subtilitas/rcbench/protocols/sbus/README.md

# sbus

This module decodes Futaba S.BUS frames: 16 channels in 25 bytes.

| Part | Files | Depends on |
|---|---|---|
| Core | `sbus.c`, `include/sbus.h` | C11 standard headers |
| RP2350 pin driver | none | |

The module has no pin driver. The wire is an inverted 8E2 UART (universal
asynchronous receiver-transmitter) at 100 kbaud; a PIO (programmable
input/output) receiver that produces the bytes is not written. The core is
linked into the panel image and the host tests, not into the IOmcu
image, and no firmware calls it.

## Constraints

- A frame is 25 bytes: the header 0x0F, 22 bytes of 16 channels at 11 bits
  each, a flag byte and a footer.
- S.BUS has no checksum. The header value occurs inside channel data, so the
  decoder uses silence to find frame boundaries. A gap of 2000us or more
  (`SBUS_GAP_US`) starts a frame. The caller supplies a timestamp in
  microseconds with every byte.
- Bytes inside a frame are 120us apart. Frames are at least 4ms apart.
- A raw channel value is 0 to 2047. 172 maps to 1000us and 1811 to 2000us.
- The decoder reports `failsafe` and `frame_lost` without acting on them.
  A caller that drives outputs from S.BUS must treat `failsafe` as a stop.

## Interface

`sbus.h`:

```c
void     sbus_decoder_reset(sbus_decoder_t *d);
bool     sbus_decode_byte(sbus_decoder_t *d, uint8_t byte, uint32_t now_us,
                          sbus_frame_t *out);
uint16_t sbus_to_us(uint16_t raw);
```

`sbus_decode_byte()` returns true when `out` contains a complete frame.
The decoder counts frames, bytes discarded while seeking a frame boundary,
and frames with an invalid footer.

## Use in another pico-sdk project

```cmake
add_subdirectory(protocols/sbus)
target_link_libraries(my_target PRIVATE rcbench_sbus)
```

The header compiles from C++. The caller supplies the bytes and their
arrival times.

## Trademarks

Futaba and S.BUS are names or trademarks of their respective owners; they
are used here only to say which receivers this module works with. The
project is not affiliated with them. No vendor code is included.
The full notice is in the repository's
[README](../../README.md#legal-notice-and-disclaimer) and in the section
"Trademarks" of [NOTICE](../../NOTICE).
