subtilitas/rcbench/hardware/STATUS.md

# Where the hardware stands

The running record for `hardware/`. Stock figures carry the date they were
taken and are not valid after it.

**Status: no board exists.** No schematic and no layout exist. Round 1 of
[the component research](docs/Research.md) ran from 2026-09-28 to 2026-09-30
and selected 49 parts for the IO (input/output) board, each with its stock in
[Parts](docs/Parts.md) and its reason on the page of its group:
[Control](docs/Control.md) (R1 to R4), [Supply](docs/Supply.md) (R5 to R8) and
[Sensing](docs/Sensing.md) (R9 to R13). The owner decided Q4, Q8 and Q9 on
2026-09-29. Three held or fixed inputs do not stand: the TPS55285 is refuted
at 4.0A continuous from the pack floor, the INA238 fails the stock gate at
both vendors, and no 18650 cell is selected. The owner keeps the TPS55285
and uses three, one for each of three servo rails, each with a heatsink and a
temperature shutdown (2026-09-30). The owner also fixes the INA228 in place of
the INA238 and names the pack the bench is to use, an SLS XTRON 3000mAh 2S1P
pack sold at Stefansliposhop (2026-09-30). The RP2354B is held in the owner's JLCPCB personal
parts library, 20 of them, and 12 TPS55285, beside the other parts listed
under [Held parts](docs/Research.md#held-parts) (export of 2026-09-25).
[The IO board specification](docs/IOBoard.md) is a draft with the chosen part
on each line. The workflow scripts are in `~/rcbench-research/tools-research/` on the owner's machine, outside the repository (prerequisite 6),
and the returns of every task are under `hardware/research/round1/` on the
branch `research/round1-results`. Round 2 is planned in
[Research](docs/Research.md#round-2); its returns go under
`hardware/research/round2/` on `research/round2-results`.

The [KiCad library](kicad/README.md) holds a footprint, a symbol and a STEP
3D model for each of the 12 modules the bench is built from. Its positions
come from maker drawings and photos, not from a caliper, and its part
heights are part class figures, not measured.

## Decided

| | Part | Reason |
| --- | --- | --- |
| Microcontroller | RP2354B | the owner's choice, held in the owner's JLCPCB personal parts library: the RP2350B die and 2MB of flash in one QFN-80 (quad flat no-lead) package, 48 GPIO (general-purpose input/output), stepping A4 (owner, 2026-09-27), taken from the marking RP2354B0A4 in JLCPCB's product photograph of C39843328; the marking on the held parts is not read. The 2MB changes three places in the IOmcu build. The IO board needs a board file that states the B package, 2MB of flash and no PSRAM (pseudo-static random-access memory). On the IO board the output store sits in the last two sectors of the 2MB, and the image limit is 2,088,960 bytes. The tree places the store at 4MB less 8kB and holds the limit at 4,186,112 bytes. [IO board](docs/IOBoard.md#microcontroller-flash-and-debug), [Research](docs/Research.md#consequence-of-the-rp2354bs-2mb-flash) Two a board (owner, 2026-09-30): the main IOmcu runs the outputs, the link, the heartbeat, the ARMED state and stop; a measurement IOmcu runs the fixed ADCs, the port, motor and cell monitors, the MCP9808s and the converters' I²C settings. PPM stays on the main IOmcu, whose stop covers it. The monitors' alert lines, open-drain and shared, 3 at least, interrupt the main IOmcu through CD4082 AND gates, and a parallel-in, serial-out shift register names the part that tripped. A trip of the 3.0A ceiling shorter than a blanking time, such as a servo charging its capacitors as it is connected, is logged, not an abort, also when it repeats; the stall trip and the port breaker bound repeated trips below 3.96A. The main IOmcu also stops the outputs when the link between the two goes silent. The 20 held cover 10 boards: see [IOBoard](docs/IOBoard.md#two-iomcus) |
| Board power | 12 to 20V DC (direct current) input and the 2S (two cells in series) pack | the DC input, when present, runs the IO board and the display. The pack runs both otherwise. The selection is automatic. The display is powered through the link cable. The DC input has reverse-polarity protection, an overvoltage cut-off and brownout detection that the IOmcu reads. Each is non-destructive: no fuse, crowbar or other part is sacrificed or damaged, and the input works again once the fault is removed, with no part replaced (owner, 2026-09-30). The overvoltage and brownout thresholds are not stated; a follow-up of R5 sets them and selects the detection circuit, and the IOmcu's action on a brownout is firmware work. The owner plans to use an SLS XTRON 3000mAh 2S1P pack, cobalt-based lithium-ion, 7.4V nominal, with an XT60 socket and an XH balance connector (owner, 2026-09-30). Its 30C, a C rate of 30 times its 3.0Ah capacity, is 90A continuous. It is disconnected in hardware when any cell falls to 3.0V, read per cell from its balance lead (question F9 in [Research](docs/Research.md#blocking-answered-before-the-research-tasks), owner, 2026-09-25). At that floor the pack is 6.0V at the lowest (2 × 3.0V); full charge is 8.4V (2 × 4.2V). The owner keeps the 3.0V floor for the pack (2026-09-30); its vendor page states neither 3.0V nor 4.2V a cell. The pack runs from 0°C to 55°C, read from an NTC (negative temperature coefficient thermistor) the owner tapes with Kapton tape at the center of the cells (owner, 2026-09-30). The pack's maker, SLS, is the owner's choice outside the cell makers of question S9 (owner, 2026-09-30). Owner decision, 2026-09-24; 12 to 20V, 2026-09-25 |
| Motor current path | INA228 on the IO board, two shunt positions | an onboard shunt for 150A continuous (question F2) with a temperature sensor beside it, and an input for an external shunt for currents above 150A, to 300A and more (owner, 2026-09-25), connected by its sense leads. The two paths replace each other: a test is cabled through one, never both (owner, 2026-09-25). One monitor for each path (question F1, which names the INA238; the owner fixes the INA228 in its place, 2026-09-30). The ESC (electronic speed controller) pack has up to 16 cells, 67.2V at 4.2V a cell (question F15), under the INA228's 85V. Owner decisions, 2026-09-24 and 2026-09-25 |
| Output ports | 20 typed ports | 16 PWM (pulse-width modulation) ports with enable, pulse range and a frame rate per pair, one of them switchable to PPM (pulse-position modulation), and 4 multiprotocol ports (servo PWM, DShot, bidirectional DShot, ESC telemetry, servo configuration, ESC bootloader); a one-pin UART (universal asynchronous receiver-transmitter) socket; an external CAN (Controller Area Network) port on its own controller. Each port has a supply switch, a current monitor channel and an LV (low-voltage) or HV (high-voltage) jumper that cuts the port off above 6.0V or 8.7V (question F16). Owner decision, 2026-09-25 |
| Sensor inputs | load cells, a phase-wire clip, a magnetic pickup, motor temperature sensors, an encoder | thrust and torque come from load cells. Rotation speed in rpm (revolutions per minute) comes from a phase-wire clip and a magnetic pickup. The motor's temperature is measured. The encoder is ABI (quadrature A and B plus an index pulse) and is counted in the pin budget. Load cells on 3 channels, 1 for thrust and 2 for torque, at 5V excitation (question F3). The encoder takes 5V single-ended up to 1MHz or RS-422 (Recommended Standard 422) differential up to 5MHz, and a 5V or 12V supply, each selected by a jumper (question F4). Motor temperature on 2 channels, 1 infrared and 1 thermocouple (question F5). 2 external I²C (Inter-Integrated Circuit) ports at 3.3V, Qwiic (question Q7). Owner decisions, 2026-09-24 and 2026-09-25. [IO board](docs/IOBoard.md#measurement) |
| Safety gate | a heartbeat monostable, specified in pull request #167 at commit 23c82ca, not merged | the single-channel OR design (question F10); a hardware latch cleared only by an operator control (F11); a reset supervisor as the clear network (F12); the 20 output ports and the UART socket behind the gated buffer (F13); a pull-up on a bidirectional DShot line and a pull-down on every other (F14); on the ESC pack a MOSFET (metal-oxide-semiconductor field-effect transistor) array and driver on the board for the onboard path, and a driven external module above 150A (F7). Owner decisions, 2026-09-25. The parts are in research categories R3 and R4 |
| Display supply | 5V through the link cable | 2A peak, 1.5A continuous (question F6 and prerequisite 7 in [Research](docs/Research.md#prerequisites)). Owner decisions, 2026-09-25 |
| First build | 5 boards | the parts are bought into the personal library before the order (question S7). A part's stock gate is 5 times the build's need, never under 50 (S4). Owner decisions, 2026-09-25 |
| IOmcu watchdog | the RP2350's internal watchdog | a frozen IOmcu resets, and every gate it drives opens while its pins are at their reset state. Owner decision, 2026-09-25. The stop deadline is 500ms (owner, 2026-09-30). The timeout is not stated, and the IOmcu image enables no watchdog |
| Output combinations | the combinations P5 returns | P5 is the cross-category check of [the research](docs/Research.md#agent-layout). Bidirectional DShot takes 2 PIO (programmable input/output) state machines per output; the 4 multiprotocol ports take 8 of the 12. The board supports the combinations P5 returns; the IOmcu refuses a bind outside them and the OUTPUTS page shows the refusal. Owner decision, 2026-09-25 |
| Servo supply | 3 TPS55285 | one for each servo rail: 8 PWM ports, the other 8 PWM ports, and the 4 multiprotocol ports (owner, 2026-09-30). 12 held in the owner's personal library (owner, 2026-09-25): with the adjustable supply's, 4 a board, they cover 3 boards. Each senses current internally and its I²C limit stops at 6.35A, so each rail runs to 6.35A. Its input takes 2.4 to 22V, so the DC input is 12 to 20V. The TPS55288, which limits across an external shunt to 10.1A, is not used. Round 1 refutes one converter at 4.0A continuous from the pack floor. The owner keeps it (2026-09-30): 4 to 6.35A is a short peak for one servo, a small aluminum heatsink on a 6-layer board cools each converter, and an MCP9808T-E/MS beside each switches its rail off when hot, which bounds a sustained current from several servos. A follow-up of R6 finds the continuous current each holds: see the Servo supply row under [Open](#open). [Power](docs/Power.md) |
| Motor monitor | INA228 | fixed by the owner in place of the INA238 (2026-09-30). The owner states it returns to stock soon, and the monitor gets no further research. 85V, 20 bit. Its step at 300A with a 50 µΩ shunt is 1.5625mA, 78.125 nV on the ±40.96mV range. Its stock is not read after 2026-09-01, when JLCPCB had 29 with a presale count of −477 and Digi-Key 0. The INA238, 16 bit, has the same 10-pin VSSOP (very thin shrink small-outline package) and the same pin order; round 1 read it at JLCPCB 0 with a presale count of −99 and Digi-Key 0 on 2026-09-29. [Power](docs/Power.md#motor-monitor-ina228), [Research](docs/Research.md#sourcing-rules) |
| Monitor footprint | one for both | INA228 and INA238 are pin-identical and distinguishable at run time by DEVICE_ID (0x3F: 0x2281 or 0x2381). The INA238 fits the INA228's footprint (Motor monitor row) |
| Servo rail | 3 rails, two output settings each | up to 5.5V for LV (low-voltage) servos and up to 8.4V for HV (high-voltage) servos, and down to the TPS55285's 0.8V to test a servo's brownout behavior, set on each rail alone, so LV and HV servos and an ESC on the multiprotocol ports run at the same time (owner, 2026-09-30). 4 to 6.35A a rail: a short peak for one servo, and sustained only by several servos together, which the rail's temperature shutdown bounds. From the pack every converter runs to its own limit too: the SLS XTRON pack's 90A carries all four (owner, 2026-09-30). The converters run from the 12 to 20V DC input or from the 2S pack (owner, 2026-09-24). From the 6.0V pack floor a TPS55285's 7A inductor clamp gives 5.0A at 8.4V without losses and 4.44A at a typical 88.8%; 6.35A needs 10.0A, above the clamp's 8A typical, and the datasheet guarantees no efficiency, so the current a unit reaches is not known (R6). Research category R6 checks 8.4V and 4.0A from the 6.0V pack floor at 50°C ambient, and the TPS55285 fails there drawn continuously: see the Servo supply row under [Open](#open). [Power](docs/Power.md) |
| Adjustable supply | a fourth TPS55285 | a simple adjustable supply, on the measurement IOmcu's I²C buses with the other TPS55285 (owner, 2026-09-30): 0.8 to 15V in 10mV steps and 0.5 to 6.35A, set from the display, out on an XT60 socket (female) from the PCB (printed circuit board). It has the servo converters' heatsink, MCP9808T-E/MS shutdown and heartbeat-gated rail gate, and runs from the DC input or the pack, to its own limit from either (owner, 2026-09-30). At 15V and 6.35A it delivers 95.3W, for certain only from an input above 15V; boosting, its inductor clamp, 7A at least with no maximum, gives 5.6A at 15V from 12V and 2.8A from the 6.0V pack floor without losses, less with them. Open: its continuous current across its input and output range, which a follow-up of R6 qualifies; and its rail gate, since the BTS7004-1EPP starts only at 4.1V at most and does not switch an output set from 0.8V to about 4.1V: see [IOBoard](docs/IOBoard.md#power). [Power](docs/Power.md) |
| Pack charger | BQ25713RSNR, with MAX17320G22+ and FUSB303BTMX, [Supply](docs/Supply.md) | charged from USB-C (Universal Serial Bus Type-C) only, drawing up to 3A at 5V, and not from the DC input (question F8 in [Research](docs/Research.md), owner, 2026-09-25). Research round 1 selects the BQ25713RSNR as the charger and power path, the MAX17320G22+ for balancing at 50mA average and for pack protection, and the FUSB303BTMX for the USB-C input limit (R7). The BQ25887 (2A, 400mA per-cell balancing, [Power](docs/Power.md)) takes 3.9 to 6.2V and is not selected. The pack is the owner's SLS XTRON 3000mAh 2S1P (2026-09-30); its cell and temperature limits are not confirmed: see the Pack cells row under [Open](#open) |
| Port monitors | INA3221AIRGVR, 7 parts, with an ERJ-6CWDR010V shunt on each port, [Supply](docs/Supply.md) | one channel per port, 20 ports: the limit search needs one sensor per servo. The owner's choice is the INA3221, 7 parts (21 channels), a 10mΩ shunt each: 4mA resolution, 16.4A full scale, two I²C buses (owner, 2026-09-25): the measurement IOmcu's (owner, 2026-09-30; [IOBoard](docs/IOBoard.md#two-iomcus)). Research round 1 keeps it (R8) |
| Onboard shunt, 150A | BVR-Z-R0002-1.0, [Supply](docs/Supply.md) | on the IO board, with a temperature sensor beside it, the MCP9808T-E/MS (R8). 150A is continuous (question F2, owner, 2026-09-25). At 150A a 100 µΩ shunt drops 150A × 100 µΩ = 15mV and dissipates (150A)² × 100 µΩ = 2.25W continuously. A 200 µΩ shunt drops 30mV and dissipates 4.5W. Both drops are inside the INA238's ±40.96mV range |
| External shunt, 300A and above | WSBE8518L1000JKA2, off the board, [Supply](docs/Supply.md) | sense leads to the IO board. Class: busbar type, 50 to 100 µΩ, 4.5 to 9W at 300A. The four-terminal SMD (surface-mount device) parts recorded in [Power](docs/Power.md#motor-monitor-ina228) stop at 0.2mΩ and would dissipate 18W at 300A. The WSBE8518L1000JKA2 is 100 µΩ, bought at Digi-Key, the second vendor of question S3, which held 418 on 2026-09-29. No alternate is found, so it has no second source (sourcing rule 5), and the owner has the report. The sense-lead connector is round 2 |
| Parts of group A | 21 parts, [Control](docs/Control.md) | ABM8-272-T3 and AOTA-B201610S3R3-101-T (R1); MCP2518FDT-E/SL and TCAN3413DR, 2 of each (R2); 74HC423BQ,115, 74AUP1G32GW,125, TPS3703A7330DSERQ1, 74LVC1G175GW,125, 434153017835, SN74AUP1G14DBVR, SN74AUP1G17DBVR, BTS7004-1EPP, TPSI3052DWZR, IPT015N10N5ATMA1, CSD19537Q3T, 2N7002BK,215 and SN74LVC1G04DBVR (R3); SN74LVC244APWR with its alternate 74LVC244APW,118, SN74LVC1G126DBVR, SN74CBTLV3126PWR and SN74LVC1T45DBVR (R4). Research round 1, verified by its two verifiers of phase P4, which re-read stock, lifecycle and every datasheet value |
| Parts of group B | 15 parts, [Supply](docs/Supply.md) | LM74800QDRRRQ1, LMQ66430MC3RXBRQ1, TPS62933DRLR, TPS259474ARPWR and TPS55288RPMR (R5); TPS259474LRPWR and MCP23017T-E/SS (R6); BQ25713RSNR, MAX17320G22+ and FUSB303BTMX (R7); BVR-Z-R0002-1.0, MCP9808T-E/MS, WSBE8518L1000JKA2, INA3221AIRGVR and ERJ-6CWDR010V (R8). Research round 1, verified by the P4 verifiers |
| Parts of group C | 13 parts, [Sensing](docs/Sensing.md) | ADBMS1818ASWAZ-RL (R9); ADCS7476AIMFX/NOPB (R10); ADXL316WBCSZ, DRV5015A1QDBZR, TLV3201AIDBVR with its alternate TLV3601DBVR, AM26LV32EIDR and the RP2354B's PIO (R11); MAX31856MUD+T, MLX90614ESF-BCC-000-TU, TCA9548APWR with its alternate PCA9548APWR and MB85RC256VPNF-G-AMERE2 (R12); ADS1235IRHBR and BD450M2FP3-CE2 (R13). Research round 1, verified by the P4 verifiers |
| Accelerometer converter (Q4) | ADCS7476AIMFX/NOPB, an external ADC (analogue-to-digital converter) | the part R10 kept (owner, 2026-09-29). The RP2354B's ADC with the LM4040AIM3-3.0/NOPB reference is the verified option not chosen |
| Output binding store (Q8) | MB85RC256VPNF-G-AMERE2, an I²C FRAM (ferroelectric random-access memory) | the part R12 kept (owner, 2026-09-29). The EEPROM (electrically erasable programmable read-only memory) M24256E-FMN6TP is the verified option not chosen |
| Monostable isolation (Q9) | 74HC423BQ,115 with SN74AUP1G17DBVR in front of its trigger inputs | the 74HC423 keeps the '423 behaviour, and the buffer supplies I_off, a limit on the input current of an unpowered part, as R3 selected (owner, 2026-09-29). No part is added or changed |
| Stock exception | ADS1235IRHBR | Digi-Key, the second vendor, read stock 0 against the gate of 50 on 2026-09-29; the owner keeps the part and notes the exception (owner, 2026-09-29) |
| Stock source | the vendor's own API (application programming interface) | on 2026-09-01 the mirror `jlcsearch.tscircuit.com` reported 1046 INA228AIDGSR. JLCPCB's own API reported 29, with a presale count of −477: oversold. [Sourcing](docs/Sourcing.md#observed-divergence-2026-09-01) |

## Open

The first nine rows come from round 1 and are reported to the owner. A part
a row needs comes from a follow-up of its research category in stage 1 of
round 2, or from stage 2 of round 2 for a passive, a connector, or the
protection on the signal, sensor, balance-lead, link and heartbeat connectors
([Research](docs/Research.md#round-2)). The group pages state each with its
evidence, as not known or not verified.

| Item | State | Needs |
| --- | --- | --- |
| Servo supply | round 1 refutes the held TPS55285VALR at 4.0A continuous: at 6.0V in, 8.4V and 4.0A out and 50°C ambient its estimated junction temperature spans 89 to 179°C against 125°C, and its datasheet gives no loss of the IC (integrated circuit) there. The owner keeps it and uses three, one a servo rail (2026-09-30): 4 to 6.35A is a short peak for one servo; a small aluminum heatsink on a 6-layer board cools each; an MCP9808T-E/MS beside each switches its rail off above a threshold, which bounds a sustained current from several servos. The measurement IOmcu programs and locks each MCP9808, and the main IOmcu enables the converter only after that; it switches every converter off when the link between the two goes silent ([IOBoard](docs/IOBoard.md#two-iomcus)). The continuous current one converter holds at 6.0V in and 50°C is not known. 5 boards take 20 TPS55285, with the adjustable supply's, against 12 held. `selection.json` carries no servo supply. Its inductor SRP1265A-4R7M is confirmed by both verifiers of the follow-up task FU-B3 and is not carried in `selection.json` either ([Supply](docs/Supply.md#not-known)) | a follow-up of R6: the continuous current, in A, as each rail's continuous rating, the adjustable supply's across its range, and the shutdown threshold; 8 more TPS55285 bought before the order |
| Motor monitor | the owner fixes the INA228AIDGSR (2026-09-30): it returns to stock soon, as the owner states; its stock is not read, and the monitor gets no further research. Against the 85V fault on the external shunt's sense leads (V179), which refutes the INA238's ±40V differential input, the owner sets 1kΩ in series with each input and a low-capacitance TVS (transient-voltage-suppression) diode behind them (2026-09-30). The INA228's rating against the fault and the error 1kΩ adds to its reading are not read ([Supply](docs/Supply.md#not-known)) | the INA228 in stock before the order; the TVS's connection and part and the resistors' power rating (round 2) |
| Pack cells | the owner plans to use an SLS XTRON 3000mAh 2S1P pack (article SLSXT30002130), sold at Stefansliposhop (2026-09-30). Its 30C, 90A continuous, is 7.4 times the 12.23A round 1 budgets, and 1.8 times the about 49.7A the pack path draws at the 6.0V floor with every converter at its limit (owner, 2026-09-30). That draw is nominal, and it has no upper bound until the pack protection's overcurrent threshold is set at or below 90A. The owner waives sourcing rules 4 and 5 for it: the vendor shows no stock count, and no second pack is named. Round 1's INR-18650-P30B passes every check and is not used. The owner states a cobalt-based lithium-ion chemistry (2026-09-30); the vendor page states no chemistry, no charge voltage or discharge floor a cell, no temperature limits, no thermistor and no internal resistance. The owner sets its limits in their place (2026-09-30): the 3.0V a cell floor of F9 stands, and the pack runs from 0°C to 55°C, read from an NTC taped with Kapton tape at the center of the cells. F9's 4.2V a cell full charge is not confirmed by the vendor ([Supply](docs/Supply.md#not-known)) | the pack path and the pack protection sized again for about 49.7A (follow-ups of R5 and R7); the pack protection's thresholds (V150) against these limits (a follow-up of R7); a leaded NTC, the connector of its lead and the board's XT60 and XH connectors (round 2) |
| ESC pack switch | the onboard MOSFETs (IPT015N10N5ATMA1) and the external module (VS-FC420SA10, VS-FC270SA20) are refuted on safe operating area during the controlled turn-off; no clamp part holds the pack node under 85V at up to 600A. Not known ([Control](docs/Control.md#not-known)) | a follow-up search or a trade-off by the owner |
| USB protection | relaxed to match standard parts (owner, 2026-09-30): standard USB protection parts on VBUS, D+ and D−, CC1 and CC2. Where a standard part misses the 3.63V steady limit on D+ and D− or another figure of V9 and V12, its datasheet figure stands. Round 1 found no part that covers the 5 lines while holding D+ and D− at 3.63V ([Control](docs/Control.md#not-known)) | a follow-up of R1, which selects the USB protection |
| Watchdog | the stop deadline (V1) is 500ms (owner, 2026-09-30): the watchdog timeout and the reset together stay within it, and the timeout exceeds the longest legitimate stall (V2). The timeout bounds a whole pass of the main loop between two feeds. As the firmware is written, one pass erases a W25Q16JV sector, up to 400ms, and then writes to the console (`main()` in `firmware/iomcu/src/main.c`, `out_store_tick()`, `out_store_reclaim()` in `firmware/iomcu/src/out_store.c`), so the console write, the rest of the pass and the reset share the remaining 100ms. A slow USB host holds a console write without limit, so the firmware caps it; the cap is not stated. Q8 moves the output binding to an FRAM (ferroelectric random-access memory), which takes the sector erase out of the loop once the firmware follows it ([Control](docs/Control.md#not-known)) | the timeout, the console-write cap and the move of the output store to the FRAM, in firmware |
| Pack disconnect and port voltage ceiling | no candidate passes: the disconnect fails an open balance lead, the reconnect condition or the per-cell floor; the ceiling fails the ±0.99% HV trip band or the latch. Not known ([Supply](docs/Supply.md#not-known)) | a follow-up search |
| Optical index | no reflective sensor meets the 1.244µs delay-variation budget. Not known ([Sensing](docs/Sensing.md#not-known)) | a follow-up search |
| Board budget | about 51 GPIO (general-purpose input/output) signals against 48 on one chip. With two RP2354B (owner, 2026-09-30) the draft pin map uses 44 of the main IOmcu's 48 and 32 of the measurement IOmcu's, with the rotation inputs and the receiver on the measurement IOmcu, the external CAN controller on the display link's SPI bus, a UART between the two and the lines for VESC controllers through the gate (owner, 2026-09-30; [Pins](docs/Pins.md)); the FUSB303 address 0x21 inside the expanders' block; the servo current sample period, 5ms a channel against the 20ms P5 assumed; Not known ([Control](docs/Control.md#not-known), [Supply](docs/Supply.md#not-known)) | the pin map, the I²C address map and a P5 check after it |
| Cell monitor barrier | the cell monitor sits on the ESC pack's negative and reaches the measurement IOmcu only across an isoSPI (isolated SPI) transceiver pair or a digital isolator rated 85V DC working or more (V189, owner, 2026-09-28). Round 1 selected none: the barrier is not in its R9 inventory. Not selected ([IOBoard](docs/IOBoard.md#measurement), [Pins](docs/Pins.md#not-known)) | a follow-up of R9 |
| Servo path from 0.8V | the servo rails and the adjustable supply work down to the TPS55285's lowest output, 0.8V, to test a servo's brownout behavior (owner, 2026-09-30). Round 1 selected the servo path for a lowest rail of 4.8V (V55): the BTS7004-1EPP rail gate starts only at VS(OP), 4.1V at most, and the TPS259474LRPWR port switches take VIN from 2.7V. Neither switches a rail set below that ([IOBoard](docs/IOBoard.md#link-and-safety)) | a rail gate that conducts from 0.8V (a follow-up of R3) and a port switch that does (a follow-up of R6) |
| Converter input connector and heatsink | the converters run from the 12 to 20V DC input or the 2S pack (owner, 2026-09-24). Three at 6.35A and 8.4V draw 14.8A from 12V; with the adjustable supply at 15V and 6.35A, the four draw 23.6A, both at an assumed 90% efficiency. A small aluminum heatsink on each TPS55285, on a 6-layer board, and an MCP9808T-E/MS beside each whose alert output switches its output off (owner, 2026-09-30) | the input connector (round 2), the shutdown threshold (a follow-up of R6), the heatsinks' size (round 3) |
| Phase-wire clip front end | the beta bench taps phase A through 4.7kΩ and a 3.0V zener (Rohm UDZV3.0B) to GND at the IOmcu pin: one wire, referenced to the ESC signal lead's ground (owner, 2026-10-08). The board's clip sees the 67.2V of F15 as the pack's DC level; the peak it must withstand, 67.2V plus a margin for switching overshoot and ringing, is open (V214), and so are its coupling (V215) and its isolation (V216). From the beta bench: a second ground wire from the motor side runs in parallel with the ESC's own ground and can carry motor current (owner, 2026-10-08); the tap needs the ESC's power negative on the IOmcu's GND: on the beta bench the ESC runs from the PD mini (owner, 2026-10-08), whose OUT − is wired to the IOmcu's GND, while an ESC on its own pack with an opto-isolated signal input gives the tap no reference; 4.7kΩ is sized for 25.2V, and at 67.2V DC it passes 13.7mA and dissipates 0.88W, more at the V214 peak. An optocoupler across two phases needs no ESC ground. It needs a logic-output part that switches at 2mA or less from 3.3V with delays well under 1µs (a PC817 module is limited to about 4kHz and needs about 3V before its input conducts), an input current limiter that holds a few mA from 3.0V (a floating 2S phase) to the pack voltage, a reverse diode on each input, because the driven pair reverses, and a common-mode transient immunity above the phase node's dV/dt: about 1.25kV/µs for 25V in 20ns, more at the V214 peak. Capacitive coupling passes only the edges, needs a comparator that restores the level, and passes C × dV/dt of the common-mode swing: about 125mA at 100pF and 25V in 20ns | the V214 peak voltage, which every part and clearance of the front end is rated against; the PWM carrier range the clip must reject (V229) the electrical frequency it must pass, which follows from the highest shaft speed (V212) and the pole pairs, and the lowest phase voltage and current it must still read, which follow from the lowest speed it covers in coast-down (V213), not from the BENCH register's 65,535rpm ceiling; both are open, and a fast front end, isolated or not, reproduces carrier edges; a decision for the board (V216) that follows the ESC ground paths row: the isolated design there makes an isolated clip mandatory, since a ground-referenced clip puts the pack negative on the logic ground; a ground-referenced clip goes only with the protected non-isolated design. Every series part and limiter is rated for its continuous dissipation at the highest sustained phase voltage and duty cycle, over component tolerance and ambient temperature, and separately for the pulse energy and safe operating area of the V214 peak. Then a part search (R11 follow-up) |
| ESC ground paths | the ESC pack's return reaches the star by its own lead. An ESC with a BEC (battery eliminator circuit) also joins its power negative to its signal lead's ground, and its BEC output arrives on the port's supply pin, which the board's TPS55285 rail drives at 0.8 to 8.4V: the port keeps the BEC positive off the driven rail (removed, switched or ORed safely) or takes the BEC as the selected source. The signal lead's ground reaches the board's signal ground: a second path beside the pack return lead, through the ESC. On an ESC with an opto-isolated signal input the pack return lead is the only join, and it defeats the isolation the ESC was built with. On the beta bench an INA228 module's I²C ground likely ties the pack negative to the IOmcu the same way; how the MATEK I2C-INA-BM joins its grounds is not checked (owner, 2026-10-08) | a decision between two designs, then a part search. Not isolated: every parallel return, the ESC signal ground and the motor monitor's supply and I²C ground alike, gets a part that limits or breaks its current when the pack return lead or its connector opens, since each then becomes a return for the motor current: a fuse or polyfuse rated for DC above the pack's highest transient voltage and able to break the prospective fault current, up to 600A, not only its I²t; or a check that switches the bench to SAFE with a total time from the return opening to the pack switch opening and an I²t each path is shown to survive (the path carries 150A continuous and up to 600A at switch opening; the detection-to-open time is open, V159; the switch alone may take 5ms after its enable falls). A pack return lead of lower resistance only sets the share in normal running. With a motor shunt in the return lead (its placement is open), the parallel returns carry current around it, which the motor reading misses: the non-isolated design needs the shunt ahead of every return branch, a high-side shunt, or the bypass current bounded against the measurement's error budget. Every conductor that stays connected after a return protection opens, the ESC signal, SDA, SCL, ALERT and the supplies, then sees the pack side: either the protection disconnects all of them together, or each has its own fault limiting and voltage protection. Isolated: every conductor between the ESC and pack side and the logic side crosses a barrier, and every requirement the board already places on those conductors holds across it: each multiprotocol mode's directions, electrical form, bias and rate ([IOBoard](docs/IOBoard.md), the port and programming rows); the heartbeat gate's high-impedance state within 1µs of the enable falling, in hardware, with a defined safe state on the ESC side; the monitor's I²C and ALERT, or a trip formed on the pack side and isolated as one signal; and the supply and ground of every barrier part's ESC-side half, from the ESC or BEC side, the pack side or an isolated converter, never from the board's servo rail or ground. Every barrier and isolated supply is rated for continuous working voltage, transients and clearance at the pack voltage, at least the 85V DC working the cell monitor's barrier already requires, and for a common-mode transient immunity above the dV/dt of the ESC-side reference when the pack return opens or bounces. The MATEK I2C-INA-BM takes 4 to 9V at its 5V pin ([MATEK](https://www.mateksys.com/?portfolio=i2c-ina-bm)). Neither design is in the round-2 plan: the ESC-signal barrier belongs to R4, which round 2 does not run, and this row has no follow-up assigned; the owner assigns one, since the plan is not edited between runs |
| Layout | Isolation, a 150A path and a 3.3V I²C bus on one board, connectors, thermal. | the schematic first |

## Not planned

- **A hall-effect sensor for the 300A path.** It avoids the shunt's 9W and
  its layout, at the cost of gain and offset drift on the bench's primary
  measurement. The shunt is the measurement.
- **Bilingual pages** while no board exists. See [the README](README.md).

## Order of work

1. The owner's rulings on the open items of round 1 ([Open](#open)): the
   ESC pack switch and the other items without a part. The TPS55285, the
   motor monitor, the pack, the USB protection and the stop deadline are
   ruled on (owner, 2026-09-30).
2. Stage 1 of round 2 of the component research (owner, 2026-10-01;
   [Research](docs/Research.md#round-2)): follow-up tasks of round 1's
   categories for the ICs and the parts round 1's categories name that round 1
   left without a part or whose requirement changed, the follow-ups those
   rulings call for among them, planned in 7 runs of at most 32 agents each.
   Round 1 of the component research ran from 2026-09-28 to 2026-09-30, as in
   [its scope](docs/Research.md#scope): the ICs, the parts that fix an IC's
   surroundings, both motor shunts, the switch of the ESC pack with its input
   protection, and the 18650 cells of the bench's own pack, in six tasks
   (question S8) and 9 follow-up tasks, each of at most 32 agents (owner,
   2026-09-24). The commit each task read is in the status line of
   [Research](docs/Research.md).
3. Stage 2 of round 2 selects the passives and the connectors, the DC input
   connector among them, by part type, with no P1 and one verifier (owner,
   2026-10-01). It also selects the protection on the signal, sensor,
   balance-lead, link and heartbeat connectors. The power input's protection
   (R5) and the ESC pack path's (R3) are round 1's categories, which stage 1
   researches. Stage 2 has no scripts in `~/rcbench-research/tools-research/`. Round 3 sets the
   mechanical, thermal and layout constraints, the converter's heatsink among
   them ([Research](docs/Research.md#scope)).
4. Schematic.
5. Order each part with a manufacturer lead time of 16 weeks or more as soon
   as the schematic fixes it. On 2026-09-01 Texas Instruments quoted 16 weeks
   on every power-path part checked, and 26 weeks on the INA745x and the
   INA260 ([Sourcing](docs/Sourcing.md#the-2026-09-01-sweep)). Once the
   schematic exists, the build waits up to 26 weeks for those parts.
