subtilitas/rcbench/hardware/docs/IOBoard.md

# IO (input/output) board specification

This specification records the IO board's requirements and the values fixed
by the project. The IO board is the IOmcu board. It handles the functions
with timing deadlines:
outputs, receiver inputs, sensor front ends, the power path and the CAN
(Controller Area Network) link to the display. The display is the ESP32-P4
panel in `firmware/panel/`.

**Status: draft.** No schematic exists. Round 1 of
[the research](Research.md) ran from 2026-09-28 to 2026-09-30 and names the
part selected for each requirement. [Parts](Parts.md) lists the parts and
their recorded stock. Each research group's page explains its choices,
alternatives and reasons: [Control](Control.md) for R1 to R4,
[Supply](Supply.md) for R5 to R8 and [Sensing](Sensing.md) for R9 to R13. A
requirement without a selected part is marked not known or not verified on
the relevant page. A line marked _open_ depends on an unanswered question in
[Research](Research.md).

Firmware observations and line references below record the source revisions
inspected during the research. They are not a current firmware feature list;
explicit corrections below distinguish implemented functions from the proposed
IO board. See [the link reference](../../docs/Link.md) and
[the build reference](../../docs/Building.md) for the current implementation.

The sources include repository files and line references, pull request #167, the pico-sdk 2.3.1
headers, two pico-sdk 2.3.0 sources (`boards/olimex_rp2350_xl.h` and
`src/rp2_common/hardware_pio/pio.c`), and two datasheets read from copies
outside the tree: the RP2350 datasheet (build 2024-08-08) and the W25Q16JV
datasheet (revision D, 2016-08-12). R1 reads the RP2350 datasheet from
Raspberry Pi. In build 2025-07-29, the copy served by Raspberry Pi during the review,
each cited table number is three higher than in build 2024-08-08. Table 1423 (Pin Types) is 1426 there,
1424 (GPIO pins; GPIO is general-purpose input/output) is 1427, 1425 (QSPI
pins; QSPI is quad serial peripheral interface) is 1428, 1427 (Miscellaneous
pins) is 1430, 1430 (Absolute maximum ratings) is 1433, and 1433 (Digital IO)
is 1436. The W25Q16JV datasheet Winbond served without a login on 2026-09-27 is the
W25Q16JV-DTR datasheet (revision I, published 2026-05-28), whose ordering list names only DTR (double transfer rate) parts. It gives the same erase and program
times cited here from revision D, but states endurance without "per
sector". The heartbeat
monostable is specified in pull request #167 at commit 23c82ca, which is not
merged; it is cited as pull request #167. Prerequisite 4 in
[Research](Research.md#prerequisites) fetches that commit.

[Research](Research.md) is cited by ID (identifier) and by section, and
[hardware STATUS](../STATUS.md) by row name and by section, not by line. In Research, R1 to R13 are the research categories,
P0 to P7 the phases, T1 to T6 the tasks and the runs named FU- its follow-up tasks. S1 to S9, F1 to F16, Q4, Q7, Q8
and Q9 are its questions to the owner, and V1 onward the questions P1 raises
([Raised by P1](Research.md#raised-by-p1)). A source given as "owner,
2026-09-24", "owner, 2026-09-25" or "owner, 2026-09-27" is a decision recorded
there. A question ID given as a source is the owner's answer in that question's
Answer column. S1 to S9, F1 to F16 and Q7 are answered. Q4, Q8 and Q9 are decided
(owner, 2026-09-29). V1 onward are answered or marked for research there.

The State column distinguishes implementation, decisions and open requirements:

| State | Meaning |
| --- | --- |
| built | runs on the bring-up module (Waveshare RP2350-CAN). The firmware moves to the IO board; the pin map, the board file and the flash offsets change with the RP2354B |
| decided | a part or a value is chosen and recorded |
| required | the tree needs it, and no decision of the owner fixes a part; a part round 1 selected follows it |
| open | a question to the owner decides it; the line names the question |
| part | the part round 1 selected, with its category; its row is in [Parts](Parts.md) |
| no part | round 1 selected no part for the line; the group page states why, as not known or not verified |

## Summary

| Function | Value | State |
| --- | --- | --- |
| Microcontroller | two RP2354B per board: a main IOmcu and a measurement IOmcu (owner, 2026-09-30; [Two IOmcus](#two-iomcus)). Each: RP2350B die and 2MB QSPI (quad serial peripheral interface) NOR (not-or) flash in one QFN-80 (quad flat no-lead) 10 × 10mm package, 48 GPIO (general-purpose input/output), 8 ADC (analogue-to-digital converter) inputs, 520kB SRAM (static random-access memory) | decided; part: RP2354B, held 20, which at 2 a board cover 10 boards; not requalified by FU-A4, not verified |
| Pin ratings | every signal that reaches an RP2354B pin is at 3.3V logic. GPIO0 to 39 are fault tolerant: 5.5V only while IOVDD (the input/output supply) is at 3.3V, and 3.63V while IOVDD is at 0V. GPIO40 to 47, the ADC inputs, are rated at IOVDD + 0.5V and are not fault tolerant (RP2350 datasheet, build 2024-08-08, Tables 1423, 1424 and 1430, read from a copy). The 2.2kΩ series resistor in [STATUS.md](../../STATUS.md#constraints) is not shown to hold a pin within that rating while IOVDD is at 0V, so a 5V output that can drive before 3.3V is up is translated to 3.3V | required (R1 confirms) |
| Link to the display | classic CAN at 1Mbit/s, 29-bit identifiers, protocol 4.0, run on the bring-up module with its controller on SPI (Serial Peripheral Interface) behind a 3.3V transceiver. R2 selects the IO board's controller and transceiver. The module's controller holds 2 received frames, and the module's flash window is 19ms. The W25Q16JV datasheet gives a sector erase of 45ms typical and 400ms maximum for its packaged parts. The figure for the RP2354B's die is not known, and Q8 and P5 budget with the packaged maximum (owner, 2026-09-27) | protocol built; controller and transceiver required; parts: MCP2518FDT-E/SL and TCAN3413DR (R2) |
| Display supply | through the link cable, from the selected source (owner, 2026-09-24). 5V (F6); 2A peak, 1.5A continuous (owner, 2026-09-25) | decided |
| Safety | heartbeat input and a retriggerable monostable triggered on both edges. The enable falls 155 to 185ms after the last edge, set to 170ms on test, and gates the outputs and the servo and ESC (electronic speed controller) power. The output buffer is disabled and every power switch is open within 200ms of the last edge (pull request #167). The single-channel OR design (F10). A hardware latch with an operator clear control (F11). A reset supervisor as the clear network (F12). The 20 output ports and the UART (universal asynchronous receiver-transmitter) socket pass the gated buffer (F13), and the external CAN transceiver is in standby while the enable is low. A bidirectional DShot line takes a pull-up, and every other protocol a pull-down (F14). The onboard ESC pack switch is a MOSFET (metal-oxide-semiconductor field-effect transistor) array and its driver on the IO board, and the external path takes a driven external module (F7). The switch is rated for 150A continuous (F2), and for 67.2V (F15) plus a margin that P1 asks the owner for. No monostable part R3 read has both the required clear behaviour and powered-off isolation, and Q9 settles it (see [Link and safety](#link-and-safety)) | firmware monitor built; F2, F7, F10 to F15 decided; parts: 74HC423BQ,115, 74AUP1G32GW,125, TPS3703A7330DSERQ1, 74LVC1G175GW,125, SN74AUP1G17DBVR, BTS7004-1EPP, TPSI3052DWZR (R3); Q9 decided (owner, 2026-09-29); ESC pack MOSFETs, external module and clamp: no part, not known |
| Outputs: PWM (pulse-width modulation) and DShot | 8 slots, 8 channels. No pulse width, frame period or bit time has been seen on an instrument | built |
| Outputs: PPM (pulse-position modulation) and bidirectional DShot | written and host-tested; no instrument has been on the pin ([STATUS.md](../../STATUS.md#state)) | required |
| Multiprotocol ports | the 4 multiprotocol ports carry every programmer: the one-wire bootloader at 19,200 baud half duplex (BLHeli_S, AM32), the ESCape32 text CLI (command-line interface), the framed packets of VESC firmware at 115,200 baud, and the Hitec D-series servo protocol | required; path: SN74CBTLV3126PWR (R4) |
| Receiver inputs | S.BUS, iBUS, SUMD, CRSF, SRXL2, JETI EX Bus. Each bus is one signal wire plus ground into an RP2354B pin ([Receivers](../../docs/Receivers.md)). How many receiver pins the board brings out is not stated | required; buffer: SN74LVC1T45DBVR (R4) |
| ESC telemetry | extended DShot telemetry on the bidirectional DShot reply; OpenYGE on its own half-duplex UART (universal asynchronous receiver-transmitter) line at 115,200 baud 8N1 (8 data bits, no parity, 1 stop bit) | required |
| Servo supply | four TPS55285 (owner, 2026-09-25 and 2026-09-30): a fourth as a simple adjustable supply, 0.8 to 15V and 0.5 to 6.35A, and one for each of 3 servo rails: 8 PWM ports, the other 8 PWM ports, and the 4 multiprotocol ports. Each rail has two settings, up to 5.5V and up to 8.4V, set on its own, and runs 4 to 6.35A from the 12 to 20V DC (direct current) input and from the 2S (two cells in series) pack alike (owner, 2026-09-30). Each converter has a heatsink and a temperature shutdown. From the 6.0V pack floor a TPS55285's 7A inductor clamp gives 5.0A at 8.4V without losses and 4.44A at a typical 88.8%; 6.35A needs 10.0A, above the clamp's 8A typical (R6) | decided; from the pack required (R6); TPS55285VALR refuted at 4.0A continuous from the pack floor in round 1 and kept by the owner: no part in `selection.json`, not known |
| Output ports | 20, typed (owner, 2026-09-25): 16 PWM ports, each enabled or disabled with a pulse range, the frame rate set per pair (1–2, 3–4 …), and one of them switchable to PPM; 4 multiprotocol ports, each set to servo PWM, DShot, bidirectional DShot, ESC telemetry, servo configuration or ESC bootloader. Each of the 20 has a supply switch, a current monitor channel and a jumper that selects an LV (low-voltage) or HV (high-voltage) ceiling set in hardware: 6.0V or 8.7V (F16) | decided; port switch TPS259474LRPWR, I/O expander MCP23017T-E/SS (R6), port monitor INA3221AIRGVR (R8); port voltage ceiling: no part, not known |
| Serial and bus ports | a one-pin UART (universal asynchronous receiver-transmitter) socket for ESC telemetry and other serial devices, and an external CAN port on a controller of its own, separate from the display link (owner, 2026-09-25) | decided; external CAN: MCP2518FDT-E/SL and TCAN3413DR (R2), UART socket path SN74CBTLV3126PWR (R4) |
| Motor current and voltage | one INA228 for each shunt path (F1; the owner fixes the INA228 in place of the INA238, 2026-09-30), bus input rated to 85V, above the 67.2V of a 16-cell pack at 4.2V a cell (F15). Onboard shunt for 150A continuous (F2) with a temperature sensor beside it; external-shunt input for currents above 150A (owner, 2026-09-25), to 300A and more | decided; INA228AIDGSR fixed by the owner, stock not read (2026-09-30); shunts BVR-Z-R0002-1.0 and WSBE8518L1000JKA2 (R8) |
| Cell monitor | 1 to 16 cells on the balance lead, for the 16-cell pack of F15. `SET_PACK_CELLS` and the battery screen take 1 to 14 and change with it | required; part: ADBMS1818ASWAZ-RL (R9) |
| Board power | 12 to 20V DC input or the bench's own 2S pack, an SLS XTRON 3000mAh 2S1P pack (owner, 2026-09-30), selected automatically. The pack is disconnected in hardware when any cell falls to 3.0V, read per cell from the balance lead (F9). At the 90% efficiency [Power](Power.md) uses for the DC input, the servo supply alone, at 8.4V and 6.35A, draws 7.1A from a pack at 8.4V and 9.9A at 6.0V (2 cells × 3.0V). From the pack every converter runs to its own limit (owner, 2026-09-30): at the 6.0V floor the four converters at 6.35A draw about 47.3A at an assumed 90%, and the board about 49.7A with the display, the logic rails and the second RP2354B, nominal figures (Pack path current) | decided; parts: LM74800QDRRRQ1, LMQ66430MC3RXBRQ1, TPS62933DRLR (R5); pack disconnect: no part, not known |
| Pack charger | 2S, balancing, charged from USB-C (Universal Serial Bus Type-C) only, drawing up to 3A at 5V, not from the DC input (F8). R7 selects the part | decided; parts: BQ25713RSNR, MAX17320G22+, FUSB303BTMX (R7); pack: SLS XTRON 3000mAh 2S1P (owner, 2026-09-30) |
| Vibration | an analogue sensor, piezo or analogue accelerometer, and a once-per-revolution index pulse on one timebase. The sensor and converter resolve the 167Hz fundamental at 10,000rpm (revolutions per minute), and a fused IMU (inertial measurement unit) streaming at 100Hz does not ([Balancing](../../docs/Balance.md)). The converter is an external ADC (Q4) | required; accelerometer ADXL316WBCSZ (R11); converter ADCS7476AIMFX/NOPB (Q4 decided, owner, 2026-09-29) |
| Rotation | optical index, magnetic pickup, phase-wire clip, ESC telemetry, and the encoder, ABI (quadrature A and B plus an index pulse). A jumper selects the encoder input: 5V single-ended up to 1MHz, or RS-422 (Recommended Standard 422) differential up to 5MHz. A second jumper selects its supply, 5V or 12V (F4) | required; encoder decided (F4); parts: DRV5015A1QDBZR, TLV3201AIDBVR, AM26LV32EIDR (R11); optical index: no part, not known |
| Temperature | ESC (from its telemetry), motor on 2 channels, 1 infrared and 1 thermocouple (F5), onboard shunt, the 3 servo supplies and the adjustable supply (owner, 2026-09-30) | required; motor sensors decided (F5); parts: MAX31856MUD+T, MLX90614ESF-BCC-000-TU (R12), MCP9808T-E/MS (R8) |
| Thrust and torque | load cells on 3 channels, 1 for thrust and 2 for torque, at 5V excitation (F3) | required; channels decided (F3); parts: ADS1235IRHBR, BD450M2FP3-CE2 (R13) |
| External sensors | 2 I²C (Inter-Integrated Circuit) ports at 3.3V, Qwiic (JST SH, 4 pins) (Q7) | decided; part: TCA9548APWR (R12) |
| Non-volatile store | output binding: 32 record slots in 2 flash sectors, or an I²C FRAM (ferroelectric random-access memory) or EEPROM (electrically erasable programmable read-only memory) | decided (Q8, owner, 2026-09-29): MB85RC256VPNF-G-AMERE2, an I²C FRAM |
| Debug | SWD (Serial Wire Debug); firmware load over the USB (Universal Serial Bus) boot loader; the console on USB CDC (communications device class) only, with no UART console | console built; firmware image built, loading route not recorded; SWD required |
| Board description | a board number, a pin catalogue, a shape page, a pads page, and printed pad numbers the panel shows | required |
| Test access | test points for the bench's analyser and scope and for the interlock test of pull request #167; relay contacts across BOOT and RESET | required |

## Microcontroller, flash and debug

The RP2354B processors handle the IO board's functions with timing deadlines.
Each processor's 2MB of in-package flash holds its firmware image. Q8 moves the output binding to
an I²C FRAM, MB85RC256VPNF-G-AMERE2 (owner, 2026-09-29). The core executes from that flash.
Each erase and page program therefore runs with interrupts disabled,
during which the core cannot answer requests. Firmware loads over the RP2354B's own USB, and
the console is on USB only. Two dry contacts, BOOT and RESET, let the
measurement bench restart the board and enter its USB loader without
manual button presses. If the bench reflashes the IOmcu between runs, it does so over
SWD.

### Two IOmcus

Each IO board carries two RP2354B (owner, 2026-09-30). The main IOmcu
runs the outputs, the link to the display, the heartbeat monitor, the ARMED state and
stop. On this page "the IOmcu" is the main IOmcu, except for the
functions assigned to the measurement IOmcu in the table. The measurement
IOmcu handles the fixed measurement circuits and I²C control of the power
supplies. This divides the GPIO demand between the chips and provides two
more I²C buses.

| Requirement | Value | Source | State |
| --- | --- | --- | --- |
| Measurement IOmcu | the fixed ADCs: the load-cell ADC, the thermocouple converter, the accelerometer ADC and the infrared sensor, with a copy of the index pulse for balancing; the port monitors (7 INA3221), the motor monitors (2 INA228) and the cell monitor; the MCP9808T-E/MS sensors; and the I²C settings of the servo converters and the adjustable supply; the rotation inputs (encoder A, B and index, the phase-wire clip, the magnetic pickup) and the receiver input, whose readings reach the main IOmcu over the link, so the motor stall action gets its rpm that way (owner, 2026-09-30; [Pins](Pins.md)) | owner, 2026-09-30 | decided |
| Current aborts | the monitors' alert outputs reach the main IOmcu, which acts on them without the inter-chip link. Each INA3221's critical-alert output carries the 3.0A servo ceiling, and its warning-alert output the 1.0A stall threshold, whose 400ms the main IOmcu times (`docs/Servo.md:151-153`). Each INA228's ALERT carries the motor overcurrent within its 20ms (V158, V159). The outputs are open-drain and share lines: every critical output on one line, every warning output on a second and both ALERTs on a third, 3 lines at least against 16 unshared. Each shared line is an interrupt input of the main IOmcu (owner, 2026-09-30): it tells the main IOmcu that a trip occurred, not on which part, and the main IOmcu stops. A parallel-in, serial-out shift register names the part without the link (owner, 2026-09-30): it takes the 16 individual alert outputs at once and the main IOmcu clocks them out, two 8-bit parts in cascade on 3 main IOmcu pins (load, clock and data), so 6 pins with the 3 shared lines, against 16. It reads the nodes at the moment of the load: an alert that clears before the main IOmcu loads the register is not seen, which the owner accepts, since a short trip can be a servo charging its capacitors as it is connected (owner, 2026-09-30). This review does not establish whether the monitors latch their alert outputs. The main IOmcu acts on the critical line only after it remains low for longer than the blanking time; a shorter trip is logged, not an abort (owner, 2026-09-30). The blanking time is not stated. A servo that draws 3.0 to 3.96A in repeated pulses, each shorter than the blanking time, does not abort: the stall trip, 1.0A for 400ms, and the port breaker, 3.96 to 4.84A, bound it (owner, 2026-09-30). Open-drain outputs tied together cannot be read apart, so each output keeps its own node into the register, pulled up and low on a trip. CD4082 dual 4-input AND gates form the shared lines from those nodes (owner, 2026-09-30): a node pulled low pulls its group's line low. The 7 critical nodes take two cascaded gates, one CD4082, as do the 7 warning nodes, and the 2 ALERT nodes one gate of a third, so 3 CD4082 a board with the unused inputs tied high. The shift register part is not selected. A shared stall line errs on the safe side: two servos taking turns above 1.0A can hold it past 400ms. The grouping remains undecided. The measurement IOmcu reads the values for the display and the slower checks. The alert lines carry the aborts only once the measurement IOmcu has written each part's limits and enabled its alert outputs; the parts' reset values are not read here. The main IOmcu switches to ARMED only after the measurement IOmcu reports those writes read back; the reporting mechanism is not specified. How the main IOmcu treats an alert line that is not yet configured is not stated | owner, 2026-09-30; `docs/Servo.md:149-150`; V158, V159 ([Research](Research.md#raised-by-p1)) | decided; thresholds, the blanking time against the port switch's 3.96 to 4.84A breaker and the INA3221's conversion time, the monitors' alert latching, the shift register part, and the CD4082's part number, stock and speed at 3.3V: a follow-up of R8; the start-up step: firmware; the pin count: P5 |
| Inter-chip link | carries the readings, the rail settings and the measurement IOmcu's status. The main IOmcu stops the outputs when the link goes silent, as it does on the display link; the silence limit lies within the 500ms stop deadline (V1) and is not stated. It is a UART, 2 pins a side (owner, 2026-09-30); its rate and protocol remain unspecified | owner, 2026-09-30; V1 | required; rate, protocol and silence limit: firmware |
| Measurement IOmcu reset | it enables its watchdog as the main IOmcu does (owner, 2026-09-25). The load gates at reset rule (Power, below) holds a gate or an enable off while the IOmcu that drives it is in reset; it says nothing about the other one. The main IOmcu drives the enables of the servo converters and the adjustable supply's converter through its I/O expander, held off at reset (owner, 2026-09-30). It enables a converter only after the measurement IOmcu reports that converter's settings and its MCP9808's limits written and read back, and it switches every converter off when the inter-chip link goes silent, so a failed measurement IOmcu or link cannot leave a supply live on its last setting. How the measurement IOmcu reports is not stated. Its firmware load and debug route, USB or SWD, and whether it has BOOT and RESET contacts, are not stated | owner, 2026-09-25 and 2026-09-30 | required; the report and the load route not stated |
| Converter I²C | the four TPS55285 sit on the measurement IOmcu's two I²C buses, two to a bus at 74h and 75h. The encoder supply's TPS55288 answers at 74h or 75h too, so it goes on a main IOmcu bus or on a third bus the measurement IOmcu makes with PIO (programmable input/output); not decided. If the measurement IOmcu hangs or resets while it writes a converter's voltage or current limit, the converter keeps the registers as they stand, and its rail gate follows the heartbeat alone (Servo rail gate in [Link and safety](#link-and-safety)); the main IOmcu then switches the converter's enable off on the silent link (Measurement IOmcu reset, above). A read-back of each write is not stated | owner, 2026-09-30; R6 | decided; the TPS55288's bus and the behaviour on an interrupted write not decided |
| PPM output | from the main IOmcu, like every output, so its stop covers PPM when the inter-chip link fails while the heartbeat runs; the output buffer follows the heartbeat alone, and no processor may remove that enable | owner, 2026-09-30; pull request #167 | decided |
| Index pulse | the index sensor's output fans out to one pin on each IOmcu (owner, 2026-09-30). The measurement IOmcu samples the index and the accelerometer ADC on its own clock, the one timebase balancing needs (Timebase, below); the main IOmcu keeps the index for the rpm | owner, 2026-09-30; `docs/Manifest.md:30` | decided |
| Pin budget | 48 GPIO on each chip, and each chip's budget holds on its own. The draft pin map uses 44 on the main IOmcu, 4 free, and 32 on the measurement IOmcu ([Pins](Pins.md)). The external CAN controller shares the display link controller's SPI bus on the main IOmcu, with its own chip select and interrupt (owner, 2026-09-30), and the UART socket runs as a PIO UART beside the hardware UARTs of the link and of the lines for VESC controllers | P5 ([Research](Research.md#agent-layout)); [Pins](Pins.md) | required; draft |
| Supply budget | the second RP2354B adds 321mA at most to the 3.3V rail: 1,411mA, 1.76A with R5's 25% margin, against the LMQ66430MC3RXBRQ1's 3A. From the pack at the 6.0V floor it adds about 0.2A at an assumed 90%, so the board draws about 49.7A with every converter at its limit (`hardware/research/round1/T3/006-P2-R5.json`) | R5 | required |

The build inspected for the research assumes more than 2MB of flash in three places: the
board file, the output store's offset and the post-link image-size check. All
three must be checked before the first IO board build
([Research](Research.md#consequence-of-the-rp2354bs-2mb-flash)). The board
number, the reserved pins and the pin catalogue are compiled into the image,
so the IO board's build carries its own copy of
`firmware/iomcu/include/iomcu_pins.h` and a new row in `k_boards`. The
converter for the accelerometer (Q4): see [Measurement](#measurement).

| Requirement | Value | Source | State |
| --- | --- | --- | --- |
| Microcontroller | RP2354B: RP2350B die and 2MB QSPI NOR flash (Winbond W25Q16JVWI) in one QFN-80 10 × 10mm package; 48 GPIO, 8 ADC inputs, 520kB SRAM on the die, no PSRAM (pseudo-static random-access memory) in the package. Stepping A4 (owner, 2026-09-27): the marking RP2354B0A4 in JLCPCB's product photograph of C39843328; the marking on the held parts is not read. R1 reads the flash's part number from Raspberry Pi's own copy of the datasheet at datasheets.raspberrypi.com. The owner's personal library holds 20. The first build needs 10: 5 boards (S7) × 2 a board, a main and a measurement IOmcu (owner, 2026-09-30; [Two IOmcus](#two-iomcus)) | fixed inputs in [Research](Research.md#scope), prerequisite 9 in [Research](Research.md#prerequisites) (owner, 2026-09-25), S7, "IOmcu board file" in [STATUS.md](../../STATUS.md#open-items), RP2350 datasheet, build 2024-08-08, section 14.3, read from a copy | decided; not requalified by FU-A4, not verified |
| Flash supply | the in-package flash runs from QSPI_IOVDD, the QSPI supply pin. Section 14.3 gives the flash 2.7 to 3.6V. Table 1441 of build 2025-07-29 gives QSPI_IOVDD on the RP2354 as 2.97 to 3.63V, 3.3V nominal, because the in-package flash is a 3.3V part. R1 confirms both | RP2350 datasheet, build 2024-08-08, section 14.3, read from a copy; RP2350 datasheet, build 2025-07-29, Table 1441; R1 | required |
| Pin ratings | every signal that reaches an RP2354B pin is at 3.3V logic. GPIO0 to 39 are fault tolerant: rated at 5.5V only while IOVDD is at 3.3V, and at 3.63V while IOVDD is at 0V. GPIO40 to 47, the 8 ADC inputs, are rated at IOVDD + 0.5V and are not fault tolerant. For a fault-tolerant pin below 3.63V with IOVDD at 0V, the datasheet states that "very little current" flows and gives no figure. It gives a pin input leakage of 1µA at most, with no condition on IOVDD; 1µA drops 2.2mV across 2.2kΩ. The current above 3.63V with IOVDD at 0V is not stated. A series resistor is therefore not shown to hold the pin within its rating, and a 5V output that can drive before the 3.3V rail is up is translated to 3.3V. R1 confirms the ratings for the RP2354B. The tree and pull request #167 state the tolerance differently: see [Conflicts in the tree](#conflicts-in-the-tree) | RP2350 datasheet, build 2024-08-08, Table 1423 (pin types), Table 1424 (GPIO pins), Table 1430 (absolute maximum ratings) and Table 1433 (digital IO characteristics), read from a copy; R1; "No 5V transceiver is in the path" in [STATUS.md](../../STATUS.md#constraints) | required |
| Pin budget | 27 to 32 GPIO for the servo outputs, servo inputs, ESC channels, one-wire programming lines, the host link, CAN, I²C, the encoder, the load gates and the safety line. A Pico 2 brings out 26 | `firmware/iomcu/CMakeLists.txt:9-13`, `docs/Building.md:166-167` | required |
| PIO (programmable input/output) reach | a PIO block sees 32 GPIO from a base of 0 or 16, for all 4 of its state machines, and changes the base only while it holds no program. 3 blocks, 12 state machines. GPIO 32 to GPIO 47 are reachable only from a block based at 16. A pin that no free block can reach is refused. The pin map is partitioned by block before the schematic | `firmware/iomcu/include/iomcu_pins.h` (comment "The constraint on the map is silicon"), `docs/DShot.md:71-74`, `NUM_PIOS` and `NUM_PIO_STATE_MACHINES` in pico-sdk 2.3.1's `platform_defs.h` for the RP2350, P5 ([Research](Research.md#agent-layout)) | required |
| PWM slices | 12 slices of 2 channels. The two channels of a slice share one frame rate. GPIO 0 to GPIO 31 take slice (pin / 2) modulo 8, GPIO 32 to GPIO 47 take slice 8 + (pin / 2) modulo 4, and the channel is the pin's low bit. Two pins 16 apart below GPIO 32, or 8 apart from GPIO 32 up, share one compare register and cannot both carry PWM. The firmware leaves the second pin unbound, although OUTPUTS reads back the requested binding | `out_pwm_slice_of()`, `out_pwm_same_compare()` in `shared/outputs/include/out_pwm_map.h`, `docs/DShot.md:101-108`, "An unbound output slot is invisible from the panel" in [STATUS.md](../../STATUS.md#open-items) | required |
| Pins the firmware refuses | every pin the board's pin catalogue does not list as free: the catalogue's reserved pins, the pins the module uses and does not bring out, and every number the module lacks, whatever board header the SDK is built for. On the bring-up module that is GPIO 3 (heartbeat), GPIO 8 to GPIO 12 (the CAN controller on SPI: interrupt, chip select and 3 SPI lines), GPIO 23 (the converter's MODE pin), GPIO 24 (VBUS sense), GPIO 25 (LED1), GPIO 29 (VSYS sense) and GPIO 30 to GPIO 63. Free: GPIO 0 to GPIO 2, GPIO 4 to GPIO 7, GPIO 13 to GPIO 22, GPIO 26 to GPIO 28. `IOMCU_RESERVED_PINS` is unioned in as a cross-check on the heartbeat and CAN pins. The output bank and the SUPPLY page both read the one mask. The IO board appends its own catalogue, and R2's controller sets its count of CAN pins | `outbind_reserved_mask()` in `shared/outputs/out_bind.c`, `outbind_reserved_mask()` in `shared/outputs/include/out_bind.h`, `IOMCU_RESERVED_PINS` in `firmware/iomcu/include/iomcu_pins.h`, `main()` in `firmware/iomcu/src/main.c`, `docs/Link.md`, `docs/DShot.md` | built |
| Crystal and core regulator | 12MHz crystal and core regulator inductor, selected in R1. The 3.3V logic buck is selected in R5: see [Power](#power) | R1 ([Research](Research.md#research-categories)), round 1 ([Research](Research.md#scope)), RP2350 datasheet, build 2024-08-08, Table 1423, read from a copy | required; parts: ABM8-272-T3, AOTA-B201610S3R3-101-T (R1) |
| Clock accuracy | the bidirectional DShot decoder is host-tested at 4.75 and 5.25 samples a bit against a nominal 5, and the tree gives an ESC's crystal as a percent or two from the bench's. The CAN bit rate is exact to the controller's clock. The IO board's CAN controllers take a 40MHz clock (owner, 2026-10-01; Controller clock under [Link and safety](#link-and-safety)). The tolerance of the RP2354B's crystal and of the CAN controllers' clock is not stated; R1 and R2 state them | `docs/DShot.md:232-241`, `docs/Link.md:1336-1350`, `shared/can/include/can_timing.h` (comment "The rule this module enforces") | required |
| Firmware build | pico-sdk 2.0 or newer; CI (continuous integration) builds with 2.3.0. Platform `rp2350`, ARM GNU toolchain 14.2: any `arm-none-eabi` release targeting Cortex-M33 | `docs/Building.md:85-89`, `firmware/iomcu/CMakeLists.txt:17-19` | built |
| Board header | a pico-sdk board header that states the RP2350B package (`PICO_RP2350A` at 0, 48 GPIO), 2MB of flash and no PSRAM. pico-sdk's `pico2.h` sets `PICO_RP2350A` to 1, which gives `NUM_BANK0_GPIOS` 30. The default board file, `pimoroni_pico_plus2_rp2350`, states 16MB. The compile-time check on the store compares against the board header's size, so it fails the build only under a header that states less than 4MB. The tree has no board file for the IO board, and pico-sdk has none for the RP2354. `olimex_rp2350_xl.h` states the RP2350B (`PICO_RP2350A` 0) and 2MB of flash and defines no PSRAM chip select; R1 records the lines the IO board's header changes from it | `firmware/iomcu/CMakeLists.txt:5-16`, `STORE_FLASH_BYTES` in `firmware/iomcu/src/out_store.c`, "IOmcu board file" in [STATUS.md](../../STATUS.md#open-items), [Research](Research.md#consequence-of-the-rp2354bs-2mb-flash), pico-sdk 2.3.1 `boards/pico2.h:23` and `platform_defs.h:48-52`, pico-sdk 2.3.0 `boards/olimex_rp2350_xl.h:25`, `:79-82` | required |
| Image size limit | 2,088,960 bytes: 2MB less the store's two 4,096-byte sectors. The post-link check holds 4,186,112 bytes (4MB less 8kB), which passes an image that reaches into the store's two sectors. The build's size line in the docs reads 184,360 bytes. The module's board drawing in the image is 1,560 bytes | `firmware/iomcu/CMakeLists.txt:181-190`, [Research](Research.md#consequence-of-the-rp2354bs-2mb-flash), `docs/FirstRun.md:57-60`, `board_drawing_rp2350_can` in `firmware/iomcu/src/board_drawing_rp2350_can.c` | required |
| Output binding store | 32 record slots of one 256-byte page each, in the last 2 sectors of 4,096 bytes of the 2MB (of the first 4MB in the module build). A save waits for the bank to stop driving, then 400ms of settle, then 5ms of bus quiet, and programs one page. After 1,000ms without a quiet gap it programs anyway. One sector erase per 16 saves: at boot before CAN starts, or on the first quiet pass after the save that used up a sector. On the IO board Q8 moves the output binding to an I²C FRAM | `STORE_FLASH_BYTES`, `STORE_SLOTS` in `firmware/iomcu/src/out_store.c`, `firmware/iomcu/src/out_store.h` (comment "What this store does about it"), `OUT_STORE_SETTLE_MS`, `OUT_STORE_QUIET_MS`, `OUT_STORE_GAP_WAIT_MS` in `firmware/iomcu/src/out_store.h`, `out_store_tick()` in `firmware/iomcu/src/out_store.c` and its call in `main()` in `firmware/iomcu/src/main.c`, "Output binding in the IOmcu's flash" in [STATUS.md](../../STATUS.md#state), [Research](Research.md#consequence-of-the-rp2354bs-2mb-flash), Q8 | decided (Q8, owner, 2026-09-29): MB85RC256VPNF-G-AMERE2, an I²C FRAM |
| Flash write window | every erase and every page program runs with interrupts off: no CAN frame is collected and no output is stepped for its length. The W25Q16JV datasheet (revision D, 2016-08-12, read from a copy) gives a 4kB sector erase of 45ms typical and 400ms maximum, and a 256-byte page program of 0.4ms typical and 3ms maximum. Those figures are for the packaged parts in the datasheet's ordering list, which refers KGD (known good die) parts to Winbond. No public Winbond document gives figures for the W25Q16JVWI die in the RP2354B. R1 records the die's figures as not known. Q8 and P5 budget with these packaged-part maximums, each marked as such (owner, 2026-09-27). On the bring-up module's 4MB flash, a different part, an erase and a page program in one window take 19,174 to 19,186µs. The page program alone is not measured there; `STATUS.md` puts it at roughly 200 to 2,000µs. The frames the CAN controller holds through a window: see [Link and safety](#link-and-safety) | `flash_window()` in `firmware/iomcu/src/out_store.c`, `firmware/iomcu/src/out_store.h` (comment "What a write costs"), `firmware/iomcu/src/out_store.h` (comment "The window is not eliminated"), `firmware/iomcu/CMakeLists.txt:5-7`, "The flash save costs CAN frames" in [STATUS.md](../../STATUS.md#open-items), [Research](Research.md#consequence-of-the-rp2354bs-2mb-flash), W25Q16JV datasheet, revision D, read from a copy; W25Q16JV-DTR datasheet, revision I; owner, 2026-09-27; R1 | Q8 decided: the output binding is in an I²C FRAM (owner, 2026-09-29) |
| Store endurance | 100,000 erase cycles a sector, as the store's arithmetic takes it. 32 slots give about 3.2 million saves. The W25Q16JV datasheet gives at least 100,000 program-erase cycles a sector for its packaged parts. The W25Q16JV-DTR datasheet (revision I) gives at least 100,000 cycles and removes "per sector" in its revision history. The figure for the die in the RP2354B is not known; the revision D packaged figure is used, marked as such (owner, 2026-09-27) | `out_store_map_newest()` in `shared/outputs/include/out_store_map.h`, W25Q16JV datasheet, revision D, read from a copy; W25Q16JV-DTR datasheet, revision I; R1 | required |
| USB port | one USB device port on the main IOmcu's own USB pins, for the mass-storage loader and the console. Its protection is selected in R1. Whether the measurement IOmcu has a USB port of its own is not stated ([Two IOmcus](#two-iomcus)) | `docs/Building.md:160-161`, `firmware/iomcu/CMakeLists.txt:170-177`, R1 | required; protection: no part (R1), relaxed to match standard parts (owner, 2026-09-30), a follow-up of R1 |
| Firmware load | `rcbench-iomcu.uf2`, a UF2 (USB Flashing Format) file, copied to the USB mass-storage drive while the part is held in BOOTSEL. The image runs on the module. The documentation describes this route but does not record how the running image was loaded | `docs/Building.md:160-161`, `docs/FirstRun.md:47`, "IOmcu firmware" in [STATUS.md](../../STATUS.md#state) | built; loading route not recorded |
| Console | USB CDC only. UART output is disabled, so diagnostics do not appear on UART pins. A status line every 3s: CAN state, bit rate, requests served, self-test echoes, the controller's transmit and receive error counts and its error flags. A line every 3s names why the IOmcu last started, with its raw registers (`reset FLASH_UPDATE`, `reset BOOTSEL_REBOOT` and 10 more words, [Bring-up](../../docs/Bringup.md#why-the-iomcu-last-started)). A print can block until the USB host accepts it, and the module's CAN controller holds 2 frames | `firmware/iomcu/CMakeLists.txt:170-177`, `can_report()` in `firmware/iomcu/src/main.c`, `reset_start()` in `firmware/iomcu/src/iomcu_report.c`, `reset_cause_decode()` in `shared/safety/reset_cause.c`, the comment above `heartbeat_init()` in `firmware/iomcu/src/iomcu_can.c`, `main()` in `firmware/iomcu/src/main.c`, `docs/Bringup.md:22-25`, "Bring-up diagnosis, both ends' counters compared" in [STATUS.md](../../STATUS.md#state) | built |
| SWD | SWCLK and SWDIO, the SWD clock and data lines, and ground, with no supply wire from the adapter. The bench drives both lines at 3.3V from a Raspberry Pi 5 through OpenOCD's `linuxgpiod` driver and `target/rp2350.cfg`. That wiring is drawn for the bench's own RP2350 board. The bench page applies the same to the IOmcu if the bench reflashes it between runs. No RP2350 has been on these pins | `testbench/README.md:435-443`, `testbench/README.md:445-466`, `testbench/README.md:530-538`, `testbench/README.md:565-566`, `testbench/WIRING.md:98-108` | required |
| SWDIO bias | the SWD specification puts a pull-up on SWDIO at the target, and the bench host's SWDIO line is chosen to agree with it. The RP2350 datasheet gives SWDIO (QFN-80 pin 34) a pull-up at reset, and the digital IO pull-up as 32 to 86kΩ at IOVDD 3.3V. R1 confirms both for the RP2354B | `testbench/README.md:504-506`, `testbench/README.md:516-519`, RP2350 datasheet, build 2024-08-08, Tables 1427 and 1433, read from a copy; R1 | required |
| BOOT and RESET | a BOOT button and a RESET button, each a dry contact to ground, with a relay contact across each. BOOT pulls QSPI_SS (QFN-80 pin 75, the QSPI chip select and USB BOOTSEL input) to ground, and RESET pulls RUN (pin 35, chip enable and active-low reset). An unpowered relay leaves its button unpressed; both contacts are open during normal operation. BOOT closed, RESET pulsed, RESET released, BOOT released puts the board in its USB loader as a mass-storage device, where it stays until RESET is pulsed again. What a reset does to the link: see [Link and safety](#link-and-safety). These contacts serve the main IOmcu; whether the measurement IOmcu has its own is not stated ([Two IOmcus](#two-iomcus)) | `testbench/README.md:665-684`, `testbench/WIRING.md:240-247`, `testbench/WIRING.md:297-309`, RP2350 datasheet, build 2024-08-08, Tables 1425 and 1427, read from a copy | required |
| Board identity | a board number compiled into the image and reported in register 5 of the identity page (0x00). Numbers are appended and never renumbered: 0 is an unknown board, 1 the Pico-header module. The IO board appends a number and a row in `k_boards` | `IOMCU_BOARD_ID` in `firmware/iomcu/include/iomcu_pins.h`, `LINK_PAGE_IDENTITY` in `shared/link/include/link_pages.h`, `LINK_ID_HARDWARE` in `shared/link/include/link_pages.h`, `outbind_board_id_t` in `shared/outputs/include/out_bind.h`, `k_boards` in `shared/outputs/out_bind.c` | required |
| Capability word | register 6 of the identity page, bits 0 to 8: ESC drive, ESC telemetry, servo PWM, servo current, pack volts and amps, receiver bus, vibration and index pulse, cell monitor, programming. The module build sets ESC drive, ESC telemetry and servo PWM. Each other bit is set when its part is fitted or its program is written. The panel reads the word at bring-up (`bring_up()` in `firmware/panel/main/main.c`), at each link-up (`link_came_up()` in `firmware/panel/main/panel_poll.c`) and after a SENSE set-up the IOmcu takes (`sense_link_service()` in `firmware/panel/main/panel_services.c`), and uses it for the menu and the overview only: an overview tile whose bits are clear carries a SIMULATED badge. The word does not select the data displayed by a screen. While the IOmcu answers, the panel uses its BENCH page, and a quantity with its valid bit clear is displayed as an empty field. The panel models the bench only while nothing answers. The comment on the bitmap states otherwise: see [Conflicts in the tree](#conflicts-in-the-tree) | `LINK_ID_CAPABILITIES`, `link_cap_t` in `shared/link/include/link_pages.h`, `IOMCU_CAPABILITIES` in `firmware/iomcu/src/iomcu.h`, `capabilities_update()` in `firmware/iomcu/src/iomcu_sense.c`, `bring_up()` in `firmware/panel/main/main.c`, `read_bench()` in `firmware/panel/main/panel.h`, `render()` in `shared/ui/overview_screen.c`, `ui_router_tick()` in `shared/ui/ui_router.c`, "Measured or modelled" in [STATUS.md](../../STATUS.md#architecture), `docs/Link.md:786-789` | required |
| Pin catalogue | up to 32 pins, one register each: GPIO in 6 bits, printed pad number 1 to 63 in 6 bits (0 means no pin), holder in 4 bits (0 free, 1 heartbeat, 2 CAN, 3 flash, 4 debug, 5 sensor, 15 other). A pin a sensor holds is one the bench may not drive. Served on page 0x24 for a panel that has no row for the board | `LINK_PAGE_CATALOGUE` in `shared/link/include/link_pages.h`, `LINK_CAT_OF()`, `link_pin_hold_t` in `shared/link/include/link_pages.h`, `docs/Link.md:758` | required |
| Printed pad numbers | the pad number printed beside each brought-out pin is the number the catalogue reports and the panel shows | `docs/Screens.md:1703-1705`, `k_pico_pins` in `shared/outputs/out_bind.c` | required |

### Not known

- Whether the BOOT contact takes a series resistor on QSPI_SS, which is also the in-package flash's chip select, is not stated in the tree (R1).
- Whether OpenOCD's `target/rp2350.cfg`, the one target the bench names, reaches the RP2354B and programs its in-package flash is not stated in the tree (R1).
- Whether 27 to 32 GPIO also covers the 20 output ports, the I/O expander's bus and interrupt, and the sensor inputs is not stated in the tree. The sensor inputs are the load cells on 3 channels (F3), the phase-wire rpm clip, the motor temperature on 2 channels (F5), the magnetic rpm pickup (owner, 2026-09-24), the encoder in two signal forms (F4) and 2 external I²C ports (Q7). P5 ([Research](Research.md#agent-layout)) counts about 51 committed signals against 48 GPIO, before the accelerometer path and the status lines; whether the board fits is not known ([Control](Control.md#not-known)).
- `OUTBIND_PINS`, the most pins any board in the build brings out, is 26 (`OUTBIND_PINS` in `shared/outputs/include/out_bind.h`). The outputs screen lays its pin cells out in 4 columns of 7, 28 cells (`GRID_COLS`, `GRID_ROWS` in `shared/ui/outputs_screen.c`). The catalogue carries up to 32. How the panel lists an IO board that brings out 27 to 32 pins is not stated.
- The erase and page-program times of the in-package flash are not measured on a board. Q8 moves the output binding off the flash to an I²C FRAM, MB85RC256VPNF-G-AMERE2 (owner, 2026-09-29).
- A routine in SRAM to empty the CAN controller during a flash window is not implemented (`firmware/iomcu/src/out_store.h` (comment "The window is not eliminated")).
- The overrun count across 16 saves, the heartbeat after a flash window and a power cut during a save are not measured ("The flash save costs CAN frames" in [STATUS.md](../../STATUS.md#open-items)).
- The store opens its window in the gap after a poll, up to 45ms (`OUT_STORE_QUIET_MS` in `firmware/iomcu/src/out_store.h`). On the W25Q16JV datasheet's figures for packaged parts, a sector erase of 45ms typical and 400ms maximum is as long as that gap or longer. How the store's timing holds on the RP2354B is not analysed (Q8).
- SWD from the bench host has not reached any RP2350. Its fixed rate of about 800kHz for writes and 360kHz for reads is not measured. Under any PCIe (Peripheral Component Interconnect Express) active-state power-management policy but `performance`, the bench host can clock the first pulses as fast as 20MHz, and the policy on the bench host reads `powersave`. Whether this prevents a connection is not measured (`testbench/README.md:441-443`, `testbench/README.md:540-558`, `testbench/WIRING.md:141-146`).
- The USB connector type is not stated in the tree. Connectors are selected in round 2 ([Research](Research.md#scope)).
- The proposed IO board's board number is not assigned. The current tree lists 0 for unknown, 1 for the Pico-header module and 2 for the rbmod carrier (`outbind_board_id_t` in `shared/outputs/include/out_bind.h`).
- How the IO board finds which front ends are fitted, to set its capability bits, is not stated. The panel reads the word at bring-up, again at each link-up (`link_came_up()` in `firmware/panel/main/panel_poll.c`), and after each SENSE set-up the IOmcu takes, while the link stays up (`sense_link_take_caps()` in `shared/bench/sense_link.c`, called from `sense_link_service()` in `firmware/panel/main/panel_services.c`).
- The IO board's drawing is not drawn. The link carries a board drawing of at most 5,328 bytes ([The board drawing](../../docs/Link.md#the-board-drawing)); the module's is 1,560 bytes.
- The current firmware supports CAN updates through UPDATE_CTL and UPDATE_DATA, with two image slots on supported boards. The proposed IO board still needs a partition layout for its in-package flash; see [Firmware update over the link](../../docs/Link.md#firmware-update-over-the-link). The link's bulk class also names image transfer (`LINK_CAN_PRIO_BULK` in `shared/link/include/link_can.h`).

## Link and safety

The IO board is one of the two nodes on a classic CAN bus to the display.
Every command and measurement crosses this link, and the IOmcu transmits only
in answer to a request. On the bring-up module the CAN controller sits on SPI
behind a 3.3V transceiver. R2 chooses the IO board's controller and
transceiver.

The display's safety line carries edges, one every 20ms, not a level. It has two
monitors. Firmware on the IOmcu rejects intervals outside 4 to
150ms and runs on the bring-up module. A retriggerable monostable removes the
output drive and opens the servo and ESC power switches when the edges stop,
with no firmware in the path. Pull request #167 specifies the monostable. It
has not been fitted to a board. R3 ([Research](Research.md#research-categories)) chooses its
parts, and R4 the output buffer, to meet pull request #167 at commit
23c82ca, not merged. Prerequisite 4 ([Research](Research.md#prerequisites))
fetches that commit. This hardware path does not disable the outputs if the IOmcu stops
responding while the display continues sending heartbeat edges.

| Requirement | Value | Source | State |
| --- | --- | --- | --- |
| Bus | classic CAN without FD (flexible data rate), 1Mbit/s, 29-bit identifiers only, protocol 4.21; two nodes, the display and the IO board. CAN only: no RS485 (Recommended Standard 485) transceiver, direction circuit or turnaround. Run on the bring-up module at 1Mbit/s with zero errors at either end, 2026-08-28 | `docs/Link.md:12`, `docs/Link.md:71`, `xl2515_init()` in `firmware/iomcu/src/xl2515.c`, "The link is CAN only" in [STATUS.md](../../STATUS.md#constraints), "CAN drivers (TWAI on the panel, XL2515 on the IOmcu) and the echo self-test" in [STATUS.md](../../STATUS.md#state), "2. The CAN link" in [STATUS.md](../../STATUS.md#order-of-work) | built |
| Bit timing | exactly 1Mbit/s; both ends sample at 75% of the bit; a rate the clock cannot make exactly is refused | `docs/Link.md:1336-1350`, `shared/can/include/can_timing.h` (comment "The rule this module enforces"), "CAN drivers (TWAI on the panel, XL2515 on the IOmcu) and the echo self-test" in [STATUS.md](../../STATUS.md#state) | built |
| Controller clock | makes 1Mbit/s exactly with the sample point at 75%. The module's controller halves its crystal and needs at least 8 quanta a bit, so it takes a 16MHz crystal; 8MHz caps the bus at 500kbit/s. On the IO board each MCP2518FDT-E/SL, the link's and the external CAN port's, takes a 40MHz clock (owner, 2026-10-01); [Pins](Pins.md) gives the reason, the controller's SPI clock limit against the link's 10MHz | `docs/Link.md:17`, `docs/Link.md:1345-1350`, `IOMCU_CAN_CRYSTAL_HZ` in `firmware/iomcu/include/iomcu_pins.h`, "The XL2515 module's crystal is 16MHz" in [STATUS.md](../../STATUS.md#constraints), owner, 2026-10-01 | required; 40MHz decided (owner, 2026-10-01); clock part: round 2, not verified |
| Controller interface | SPI at 10MHz, mode 0, and an active-low interrupt line with a pull-up: 5 GPIO. The driver in the tree is written for the MCP2515 register map and polls; the interrupt line never asserts | `IOMCU_CAN_SPI`, `IOMCU_CAN_SPI_HZ`, `IOMCU_CAN_PIN_INT` in `firmware/iomcu/include/iomcu_pins.h`, `xl2515_init()` in `firmware/iomcu/src/xl2515.c`, `xl2515_init()` in `firmware/iomcu/src/xl2515.c`, `shared/can/include/mcp2515.h` (comment "The MCP2515's register map and frame layout"), `testbench/WIRING.md:438-440`, "CAN drivers (TWAI on the panel, XL2515 on the IOmcu) and the echo self-test" in [STATUS.md](../../STATUS.md#state) | built; IO board part: MCP2518FDT-E/SL, which needs a new driver (R2) |
| Received frames held through a flash stall | the module's controller holds 2 frames, 260µs at 1Mbit/s, a frame being about 130µs. The module's 19ms flash window is about 150 frame times, and across nine saves the overrun count rises from 2 to 8. On the W25Q16JV datasheet's figures for packaged parts (see [Microcontroller, flash and debug](#microcontroller-flash-and-debug)), a sector erase is about 350 frame times typical and 3,100 at most, and a page program about 3 typical and 23 at most. Whether those figures hold for the RP2354B's die is not known (R1). One lost frame is enough for FAULT 01. The store in the tree saves only with the bank idle and the bus quiet. R2 reports how many frames each candidate controller holds against the frames the panel sends in a stall | "The flash save costs CAN frames" in [STATUS.md](../../STATUS.md#open-items), "Output binding in the IOmcu's flash" in [STATUS.md](../../STATUS.md#state), W25Q16JV datasheet, revision D, read from a copy; R2 | Q8 decided (owner, 2026-09-29); MCP2518FDT-E/SL holds 32 frames (R2) |
| Error reporting | transmit and receive error counters, the error flag register and a receive-overflow flag, readable by the IOmcu. The STATUS page carries the two counters. The self-test status frame carries the two counters, the flag register and an overflow count | `docs/Link.md:748`, `sample()`, `can_report()` in `firmware/iomcu/src/main.c`, `can_service()` in `firmware/iomcu/src/iomcu_can.c`, `can_remote_status_t` in `shared/can/include/can_selftest.h`, `xl2515_errors()` in `firmware/iomcu/src/xl2515.c`, "Bring-up diagnosis, both ends' counters compared" in [STATUS.md](../../STATUS.md#state) | built |
| Echo self-test | the IOmcu echoes probe frames on page 0x7E at all times. The display runs the test for 1200ms at every start-up; its transmit error counter reaching 128 is consistent with missing acknowledgements, but does not by itself prove that the IOmcu is absent | `docs/Bringup.md:18-20`, `docs/Bringup.md:43-45`, `docs/Bringup.md:92-94`, `CAN_SELFTEST_PAGE` in `shared/can/include/can_selftest.h`, "CAN drivers (TWAI on the panel, XL2515 on the IOmcu) and the echo self-test" in [STATUS.md](../../STATUS.md#state) | built |
| Acknowledgement | the IO board is the only other node. Bus-off has occurred on the bring-up bench. The former estimate of about 4ms at 1Mbit/s from missing acknowledgements alone omits CAN's error-passive ACK exception; a missing peer does not guarantee bus-off. On a bus that allows recovery, the poll schedule permits a return in up to about 3s; no return time is recorded | `docs/Link.md:42-54`, `xl2515_init()` in `firmware/iomcu/src/xl2515.c`, `CHANGELOG.md:2667-2677` | built; return time not recorded |
| Controller and transceiver logic level | every controller or transceiver output that reaches an RP2354B pin is at 3.3V, within the pin ratings in [Microcontroller, flash and debug](#microcontroller-flash-and-debug). With an SPI controller those are the controller's SPI data out and its interrupt; without one, the transceiver's receive output. A 3.3V part, or one whose logic-supply (VIO) pin is at 3.3V. The module's transceiver is a 3.3V part | R2 ([Research](Research.md#research-categories)), `docs/Link.md:15`, `IOMCU_CAN_PIN_MISO`, `IOMCU_CAN_PIN_INT` in `firmware/iomcu/include/iomcu_pins.h`, "No 5V transceiver is in the path" in [STATUS.md](../../STATUS.md#constraints) | required; parts: MCP2518FDT-E/SL, TCAN3413DR (R2) |
| Termination | 120Ω at each end of the bus, one at the IO board's end; about 60Ω between CANH and CANL, the bus's high and low lines, with the bench unpowered | `docs/Link.md:16`, `testbench/WIRING.md:417-419` | decided; terminator part: round 2, not verified |
| Link cable | CANH and CANL twisted over the whole run, away from motor leads; the bus under 5m; each board's branch under 30cm. The panel's fault screen lists a partly inserted connector as a possible cause of lost frames. The cable also carries the display's supply: see [Power](#power) | `checks_for()` in `shared/ui/busfault_screen.c`, `BF_RUNNING_2`, `BF_LOSSY_4` in `shared/text/include/ui_text.def`, `testbench/WIRING.md:403-407`, owner, 2026-09-24 | required |
| Link-silence failsafe | 200ms without a request, counted from the first request; latches; left only by a write of 0x5AFE to CLEAR on the control page. The display escalates after 1s. It has fired on the module as FAULT 01 | `docs/Link.md:29-32`, `docs/Link.md:782-784`, `LINK_DEV_SILENCE_MS` in `shared/link/include/link_dev.h`, `LINK_HOST_TIMEOUT_MS` in `shared/link/include/link_host.h`, `docs/Safety.md:16`, "IOmcu firmware" in [STATUS.md](../../STATUS.md#state), "The control page under measurement" in [STATUS.md](../../STATUS.md#open-items) | built |
| Stop over the link | a pressed STOP stops the heartbeat, which drives the line low at once, and writes ARM = 0 to the control page; written. The panel is the only place a STOP button exists; the IO board has no STOP input | `docs/Safety.md:17`, `docs/Safety.md:19-20`, `docs/Safety.md:383-384`, `heartbeat_gen_step()` in `shared/safety/include/heartbeat.h` | required |
| Heartbeat source | display GPIO28, a free pin of the 7-inch ESP32-P4 board's GPIO header (`PANEL_HEARTBEAT_PIN`); GPIO28 is provisional until the pin is fixed on the first sample. A 3.3V push-pull output. One edge every 20ms, a 40ms cycle; the period is not confirmed on a scope. The line goes low at once when the display is not fit to run | `docs/Safety.md:28-30`, `firmware/panel/main/panel_control.c` (comment "Driven from the loop that reads touch and draws STOP"), `testbench/WIRING.md:599-602`, `HEARTBEAT_PERIOD_MS` in `shared/safety/include/heartbeat.h`, `heartbeat_gen_step()` in `shared/safety/include/heartbeat.h`, `testbench/WIRING.md:495`, "Heartbeat generator and monitor" in [STATUS.md](../../STATUS.md#state), "The control task has no test of its own" in [STATUS.md](../../STATUS.md#open-items), pull request #167 | built |
| Heartbeat monitor in firmware | 4 to 150ms between edges accepted; the line trusted after 4 good intervals (80ms), distrusted on one bad interval or one silent window. Input pulled down, sampled in the main loop. The loop turns over faster than 4ms except during a flash window and during a console print to a USB host that is slow to read. ARM refused while the line is not trusted; the bank switched to SAFE on the pass that trust is lost; STATUS fault bit 4 set while it is not trusted | `HEARTBEAT_MIN_GAP_MS`, `HEARTBEAT_MAX_GAP_MS`, `HEARTBEAT_GOOD_RUN` in `shared/safety/include/heartbeat.h`, `docs/Safety.md:67-86`, `heartbeat_init()` and the comment above it in `firmware/iomcu/src/iomcu_can.c`, `control_write()` in `firmware/iomcu/src/iomcu_pages.c`, `status_gate()` in `firmware/iomcu/src/iomcu.h`, `safety_gate_status()`, `safety_gate_step()` in `shared/safety/safety_gate.c`, `main()`, `outputs_off()` in `firmware/iomcu/src/main.c`, `docs/Link.md:777-778`, `docs/Link.md:839-841`, "Heartbeat generator and monitor" in [STATUS.md](../../STATUS.md#state) | built |
| Monostable topology | the single-channel OR design: a dual retriggerable monostable, one half per edge polarity, the two outputs combined by an OR gate into one enable node, high while retriggered (F10). R3 selects the parts | pull request #167, R3, F10 | decided; parts: 74HC423BQ,115 and 74AUP1G32GW,125 (R3) |
| Trigger | both edges. A single-edge trigger sees a 40ms period and a worst case of 300ms, which the window cannot cover | pull request #167 | required |
| Window | the enable node falls 155ms to 185ms after the last edge at every corner of 0 to 50°C and 3.3V ±3%, set to 170ms on test. The lower bound is the firmware's 150ms plus 5ms for one late control-task pass. Other pages give 150ms: see [Conflicts in the tree](#conflicts-in-the-tree) | pull request #167 | required |
| Timing network | window = k × R × C, set on test: C fitted, the window measured, R selected from the E96 series, between 50kΩ and 150kΩ, to put the enable node at 170ms. C in a dielectric with a stated temperature coefficient. The timing components at the part's pins; the timing node has no other connection, and carries no test point, because a probe on it changes the window | pull request #167 | required; C and R: round 2, not verified |
| Deadline | output buffer disabled and every power switch open within 200ms of the last edge, no slower than the IOmcu's 200ms link failsafe. The switched rail's fall to its load's stop voltage is outside the budget: measured with the load and recorded, not specified | pull request #167 | required |
| Output gate | the enable of the buffer or level translator between the RP2354B's output pins and the output connector. Disabled: outputs at high impedance under 1µs after the enable node falls, and each connector line pulled down by 10kΩ. The enable pin carries its own 10kΩ pull to its disabled level. A line that carries bidirectional DShot takes a pull-up in place of the pull-down (F14). The 20 output ports and the UART socket pass the gate (F13). Both are in [Outputs, programming, receiver inputs and ESC telemetry](#outputs-programming-receiver-inputs-and-esc-telemetry). A pin bound as a servo output can carry a running motor | pull request #167, `docs/Safety.md:30-34`, `docs/Safety.md:405-409`, "Monostable" in [STATUS.md](../../STATUS.md#open-items) | required |
| Servo rail gate | a high-side switch on each of the 3 servo rails (up to 8.4V, up to 6.35A each) and on the adjustable supply's output (0.8V to 15V, up to 6.35A; owner, 2026-09-30), open within 5ms of the enable node falling, and open with its control input undriven or the 3.3V supply absent. Off-state leakage under 5mA, a placeholder until a load's idle current is measured | pull request #167, R3, Servo rail in [hardware STATUS](../STATUS.md#decided), [Power](Power.md#servo-supply-tps55285); see [Conflicts in the tree](#conflicts-in-the-tree); V55, owner, 2026-09-30 | required; the gate conducts from 0.8V (V55, owner, 2026-09-30), and the BTS7004-1EPP starts only once its supply reaches VS(OP), 4.1V at most, and runs down to VS(UV), 3.1V at most (BTS7004-1EPP Rev. 1.11 Table 9; `hardware/research/round1/FU-A3/015-P4-datasheet-R3.json`), so it does not switch a rail set below that: no part, a follow-up of R3 |
| ESC pack gate, onboard 150A path | a MOSFET array and its driver on the IO board (F7). A high-side switch with the servo rail gate's opening time, fail-open rule and leakage limit. Rated for 67.2V, 16 cells at 4.2V a cell (F15), plus a margin that P1 asks the owner for, and for 150A continuous (F2) | pull request #167, R3, F2, F7, F15 | decided (F7); driver TPSI3052DWZR (R3); MOSFETs: no part, not known |
| ESC pack gate, external path above 150A | a driven external module, whose driver output is on the IO board (F7). A high-side switch, open with its control input undriven or the 3.3V supply absent, within the servo rail gate's off-state leakage limit, open within 5ms of the enable node falling. The module is a part off the board, bought at the second vendor of S3 | F7, S3, sourcing rule 1 ([Research](Research.md#sourcing-rules)), pull request #167, R3 | decided (F7); driver output TPSI3052DWZR (R3); module: no part, not known |
| Fail-safe direction | unpowered, undriven, unbuilt, an open trigger line and the display driving into an unpowered circuit all leave both gates disabled. 100kΩ pull-downs hold the trigger input, each OR input and the enable node low | pull request #167, `testbench/WIRING.md:499` | required; pull-downs: round 2, not verified |
| Powered-off isolation | every logic input in the interlock that can be driven while its own supply is absent has I_off (a datasheet limit on input current with the input above the device's supply and the supply at 0V, which means no diode from the input to the supply pin) or a series resistor of 4.7kΩ or more, at most 1mA at 3.3V. The monostable's trigger inputs take both. An inverter in the trigger path takes I_off behind the trigger's series resistor. The OR gate takes I_off on both inputs. The output buffer takes I_off on every input on the RP2354B side and on its enable. An inverter on an active-low output enable, and a switch driver's logic input, take I_off or a 4.7kΩ series resistor from the enable node. Tested by removing each device's supply alone with everything upstream live | pull request #167, R3, R4 | required; parts with I_off: SN74AUP1G17DBVR, 74AUP1G32GW,125, SN74LVC1G04DBVR (R3, R4) |
| Heartbeat node | one node, three branches: the display's GPIO28, an RP2354B input and the trigger input. A removable link in the display's branch and one in the trigger branch. A 4.7kΩ series resistor in the trigger branch and one in the RP2354B branch, each holding current into an unpowered input to 0.7mA at 3.3V. The trigger's series resistor and 100kΩ pull-down sit on the monostable's side of its link, so an open link is a low trigger | pull request #167, `testbench/WIRING.md:501` | required; resistors and links: round 2, not verified |
| Power-up | the enable node stays low through the 3.3V ramp until edges arrive. The clear release never triggers (the '423 behaviour); a part that generates a pulse when clear is released is excluded. No part reviewed by R3 provides both this behaviour and I_off, and Q9 settles it | pull request #167, R3, Q9 ([Research](Research.md#decided-on-the-researchs-output)) | required; Q9 decided: 74HC423BQ,115 with SN74AUP1G17DBVR in front of its trigger inputs (owner, 2026-09-29) |
| Clear network | a reset supervisor with a stated threshold and delay (F12), in place of the resistor-capacitor network of pull request #167. Its threshold and delay are not stated; R3 selects the part | pull request #167, F12, R3 | decided (F12); part: TPS3703A7330DSERQ1 (R3) |
| Latch | a hardware latch, set by the monostable's first expiry and cleared only by an operator clear control (F11). Pull request #167 lets the enable return on the first resumed edge and leaves the latch to the IOmcu's switch to ARMED in firmware; the hardware latch holds the enable low past that edge (see [Conflicts in the tree](#conflicts-in-the-tree)). "Every stop latches" in [STATUS.md](../../STATUS.md#constraints) holds that every stop latches. Its power-up state and its place relative to the enable node and the gates are not stated; P1 asks them. Its inputs follow the powered-off isolation rule above | pull request #167, F11, R3, "Every stop latches" in [STATUS.md](../../STATUS.md#constraints) | decided (F11); part: 74LVC1G175GW,125, clear control 434153017835 (R3) |
| Not defeatable | no processor, register or firmware in the path from GPIO28 to either gate. The RP2354B input listens and cannot add to the enable or remove it | pull request #167, `testbench/WIRING.md:500` | required |
| Interlock supply | the IO board's 3.3V rail, over which the window is specified at 3.3V ±3%; ground common with the display's GND | pull request #167 | required |

### Not known

- The IO board's CAN controller and transceiver are MCP2518FDT-E/SL and TCAN3413DR (R2); the MCP2518FD holds 32 received frames, and the panel sends at most 9 in one 400ms flash stall (V16, found by R2). On the W25Q16JV datasheet's figures for packaged parts that is a 4kB sector erase of 45ms typical and 400ms maximum, or a 256-byte page program of 0.4ms typical and 3ms maximum. Whether they hold for the RP2354B's die is not known (R1). Q8 moves the output binding to an I²C FRAM (owner, 2026-09-29).
- The IO board's CAN controller, MCP2518FDT-E/SL, does not use the MCP2515 register map the driver in the tree is written for, so it needs a new driver (R2).
- The heartbeat monitor after a flash window. On the bring-up module, an interval read short after a 19ms window drops the line's trust for about 80ms. This is derived from the periods and not measured on hardware (the comment above the `out_store_tick()` call in `main()` in `firmware/iomcu/src/main.c`; "The flash save costs CAN frames" in [STATUS.md](../../STATUS.md#open-items)). On the W25Q16JV datasheet's figures for packaged parts a sector erase takes 45ms typical and 400ms maximum, and the maximum is above the 150ms gap the monitor accepts. The effect is not analysed.
- Whether the IO board's terminator is fitted, switchable or external: not stated in the tree. The bring-up module's [photograph](../../configurator/public/pictures/08-rp2350-can-b.webp) shows a 3-position screw terminal beside a slide switch; no page describes either. R2, and round 2 ([Research](Research.md#scope)).
- The link cable's connector and pin order: not stated in the tree. Round 2 selects connectors ([Research](Research.md#scope)).
- Whether the heartbeat runs in the link cable or on its own lead from the display's GPIO header, and the connector at the IO board: not stated in the tree. Pull request #167 lists the connector between the display and the trigger input as not specified.
- Whether the IO board may draw anything from the display header's 3V3 pin: not stated in the tree. No question asks it.
- Whether the display keeps a supply of its own while the IO board is unpowered: not stated in the tree (see [Conflicts in the tree](#conflicts-in-the-tree)). The 4.7kΩ resistor bounds the current into an unpowered RP2354B input to 0.7mA. For a fault-tolerant pin below 3.63V with IOVDD at 0V the datasheet states that very little current flows and gives no figure (Table 1423). How far that current raises the board's 3.3V rail is not measured; test step 4 of pull request #167 measures it.
- The time from IO board power-up to its CAN controller acknowledging frames: not measured. With one supply for both boards (owner, 2026-09-24), it runs against the display's 1200ms start-up self-test (`docs/Bringup.md:43-45`). No question asks it.
- A hardware session must exercise these paths: the failsafe clear, a STOP during a throttle command, the link unplugged while ARMED, and a switch to ARMED refused for each of its three reasons ("The control page under measurement" in [STATUS.md](../../STATUS.md#open-items)). A session with both boards is needed to verify them.
- Where the monostable sits, on the IO board or on a board of its own: not specified in pull request #167. R3 ([Research](Research.md#research-categories)) places it in the IO board's research. Other pages place it on a daughterboard: see [Conflicts in the tree](#conflicts-in-the-tree).
- A timing element that lengthens a window or opens, and a monostable output, OR output or switch failed conducting: not covered by the single-channel design, which F10 chooses.
- The operator clear control of the hardware latch is a push button on the IO board, 434153017835, through a resistor-capacitor debounce and a Schmitt buffer to the latch clock (V31, found by R3). Whether a clear driven by a relay or by firmware meets the Not defeatable rule: not stated.
- The reset supervisor's threshold and delay: not stated (F12). They depend on the 3.3V ramp time, which is not stated either (see [Power](#power)).
- The chosen part's timing constant k, its drift, and the timing-pin leakage: assumed (k = 0.45 at 3.3V and 25°C, ±3% drift; 0.5µA at 50°C). The window's 2.7ms margins in each direction depend on these assumptions. R3 replaces them from the datasheet.
- No part R3 read has both the '423 behaviour and I_off on its trigger inputs. Q9 ([Research](Research.md#decided-on-the-researchs-output)) is decided: the 74HC423 keeps the '423 behaviour, and an SN74AUP1G17DBVR with I_off goes in front of its trigger inputs (owner, 2026-09-29).
- The servo rail gate as one switch on the rail (pull request #167) or as the 20 per-port supply switches (owner, 2026-09-25): not stated in the tree. The Not defeatable rule keeps a gate off the I/O expander that drives the port switches, so R3's rail switch is the gate, one on each of the 3 servo rails and one on the adjustable supply's output (owner, 2026-09-30); P1 asks the owner to confirm it (R3, R6).
- The fall of a switched rail to its load's stop voltage: not bounded. An ESC with 470µF and 50mA of idle draw takes about 230ms from 25V to 0.5V (pull request #167). Each load's stop voltage is not measured, and 0.5V stands in. Measured with the load (`testbench/WIRING.md:571-584`).
- Behaviour outside 0 to 50°C: not analysed (pull request #167).
- The IOmcu enables the RP2350 watchdog (owner, 2026-09-25). A frozen IOmcu stops feeding it, the chip resets, and every gate the IOmcu drives opens while its pins are at their reset state. The monostable's gates follow the enable node alone and stay enabled through that reset while the panel beats; R6 checks the port switches through it and R4 the connector's idle level. The stop deadline it serves is 500ms (owner, 2026-09-30); the watchdog timeout is not stated. The timeout exceeds the longest legitimate stall of the IOmcu, including a W25Q16JV sector erase (400ms maximum), and R1 checks it against both. The image enables none: no call to one appears under `firmware/iomcu/`. The link and heartbeat checks in `safety_gate_step()` in `shared/safety/safety_gate.c` watch the panel, not the IOmcu (`docs/Safety.md:55-58`).

## Outputs, programming, receiver inputs and ESC telemetry

This section specifies the signal paths between the RP2354B and servos,
ESCs, programmers and receivers. The board requires 20 typed output ports (owner, 2026-09-25):
16 PWM ports and 4 multiprotocol ports. A PWM port is enabled or disabled and
has a configured pulse range; its frame rate is set per pair of ports, because the two
channels of one PWM slice share a period, and one PWM port can switch to PPM. A
multiprotocol port is set to servo PWM, DShot, bidirectional DShot, ESC
telemetry, servo configuration or ESC bootloader, so the programmer's protocols
use these 4 ports, with no separate programming connector. Bidirectional
DShot on all 4 takes 8 of the 12 PIO state machines and 64 of the 96 instruction words. The board also has
receiver inputs of one signal wire per bus, a one-pin UART socket for OpenYGE ESC
telemetry and other serial devices, and an external CAN port on a
controller of its own. The 20 ports and the UART socket leave the board through
the output gate of the heartbeat monostable ([Link and safety](#link-and-safety)),
and the external CAN transceiver is in standby while the enable is low.

Some lines carry both directions on one wire. Bidirectional DShot releases the
line after each frame and reads the ESC's reply on the same pin. The one-wire
bootloader and OpenYGE are half duplex. A one-way buffer on such a line blocks
the receive direction. PIO reach and the PWM slices limit the pin map: see
[Microcontroller, flash and debug](#microcontroller-flash-and-debug).

| Requirement | Value | Source | State |
| --- | --- | --- | --- |
| Output slots | 8 slots and 8 channels, shared by every driver; one pin per slot. PPM carries up to 8 channels on its one pin and fills the channel budget alone. A ninth slot needs a minor protocol version and a second page. The IOmcu on the bring-up module answers the three output pages. The IO board's 20 ports need that protocol change, and a typed-port OUTPUTS screen in place of the pin grid; both are firmware work outside round 1. The ports' supply: see [Power](#power) | `LINK_OUT_SLOTS`, `LINK_OUT_CHANNELS` in `shared/link/include/link_pages.h`, `outbind_can_add()` in `shared/outputs/out_bind.c`, "IOmcu firmware" in [STATUS.md](../../STATUS.md#state), "Outputs screen" in [STATUS.md](../../STATUS.md#state) | built |
| Servo PWM | hardware PWM slice, 1MHz counter, 1µs resolution; frame rate 40 to 400Hz; pulse 400 to 2500µs, refused outside; default range 1000 to 2000µs; SERVO PWM and MOTOR PWM bind at 50Hz. No pulse width or frame period has been read on an instrument | `docs/DShot.md:76-86`, `LINK_MINOR_PULSE_FRAME` in `shared/link/include/link_pages.h`, `k_protos` in `shared/outputs/out_bind.c`, "Output drivers (PWM, PPM, DShot, bidirectional DShot)" in [STATUS.md](../../STATUS.md#state) | built |
| PPM | 1 pin, up to 8 channels; 300µs marks; sync gap at least 3000µs; channel ceiling 2500µs. 8 channels need 23.3ms, so the bind rate is 40Hz and 50Hz is refused. Driver range 20 to 50Hz. Polarity is a pad inversion. 1 PIO state machine and 2 DMA (direct memory access) channels. | `docs/DShot.md:114-140`, `k_drivers` in `shared/outputs/outputs.c`, `k_protos` in `shared/outputs/out_bind.c`, `out_ppm_bind()` in `protocols/ppm/rp2350/out_ppm.c`, "Output drivers (PWM, PPM, DShot, bidirectional DShot)" in [STATUS.md](../../STATUS.md#state) | required |
| Plain DShot | 16-bit frame; a 0 is high for 37.5% of the bit period, a 1 for 75%. 1 PIO state machine at 8 times the bit rate, 4.8MHz for DShot600. Frames at 1kHz. Bind list DSHOT300 and DSHOT600; driver range 150 to 1200kbit/s. The line idles low. No timing seen on an instrument | `docs/DShot.md:142-177`, `docs/DShot.md:336-340`, `k_drivers` in `shared/outputs/outputs.c`, `k_protos` in `shared/outputs/out_bind.c`, `DSHOT_UPDATE_HZ` in `firmware/iomcu/src/outputs_hw.c`, `protocols/dshot/rp2350/out_dshot.h` (comment "Implements the DShot protocol of ESCs"), `out_dshot_stop()` in `protocols/dshot/rp2350/out_dshot.c`, "Output drivers (PWM, PPM, DShot, bidirectional DShot)" in [STATUS.md](../../STATUS.md#state) | built |
| Fastest edges on an output | DShot600, the fastest rate the bench binds: a 1.67µs bit whose zero-bit high is about 0.63µs. The DShot driver itself accepts up to 1200kbit/s | `testbench/WIRING.md:663`, `testbench/WIRING.md:673-677`, `k_protos` in `shared/outputs/out_bind.c`, `k_drivers` in `shared/outputs/outputs.c` | required |
| Bidirectional DShot | the plain frame with the line inverted and the checksum complemented. After the frame, 27µs at DShot600 and 53µs at DShot300, the pin is released, and the ESC answers about 30µs later with 21 bits at five quarters of the DShot rate. The reply is sampled 5 times a bit. Inversion is the pad's output override; the pull-up holds the idle high. 2 state machines in one PIO block: the receiver on state machine (transmitter + 1) modulo 4, so state machine 3 pairs with state machine 0. No timing seen on an instrument | `docs/DShot.md:184-241`, `protocols/dshot/rp2350/out_dshot.h` (comment "Implements the DShot protocol of ESCs"), `OUT_DSHOT_MAX_PINS` in `protocols/dshot/rp2350/out_dshot.h`, `claim_receiver()` in `protocols/dshot/rp2350/out_dshot.c`, `out_dshot_bind()` in `protocols/dshot/rp2350/out_dshot.c`, `k_protos` in `shared/outputs/out_bind.c`, "Output drivers (PWM, PPM, DShot, bidirectional DShot)" in [STATUS.md](../../STATUS.md#state), "Output driver timing" in [STATUS.md](../../STATUS.md#open-items) | required |
| Reply path | the ESC's reply travels from the connector back to the same RP2354B pin. A one-way buffer on the line blocks it. The element that carries the output enable passes the reply while enabled; pull request #167 records this as not resolved | `docs/DShot.md:191-195`, R4, pull request #167 | required; part: SN74CBTLV3126PWR (R4) |
| Level translation | 3.3V at the RP2354B pin to servo and ESC signal levels. Servo and ESC signal lines are commonly 5V. A line that leaves the 3.3V island goes through a translator that senses the target's rail, not a divider chosen once. A one-wire programming line idles high through a pull-up at the device's own supply | `testbench/WIRING.md:25`, `testbench/README.md:411-415`, R4 | required; no part of its own, not verified (R4) |
| Programming port for KST and Chaservo servos, bring-up module | GPIO 13 direct on the servo's signal wire, without a level shifter or a clamp. The servo's signal pin is a microcontroller GPIO; the high level of its reply is at most 5V and typically 3.3V, and is not measured. GPIO 13 is rated 5.5V with IOVDD at 3.3V. With the IOmcu unpowered the rating is 3.63V, and a servo that drives the wire at 5V exceeds it; what the servo's pin does at idle then is not measured. The IOmcu is powered before the servo's supply, or the servo is not fed from an external supply while the bench is off | `docs/ServoProgrammer.md`, `protocols/kst/README.md`, pin ratings in [Microcontroller, flash and debug](#microcontroller-flash-and-debug) | in use on the bring-up module; levels not measured |
| Idle bias on an output line | low for servo PWM, PPM and plain DShot; high for bidirectional DShot, on the pad pull-up, 32 to 86kΩ at IOVDD 3.3V. A 10kΩ connector-side pull-down against that pull-up holds the line at 0.34 to 0.79V, below the 0.8V maximum input-low level, and the reply's first falling edge is lost. Pull request #167 takes the pull-up as about 50kΩ and the line as about 0.55V. An unbound pin, a released PWM pin among them, is a plain input and drives nothing, so the line's own bias sets its level. A stopped PPM or plain DShot pin is driven low. A stopped bidirectional DShot pin is an input held high by its pad pull-up. Through the gated buffer the bias is selected per protocol: a pull-up for bidirectional DShot, a pull-down for every other protocol (F14). The pull-up's value and what selects the bias are not stated. R4 selects the part that sets the bias. P1 asks what selects it. P1 asks whether a selector driven by firmware or the I/O expander meets the Not defeatable rule. P1 asks which bias the UART socket and the ESC bootloader, ESC telemetry and servo configuration modes take, whose lines idle high | `halt()` in `protocols/ppm/rp2350/out_ppm.c`, `teardown()` in `protocols/ppm/rp2350/out_ppm.c`, `out_pwm_release()` in `firmware/iomcu/src/out_pwm.c`, `release_pad()` in `protocols/dshot/rp2350/out_dshot.c`, `out_dshot_stop()` in `protocols/dshot/rp2350/out_dshot.c`, RP2350 datasheet, build 2024-08-08, Table 1433, read from a copy; pull request #167, F14, R4 | decided (F14); bias selector SN74LVC1G126DBVR (R4) |
| Pins behind the gate | the 20 output ports and the UART socket (F13; owner, 2026-09-25). On the bring-up module the specified buffer covers GPIO 0 to GPIO 2 | pull request #167, F13 | decided; gated buffer SN74LVC244APWR, alternate 74LVC244APW,118; port and socket path SN74CBTLV3126PWR; enable inverter SN74LVC1G04DBVR (R4) |
| PIO state machines | plain DShot takes 1, bidirectional DShot 2 in one block, the receiver on state machine (transmitter + 1) modulo 4, PPM 1, out of the 12. The receiver buses and the programmer take a number the tree does not state: no receiver PIO program is written. P5 states the count it assumes, and whether a bus uses a hardware UART instead. Bidirectional DShot on the 4 multiprotocol ports takes 8 of the 12. The transmitter's block is tried from PIO2 down, and a receiver that cannot pair in that block fails the bind, so the combinations that fit depend on the order outputs are bound (`claim_receiver()` and `out_dshot_bind()` in `protocols/dshot/rp2350/out_dshot.c`). P5 returns the output combinations the board supports for a stated bind order, and the board supports those only (owner, 2026-09-25). The IOmcu refuses a bind outside them, and the OUTPUTS page shows the refusal; that firmware change is outside round 1 | P5 ([Research](Research.md#agent-layout)), `protocols/dshot/rp2350/out_dshot.h` (comment "Implements the DShot protocol of ESCs"), `claim_receiver()` in `protocols/dshot/rp2350/out_dshot.c`, `out_dshot_bind()` in `protocols/dshot/rp2350/out_dshot.c`, `out_ppm_bind()` in `protocols/ppm/rp2350/out_ppm.c`, pico-sdk 2.3.0 `src/rp2_common/hardware_pio/pio.c:454-506` | required; P5's budget: [Control](Control.md#board-budget-against-the-rp2354b) |
| PIO instruction memory | the programs of all the state machines in one block share that block's 32 instructions of memory, and P5 counts it beside the state machines. Plain DShot is 4 instructions, bidirectional DShot 11 for the transmitter and 5 for the receiver, and PPM 4. Each bound output loads its own copy of its program, and pico-sdk never reuses a loaded copy, so a bidirectional DShot port takes 16 words and a block holds at most 2 bidirectional DShot ports. The receiver and programmer programs are not written | P5 ([Research](Research.md#agent-layout)), RP2350 datasheet, PIO chapter, read from a copy; `PIO_INSTRUCTION_COUNT` in pico-sdk 2.3.1's `platform_defs.h`; `dshot_tx` in `protocols/dshot/rp2350/dshot.pio`, `dshot_bidir_tx` in `protocols/dshot/rp2350/dshot.pio`, `dshot_rx` in `protocols/dshot/rp2350/dshot.pio`, `ppm_tx` in `protocols/ppm/rp2350/ppm.pio`, `claim_receiver()` in `protocols/dshot/rp2350/out_dshot.c`, `out_dshot_bind()` in `protocols/dshot/rp2350/out_dshot.c`, `out_ppm_bind()` in `protocols/ppm/rp2350/out_ppm.c`, pico-sdk 2.3.0 `src/rp2_common/hardware_pio/pio.c:66-81` | required |
| Serial servo protocols out | S.BUS and other serial protocols on an output, one PIO program each. No driver number for them exists on the OUTPUTS page | `docs/Manifest.md:31`, `link_out_driver_t` in `shared/link/include/link_pages.h` | required |
| Programming on the multiprotocol ports | the 4 multiprotocol ports, shared by the five modelled programming tables: BLHeli_S, AM32, ESCape32, VESC and Hitec D-series, over four wire protocols. The tables are built; no PROGRAM list shows them | `shared/ui/prog_models.c` (comment "BLHeli_S and AM32 speak a one-wire bootloader"), `k_models` in `shared/ui/prog_models.c` at revision ef52452c (the Hitec table, removed since), "7. Programming: ESCs with BLHeli_S and AM32 firmware, Hitec D-series servos" in [STATUS.md](../../STATUS.md#order-of-work) | required; programming supply switching: no part, not verified |
| One-wire bootloader | BLHeli_S and AM32; 19,200 baud, half duplex, on a PIO state machine | `docs/Manifest.md:29`, `k_models` in `shared/ui/prog_models.c` | required |
| ESCape32 | text CLI over the ESC's signal line. The modelled table states no baud. The rate is stated only in the test bench's proposed analyser map: 19,200 baud on the one-wire programmer line, channel 12. P1 asks it | `k_models` in `shared/ui/prog_models.c`, `testbench/README.md:397` | required |
| VESC | framed packets at 115,200 baud on separate transmit and receive lines (V67), on a main IOmcu UART. They pass 2 of the 3 spare channels of the two SN74CBTLV3126PWR, whose enable is the heartbeat enable node, so they stop with the other outputs (owner, 2026-09-30; [Pins](Pins.md)) | `k_models` in `shared/ui/prog_models.c`, V67, owner, 2026-09-30 | required |
| Hitec D-series servos | the published Hitec D-series protocol. These details were absent from the referenced model table; the current [Hitec protocol reference](../../protocols/hitec/README.md) describes the line and timing. That implementation does not qualify the proposed IO board's electrical path | `k_models` in `shared/ui/prog_models.c` at revision ef52452c (the Hitec table, removed since), `docs/Manifest.md:32` | required |
| Receiver buses | S.BUS, iBUS, SUMD, CRSF, SRXL2 and JETI EX Bus. Each is one signal wire plus ground into an RP2354B pin; the tree states that no external parts are needed | `docs/Receivers.md:10-16` | required; buffer SN74LVC1T45DBVR (R4) |
| S.BUS input | inverted 8E2 (8 data bits, even parity, 2 stop bits) UART at 100 kbaud, received by a PIO program that is not written. 25-byte frames every 7ms or 14ms, each taking 3ms. The decoder frames on a gap of 2000µs and needs a timestamp per byte; it is host-tested | `docs/Receivers.md:12`, `protocols/sbus/include/sbus.h` (comment "Implements the S.BUS receiver protocol of Futaba"), `SBUS_GAP_US` in `protocols/sbus/include/sbus.h`, "S.BUS receiver" in [STATUS.md](../../STATUS.md#open-items) | required |
| iBUS, SUMD, CRSF, SRXL2 and JETI EX Bus inputs | UART, normal or inverted; not started | `docs/Receivers.md:13`, "Other receiver buses" in [STATUS.md](../../STATUS.md#state) | required |
| Receiver data on the link | no link page carries receiver channels, frame counts or bus state. The S.BUS decoder is linked into the panel and the host suite, not the IOmcu image, and the RECEIVER screen is fed on the panel. The receiver wire lands on an RP2354B pin | `docs/Building.md:75-81`, `docs/Link.md:746-762`, `analyser_screen_push()` in `shared/ui/include/analyser_screen.h`, `docs/Receivers.md:15-16` | required |
| S.BUS2 telemetry slots | not answered: replying in the 325µs slot without colliding with the receiver's own sensors is out of scope | "Futaba S.BUS2 telemetry slots" in [STATUS.md](../../STATUS.md#not-planned) | decided |
| Telemetry on the bidirectional DShot wire | no pin beyond the output. An electrical period on every reply, a thousand a second at 1kHz. Temperature in °C, voltage at 0.25V per count and current at 1A per count, once the ESC has taken command 13: 10 repeats, asked again every 500ms at zero throttle until an extended frame answers, at most 10 asks a run. Speed goes stale after 200ms, the others after 2000ms. Run against one AM32 2.21 ESC on a tester's bench (#172): voltage read correct; current and temperature decoded and checked against nothing | `docs/DShot.md:208-213`, `docs/DShot.md:270-334`, `DSHOT_EDT_MV_PER_COUNT` in `protocols/dshot/include/dshot.h`, `DSHOT_UPDATE_HZ` in `firmware/iomcu/src/outputs_hw.c`, "3. Measured numbers: ESC telemetry or bidirectional DShot, and the current sensor" in [STATUS.md](../../STATUS.md#order-of-work) | required |
| ESCs reported | one: the lowest-numbered bound bidirectional DShot slot | `reporting_slot()` in `firmware/iomcu/src/outputs_hw.c` | required |
| OpenYGE line | UART at 115,200 baud 8N1, half duplex on one wire; one master and up to 127 addressed ESCs; about 20Hz. On the one-pin UART socket: a hardware UART with its transmit and receive pins tied through a resistor, or a PIO soft UART; not the CAN link. One poll is 3.99ms plus the ESC's turnaround, 8% of the line at 50ms. Codec host-tested, not wired in | `docs/OpenYGE.md:17-42`, "OpenYGE codec" in [STATUS.md](../../STATUS.md#state) | required; path SN74CBTLV3126PWR (R4) |

### Not known

- The signal level at the output ports, the UART socket, and the receiver inputs is not stated for the IO board. R4. The RP2354B's own pin ratings are in [Microcontroller, flash and debug](#microcontroller-flash-and-debug).
- Which element passes the bidirectional DShot reply through the output gate while the gate is enabled. Pull request #167 states the need and records it as not resolved. R3 and R4.
- Whether the receiver pins pass the output gate. F13's answer names the 20 output ports and the UART socket only.
- Programming runs on the multiprotocol ports, so the 10kΩ connector-side pull-down of pull request #167 sits against the pull-up the programmed device holds the line high with. R4 sets the bias per port mode.
- What the pin budget's "servo inputs" and "host link" connect to, and how many one-wire programming lines it counts (`firmware/iomcu/CMakeLists.txt:9-13`). The programmer screen put every protocol on one connector (`shared/ui/programmer_screen.c` at revision b9e3e895, comment "They share a connector and nothing else", the screen removed since). The budget names no receiver input and no ESC telemetry line. P5.
- The DShot bit rate the output path is specified for. The bind list offers 300 and 600kbit/s; the driver accepts 150 to 1200kbit/s. R4.
- Every output timing on a wire. No pulse width, frame period, jitter, DShot bit time, PPM frame or bidirectional turnaround has been seen on an instrument, and whether an ESC other than one AM32 2.21 ESC on a tester's bench (#172) answers bidirectional DShot is not known (`docs/DShot.md:336-372`, "Output driver timing" in [STATUS.md](../../STATUS.md#open-items)). These uncertainties require measurements on the bring-up bench.
- How the link carries 20 ports against its 8 slots (`LINK_OUT_SLOTS` in `shared/link/include/link_pages.h`): firmware work outside round 1.
- Which driver each output runs on a board marked soldered, and what selects it. The outputs screen refuses every change on such a board (`outbind_toggle()` in `shared/outputs/out_bind.c`). Not stated in the tree; no question asks it.
- The connector for the two lines to VESC controllers: not stated (R4, round 2). The current [Hitec protocol reference](../../protocols/hitec/README.md) documents its line and timing; qualification of the proposed IO board's Hitec path remains open.
- The baud of iBUS, SUMD, CRSF, SRXL2 and JETI EX Bus; whether the bench transmits on a receiver pin (EX Bus telemetry is in scope, `docs/Manifest.md:37-39`); how many receiver pins the board has; whether it powers the receiver. `docs/Receivers.md:15-16` names signal and ground only, and `docs/Receivers.md:29` names receiver power as a cause of a silent bus. R4, and R5 for the receiver's supply if the board powers one.
- Which serial protocols besides S.BUS the outputs generate (`docs/Manifest.md:31`), and whether OneShot and MultiShot are required: the MOTOR screen stub lists them (`shared/ui/include/ui_text.def:63` at revision c7f4ff9a^, the stub list, removed since), and no driver number exists for them. No question asks it.
- An input for the ESC's separate serial telemetry wire. Nothing on the bench reads that wire (`docs/DShot.md:310-311`), and the MOTOR screen stub lists KISS telemetry (`shared/ui/include/ui_text.def:66` at revision c7f4ff9a^, the stub list, removed since). Whether the board carries one is not stated; no question asks it.
- For OpenYGE: the resistor between transmit and receive, the idle level, the pull-up and the number of ports are not stated. The ESC's turnaround is not measured (`docs/OpenYGE.md:361-362`). Which ESC telemetry protocols beyond OpenYGE are supported is an open decision (`docs/OpenYGE.md:401-404`). R4.
- Whether a programming session switches the ESC's or the servo's supply to enter a bootloader is not stated in the tree (`k_models` in `shared/ui/prog_models.c` at revision ef52452c, the Hitec table removed since). The ESC pack switch follows the monostable, and the port switches follow the load gates. R4.

## Power

The IO board runs from a 12 to 20V DC input when one is present. Otherwise it
runs from the bench's own 2S pack. Source selection is automatic. The selected
source powers the IO board and the display through the link cable. The pack
is an SLS XTRON 3000mAh 2S1P pack (owner, 2026-09-30). A hardware disconnect removes the pack when
any cell falls to 3.0V, read per cell from the pack's balance lead (F9).
From the selected source the board makes the 3.3V logic rail, a 5V rail,
3 servo rails and the adjustable supply's output. It charges the pack from USB-C only, drawing up to 3A at 5V, and never from
the DC input (F8).

Three servo rails, each from its own TPS55285 buck-boost converter, feed the
20 output ports: one rail feeds 8 PWM ports, one the other 8 PWM ports, and one
the 4 multiprotocol ports (owner, 2026-09-30). Each rail's voltage is set on
its own, allowing LV (low-voltage) and HV (high-voltage) servos to run at the same time
and an ESC on a multiprotocol port to run independently of the servos. Each port has its own supply switch and its own current monitor channel; the owner's choice is the INA3221, and INA3221AIRGVR is a fixed input the owner retains regardless of a research run's result (owner, 2026-10-03).
The servo procedures that read the port monitors are written and host-tested
against a modelled servo. The IOmcu image does not call them
(`firmware/iomcu/CMakeLists.txt:43-46`). Round 1 of the research re-evaluates the
TPS55285 and selects the integrated circuits of R3 and R5 to R8, the
converter's inductor, the motor shunts and the switch of
the ESC pack. R5 selects the power input's protection. Round 2 selects the
other passives, the connectors, and the protection on the signal, sensor,
balance-lead, link and heartbeat connectors. Round 3 covers the thermal design
and the busbar, mounting and cabling of the external 300A path
([Research](Research.md#scope)).

The switches on the servo rails and the ESC pack, their timing and the
interlock supply: see [Link and safety](#link-and-safety).

| Requirement | Value | Source | State |
| --- | --- | --- | --- |
| DC input | 12 to 20V; runs the IO board and the display when present. The 3 servo converters, each at 6.35A and 8.4V, together draw 177.8W at 90% efficiency: 14.8A from 12V and 8.9A from 20V, before the other loads. With the adjustable supply at 15V and 6.35A the four draw 283.6W at the same assumed 90%: 23.6A from 12V and 14.2A from 20V, nominal figures (Adjustable supply budget). The connector is round 2's; the DC path's protection and source selection are a follow-up of R5 | owner, 2026-09-24; 12 to 20V: owner, 2026-09-25; Board power in [hardware STATUS](../STATUS.md#decided) | decided |
| Pack input | the bench's own 2S pack; runs the IO board and the display when the DC input is absent | owner, 2026-09-24; Board power in [hardware STATUS](../STATUS.md#decided) | decided |
| Source selection | automatic: the DC input when present, the pack otherwise | owner, 2026-09-24; Board power in [hardware STATUS](../STATUS.md#decided) | decided; part: LM74800QDRRRQ1 (R5) |
| Pack voltage range | 6.0V to 8.4V: the 2 cells of the SLS XTRON pack (owner, 2026-09-30) from the 3.0V floor of F9 (2 × 3.0V) to 4.2V a cell at full charge (2 × 4.2V). The per-cell floor disconnects the pack when either cell reaches 3.0V, so 6.0V is the lowest pack voltage and is reached only with both cells at the floor. R6 checks the servo converter across that range | F9, R5 and R6 ([Research](Research.md#research-categories)) | decided (F9); the owner keeps the 3.0V floor for the pack (2026-09-30); its vendor page states 7.4V nominal and no limit a cell, so 4.2V a cell is not confirmed by the vendor |
| Pack path current | the pack path carries the servo supply's input current. 8.4V × 6.35A = 53.3W out. At 90%, the efficiency [Power](Power.md) uses for the DC input, 53.3W / 0.9 = 59.3W in: 59.3W / 8.4V = 7.1A from a full pack, and 59.3W / 6.0V = 9.9A at the floor of F9. The efficiency from the pack is not stated. The display adds 7.5W continuous (5V × 1.5A) and 10W peak (5V × 2A) before the 5V rail's losses. The logic rails add to it. R5 sizes the selection and the disconnect for it. From the pack every converter runs to its own limit (owner, 2026-09-30): at the 6.0V floor the four converters at 6.35A draw about 47.3A at an assumed 90%, and the board about 49.7A with the display, the logic rails and the second RP2354B, nominal figures. The converters' inductor clamps, 8A typical each with no maximum, hold the draw lower where they act. R5 sized the source selection and the pack disconnect for 12.23A (V90), so a follow-up of R5 sizes them again | R5 ([Research](Research.md#research-categories)), [Power](Power.md#input-rail), prerequisite 7 ([Research](Research.md#prerequisites)) | required |
| Pack disconnect | in hardware, when any cell falls to the 3.0V floor of F9 | owner, 2026-09-24; owner decisions in [Research](Research.md#scope); Board power in [hardware STATUS](../STATUS.md#decided) | decided; no part, not known (R5) |
| Pack disconnect hysteresis | the load returning after a disconnect does not reconnect the pack; hysteresis width not stated | R5 | required |
| Discharge floor | 3.0V a cell, read per cell from the pack's XH balance lead; the 2 cells of the SLS XTRON pack (owner, 2026-09-30; F9). A per-cell floor bounds each cell. A pack-voltage floor does not: a pack at 6.0V can hold one cell under 3.0V | F9; owner, 2026-09-30 | decided (F9); the owner keeps 3.0V for the SLS XTRON pack (2026-09-30) |
| Pack reconnect | the condition that reconnects the pack after a disconnect is not stated. F9's answer sets the floor only. The pack disconnect hysteresis row applies | F9, R5 | required |
| Reverse-polarity protection | on the DC input (owner, 2026-09-30), on the board's power input. Non-destructive: no fuse or other part is sacrificed, and the input works once the polarity is corrected (owner, 2026-09-30) | R5; owner, 2026-09-30 | decided (owner, 2026-09-30); LM74800QDRRRQ1, not requalified by FU-B3, not verified (R5) |
| Overvoltage protection | on the DC input (owner, 2026-09-30), on the board's power input; threshold not stated. Non-destructive: a cut-off, not a crowbar or a fuse, and the input works again once the voltage falls below the threshold (owner, 2026-09-30); a transient the protection absorbs (V85) stays within the rating of the part that absorbs it. R5 selects it. Round 2 selects the protection on the signal, sensor, balance-lead, link and heartbeat connectors | R5 ([Research](Research.md#research-categories)), round 2 ([Research](Research.md#scope)); owner, 2026-09-30 | decided (owner, 2026-09-30); no part in selection.json, not verified (R5) |
| DC input brownout detection | the board detects the DC input falling below a threshold, and the IOmcu reads it (owner, 2026-09-30). It is non-destructive, as the two protections above (owner, 2026-09-30). The threshold, how long the input stays below it before it counts, and the IOmcu's action are not stated. R5 found the source selection's undervoltage gate at 10.1V falling and 11.0V rising (V88, `hardware/research/round1/T3/006-P2-R5.json`), and the Servo rail current row requires a source-status signal the IOmcu reads; whether one signal serves both is not stated. The signal takes an RP2354B input or an expander pin within the pin budget (Board budget in [hardware STATUS](../STATUS.md#open)) | owner, 2026-09-30; V88 ([Research](Research.md#raised-by-p1)) | decided; the detection circuit, its threshold and timing: a follow-up of R5, which selects the power input's protection in round 1; the IOmcu's action: firmware work, outside the research rounds ([Research](Research.md#scope)) |
| Inrush limiting | on the board's power input; limit not stated | R5 | required; LM74800QDRRRQ1, not requalified by FU-B3, not verified (R5) |
| Display supply | through the link cable, from the selected source | owner, 2026-09-24 | decided; part: TPS259474ARPWR (R5) |
| Display supply voltage | 5V | F6, owner, 2026-09-25 | decided |
| Display current | 2A peak, 1.5A continuous at 5V | prerequisite 7 ([Research](Research.md#prerequisites)) | decided |
| Logic rail | 3.3V, from the 3.3V logic buck R5 selects | R5 ([Research](Research.md#research-categories)) | required; part: LMQ66430MC3RXBRQ1 (R5) |
| 5V rail | loads stated in the tree: the display, 1.5A continuous and 2A peak (prerequisite 7); the load-cell excitation (F3); the encoder's supply when its jumper selects 5V (F4). The excitation and encoder currents are not stated. R5 sizes the 3.3V logic buck and the 5V rail from the supply currents of the parts T2 and T4 select, as P4 verifies them, plus the display's draw (prerequisite 7). T3, which runs R5, runs after T2 and T4 | R5 ([Research](Research.md#research-categories)), T2 to T4 ([Research](Research.md#agent-layout)) | required; part: TPS62933DRLR (R5) |
| Power indicator | an LED (light-emitting diode) on the IO board that shows it has power. The first check on the panel's bus-fault screen sends the operator to "its own LED, not the panel's" | `checks_for()` in `shared/ui/busfault_screen.c`, `BF_SILENT_1` in `shared/text/include/ui_text.def` | required |
| Load gates at reset | each port supply switch is open, and each servo converter and the adjustable supply's converter is off, while the RP2354B or I/O expander pin that drives it is an input, and the expander is reset with the RP2354B: through a reset, a reflash and with either unpowered. The enable stays high through an RP2354B reset while the panel beats, so an expander held off only by the enable does not open the switches then. A resistor holds each control input at its inactive level. This applies the tree's fail-safe rule, which `testbench/WIRING.md:22` states for the bench's relay drivers. Whether a GPIO drives the converter's enable is not stated in the tree | `CONTRIBUTING.md:36-37`, `testbench/WIRING.md:22`, `firmware/iomcu/CMakeLists.txt:9-13` | required |
| Servo supply | three TPS55285 buck-boost converters, one for each servo rail (owner, 2026-09-30); output voltage and current limit set over I²C on each. 12 held (owner, 2026-09-25): with the adjustable supply's, 4 a board, they cover 3 boards, and 5 boards take 20. Each TPS55285 answers at I²C address 74h or 75h, as does the encoder supply's TPS55288 (R6): the four TPS55285 take both addresses on both of the measurement IOmcu's I²C buses, and the TPS55288 goes on a main IOmcu bus or a third bus ([Two IOmcus](#two-iomcus)). P5 checks the address map. A small aluminum heatsink on each TPS55285, on a 6-layer board (owner, 2026-09-30) | Servo supply in [hardware STATUS](../STATUS.md#decided), [Power](Power.md#summary) | decided; round 1 refuted one converter on the junction temperature at 4.0A drawn continuously from 6.0V at 50°C (R6). A follow-up of R6 finds the continuous current each converter holds with its heatsink and sets the shutdown threshold of the rows below |
| Servo rail voltage | two settings on each of the 3 rails, set from software for each rail on its own: up to 5.5V for low-voltage servos, up to 8.4V for high-voltage servos. Each rail works down to the TPS55285's lowest output, 0.8V, so a servo's brownout behavior can be tested (owner, 2026-09-30). LV and HV servos run at the same time on different rails, and the firmware and the display carry a setting for each rail (owner, 2026-09-30). The tree carries no rail setting: the panel's settings have no servo rail entry (`setting_id_t` in `shared/settings/include/settings.h`), and the link's LIMITS page is declared and not served (`docs/Link.md:751`). Panel settings and link fields for the individual rails are not defined | Servo rail in [hardware STATUS](../STATUS.md#decided), [Power](Power.md#servo-supply-tps55285), `setting_id_t` in `shared/settings/include/settings.h`, `docs/Link.md:751` | decided; the panel setting and the link field not defined |
| Servo rail current | 4 to 6.35A a rail: each TPS55285 senses current internally and its limit stops at 6.35A (owner, 2026-09-25). The current limit follows the voltage setting. From the DC input each rail's limit goes to 6.35A; from the pack each runs to its own limit too, because the SLS XTRON pack's 90A carries all four converters (owner, 2026-09-30). The limit's tolerance is stated only at the 1, 3 and 5A settings: 4.7 to 5.3A at 5A, from engineering samples at 19V in and 5V out (SLVSI72A 5.4; `hardware/research/round1/FU-B1/023-P4-datasheet-R6.json`). The firmware knows the source from a source-status signal it reads, a DC-input-present input or the DC input voltage. Neither R5's source selection nor the firmware provides one: a follow-up of R5 selects it, within the GPIO budget. For one servo 4 to 6.35A is a short peak: a servo drawing it without pause burns out. Several servos on one rail can draw it without a time limit, each below the 1.0A of the stall timeout; that rail's temperature shutdown bounds the sustained current (owner, 2026-09-30). The continuous current a TPS55285 and its heatsink hold at 6.0V in and 50°C is not known: a follow-up of R6 finds it, in A, and it is each rail's continuous rating; the heatsink's size is round 3's | Servo rail in [hardware STATUS](../STATUS.md#decided), [Power](Power.md#servo-supply-tps55285) | decided |
| Servo converter input from the DC input | 12 to 20V (owner, 2026-09-25), inside the TPS55285's 2.4 to 22V input | [Power](Power.md#input-rail), Converter input connector and heatsink in [hardware STATUS](../STATUS.md#open) | decided |
| Servo converter input from the pack | the TPS55285 takes 2.4 to 22V. R6 checks the converter from 6.0V (2 × 3.0V, F9) to 8.4V (2 × 4.2V), including its inductor current at the low end. The TPS55285 clamps its average inductor current at ILIM_AVG, 7A at least and 8A typical, with no maximum (SLVSI72A 5.4; `hardware/research/round1/FU-B1/023-P4-datasheet-R6.json`). Without losses, 7A of inductor current gives 5.0A at 8.4V from the 6.0V floor; at the 88.8% R6 reads as typical at 25°C, 4.44A. The datasheet guarantees no efficiency, so the current every unit reaches is not known. The 6.35A limit needs 10.0A of inductor current there, above the 8A typical | [Power](Power.md#servo-supply-tps55285), Servo rail in [hardware STATUS](../STATUS.md#decided), R6 | required; a follow-up of R6 finds the continuous current each converter holds from 6.0V at 50°C; above it that rail's temperature shutdown switches the rail off |
| Adjustable supply | a fourth TPS55285 on each board, a simple adjustable supply beside the three servo converters (owner, 2026-09-30): 0.8 to 15V in 10mV steps and a current limit of 0.5 to 6.35A in 50mA steps, both set from the display over I²C (SLVSI72A 7.2; `hardware/research/round1/FU-B1/023-P4-datasheet-R6.json`). Its output leaves the board on an XT60 socket (female), out from the PCB (printed circuit board) (owner, 2026-09-30). Like a servo converter it has a heatsink, an MCP9808T-E/MS that switches it off and latches (Servo supply temperature, below), and a rail gate that opens when the enable node falls (Servo rail gate in [Link and safety](#link-and-safety)). It runs from the DC input or the pack, to its own limit from either (owner, 2026-09-30). Unlike a servo rail it may carry one continuous load, so its continuous current is qualified across its range, 6.0 to 20V in and 0.8 to 15V out at 50°C, or at its worst point shown, not taken from the servo rails' 6.0V in, 8.4V out point; a follow-up of R6 qualifies it, and it is not known until then | owner, 2026-09-30 | decided; part: TPS55285 |
| Adjustable supply budget | at 15V and 6.35A it delivers 95.3W, 1.8 times a servo rail's 53.3W at 8.4V. From the pack at the 6.0V floor it draws about 17.6A at an assumed 90%, nominal (Pack path current). It reaches 6.35A at 15V for certain only from an input above 15V, where it bucks. Boosting, its average inductor clamp, ILIM_AVG, is 7A at least and 8A typical, with no maximum (SLVSI72A 5.4; `hardware/research/round1/FU-B1/023-P4-datasheet-R6.json`). Without losses, 7A of inductor current gives 5.6A at 15V from 12V, 3.92A from a full pack at 8.4V and 2.8A from the 6.0V floor. Losses lower each, and the datasheet guarantees no efficiency, so the current every unit reaches there, and whether it reaches 6.35A, are not known. The four converters at their 6.35A settings deliver 255.3W: 283.6W in at an assumed 90% efficiency, 23.6A from 12V and 14.2A from 20V, before the other loads. These figures are nominal: the datasheet guarantees no efficiency and gives the current limit no tolerance at 6.35A, so the upper bound for sizing the DC path is not known. Its rail gate has to switch its output from 0.8V to 15V. The BTS7004-1EPP covers 15V: its supply takes up to 28V (V44). It does not cover the low end, as on the servo rails (Servo rail gate in [Link and safety](#link-and-safety)): it does not switch an output set from 0.8V to about 4.1V. With it, five converters answer at 74h or 75h, the TPS55285's two I²C addresses, against four places on one RP2354B's two buses; the measurement IOmcu takes the four TPS55285 ([Two IOmcus](#two-iomcus)). 5 boards take 20 TPS55285 against the 12 held. A panel setting and a link field for its voltage, current and temperature are not defined | owner, 2026-09-30; V44, V55 ([Research](Research.md#raised-by-p1)) | required; the DC path's protection: a follow-up of R5, its connector: round 2; a gate that switches below about 4.1V: a follow-up of R3; the TPS55288's bus: not decided ([Two IOmcus](#two-iomcus)); 8 more TPS55285: bought before the order |
| Converter current-limit sense | internal to the TPS55285; no external sense resistor | [Power](Power.md#servo-supply-tps55285) | decided |
| Output ports | 20: 16 PWM and 4 multiprotocol | owner, 2026-09-25; Output ports in [hardware STATUS](../STATUS.md#decided) | decided |
| Port supply switch | one per port, 20, from 0.8V (V55, owner, 2026-09-30) up to 8.4V, driven through an I/O expander because 20 enables exceed the free GPIO; R6 selects the parts and P5 counts the pins. R6 selected for a lowest rail of 4.8V, and the TPS259474LRPWR takes VIN 2.7V to 23V (SLVSFC9C; `hardware/research/round1/FU-B1/012-rerank-R6.json`), so it does not switch a port whose rail is set below 2.7V | owner, 2026-09-25 and 2026-09-30; R6 | decided; parts: MCP23017T-E/SS (R6); switch: TPS259474LRPWR below 2.7V fails the 0.8V of V55, no part, a follow-up of R6 |
| Signal-only mode | per port, supply pin disconnected | `shared/ui/include/ui_text.def:73` at revision c7f4ff9a^ (the stub list, removed since) | required |
| Port voltage ceiling | required, set in hardware per port: a jumper on each of the 20 ports selects an LV or an HV ceiling (F16). It follows the port's jumper, not the rail setting. The port is cut off above 6.0V in the LV position and above 8.7V in the HV position, 0.5V and 0.3V above the rail settings of 5.5V and 8.4V; R6 selects the parts | `shared/ui/include/ui_text.def:72` at revision c7f4ff9a^ (the stub list, removed since), F16, R6 | decided (F16); no part, not known (R6) |
| Port current monitor | one INA3221 channel per port, 20 ports on 7 INA3221 (21 channels), a 10mΩ shunt per port: 40µV step, 4mA resolution, 16.4A full scale. The 7 parts sit on the measurement IOmcu's two I²C buses, 4 addresses (0x40 to 0x43) on each ([Two IOmcus](#two-iomcus)). Each part's critical-alert output carries the 3.0A abort, and its warning-alert output the 1.0A stall threshold, to the main IOmcu on shared lines (owner, 2026-09-30; [Two IOmcus](#two-iomcus)). The owner's choice (2026-09-25); INA3221AIRGVR is a fixed input the owner keeps whatever a run returns (owner, 2026-10-03) | owner, 2026-09-25 and 2026-10-03; R8 | required; part: INA3221AIRGVR with ERJ-6CWDR010V (R8) |
| Port current on the link | The current SENSE_MAP and SENSE_WIN pages map monitors to ports and report their current; see [LinkSensors](../../docs/LinkSensors.md). Bit 3 of the capability word indicates configured servo sensing and carries no reading. The proposed board's complete monitor map still needs firmware support. The servo procedures that act on the current are built for the IOmcu and are not called in its image | `docs/Link.md:746-762`, `LINK_CAP_SERVO_SENSE` in `shared/link/include/link_pages.h`, `firmware/iomcu/CMakeLists.txt:43-46` | required |
| Servo current ceiling | 3.0A per servo, checked at every sample; exceeding it aborts at once. A trip shorter than a blanking time, such as a servo charging its capacitors as it is connected, is logged, not an abort (owner, 2026-09-30; Current aborts in [Two IOmcus](#two-iomcus)). Repeated short trips below 3.96A do not abort; the stall trip and the port breaker bound them (owner, 2026-09-30). The blanking time is not stated, and the firmware aborts on one sample above 3.0A: firmware work | `docs/Servo.md:151`, `servo_limit_defaults()` in `shared/servo/servo_limit.c` | required |
| Stall timeout | above 1.0A for 400ms aborts | `docs/Servo.md:153`, `servo_limit_defaults()` in `shared/servo/servo_limit.c` | required |
| Bind detection in the limit search | current above 1.8 times the free-running baseline and at least 0.15A above it, averaged over 80ms after a 120ms settle | `docs/Servo.md:25-30`, `servo_limit_defaults()` in `shared/servo/servo_limit.c` | required |
| Synchroniser current ceiling | 4.0A for the pair | `docs/Servo.md:282-283`, `servo_sync_defaults()` in `shared/servo/servo_sync.c` | required |
| Synchroniser minimum | accepted when the current varies by at least 0.08A across the scan, averaged over 100ms per point | `docs/Servo.md:279-282`, `servo_sync_defaults()` in `shared/servo/servo_sync.c` | required |
| Pack charger | the 2S SLS XTRON pack (owner, 2026-09-30; F9), with balancing; R7 selects the part. The pack takes up to 4C, 12A; the charger's about 1.6A into a full pack is 0.53C | Pack charger in [hardware STATUS](../STATUS.md#decided), F9, R7 | required; part: BQ25713RSNR (R7) |
| Pack cells | an SLS XTRON 3000mAh 2S1P pack, article SLSXT30002130, which the owner plans to use, sold at Stefansliposhop for 25.30 EUR (owner, 2026-09-30; vendor page read 2026-09-30). Cobalt-based lithium-ion (owner, 2026-09-30); 7.4V nominal; 30C (90A) continuous, a C rate of 30 times its 3.0Ah capacity, and 60C (180A) burst, whose duration is not stated; charge up to 4C (12A); an XT60 socket on AWG12 leads and an XH balance connector; about 136 × 43 × 13mm and 174g. It carries the pack current: 9.9A for the servo supply at the 6.0V floor, about 1.4A for the display (7.5W through an assumed 90%), and the logic rails, which are not stated; 90A is 7.4 times the 12.23A round 1 budgets, and 1.8 times the about 49.7A the board draws at the 6.0V floor with every converter at its limit (Pack path current). That draw is nominal and has no upper bound until the pack protection's overcurrent threshold is set at or below 90A (Pack overcurrent protection, below). The vendor page states no chemistry, no charge voltage or discharge floor a cell, no temperature limits, no thermistor and no internal resistance. The owner sets its limits (2026-09-30): the 3.0V a cell floor of F9, and 0°C to 55°C (Pack temperature, below). Its maker, SLS, is outside the cell makers of S9, by the owner's choice, and the owner waives sourcing rules 4 and 5 for it: the vendor shows no stock count, only a delivery time of 1 to 3 days, and no second pack is named. The board's pack input mates with the XT60 socket and the XH connector, for about 49.7A; round 2 selects those connectors, and the XT60's current rating is not read. Round 1's INR-18650-P30B passes every check and is not used | S9, F9, R7, P5 ([Research](Research.md#research-categories)); owner, 2026-09-30; [vendor page](https://www.stefansliposhop.de/akkus/sls-xtron/sls-xtron-30c/sls-xtron-3000mah-2s1p-7-4v-30c-60c::1031.html) | decided (owner, 2026-09-30); 4.2V a cell full charge (F9) not confirmed by the vendor |
| Pack temperature | 0°C lower and 55°C upper limit (owner, 2026-09-30), read from a 10kΩ, B 3435K NTC (negative temperature coefficient thermistor; R7, V147) that the owner tapes with Kapton tape at the center of the cells. The NTC reaches the board on a lead of its own; round 2 selects a leaded part and the lead's connector. The MAX17320G22+ blocks charge outside its limits in 1°C steps (`hardware/research/round1/FU-B1/017-P4-datasheet-R7.json`); its action on discharge at the limits is a follow-up of R7's. The board's 0 to 50°C ambient (V7) leaves the pack 5K below its 55°C limit and no margin above its 0°C limit. The pack's own heating at up to about 49.7A is not known, as its internal resistance is not stated | owner, 2026-09-30; V7, V147, V150 ([Research](Research.md#raised-by-p1)) | decided; thresholds: a follow-up of R7; the NTC part and its lead's connector: round 2 |
| Pack overcurrent protection | on the IO board, as an LCSC part JLCPCB places (V149, found by R7 and confirmed by P4 in `hardware/research/round1/FU-B3/019-P4-datasheet-R7.json`). The SLS XTRON pack as sold carries only its XT60 and XH leads (Pack cells, above). Set against the cell's continuous-discharge rating and the pack current above; R7 selects it. R7 set its thresholds for 12.23A (V150); the about 49.7A of the Pack path current row needs a follow-up of R7 | R7, V149 | required; part: MAX17320G22+ (R7) |
| Charger input limit | follows the USB-C source's current advertisement on its CC (configuration channel) pins: default USB current (500mA for USB 2.0, 900mA for USB 3.2 single-lane; USB Type-C specification, not in the tree), 1.5A or 3A, so a source offering less than 3A is not overloaded. A charger that reads it, or a CC detector that sets the limit; R7 | F8, R7 | required; part: FUSB303BTMX (R7) |
| Charge source | USB-C only. The pack does not charge from the DC input | F8 | decided |
| Charge current | up to 3A drawn from USB-C at 5V, 15W (F8). At an assumed 90% that is 13.5W, about 1.6A into a full pack at 8.4V. [Power](Power.md#pack-charger-bq25887-candidate) records 2A of charge current for the BQ25887 on a USB input; a 2A charger uses the whole 13.5W above 6.75V | F8, [Power](Power.md#pack-charger-bq25887-candidate) | decided |
| Balance current | 50mA average, balanced by the MAX17320G22+ (R7); 400mA per cell balances within one charge, 50mA overnight; candidates in [Power](Power.md) (R7) | [Power](Power.md#pack-charger-bq25887-candidate), R7 | required; MAX17320G22+ (R7) |
| Bench pack balance lead | the charger balances the 2S pack cell by cell, and the discharge floor reads each cell (F9), so the pack's balance lead reaches the IO board beside its power leads. It has its own input, separate from the ESC pack's balance-lead input of the 1 to 16 cell monitor (R9): both packs are connected during a motor test. The selected charger, BQ25713RSNR, has no thermistor input; the MAX17320G22+ reads a 10kΩ NTC, B 3435K, on its TH1 to TH4 pins (`hardware/research/round1/FU-B3/004-P2-R7.json`, V147). The SLS XTRON pack's vendor page states no thermistor, so the owner tapes the NTC with Kapton tape at the center of the cells (2026-09-30; Pack temperature, above) | [Power](Power.md#pack-charger-bq25887-candidate), Pack charger in [hardware STATUS](../STATUS.md#decided), F9, R7 | required; part: MAX17320G22+ (R7) |

### Not known

- The charger's input. The BQ25887 in [Power](Power.md#pack-charger-bq25887-candidate) takes a USB-level input, 3.9–6.2V, which fits a USB-C input at 5V (F8). The MP2672A beside it there, 4–5.75V, is from Monolithic Power Systems, which S1 does not allow. F8's answer sets up to 3A drawn from USB-C, 15W at 5V; the source has to offer 3A (USB Type-C specification, not in the tree). R7.
- Whether the charger's USB-C input is the RP2354B's USB port or a connector of its own: not stated (F8, R7, round 2).
- The charger has a power path or load sharing, so the bench runs from the pack while USB-C charges it and the charger terminates on the pack's current, not the load's. The pack runs the bench whenever the DC input is absent, so charging and running overlap. [Power](Power.md#pack-charger-bq25887-candidate) records that the BQ25887 has no power path; it qualifies only with an external power path around it (R7).
- The DC input connector, its current rating and the servo converters' heatsinks (Converter input connector and heatsink in [hardware STATUS](../STATUS.md#open), and step 3 of its [order of work](../STATUS.md#order-of-work)). Round 2 selects the connectors and round 3 covers the thermal design ([Research](Research.md#scope)).
- The board's mating connectors for the pack's XT60 socket and XH balance connector (Pack cells, above): not stated in the tree. R5, and round 2.
- The overvoltage threshold, the inrush limit and the lowest input voltage the board runs from (R5).
- The current on each rail is not stated in the tree. R5 sizes the rails from the supply currents of the parts T2 and T4 select, plus the display's draw, and P5 ([Research](Research.md#agent-layout)) checks current per rail.
- The order in which the IO board's 5V and 3.3V rails come up is not stated. "No 5V transceiver is in the path" in [STATUS.md](../../STATUS.md#constraints) states that the 3.3V rail comes up after the 5V rail on a module build (R5).
- The 3.3V ramp time on the IO board is not stated. The clear network of F12 depends on it.
- The converter's inductor (R6). [Power](Power.md) records a resistor at the current-limit (ILIM) pin of the TPS55288, the alternative not used, which sets its average inductor current limit up to 16A ([Power](Power.md#servo-supply-tps55285)). Whether the TPS55285 takes such a resistor is not stated in the tree. A resistor is not in the round 1 list, so round 2 selects it ([Research](Research.md#scope)).
- The current rating of each port and of its switch: not stated in the tree (R6).
- The range and sample rate each port monitor needs are not stated. The procedures act on 3.0A, 0.15A and 0.08A. The host model assumes 0.02A peak-to-peak sensor noise (`servo_sim_defaults()` in `shared/servo/servo_sim.c`; `servo_sim_cfg_t` in `shared/servo/include/servo_sim.h`), and no servo has been measured (R8).
- The I²C addresses of the port monitors R8 selects, 7 INA3221 as the owner chose them, beside the other devices on the two buses (P5, [Research](Research.md#agent-layout)).
- Whether a monitor on each servo rail stays beside the 20 port monitors. [Power](Power.md#summary) records one monitor per port, and `docs/Manifest.md:28` lists one on the servo rail as selected. R8.
- The I/O expander that drives the 20 port switches is MCP23017T-E/SS, 3 parts at 0x20, 0x21 and 0x22 in the draft pin map (R6; [Pins](Pins.md)). The FUSB303BTMX answers at 0x21 or 0x31, set by its ADDR/ORIENT pin; whether it shares the expanders' bus at 0x21 is not known ([Supply](Supply.md#not-known)). P5 counts the expanders' pins. The pin budget names "the load gates" (`firmware/iomcu/CMakeLists.txt:9-13`).
- Whether the IO board's USB port powers the logic when neither the DC input nor the pack is present is not stated (R5).
- The ESC pack path's protection values: R3 selects IPT015N10N5ATMA1 for reverse polarity and CSD19537Q3T for precharge, for 150A continuous (F2) at up to 67.2V (F15). No part qualifies as the overvoltage and transient clamp ([Control](Control.md#not-known)). The transient level and the ESC input capacitance it precharges are not stated.
- The display is flashed, and its console read, over its own USB-C (`testbench/WIRING.md:75`; `docs/Link.md:19-23`). The link-cable supply blocks reverse current, so the display's USB-C feeds nothing into the IO board; the part is TPS259474ARPWR (R5). Whether link power reaches the display's USB-C VBUS depends on the display's own power path, which is not in the tree. Until it is known, connecting both at once is not specified as safe.
- The source of the encoder's 12V supply (F4). The DC input is 12 to 20V, and the 2S pack is 6.0 to 8.4V, below 12V. R5 makes it from both sources with one TPS55288RPMR: stepped down from the 12 to 20V DC input and boosted from the 6.0 to 8.4V pack. The encoder's current is not stated.

## Measurement

The IO board measures the motor current, the pack voltage, the cells on the
balance lead, rotation, vibration, temperatures, thrust and torque. It also
reads sensors on external I²C ports. The IOmcu publishes voltage,
current, power, rpm, the ESC's and the motor's temperatures, charge and energy
on the BENCH page (0x20). Voltage, current, rpm and each temperature carry a
valid bit. No link page is defined for cells, vibration, thrust or torque: the per-cell voltages the cell monitor of R9 reads, and the BATTERY screen's resistances, capacity and drawn charge, have no register, and only the host tests and the screen renderer call `battery_screen_set()` (`pack()` in `test/host/test_battery.c`, `main()` in `test/host/render_screen.c`). A link page for them is a firmware change outside round 1; until that change is implemented, the cell monitor can meet its hardware
requirements while its link interface remains undefined. The
display leaves a field empty when no measurement is available. The bring-up
module has no measurement front end. There the IOmcu reports only what an
ESC sends: speed from bidirectional DShot replies, and voltage, current and
temperature from extended DShot telemetry.
No measurements from the proposed IO board are available for this section.

The onboard shunt carries up to 150A on the same board as the 3.3V I²C bus.
A current above 150A, to 300A and more, flows through an external shunt, and
only its sense leads reach the board. The two paths are alternatives: a test
is cabled through one of them, never both (owner, 2026-09-25). The onboard shunt's 150A is continuous (F2). The ESC
pack has up to 16 cells, 67.2V at 4.2V a cell (F15). The
accelerometer and the index pulse are sampled on one timebase. The vibration
path resolves the 167Hz fundamental at 10,000rpm. The capability bits and the
pin catalogue's sensor holder: see
[Microcontroller, flash and debug](#microcontroller-flash-and-debug).

| Requirement | Value | Source | State |
| --- | --- | --- | --- |
| Motor current and voltage monitor | INA228 on the IO board (owner, 2026-09-30): 20 bit, bus input rated to 85V. Shunt full scale ±163.84mV or ±40.96mV, LSB (least significant bit) 312.5 nV or 78.125 nV. The highest pack voltage is 67.2V, 16 cells × 4.2V (F15), 17.8V under the 85V rating | owner, 2026-09-24 and 2026-09-30; [Power](Power.md#motor-monitor-ina228); F15 | decided; INA228AIDGSR fixed by the owner, who states it returns to stock soon; stock not read, no further research (2026-09-30) |
| Monitor footprint | one footprint takes the INA228 or the INA238. DEVICE_ID at register 0x3F reads 0x2281 for the INA228 and 0x2381 for the INA238. The current tree implements the INA228 driver in shared/sense; it has no INA238 driver. On the figures of 2026-09-01 the INA238 has no second source that passes sourcing rule 5: the INA228 had 29 at JLCPCB with a presale count of −477, and the INA238 had 0 at Digi-Key with 2500 due 2026-10-27. The owner fixes the INA228 (2026-09-30); the INA238 fits the same footprint | Monitor footprint and Motor monitor in [hardware STATUS](../STATUS.md#decided), [Research](Research.md#sourcing-rules), `hardware/docs/Sourcing.md:115-121`, `docs/Manifest.md:28` | decided; INA228 fixed (owner, 2026-09-30); no second source on 2026-09-29 (R8) |
| Charge and energy | from the monitor's own charge and energy accumulators; charge in mAh, energy in 0.1Wh steps. The INA228 has both registers; the INA238 has neither (SLYS025B Table 6-3; V161) | [Power](Power.md#motor-monitor-ina228), `LINK_BN_CHARGE_MAH`, `LINK_BN_ENERGY_DWH` in `shared/link/include/link_pages.h`, V161 ([Research](Research.md#raised-by-p1)) | decided |
| Current measurement method | a shunt. A hall-effect sensor on the 300A path is not planned, because of its gain and offset drift on the bench's primary measurement | [hardware STATUS](../STATUS.md#not-planned) | decided |
| Onboard shunt current | up to 150A | owner, 2026-09-24; Motor current path in [hardware STATUS](../STATUS.md#decided) | decided |
| Onboard shunt duty | 150A continuous. The connector that takes it is a round 2 question | F2 | decided |
| Onboard shunt value and part | BVR-Z-R0002-1.0 (R8). At 150A continuous a 100 µΩ shunt dissipates (150A)² × 100 µΩ = 2.25W and drops 150A × 100 µΩ = 15mV. A 200 µΩ shunt dissipates 4.5W and drops 30mV. Both drops are inside the INA238's ±40.96mV range. Selected in R8 | Onboard shunt, 150A in [hardware STATUS](../STATUS.md#decided), R8, F2 | required; part: BVR-Z-R0002-1.0 (R8) |
| Onboard shunt temperature | a temperature sensor beside the onboard shunt. Part: MCP9808T-E/MS (R8) | owner, 2026-09-24; R8 | required; part: MCP9808T-E/MS (R8) |
| Servo supply temperature | An MCP9808T-E/MS beside each TPS55285, 4 a board: the 3 servo converters and the adjustable supply's (owner, 2026-09-30), each at its own I²C address in 0x18 to 0x1F apart from the onboard shunt's. Each alert output switches its own converter's output off above a threshold, in hardware. The trip latches: the rail stays off after the temperature falls, until the operator clear control (F11) clears it, because every stop latches ("Every stop latches" in [STATUS.md](../../STATUS.md#constraints)). Whether the alert sets the interlock's latch or a latch of the rail's own is not stated. An MCP9808 starts with its alert output disabled and its limits at 0 after every power-up. Before the main IOmcu enables a converter, the measurement IOmcu writes that sensor's threshold, enables its alert output, sets its lock bits, which hold the limits until the next power-up, and reads them back (owner, 2026-09-30; [Two IOmcus](#two-iomcus)). The trip depends on that start-up step; after it, the trip acts without the firmware. The firmware has no MCP9808 code. Whether the IOmcu detects a sensor that a dip of its 3.3V supply resets while the rail gate stays closed is not stated. The display shows the four temperatures (owner, 2026-09-30). The link carries none: the temperature registers of the link's bench page are the ESC's and the motor's only (`LINK_BN_TEMP_ESC_DC`, `LINK_BN_TEMP_MOT_DC` in `shared/link/include/link_pages.h`), and a link field for the four readings, with its valid bit, is not defined. The threshold is not stated: a follow-up of R6 sets it against the TPS55285's 125°C recommended junction maximum | owner, 2026-09-30; "Every stop latches" in [STATUS.md](../../STATUS.md#constraints), F11, `LINK_BN_TEMP_ESC_DC`, `LINK_BN_TEMP_MOT_DC` in `shared/link/include/link_pages.h` | required; threshold, latch and wiring of the alert outputs: a follow-up of R6; the start-up step and the link field: firmware work, not defined |
| External shunt input | an off-board shunt for currents above 150A, to 300A and more, connected to the IO board by its sense leads | owner, 2026-09-24 and 2026-09-25; External shunt, 300A and above in [hardware STATUS](../STATUS.md#decided) | decided |
| External shunt class | busbar type, 50 to 100 µΩ, 4.5 to 9W at 300A. Part number: WSBE8518L1000JKA2 (R8). A part off the board, so R8 finds and counts it at the second vendor of S3 | [Power](Power.md#motor-monitor-ina228), External shunt, 300A and above in [hardware STATUS](../STATUS.md#decided), sourcing rule 1 ([Research](Research.md#sourcing-rules)) | decided; part: WSBE8518L1000JKA2, no second source (R8) |
| Resolution on the external shunt | on the INA228's ±40.96mV range, 78.125 nV a step: 100 µΩ: 30mV at 300A, 73% of ±40.96mV, LSB 0.78mA. 50 µΩ: 15mV, 37%, LSB 1.56mA | [Power](Power.md#motor-monitor-ina228) | required |
| External shunt sense connection | Kelvin-sensed, with a resistor-capacitor filter on IN+ and IN− against switching edges. Against the 85V fault (V179): 1kΩ in series with IN+ and with IN−, and a low-capacitance TVS (transient-voltage-suppression) diode behind them (owner, 2026-09-30). A lasting fault drives at most 85V through them: with the TVS across the inputs, at most 42.5mA and 1.8W in each resistor; with a TVS from one input to ground, at most 85mA and 7.2W in one resistor. The INA238's datasheet allows at most 100Ω of filter resistance (SLYS025B 7.1.4); the INA228's guidance and the error 1kΩ adds to its reading are not read | [Power](Power.md#motor-monitor-ina228), owner, 2026-09-30; `hardware/research/round1/FU-B3/024-adjudicator-R8-2.json` | decided (owner, 2026-09-30); where the TVS connects, its part and clamp voltage, and the resistors' power rating: round 2 |
| Monitors for the two shunt positions | one INA228 for each path (F1; INA228 in place of the INA238, owner, 2026-09-30). No switch sits in a sense path. Two INA228 on one bus take two I²C addresses | F1 | decided |
| Voltage measurement point | the pack, not the motor terminals. The ESC's conduction and switching losses fall inside the rpm-per-volt figure | `docs/Screens.md:207-210` | decided |
| Voltage and current on the link | BENCH page: voltage in 10mV steps, 0 to 655.35V; current in 10mA steps, 0 to 655.35A; power in W; 16-bit registers | `LINK_BN_VOLTAGE_CV`, `LINK_BN_CURRENT_CA`, `LINK_BN_POWER_W` in `shared/link/include/link_pages.h`, `docs/Link.md:754`, "IOmcu firmware" in [STATUS.md](../../STATUS.md#state) | built; no value measured on hardware |
| Rpm, charge and power on the link | 1rpm, 1mAh and 1W per count. Every unsigned BENCH register stops at 65,535 counts. A negative value is sent as 0 | `to_u16()` in `shared/bench/bench_state.c`, `bench_state_to_regs()` in `shared/bench/bench_state.c`, "IOmcu firmware" in [STATUS.md](../../STATUS.md#state) | built; no value measured on hardware |
| Sampling | the IOmcu samples the bench numbers every 20ms (50Hz), faster than the display's 50ms poll. The lowest voltage and the highest current, power and rpm of a run are kept on the IOmcu, reset on the edge into driving | `sample()` in `firmware/iomcu/src/main.c`, `s_was_driving` in `firmware/iomcu/src/main.c`, `LINK_BN_VOLT_MIN_CV`, `LINK_BN_RPM_MAX` in `shared/link/include/link_pages.h`, `docs/Link.md:819`, "IOmcu firmware" in [STATUS.md](../../STATUS.md#state) | built; no value measured on hardware |
| Valid bits | voltage, current, rpm, the ESC's temperature and the motor's temperature each carry a valid bit, set only when a sensor answered. Power stays empty unless voltage and current both arrived. Charge and energy carry a valid bit only for the INA228's accumulators (bit 6, TOTALS_OK). The display leaves a field empty when no measurement is available. The tree disagrees on the SIMULATED bit: see [Conflicts in the tree](#conflicts-in-the-tree) | `link_bench_flag_t` in `shared/link/include/link_pages.h`, `sample()` in `firmware/iomcu/src/main.c`, `docs/Screens.md:221-226`, "IOmcu firmware" in [STATUS.md](../../STATUS.md#state) | built; no value measured on hardware |
| Fault action | the IOmcu acts on overcurrent and over-temperature on its own authority and reports the fault at the next poll (faults bitmap bits 1 and 2). The firmware sets bit 0 (link silent), bit 4 (heartbeat) and bit 6 (flash store off) | `docs/Safety.md:396-397`, `docs/Link.md:777-778`, `status_gate()` in `firmware/iomcu/src/iomcu.h`, `safety_gate_status()` in `shared/safety/safety_gate.c` | required |
| Stall action | the IOmcu acts on a stall timeout on its own authority and reports faults bit 3. The rpm source, threshold and time for a motor stall are not stated in the tree. The firmware does not set bit 3. The servo stall timeout: see [Power](#power) | `docs/Safety.md:396-397`, `docs/Link.md:777-778`, `status_gate()` in `firmware/iomcu/src/iomcu.h`, `safety_gate_status()` in `shared/safety/safety_gate.c` | required |
| Cell monitor | 1 to 16 cells on the balance lead, for the 16-cell pack of F15 (owner, 2026-09-25). The firmware takes 1 to 14 and changes with it | F15, `SET_PACK_CELLS` in `shared/settings/settings.c`, `BATTERY_CELLS_MAX` in `shared/ui/include/battery_screen.h`, `LINK_CAP_CELLS` in `shared/link/include/link_pages.h` | required; part: ADBMS1818ASWAZ-RL (R9) |
| Cell monitor isolation | the cell monitor sits on the ESC pack's negative and reaches the measurement IOmcu's SPI1 and GPIO 15 only across a barrier rated 85V DC working or more: an isoSPI (isolated SPI) transceiver pair or a digital isolator. No offset limit applies below that (V189, owner, 2026-09-28) | V189 in [Research](Research.md#raised-by-p1), [Pins](Pins.md) | required; part: not selected (R9) |
| Cell monitor quantities | per cell: voltage, and resistance under load. Per pack: capacity and drawn mAh | `battery_state_t` in `shared/ui/include/battery_screen.h` | required |
| Load condition | the spread is measured under load. At rest, a weak cell can read like the others | `docs/Screens.md:1124`, `draw_right()` in `shared/ui/battery_screen.c` | required |
| Spread verdict | the widest gap between two cells: HEALTHY below 30mV, WATCH from 30mV, REPLACE from 60mV | `SPREAD_BAD_MV` in `shared/ui/battery_screen.c`, `docs/Screens.md:1119-1122` | decided |
| Plot scale floor | the display's divergence plot is never scaled below 12mV at full deflection. The display prints the pack mean to 0.001V | `SCALE_FLOOR_MV` in `shared/ui/battery_screen.c`, `draw_right()` in `shared/ui/battery_screen.c` | decided |
| Rotation from the ESC | the electrical speed from the period in a bidirectional DShot reply, divided by MOTOR_POLES / 2. MOTOR_POLES is even, 2 to 42; at 0 no speed is reported. A reply older than 200ms is not reported. | `BENCH_RPM_STALE_MS` in `shared/bench/include/bench_state.h`, `bench_state_from_telem()` in `shared/bench/bench_state.c`, `docs/Link.md:811-815`, "Output drivers (PWM, PPM, DShot, bidirectional DShot)" in [STATUS.md](../../STATUS.md#state), "Motor pole count over the link" in [STATUS.md](../../STATUS.md#state) | required; RP2354B, no added part (R11) |
| Optical index | one pulse per revolution from a pen line on the motor bell, read from below. Optional. The phase reference for balancing, and an rpm source | `docs/Balance.md:8-13`, `docs/Balance.md:32-37`, `SET_OPTICAL_EN` in `shared/settings/settings.c`, `shared/ui/include/ui_text.def:65` at revision c7f4ff9a^ (the stub list, removed since) | required; no part, not known (R11) |
| Magnetic pickup | an rpm input | owner, 2026-09-24; `shared/ui/include/ui_text.def:65` at revision c7f4ff9a^ (the stub list, removed since) | required; part: DRV5015A1QDBZR (R11) |
| Phase-wire clip | an rpm input on a motor phase wire; its input withstands the V214 peak: the 67.2V of the 16-cell pack of F15 plus a margin for switching overshoot and ringing, not yet stated | owner, 2026-09-24; F15; R11 | required; part: TLV3201AIDBVR, alternate TLV3601DBVR (R11), for a ground-referenced front end only; the front end, its coupling and isolation are open again (Phase-wire clip front end in [hardware STATUS](../STATUS.md#open)) |
| Encoder | ABI, counted in the 27 to 32 GPIO pin budget | owner, 2026-09-24; `firmware/iomcu/CMakeLists.txt:9-13` | required |
| Encoder signal | both forms, selected by a jumper: 5V single-ended up to 1MHz, and RS-422 differential up to 5MHz. Supply 5V or 12V, selected by a second jumper. It measures the servo output shaft or the motor shaft, wherever the operator mounts it | F4 | decided; receiver AM26LV32EIDR (R11) |
| Encoder decode | at up to 5MHz: PIO state machines, DMA channels, a PWM slice as a counter, or an external decoder. R11 reports which, and P5 reserves those resources | R11, P5 ([Research](Research.md#research-categories)) | required; RP2354B, 2 PIO state machines (R11) |
| Vibration sensor | an analogue sensor, piezo or analogue accelerometer, into an ADC on the IO board: the RP2354B's own or an external one (Q4) | `docs/Balance.md:57-63`, Q4 | required; ADXL316WBCSZ (R11) |
| Vibration bandwidth | resolves the 167Hz fundamental at 10,000rpm. A fused IMU streaming at 100Hz does not | `docs/Balance.md:60-63` | required |
| Vibration delay | a constant delay cancels; its variation counts. An analogue sensor: about 15µs, under 1° at 10,000rpm. A fused IMU: about 5ms, 300° at 10,000rpm | `docs/Balance.md:65-69` | required |
| Timebase | the accelerometer and the index pulse are sampled on one timebase, the measurement IOmcu's, which takes a copy of the index pulse (owner, 2026-09-30; [Two IOmcus](#two-iomcus)) | `docs/Manifest.md:30`, "Accelerometer and index pulse, one timebase" in [STATUS.md](../../STATUS.md#architecture) | required |
| Sensing axis | one axis, across the shaft. A three-axis part mounted flat on a firewall has two axes in that plane; one is used | `docs/Balance.md:45-48`, `draw_rig()` in `shared/ui/balance_screen.c`, `draw_aircraft()` in `shared/ui/balance_screen.c` | required |
| Converter for the accelerometer | the RP2354B's ADC with a reference, or an external ADC. R10 reports the effective number of bits and the sampling rate of each | Q4, R10 | decided (Q4, owner, 2026-09-29): ADCS7476AIMFX/NOPB, an external ADC |
| Front ends on the ADC inputs | a front end in any category that drives one of the 8 ADC inputs keeps it within its rating (see [Microcontroller, flash and debug](#microcontroller-flash-and-debug)) while the RP2354B's 3.3V rail is down and the front end's supply is up | the rule for every category ([Research](Research.md#research-categories)), RP2350 datasheet, build 2024-08-08, Table 1430, read from a copy | required |
| Servo measured position | the servo screen draws a measured horn position beside the commanded one; the gap between them is the servo's lag. Two servos that agree with each other and are both wrong need the accelerometer or inspection. An accelerometer on the control surface cannot observe rotation about the gravity vector, so a vertical hinge line reads zero across its throw. No input is specified for the position; the encoder of F4 can sit on the servo output shaft. P1 of R11 asks which sensor gives it | `docs/Screens.md:322-324`, `servo_screen_encoder()` in `shared/ui/include/servo_screen.h`, `docs/Servo.md:293-294` | required; the RP2354B decodes the encoder (R11) |
| ESC temperature | from the ESC's extended DShot telemetry, in whole degrees Celsius. Not reported 2000ms after the last reading | `BENCH_EDT_STALE_MS` in `shared/bench/include/bench_state.h`, `bench_state_from_telem()` in `shared/bench/bench_state.c`, `docs/DShot.md:329-334`, "3. Measured numbers: ESC telemetry or bidirectional DShot, and the current sensor" in [STATUS.md](../../STATUS.md#order-of-work) | required |
| ESC voltage and current | from extended DShot telemetry, 0.25V and 1A per count. Not reported 2000ms after the last reading. The only voltage and current source on the bring-up module | `bench_state_from_telem()` in `shared/bench/bench_state.c`, `docs/DShot.md:329-334`, "3. Measured numbers: ESC telemetry or bidirectional DShot, and the current sensor" in [STATUS.md](../../STATUS.md#order-of-work) | required |
| Motor temperature input | on the IO board, reported apart from the ESC's temperature | owner, 2026-09-24; `LINK_BN_TEMP_MOT_DC` in `shared/link/include/link_pages.h` | required |
| Motor temperature sensor | 2 channels: 1 infrared and 1 thermocouple. The BENCH page carries one motor temperature with one valid bit; whether a second register carries the other channel, or which channel the one register carries, is not stated, and P1 of R12 asks the owner | F5 | decided; parts: MAX31856MUD+T, MLX90614ESF-BCC-000-TU (R12) |
| Temperatures on the link | ESC and motor in 0.1°C steps, signed, each with its own valid bit | `LINK_BN_TEMP_ESC_DC`, `LINK_BN_TEMP_MOT_DC` in `shared/link/include/link_pages.h`, `LINK_BN_TEMP_OK`, `LINK_BN_TEMP_MOT_OK` in `shared/link/include/link_pages.h` | decided |
| Thrust and torque | load cells, with a bridge ADC and excitation (R13) | owner, 2026-09-24; R13 | required; parts: ADS1235IRHBR, BD450M2FP3-CE2 (R13) |
| Load-cell channels and excitation | 3 channels: thrust, and torque on 2 cells; 5V excitation | F3 | decided |
| I²C bus for sensors | external current sensors are on the measurement IOmcu's I²C buses (owner, 2026-09-30; [Two IOmcus](#two-iomcus)). The display's bus is reserved for its touch controller and input/output expander. I²C is in the pin budget | `docs/Manifest.md:14`, `docs/Manifest.md:28`, `firmware/iomcu/CMakeLists.txt:9-13` | required |
| External I²C ports | 2 ports at 3.3V, Qwiic (JST SH, 4 pins) | Q7 | decided; part: TCA9548APWR, alternate PCA9548APWR (R12) |
| Motor monitor address | two INA228, one for each shunt path (F1), each set by its A0 and A1 pins to its own address. The display's INA228 address setting offers 0x40 to 0x4F and takes one address. With the INA3221 as the port monitor, 0x40 to 0x43 are held on both of the measurement IOmcu's buses ([Two IOmcus](#two-iomcus)) and each INA228 takes 0x44 or above; the port monitor R8 selects sets these addresses. P5 maps the port monitors, the external I²C ports' devices, the TPS55285 and the I/O expander against them | F1, `k_ina228_addr` in `shared/settings/settings.c`, `SET_INA228_ADDR` in `shared/settings/settings.c` | required |

### Not known

- Whether the onboard shunt is Kelvin-sensed and filtered like the external shunt: not stated in the tree (R8).
- Whether the shunts sit on the high side or the low side of the motor supply: not stated in the tree (R8).
- Where the monitor's bus-voltage input connects when the external shunt is in use: not stated in the tree. The voltage is measured at the pack (`docs/Screens.md:207-210`; R8).
- The external shunt is WSBE8518L1000JKA2 (R8), with no second source. Its sense-lead connector: round 2. The 300A path's mechanical, thermal and layout constraints: round 3 ([Research](Research.md#scope)).
- The whole-board I²C address map: P5's map in T5 does not check the FUSB303 against the MCP23017 block, and its critic rejected it. Not known ([Supply](Supply.md#not-known)).
- The shared footprint's full pin order: `hardware/docs/Sourcing.md:117-118` names eight pins for a 10-pin package ([Power](Power.md#summary)); the bus-voltage pin and IN+ are not listed. The datasheet check is the pin-for-pin match of P4 ([Research](Research.md#agent-layout)).
- The INA228's ALERT pin reaches the main IOmcu for the overcurrent action (owner, 2026-09-30; [Two IOmcus](#two-iomcus)); its threshold is not stated (R8).
- The overcurrent and over-temperature thresholds, and which temperature the over-temperature action watches: not stated. The LIMITS page (0x11) is declared and not served (`docs/Link.md:751`). P1 of R8 asks the owner for them, with the trip filter and the longest time from detection to the ESC pack switch open. P5 budgets that path: the INA238 conversion and averaging, the ALERT pin or the poll, the IOmcu's action and the switch's turn-off.
- The accuracy of the pack voltage and the motor current: not stated in the tree (R8, R10).
- Whether a negative current is measured: not stated. The BENCH current register sends a negative value as 0A (`to_u16()` in `shared/bench/bench_state.c`).
- The current firmware gives the INA228 precedence for BENCH voltage and current while it is enabled and answering; the ESC's readings remain on SENSE. Selection between the proposed board's two motor-monitor paths remains undefined. The page has one register for each (`LINK_BN_VOLTAGE_CV`, `LINK_BN_CURRENT_CA` in `shared/link/include/link_pages.h`). The ESC's figures and the bench's shunt are called independent measurements (`docs/OpenYGE.md:381-382`). P1 of R8 must resolve that board-specific selection.
- The front end's sample rate: not stated. The tree gives two figures for the samples a poll sees: see [Conflicts in the tree](#conflicts-in-the-tree).
- How each motor path's shunt value reaches the IOmcu: the SENSE page (0x2B) carries the shunt of one INA228 in µΩ, 50 to 20,000 (`docs/Link.md:765`), and the display's INA228 shunt setting takes the same range (`SET_INA228_UOHM` in `shared/settings/settings.c`), so a 50 µΩ external shunt can be entered. The page holds one INA228 set-up. How a second INA228 on the other shunt path is set up: not stated.
- Which register carries the onboard shunt's temperature: not stated. The BENCH page has ESC and motor temperatures only (`LINK_BN_TEMP_ESC_DC`, `LINK_BN_TEMP_MOT_DC` in `shared/link/include/link_pages.h`; R8).
- Which of the 2 motor temperature channels (F5) fills the BENCH page's one motor temperature register: not stated (`LINK_BN_TEMP_MOT_DC` in `shared/link/include/link_pages.h`). P1 of R12 asks the owner (Motor temperature sensor, above).
- The IO board's own temperature: no register carries it. The die temperature on the display is the ESP32-P4's (`docs/Screens.md`, MOTOR & ESC, the MCU temperature). No question covers it.
- The cell monitor's part is ADBMS1818ASWAZ-RL (R9). Its balance-lead input network, its resolution and accuracy per cell, the balance-lead connector sizes, protection against a mis-plugged lead, and how cell samples align with the current for per-cell resistance under load: not stated (R9).
- The link page for cell voltages: none is defined (`docs/Link.md:746-762`).
- The highest rpm the rotation inputs and the vibration path follow: not stated. 10,000rpm is an example (`docs/Balance.md:60-69`; R11). The BENCH rpm register stops at 65,535rpm (`to_u16()` in `shared/bench/bench_state.c`).
- Which source fills the BENCH rpm register when more than one rotation input is present: not stated in the tree. P1 of R11 asks the owner.
- Which rotation input covers the coast-down after a switch to SAFE: not stated (R11). The readouts show the coast-down (`docs/Screens.md:125-128`). DShot frames stop at the switch to SAFE (`service_dshot()` in `firmware/iomcu/src/outputs_hw.c`), and the ESC's speed is not reported 200ms after its last reply (`BENCH_RPM_STALE_MS` in `shared/bench/include/bench_state.h`).
- Whether the magnetic pickup and phase-wire clip readings use MOTOR_POLES: not stated in the tree (R11).
- The optical index sensor's type, supply and output; the magnetic pickup's type, supply and output; the phase-wire clip's conditioning and isolation from the 3.3V logic: not stated (R11).
- Which processor's GPIO the display's Tacho pin setting names: not stated. Its range does not match the RP2354B: see [Conflicts in the tree](#conflicts-in-the-tree).
- The accelerometer is ADXL316WBCSZ, on a sensor board of its own (R11). The number of axes wired, the sample rate, and the lead and connector from the rig arm or firewall to the IO board: not stated. The accelerometer sits flat on the firewall and the index mark on the motor's bell (`docs/Balance.md:45-51`). R11; the converter is Q4 and R10.
- How many of the 8 ADC inputs the analogue front ends take: P5 counts 0 of the 8 for the accelerometer with the external ADC of Q4, and up to 4 with the reference option, and names no other analogue input ([Control](Control.md#board-budget-against-the-rp2354b)).
- The thrust and torque ranges: not stated. F3's answer gives the channels and the excitation, not the ranges (R13). No BENCH register carries thrust or torque (the `LINK_BN_*` registers in `shared/link/include/link_pages.h`).
- No capability bit covers the magnetic pickup, the phase-wire clip, the encoder, motor temperature or the load cells (`link_cap_t` in `shared/link/include/link_pages.h`). No question covers it.
- What the isolation between the 150A path and the 3.3V I²C bus on one board consists of: not defined (Layout in [hardware STATUS](../STATUS.md#open); round 3 in [Research](Research.md#scope)).

## Connectors and test access

The IO board's connectors carry the link cable to the display, the heartbeat
line from the panel's GPIO header, 20 output ports, the UART socket, the external CAN port,
the receiver inputs, the OpenYGE telemetry line, the sensor leads, the external
shunt's sense leads, the external I²C ports, the balance lead, the USB port,
the SWD lines, the BOOT and RESET contacts, the 12 to 20V DC input, the
bench's own 2S pack and the ESC pack path. Each output has a fixed connection to its
connector. The panel finds a pad from three link pages: the catalogue, the
shape and the pads. No connector part is chosen. Round 2 of the research
selects connectors. Round 3 covers mechanical design and layout constraints.

Test access serves the bench in `testbench/`: a logic analyser of 16 channels
with inputs rated to 5V, and a scope for the rails above 5V. The bench is
being assembled. No pulse width, frame period or reply delay in the tree has
been read on an instrument. The interlock test of pull request #167 reads the
monostable's nodes, both sides of a gated output, the control node of each rail
switch and each switched rail. Each analyser lead on the bench carries a series
resistor, which `testbench/WIRING.md:23` gives as "a few hundred ohms" with no
value. Every ground returns to one star point, so no probe ground carries a
load's return current. No research category or question covers test access.

Requirements covered in other sections:

- The USB port, SWD, BOOT and RESET, the board number, the pin catalogue and the printed pad numbers: see [Microcontroller, flash and debug](#microcontroller-flash-and-debug).
- The link cable, its termination, the heartbeat node and the monostable's timing node: see [Link and safety](#link-and-safety).
- The multiprotocol ports, the UART socket and the receiver inputs: see [Outputs, programming, receiver inputs and ESC telemetry](#outputs-programming-receiver-inputs-and-esc-telemetry).
- The DC input, the output ports' supply and the power indicator: see [Power](#power).
- The shunt inputs, the sensor inputs, the balance lead and the external I²C ports: see [Measurement](#measurement).

| Requirement | Value | Source | State |
| --- | --- | --- | --- |
| Wires per output lead | 3: signal, ground and rail | `docs/Screens.md:1862-1867`, `link_pad_kind_t` in `shared/link/include/link_pages.h` | required |
| Soldered outputs | each output pin is fixed to its connector, and the IOmcu configures itself. A board whose `k_boards` row is marked `fixed` is shown and not offered: the panel shows the read-back and offers no edit. A board the panel learns from the catalogue page is never marked soldered, so the IO board shows as soldered only on a panel built with the IO board's row in `k_boards` | `docs/DShot.md:15-17`, `docs/DShot.md:48-51`, `fixed` of `outbind_board_t` in `shared/outputs/include/out_bind.h`, `outbind_learn_board()` in `shared/outputs/out_bind.c`, "More than one IOmcu" in [STATUS.md](../../STATUS.md#architecture) | required |
| Pad layout the panel can draw | two rows on one pitch, numbered from pad 1 along one edge and back along the other. Outline, pitch and row inset in 0.01mm. The bring-up module: 51.00 × 21.00mm, 40 pads on 2.54mm, 20 a side. A board with no shape page is listed and not drawn | `docs/Link.md:759`, the `LINK_SH_*` registers in `shared/link/include/link_pages.h`, `k_pico_shape` in `shared/outputs/out_bind.c` | required |
| Grounds and rails on the pads page | up to 32 pads that are not pins, each a ground, a rail or neither. A rail's voltage is in 0.1V steps up to 25.5V; 0 on a rail means not a fixed voltage. The panel marks a ground G, a fixed rail by its voltage (5V0, 3V3) and an input rail PWR | `docs/Link.md:762`, `link_pad_kind_t` in `shared/link/include/link_pages.h`, `docs/Screens.md:1862-1867` | required |
| CAN polarity | CANH to CANH and CANL to CANL. A crossed pair measures the same 60Ω and carries no frame. The panel's hint on a silent bus asks, after power, whether CANH and CANL are swapped. The IO board's link connector marks CANH and CANL | `testbench/WIRING.md:456-466`, `link_diag_hint()` in `shared/link/link_bringup.c`, `checks_for()` in `shared/ui/busfault_screen.c`, `BF_SILENT_2` in `shared/text/include/ui_text.def` | required |
| Protection on external lines | ESD (electrostatic discharge) and overvoltage protection on the output, UART, external CAN, receiver, sensor, balance-lead, link and heartbeat connectors is selected in round 2. The USB protection, for which R1 found no part, is relaxed to match standard parts (owner, 2026-09-30) and is selected by a follow-up of R1. The power input's protection is R5's: see [Power](#power). No requirement in the tree limits the current into a shorted signal line at an output connector. The servo rail's current limit is set in the TPS55285, at 6.35A at most (see [Power](#power)); a port switch's current limit is not stated (R6). On the bring-up bench a bench supply's current limit covers a shorted output | round 2 ([Research](Research.md#scope)), R1, R5, R6, `docs/FirstRun.md:39-40` | required |
| ESC telemetry line | the OpenYGE line leaves by the one-pin UART socket. The bench's analyser map carries a telemetry receive wire from the ESC on channel 13 | `docs/OpenYGE.md:17-42`, `testbench/README.md:398` | required |
| Silkscreen | each connector's pin names and the CAN logic test points can be read in a close photograph. The bench photographs the IOmcu and its transceiver close enough to identify the receive line, and a connector whose silkscreen cannot be read is photographed again | `testbench/WIRING.md:802-808` | required |
| Logic probe levels | a logic test point carries 5V or less. An analyser input is rated to 5V and is read at 1.65V for 3.3V logic and 2.5V for 5V. The servo rails (8.4V), the adjustable supply's output (15V) and the ESC pack go to a scope | `testbench/WIRING.md:542-548`, `testbench/host/capture.sh:11-15` | required |
| CAN logic test points | RXCAN and TXCAN, the receive and transmit lines between the CAN controller and its transceiver, at logic level. No page names a pin or pad for RXCAN on the bring-up module. The controller's interrupt pin there is not a probe point: the driver polls and the pin never asserts | `testbench/WIRING.md:431-440`, `testbench/WIRING.md:470-471`, `testbench/README.md:366-368`, `testbench/README.md:393`, `testbench/README.md:400` | required |
| Analyser channel map | 16 channels. 3 outputs (0 to 2), the heartbeat (3), the CAN controller's SPI on the bring-up module (4 to 7), RXCAN (8), the panel's touch bus (9 and 10), the DShot reply at the ESC end (11), the programmer line (12), telemetry receive from the ESC (13), S.BUS (14), TXCAN or spare (15). The map is a proposal, to be checked against the wiring as built; the page counts it as 15 | `testbench/README.md:381-409` | required |
| Monostable test points | the monostable's two outputs, its trigger input on the monostable's side of its link, and the enable node. Logic nodes are read at 1.65V | `testbench/WIRING.md:536-538`, `testbench/WIRING.md:688-693`, pull request #167 | required |
| Gated output test points | both sides of a gated output: the RP2354B pin and the connector line. The buffer's enable pin is a third point. The connector line also takes a 4.7kΩ pull to 3.3V for the high-impedance check | `testbench/WIRING.md:638-642`, `testbench/WIRING.md:701-706`, pull request #167 | required |
| Rail switch control nodes | the gate or enable pin of the switch on each of the 3 servo rails, of the switch on the adjustable supply's output and of the switch on the ESC pack, for the analyser | `testbench/WIRING.md:546-548`, pull request #167 | required |
| Switched rails | the switched side of each of the 3 servo rails, of the adjustable supply's output and of the ESC pack, for a scope probe rated for 8.4V on a servo rail, 15V on the adjustable supply's output and 67.2V on the ESC pack (F15), with the load connected. The switched-side lead takes a DC current probe, and a meter in series for the steady leakage | `testbench/WIRING.md:550-555`, `testbench/WIRING.md:582-590`, pull request #167 | required |
| Supply removal for the isolation tests | test step 3 lifts the supply lead of each device on the powered-off isolation list alone, for 60s, with everything upstream live. Step 13 lifts the buffer's supply lead with its input toggling. Step 4 removes the board's rail with the load rails present. The servo rails are made on the IO board, so step 4 has no separate servo load rail; how step 4 applies to them is not stated | pull request #167, `testbench/WIRING.md:77` | required |
| Star ground | a ground pad for the star lead. Unpowered: under 1Ω from the star to each board ground pad, open to each signal pad that is not biased. The ESC pack's return reaches the star by its own lead. The servo rails are made on the IO board, so their return is the board's ground; how the ports' return meets the star is not stated (see [Conflicts in the tree](#conflicts-in-the-tree)) | `testbench/WIRING.md:37-53` | required |
| Biased pads | the expected resistance to ground of each biased pad is written down before the ground check. On a gated output line that is the 10kΩ connector-side pull-down | `testbench/WIRING.md:55-63`, pull request #167 | required |
| Measurement on USB | no analyser or scope reading while the board is on a USB data cable to the bench host: the cable's shell is a second ground return. An isolated USB adapter otherwise | `testbench/WIRING.md:79-89` | required |

### Not known

- The part for every connector, including the connector the gated outputs leave by, which pull request #167 leaves unspecified. Round 2 of [the research](Research.md) selects connectors; round 3 covers mechanical design and layout constraints.
- Where the test points sit, and whether each carries a series resistor of its own. No research category or question covers test access. The bench puts a series resistor in each analyser lead, given as "a few hundred ohms" with no value (`testbench/WIRING.md:23`).
- How one device's supply is removed alone for test steps 3, 4 and 13: whether the board provides a way to open it or the lead is lifted by hand. Pull request #167 says "supply lead lifted" and no more. No question covers it.
- Whether the connector layout fits two rows on one pitch. A layout that does not fit is listed and not drawn (`docs/Link.md:759`). Settled by the layout, round 3.
- How the pads page states the 3 servo rails, each with two settings, up to 5.5V and up to 8.4V. Not stated in the tree. A rail above 25.5V has no value on the pads page (`LINK_PAD_DV` in `shared/link/include/link_pages.h`). The ESC pack reaches 67.2V (F15), so the pads page cannot state it.
- The connectors for the encoder (single-ended and RS-422 on one input, F4), the 3 load-cell channels (F3) and the infrared and thermocouple motor temperature channels (F5): not chosen. Round 2 selects them. The 2 external I²C ports take Qwiic connectors, JST SH with 4 pins (Q7); round 2 selects the part.
- Where the encoder's two jumpers (signal form and supply) and the 20 port ceiling jumpers (F16) sit: not stated. Round 3 covers the layout.
- Whether RXCAN and TXCAN, between the MCP2518FDT-E/SL controller and the TCAN3413DR transceiver (R2), are reachable for test on the IO board: not stated.
- How the bench's stimulus and responder board reaches the IO board's output, programming and receiver connectors. `testbench/README.md:332-340` gives the roles; `testbench/WIRING.md:287-289` names a stimulus generator the guide does not describe.
- Whether the board carries a status LED beside the power indicator. Not stated in the tree, and no question covers it.

## Conflicts in the tree

This section records disagreements found between repository sources or
between the repository and pull request #167. Each entry names both sources
and explains which one this specification follows. Resolved documentation
disagreements are identified below.

- **Monostable window.** `docs/Safety.md:36-41`, "Safety" in [STATUS.md](../../STATUS.md#architecture), "The monostable window is 150ms" in [STATUS.md](../../STATUS.md#constraints), `testbench/WIRING.md:497` and `testbench/WIRING.md:511-512` give about 150ms. In pull request #167 the enable node falls 155 to 185ms after the last edge. It is set to 170ms on test, and the deadline is 200ms. There 150ms is `HEARTBEAT_MAX_GAP_MS`, the longest gap the firmware accepts. A window at 150ms would drop the enable on a gap the firmware accepts. This page follows pull request #167, the specification R3 builds to.
- **The servo rail current.** Pull request #167 at 23c82ca gives the servo rail as up to 8.4V and 4 to 8A, from the `hardware/docs/Power.md` of that commit, which gives the TPS55288. The owner decision (Servo supply and Servo rail in [hardware STATUS](../STATUS.md#decided); [Power](Power.md#servo-supply-tps55285)) gives the TPS55285, whose limit stops at 6.35A. This page follows the owner decision: 4 to 6.35A a rail, on 3 rails (owner, 2026-09-30).
- **The latch and the clear network.** Pull request #167 specifies a monostable that does not latch: the enable returns on the first resumed edge, and its test steps 7 and 10 assume that. It clears the monostable through a resistor-capacitor network, qualified for a fast power-up ramp only; it states no ramp time. The owner's answers add a hardware latch with an operator clear control (F11) and put a reset supervisor in place of the network (F12). This page follows F11 and F12; the test steps that assume no latch change with the parts R3 selects.
- **Where the monostable is specified.** "The heartbeat has no hardware backstop" in [STATUS.md](../../STATUS.md#open-items) names `docs/Safety.md` and `testbench/WIRING.md` as the specification. R3 ([Research](Research.md#research-categories)) builds to pull request #167 at commit 23c82ca. This page follows pull request #167.
- **Interlock test pass figure.** `testbench/WIRING.md:705` passes the interlock test when the enable is deasserted within 150ms of the last edge. Under pull request #167 the enable falls no sooner than 155ms, so a correct build fails that check; test step 7 of pull request #167 passes 155 to 185ms.
- **Switched rail deadline.** `testbench/WIRING.md:557-560` treats the switched rail being down within 150ms as the deadline. Pull request #167 leaves the rail's decay out of the timing budget, measured and recorded, not specified; its ESC example with 470µF and a 50mA idle draw needs up to 420ms after the last edge (test step 9).
- **Order of the two watchers.** `docs/Safety.md:53` lets the monostable act "sooner or later by its own timing" than the firmware. Pull request #167 fixes the order: the firmware switches to SAFE at 150ms, then the enable node falls between 155 and 185ms.
- **Pin tolerance.** The statement recorded from `testbench/README.md:411` denied 5V tolerance for all RP2350 pins; the guide distinguishes digital and ADC pins. "No 5V transceiver is in the path" in [STATUS.md](../../STATUS.md#constraints) admits a 5V transceiver output on bank 0 through a 2.2kΩ series resistor. Pull request #167 says the RP2350 is not specified as tolerating an input above an absent IOVDD. The RP2350 datasheet (build 2024-08-08, Tables 1423, 1424 and 1430, read from a copy) rates GPIO0 to 39 at 5.5V while IOVDD is at 3.3V and at 3.63V while IOVDD is at 0V, and GPIO40 to 47 at IOVDD + 0.5V. This page follows the datasheet. P1 checks the statement in pull request #167 against those tables. R1 confirms the ratings in T2; where R1's figures differ, P5 checks the statement again.
- **Where the monostable sits, and the heartbeat's path.** `IOMCU_HEARTBEAT_PIN` in `firmware/iomcu/include/iomcu_pins.h` and `docs/FirstRun.md:110` route the heartbeat to GPIO 3 through the monostable. `firmware/iomcu/src/iomcu_can.c` (comment "The panel's safety line, watched in firmware as well as in hardware") and `firmware/panel/main/main.c` (comment "The monostable the line gates is on no board") place the monostable on a daughterboard. Pull request #167 puts GPIO 3 on the node beside the trigger input, as a listener, and leaves the board unspecified; R3 ([Research](Research.md#research-categories)) places the monostable in the IO board's research. This page follows pull request #167 for the node and lists the board as not known.
- **Heartbeat source.** `firmware/iomcu/src/iomcu_can.c` (comment "The panel's safety line, watched in firmware as well as in hardware") describes the source as the panel's 5ms control task edging every 20ms, and `firmware/panel/main/main.c` (comment "The monostable the line gates is on no board") as one GPIO write per frame. `HEARTBEAT_PERIOD_MS` in `shared/safety/include/heartbeat.h` and `docs/Safety.md:36-38` put the generator in the 5ms control task with an edge every 20ms. This page follows `heartbeat.h`, because the generator runs on `HEARTBEAT_PERIOD_MS` from the control task, which "Safety" in [STATUS.md](../../STATUS.md#architecture) also states.
- **The display's power.** Pull request #167 states that the panel is powered on its own USB and beats whether or not the IOmcu board has power, and `testbench/WIRING.md:74-75` powers each board from its own USB. The owner decision of 2026-09-24 (owner decisions in [Research](Research.md#scope); Board power in [hardware STATUS](../STATUS.md#decided)) powers the display through the link cable. The powered-off isolation rule of pull request #167 applies either way.
- **Where the servo rail comes from.** `testbench/WIRING.md:77` feeds the servo and ESC rails from their own supplies, never from a board's rail. Servo supply and Servo rail in [hardware STATUS](../STATUS.md#decided) make the servo rail on the IO board with the TPS55285. This page follows the owner decision: the IO board makes the servo rail. `testbench/WIRING.md:77` describes the bring-up bench.
- **The pack voltage.** Pull request #167 (test step 9) says the ESC path's pack voltage is not chosen. The owner's answer to F15 ([Research](Research.md#blocking-answered-before-the-research-tasks)) is 16 cells, 67.2V at 4.2V a cell (owner, 2026-09-25), 17.8V under the INA238's 85V bus rating ([Power](Power.md#motor-monitor-ina228)). [Power](Power.md#summary) sizes the motor monitor for 67.2V. This page follows F15.
- **The current through the board.** [Power](Power.md#summary), [Power](Power.md#motor-monitor-ina228) and pull request #167 (Not specified) put a 300A path on the pack and beside the I²C bus. The owner decision (Motor current path in [hardware STATUS](../STATUS.md#decided)) puts up to 150A through the board and 300A and above through an external shunt reached by its sense leads. This page follows the owner decision.
- **The per-socket voltage ceiling.** `shared/ui/include/ui_text.def:72` at revision c7f4ff9a^ (the stub list, removed since) lists "Socket ceilings: low and high voltage, each set in hardware". The question F16 ([Research](Research.md#blocking-answered-before-the-research-tasks)) states that no source in the tree gives it. The owner's answer to F16 matches the stub: a jumper on each of the 20 ports selects an LV or an HV ceiling (owner, 2026-09-25). This page follows F16.
- **The servo rail monitor.** `docs/Manifest.md:28` records one monitor on the servo rail. The owner decision (Output ports in [hardware STATUS](../STATUS.md#decided)) puts a current monitor channel on each of the 20 output ports (owner, 2026-09-25). The owner's choice for it is the INA3221, and INA3221AIRGVR is a fixed input the owner keeps whatever a run returns (Port monitors in [hardware STATUS](../STATUS.md#decided); [Power](Power.md#summary); owner, 2026-10-03). This page follows the owner decision: one monitor per port.
- **The SIMULATED bit.** Earlier text at `docs/Link.md:808-809` and the comment for `LINK_BN_SIMULATED` in `shared/link/include/link_pages.h` said an IOmcu without a measurement front end sets BENCH flag bit 7 and the panel draws SIMULATION. `firmware/iomcu/src/main.c` (comment "LINK_BN_SIMULATED is never set here") and "Measured or modelled" in [STATUS.md](../../STATUS.md#architecture) say the bit is never set by an IOmcu that answers. The Valid bits row in [Measurement](#measurement) follows the implementation. The link reference has been corrected to match it.
- **What a clear capability bit does.** `link_cap_t` in `shared/link/include/link_pages.h` says a screen whose capability is missing opens and runs from the model, marked SIMULATED. `read_bench()` in `firmware/panel/main/panel.h` uses the IOmcu's BENCH page whenever the IOmcu answers, whatever the capability word holds. "Measured or modelled" in [STATUS.md](../../STATUS.md#architecture) says an IOmcu that answers reports only what it measures, the panel models only when nothing answers, and the two never appear on one screen. The word reaches the menu and the overview only: `render()` in `shared/ui/overview_screen.c` puts a SIMULATED badge on a tile whose bits are clear. The Capability word row in [Microcontroller, flash and debug](#microcontroller-flash-and-debug) follows `panel.h` and `STATUS.md`, which is what runs.
- **Samples a poll sees.** `shared/link/include/link_pages.h` (comment "The numbers, read-only") and `firmware/iomcu/src/main.c` (comment "The peaks belong to a run") say the panel sees one poll in fifty of the IOmcu's samples. `sample()` in `firmware/iomcu/src/main.c` samples every 20ms and the panel polls every 50ms (`docs/Link.md:819`), 2.5 samples a poll.
- **The DShot frame rate against the poll.** `docs/DShot.md:176` and `DSHOT_UPDATE_HZ` in `firmware/iomcu/src/outputs_hw.c` say 1kHz is twenty times the panel's poll rate. The panel polls every 50ms (`docs/Link.md:819`), 20Hz, so 1kHz is fifty times the poll rate. Twenty times is the ratio to the IOmcu's 50Hz sampling (`sample()` in `firmware/iomcu/src/main.c`), which `DSHOT_UPDATE_HZ` in `firmware/iomcu/src/outputs_hw.c` names.
- **Receiver framing.** "Two processors" in [STATUS.md](../../STATUS.md#architecture) and "Receiver buses: S.BUS, iBUS, SUMD, CRSF, EX Bus, SRXL2" in [STATUS.md](../../STATUS.md#architecture) put receiver framing and the receiver buses on the IOmcu. `docs/Building.md:77`, `firmware/panel/CMakeLists.txt:14` and `test/host/CMakeLists.txt:60` build the S.BUS decoder for the panel and the host suite. `firmware/iomcu/CMakeLists.txt:32-51` names no S.BUS module, so the IOmcu image does not include it.
- **A released PWM pin.** `out_pwm_release()` in `firmware/iomcu/src/out_pwm.h` says a released pin is left low. `out_pwm_release()` in `firmware/iomcu/src/out_pwm.c` returns it to a plain input with no drive, so the line's bias sets its level. This page follows the code, which is what runs.
- **The display's monitor settings.** `SET_INA228_EN`, `SET_INA228_ADDR`, `SET_INA228_UOHM` in `shared/settings/settings.c` name the INA228 in the enable, address and shunt settings, the decided motor monitor (Motor monitor in [hardware STATUS](../STATUS.md#decided)), and give it one address for two monitors (Motor monitor address above). The INA228 shunt setting takes 50 to 20,000 µΩ (`SET_INA228_UOHM` in `shared/settings/settings.c`), which covers the external shunt class of 50 to 100 µΩ (External shunt, 300A and above in [hardware STATUS](../STATUS.md#decided)), so a 50 µΩ shunt can be entered.
- **The Tacho pin setting.** `SET_OPTICAL_PIN` in `shared/settings/settings.c` takes −1 to 48. The RP2354B's GPIO are 0 to 47 (fixed inputs in [Research](Research.md#scope)).
- **The analyser channel count.** `testbench/README.md:406` says the map is 15. Its table lists 16 rows, 0 to 15, with 15 as TXCAN or spare (`testbench/README.md:383-400`).
