subtilitas/rcbench/hardware/docs/Research.md

# IO (input/output) board component research

The plan for the multi-agent research that selects the integrated circuits
(ICs) of the IO board, and the record of its run. The owner accepted the plan
on 2026-09-25. **Round 1 ran from 2026-09-28 to 2026-09-30**, as six tasks
(question S8) and 9 follow-up tasks, each a workflow of at most 32 agents
(owner, 2026-09-24). Each task read the commit of `research/round1`, the
branch of [prerequisite 4](#prerequisites), that its `task.json` under
`hardware/research/round1/<run>/` records:

| Task | Run | Date | Commit of `research/round1` read |
| --- | --- | --- | --- |
| T1 | T1 | 2026-09-28 | `be1f24767452` |
| T2 | T2 | 2026-09-28 | `c25aa863372d` |
| T4 | T4 | 2026-09-28 | `c25aa863372d` |
| Follow-up | FU-P1R5 | 2026-09-28 | `249be1e5ea81` |
| Follow-up | FU-A1 | 2026-09-28 | `10b0bade34de` |
| T3 | T3 | 2026-09-29 | `e13f5f60d2e5` |
| Follow-up | FU-A2, FU-A3, FU-A4, FU-B1, FU-B3, FU-C1, FU-C2 | 2026-09-29 | `e13f5f60d2e5` |
| T5 | T5 | 2026-09-29 | `e13f5f60d2e5` |
| T6 | T6 | 2026-09-30 | `9460c22ec32d` |

Two runs stopped and were run again: FU-A4 (`FU-A4-stopped-1`, 2026-09-29,
`e13f5f60d2e5`) and T6 (`T6-stopped-1`, 2026-09-29, `9460c22ec32d`). The
parts round 1 selected are in [Parts](Parts.md), with the reasons and the
open items on [Control](Control.md), [Supply](Supply.md) and
[Sensing](Sensing.md). The sections from [Scope](#scope) to
[Prerequisites](#prerequisites) are the plan round 1's tasks read, with the
owner's later decisions marked by their dates. [Round 2](#round-2) is the
plan of round 2's runs. The questions below serve both rounds.
Some tables below use a term before the text expands it: PWM is pulse-width
modulation, PPM pulse-position modulation, UART a universal asynchronous
receiver-transmitter, RGB LED a red-green-blue light-emitting diode, LV and
HV low and high voltage, ESR equivalent series resistance, IEC the
International Electrotechnical Commission, FD the flexible data rate of
CAN (Controller Area Network) FD, TVS transient-voltage-suppression, BEC
the battery eliminator circuit of an ESC (electronic speed controller), its
servo supply, I2C Inter-Integrated Circuit, AC alternating
current and EEPROM electrically erasable programmable read-only memory.

## Goals

The goals the owner sets after round 1, in order. Each holds for every run
that starts after its date and for the pages those runs write.

1. **Cost (owner, 2026-10-06).** The IO board costs about one third of the
   estimate of 2026-10-06: about €135 a board in place of about €400. The
   estimate is $399 to $485 a board, each part bought in the quantity 10
   boards need, without shipping, customs or VAT (value-added tax): the
   parts after round 2 at JLCPCB and LCSC prices ($286), passives,
   connectors, heatsinks and the sensor board ($52 to $109, an allowance,
   none of them selected), a 6-layer PCB (printed circuit board, $15 to
   $35) and assembly at JLCPCB ($46 to $55, of which $27 to $30 is the $3
   fee for each distinct extended-library part). The target is on the same
   basis. A run ranks every candidate by its unit price at the 10-board
   quantity beside its fit, prefers JLCPCB's basic library, and counts the
   distinct extended parts it adds. Where a requirement makes the target
   unreachable, the run names the requirement and what it costs a board,
   and the owner decides; a run does not relax a requirement on its own.
   The largest items a board in the estimate:

   | Part | Function | Count | Unit | A board |
   | --- | --- | --- | --- | --- |
   | INA301A1IDGKR | port supply current limit | 20 | $1.85 | $37.06 |
   | LTM8068EY#PBF | cell monitor pack-side supply | 1 | $21.98 | $21.98 |
   | TPSI3052DWZR | ESC pack switch driver | 4 | $4.62 | $18.49 |
   | TPS55285VALR | servo rails and adjustable supply | 4 | $4.34 | $17.35 |
   | BUK7K6R8-40E,115 | port supply switch | 20 | $0.79 | $15.78 |
   | BAS-M-R0001-E-5.0 | external shunt | 1 | $13.69 | $13.69 |
   | TPS3701DDCR | port voltage ceiling | 20 | $0.51 | $10.19 |
   | ADXL316WBCSZ | accelerometer | 1 | $9.50 | $9.50 |
   | INA228AIDGSR | motor current, two shunt paths | 2 | $4.73 | $9.46 |
   | MCP9808T-E/MS | shunt and converter temperature | 5 | $1.88 | $9.40 |

   The estimate's prices are from the jlcparts copy of 2026-09-14, except the
   BSC014N04LSATMA1's, Digi-Key's on 2026-10-06. Round 2 records no
   placements a board; the counts follow each function (20 for a part on
   each port, 3 or 4 for a part on each rail). Per-port circuits are 100 of
   the 217 placements and $81 of the $286.

The IO board is the coprocessor board: the RP2354B, the CAN (Controller Area
Network) link to the display, the outputs, the receiver inputs, the sensor
front ends and the power path. [The specification](IOBoard.md) lists what it
has to do; this page lists how its parts are found.

## Scope

| Round | Selects |
| --- | --- |
| 1 | ICs: microcontroller support, CAN, safety gate, output and input buffers, power conversion and protection, current and voltage monitors, cell monitor, ADC (analogue-to-digital converter) and reference, sensor front ends, non-volatile store. Also the parts that fix an IC's surroundings: the RP2354B's crystal and regulator inductor, the servo supply's inductor, the onboard and external motor shunts, and the switch of the ESC (electronic speed controller) pack with its input protection (R3). R7 also selects the 18650 cells of the bench's own pack and the pack's protection |
| 2 | first, follow-up tasks of round 1's categories for the ICs and IC surroundings that round 1 left without a part or whose requirement changed ([Round 2](#round-2); owner, 2026-10-01); then passives; ESD (electrostatic discharge) and overvoltage protection on the signal, sensor, balance-lead, link and heartbeat connectors (the power input's protection is R5 and the ESC pack path's is R3, both in round 1); connectors; crystals and inductors not fixed in round 1 |
| 3 | mechanical, thermal, layout constraints; the busbar, mounting and cabling of the external 300 A path, whose shunt is in round 1 |

Not in any round: the link pages and coprocessor code that carry a
measurement or a function from the IO board to the display. The specification
lists each as required: receiver data, port currents and the servo
procedures, cell readings, vibration, thrust and torque. They are firmware
work. P6 marks such a line "hardware selected, link open" and does not return
it as a gap. Two questions from the same lines do reach round 1, because they
choose hardware or fix a value: which sensor gives the servo's measured
position (R11), and which source fills the BENCH voltage and current registers
(R8) and the rpm register (R11) when more than one reports. P1 asks the owner
both.

Fixed inputs. Round 1 checks them for stock, lifecycle and a second source.
A fixed input that fails a check is reported to the owner, not re-selected.
A row that says "whatever a run returns" names a part the owner keeps
(owner, 2026-10-02). Where no run verifies such a part, the selection
keeps it as the owner's. The pages state each check no run confirmed as
not known. Any other fixed input that no run verifies stays open for the
owner.
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
