subtilitas/rcbench/help/content/de/overview.md

---
screen: OVERVIEW
title: Menü
order: 1
---

# Menü

Das Menü ist die Startseite des Panels. Es öffnet sich nach dem Splash und enthält eine Kachel für jede Prüfstandsseite. Tippe auf eine Kachel, um die Seite zu öffnen. Das Home-Feld oben links führt eine Ebene zurück: von einer Hauptseite zu diesem Menü, von einer SETUP-Seite oder Liste zu den SETUP-Kacheln.

## Die Kacheln

Das Menü bei bestehender Verbindung

Acht Kacheln zu je 243 x 255px, in 4 Spalten und 2 Reihen: die Werkbänke in der ersten Reihe, die Instrumente in der zweiten, LOGS über SETUP in der letzten Spalte.

| Kachel | Zeile unter dem Namen | Seite |
|---|---|---|
| MOTOR & ESC | Antrieb, V/A, Drehzahl | [Motor und ESC](motor.md) |
| SERVO | Weg, Strom, Programmierung | [Servo](servo.md) |
| SUPPLY | V/A einstellen, aufzeichnen | [Netzteil](supply.md) |
| LOGS | Läufe, Dateien | [Logs](logs.md) |
| RECEIVER | S.BUS, PPM, Frames | [Receiver](analyser.md) |
| BATTERY | Zellen, iR, mAh | [Akku](battery.md) |
| BALANCE | Vibration, Phase | [Wuchten](balance.md) |
| SETUP | Panel, Pins, Karte, WLAN | [Setup](setup.md) |

Die Programmierung hat keine eigene Kachel. Elektronische Drehzahlregler (ESCs): [PROGRAMMIEREN](motor.md#programmieren) auf MOTOR & ESC. Servos: die Kacheln KST und HITEC auf [SERVO](servo-programmer.md).

Eine Kachel öffnet sich, wenn du den Finger auf derselben Kachel anhebst, auf die du gedrückt hast. Ziehst du den Finger von der Kachel weg, wird der Tipp verworfen.

## Die Marke SIMULIERT

Die Markierung SIMULIERT bedeutet, dass der IOmcu für diese Seite keine Fähigkeit meldet oder dass ihr Sensor deaktiviert ist. Sie beschreibt nicht jeden angezeigten Wert. RECEIVER und BATTERY tragen die Markierung, zeigen aber keine Werte. SERVO kann ohne Markierung erscheinen und dennoch das Netzteilmodell des Panels als Quelle für die Servoschiene verwenden, wenn weder ein PD mini noch ein INA3221 aktiviert ist. Jede Seite nennt die Quelle ihrer Messwerte.

Die Markierung richtet sich nach den Fähigkeits-Bits, die der IOmcu beim Verbindungsaufbau meldet:

| Kachel | Ohne Marke, wenn |
|---|---|
| MOTOR & ESC | der IOmcu ESCs ansteuert und eine INA228-Einstellung hält, die unter SETUP, SENSORS eingeschaltet ist |
| SERVO | der IOmcu Servo-PWM-Ausgänge (Pulsweitenmodulation) ansteuert |
| SUPPLY | der PD mini im Abschnitt PD MINI der SUPPLY-Optionen eingeschaltet ist |
| RECEIVER, BATTERY, BALANCE | in diesem Release nie: kein IOmcu meldet diese Fähigkeiten |
| LOGS, SETUP | nie markiert: sie enthalten keine Messung |

Wenn kein IOmcu antwortet, tragen auch MOTOR & ESC und SERVO die Markierung. Bei SUPPLY hängt sie allein von der Einstellung PD mini ab, unabhängig von der Verbindung.

## Das helle Design

Das Menü im hellen Design

SETUP, PANEL, Design schaltet zwischen DUNKEL und HELL. Die Änderung gilt ab dem nächsten Frame.
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
