subtilitas/rcbench/docs/img/band-armed.png

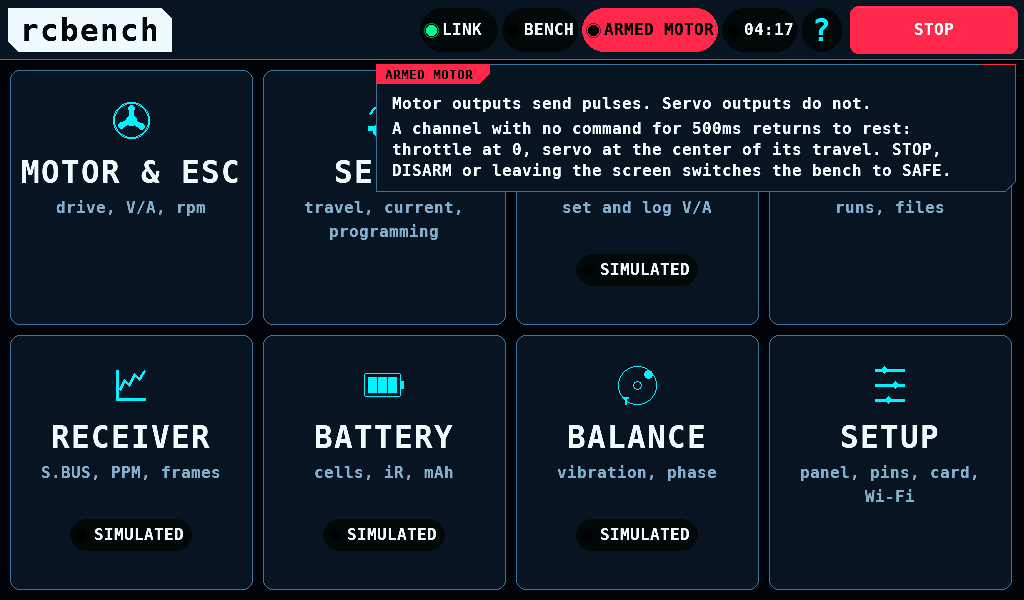
docs/img/band-armed.png
