subtilitas/rcbench/docs/img/battery.png

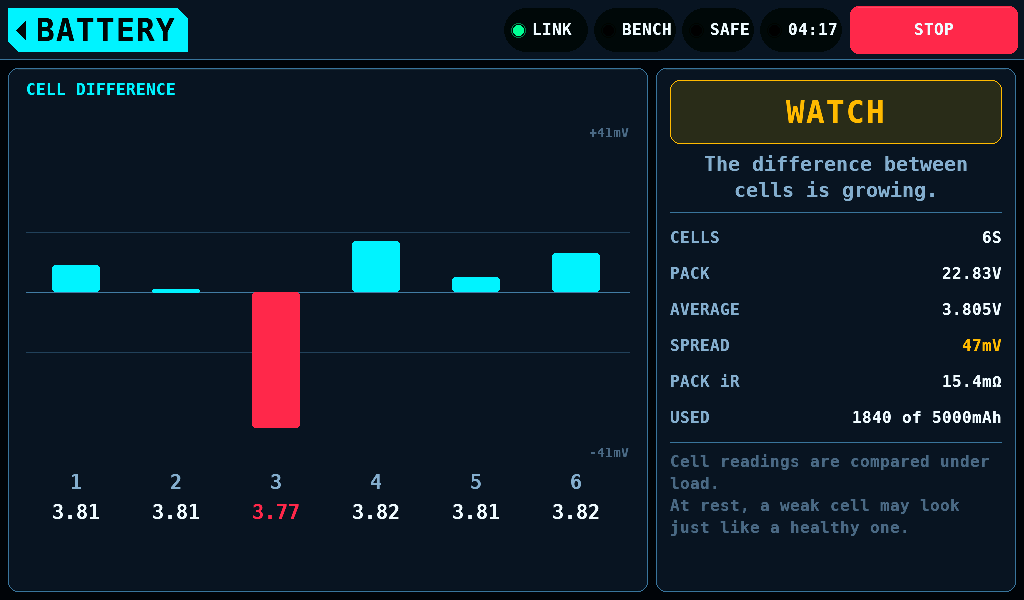
docs/img/battery.png
