subtilitas/rcbench/docs/img/busfault-lost.png

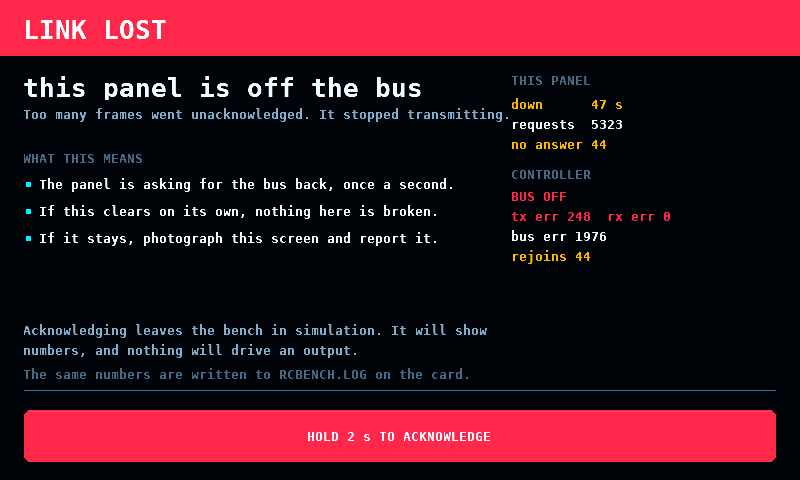
docs/img/busfault-lost.png
