subtilitas/rcbench/docs/img/de/band-armed.png

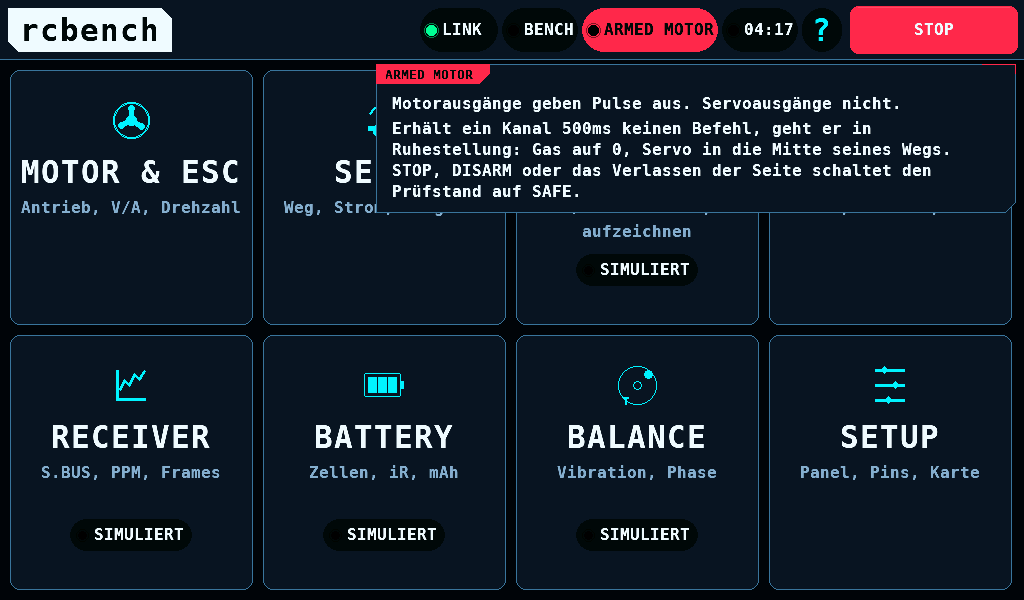
docs/img/de/band-armed.png
