subtilitas/rcbench/docs/img/de/band-link.png

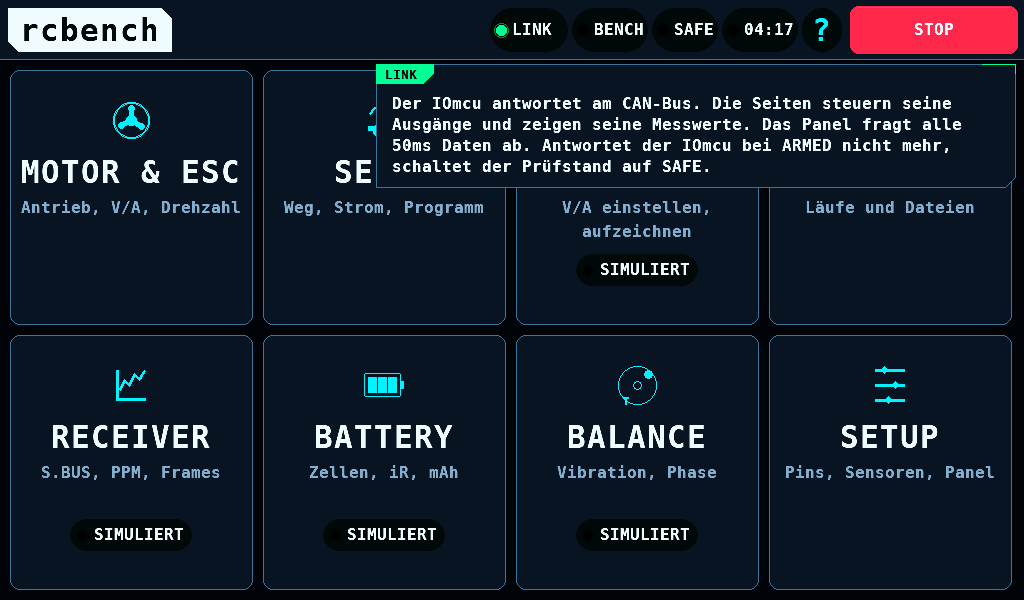
docs/img/de/band-link.png
