subtilitas/rcbench/docs/img/de/files-edit-kst.png

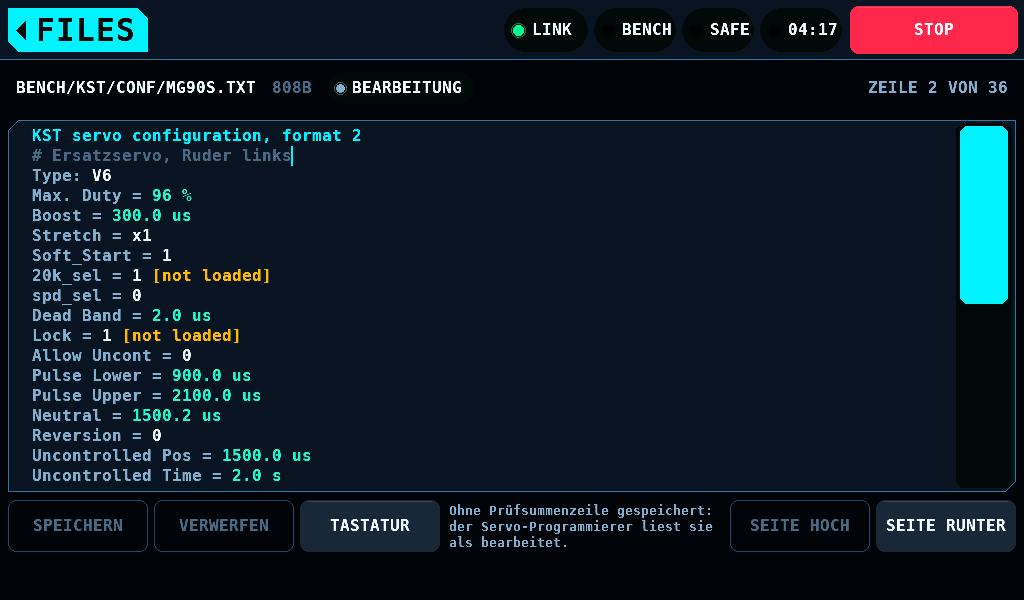
docs/img/de/files-edit-kst.png
