subtilitas/rcbench/docs/img/de/files-edit.png

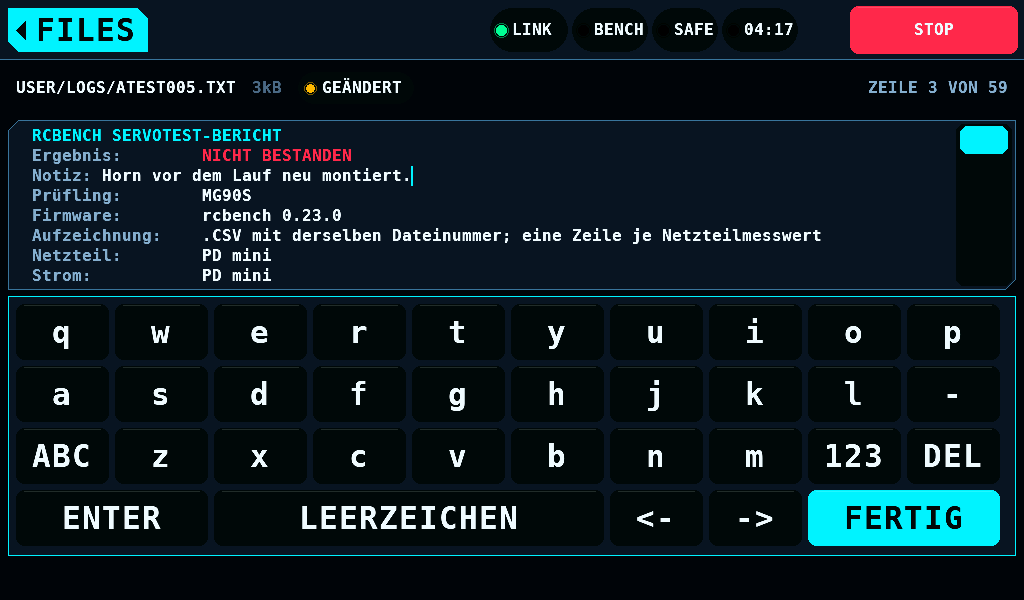
docs/img/de/files-edit.png
