subtilitas/rcbench/docs/img/de/files.png

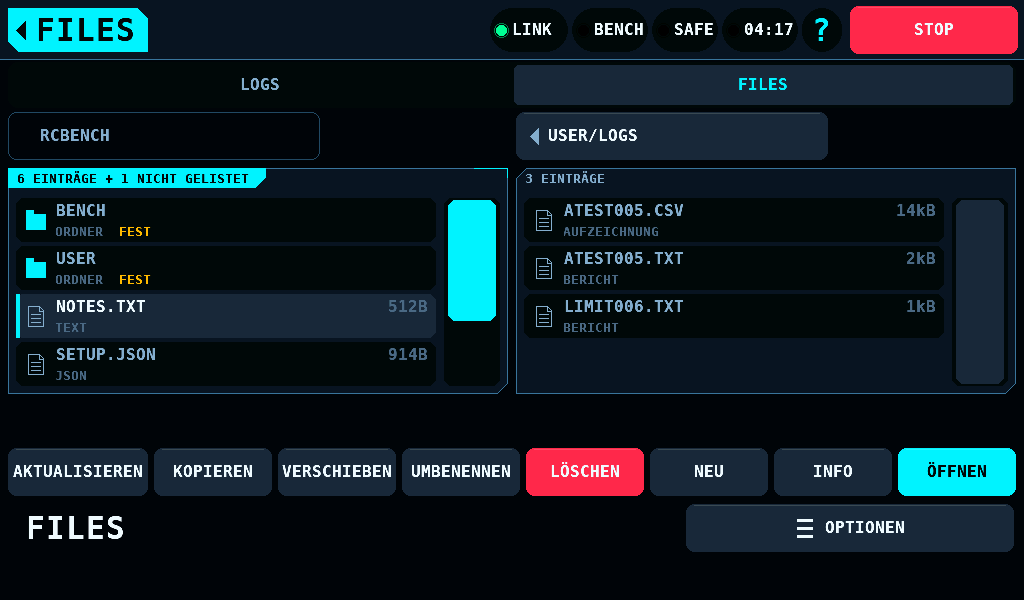
docs/img/de/files.png
