subtilitas/rcbench/docs/img/de/help-outputs.png

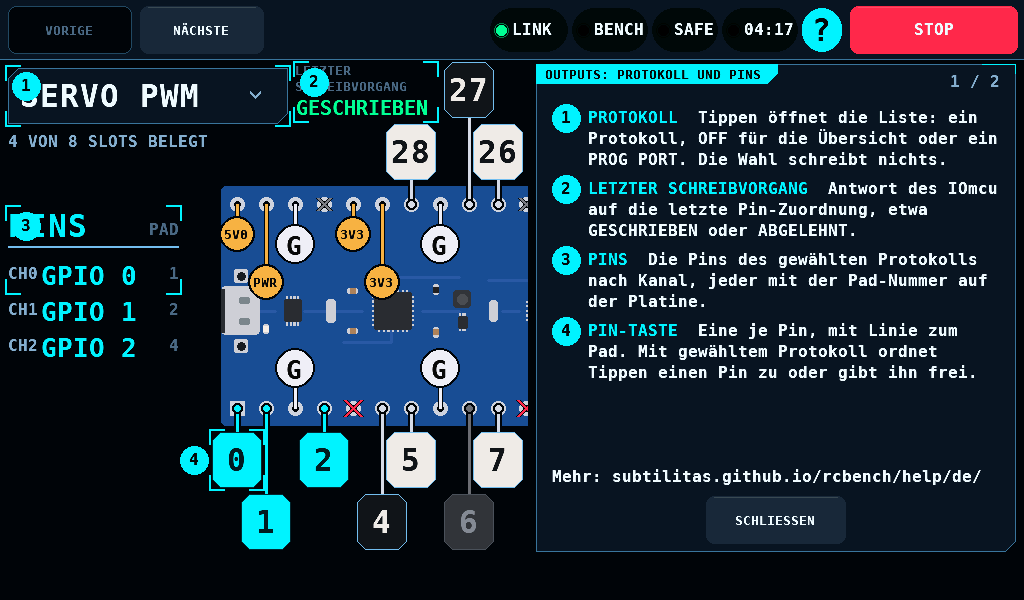
docs/img/de/help-outputs.png
