subtilitas/rcbench/docs/img/de/help-overview.png

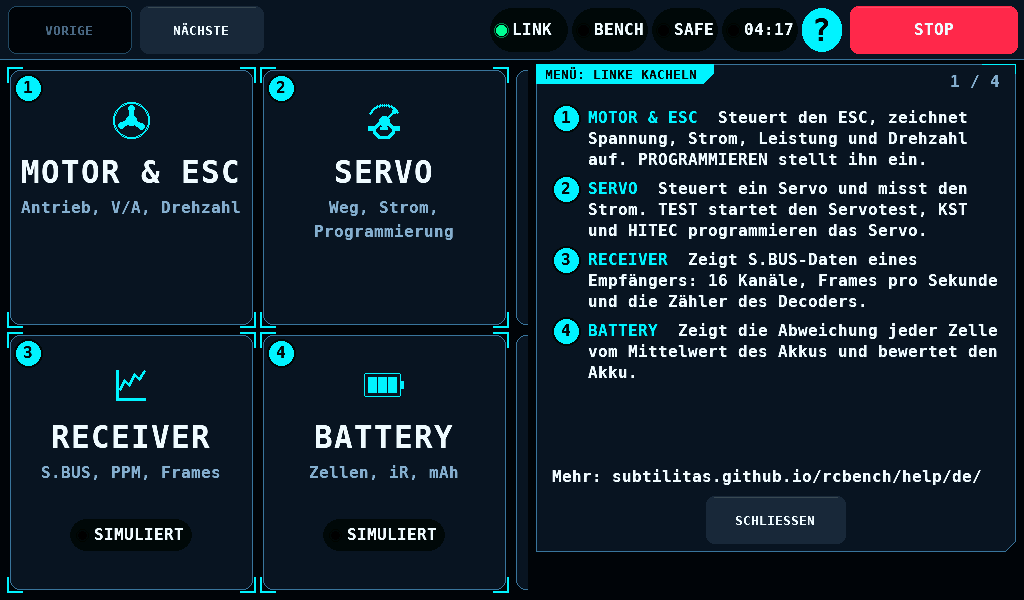
docs/img/de/help-overview.png
