subtilitas/rcbench/docs/img/de/help-servo-kst.png

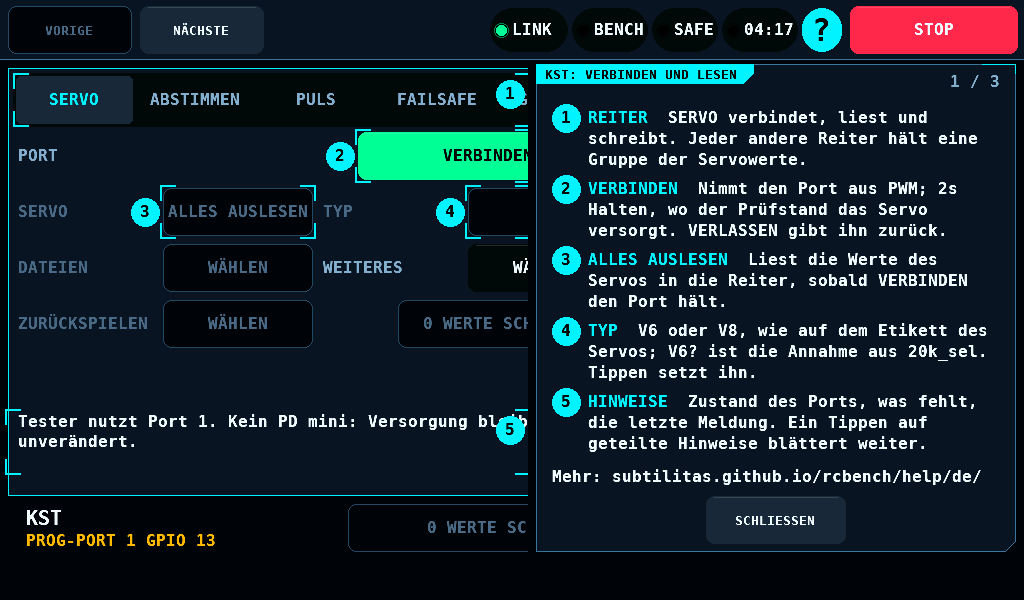
docs/img/de/help-servo-kst.png
