subtilitas/rcbench/docs/img/de/imu-scan.png

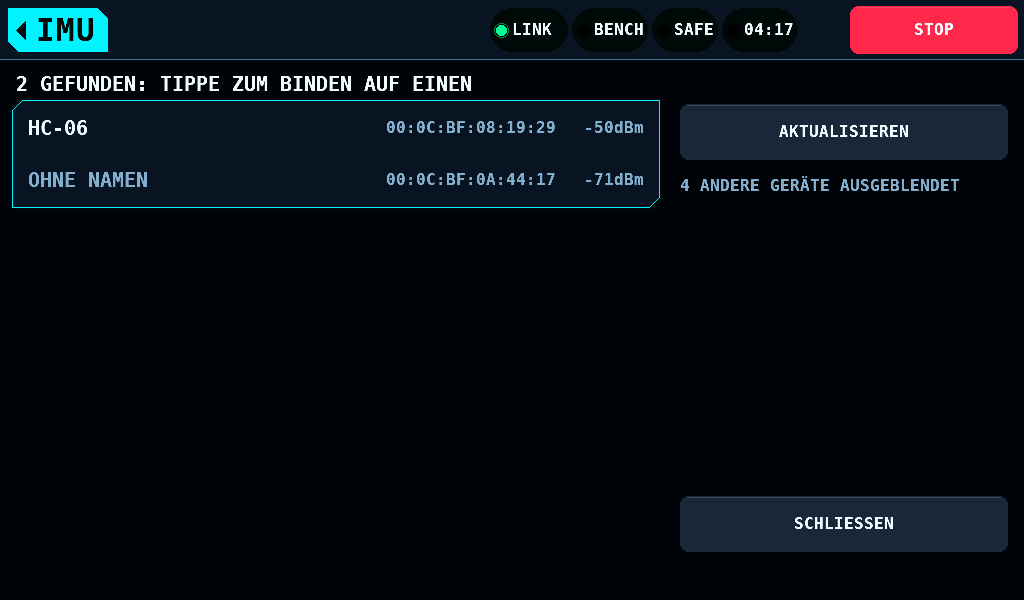
docs/img/de/imu-scan.png
