subtilitas/rcbench/docs/img/de/logs-plot.png

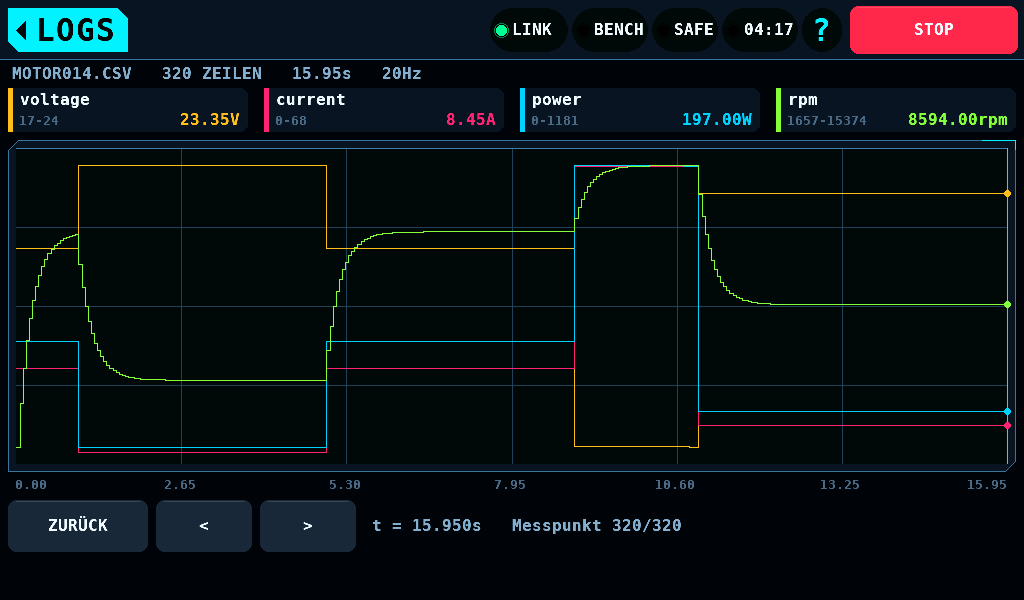
docs/img/de/logs-plot.png
