subtilitas/rcbench/docs/img/de/logs-report.png

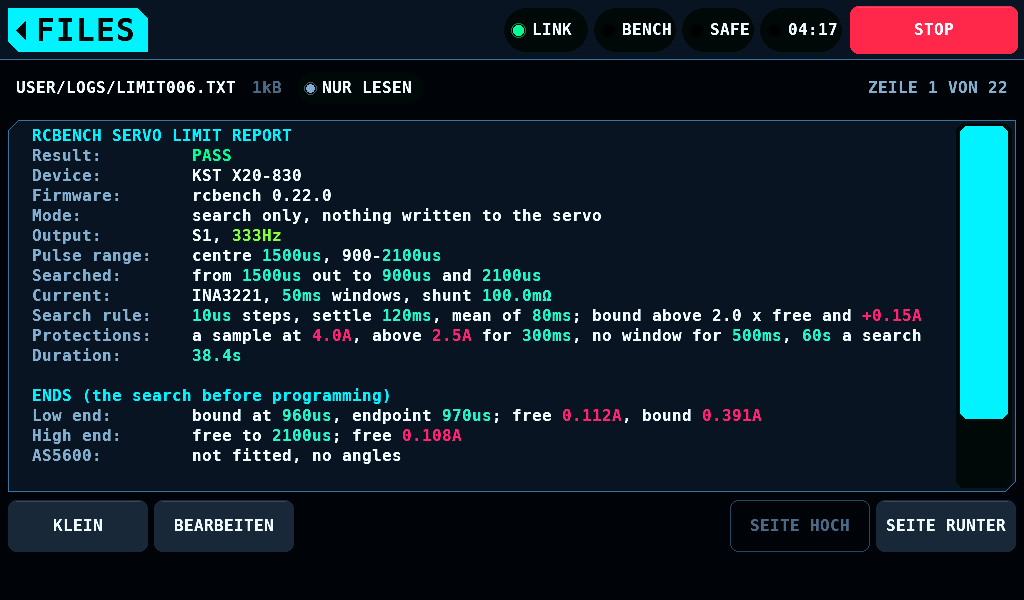
docs/img/de/logs-report.png
