subtilitas/rcbench/docs/img/de/logs-root.png

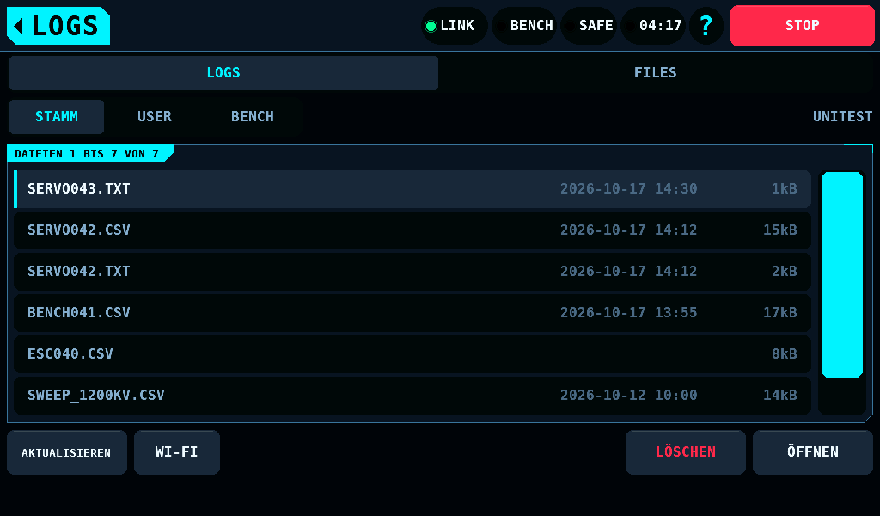
docs/img/de/logs-root.png
