subtilitas/rcbench/docs/img/de/logs-servo-plot.png

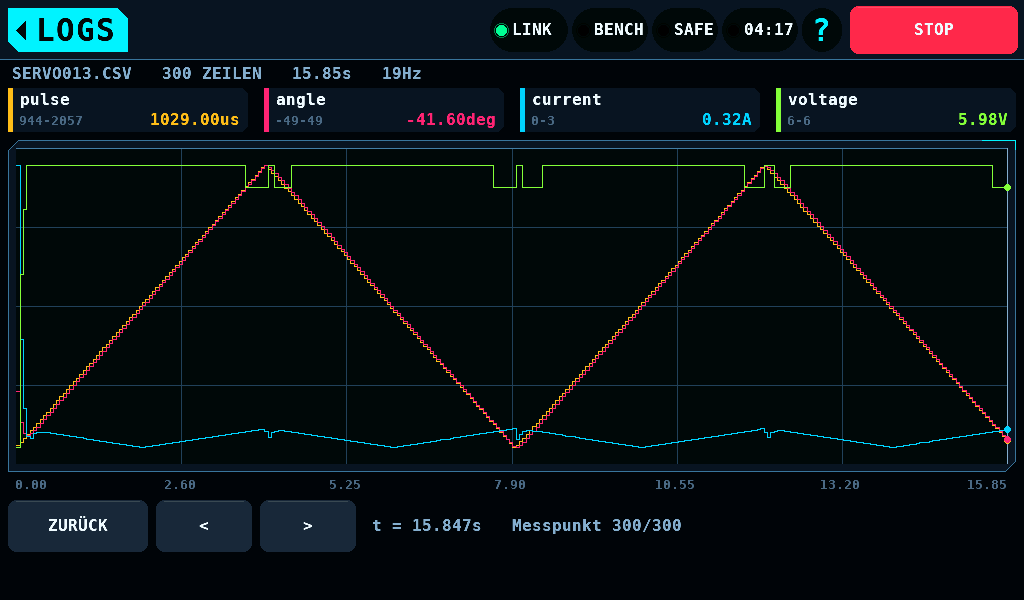
docs/img/de/logs-servo-plot.png
