subtilitas/rcbench/docs/img/de/logs.png

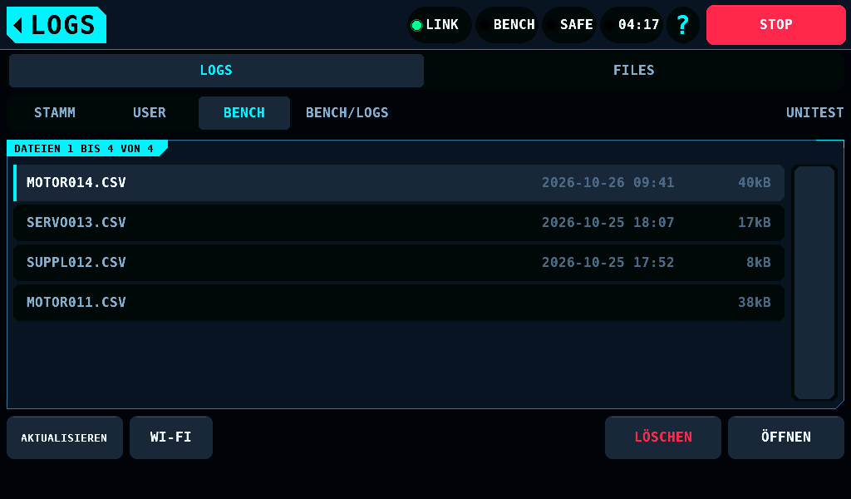
docs/img/de/logs.png
