subtilitas/rcbench/docs/img/de/motor-stick-done.png

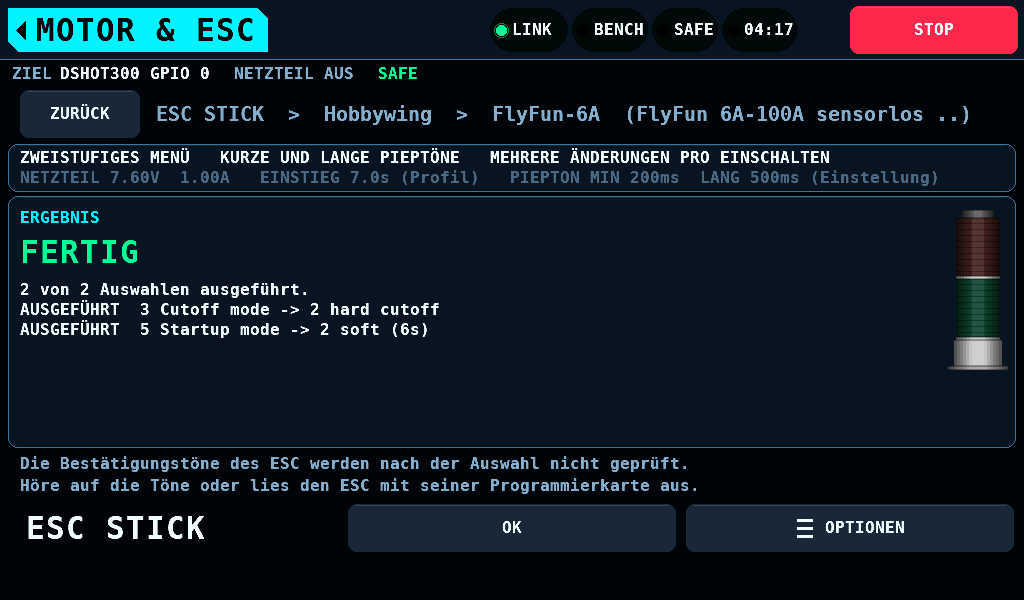
docs/img/de/motor-stick-done.png
