subtilitas/rcbench/docs/img/de/motor-stick-find.png

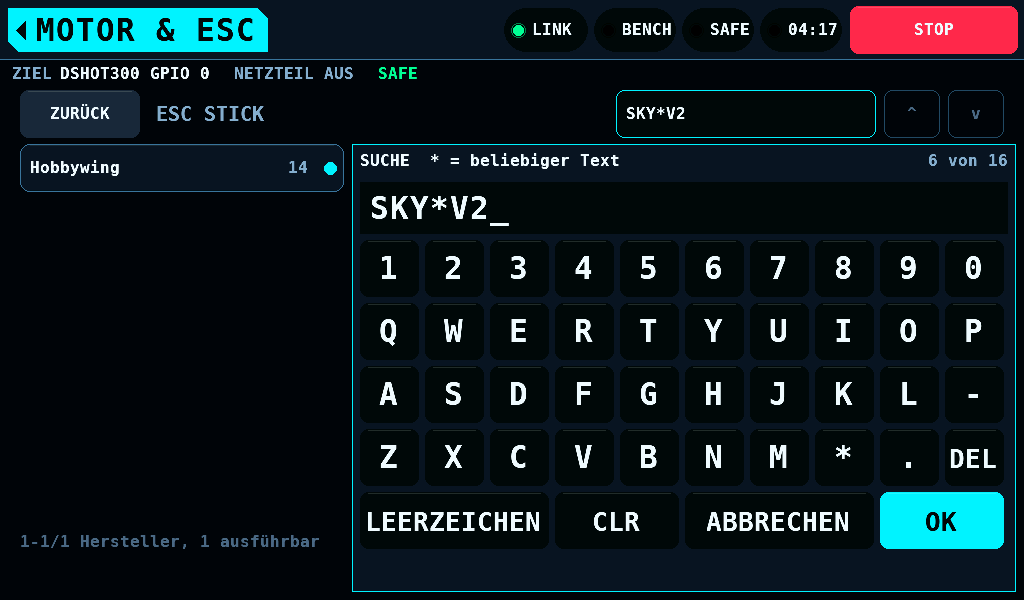
docs/img/de/motor-stick-find.png
