subtilitas/rcbench/docs/img/de/motor-stick-hand-locked.png

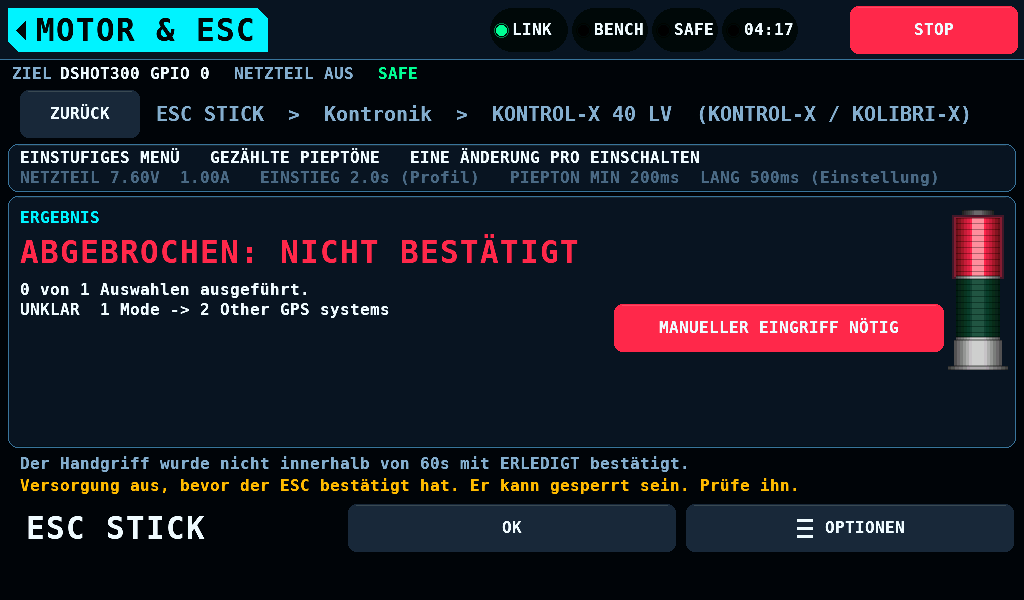
docs/img/de/motor-stick-hand-locked.png
