subtilitas/rcbench/docs/img/de/motor-stick-hand.png

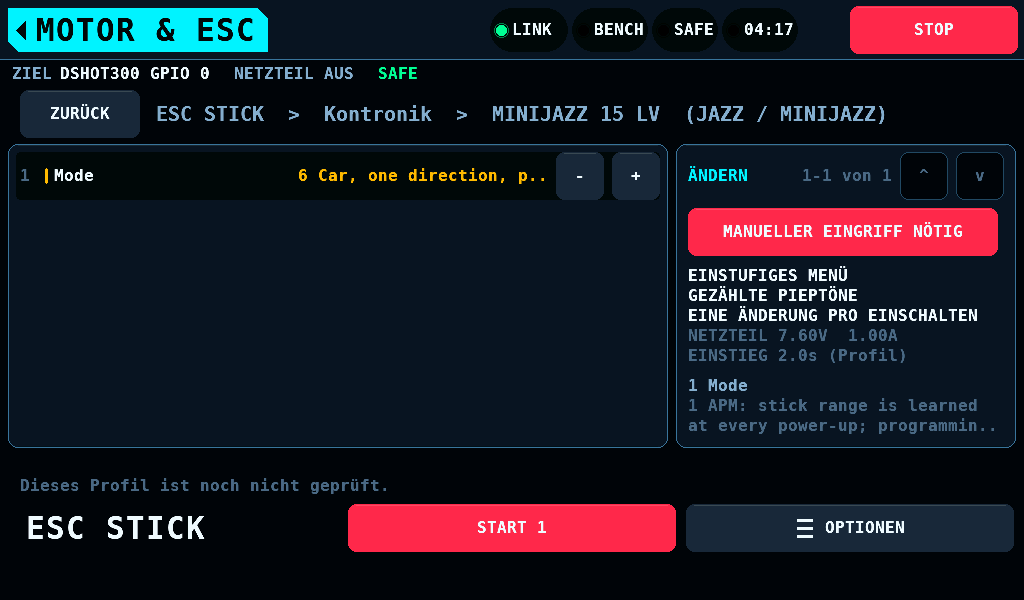
docs/img/de/motor-stick-hand.png
