subtilitas/rcbench/docs/img/de/motor-stick-items.png

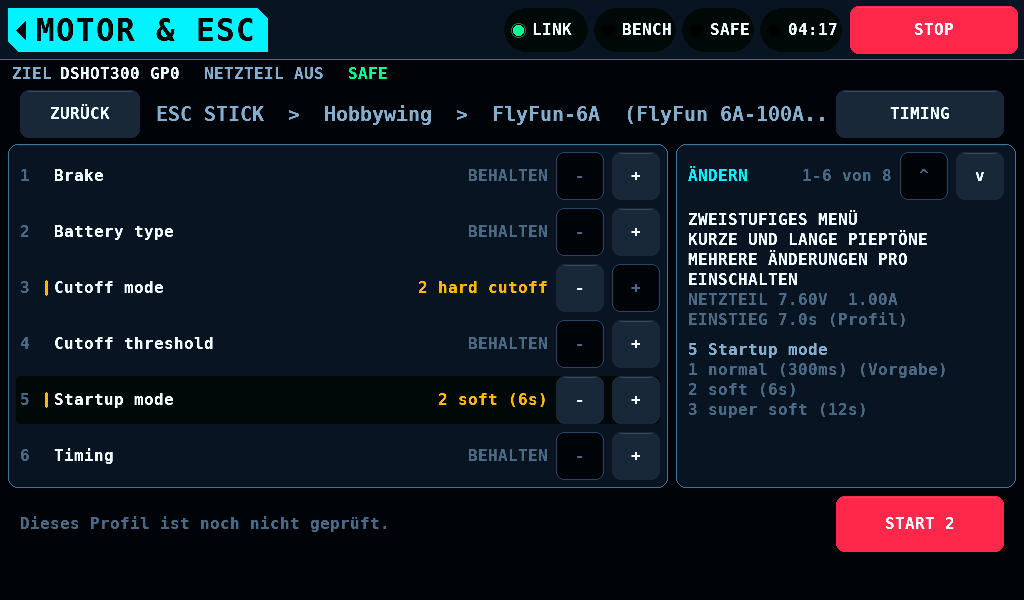
docs/img/de/motor-stick-items.png
