subtilitas/rcbench/docs/img/de/motor-stick-timing-keypad.png

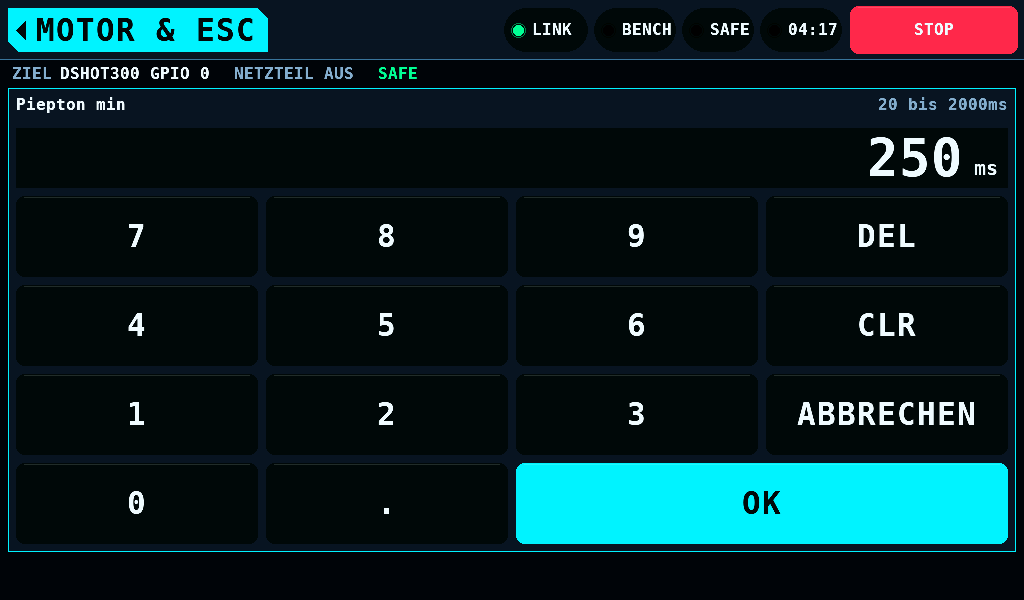
docs/img/de/motor-stick-timing-keypad.png
