subtilitas/rcbench/docs/img/de/motor-stick-tone.png

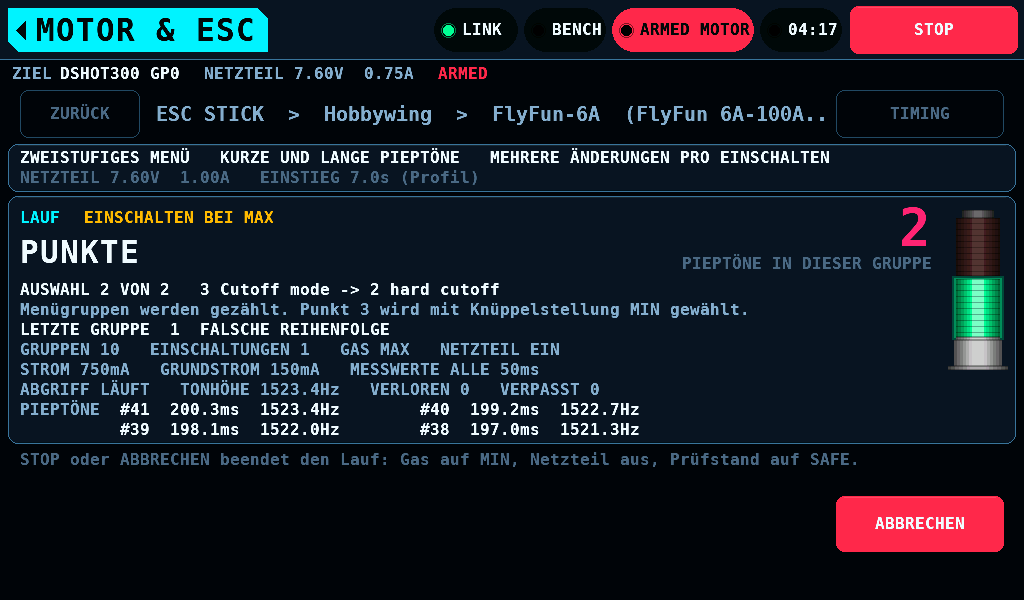
docs/img/de/motor-stick-tone.png
