subtilitas/rcbench/docs/img/de/motor-wire-e32-1.png

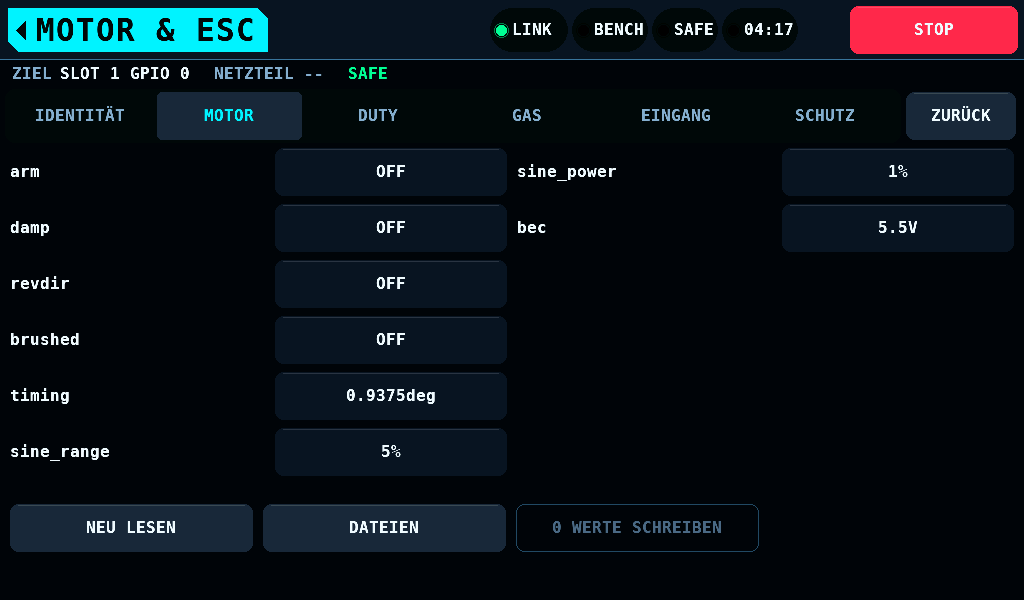
docs/img/de/motor-wire-e32-1.png
