subtilitas/rcbench/docs/img/de/motor-wire-e32.png

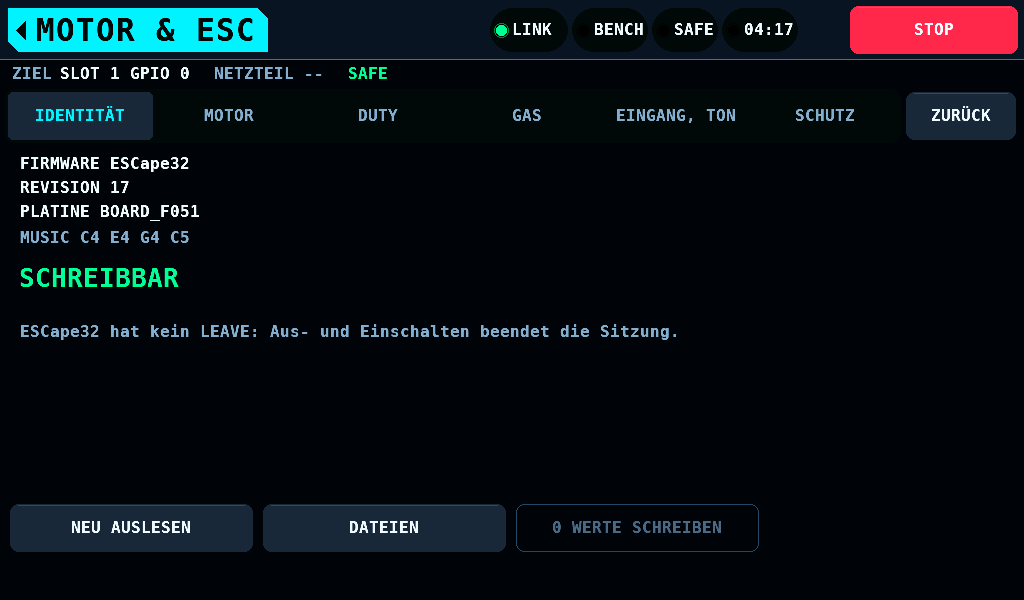
docs/img/de/motor-wire-e32.png
