subtilitas/rcbench/docs/img/de/motor-wire-entering.png

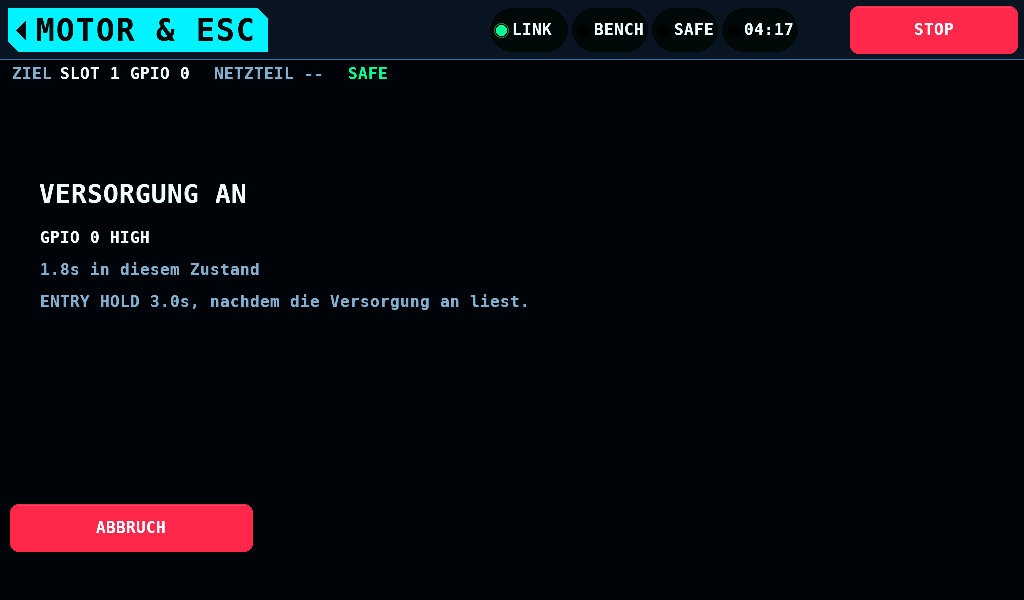
docs/img/de/motor-wire-entering.png
