subtilitas/rcbench/docs/img/de/motor-wire-erased.png

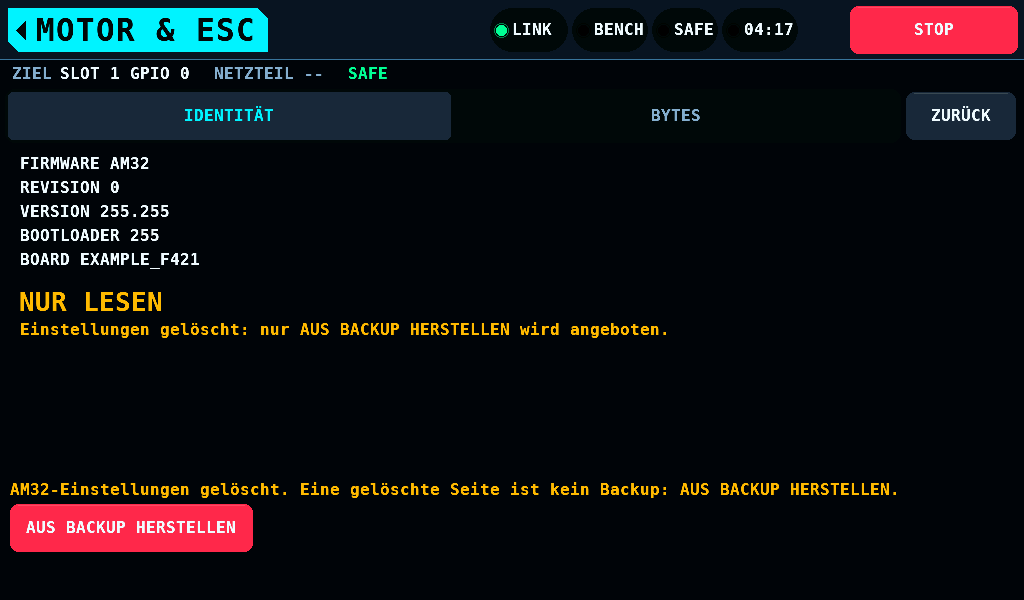
docs/img/de/motor-wire-erased.png
