subtilitas/rcbench/docs/img/de/motor-wire-hand.png

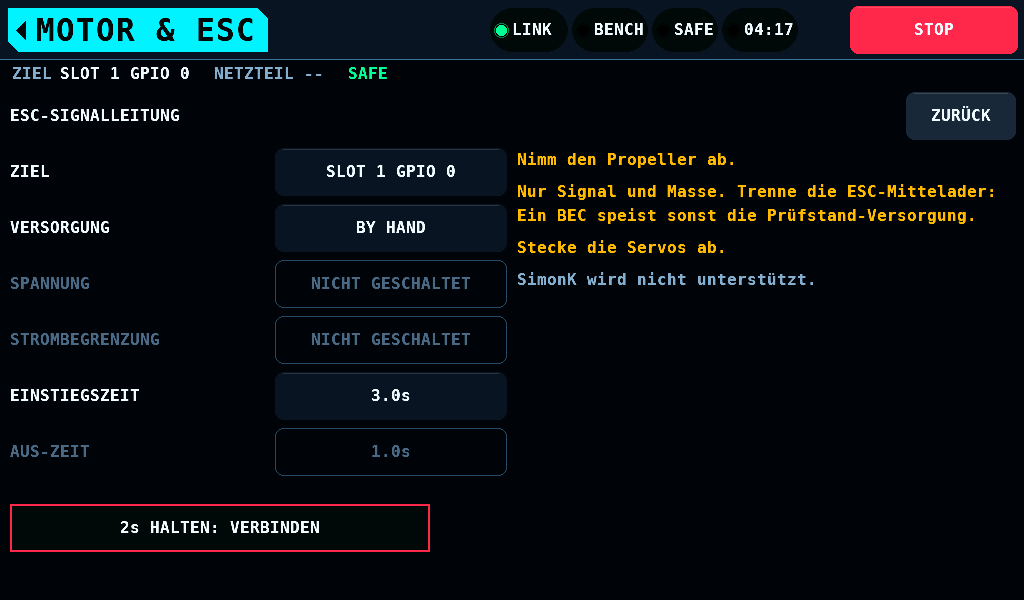
docs/img/de/motor-wire-hand.png
