subtilitas/rcbench/docs/img/de/motor-wire-press-prev.png

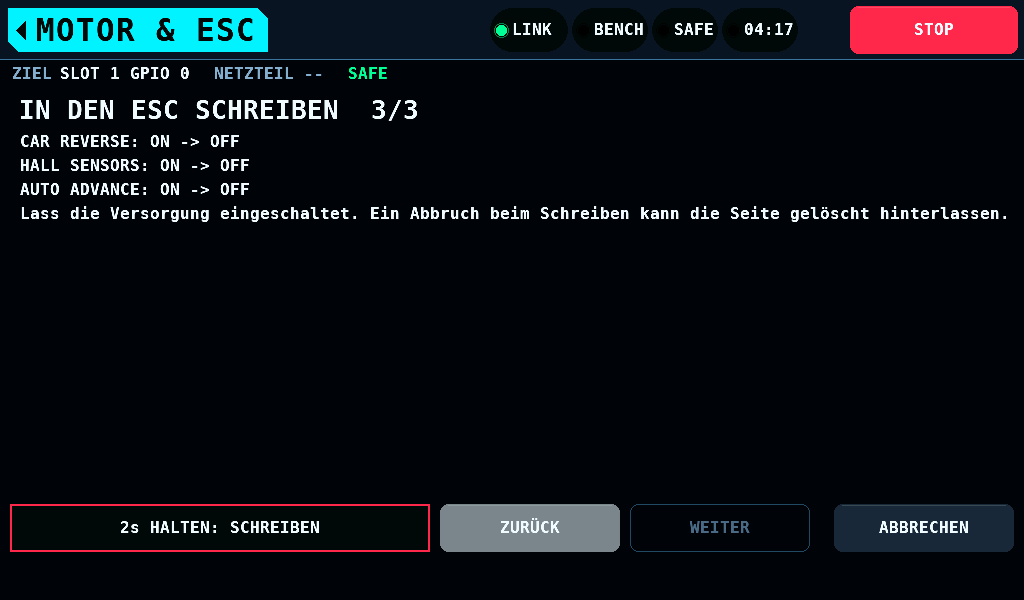
docs/img/de/motor-wire-press-prev.png
