subtilitas/rcbench/docs/img/de/motor-wire-readonly.png

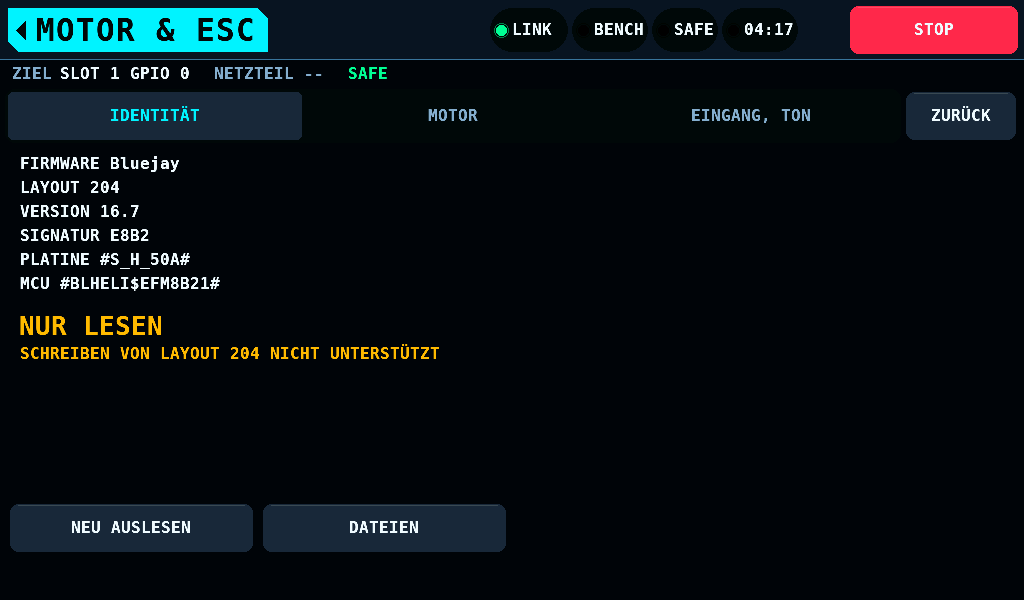
docs/img/de/motor-wire-readonly.png
