subtilitas/rcbench/docs/img/de/outputs-bidir.png

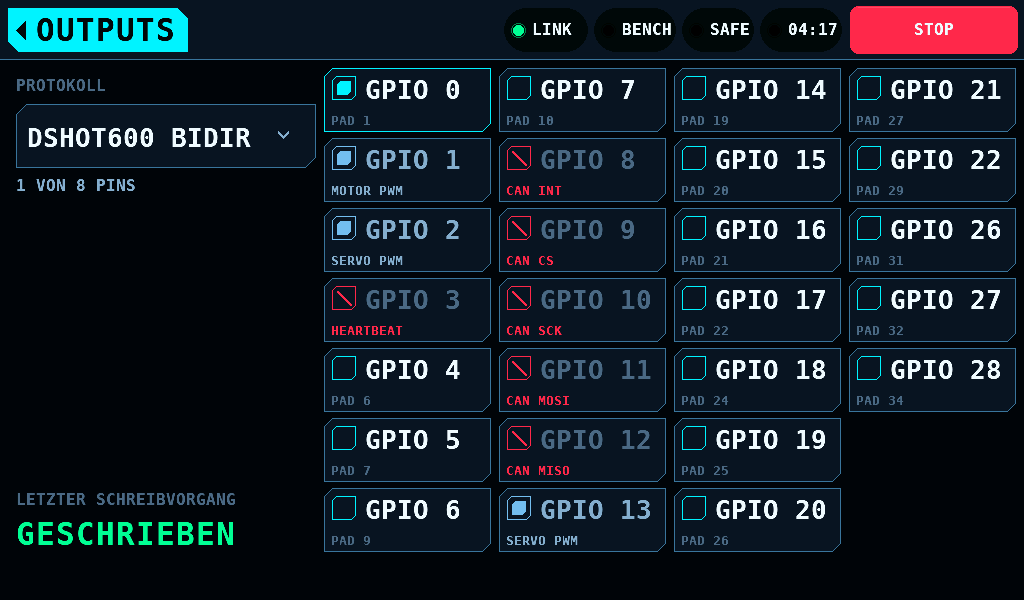
docs/img/de/outputs-bidir.png
