subtilitas/rcbench/docs/img/de/outputs-grid.png

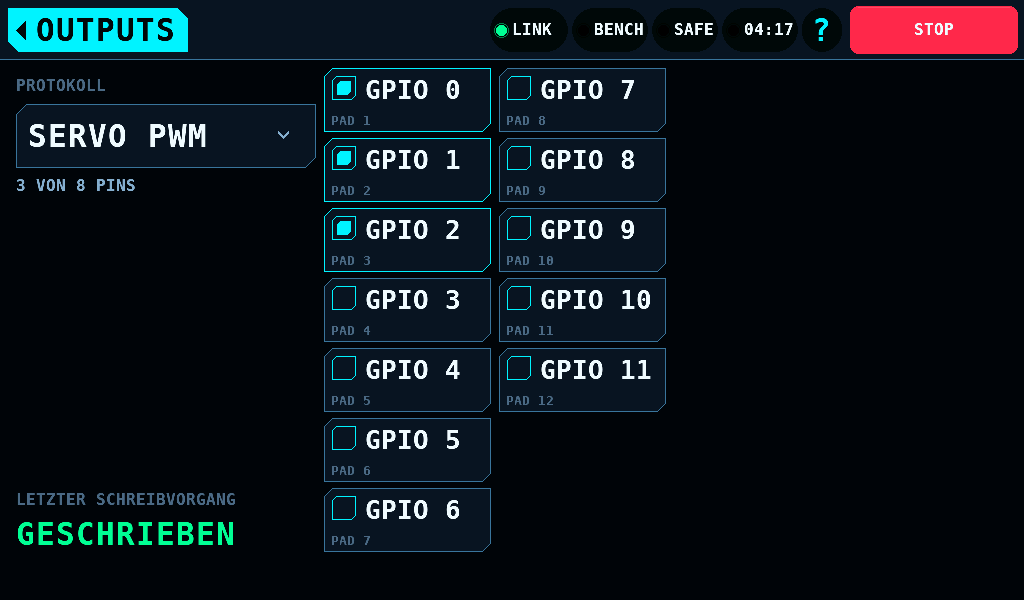
docs/img/de/outputs-grid.png
