subtilitas/rcbench/docs/img/de/outputs-held.png

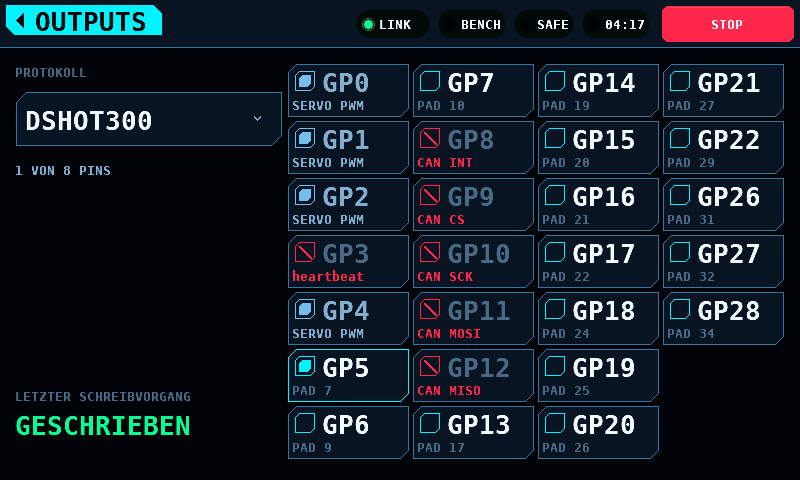
docs/img/de/outputs-held.png
