subtilitas/rcbench/docs/img/de/outputs-iface.png

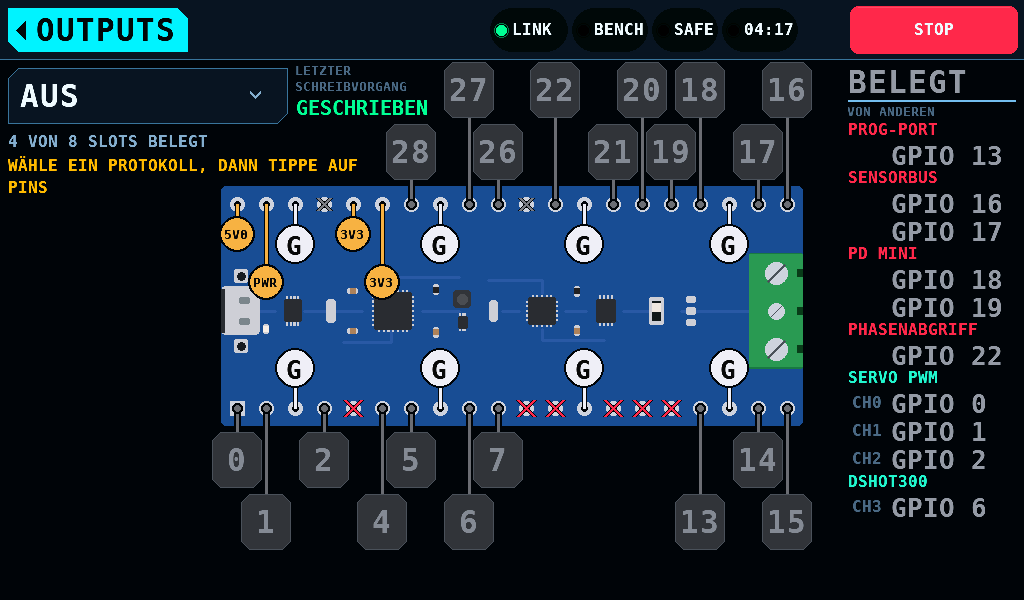
docs/img/de/outputs-iface.png
