subtilitas/rcbench/docs/img/de/outputs-port3.png

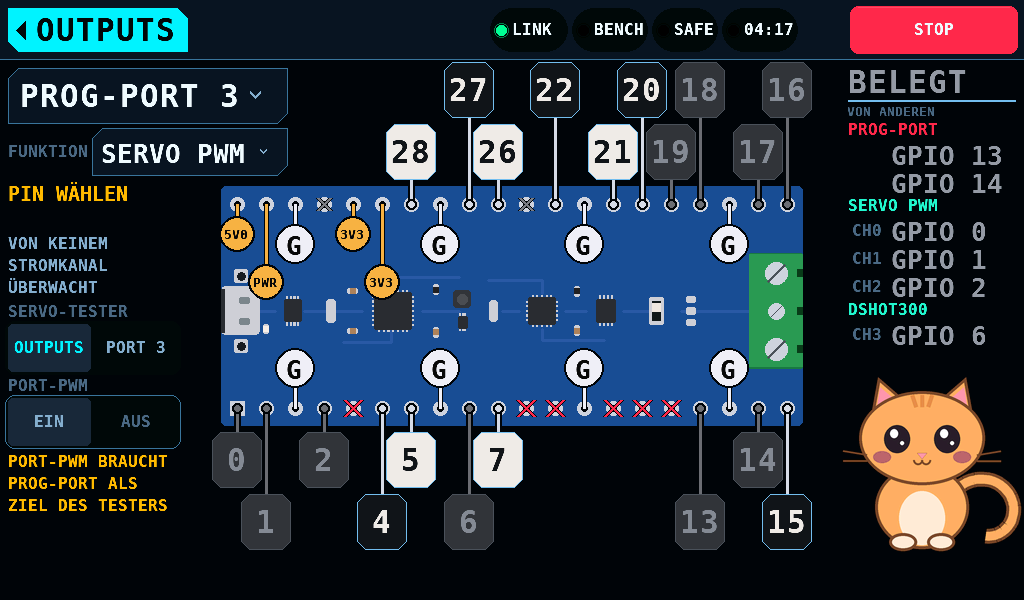
docs/img/de/outputs-port3.png
