subtilitas/rcbench/docs/img/de/outputs-prog.png

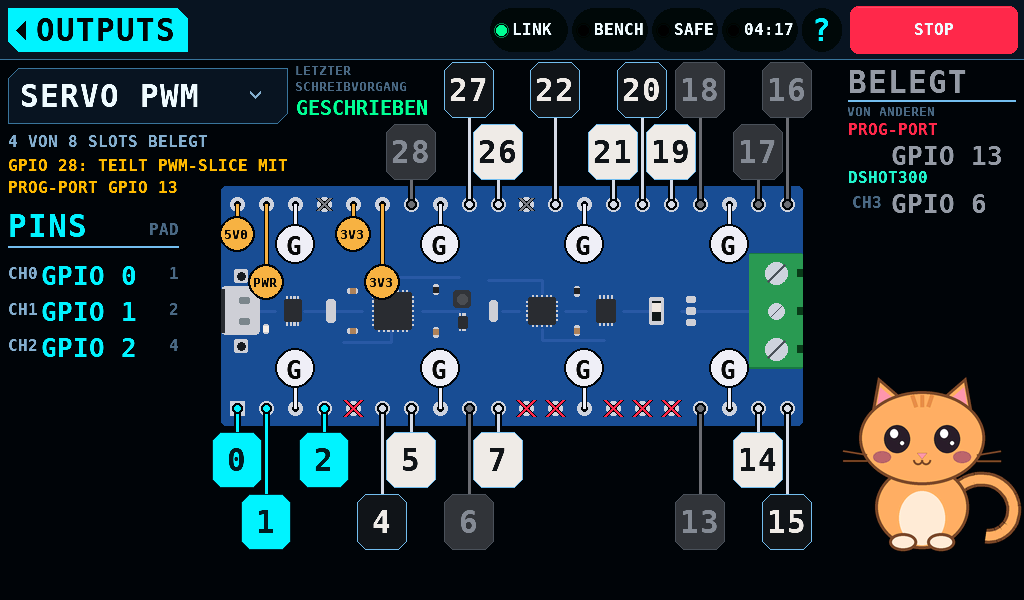
docs/img/de/outputs-prog.png
