subtilitas/rcbench/docs/img/de/outputs-rbmod-port.png

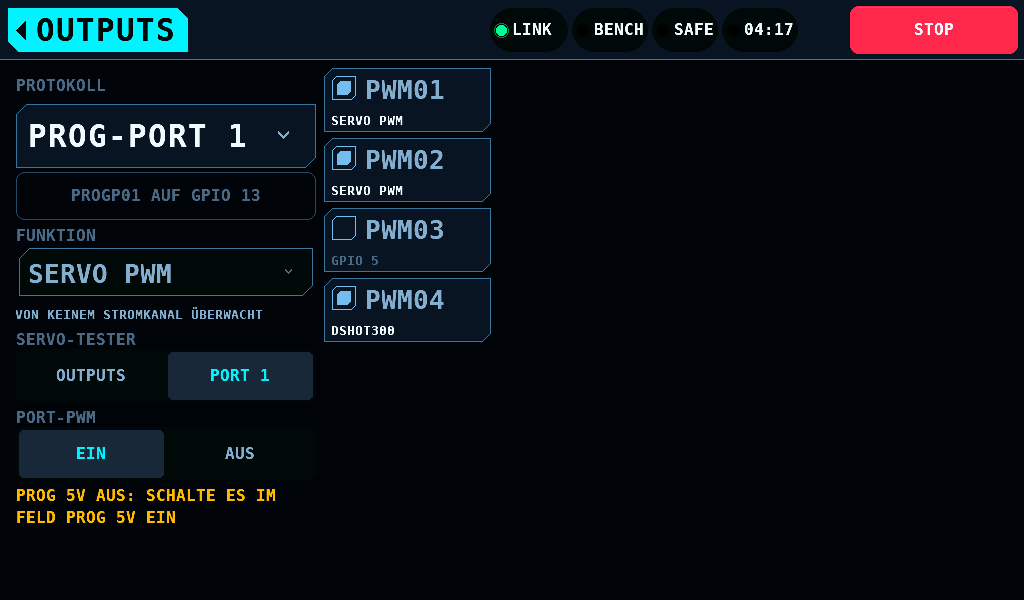
docs/img/de/outputs-rbmod-port.png
