subtilitas/rcbench/docs/img/de/overview-alert.png

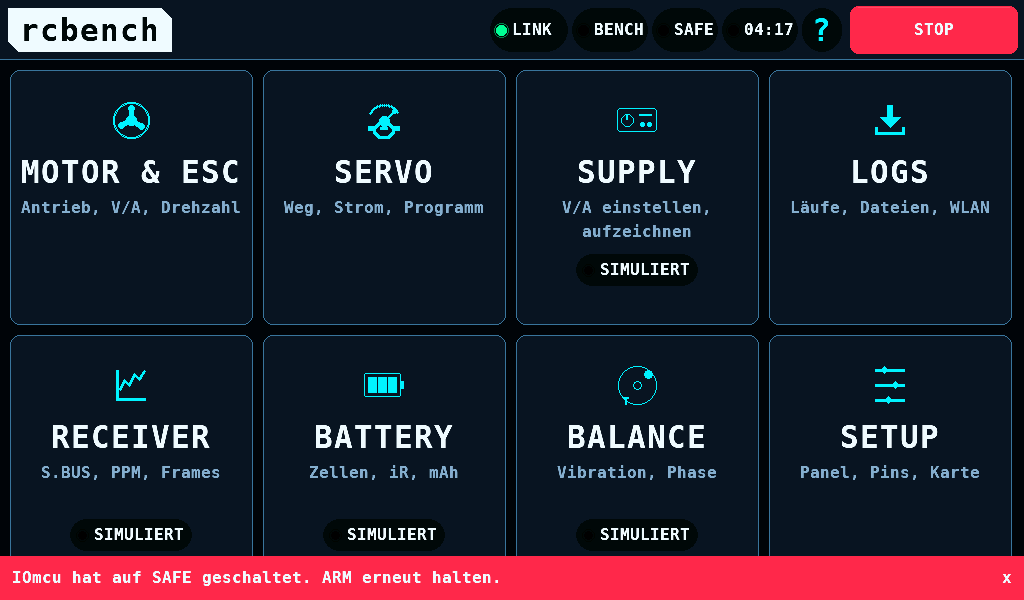
docs/img/de/overview-alert.png
