subtilitas/rcbench/docs/img/de/overview-light.png

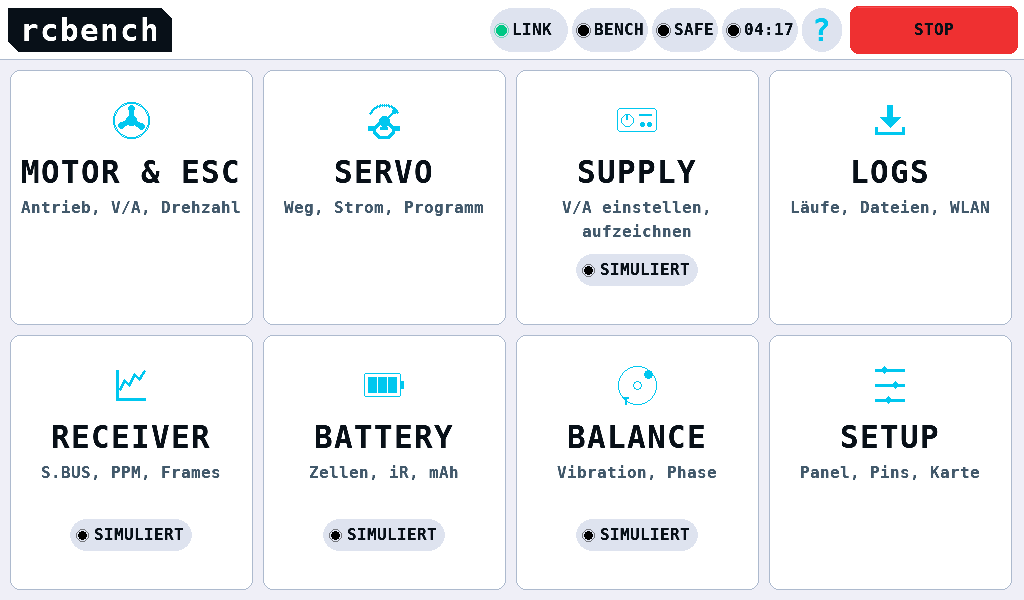
docs/img/de/overview-light.png
