subtilitas/rcbench/docs/img/de/panel-download-failed.png

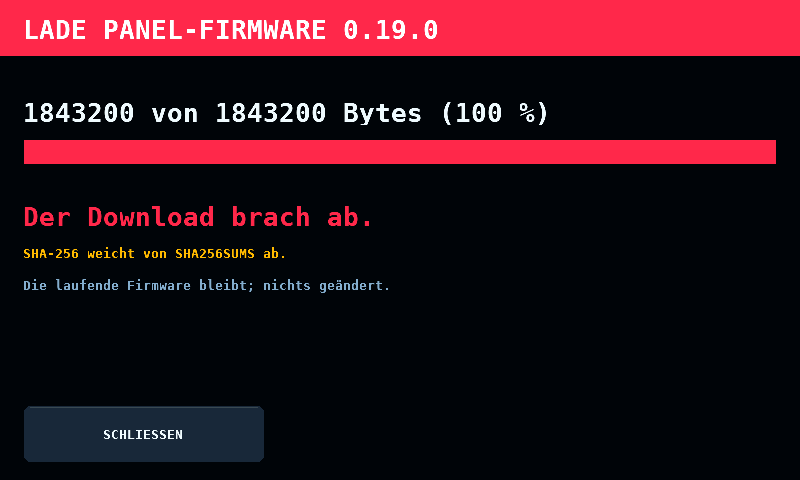
docs/img/de/panel-download-failed.png
