subtilitas/rcbench/docs/img/de/panel-download.png

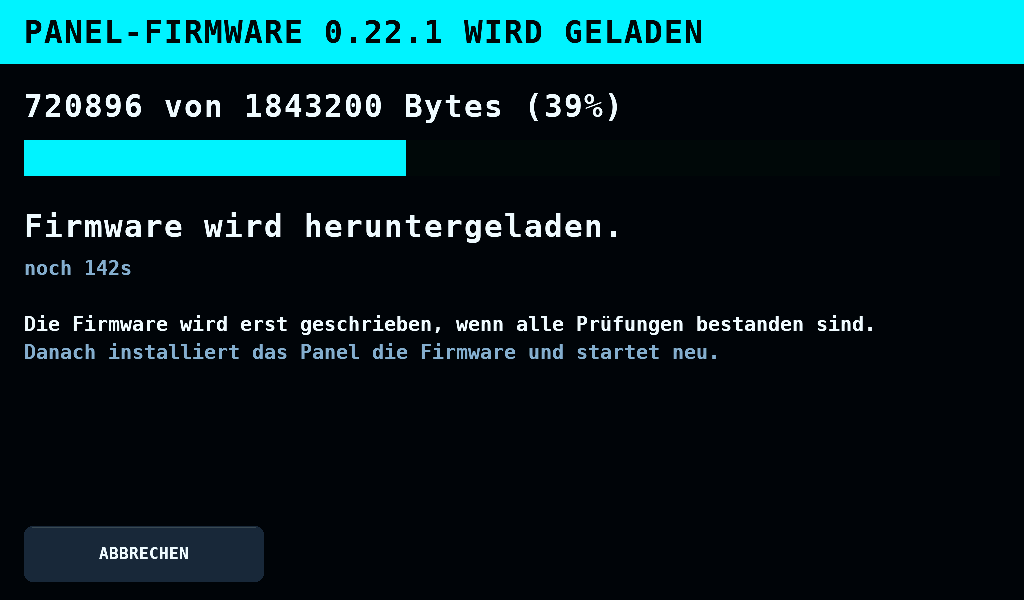
docs/img/de/panel-download.png
