subtilitas/rcbench/docs/img/de/picker-off.png

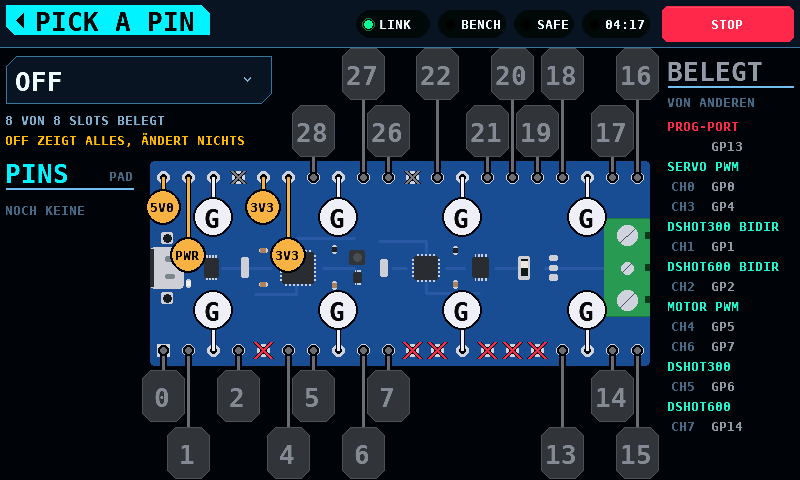
docs/img/de/picker-off.png
