subtilitas/rcbench/docs/img/de/picker-protocol.png

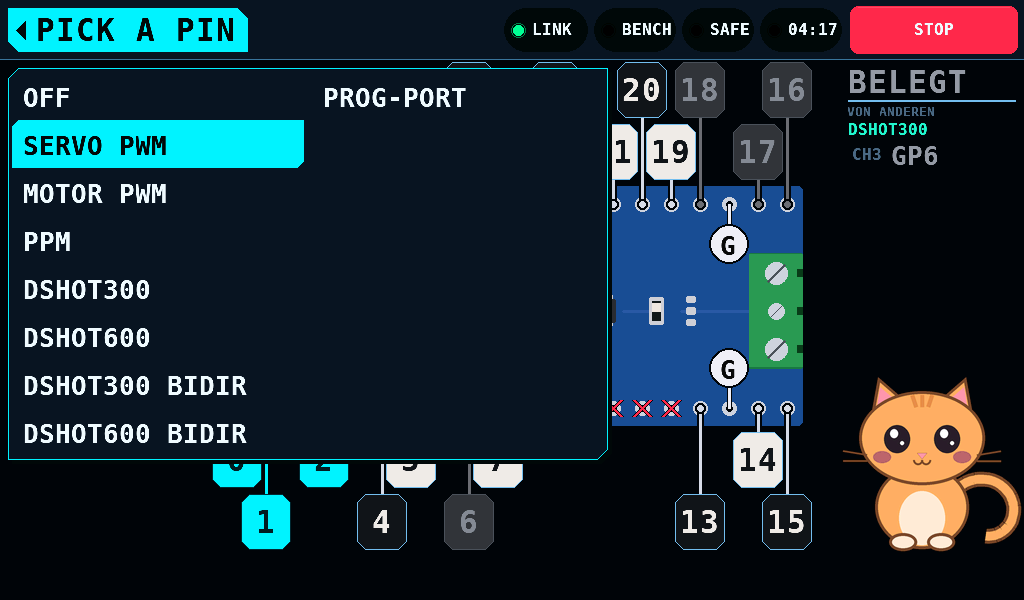
docs/img/de/picker-protocol.png
