subtilitas/rcbench/docs/img/de/programmer-am32.png

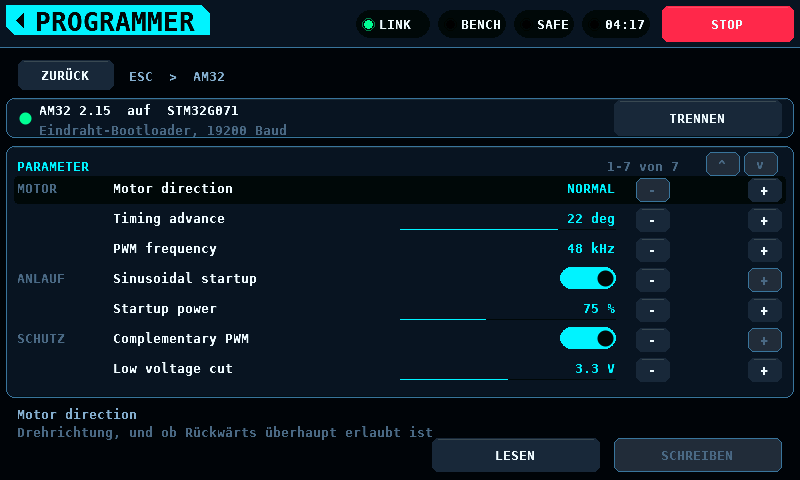
docs/img/de/programmer-am32.png
