subtilitas/rcbench/docs/img/de/programmer-dirty.png

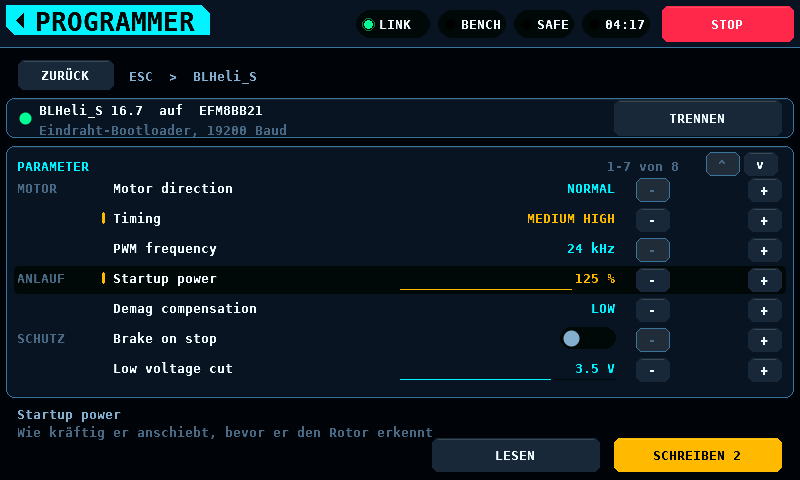
docs/img/de/programmer-dirty.png
