subtilitas/rcbench/docs/img/de/programmer-protocols.png

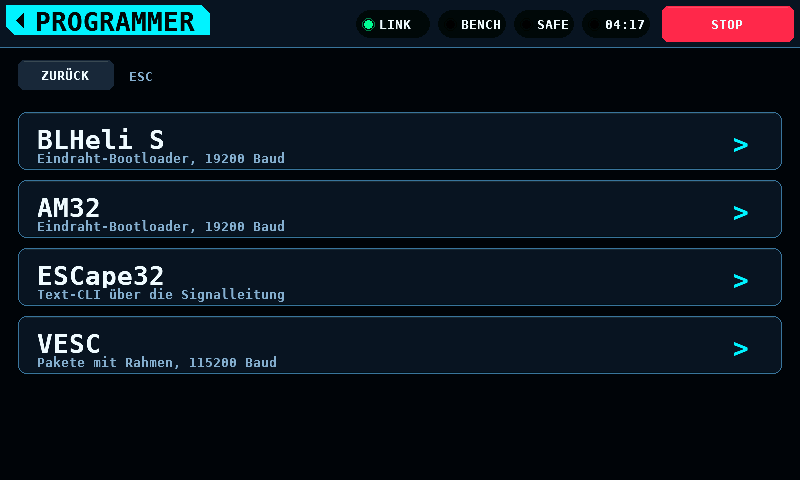
docs/img/de/programmer-protocols.png
