subtilitas/rcbench/docs/img/de/programmer-stick-done.png

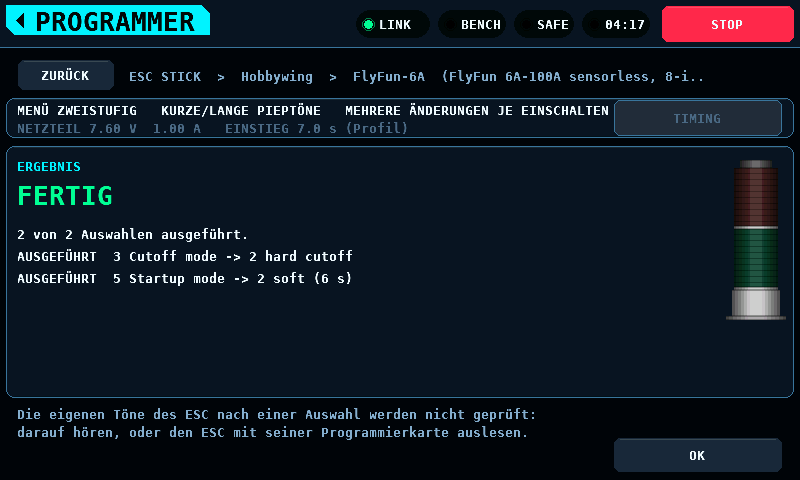
docs/img/de/programmer-stick-done.png
