subtilitas/rcbench/docs/img/de/programmer-stick-hand-after.png

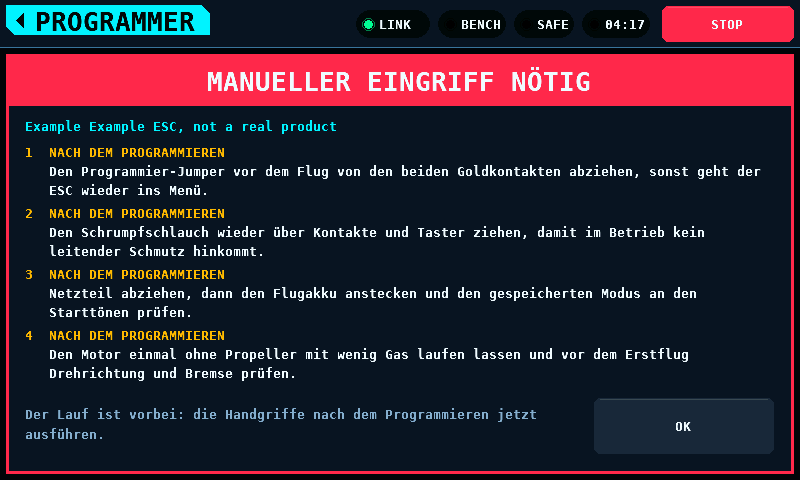
docs/img/de/programmer-stick-hand-after.png
