subtilitas/rcbench/docs/img/de/programmer-stick-hand-locked.png

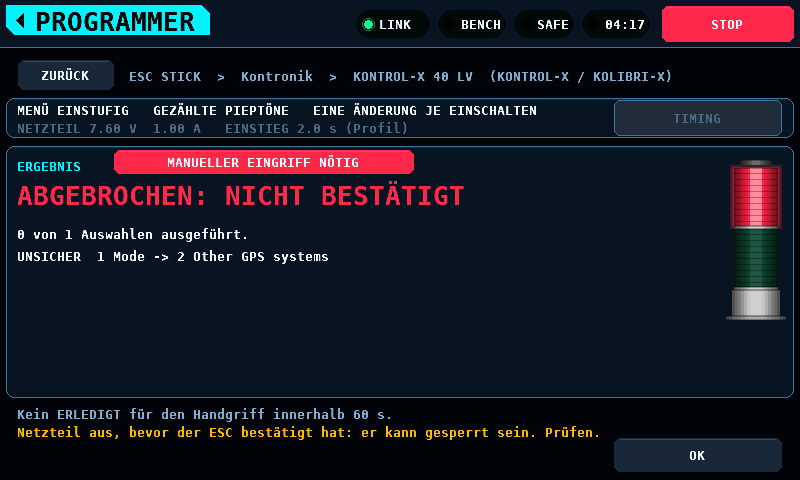
docs/img/de/programmer-stick-hand-locked.png
