subtilitas/rcbench/docs/img/de/programmer-stick-hand.png

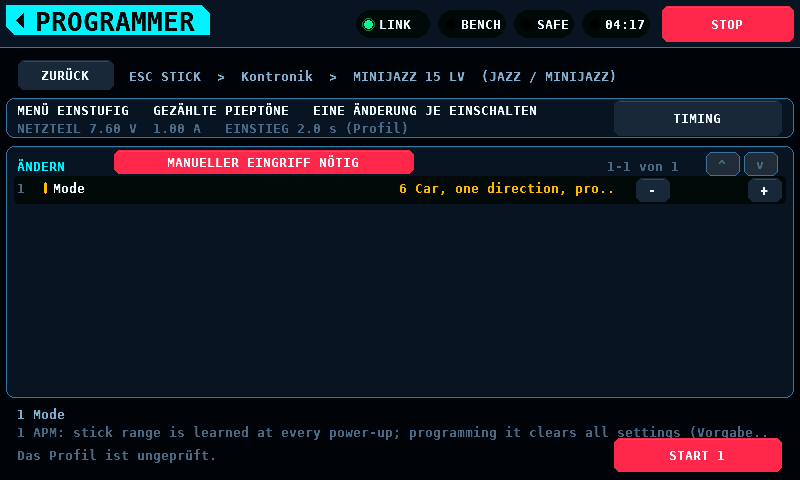
docs/img/de/programmer-stick-hand.png
