subtilitas/rcbench/docs/img/de/servo-armed.png

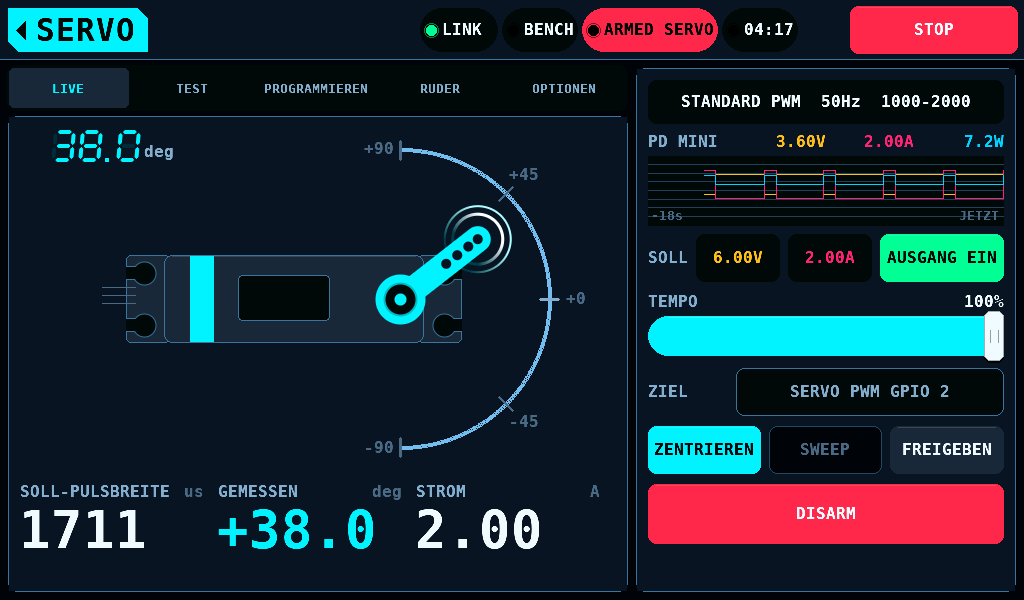
docs/img/de/servo-armed.png
