subtilitas/rcbench/docs/img/de/servo-brownout.png

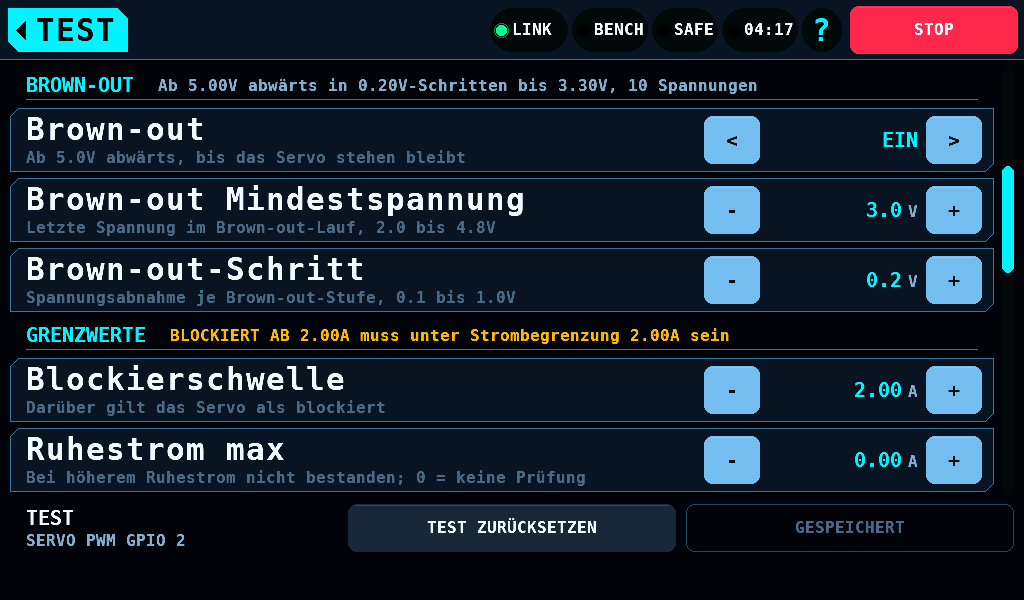
docs/img/de/servo-brownout.png
