subtilitas/rcbench/docs/img/de/servo-hitec-backup-write.png

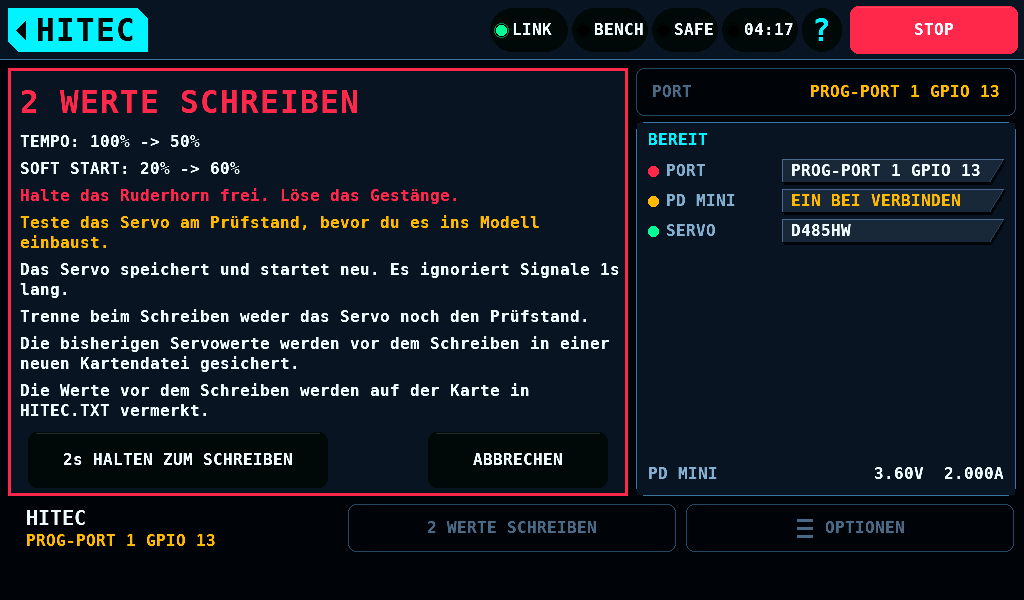
docs/img/de/servo-hitec-backup-write.png
