subtilitas/rcbench/docs/img/de/servo-hitec-classic-factory.png

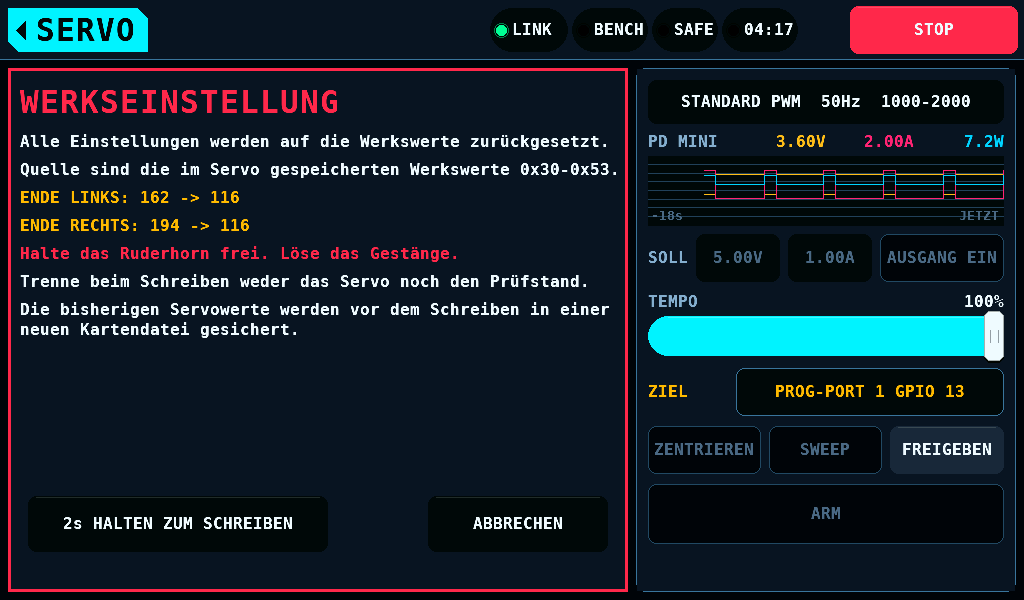
docs/img/de/servo-hitec-classic-factory.png
