subtilitas/rcbench/docs/img/de/servo-hitec-file-series.png

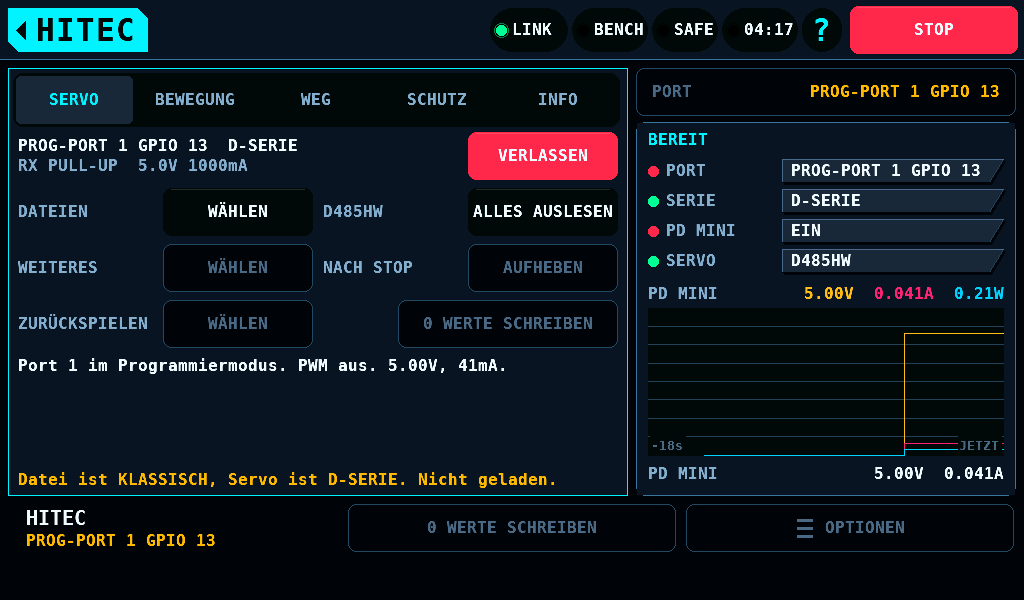
docs/img/de/servo-hitec-file-series.png
