subtilitas/rcbench/docs/img/de/servo-hitec-file-warnings-next.png

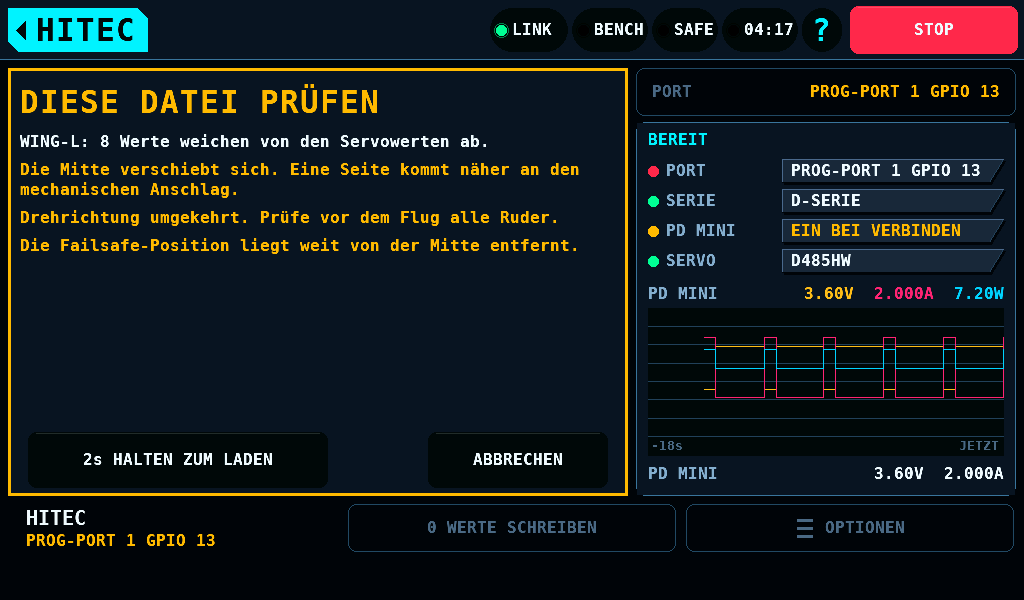
docs/img/de/servo-hitec-file-warnings-next.png
