subtilitas/rcbench/docs/img/de/servo-hitec-file-warnings.png

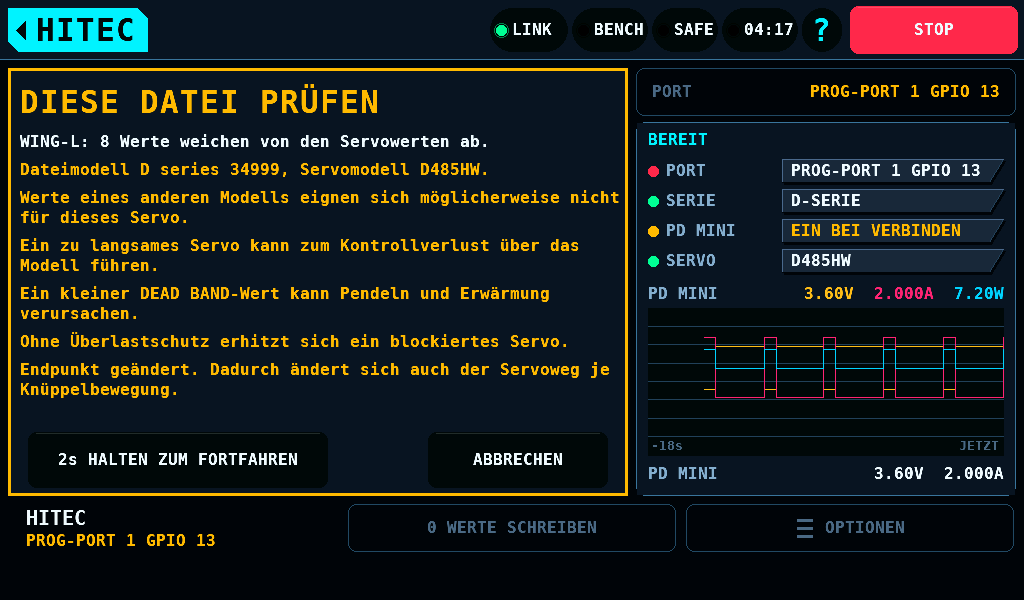
docs/img/de/servo-hitec-file-warnings.png
