subtilitas/rcbench/docs/img/de/servo-hitec-files-next.png

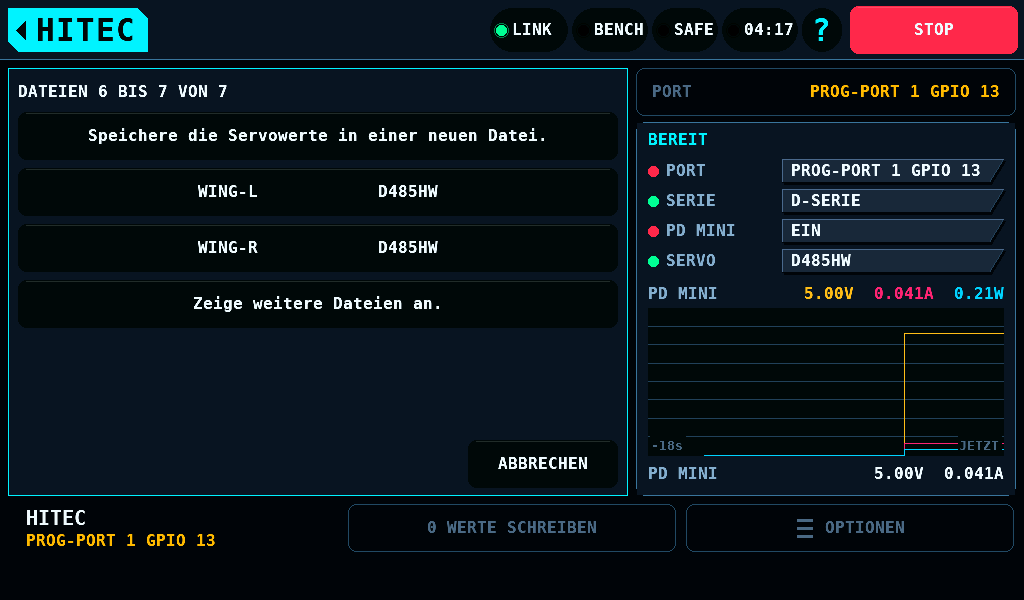
docs/img/de/servo-hitec-files-next.png
