subtilitas/rcbench/docs/img/de/servo-hitec-files-none.png

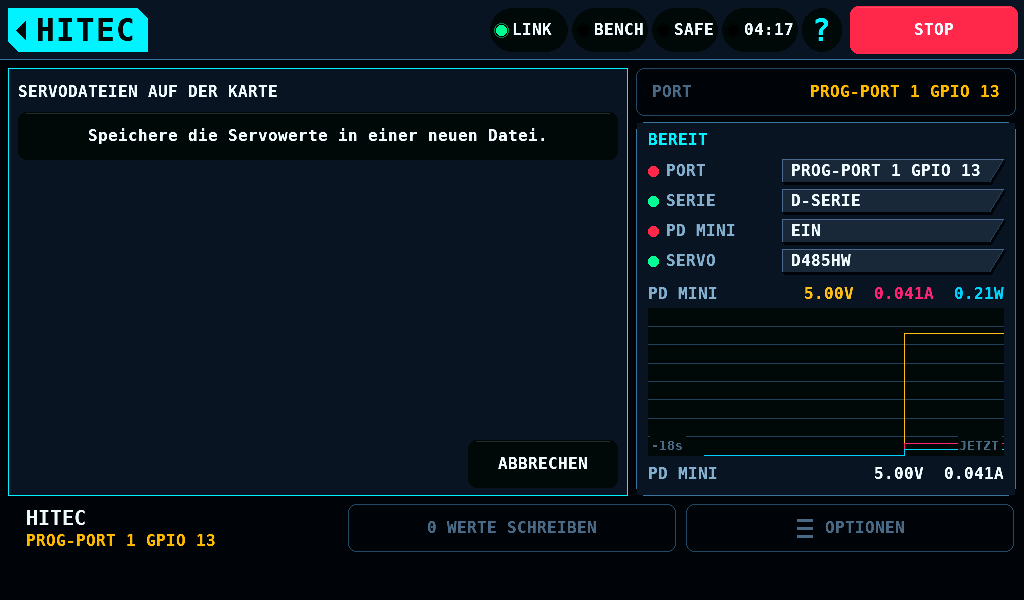
docs/img/de/servo-hitec-files-none.png
