subtilitas/rcbench/docs/img/de/servo-hitec-files.png

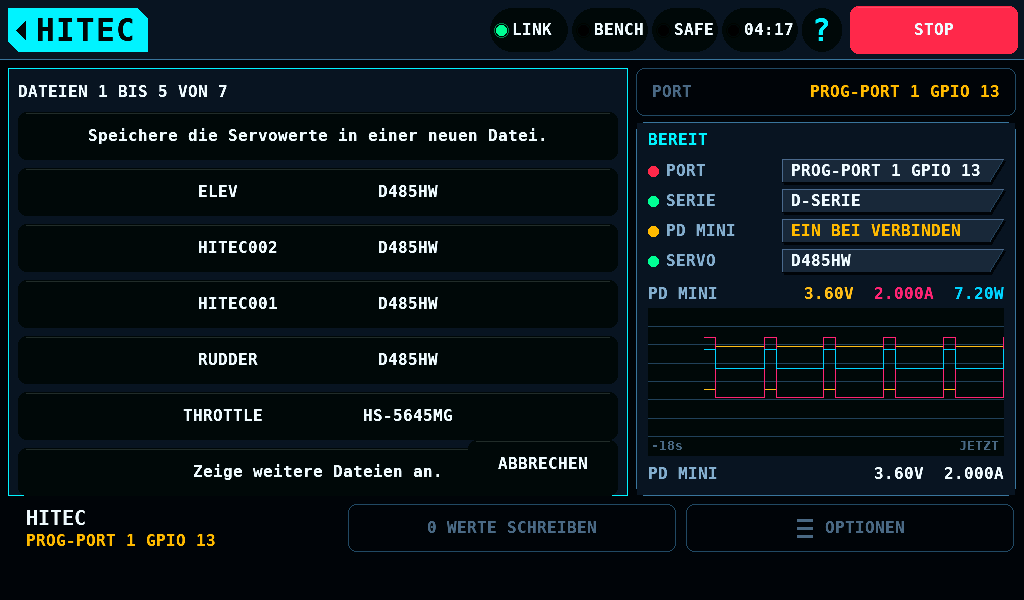
docs/img/de/servo-hitec-files.png
