subtilitas/rcbench/docs/img/de/servo-hitec-move-blocked.png

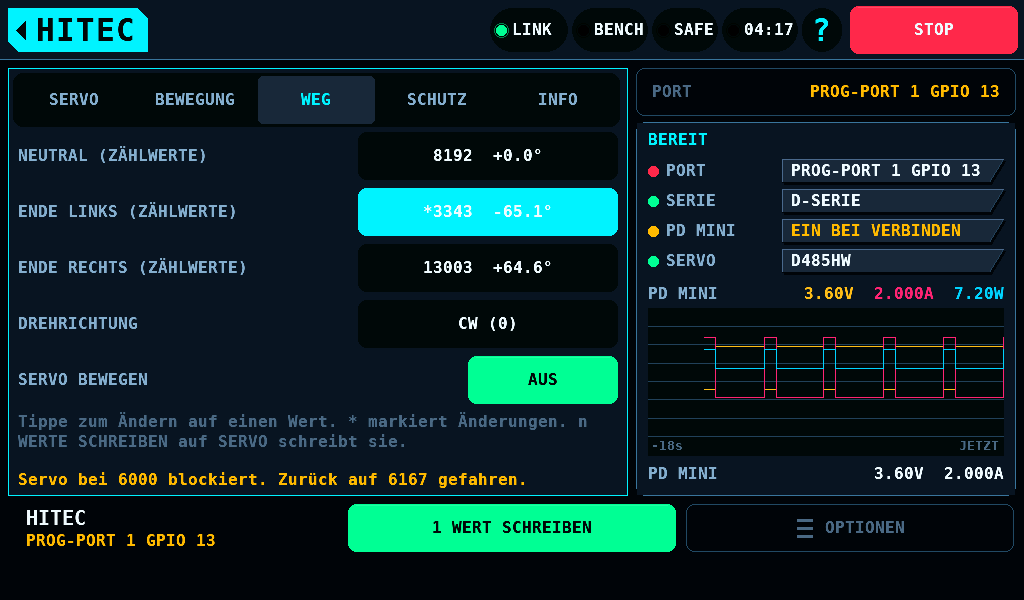
docs/img/de/servo-hitec-move-blocked.png
