subtilitas/rcbench/docs/img/de/servo-hitec-move.png

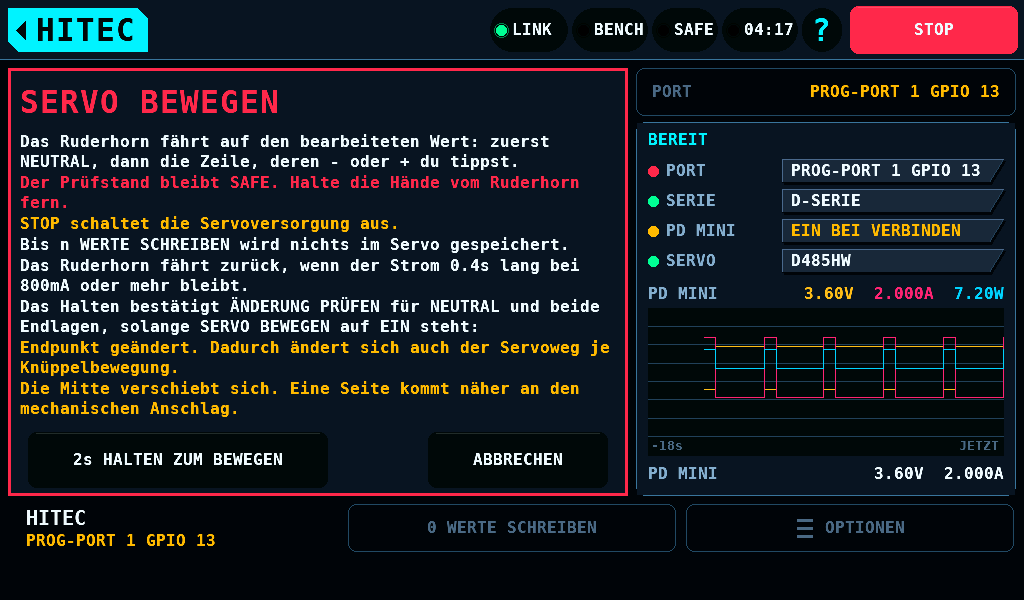
docs/img/de/servo-hitec-move.png
