subtilitas/rcbench/docs/img/de/servo-hitec-release.png

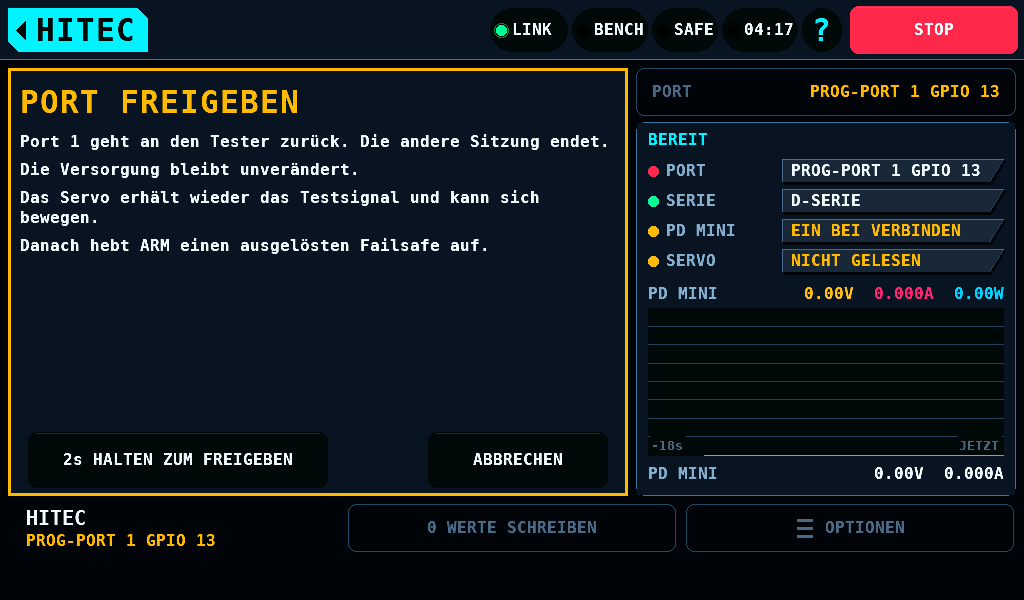
docs/img/de/servo-hitec-release.png
