subtilitas/rcbench/docs/img/de/servo-hitec-restore-hv.png

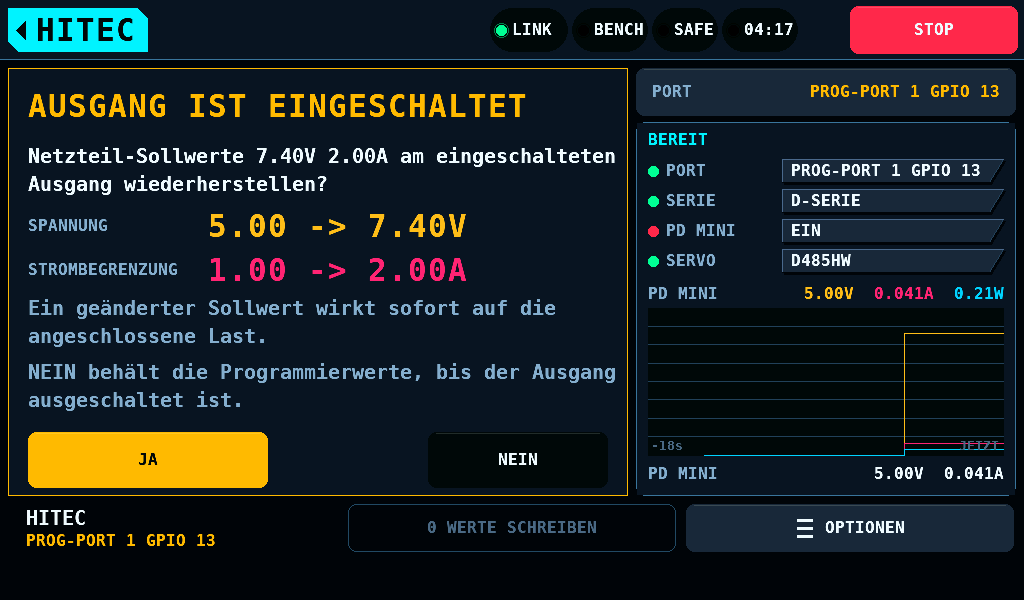
docs/img/de/servo-hitec-restore-hv.png
