subtilitas/rcbench/docs/img/de/servo-hitec-rx.png

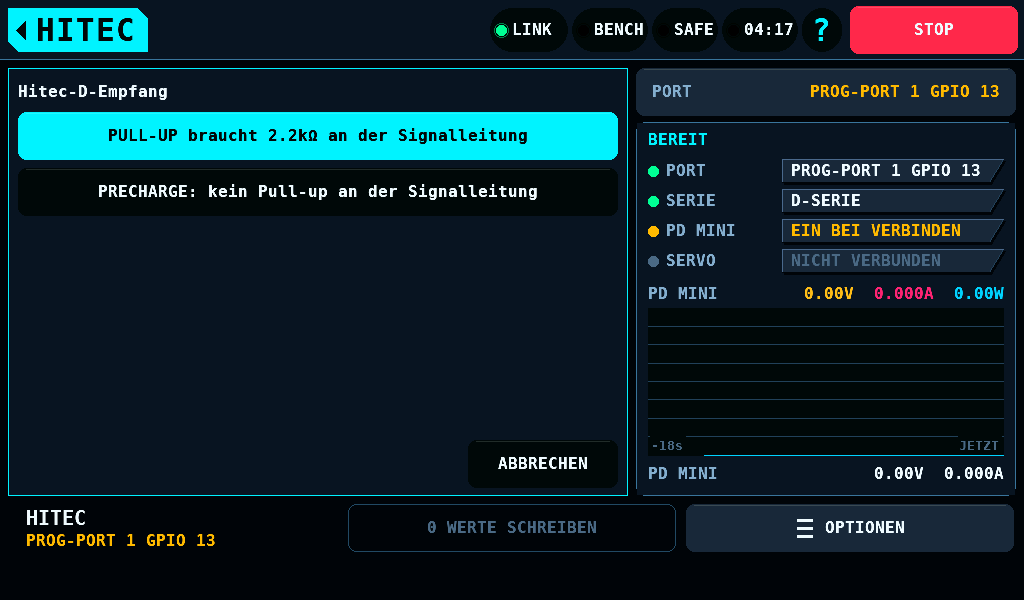
docs/img/de/servo-hitec-rx.png
