subtilitas/rcbench/docs/img/de/servo-hitec-soft.png

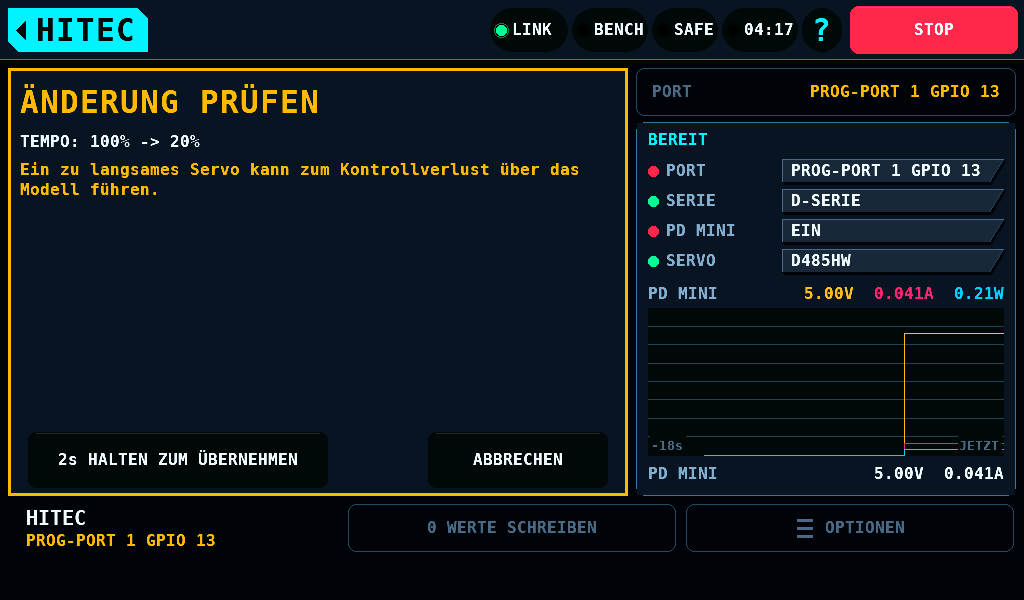
docs/img/de/servo-hitec-soft.png
