subtilitas/rcbench/docs/img/de/servo-hitec-write.png

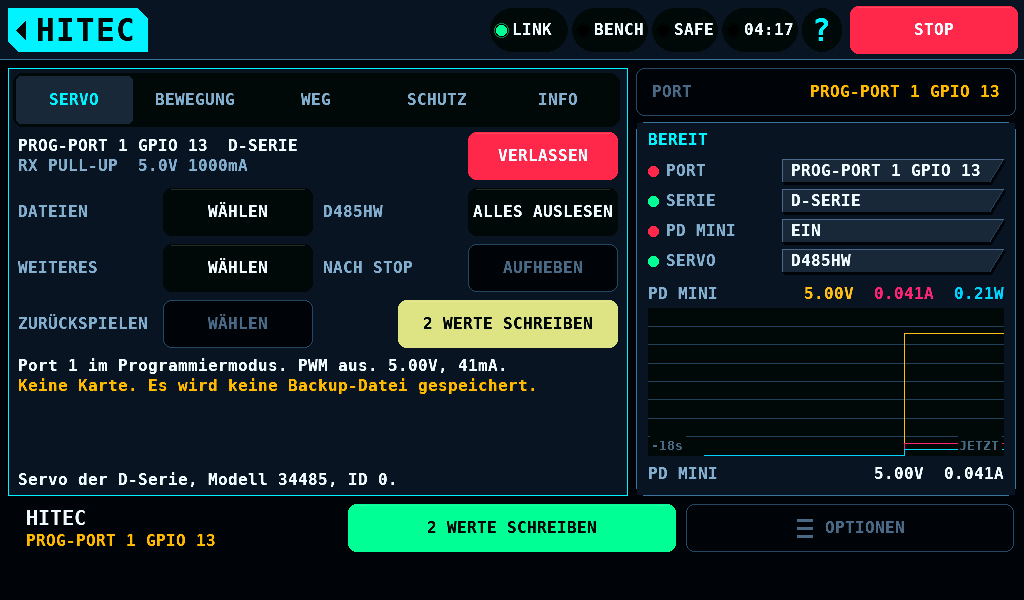
docs/img/de/servo-hitec-write.png
