subtilitas/rcbench/docs/img/de/servo-hitec.png

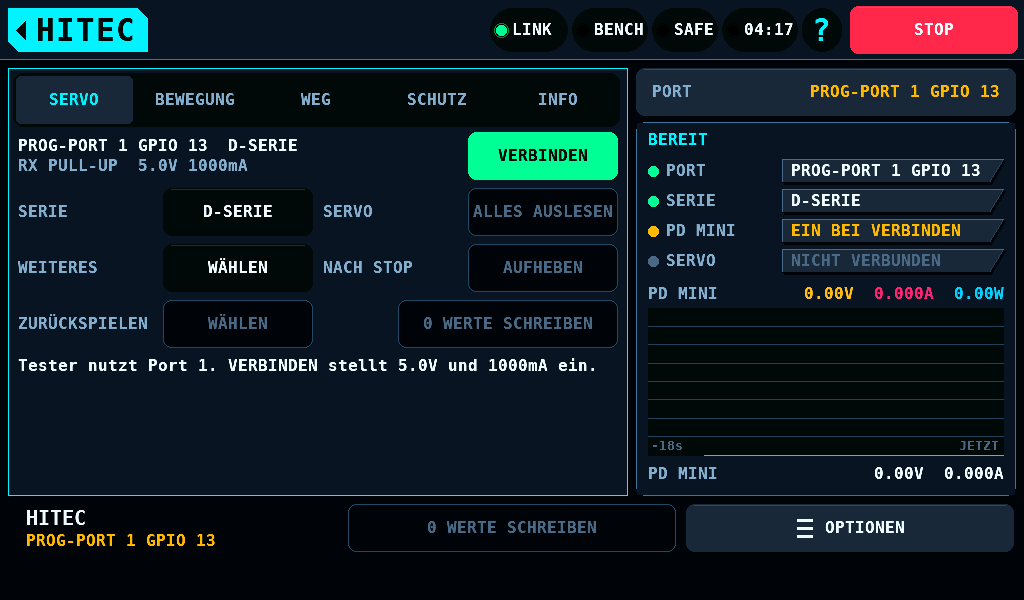
docs/img/de/servo-hitec.png
