subtilitas/rcbench/docs/img/de/servo-hub-busy.png

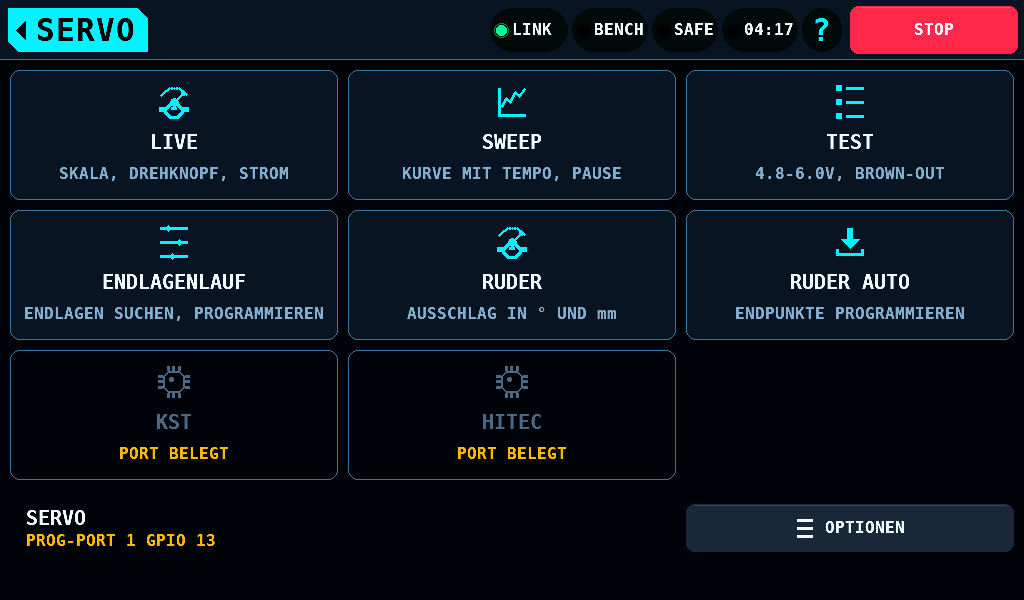
docs/img/de/servo-hub-busy.png
