subtilitas/rcbench/docs/img/de/servo-hub-nocap.png

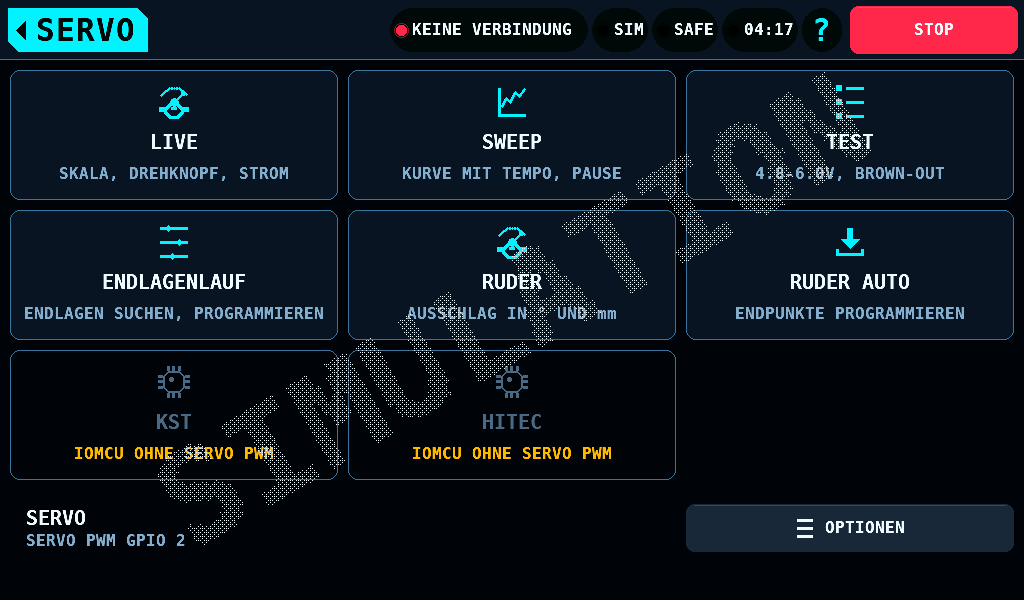
docs/img/de/servo-hub-nocap.png
