subtilitas/rcbench/docs/img/de/servo-kst-card-full.png

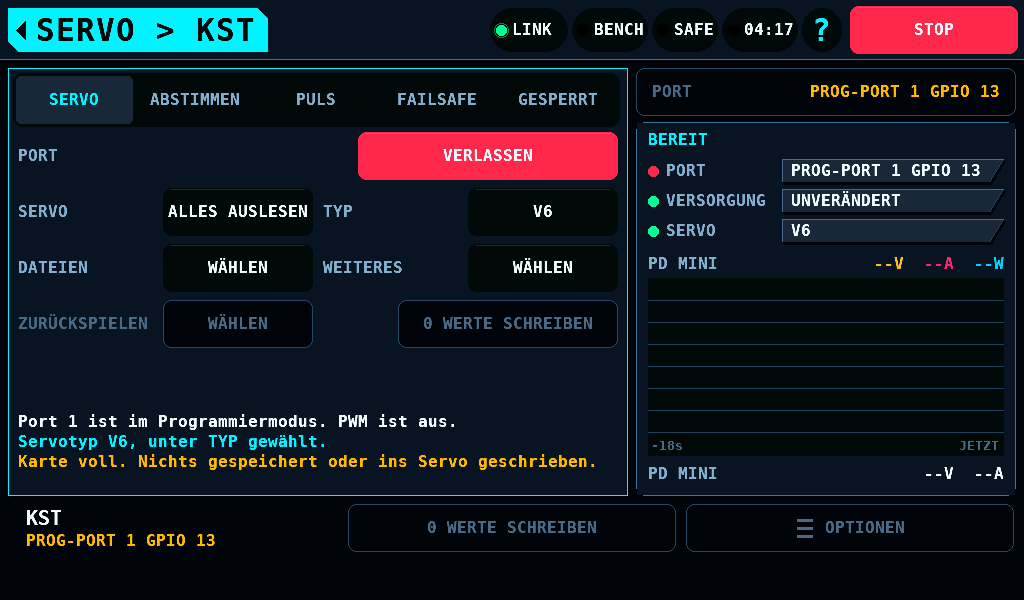
docs/img/de/servo-kst-card-full.png
