subtilitas/rcbench/docs/img/de/servo-kst-doubt.png

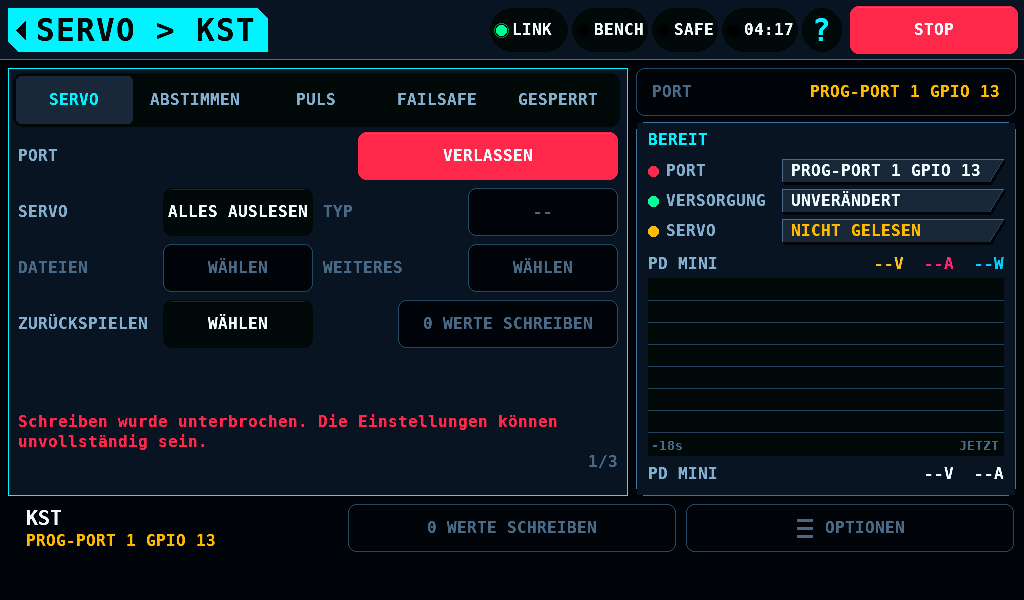
docs/img/de/servo-kst-doubt.png
