subtilitas/rcbench/docs/img/de/servo-kst-enable.png

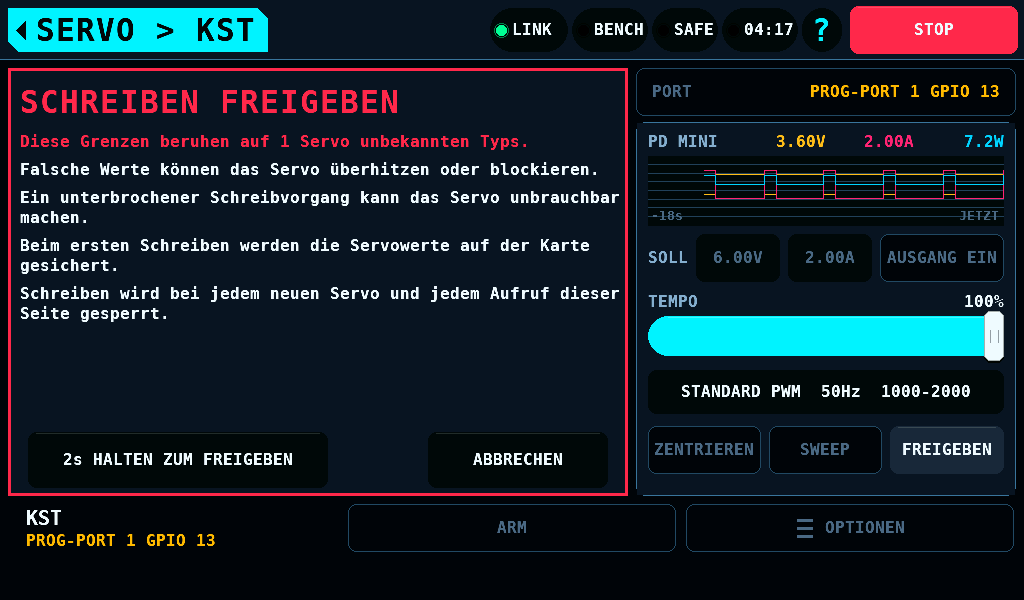
docs/img/de/servo-kst-enable.png
