subtilitas/rcbench/docs/img/de/servo-kst-file-damaged.png

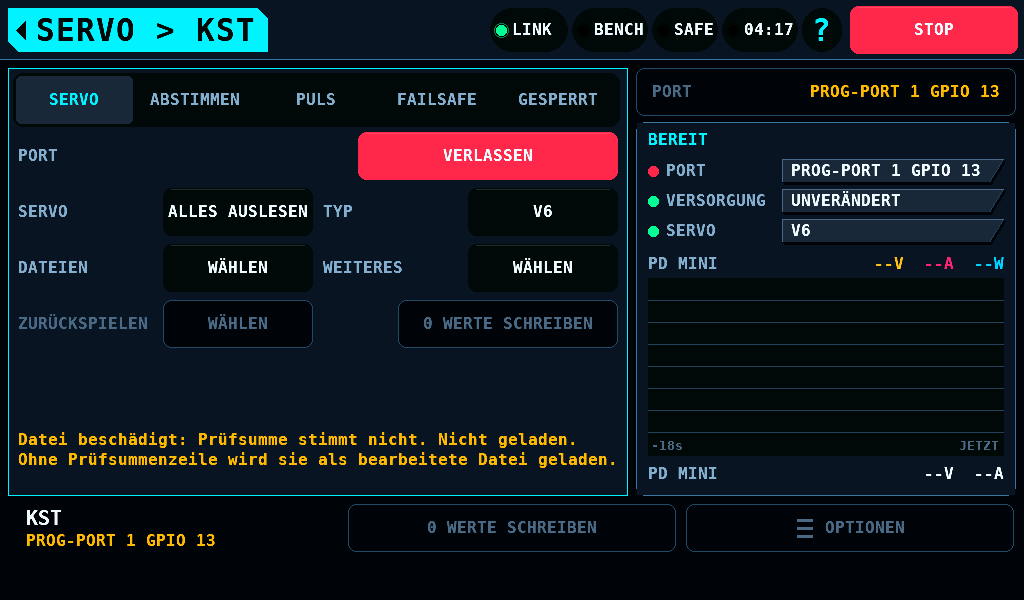
docs/img/de/servo-kst-file-damaged.png
