subtilitas/rcbench/docs/img/de/servo-kst-file-soft.png

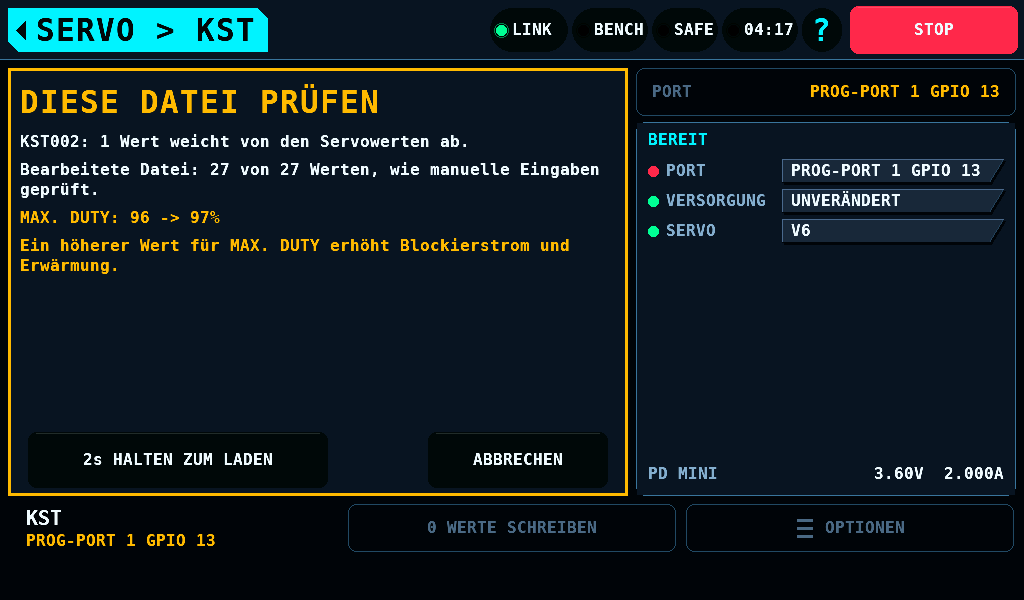
docs/img/de/servo-kst-file-soft.png
