subtilitas/rcbench/docs/img/de/servo-kst-file-type.png

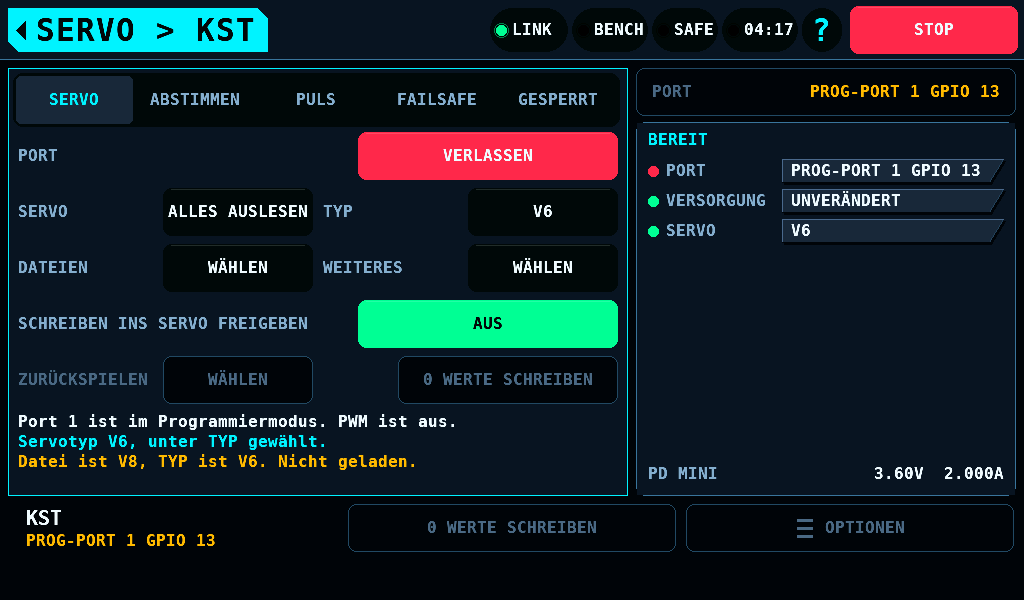
docs/img/de/servo-kst-file-type.png
