subtilitas/rcbench/docs/img/de/servo-kst-file-untyped.png

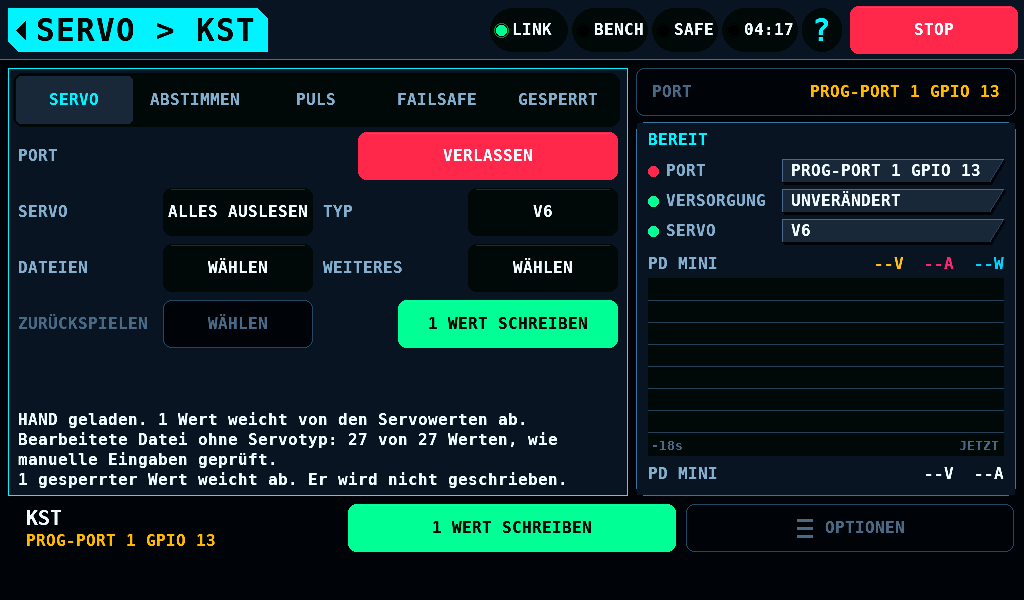
docs/img/de/servo-kst-file-untyped.png
