subtilitas/rcbench/docs/img/de/servo-kst-file-v6.png

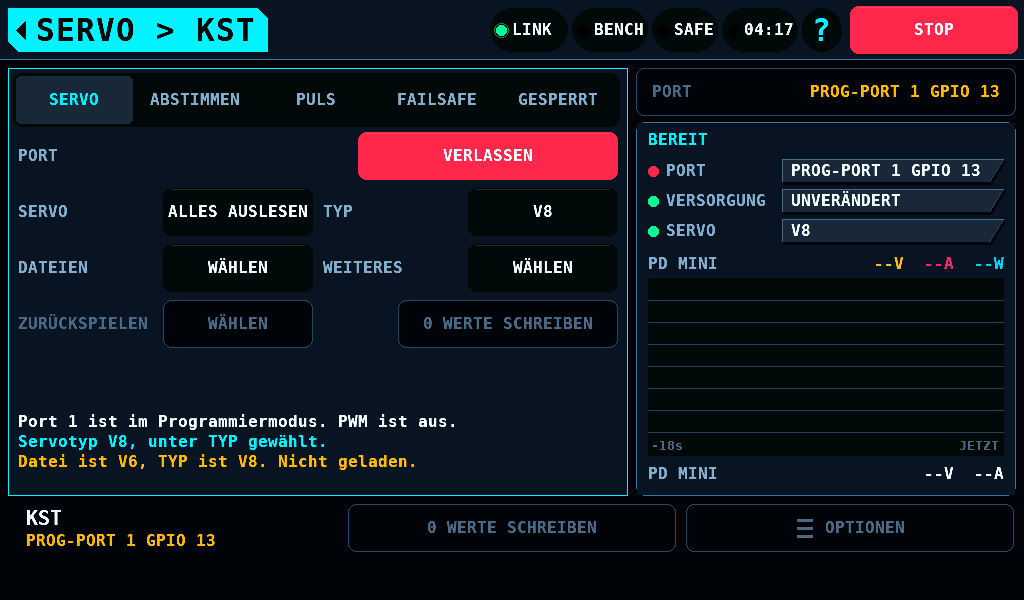
docs/img/de/servo-kst-file-v6.png
