subtilitas/rcbench/docs/img/de/servo-kst-files-none.png

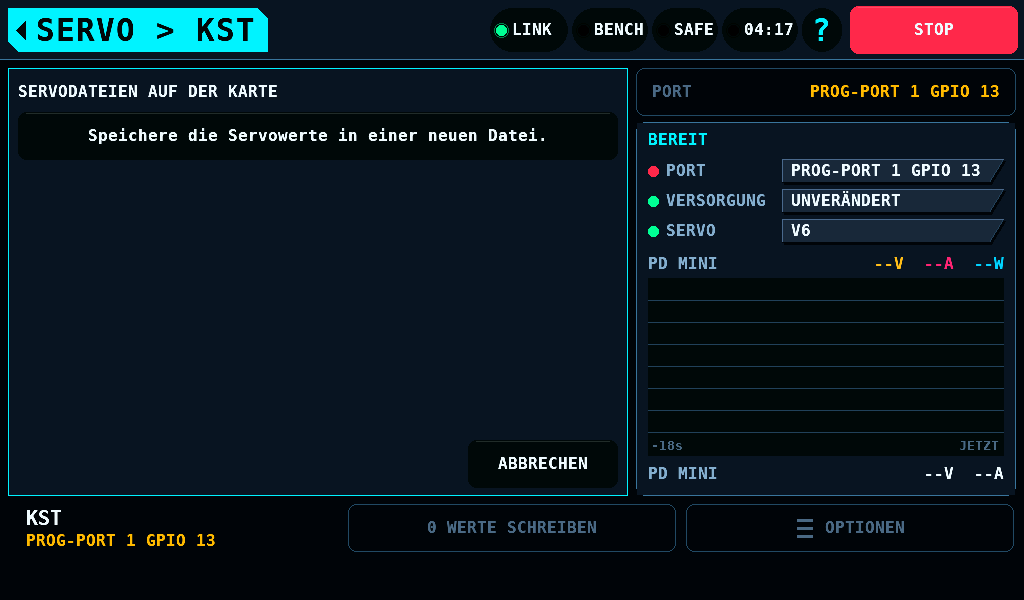
docs/img/de/servo-kst-files-none.png
