subtilitas/rcbench/docs/img/de/servo-kst-leave-expert-off.png

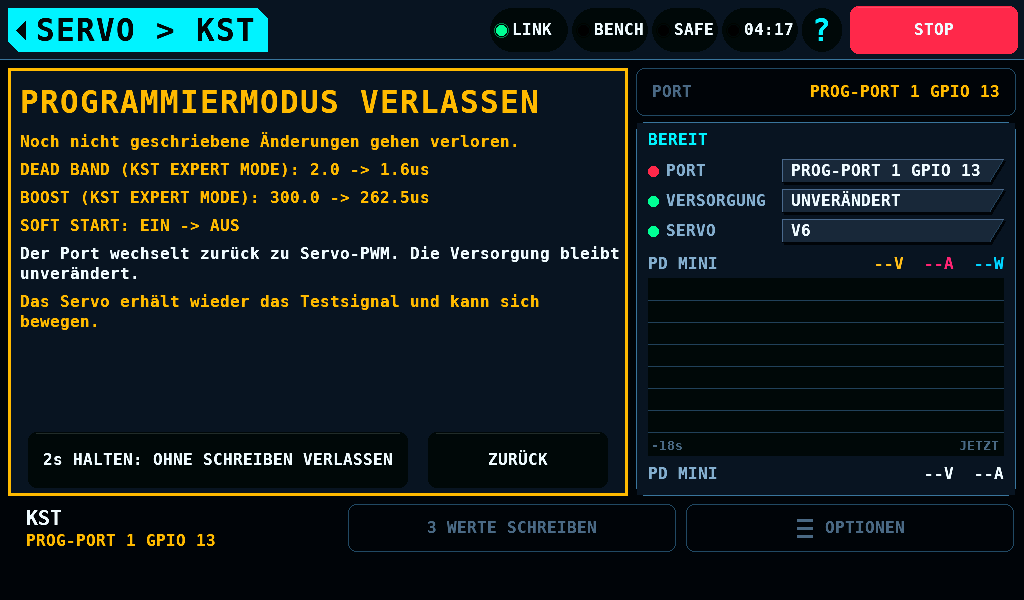
docs/img/de/servo-kst-leave-expert-off.png
