subtilitas/rcbench/docs/img/de/servo-kst-name-exists.png

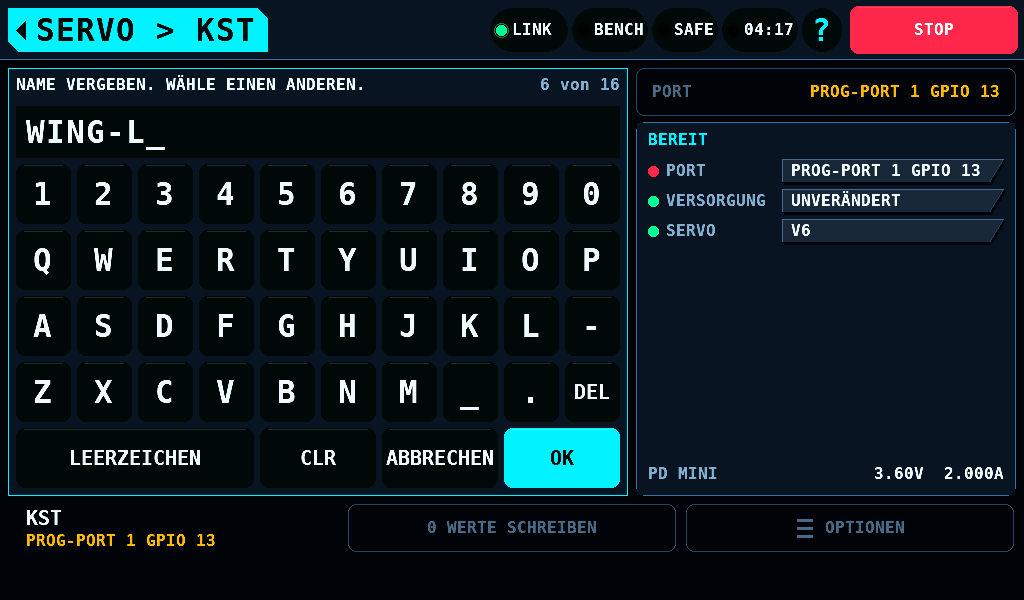
docs/img/de/servo-kst-name-exists.png
