subtilitas/rcbench/docs/img/de/servo-kst-nofile.png

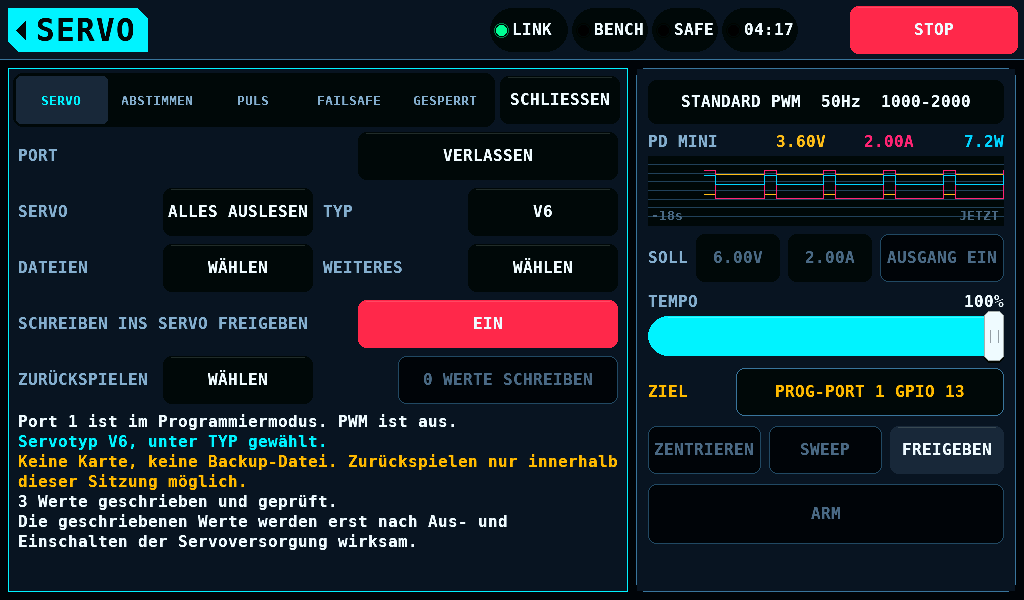
docs/img/de/servo-kst-nofile.png
