subtilitas/rcbench/docs/img/de/servo-kst-rbmod-input.png

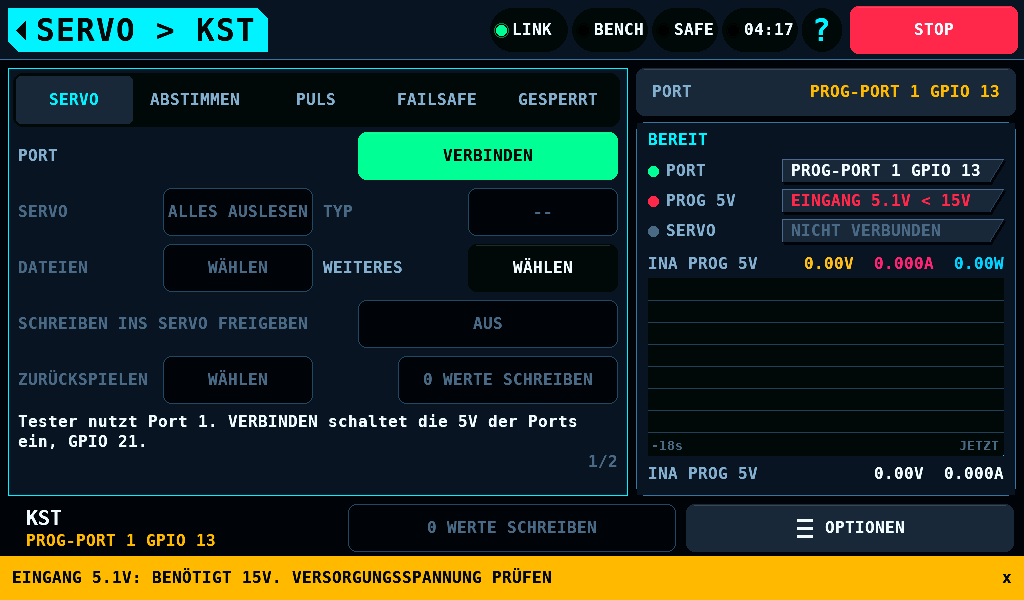
docs/img/de/servo-kst-rbmod-input.png
