subtilitas/rcbench/docs/img/de/servo-kst-rbmod.png

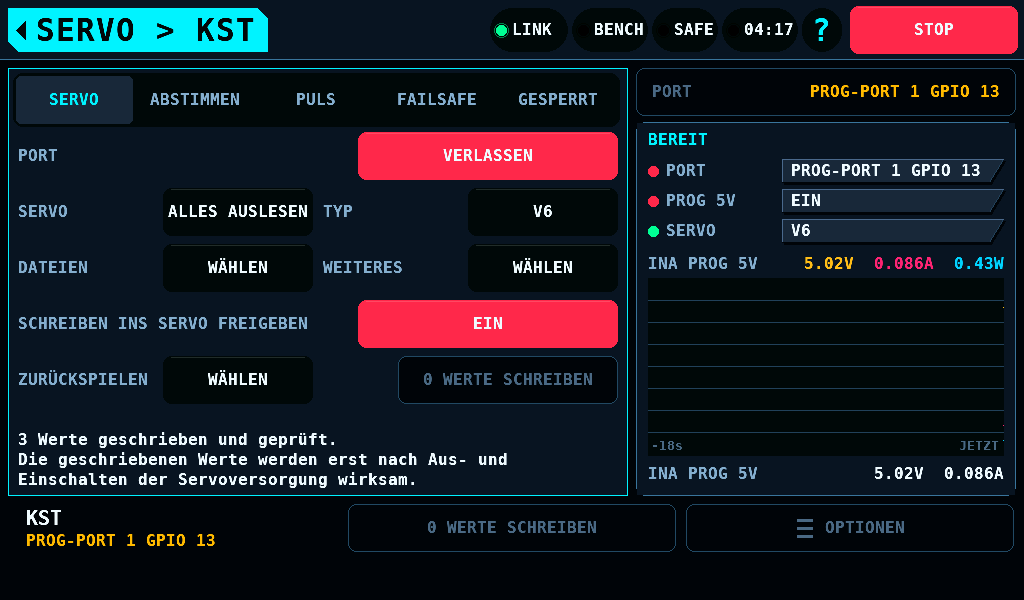
docs/img/de/servo-kst-rbmod.png
