subtilitas/rcbench/docs/img/de/servo-kst-restore-check.png

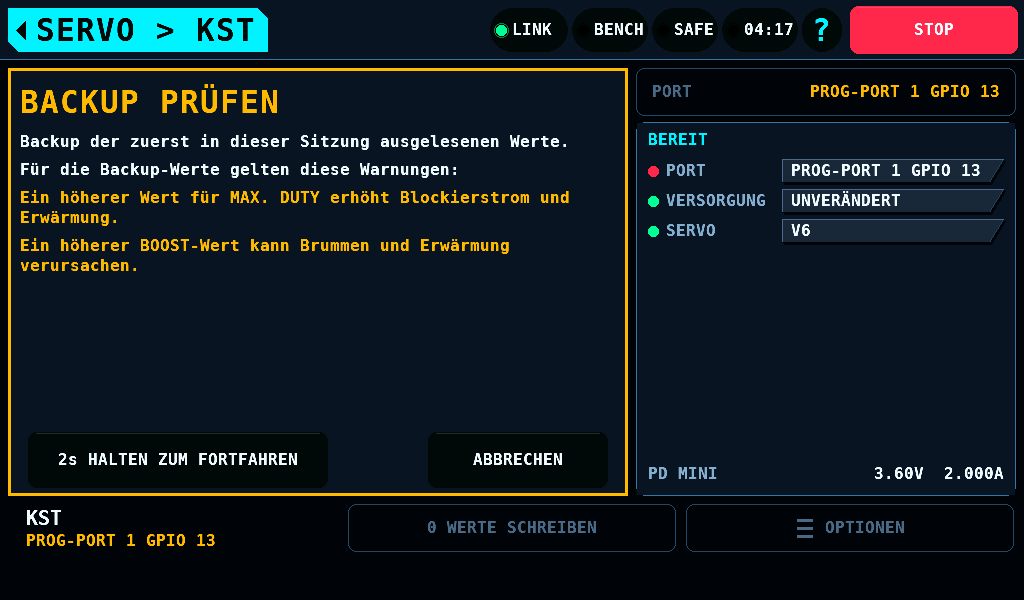
docs/img/de/servo-kst-restore-check.png
