subtilitas/rcbench/docs/img/de/servo-kst-supply.png

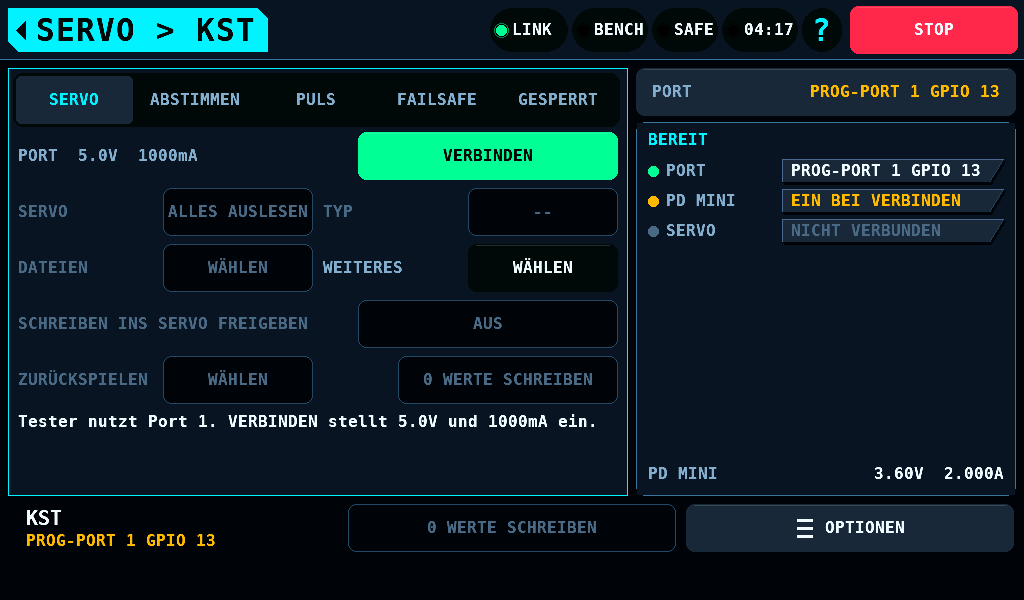
docs/img/de/servo-kst-supply.png
