subtilitas/rcbench/docs/img/de/servo-kst-write.png

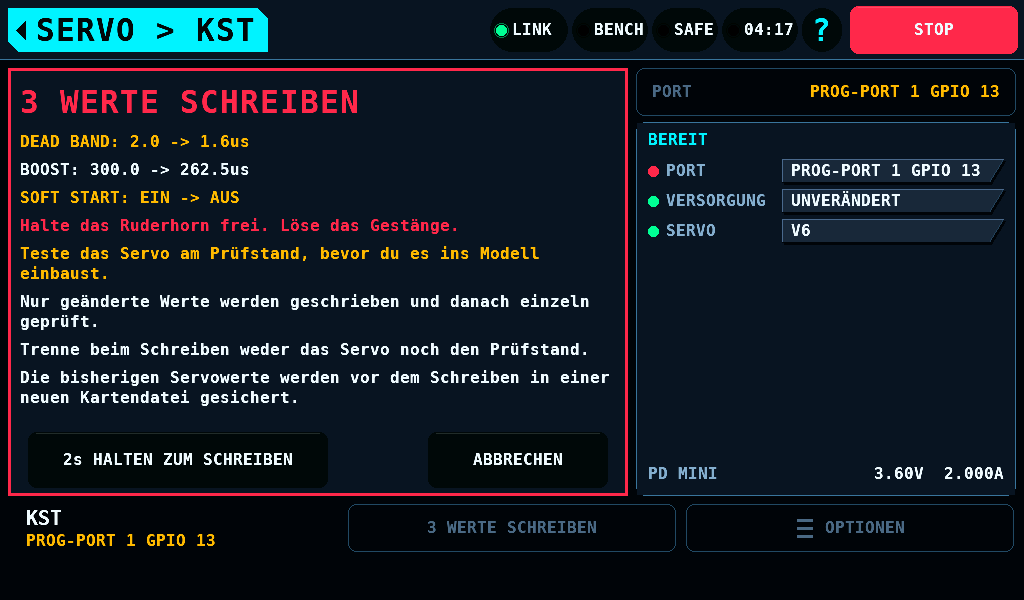
docs/img/de/servo-kst-write.png
