subtilitas/rcbench/docs/img/de/servo-kst.png

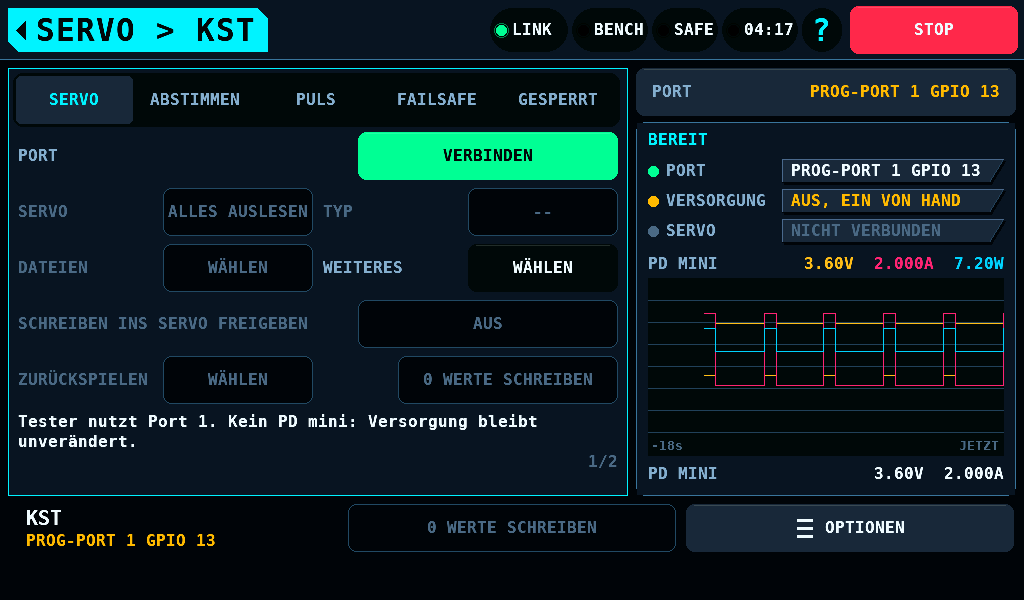
docs/img/de/servo-kst.png
