subtilitas/rcbench/docs/img/de/servo-limrun-restore.png

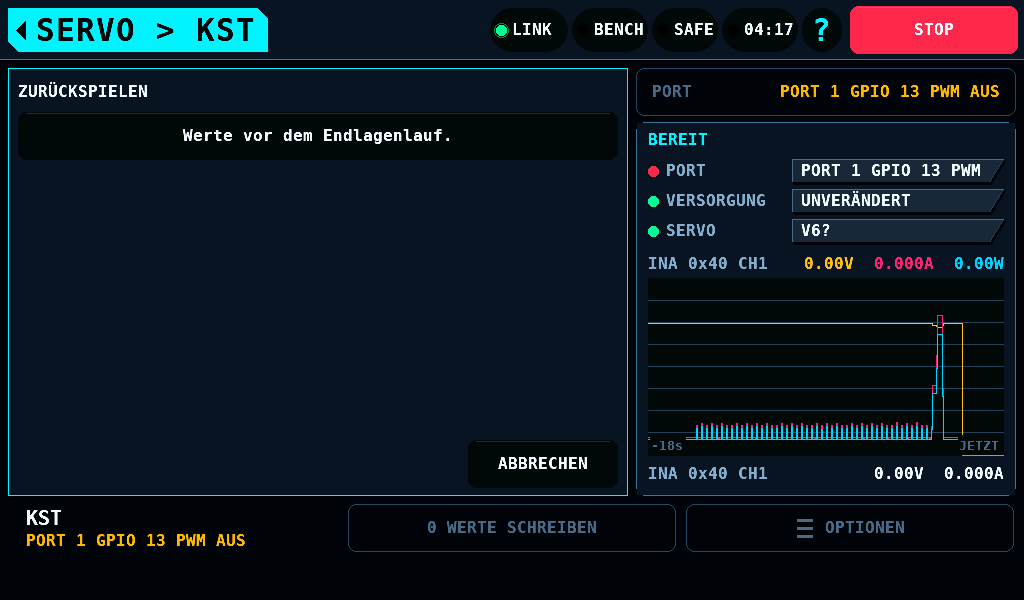
docs/img/de/servo-limrun-restore.png
