subtilitas/rcbench/docs/img/de/servo-limrun.png

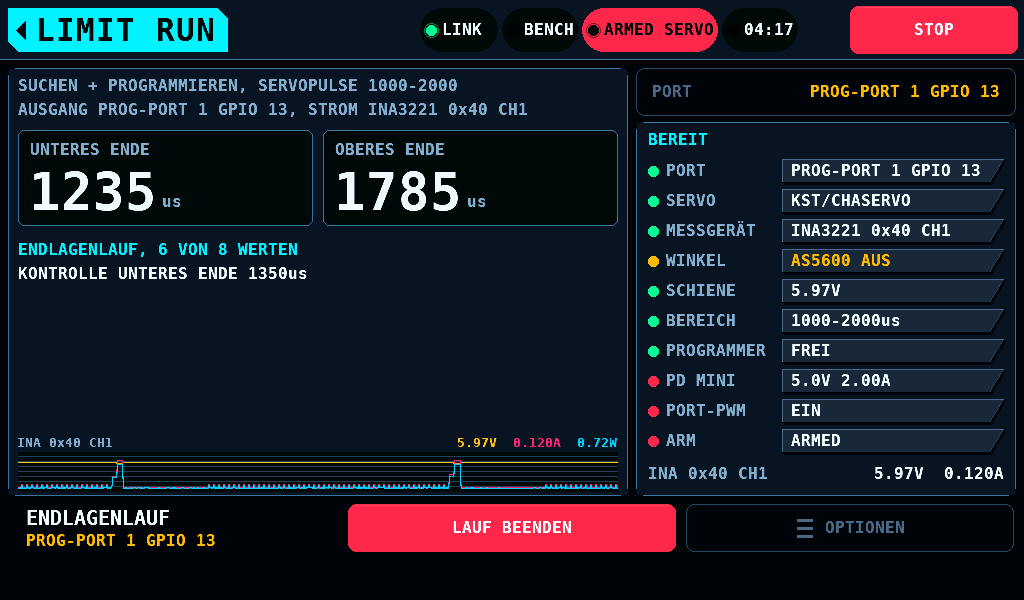
docs/img/de/servo-limrun.png
