subtilitas/rcbench/docs/img/de/servo-port-rbmod.png

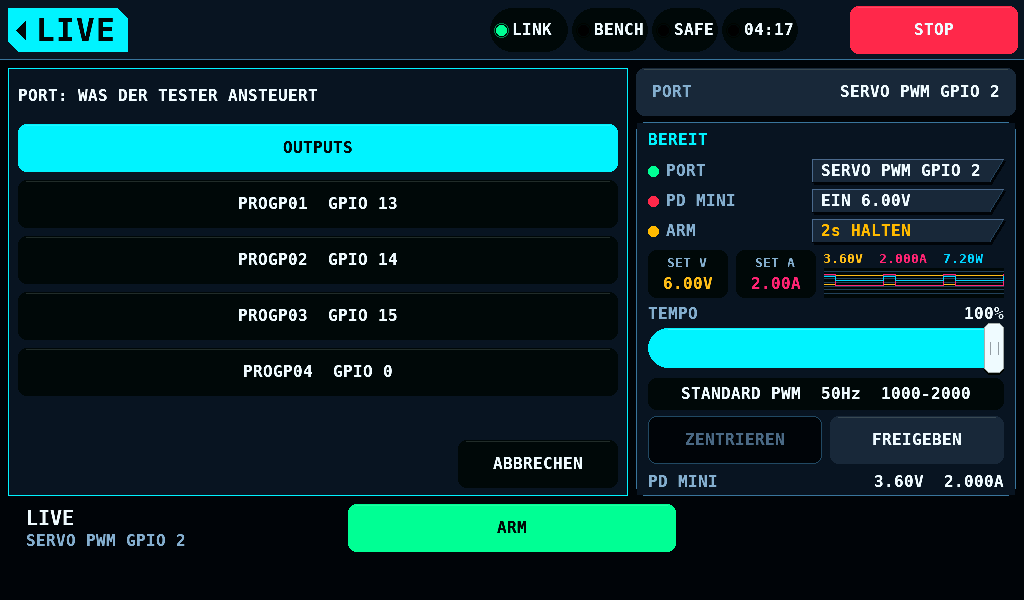
docs/img/de/servo-port-rbmod.png
