subtilitas/rcbench/docs/img/de/servo-program-nocap.png

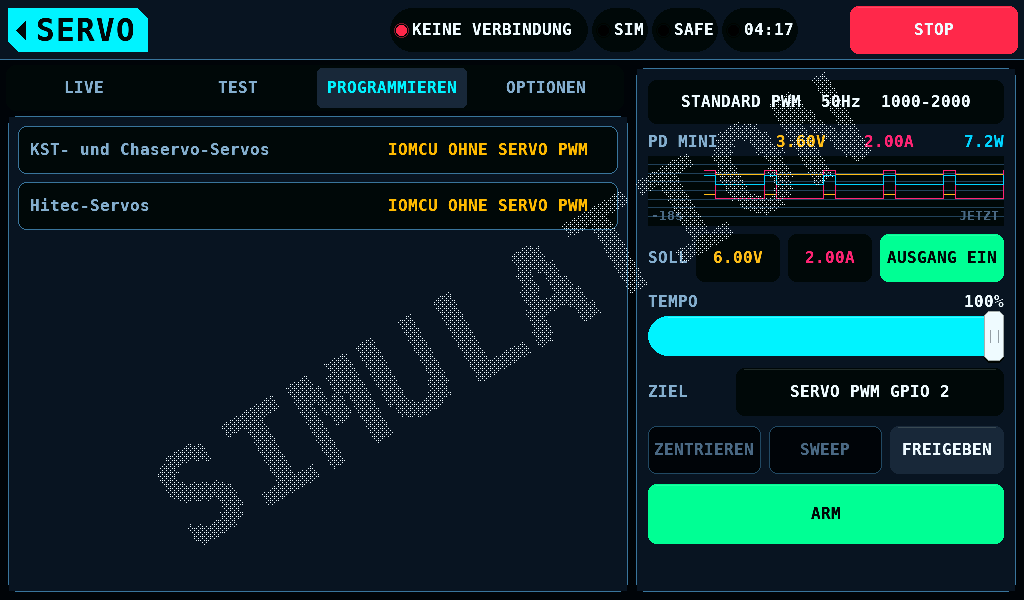
docs/img/de/servo-program-nocap.png
