subtilitas/rcbench/docs/img/de/servo-rbmod.png

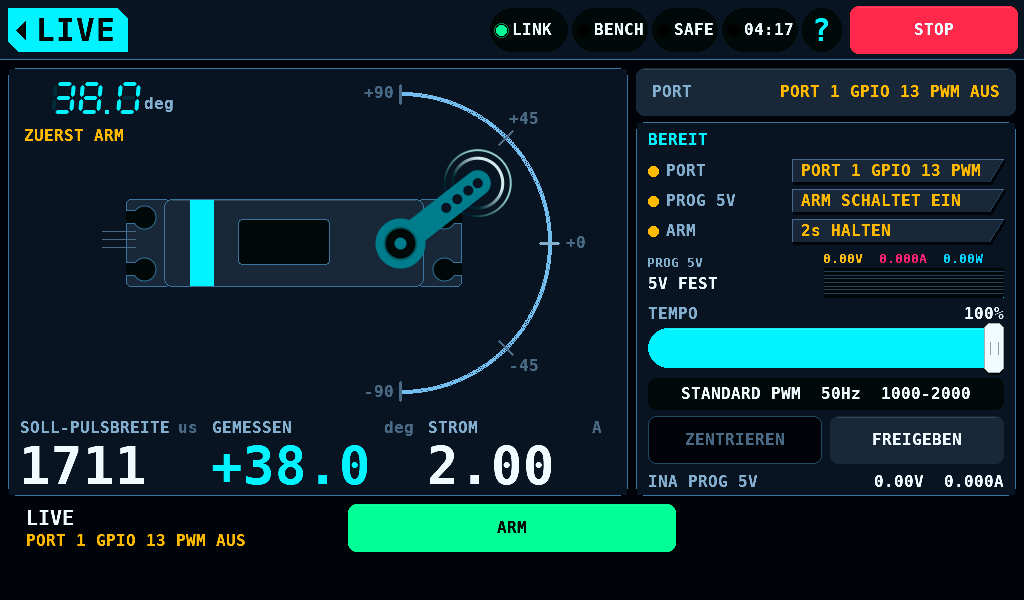
docs/img/de/servo-rbmod.png
