subtilitas/rcbench/docs/img/de/servo-rudder-auto-settings.png

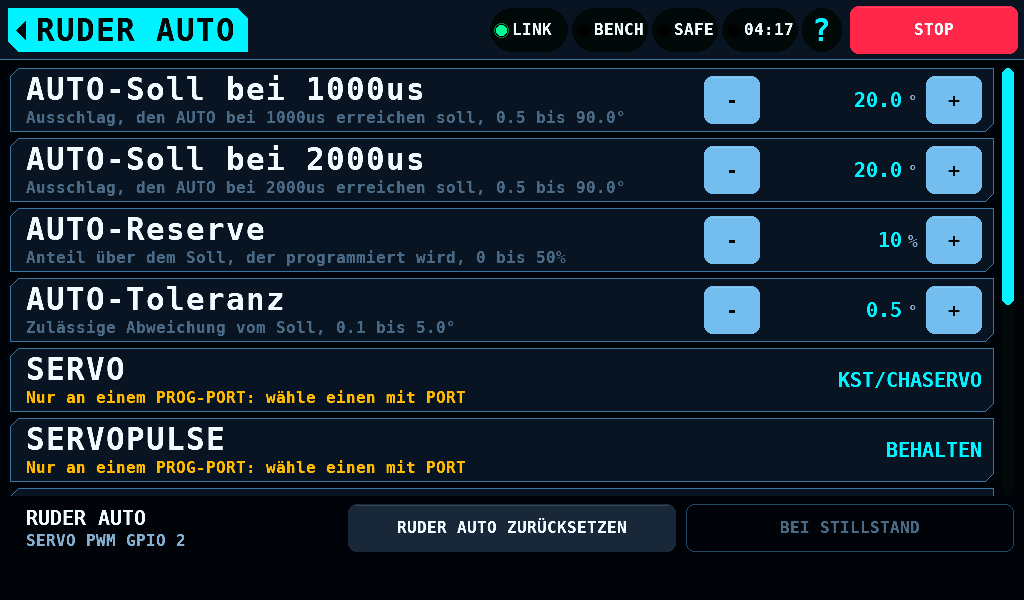
docs/img/de/servo-rudder-auto-settings.png
