subtilitas/rcbench/docs/img/de/servo-rudder-nolength.png

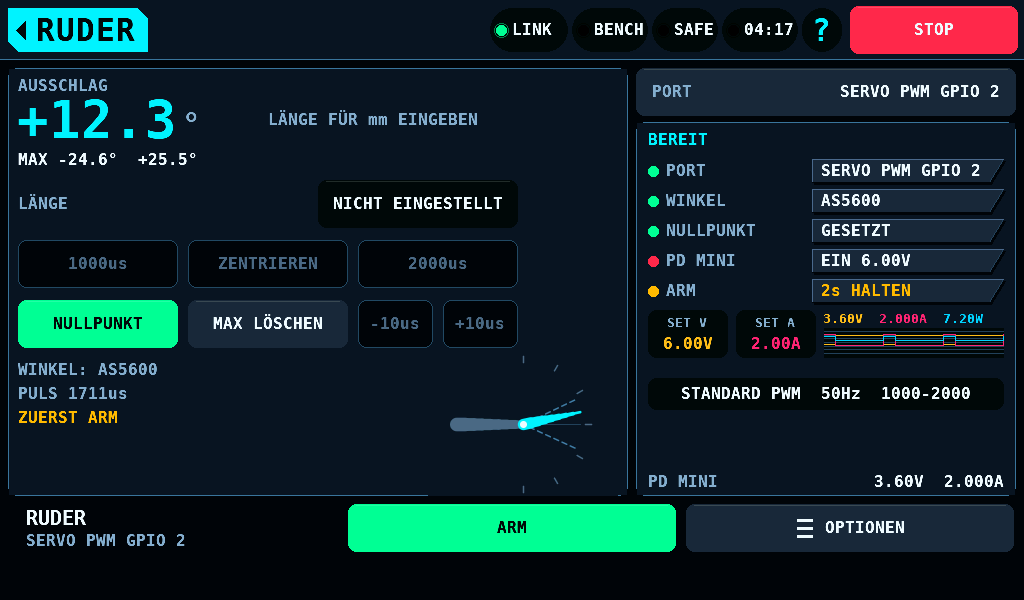
docs/img/de/servo-rudder-nolength.png
