subtilitas/rcbench/docs/img/de/servo-sweep.png

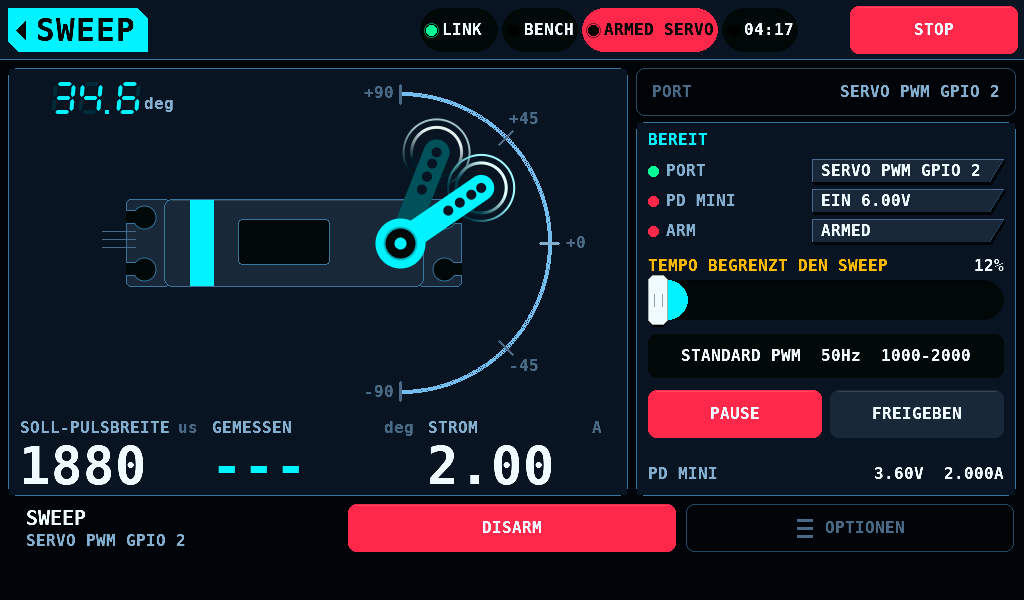
docs/img/de/servo-sweep.png
