subtilitas/rcbench/docs/img/de/servo-trim-keypad.png

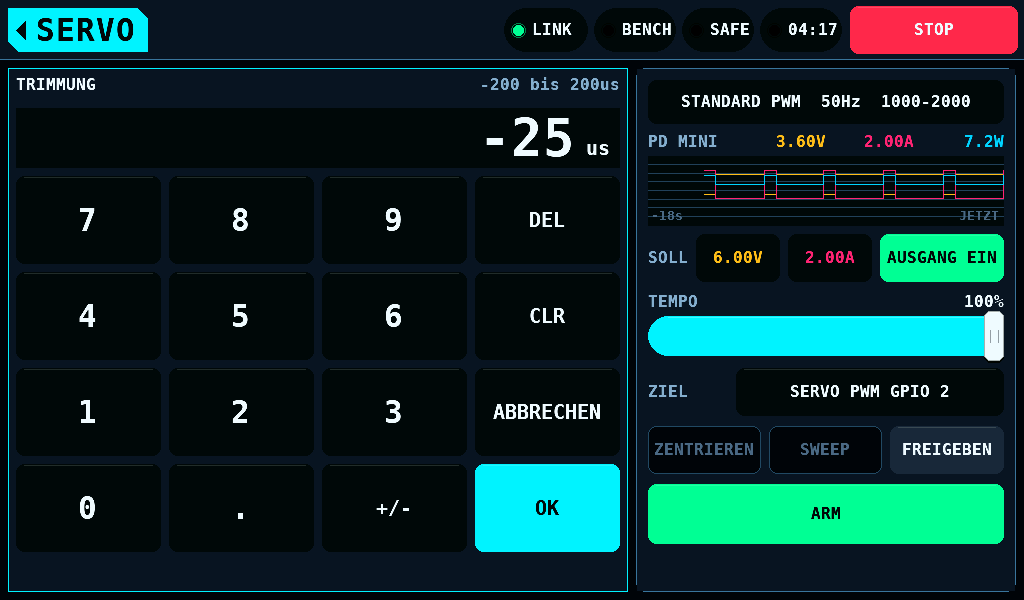
docs/img/de/servo-trim-keypad.png
