subtilitas/rcbench/docs/img/de/servo.png

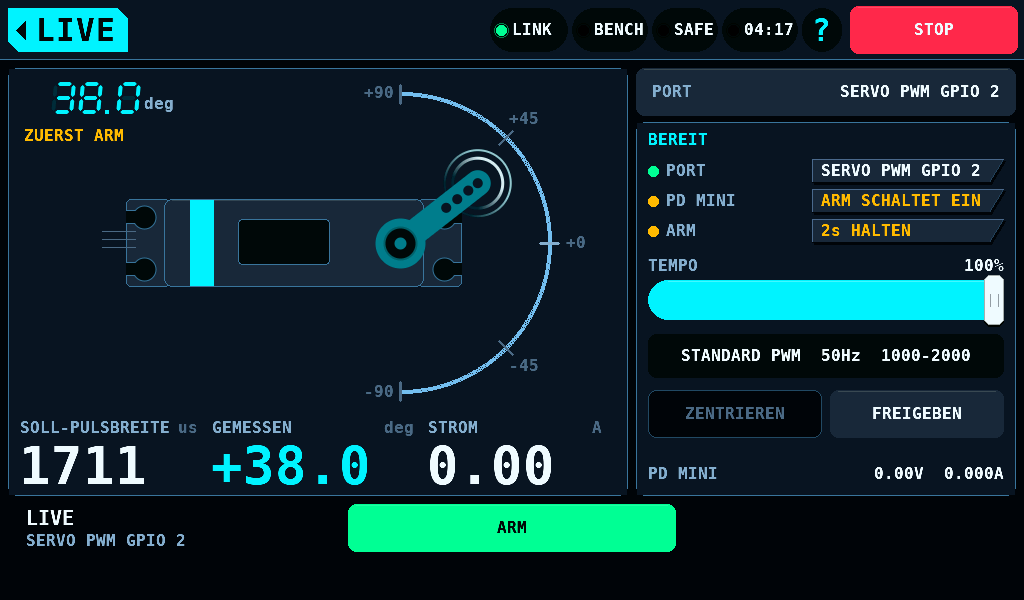
docs/img/de/servo.png
