subtilitas/rcbench/docs/img/de/supply-offline.png

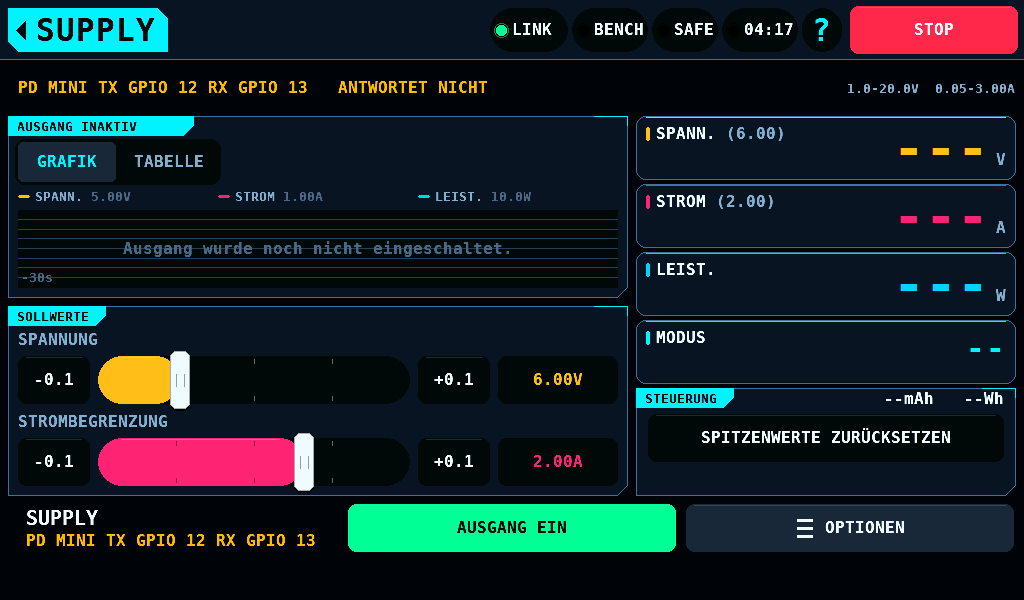
docs/img/de/supply-offline.png
