subtilitas/rcbench/docs/img/de/supply-pdmini-rbmod.png

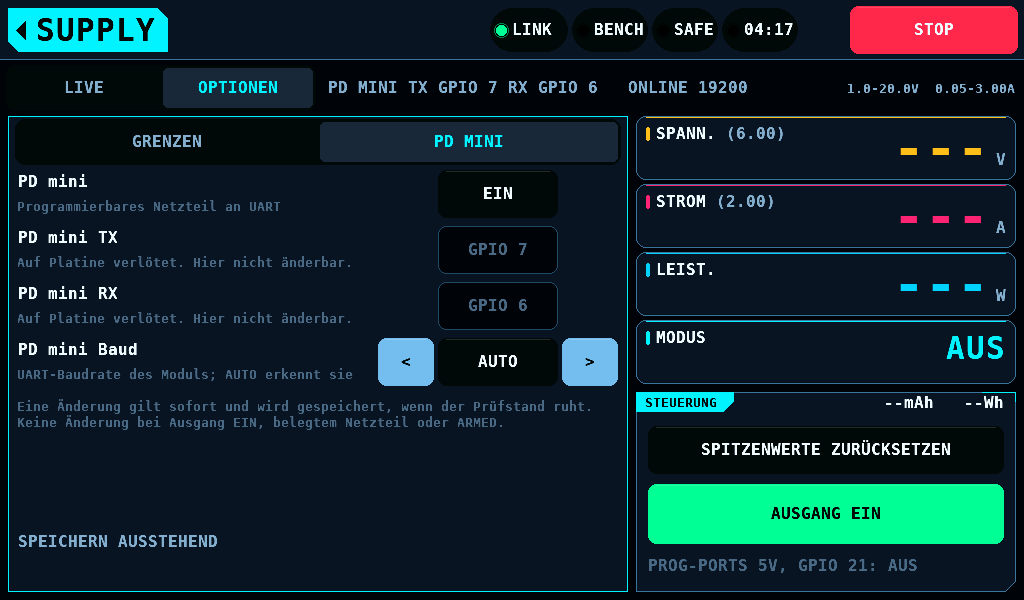
docs/img/de/supply-pdmini-rbmod.png
