subtilitas/rcbench/docs/img/de/supply-pdmini-why.png

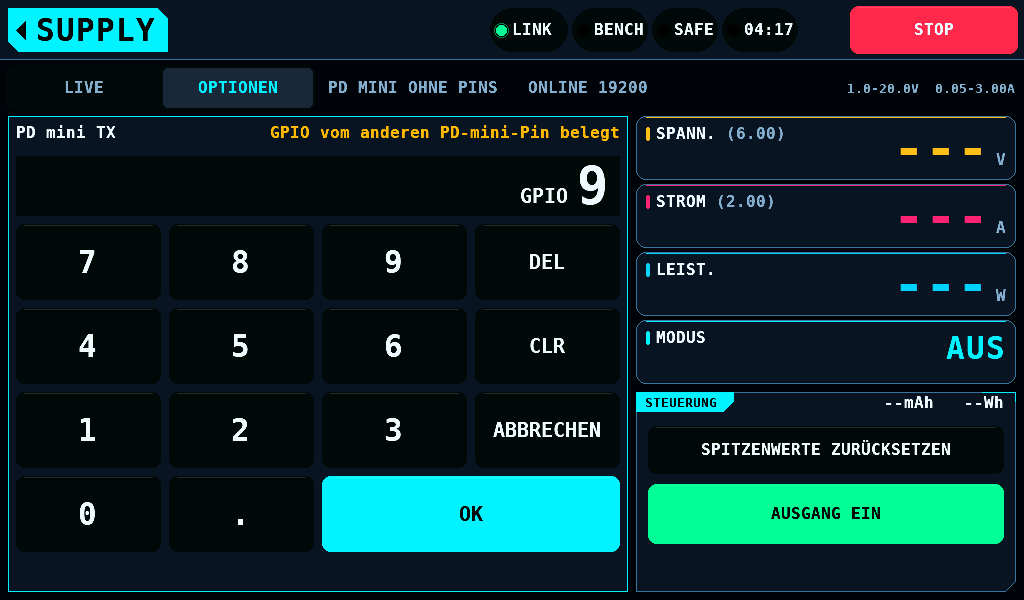
docs/img/de/supply-pdmini-why.png
