subtilitas/rcbench/docs/img/de/supply-rbmod.png

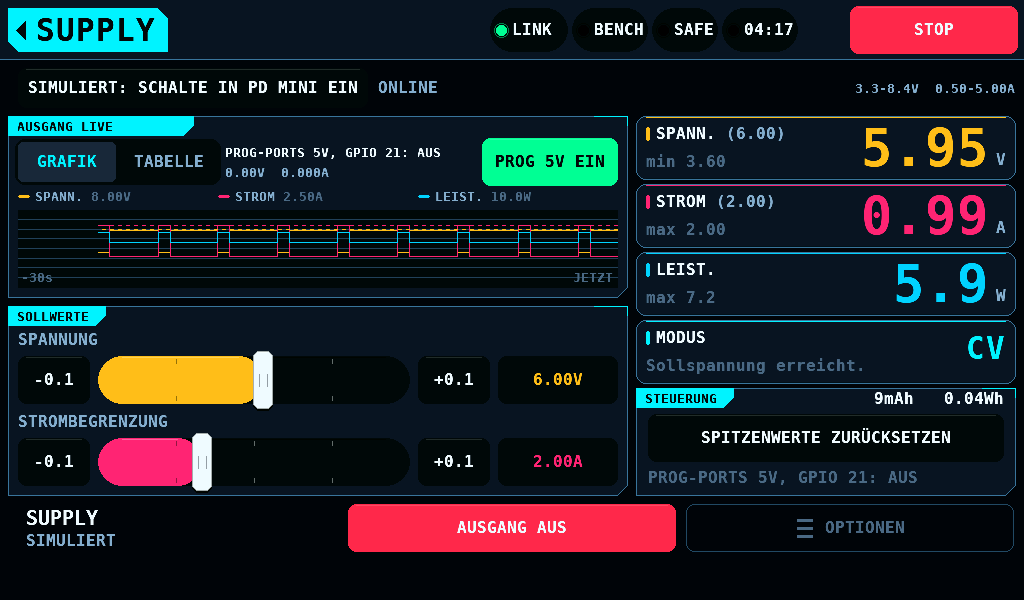
docs/img/de/supply-rbmod.png
