subtilitas/rcbench/docs/img/de/supply-settings.png

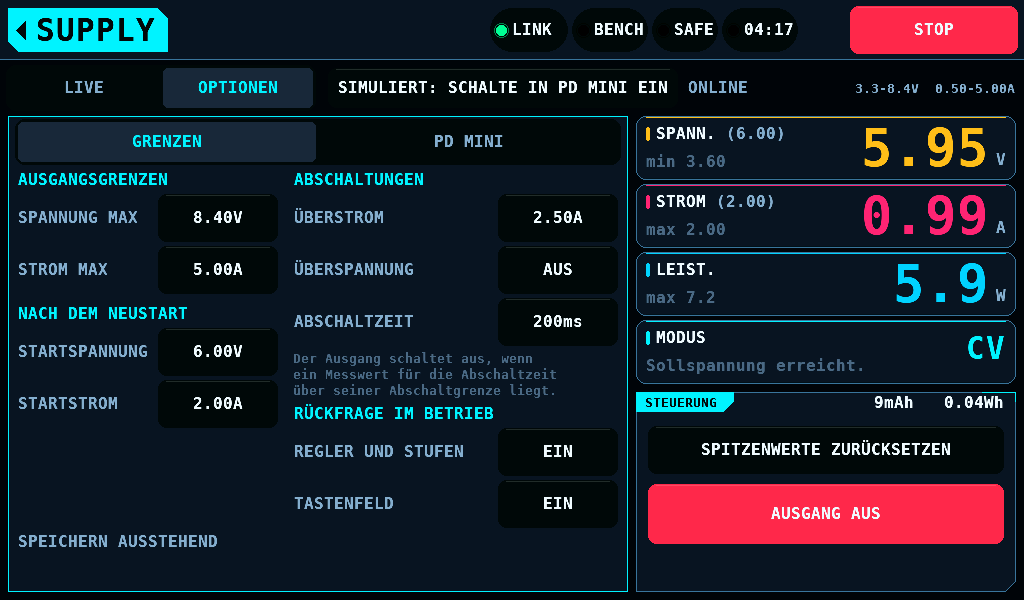
docs/img/de/supply-settings.png
