subtilitas/rcbench/docs/img/de/supply.png

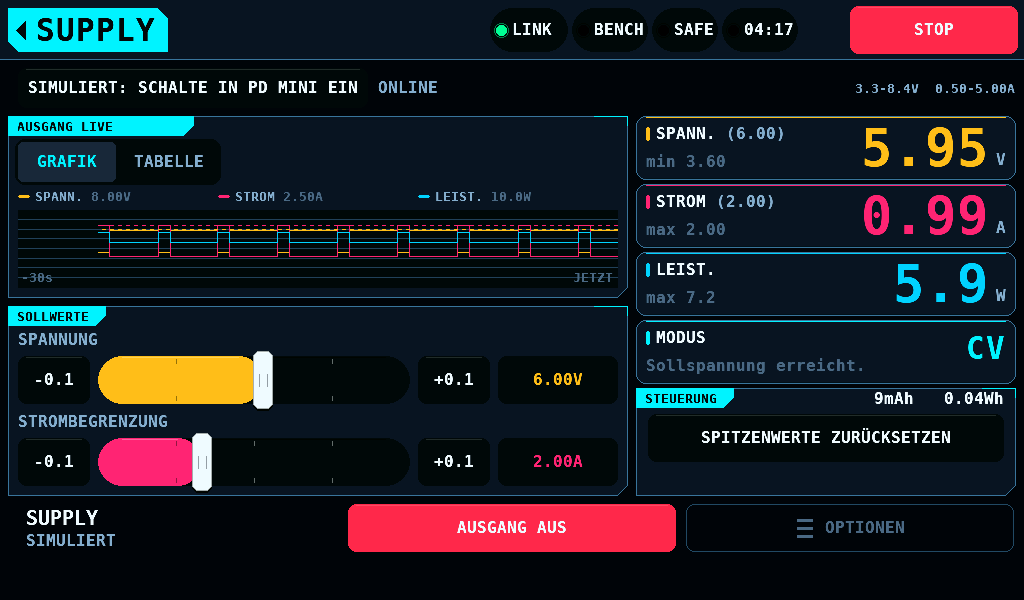
docs/img/de/supply.png
