subtilitas/rcbench/docs/img/de/upd-remind.png

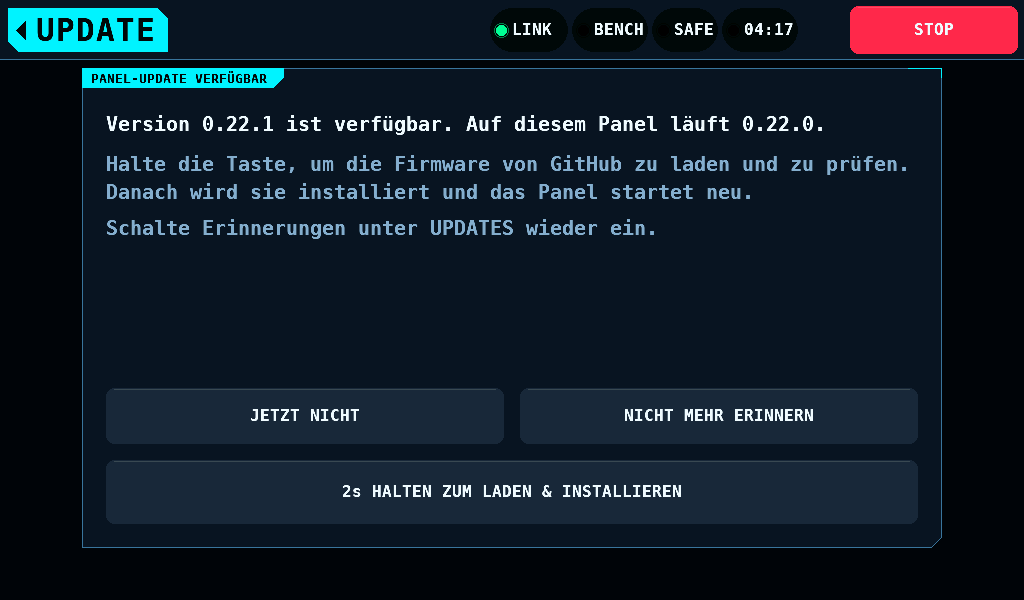
docs/img/de/upd-remind.png
