subtilitas/rcbench/docs/img/de/updates-checking.png

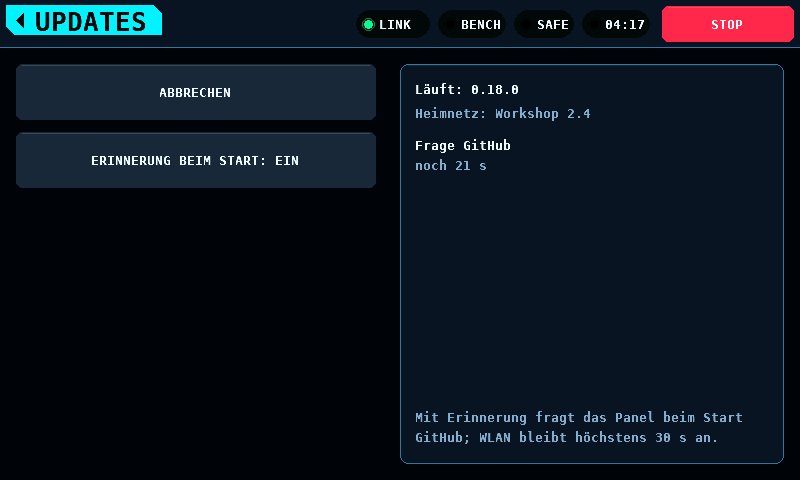
docs/img/de/updates-checking.png
