subtilitas/rcbench/docs/img/de/updates-newer.png

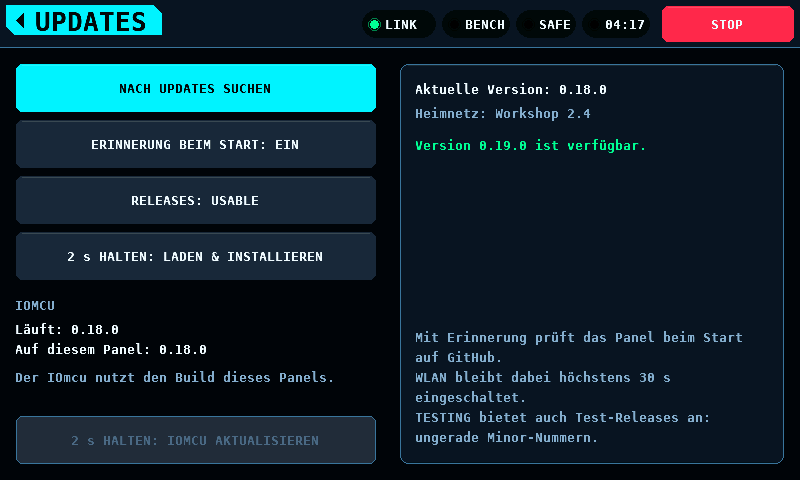
docs/img/de/updates-newer.png
