subtilitas/rcbench/docs/img/de/wifi-writes-hold.png

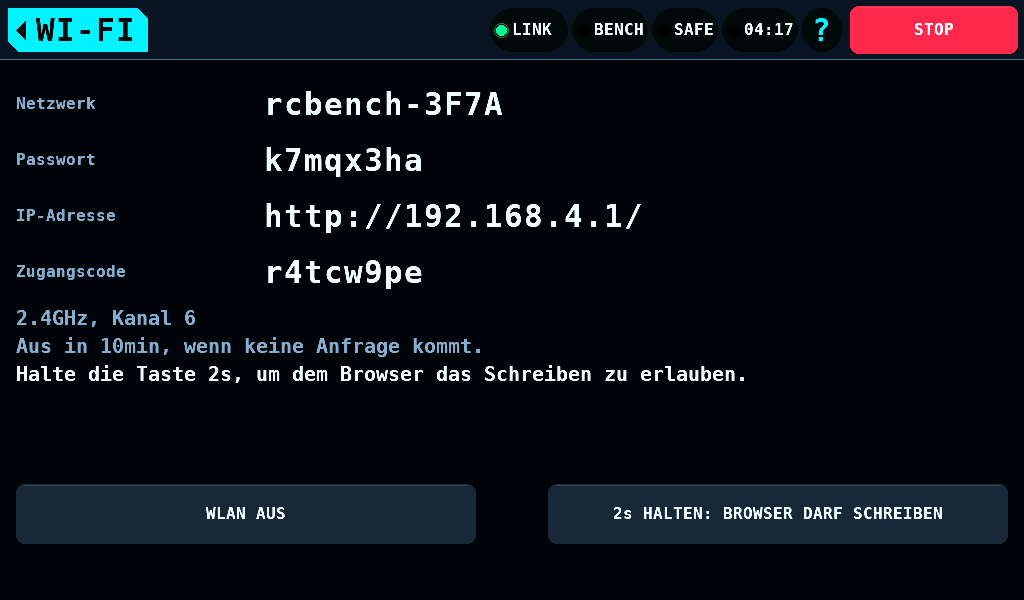
docs/img/de/wifi-writes-hold.png
