subtilitas/rcbench/docs/img/dial-waiting.png

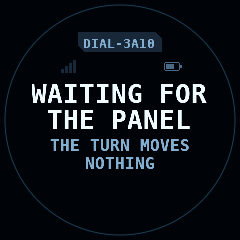
docs/img/dial-waiting.png
