subtilitas/rcbench/docs/img/files-conf.png

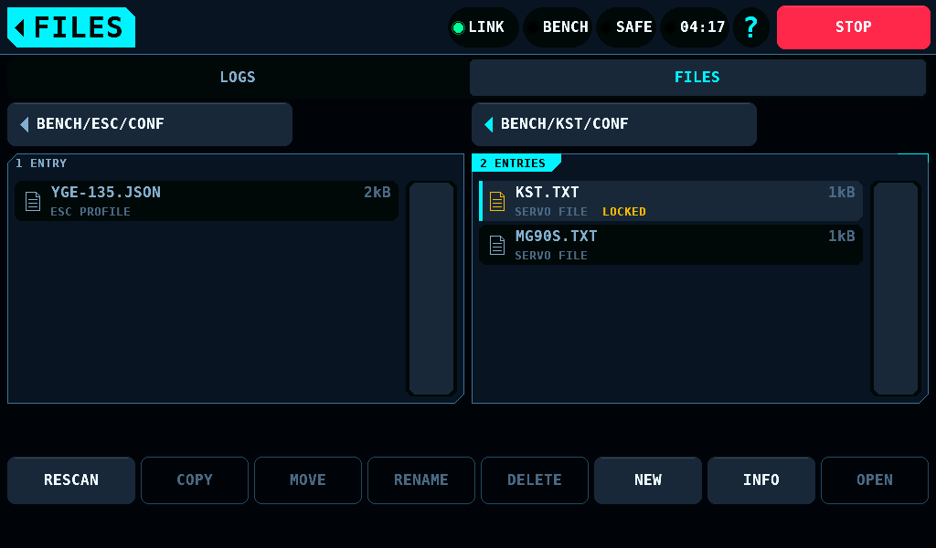
docs/img/files-conf.png
