subtilitas/rcbench/docs/img/files-edit-kst.png

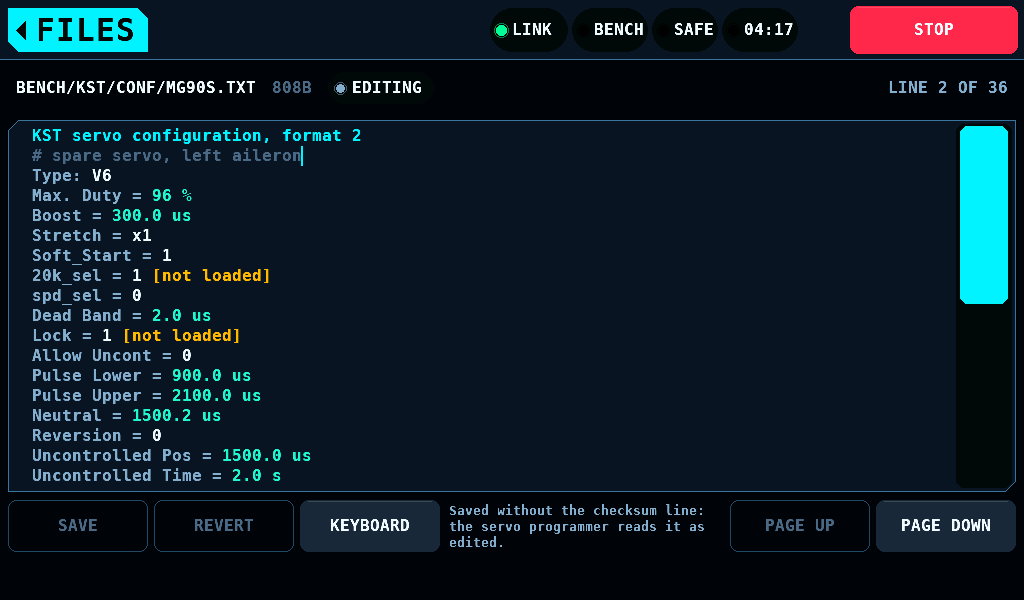
docs/img/files-edit-kst.png
