subtilitas/rcbench/docs/img/files-paged.png

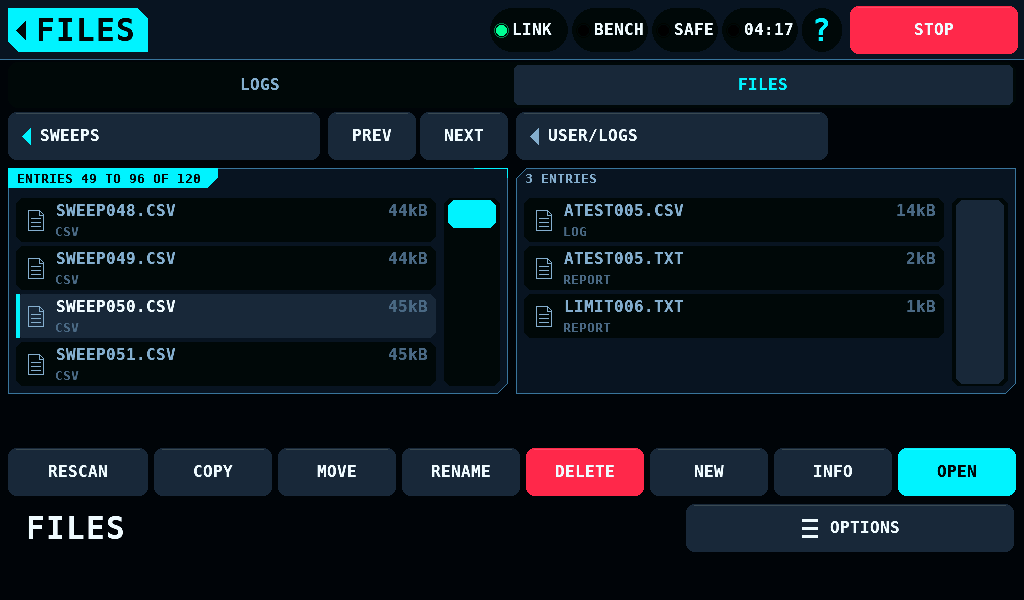
docs/img/files-paged.png
