subtilitas/rcbench/docs/img/help-wifi.png

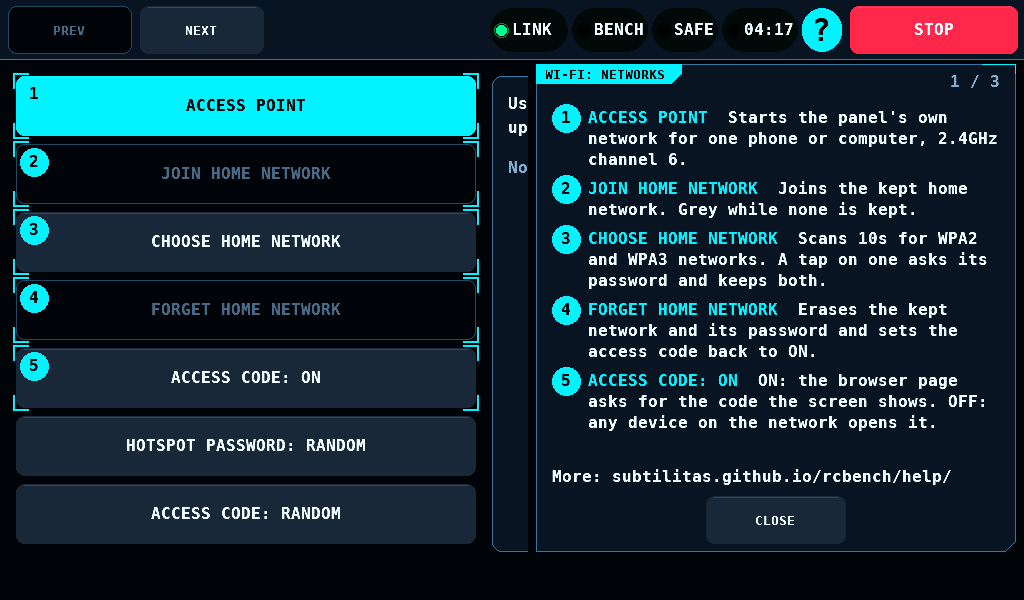
docs/img/help-wifi.png
