subtilitas/rcbench/docs/img/logs-delete.png

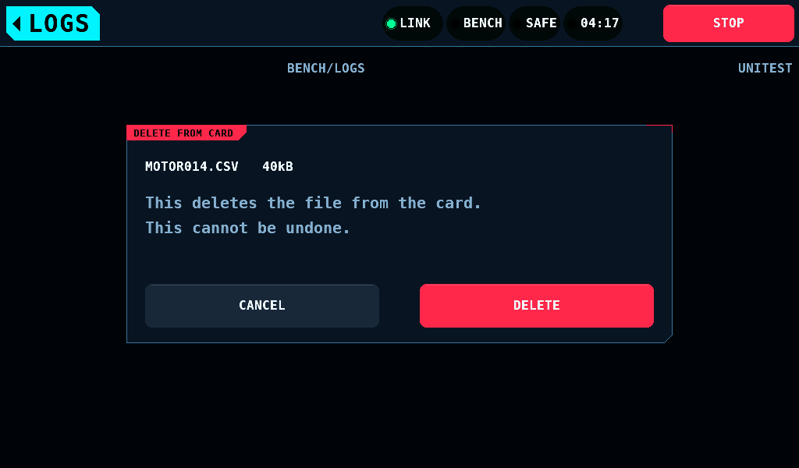
docs/img/logs-delete.png
