subtilitas/rcbench/docs/img/logs-nocard.png

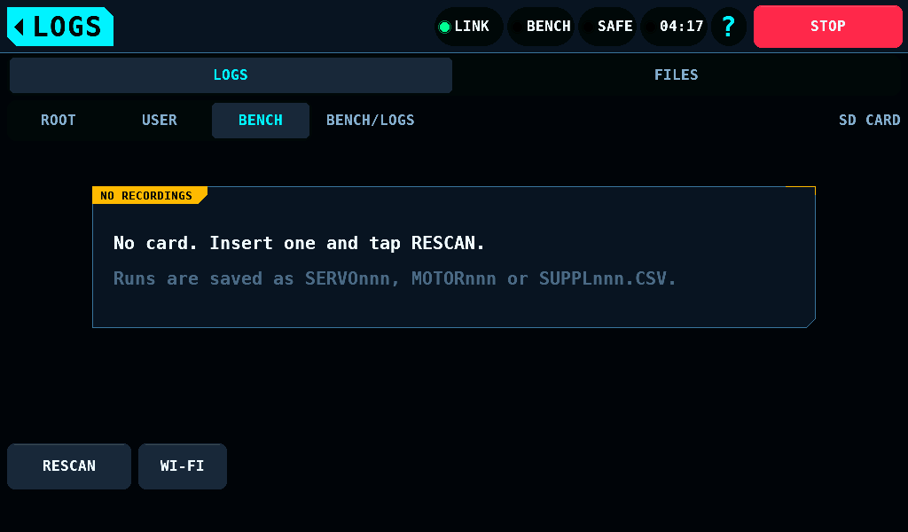
docs/img/logs-nocard.png
