subtilitas/rcbench/docs/img/motor-stick-done.png

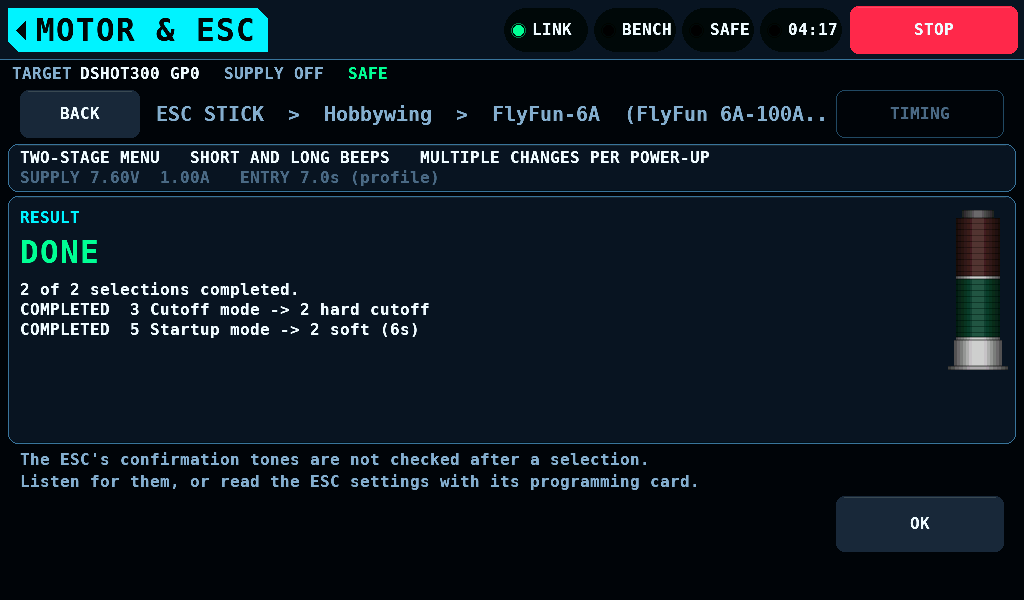
docs/img/motor-stick-done.png
