subtilitas/rcbench/docs/img/motor-stick-found.png

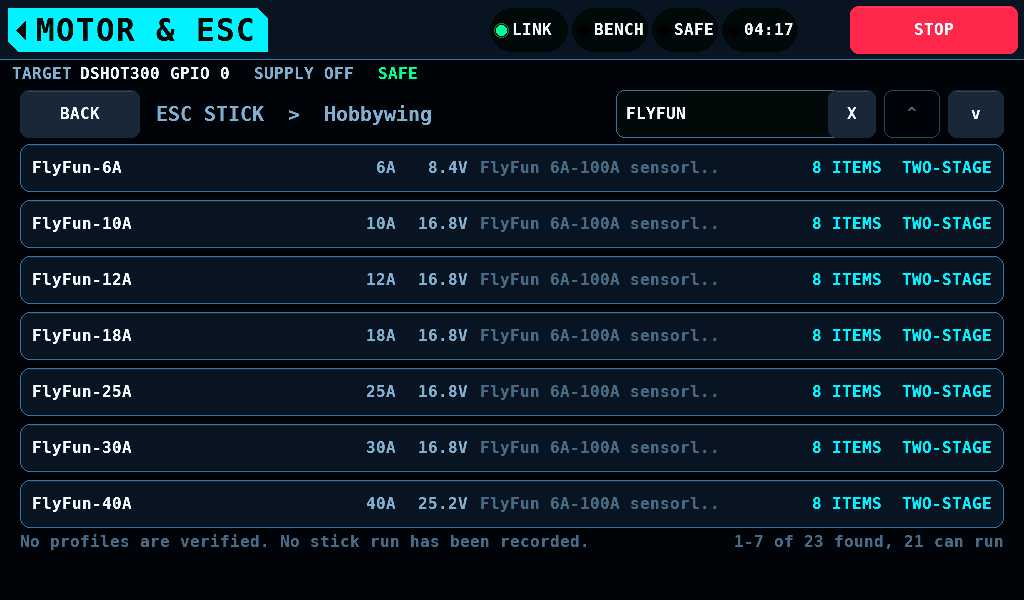
docs/img/motor-stick-found.png
