subtilitas/rcbench/docs/img/motor-stick-hand-end.png

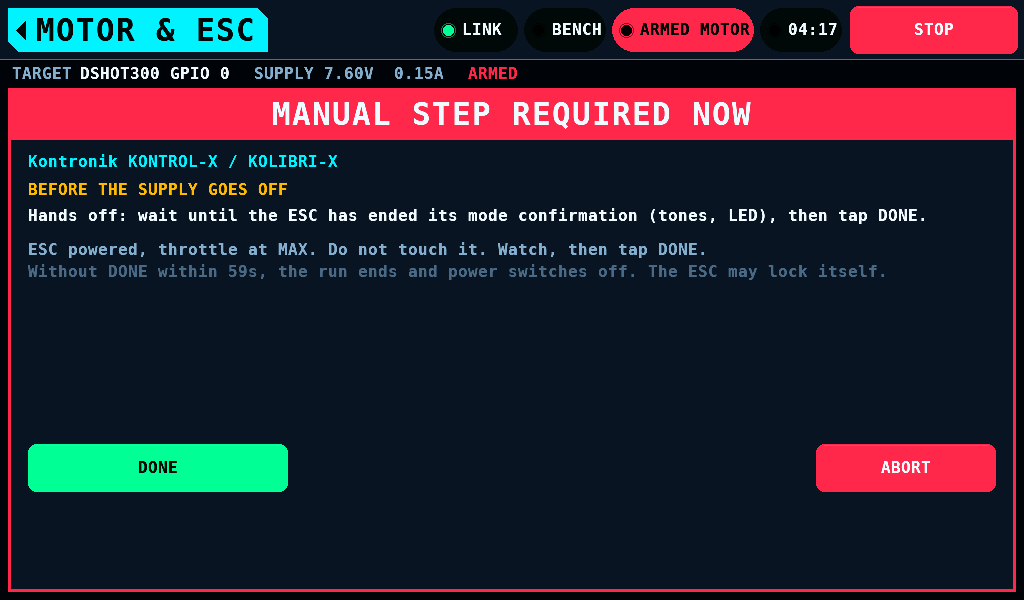
docs/img/motor-stick-hand-end.png
