subtilitas/rcbench/docs/img/motor-stick-hand-list.png

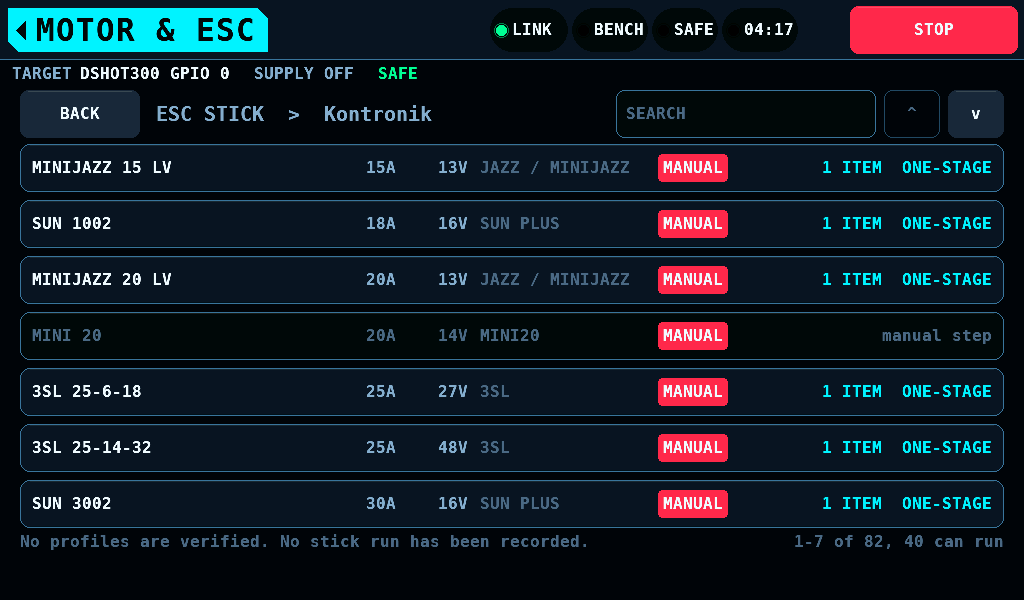
docs/img/motor-stick-hand-list.png
