subtilitas/rcbench/docs/img/motor-stick-items.png

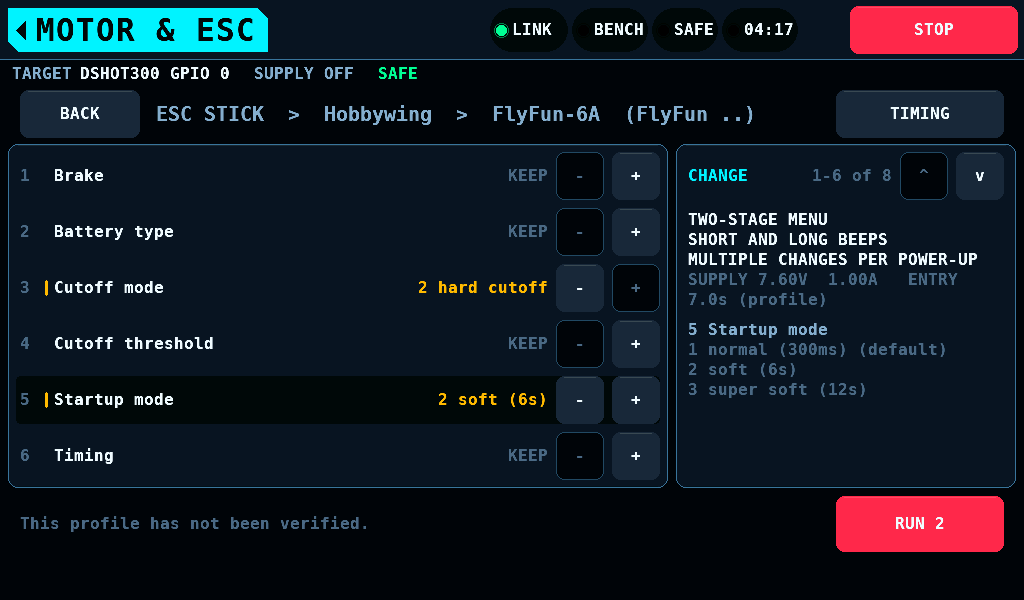
docs/img/motor-stick-items.png
