subtilitas/rcbench/docs/img/motor-stick.png

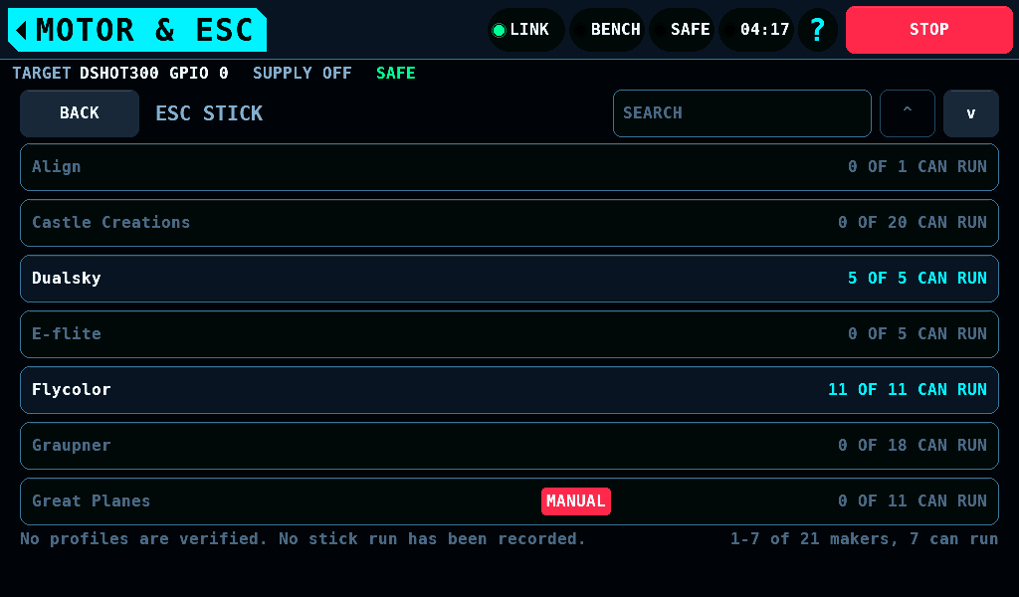
docs/img/motor-stick.png
