subtilitas/rcbench/docs/img/motor-wire-am-leave.png

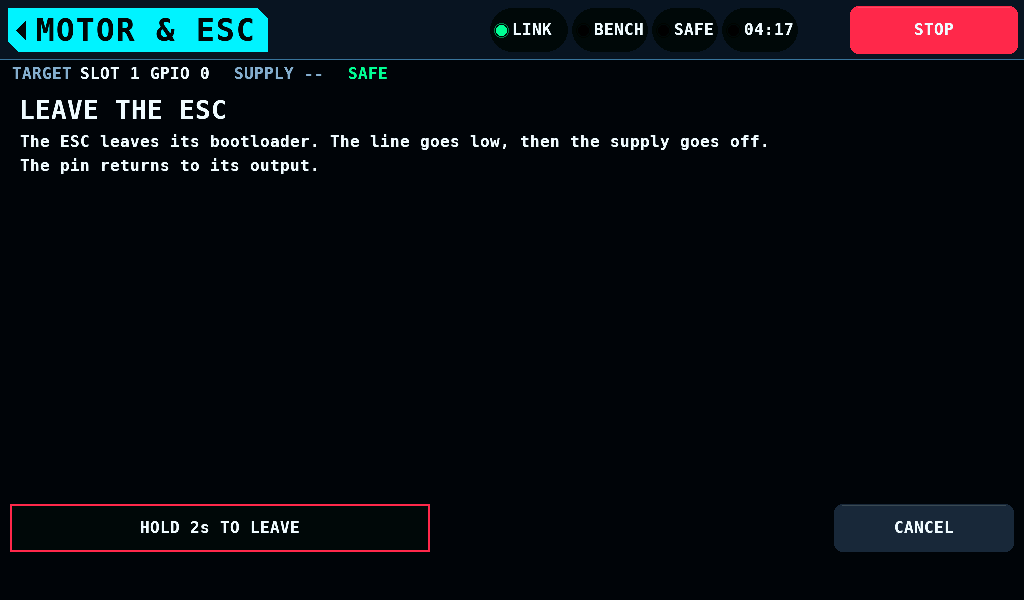
docs/img/motor-wire-am-leave.png
