subtilitas/rcbench/docs/img/motor-wire-stopped-band.png

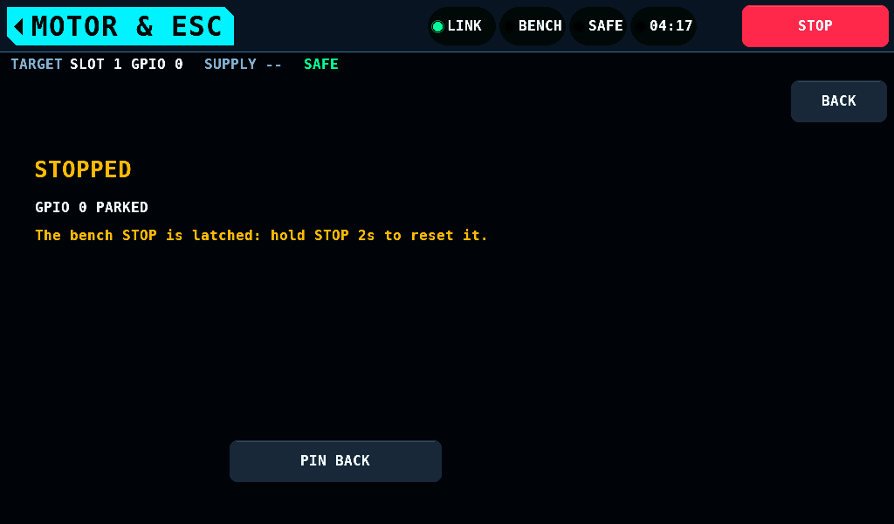
docs/img/motor-wire-stopped-band.png
