subtilitas/rcbench/docs/img/outputs-port.png

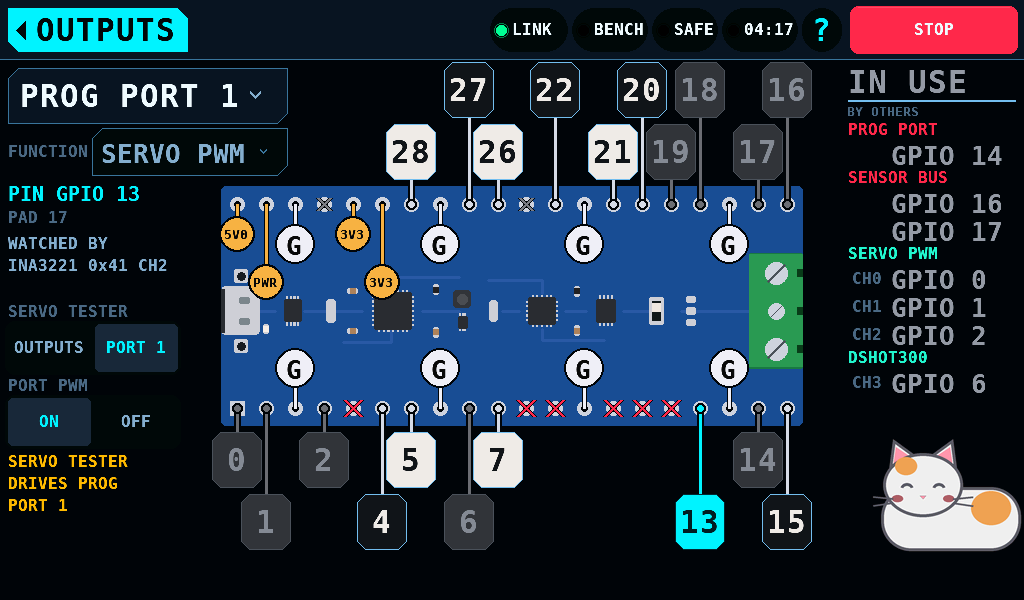
docs/img/outputs-port.png
