subtilitas/rcbench/docs/img/outputs-unread.png

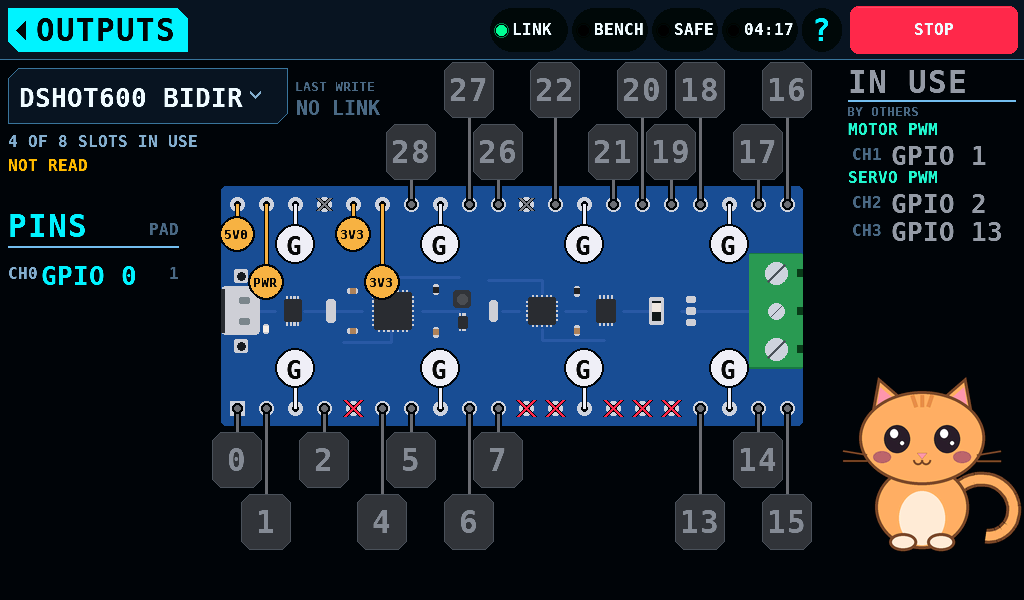
docs/img/outputs-unread.png
