subtilitas/rcbench/docs/img/overview-light.png

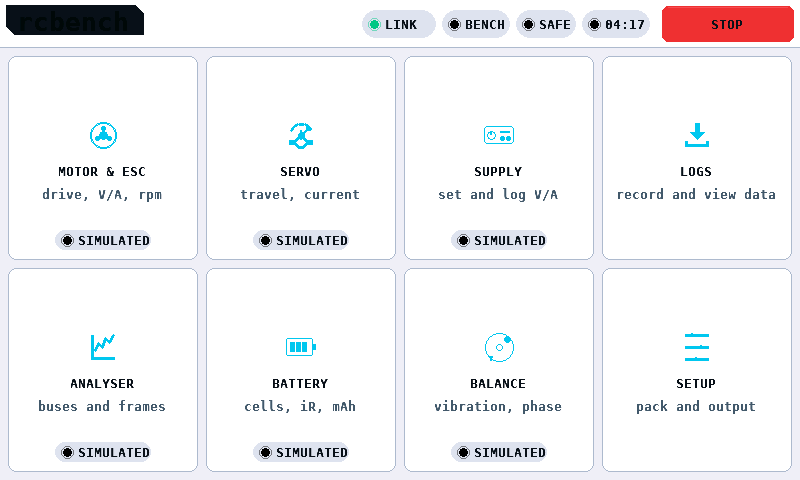
docs/img/overview-light.png
