subtilitas/rcbench/docs/img/panel-update-failed.png

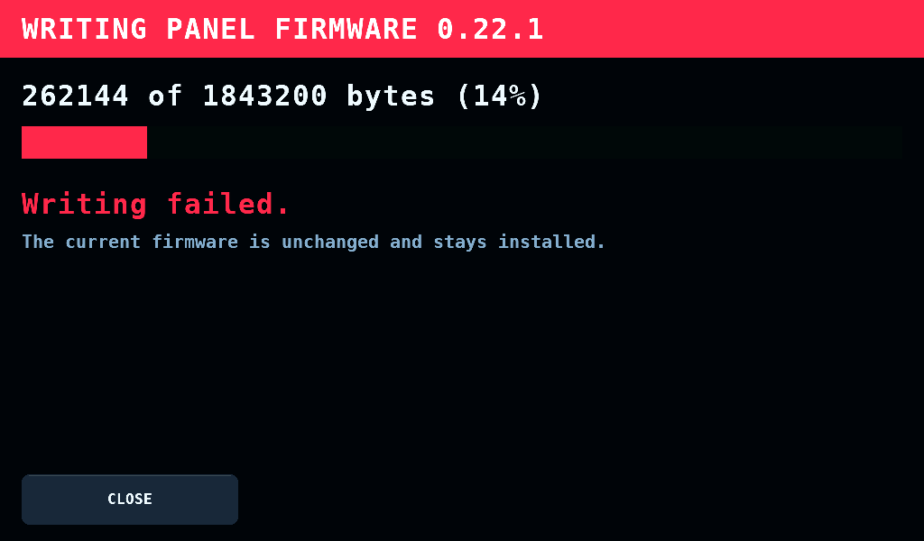
docs/img/panel-update-failed.png
