subtilitas/rcbench/docs/img/panel-update.png

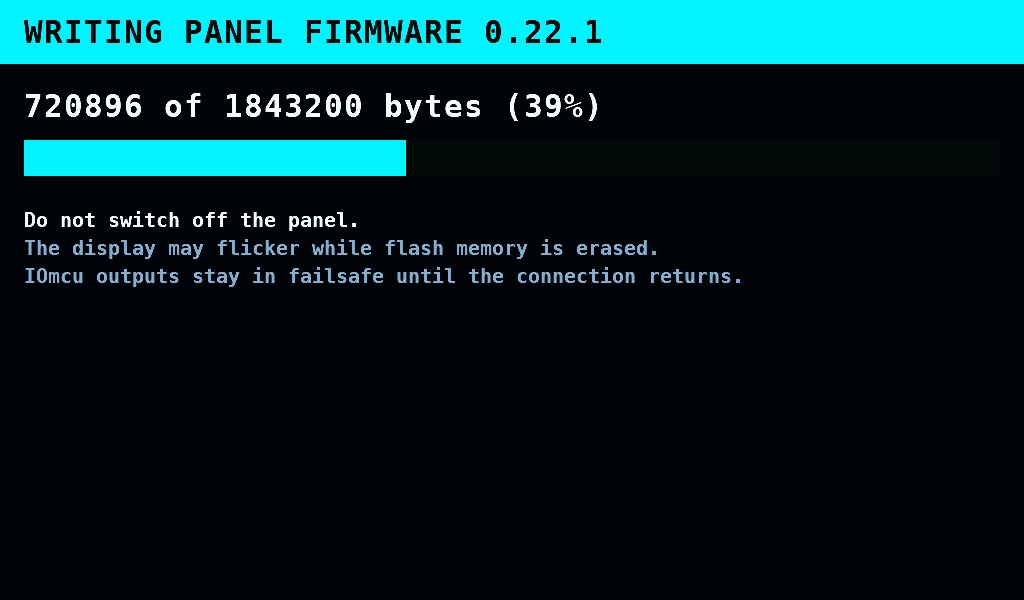
docs/img/panel-update.png
