subtilitas/rcbench/docs/img/picker-off.png

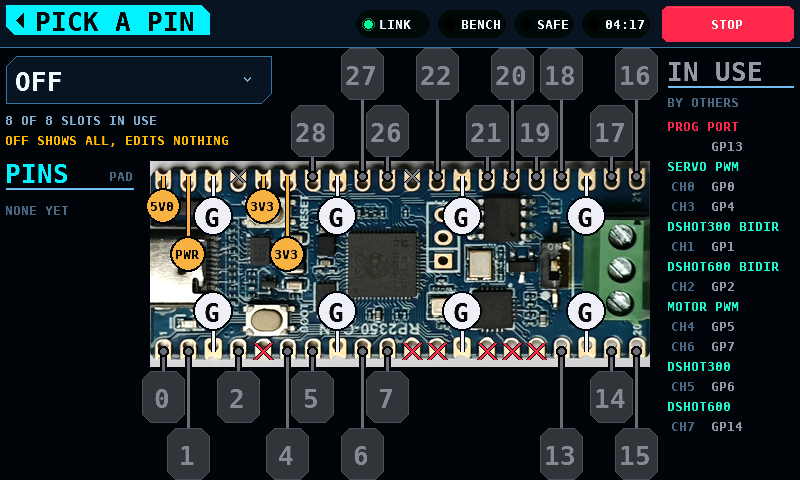
docs/img/picker-off.png
