subtilitas/rcbench/docs/img/programmer-stick-done.png

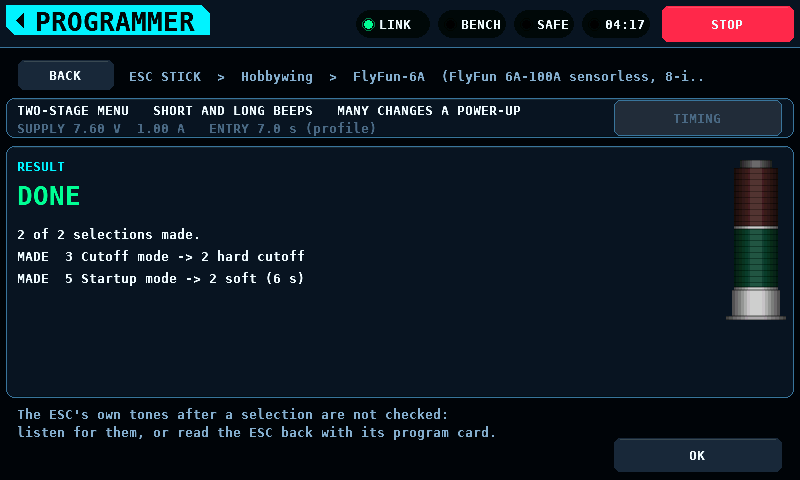
docs/img/programmer-stick-done.png
