subtilitas/rcbench/docs/img/programmer-stick-failed.png

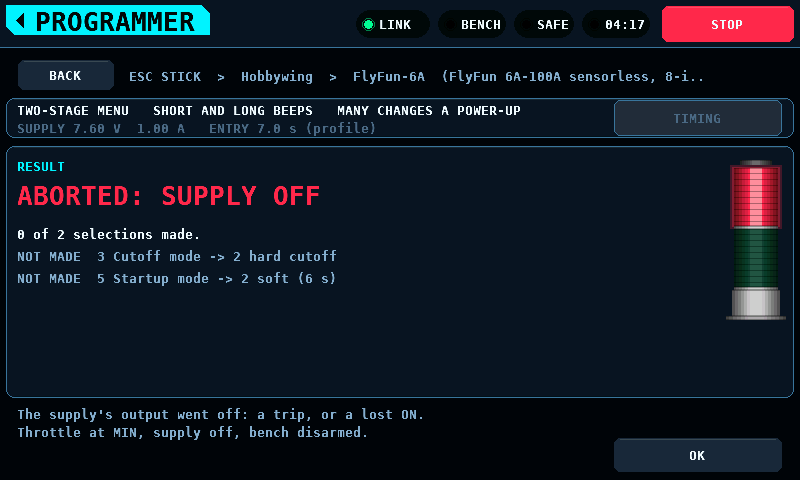
docs/img/programmer-stick-failed.png
