subtilitas/rcbench/docs/img/programmer-stick-find.png

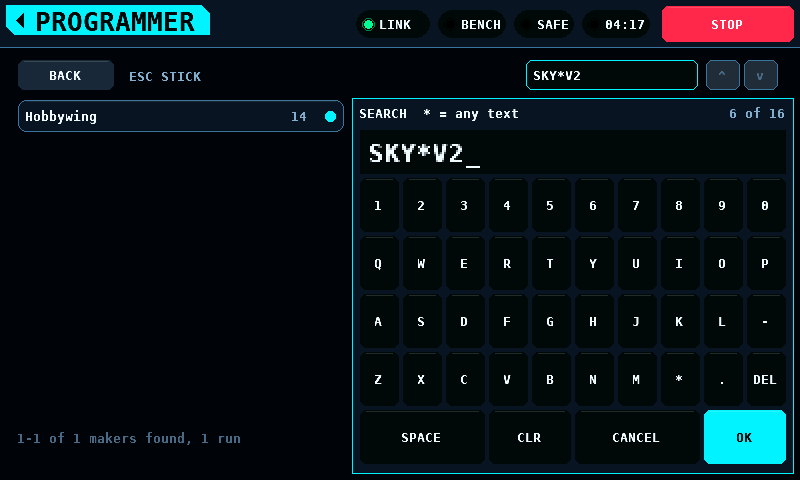
docs/img/programmer-stick-find.png
