subtilitas/rcbench/docs/img/programmer-stick-hand-info.png

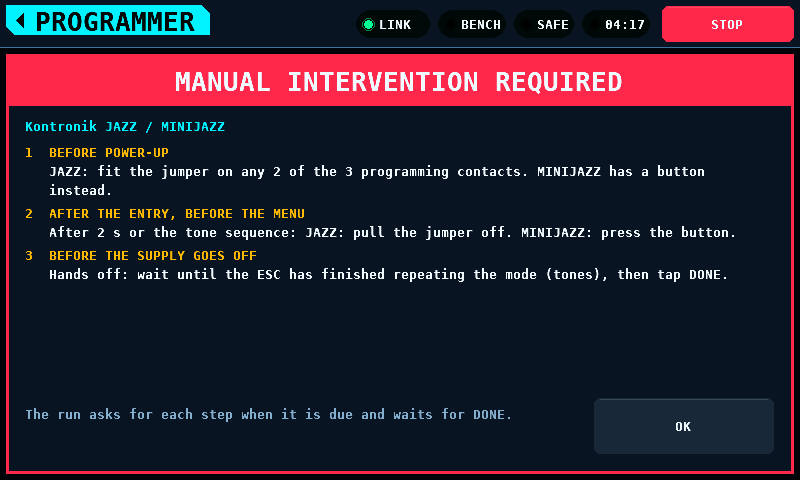
docs/img/programmer-stick-hand-info.png
