subtilitas/rcbench/docs/img/programmer-stick-timing.png

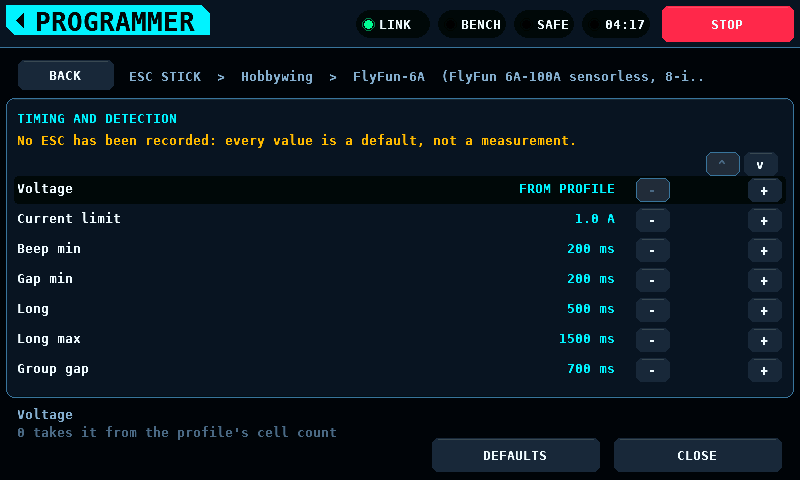
docs/img/programmer-stick-timing.png
