subtilitas/rcbench/docs/img/servo-dut-expert.png

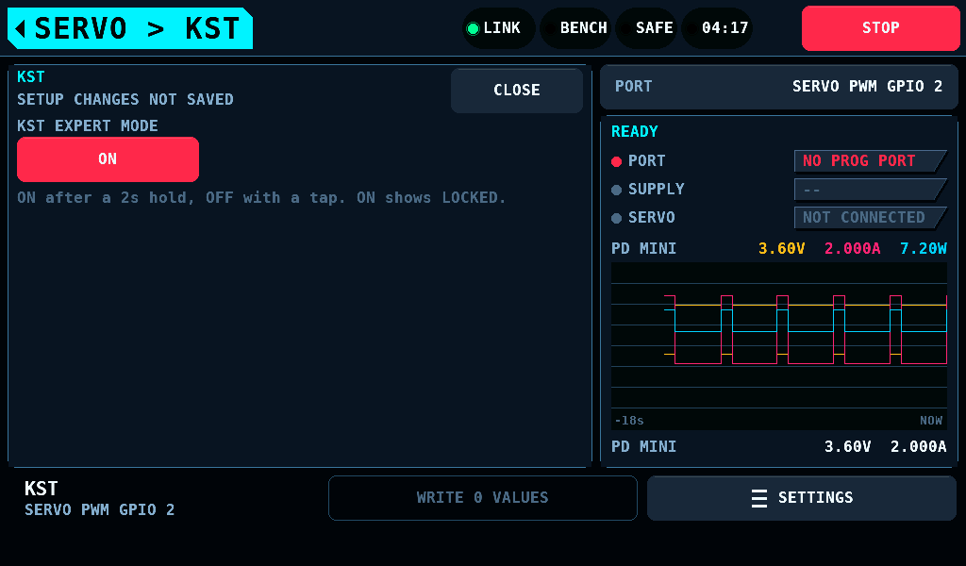
docs/img/servo-dut-expert.png
