subtilitas/rcbench/docs/img/servo-hitec-classic-info.png

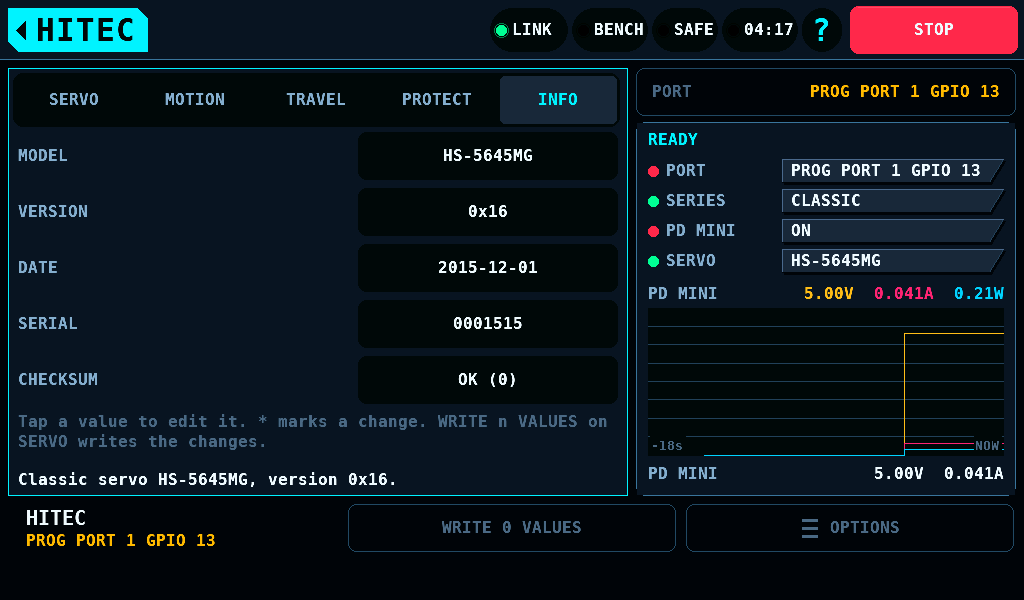
docs/img/servo-hitec-classic-info.png
