subtilitas/rcbench/docs/img/servo-hitec-classic-protect.png

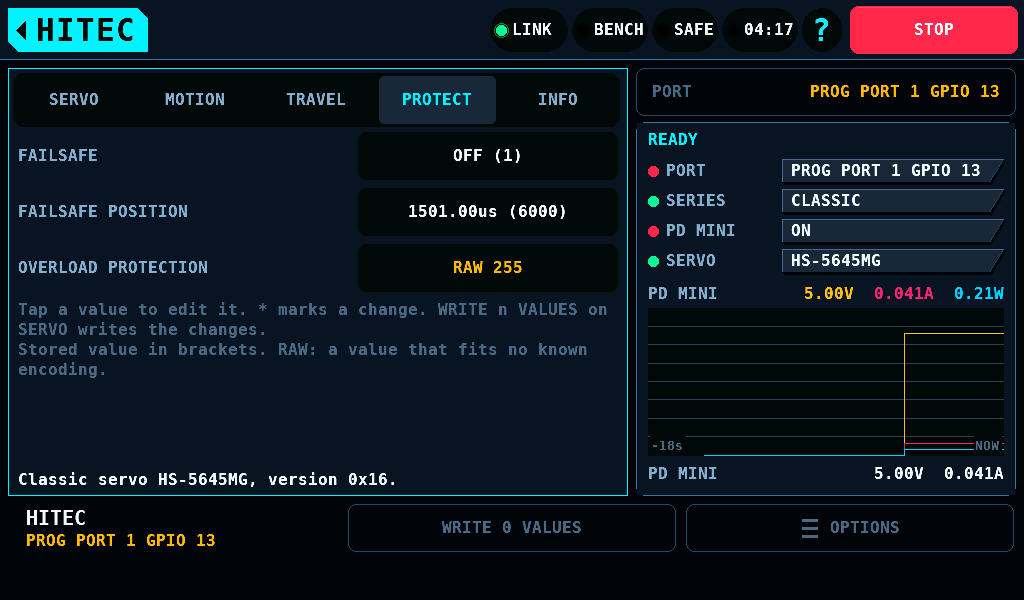
docs/img/servo-hitec-classic-protect.png
