subtilitas/rcbench/docs/img/servo-hitec-classic.png

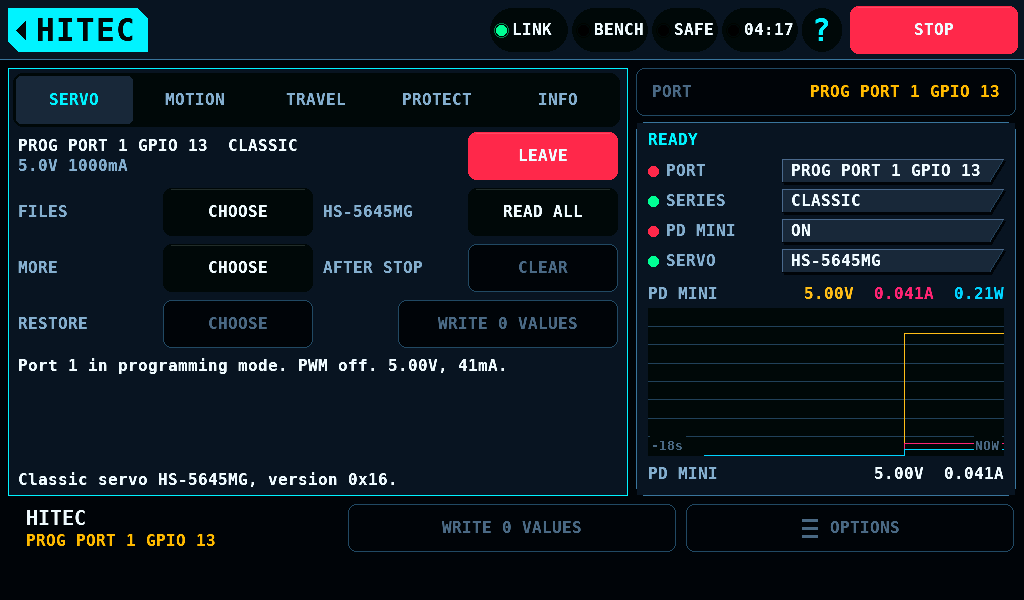
docs/img/servo-hitec-classic.png
