subtilitas/rcbench/docs/img/servo-hitec-list.png

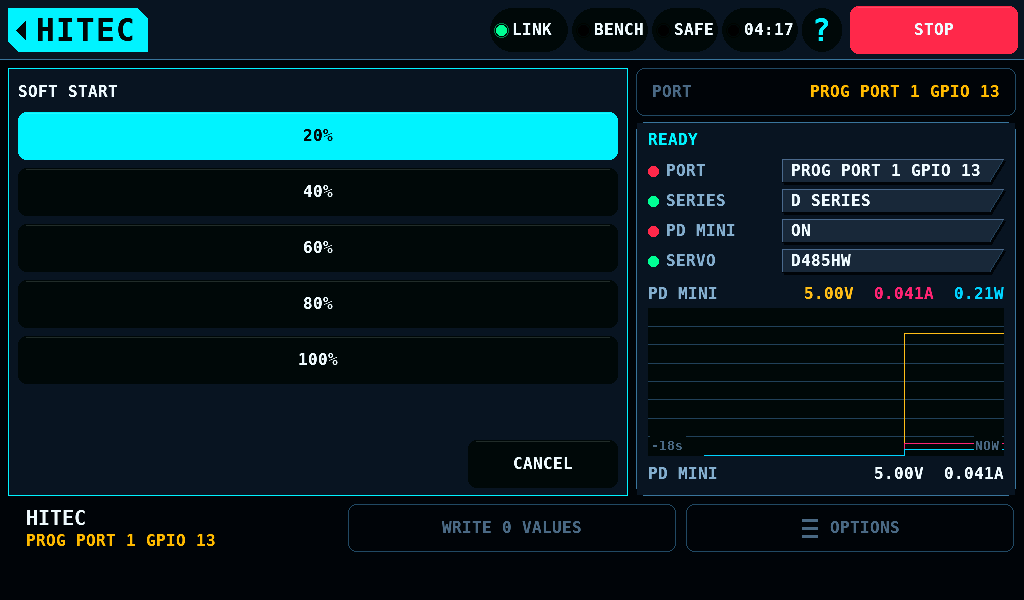
docs/img/servo-hitec-list.png
