subtilitas/rcbench/docs/img/servo-hitec-move-blocked.png

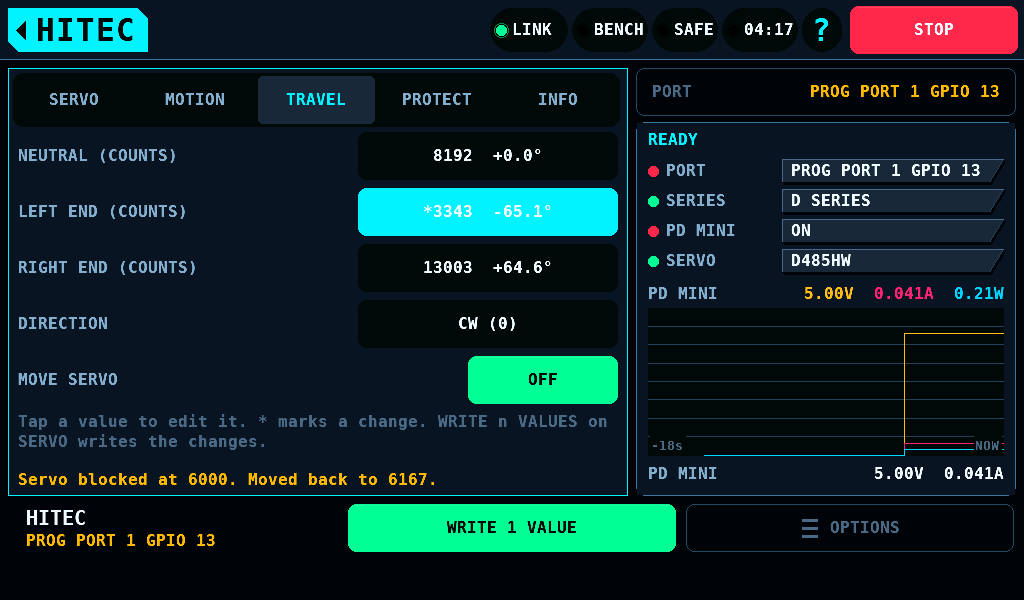
docs/img/servo-hitec-move-blocked.png
