subtilitas/rcbench/docs/img/servo-hitec-nopd.png

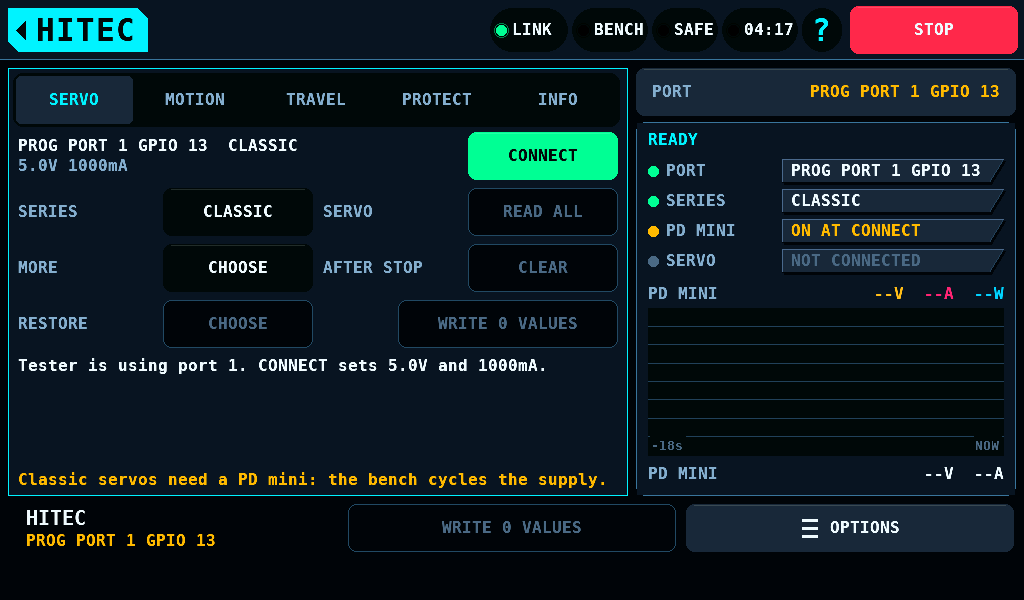
docs/img/servo-hitec-nopd.png
