subtilitas/rcbench/docs/img/servo-hitec-released.png

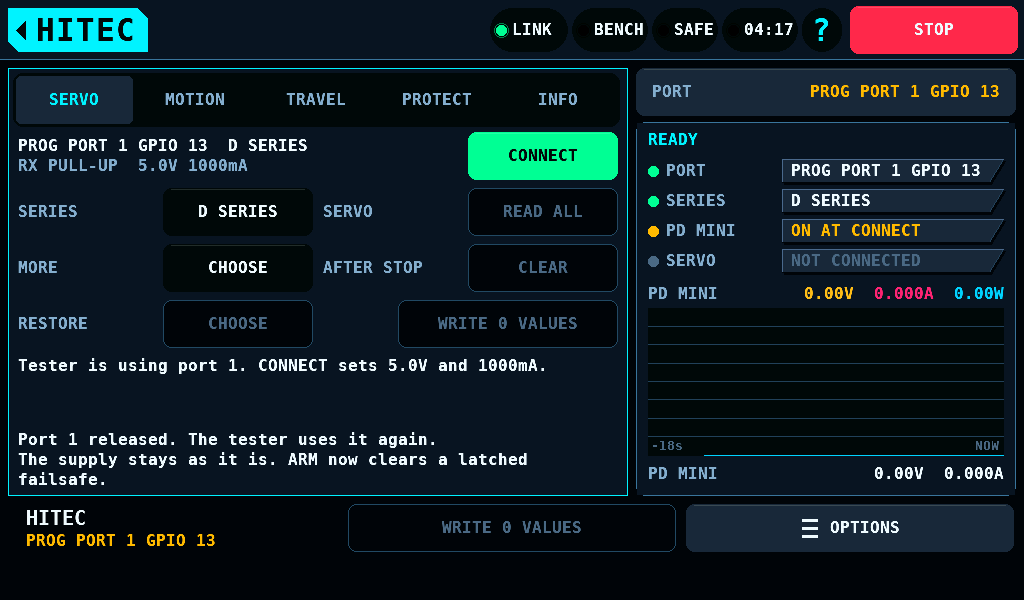
docs/img/servo-hitec-released.png
