subtilitas/rcbench/docs/img/servo-hitec-restore-backup.png

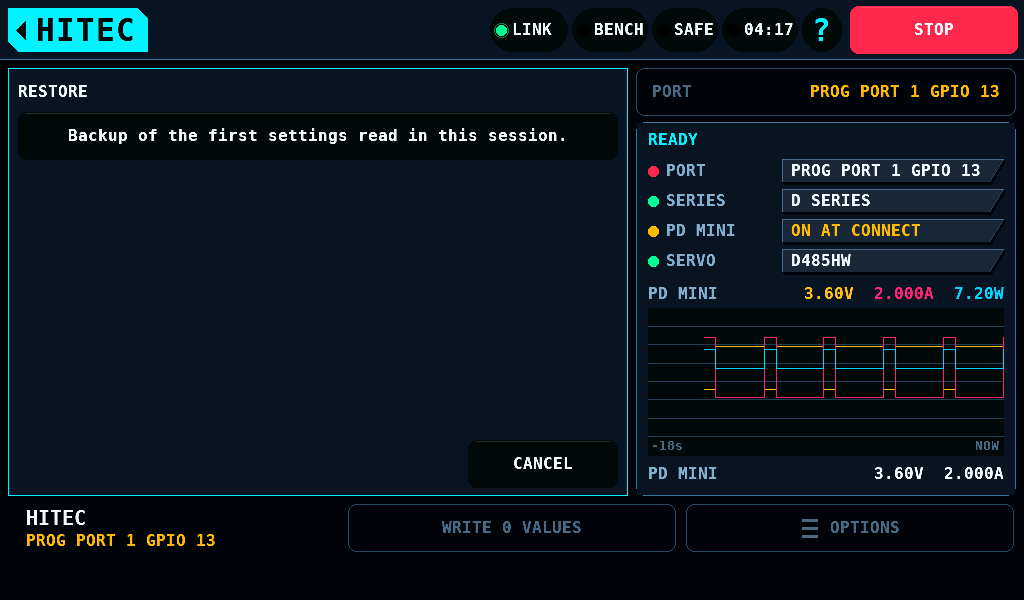
docs/img/servo-hitec-restore-backup.png
