subtilitas/rcbench/docs/img/servo-hitec-restore-hv.png

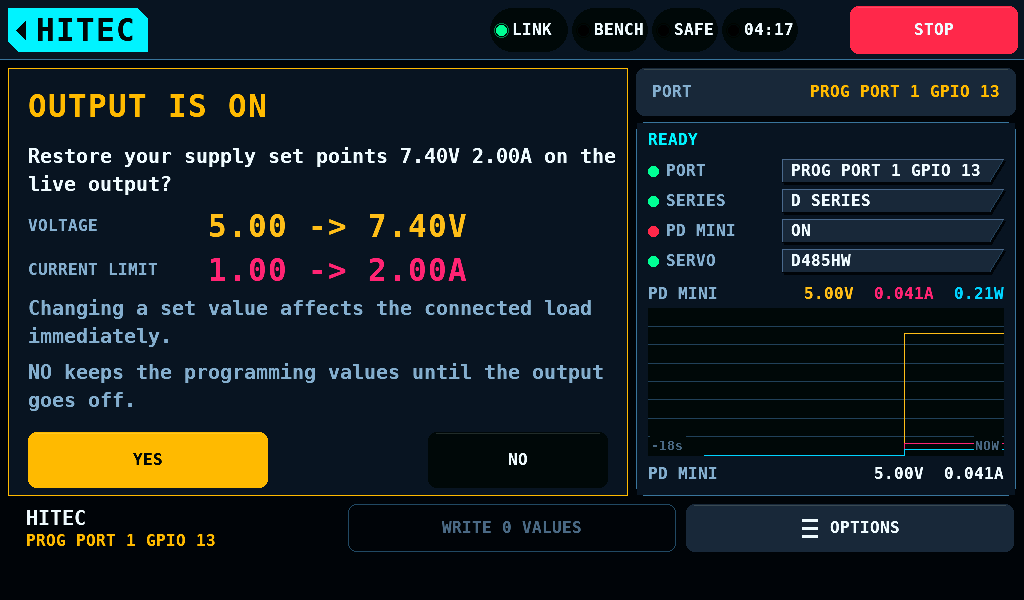
docs/img/servo-hitec-restore-hv.png
