subtilitas/rcbench/docs/img/servo-hitec-restore-page.png

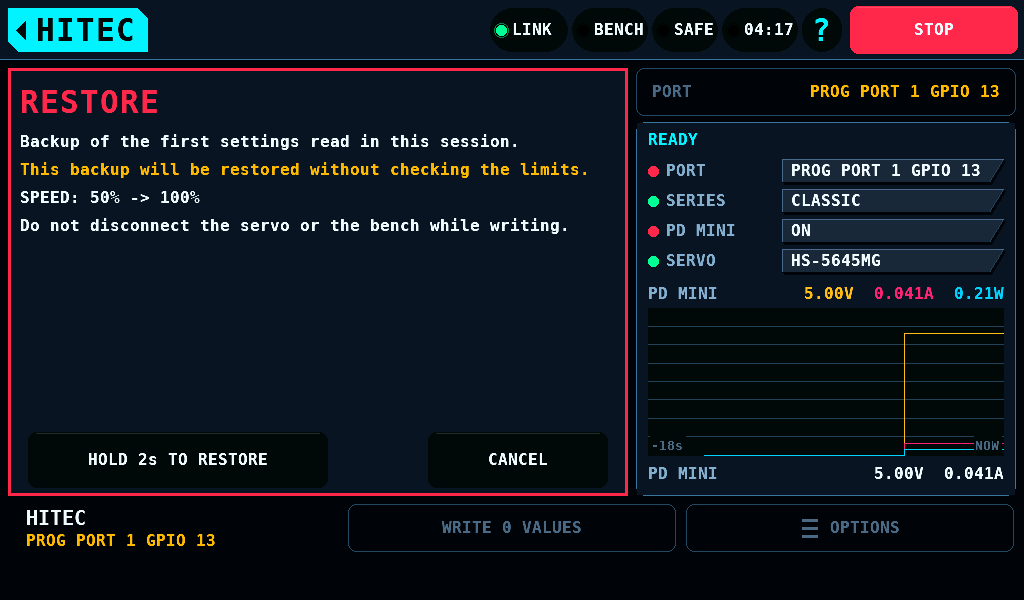
docs/img/servo-hitec-restore-page.png
