subtilitas/rcbench/docs/img/servo-hitec-stopped.png

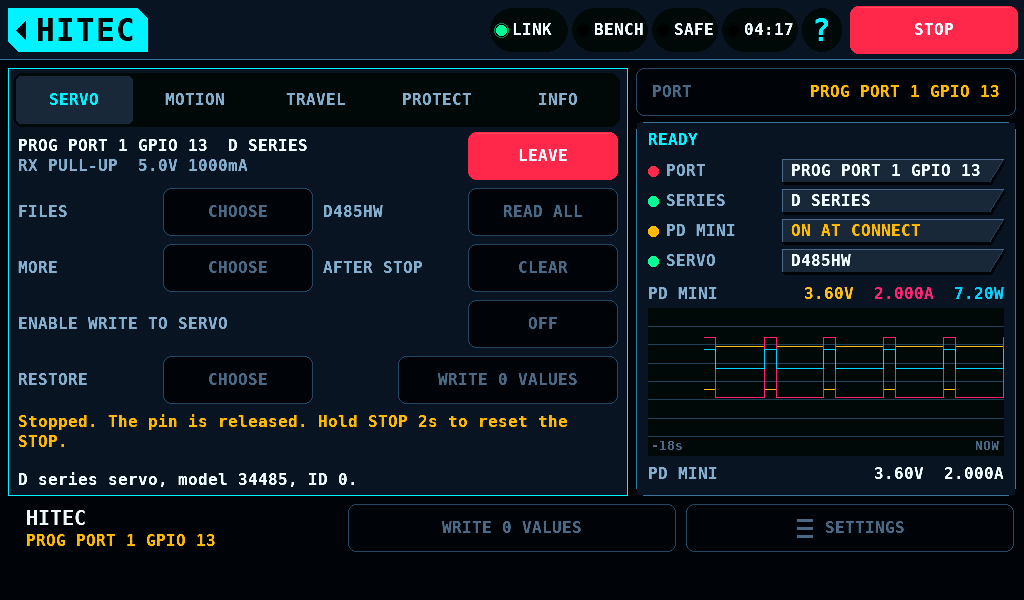
docs/img/servo-hitec-stopped.png
