subtilitas/rcbench/docs/img/servo-hitec-writing.png

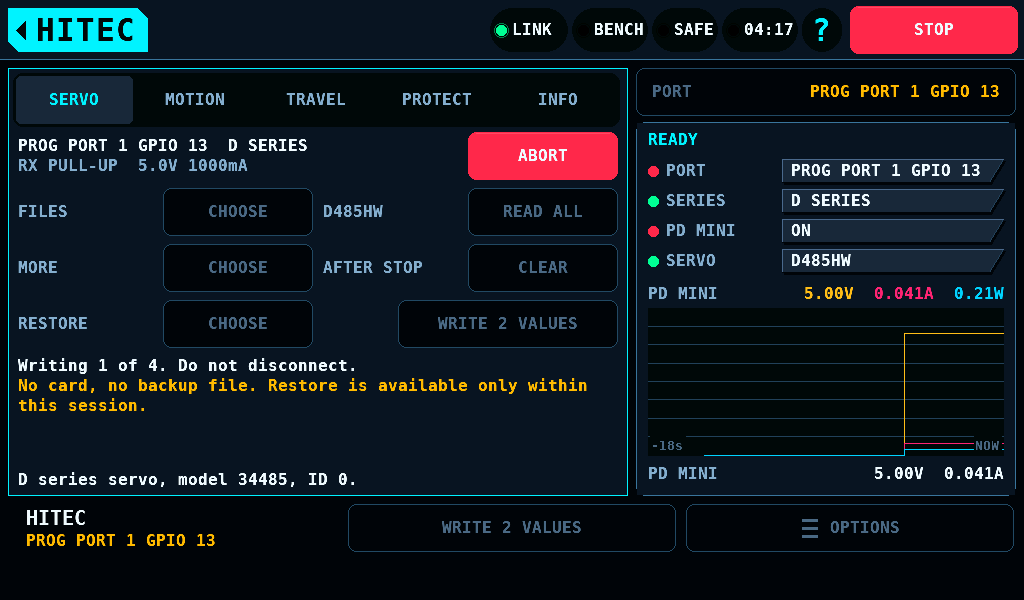
docs/img/servo-hitec-writing.png
