subtilitas/rcbench/docs/img/servo-kst-cycling.png

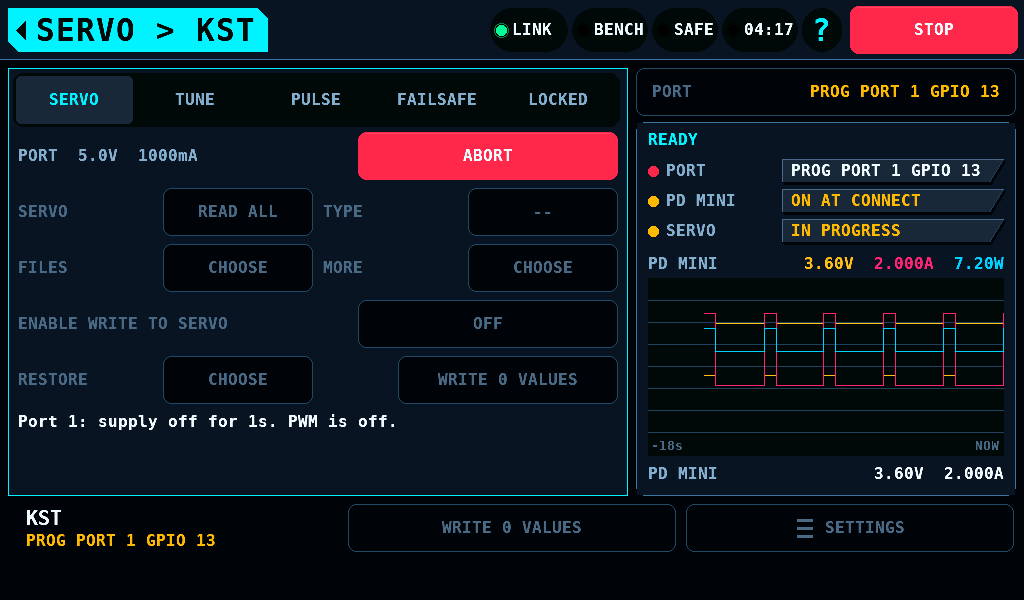
docs/img/servo-kst-cycling.png
