subtilitas/rcbench/docs/img/servo-kst-failsafe.png

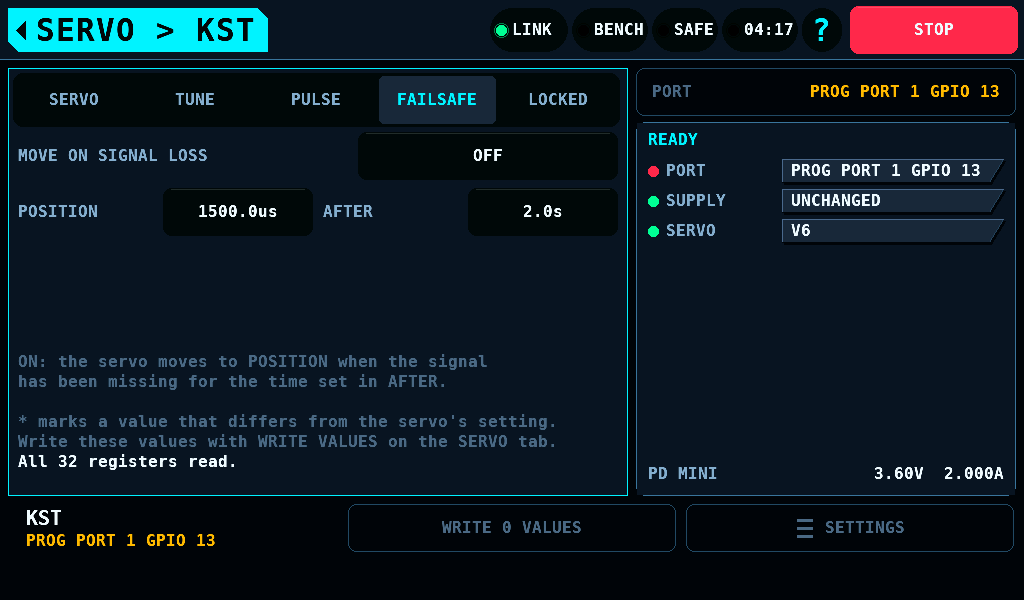
docs/img/servo-kst-failsafe.png
