subtilitas/rcbench/docs/img/servo-kst-file-locked.png

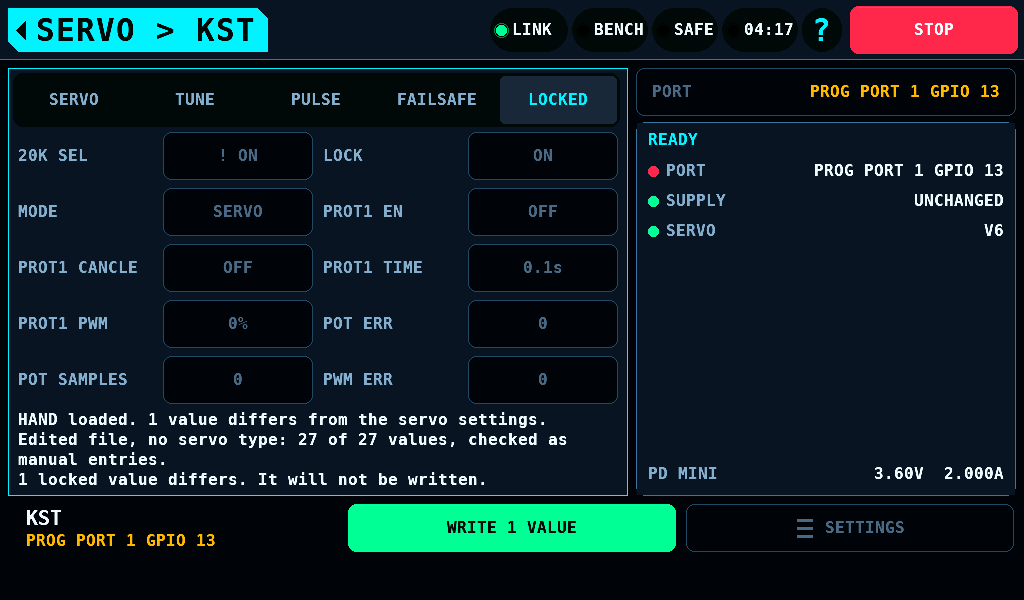
docs/img/servo-kst-file-locked.png
