subtilitas/rcbench/docs/img/servo-kst-file-newer.png

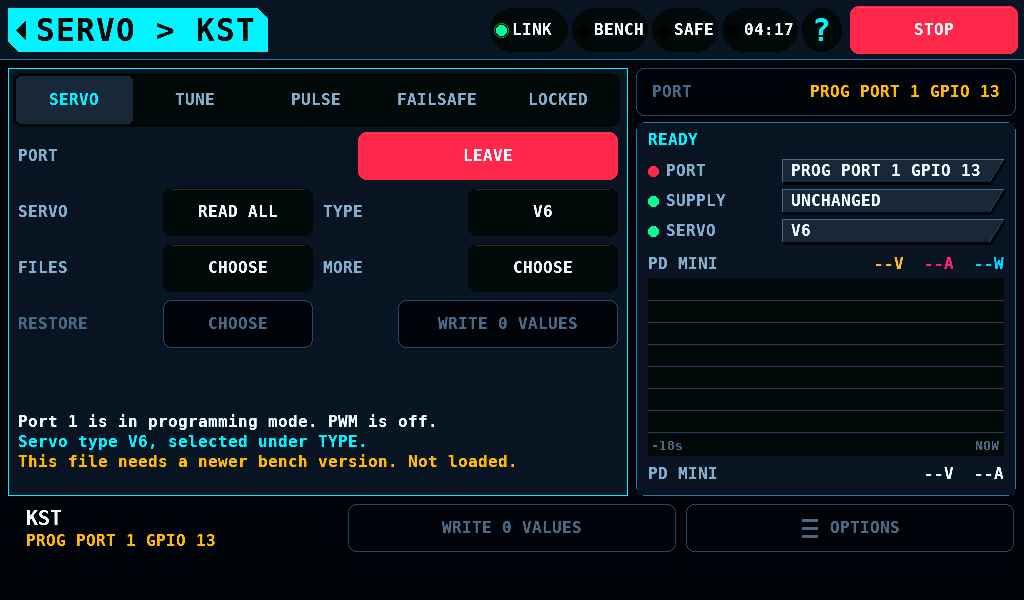
docs/img/servo-kst-file-newer.png
