subtilitas/rcbench/docs/img/servo-kst-file-v6.png

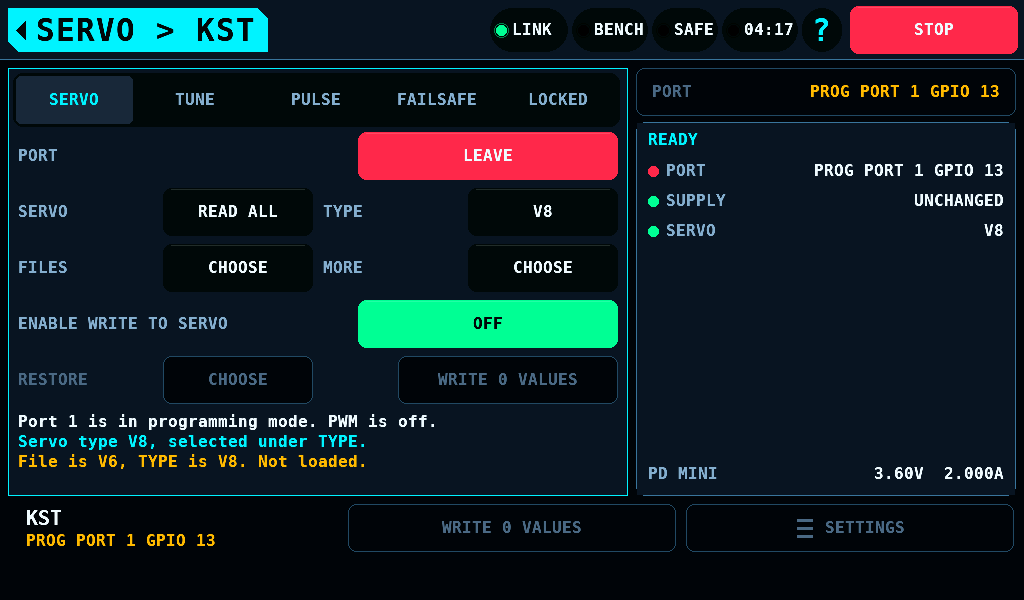
docs/img/servo-kst-file-v6.png
