subtilitas/rcbench/docs/img/servo-kst-files-next.png

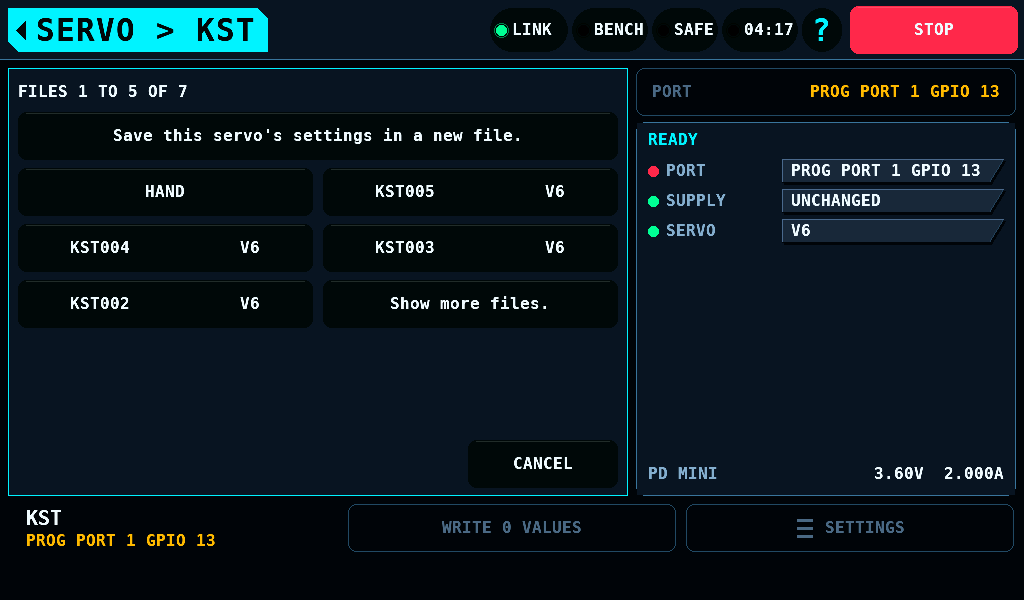
docs/img/servo-kst-files-next.png
