subtilitas/rcbench/docs/img/servo-kst-leave-expert-off.png

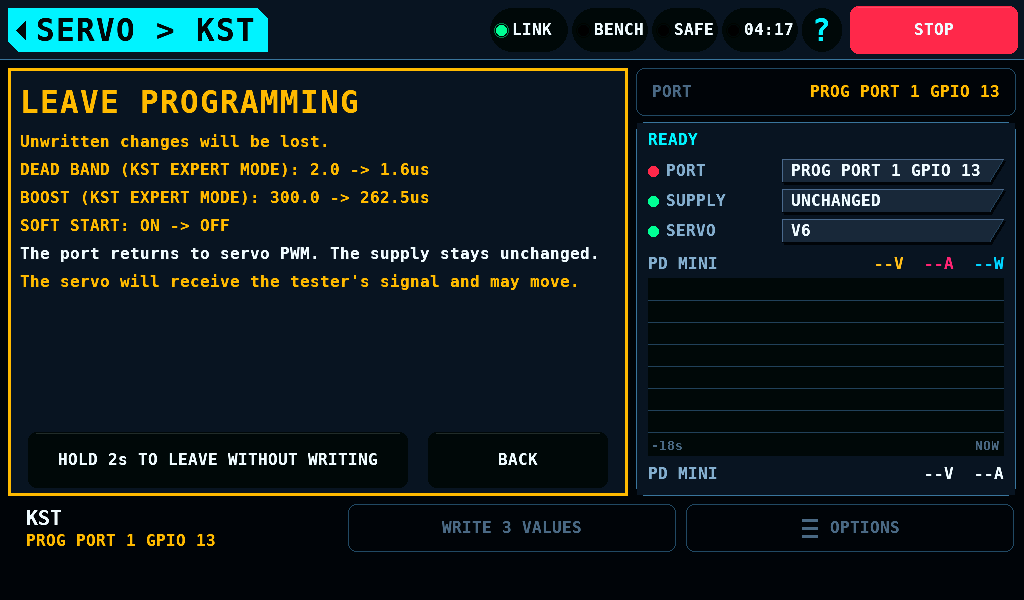
docs/img/servo-kst-leave-expert-off.png
