subtilitas/rcbench/docs/img/servo-kst-leave-plain.png

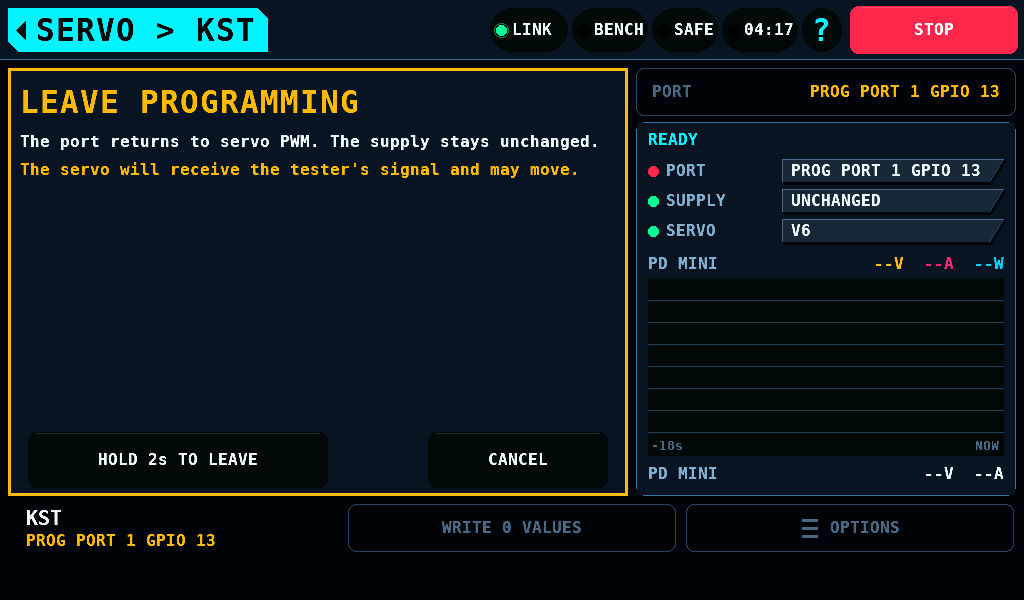
docs/img/servo-kst-leave-plain.png
