subtilitas/rcbench/docs/img/servo-kst-name-exists.png

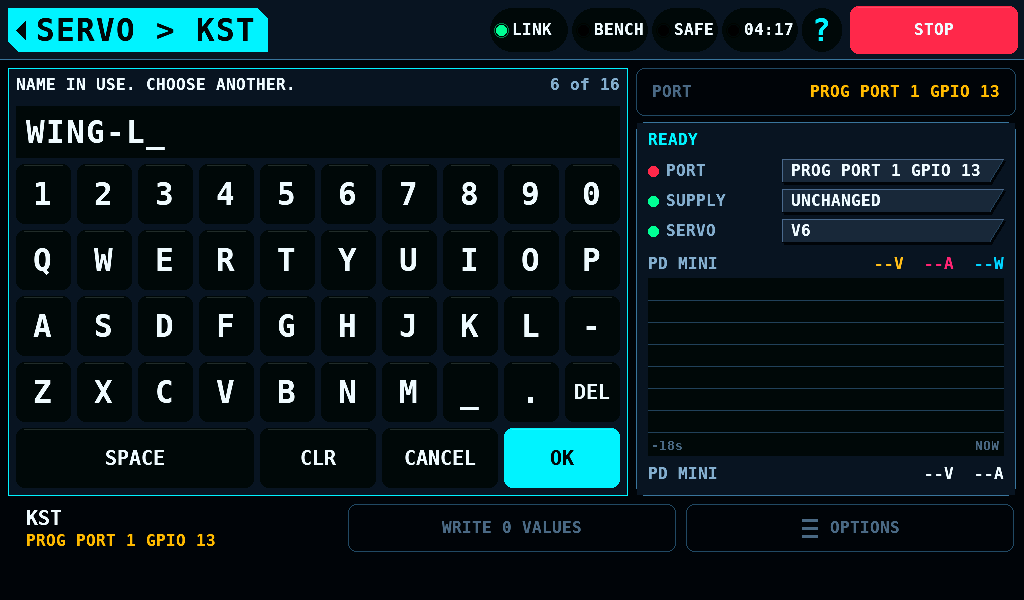
docs/img/servo-kst-name-exists.png
