subtilitas/rcbench/docs/img/servo-kst-nofile.png

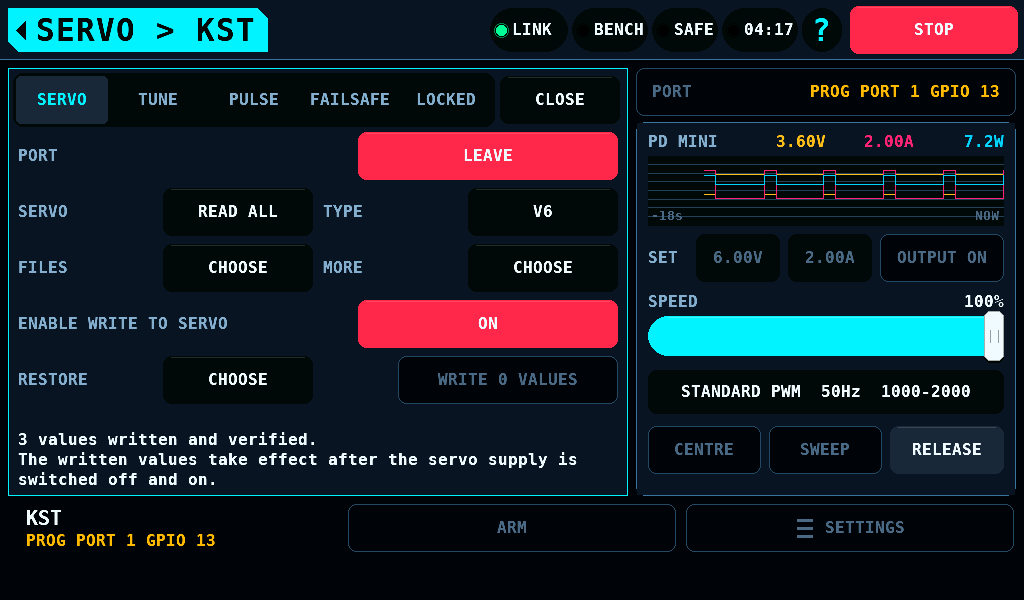
docs/img/servo-kst-nofile.png
