subtilitas/rcbench/docs/img/servo-kst-other.png

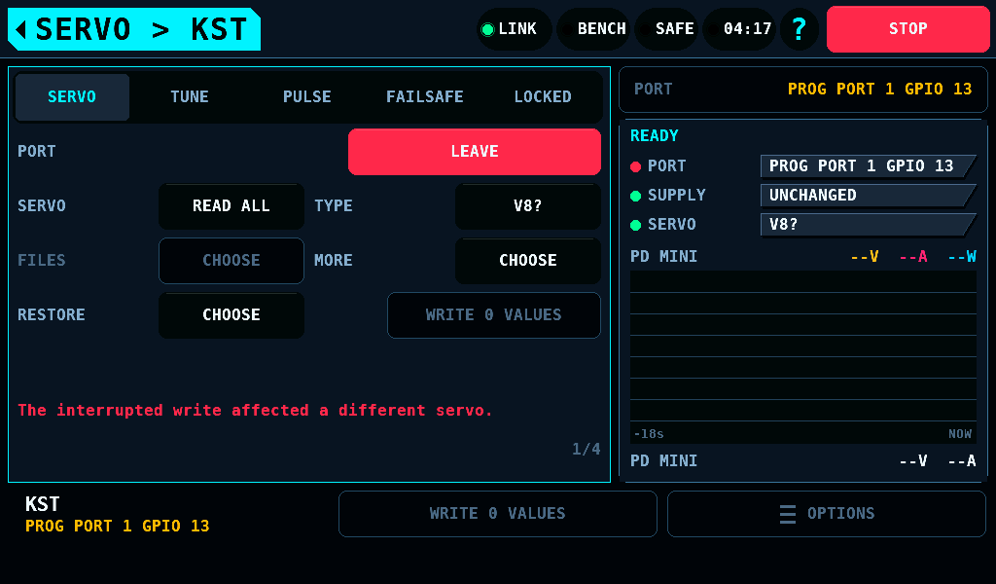
docs/img/servo-kst-other.png
