subtilitas/rcbench/docs/img/servo-kst-pulse.png

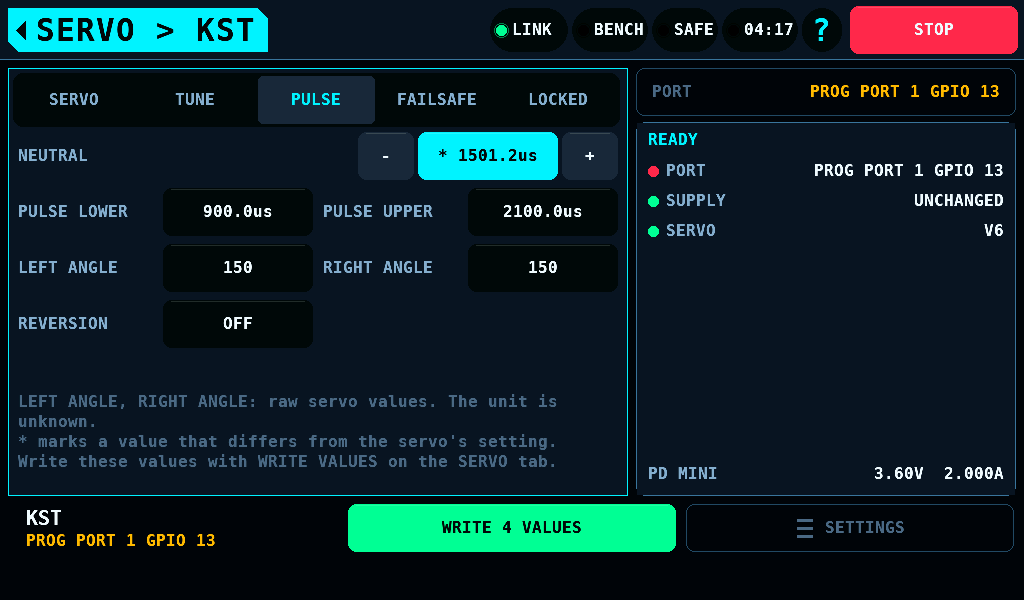
docs/img/servo-kst-pulse.png
