subtilitas/rcbench/docs/img/servo-kst-restore-check.png

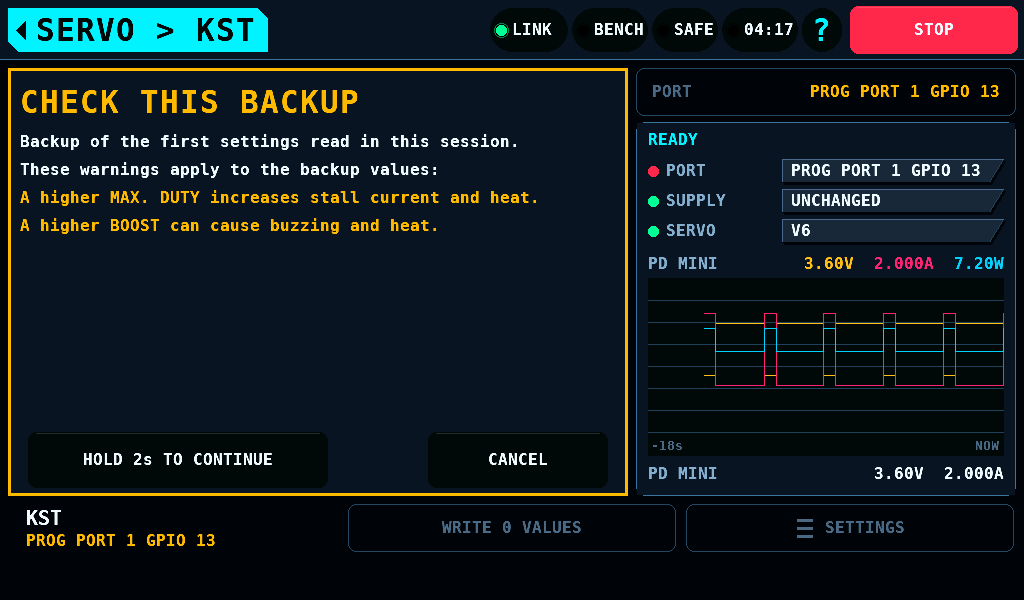
docs/img/servo-kst-restore-check.png
