subtilitas/rcbench/docs/img/servo-kst-restore-list.png

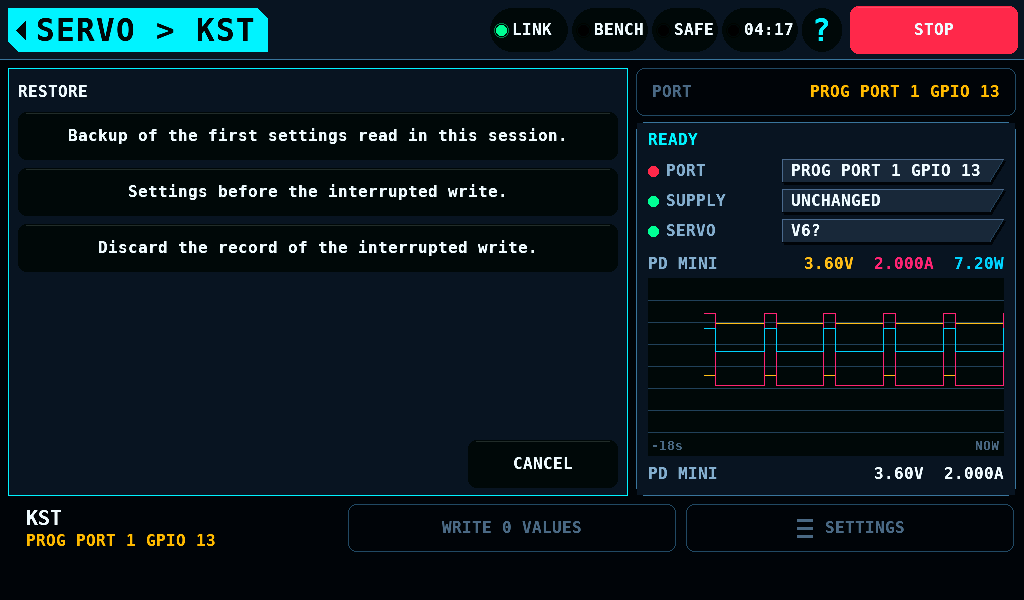
docs/img/servo-kst-restore-list.png
