subtilitas/rcbench/docs/img/servo-kst-supplied.png

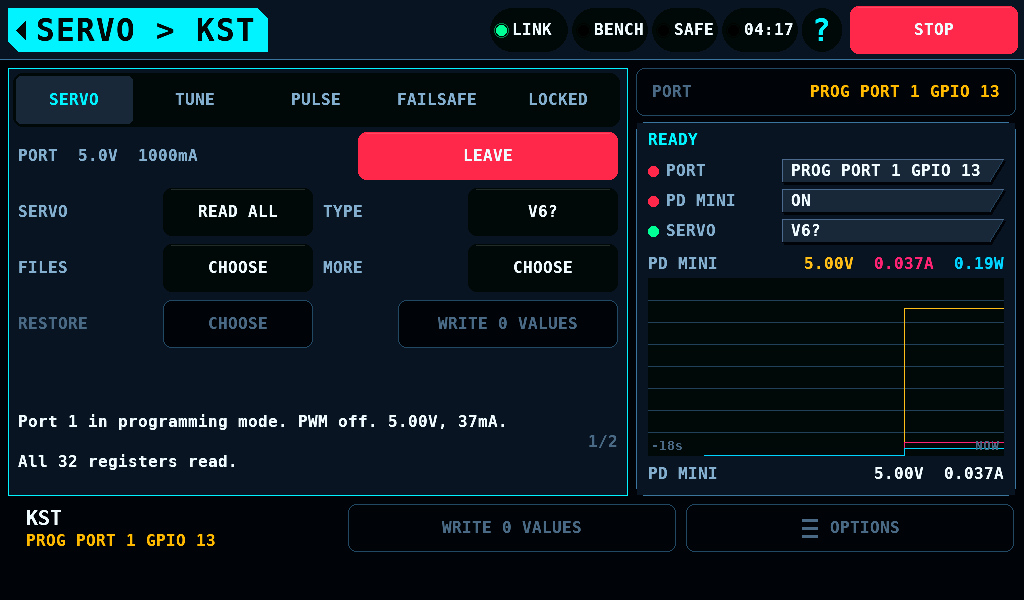
docs/img/servo-kst-supplied.png
