subtilitas/rcbench/docs/img/servo-kst-swapped.png

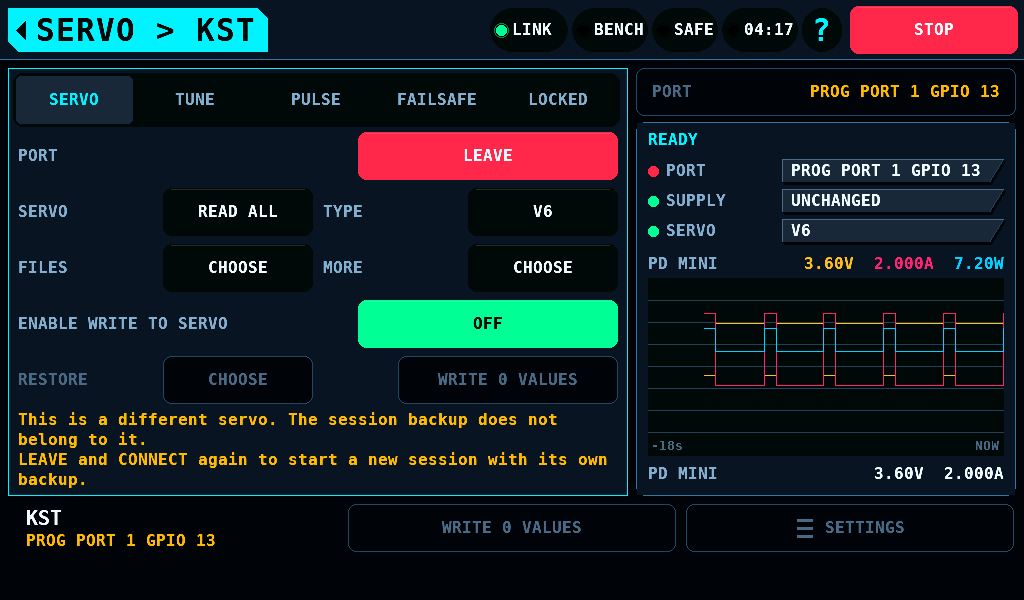
docs/img/servo-kst-swapped.png
