subtilitas/rcbench/docs/img/servo-kst-target.png

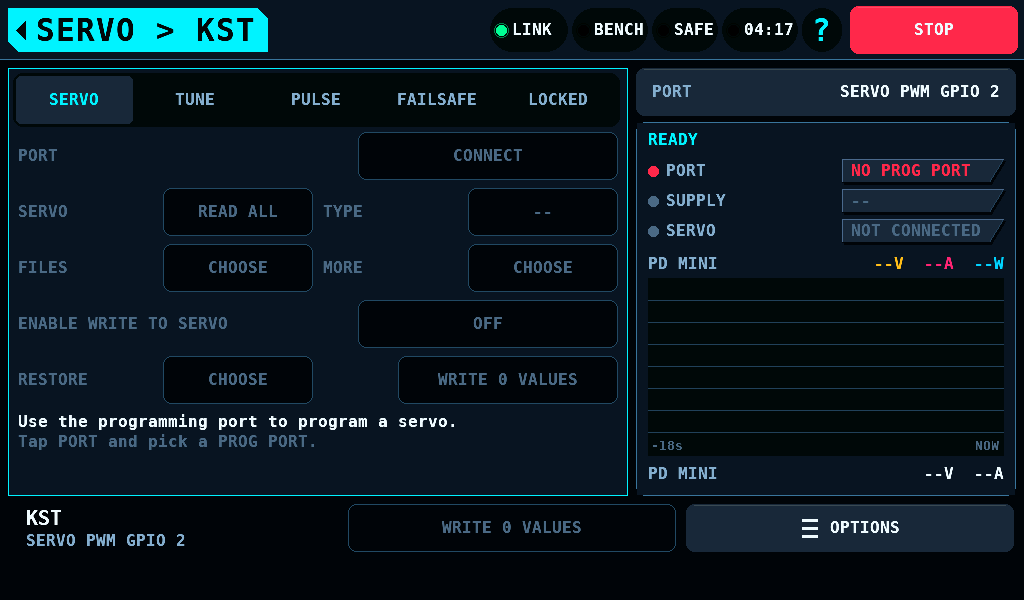
docs/img/servo-kst-target.png
