subtilitas/rcbench/docs/img/servo-kst-working.png

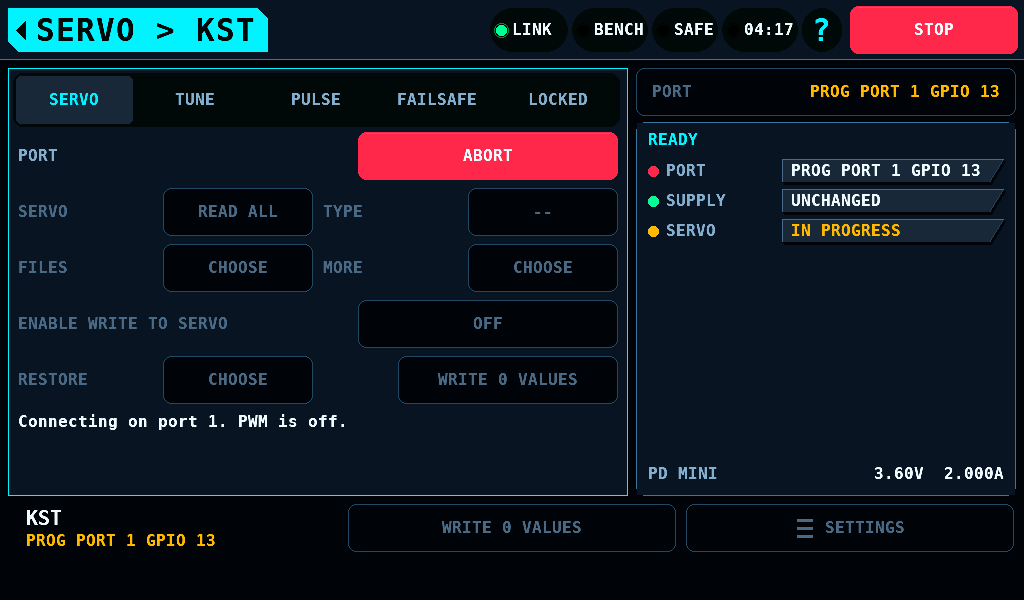
docs/img/servo-kst-working.png
