subtilitas/rcbench/docs/img/servo-kst-write-nocard.png

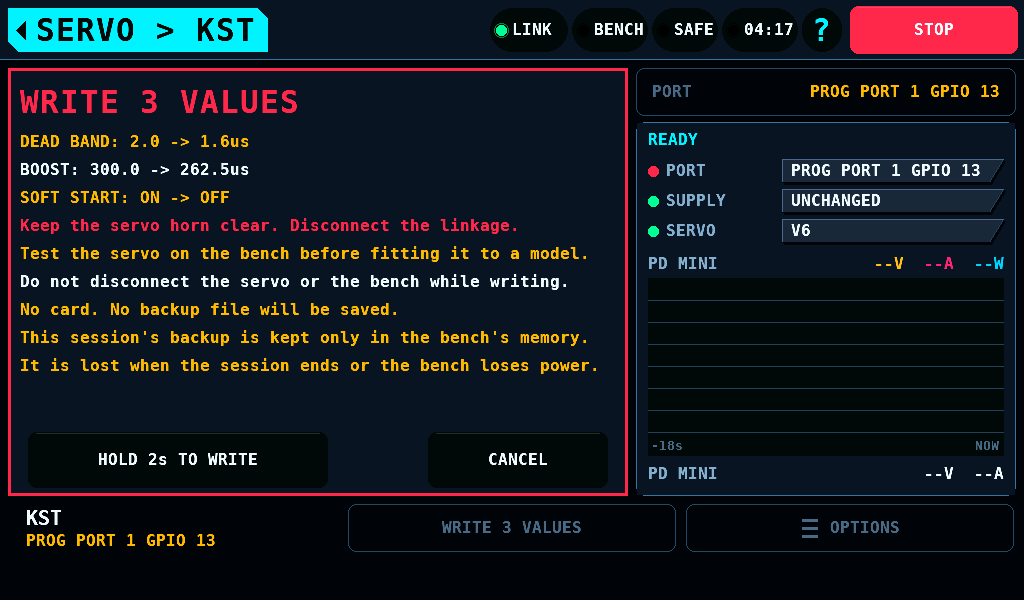
docs/img/servo-kst-write-nocard.png
