subtilitas/rcbench/docs/img/servo-kst-write.png

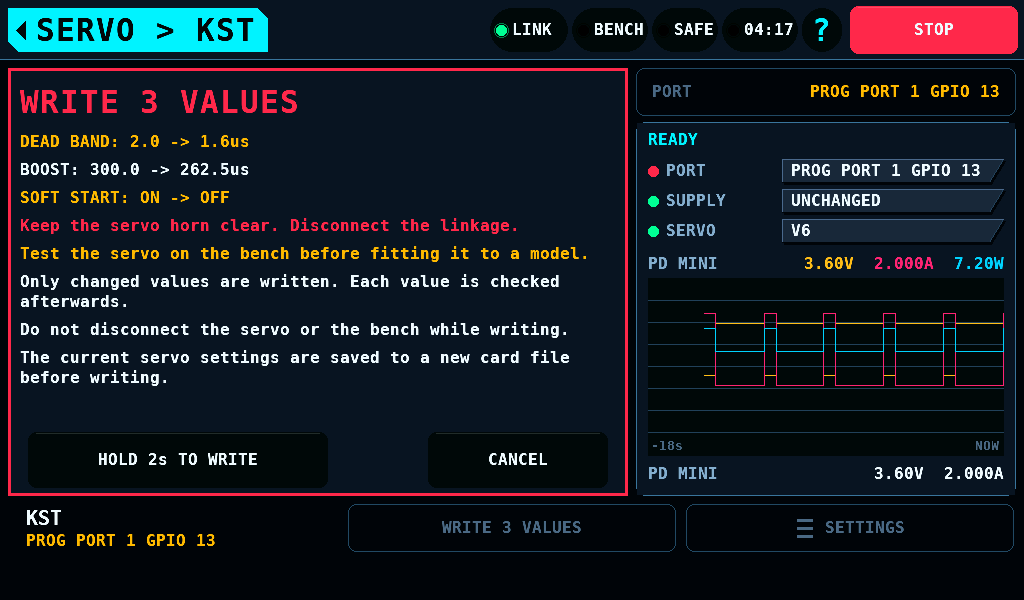
docs/img/servo-kst-write.png
