subtilitas/rcbench/docs/img/servo-kst-writing.png

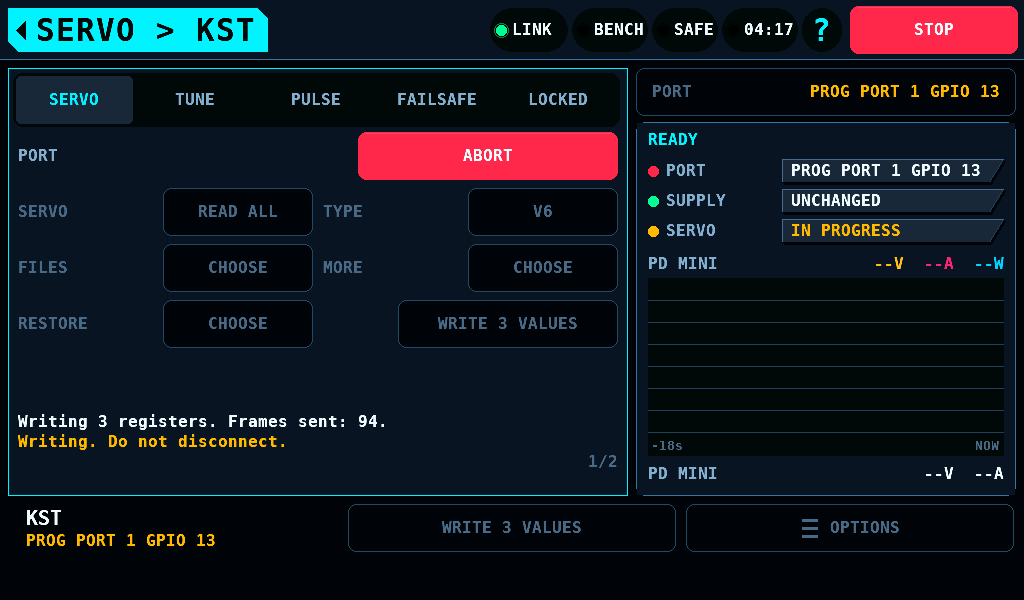
docs/img/servo-kst-writing.png
