subtilitas/rcbench/docs/img/servo-name.png

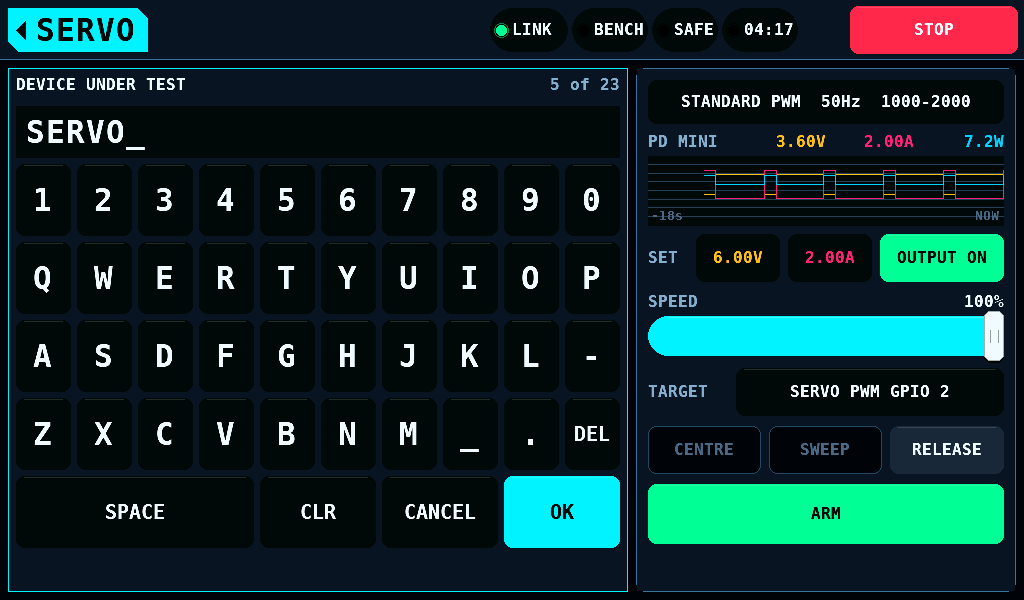
docs/img/servo-name.png
