subtilitas/rcbench/docs/img/servo-rudder-angle.png

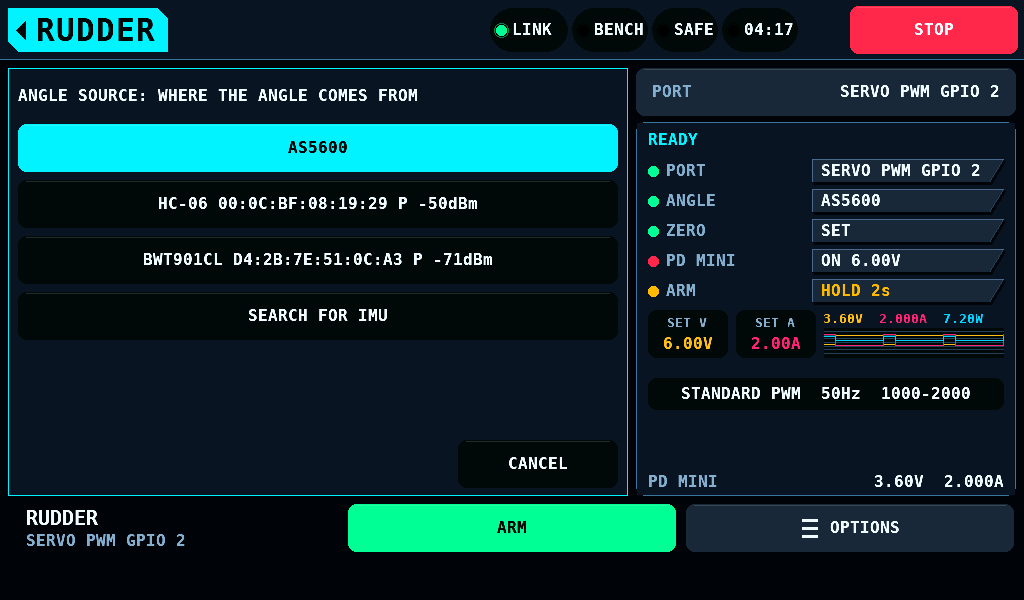
docs/img/servo-rudder-angle.png
