subtilitas/rcbench/docs/img/servo-sweep.png

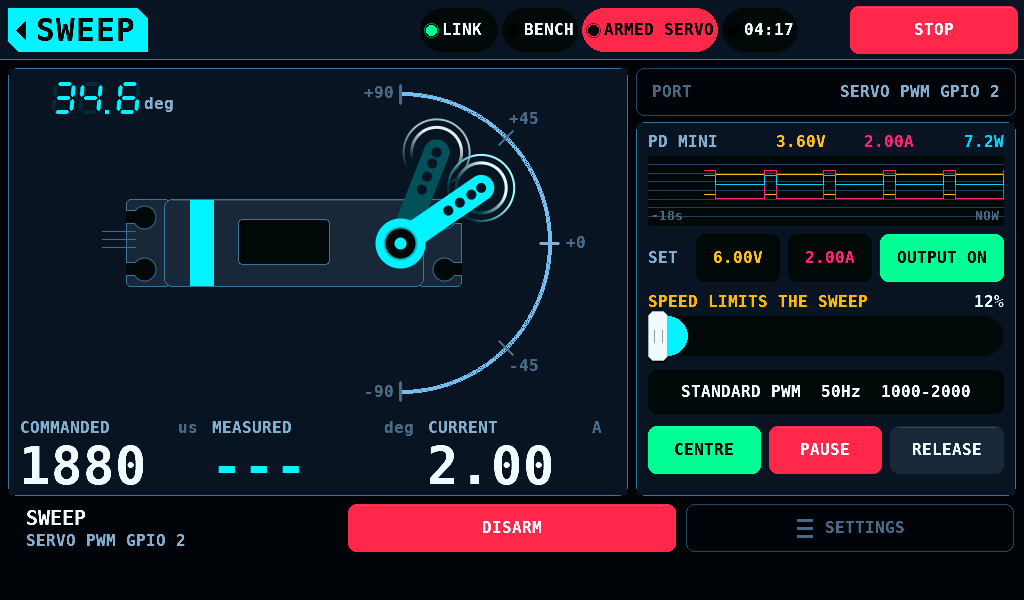
docs/img/servo-sweep.png
