subtilitas/rcbench/docs/img/supply-confirm.png

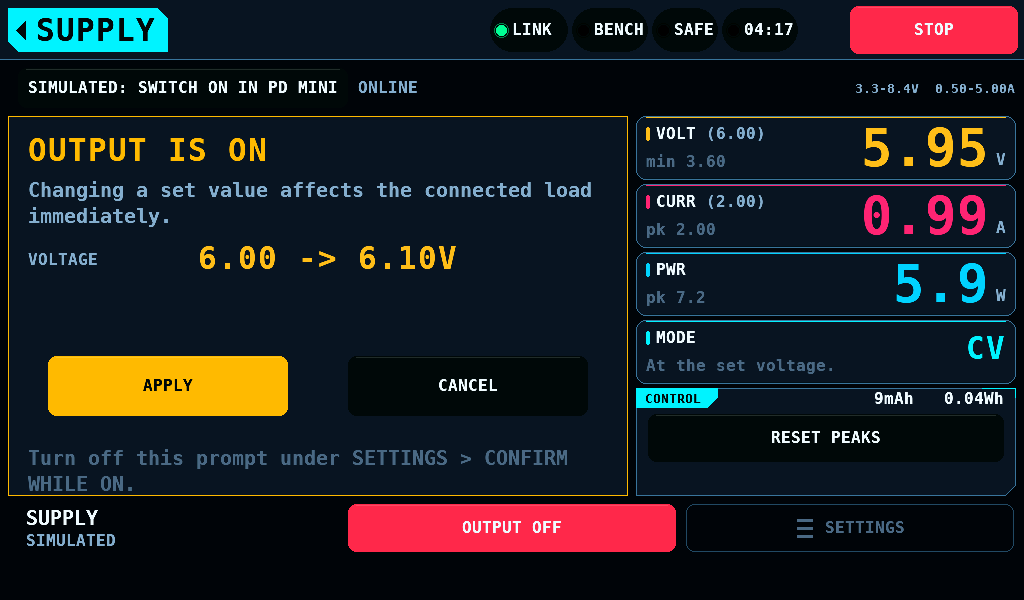
docs/img/supply-confirm.png
