subtilitas/rcbench/docs/img/supply-keypad.png

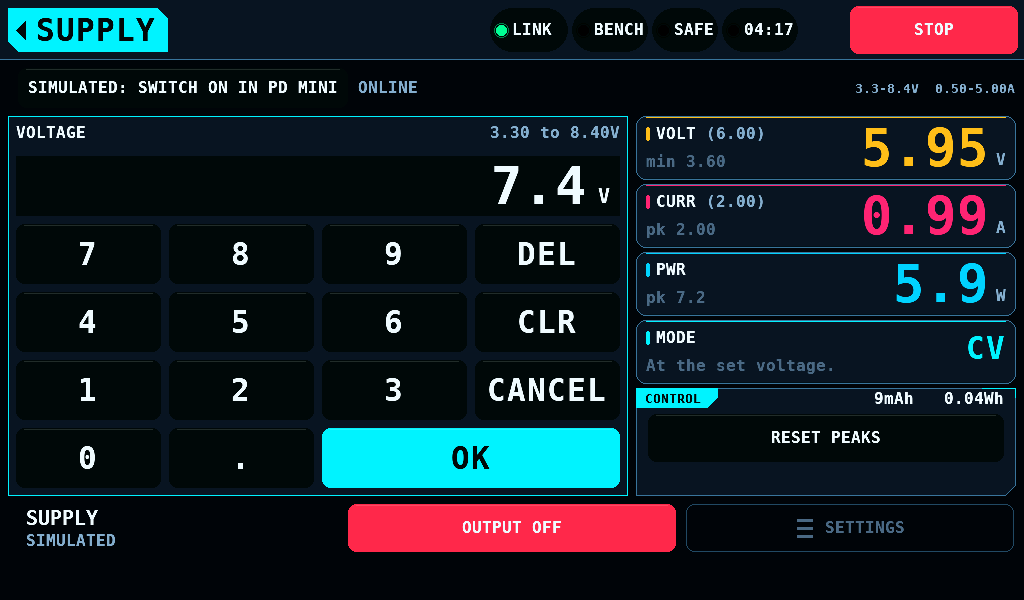
docs/img/supply-keypad.png
