subtilitas/rcbench/docs/img/supply.png

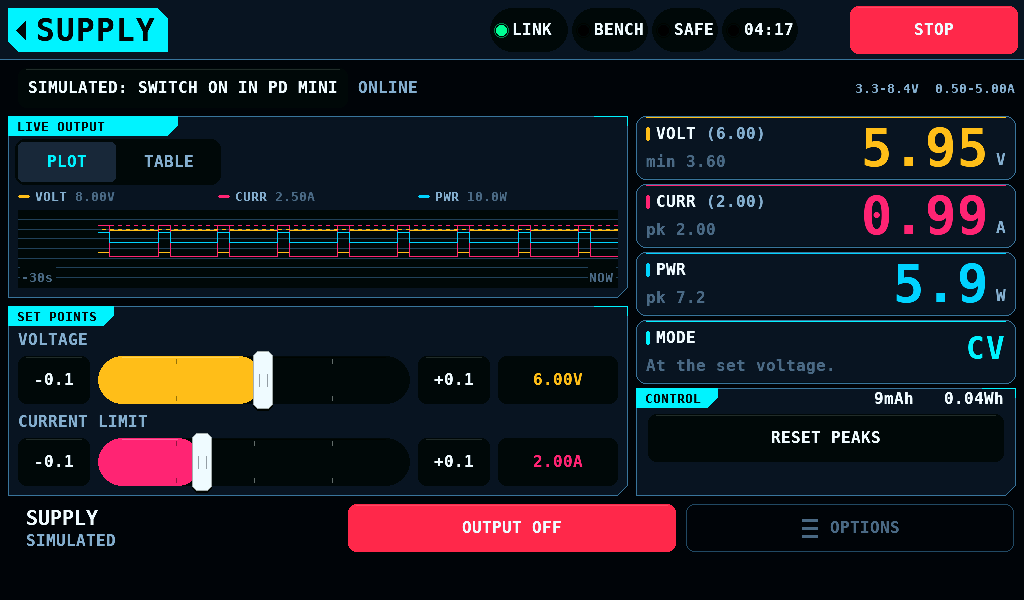
docs/img/supply.png
