subtilitas/rcbench/docs/img/updates-coproc.png

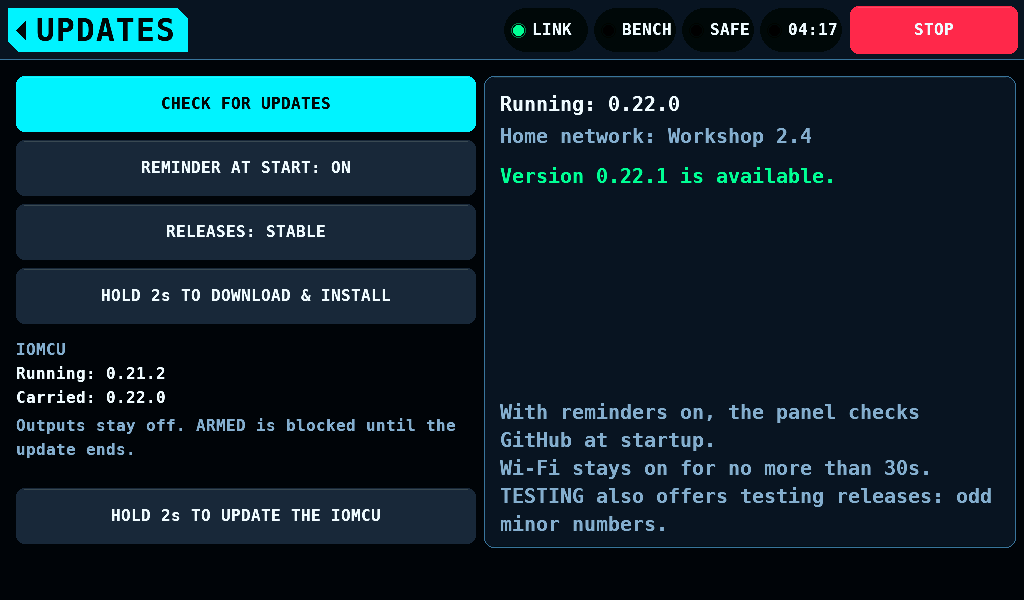
docs/img/updates-coproc.png
