subtilitas/rcbench/docs/img/updates-current.png

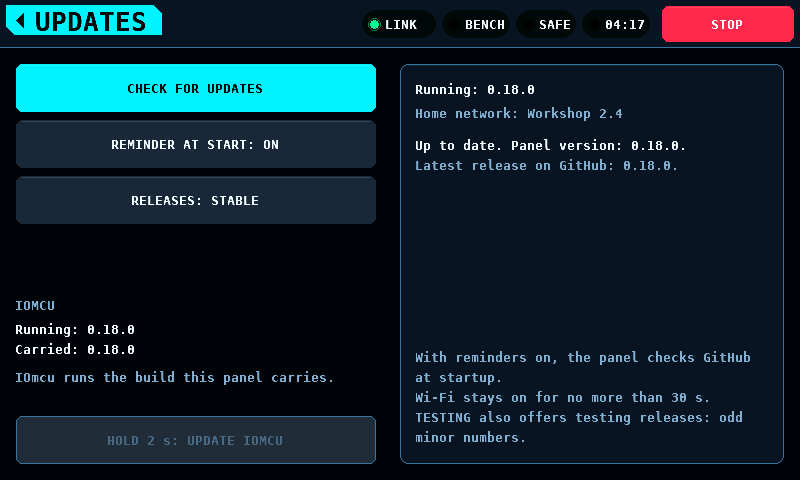
docs/img/updates-current.png
