subtilitas/rcbench/docs/img/wifi-ap.png

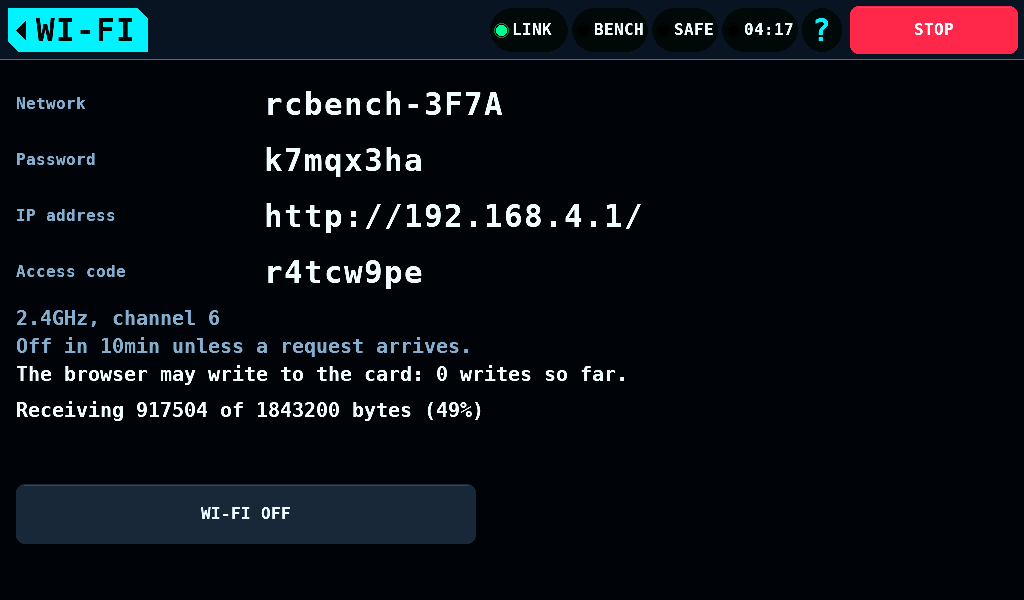
docs/img/wifi-ap.png
