subtilitas/rcbench/docs/img/wifi-home.png

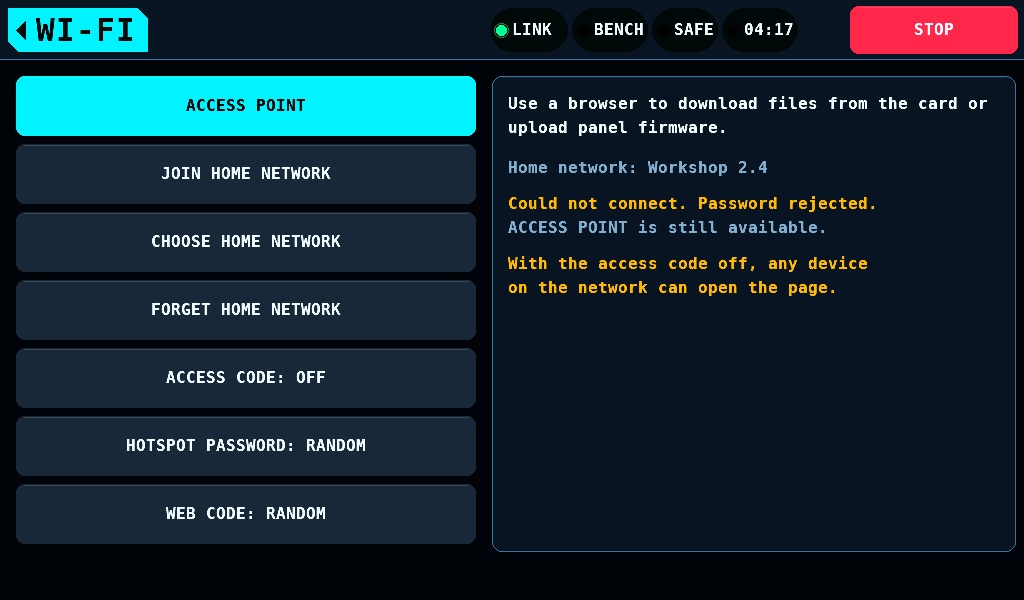
docs/img/wifi-home.png
