subtilitas/rcbench/docs/img/wifi-joining.png

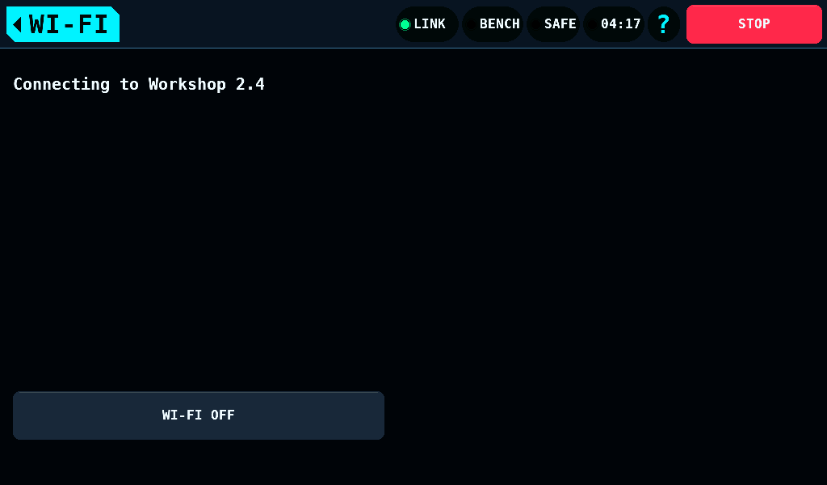
docs/img/wifi-joining.png
