subtilitas/rcbench/docs/img/wifi-key-shown.png

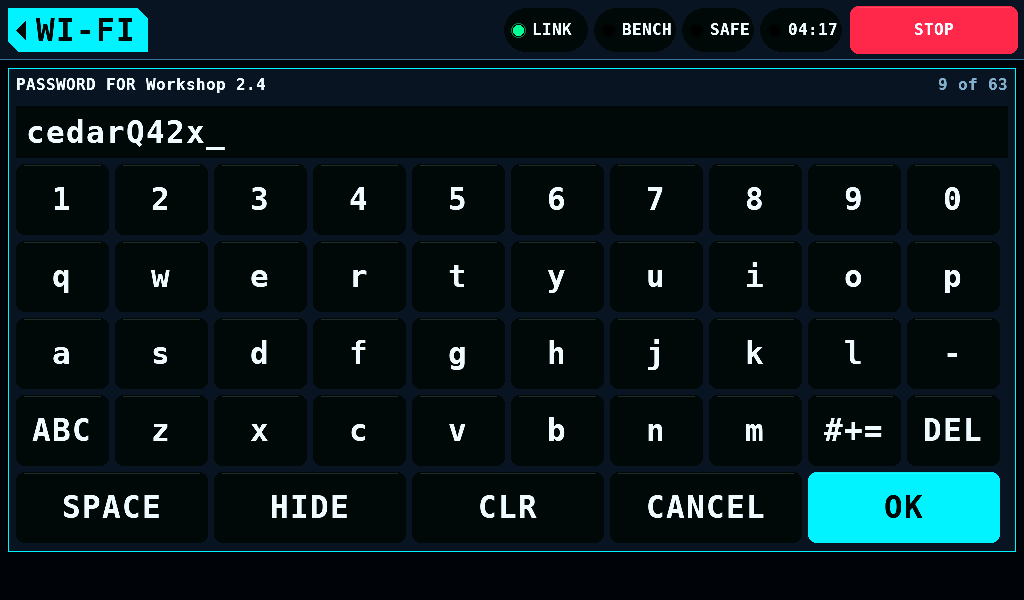
docs/img/wifi-key-shown.png
