subtilitas/rcbench/docs/img/wifi-key-ssid.png

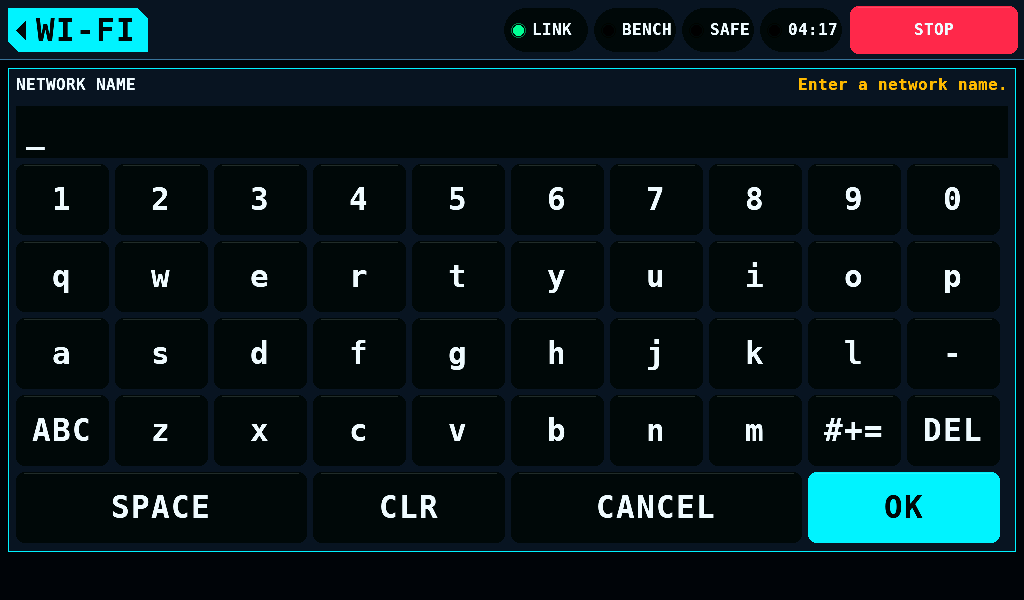
docs/img/wifi-key-ssid.png
