subtilitas/rcbench/docs/img/wifi-writes-hold.png

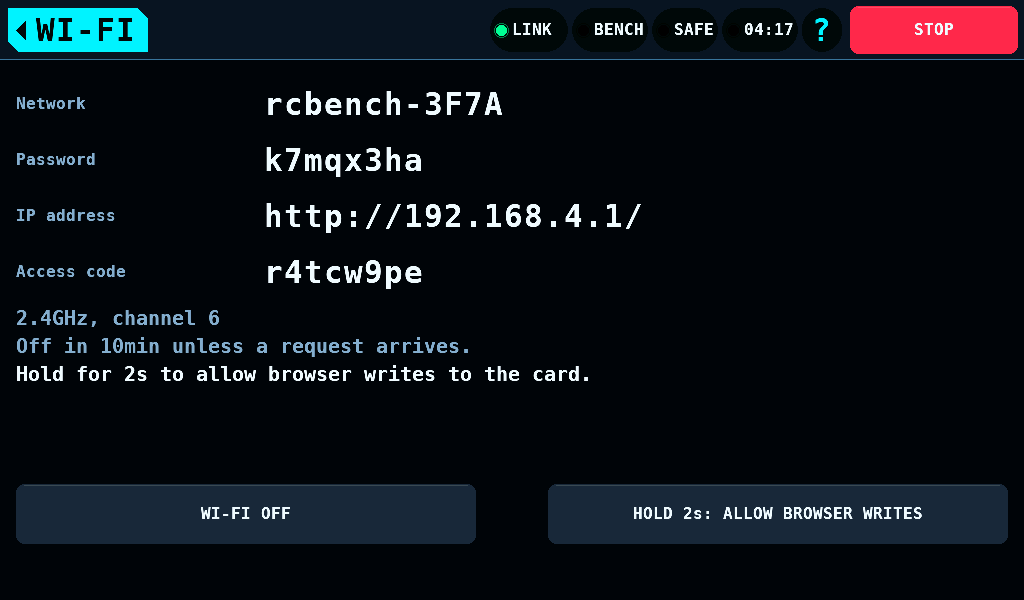
docs/img/wifi-writes-hold.png
