subtilitas/rcbench/hardware/kicad/renders/INA228_BIFRC_XT90_80x48mm.png

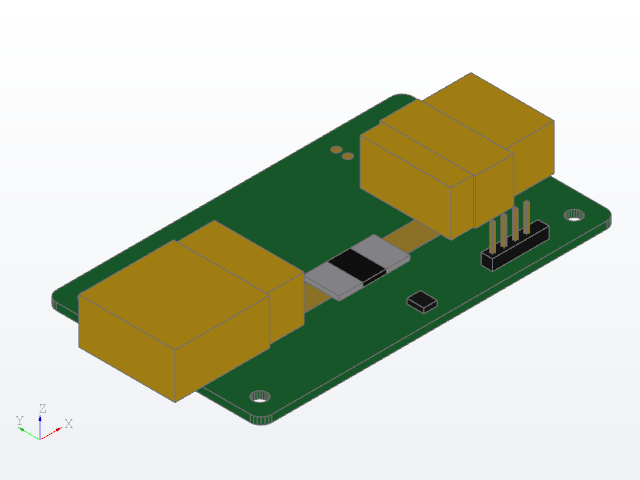
hardware/kicad/renders/INA228_BIFRC_XT90_80x48mm.png
