subtilitas/rcbench/hardware/kicad/renders/PD_Buck_WeAct_PDPowerMiniV1_61x40mm.png

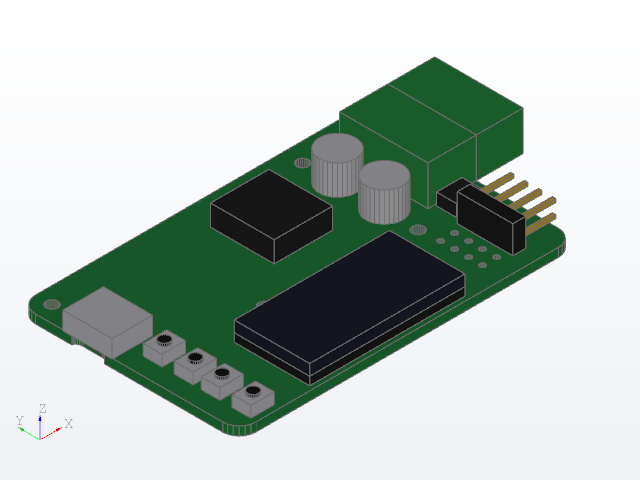
hardware/kicad/renders/PD_Buck_WeAct_PDPowerMiniV1_61x40mm.png
