subtilitas/rcbench/hardware/kicad/renders/USBC_PD_Trigger_DIP3_30x20mm.png

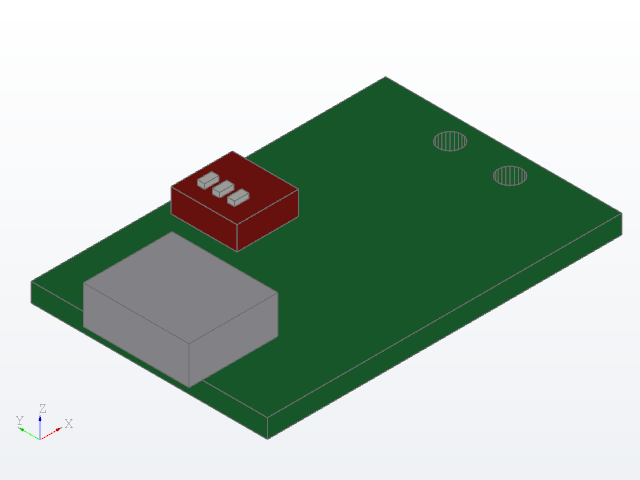
hardware/kicad/renders/USBC_PD_Trigger_DIP3_30x20mm.png
