subtilitas/rcbench/hardware/mechanical/renders/estop_m16_shim.png

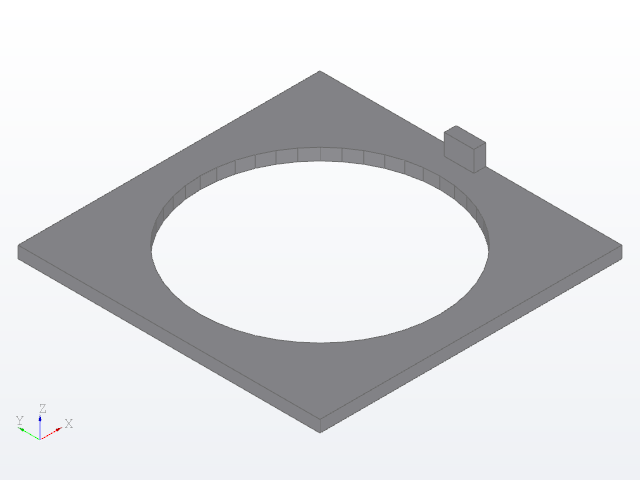
hardware/mechanical/renders/estop_m16_shim.png
