subtilitas/rcbench/hardware/mechanical/models/estop_m16_assembly.step

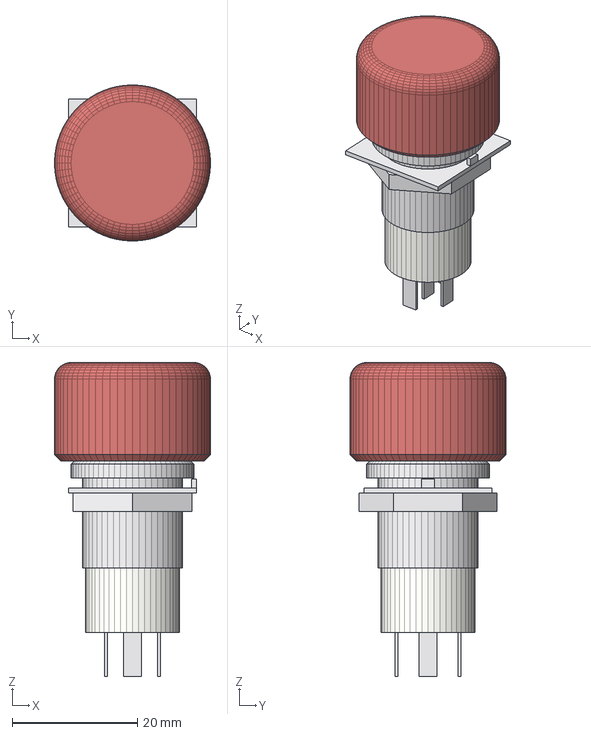
[picture p188: CAD file, 2026-10-28]
hardware/mechanical/models/estop_m16_assembly.step
24.9 x 24.9 x 50.1 mm
