subtilitas/rcbench/hardware/mechanical/models/m5dial.step

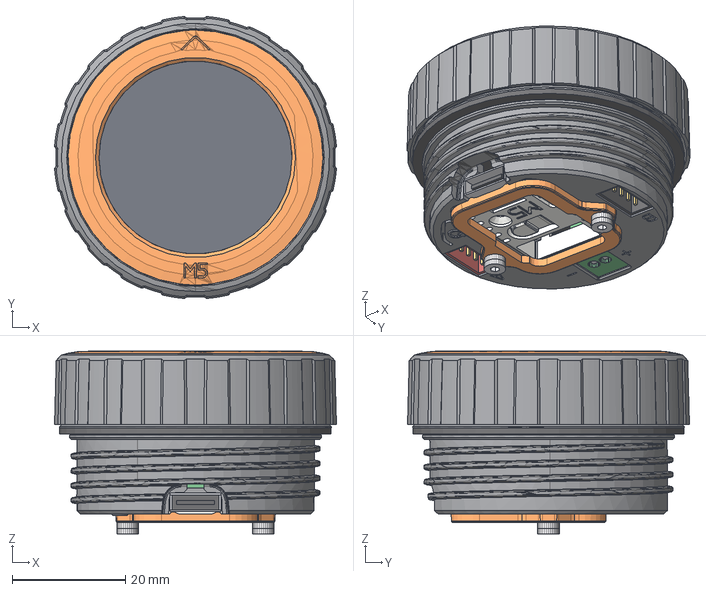
[picture p189: CAD file, 2026-11-14]
hardware/mechanical/models/m5dial.step
49.8 x 49.8 x 32.3 mm
