subtilitas/rcbench/hardware/mechanical/models/m5dial_nut.step

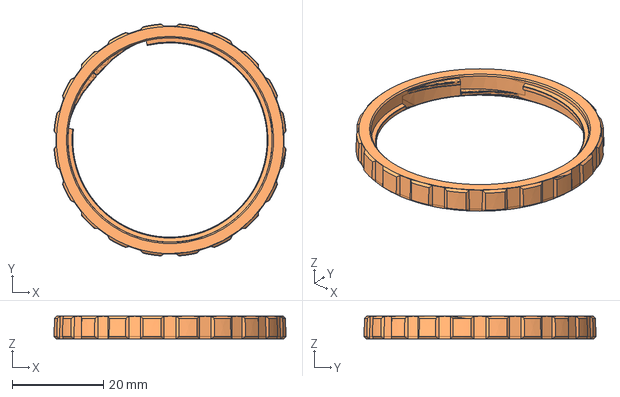
[picture p190: CAD file, 2026-11-14]
hardware/mechanical/models/m5dial_nut.step
50.8 x 50.8 x 5.00 mm
