subtilitas/rcbench/docs/Building-de.md

# Bauen

<sub>[English](Building.md) · **Deutsch**</sub>

Drei Builds verwenden denselben Quellbaum: die Host-Testsuite, die Panel-Firmware
(ESP-IDF, Espressif Internet-of-Things Development Framework) und die
IOmcu-Firmware (pico-sdk).

## Der Baum

```
rcbench/
  docs/                   Wiki-Quelle, Englisch und Deutsch
  tools/                  die Prüfungen, Generatoren und Messungen unten
  test/tools/             pytest-Fälle für die Werkzeuge
  test/web/               Playwright-Test des Dateimanagers der Wi-Fi-Seite
  shared/                 reines C: kein ESP-IDF, kein pico-sdk, keine FreeRTOS-Typen
    gfx/                  Rasterizer, sieben Fonts und kantengeglättete Ring-Tabellen
    touch/                Koordinaten- und Event-Mapping
    ui/                   Theme · Widgets · Icons · Router · Bildschirme
    settings/             typisiertes Schema und Werte
    logfile/              Zahlen- und CSV-Parsing
    files/                Kern von Dateimanager und Editor: Textpuffer · Hervorhebung · Namen und Pfade · Kartentabelle · Fenster · Regeln · Aufträge
    link/                 Page-Protokoll · CAN-Framing · Watchdogs · Diagnose
    artwork/              Cache des Panels für Platinenzeichnungen
    bench/                bench_state · Telemetriesimulator · Log-Writer · Drehknopf-Decoder
    outputs/              Kanäle · Treibertabelle · Arming, Slew und Staleness
    safety/               Heartbeat-Generator (Panel) und -Monitor (IOmcu) · Reset-Ursache des IOmcu
    servo/                Endlagen- und Abgleichsuche · Servomodell
    can/                  Bit Timing für beide Controller · MCP2515-Register · Echo-Selbsttest · Sendewarteschlange
    esc/                  ESC-Programmierprofile, ihr JSON-Leser und die Registry
    sense/                Treiber für die Strommonitore INA228 und INA3221
    fwupdate/             Prüfung des Panel-Firmware-Images · Upload-Puffer · Installer · Update-Slots und BUY des IOmcu
    webaccess/            WLAN-Sitzung · Kartenliste und ZIP-Strom · die Seite · mDNS
    clock/                Regeln der Uhr: echtes Datum oder nicht · Zeitstempel · Zeitzonen · die NTP-Anfrage
    text/                 die Wörter der Oberfläche, alle Sprachen in einer Tabelle (nur Header)
    mstime/               überlaufsichere Vergleiche eines 32-Bit-Millisekundenzählers (nur Header)
    vibe/                 Messung der Unwucht: Index-Komparator · Demodulator für 1x, 2x und Blattfrequenz · Löser für zwei und vier Läufe
    dial/                 die Faces des M5Stack Dial: Listen, Werte, Messwerte und Ringe, Link und Binden; auf dem Host gerendert
  protocols/              ein Modul je externem Interface: ein Kern in reinem C, sein RP2350-Pin-Treiber in rp2350/, eine README.md
    dshot/                DShot-Frames · GCR-Dekodierung · eRPM · PIO-Treiber, einfach und bidirektional
    ppm/                  PPM-Frame-Layout · PIO- und DMA-Treiber
    sbus/                 S.BUS-Decoder; kein Pin-Treiber
    openyge/              OpenYGE-Framing, CRC, Status und Parameter-Cache; kein Pin-Treiber
    pdmini/               PD-mini-Treiber · PIO-UART
    phase_tap/            ESC-Ton-Detektor · Leser des Flankenrings · PIO-Capture
    kst/                  Programmierung von KST- und Chaservo-Servos: Frames, Register, Grenzen, Schreibpläne, Session · rp2350: kst_line.pio · kst_line
    hitec/                Leitung der Hitec-Servos, beide Familien: Frames, Transaktionen, Decoder der Antworten · rp2350: hitec_line.pio · hitec_line
    escwire/              ESC-Einstellungen über die Signalleitung: Protokoll A, Textschnittstelle, Prüfung jedes Frames, Erkennung, Feldtabellen, Sitzung · rp2350: ew_line.pio · ew_line
    hc05/                 AT-Einrichtung eines HC-05-Bluetooth-Moduls: Probe, Scan, Bind, Connect to any; kein Pin-Treiber; nur die Host-Suite
    bleuart/              BLE-Central für den ISSC-Transparent-UART-Dienst: Advertising-Parser, Scan-Liste, Connect, Discovery, Subscribe, Schreiben, Reconnect; kein Pin-Treiber
    i2c_txq/              I2C-Transaktionswarteschlange: früheste Deadline, Timeouts, Leitungsprüfung, Bus-Clear · rp2350: i2c_txq_block auf einem I2C-Block, kein PIO-Programm
    witmotion/            WitMotion-IMU-Frames: Parser, Decoder, Befehlsencoder; kein Pin-Treiber
    dialknob/             Knopfprotokoll des M5Stack Dial: Pakete in beide Richtungen, Drehungs-Tracker, Link-Zustand, Face-Modell; kein Pin-Treiber
    rcnode/               BLE-Pakete, Steuer-Writes, Advertising und 20ms-Fenster der Sensorknoten; kein Pin-Treiber
  firmware/
    panel/                ESP-IDF-Projekt (ESP32-P4)
    iomcu/                pico-sdk-Projekt (RP2350)
    dial/                 ESP-IDF-Projekt (ESP32-S3): das M5Stack Dial ([Das M5Stack Dial](Dial-de.md))
    node/                 ESP-IDF-Projekt (ESP32-C6): die Sensorknoten ([Die Sensorknoten](Nodes-de.md))
  test/host/              die Host-Suite, eine Binary je Modul oder Bildschirm
  hardware/               Platinen-Designprotokoll; keine Platine existiert
```

Module unter `shared/` enthalten die Logik und haben keine
Hardwareabhängigkeit. Ein Modul unter `protocols/` ist ein Interface zu
externer Hardware und so aufgebaut, dass es sich in ein anderes pico-sdk-Projekt
kopieren lässt: sein Kern bindet nur C-Standard-Header ein, sein Ordner
`rp2350/` nur den Kern und das pico-sdk. Der übrige Code mit Hardwarezugriffen
liegt unter `firmware/`. `tools/check_protocols.py` prüft diese Trennung für jedes Modul
([CONTRIBUTING](https://github.com/subtilitas/rcbench/blob/main/CONTRIBUTING.md#where-code-goes)).

### Zwei Verzeichnisse, drei Builds

Jedes Modul unter `shared/` und `protocols/` bringt eine `CMakeLists.txt`
mit, die unter `ESP_PLATFORM` eine IDF-Komponente registriert und sonst eine
statische Bibliothek:

```cmake
if(ESP_PLATFORM)
    idf_component_register(SRCS ${SRCS} INCLUDE_DIRS include)
else()
    add_library(rcbench_gfx STATIC ${SRCS})
    target_include_directories(rcbench_gfx PUBLIC include)
endif()
```

Das Panel setzt `EXTRA_COMPONENT_DIRS` auf `shared/` und auf jedes Modul
unter `protocols/`, das es nennt; IOmcu und Host-Suite holen die
Module, die sie brauchen, per `add_subdirectory()`. Ein Modul mit einem
Ordner `rp2350/` fügt seinen Pin-Treiber nur in einem pico-sdk-Build hinzu,
als INTERFACE-Bibliothek `rcbench_<modul>_rp2350`. Includes sind flach:
`#include "gfx.h"`.

| Modul | panel | iomcu | host |
| --- | :-: | :-: | :-: |
| `gfx` · `touch` · `ui` · `settings` · `logfile` · `files` · `sbus` | ja | | ja |
| `link` · `bench` · `outputs` · `servo` · `safety` · `can` · `text` · `mstime` · `fwupdate` | ja | ja | ja |
| `artwork` · `esc` · `webaccess` · `clock` | ja | | ja |
| `openyge` · `ppm` · `i2c_txq` | | ja | ja |
| `sense` · `pdmini` · `phase_tap` · `kst` · `hitec` · `dshot` | ja | ja | ja |
| `escwire` | ja | ja | ja |
| `witmotion` | ja | | ja |
| `hc05` · `dial` | | | ja |
| `bleuart` · `dialknob` · `vibe` · `rcnode` | ja | | ja |

## Toolchains

| | Version | Hinweise |
| --- | --- | --- |
| ESP-IDF | v6.1 | der ESP32-P4 des Panels ist Chiprevision 3.2, die Espressifs Hinweis AR2026-004 mit v5.5.5, v6.0.1 oder neuer paart; der Build setzt `CONFIG_ESP32P4_SELECTS_REV_LESS_V3=n` und Mindestrevision 3.1. Der TWAI-Code (Two-Wire Automotive Interface) des Panels nutzt den Legacy-Treiber, den v6.1 mit einem `#warning` als veraltet kennzeichnet; `components/can_twai` kompiliert mit `-Wno-cpp`. Der Legacy-Treiber von v6.1 sendet einen CAN-Frame mit DLC (Data Length Code) 0 als DLC 0; v5.5.0 und v5.5.1 senden ihn als DLC 8, und der IOmcu lehnt jeden so gesendeten Link-Read ab. Der SD-Karten-Code (`storage.c`) folgt der Slot-Behandlung des SDMMC-Treibers von v6.1, und v5.5.5 wird nicht gebaut. CI (Continuous Integration) baut v6.1 |
| pico-sdk | 2.0 oder neuer | RP2350-Unterstützung; CI baut 2.3.0 |
| ARM GNU Toolchain | 14.2 | jede `arm-none-eabi`-Version für Cortex-M33 |

`firmware/panel/sdkconfig.defaults` setzt den ESP32-P4 auf Chiprevision 3.1
oder neuer und 400MHz, 32MB Flash, das PSRAM im Gehäuse (PSRAM:
Pseudo-Static Random-Access Memory) auf 200MHz, Code und Konstanten im
Flash statt im PSRAM, die nullinitialisierten Daten, die
`main/psram_bss.lf` nennt, im PSRAM ([Interner RAM](Performance-de.md#interner-ram)),
den Interrupt des DSI-Hosts (DSI: Display Serial Interface), der auch
während einer Flash-Operation läuft (`CONFIG_LCD_DSI_ISR_CACHE_SAFE`), die
Partitionstabelle bei 0xC000, die dem Bootloader ab 0x2000 40.960 Bytes
lässt (er belegt mit Rollback und Log auf INFO 0x6140 Bytes), `-O2` und
die Konsole auf UART0 (UART:
Universal Asynchronous Receiver-Transmitter) mit USB-Serial-JTAG (die
eingebaute serielle und Debug-Bridge des Chips über USB, Universal Serial
Bus) als Zweitkonsole. Verwende diese Datei als Ausgangspunkt, nicht `menuconfig`.

ESP-IDF liest `sdkconfig.defaults` nur, wenn es `sdkconfig` erzeugt. Ein zuvor gebauter
Quellbaum enthält bereits `firmware/panel/sdkconfig`; diese Datei hat Vorrang.
Lösche sie nach einer Änderung der Defaults, sonst hat die
Änderung keine Wirkung auf das Image.

## Verdrahtung des Drehknopfs

Der Drehknopf ist ein magnetischer Winkelsensor MT6701 an einem eigenen
I2C-Bus (I2C: Inter-Integrated Circuit), dem zweiten I2C-Controller des
ESP32-P4, auf zwei freien Header-Pins der 7-Zoll-ESP32-P4-Displayplatine:
`BOARD_KNOB_PIN_SDA` und `BOARD_KNOB_PIN_SCL` in
`firmware/panel/components/board/include/board_pins.h`: GPIO30 (SDA) und
GPIO31 (SCL), die Pins IO30 und IO31 des 12-poligen Headers P3 (3V3, GND, IO2
bis IO5, IO28 bis IO31, IO34, IO36). Der Sensor nimmt 3,3V und GND vom
selben Header. Das Panel schaltet die internen Pull-ups des ESP32-P4 ein; ob
sie allein für 400kHz auf den Leitungen des Knopfs ausreichen, ist nicht gemessen.
Verwende bei einem Sensor ohne eigene Pull-ups daher Widerstände von 4,7kΩ nach 3,3V,
wie in der I2C-Schaltung des Datenblatts.

Der Sensor muss in seinem I2C/SSI-Modus sein (SSI: Synchronous Serial
Interface), MODE high. MODE low wählt die ABZ-Encoderausgänge, und der Sensor
antwortet dann nicht über I2C. Eine EEPROM-Einstellung (EEPROM: Electrically
Erasable Programmable Read-Only Memory) ist nicht nötig. Pins des MT6701CT im
SOP-8-Gehäuse, aus dem
[Datenblatt MagnTek MT6701, Version 1.9](https://atta.szlcsc.com/upload/public/pdf/source/20260616/FEB700C1922508565884FF0A90656B50.pdf)
(2024-05), Abschnitt 1 und Abbildung 17:

| MT6701-Pin | Anschluss an |
| --- | --- |
| 1 VDD | 3,3V vom Header. Die Versorgung des Datenblatts ist 3,3 bis 5,0V |
| 2 MODE | VDD. Ein interner Pull-up von 200kΩ hält einen offenen Pin high; Abbildung 17 legt ihn an VDD. Nie GND |
| 3 OUT | nicht angeschlossen; das Panel liest den Winkel über I2C |
| 4 GND | GND |
| 5 PUSH | nicht angeschlossen |
| 6A/SDA | SDA |
| 7B/SCL | SCL |
| 8 Z/CSN | VDD, wie Abbildung 17 |

Ein Breakout führt weniger Pins heraus. Prüfe, ob MODE an VDD liegt
(über einen Pin, eine Brücke oder einen Pull-up) und ob sein Versorgungspin 3,3V
verträgt. Die I2C-Schaltung des Datenblatts hat Pull-ups von 4,7kΩ an SDA und
SCL nach VDD; die eigenen Pull-ups eines Breakouts gehen an dessen VDD, hier
3,3V.

- Adresse: 0x06, die Voreinstellung des Datenblatts. Das Panel liest nur
  0x06. Eine EEPROM-Programmierung kann die Adresse auf 0x46 legen (Version
  1.9; Version 0.1 des Datenblatts nennt 0x26); ein so umgestellter Sensor
  wird nicht gelesen.
- Kein anderer Teil der Platine nutzt diesen Bus. Das Panel lehnt eine Adresse
  aus der Tabelle in `shared/bench/include/panel_i2c.h` ab: 0x00 bis 0x03
  und 0x78 bis 0x7F, die die I2C-Spezifikation reserviert, sowie 0x14 und
  0x5D, die beiden Adressen des Touch-Controllers GT911 am Touch-Bus. 0x06 liegt außerhalb. Es ist
  einer der Hs-Mode-Mastercodes (Hs: High-Speed) der Spezifikation, 0x04
  bis 0x07, die kein Gerät an diesem Bus benutzt.
- Bustakt: 400kHz. Das Datenblatt erlaubt eine SCL-Periode (SCL: Serial
  Clock) ab 1us und Anstiegs- und Abfallzeiten von höchstens 150ns. Die
  Anstiegszeit am Anschluss ist nicht gemessen.
- Der Magnet ist eine diametral magnetisierte Scheibe, mittig über dem Chip.
- Die I2C-Register tragen keinen Feldstatus: Die Bits für zu schwaches und
  zu starkes Feld stehen nur im SSI-Rahmen. Ein Sensor ohne Magnet darüber
  antwortet trotzdem mit einem Winkel, und das Panel nimmt ihn als Messwert.
- Jede Abfrage liest 0x03, 0x04 und noch einmal 0x03 und verwirft eine
  Abfrage, deren zwei 0x03-Bytes sich unterscheiden. Ein High-Byte, das sich
  dazwischen ändert und wieder zurückändert, wird angenommen; ein Schritt von
  bis zu 64 Zählern (0,52% des Wegs bei 270deg) an einem Reglerende bleibt
  also möglich; wie oft, ist nicht gemessen.
- Drehrichtung: Beim MT6701CT-STD mit DIR (Register 0x29 Bit 1, im EEPROM)
  auf seinem Standard 0 steigt der Winkel gegen den Uhrzeigersinn, von der
  Chipoberseite gesehen. Das Panel zählt umgekehrt, also erhöht mit dem
  Magneten über der Chipoberseite eine Drehung im Uhrzeigersinn den
  Throttle. Ein MT6701CT-STV, dessen Winkel im Uhrzeigersinn steigt, ein
  Teil mit DIR = 1 oder ein von unten gesehen montierter Sensor dreht den
  Knopf andersherum.

Der Knopf ist deaktiviert, bis du unter SETUP, PANEL die Einstellung `Drehknopf` einschaltest.
[Bildschirme](Screens-de.md#panel-der-drehknopf) beschreibt seine Funktion.

## Der Header des Touch-Busses

Der Touch-Bus ist `I2C_NUM_0` mit `BOARD_I2C_PIN_SDA` GPIO7 und
`BOARD_I2C_PIN_SCL` GPIO8 bei `BOARD_I2C_FREQ_HZ` 400.000Hz
(`firmware/panel/components/board/include/board_pins.h`). Auf dem
7-Zoll-Display-Board mit ESP32-P4 (Schaltplan vom 2025-09-25) erreicht er den
Touch-Controller GT911 (0x5D), den Audio-Codec ES8311, den Audio-ADC ES7210,
den Kameraanschluss und einen 4-poligen I2C-Header. Der Header führt SDA
(GPIO7) und SCL (GPIO8) dieses Busses. Der Siebdruck
ordnet seine vier Pins VCC, GND, SDA, SCL (Foto der Platine vom Projektinhaber,
2026-10-22). Ein Jumper neben dem Pin VCC wählt 5V oder 3V3 dafür; seine
Werksstellung ist nicht bekannt. Prüfe den Jumper vor dem ersten Anschluss mit einem
Multimeter. Ob der Bus
auf der Platine Pull-ups hat, ist nicht gemessen. Der Touch-Injector
(`testbench/touch-injector/README.md`) und die Analyser-Leitungen aus
`testbench/WIRING.md` schließen hier an. Der Knopf liegt nicht an diesem Header: Er hat einen eigenen Bus
([Verdrahtung des Drehknopfs](#verdrahtung-des-drehknopfs)).

## Die Uhr des Panels

Die 7-Zoll-Anzeigeplatine mit ESP32-P4 (Waveshare
ESP32-P4-WIFI6-Touch-LCD-7B, Schaltplan vom 2025-09-25) trägt keinen
RTC-Chip (Real-Time Clock). Ihr I2C-Bus (GPIO7, GPIO8) erreicht den
Touch-Controller GT911 (0x5D), den Audio-Codec ES8311, den Audio-ADC ES7210
(Analog-Digital-Wandler), den Kameraanschluss und den 4-poligen I2C-Stecker;
keiner davon führt eine Uhr. Waveshares Board
Support Package 3.0.1 und seine Demo-Firmware (Commit 9fcd49a8 vom
2026-08-21) haben keinen RTC-Treiber; die Demo stellt ihre Uhr über SNTP
(Simple Network Time Protocol). Die Platine enthält folgende Bauteile für die Uhr des ESP32-P4:

| Teil | Was es ist | Nutzung im Panel |
| --- | --- | --- |
| Y3 | Quarz 32.768kHz, 2,0 x 1,2mm, 22pF nach GND auf jeder Seite, 10MΩ parallel, an GPIO0 (XTAL_32K_N) und GPIO1 (XTAL_32K_P) | genutzt: Der RTC-Timer zählt ihn (`CONFIG_RTC_CLK_SRC_EXT_CRYS` in `firmware/panel/sdkconfig.defaults`); ein Quarz, der nicht anschwingt, lässt ihn auf dem internen RC-Oszillator |
| BAT1 | Knopfzellenhalter CR1220, "RTC BAT", an VDD_BAT des ESP32-P4 (Pin 102); 3V3 lädt ihn über D1 (B5819WS) ohne Vorwiderstand; C41 1uF | nicht genutzt. Waveshare: nur wiederaufladbare Zellen mit 3 bis 3,3V. Ob eine Platine mit Zelle kommt, ist nicht bekannt |

Der ESP32-P4 kann seinen RTC-Timer an VDD_BAT weiterlaufen lassen, aber nur
aus dem Deep Sleep: Espressifs Anleitung zur Batteriepufferung des ESP32-P4
(esp-iot-solution, "ESP32-P4 Battery Backup Solution") schaltet die
Low-Power-Domäne in der Schlafkonfiguration auf VBAT, nennt das ein
Testschema und ändert dafür ESP-IDF. Das Panel verliert seinen Strom ohne
Vorwarnung, über das Link-Kabel oder den Schalter, und geht nie in den Deep
Sleep. Eine Zelle in BAT1 erhält deshalb die Uhrzeit des Panels nicht.

Was das Panel stattdessen tut
([Bildschirme](Screens-de.md#panel-zeitzone-und-uhr)):

- Ein Einschalten startet die Systemzeit bei 1970-01-01 00:00:00 UTC. Ein
  Software-Neustart behält sie: ESP-IDF hält die Zeit im RTC-Timer und in
  zwei seiner Speicherregister, die nur ein Einschalten zurücksetzt
  (`CONFIG_LIBC_TIME_SYSCALL_USE_RTC_HRT`, die Vorgabe).
- Die Uhr ist so gut wie der langsame Takt des RTC-Timers. Mit dem Quarz Y3
  (32.768kHz) beträgt die Abweichung höchstens etwa 30ppm, gemessen über
  65min. Auf dem internen RC-Oszillator, der Rückfallebene, ist sie kein
  fester Wert: 584ppm über 2h04min in einem Lauf, unter 15ppm über 1h51min
  in einem anderen. Die Abweichung summiert sich nur über einen
  Hardware-Reset; ein Software-Neustart (`esp_restart`) setzt die Uhr bei
  der nächsten Verbindung wieder auf die NTP-Zeit.
- Jede Verbindung mit dem Heimnetz fragt `pool.ntp.org` einmal
  (`components/wifi_access/wifi_ntp.c`, `shared/clock/wall_clock.c`). Die
  zufällige Startverzögerung von lwIP ist aus
  (`CONFIG_LWIP_SNTP_STARTUP_DELAY=n`), also geht die Anfrage mit der
  Verbindung hinaus.
- FatFs stempelt Dateien aus `time()` über `localtime_r()` (ESP-IDF
  `components/fatfs/diskio/diskio.c`, `get_fattime()`), also gilt SETUP >
  PANEL, `Zeitzone` für die Zeitstempel. Ein Jahr vor 1980 wird als 1980
  gestempelt. FAT kennt keine Zone: Ein Zeitstempel ist die Ortszeit beim
  Schreiben, und ein späterer Wechsel der Zone verschiebt ihn nicht.
- Endet die Netzwerksitzung während einer laufenden Anfrage, bleibt das Funkteil
  für diese Anfrage eingeschaltet, höchstens 30000ms ab der Anfrage (`wall_ntp_holds()`,
  `wa_lingers()` in `shared/webaccess/wa_session.c`).
- Der SNTP-Client läuft in der lwIP-Task auf Kern 0. Die Wi-Fi-Worker-Task
  bearbeitet die Anfrage weiter. Die Steuer-Task auf Kern 1, die für STOP
  und den Heartbeat zuständig ist, liest keine Uhrzeit und wartet auf keinen
  dieser Vorgänge.

### Der langsame RTC-Takt

Der RTC-Timer zählt den Quarz Y3 mit 32.768kHz an GPIO0 und GPIO1. Keine
andere Funktion der Panel-Firmware nutzt diese beiden Pins. ESP-IDF v6.1
startet den Quarz und fällt auf den internen RC-Oszillator (136kHz
nominal) zurück, wenn er nicht anschwingt:

1. Der Bootloader schaltet den Quarz früh ein, damit er anschwingt,
   während die Anwendung lädt
   (`components/bootloader_support/src/bootloader_clock_init.c`, Zeilen 75
   bis 84). Auf dem ESP32-P4 tun die Bootstrap-Zyklen
   (`CONFIG_ESP_SYSTEM_RTC_EXT_XTAL_BOOTSTRAP_CYCLES`) nichts:
   `rtc_clk_32k_bootstrap()` schaltet nur den Quarz ein
   (`components/esp_hw_support/port/esp32p4/rtc_clk.c`, Zeilen 44 bis 50).
2. Der Start der Anwendung zählt 3000 Takte des Quarzes gegen den
   Hauptquarz mit 40MHz (`CONFIG_RTC_CLK_CAL_CYCLES=3000`), etwa 92ms.
   Eine Zählung, die in die Zeitgrenze läuft oder mehr als 0,05% von
   32.768kHz abweicht, gibt 0 zurück
   (`components/esp_hw_support/port/esp32p4/rtc_time.c`, Zeilen 177 bis
   195).
3. Eine Zählung mit 0 wird wiederholt, 4 Versuche insgesamt. Nach dem
   vierten schreibt ESP-IDF `clk: 32 kHz clock not found, switching to
   internal 150 kHz oscillator`, schaltet den Quarz ab und läuft auf dem
   RC (`components/esp_system/port/soc/esp32p4/clk.c`,
   `select_rtc_slow_clk()`, Zeilen 127 und 143 bis 152). Das Panel startet
   auf dem RC. Die Meldung von ESP-IDF sagt 150kHz; der RC des ESP32-P4
   hat nominal 136kHz.
4. `CONFIG_RTC_CLK_CAL_CYCLES` bleibt über 0: Bei 0 entfällt die Zählung,
   und der Quarz wird ungeprüft gewählt (`clk.c`, Zeile 143).

Bei jedem Start nennt die Konsole den langsamen Takt und seine kalibrierte
Frequenz (`log_clock_at_start()`, `firmware/panel/main/panel_settings.c`):

```text
I (...) clock: rtc slow clock 32k crystal, 32768.012Hz calibrated
W (...) clock: rtc slow clock internal RC, 136012.345Hz calibrated: the 32k crystal did not start
```

Geschätzte Startzeiten, aus den Taktzahlen im Quelltext berechnet, nicht gemessen:

| Langsamer Takt | Zählungen beim Start | Zeit |
| --- | --- | --- |
| Interner RC, `CONFIG_RTC_CLK_SRC_INT_RC` | 1024 Takte bei 136kHz | etwa 8ms |
| Quarz, der den ersten Versuch besteht | 3000 Takte bei 32.768kHz, zweimal | etwa 183ms |
| Quarz ohne Takt | 4 Versuche bis zur Zeitgrenze, dann 3000 Takte des RC | etwa 1,25s, wenn die Zeitgrenze von 3000 x 4096 Zählschritten in Takten zu 40MHz zählt; die Quellen von ESP-IDF nennen die Einheit nicht |

Ein Update vom Panel aus schreibt einen Anwendungsplatz und lässt den
Bootloader, wie er geflasht wurde. Ein Bootloader, der vor dieser
Einstellung gebaut ist, schaltet den Quarz nicht früh ein; der Start der
Anwendung schaltet ihn ein und zählt sofort. Ob ein Quarz dann innerhalb
der 4 Versuche besteht, ist nicht gemessen. Ein Flashen des ganzen Images
über USB schreibt auch den Bootloader.

Aktuelle Einschränkung: Ein Quarz, der nach dem Start stehen bleibt, wird
nicht erkannt. ESP-IDF v6.1 bietet auf dem ESP32-P4 keinen
XTAL32K-Watchdog. Die Systemzeit läuft über den Hauptquarz weiter (esp_timer),
während der RTC-Timer stehen bleibt. Der nächste Software-Neustart stellt die Uhr um
die dabei verlorene Zeit zurück.

## Befehle

```bash
# Host-Suite
cmake -S test/host -B test/host/build -DCMAKE_BUILD_TYPE=Debug
cmake --build test/host/build
ctest --test-dir test/host/build --output-on-failure

# Browser-Test des Dateimanagers der Wi-Fi-Seite (Der Browser-Test des
# Dateimanagers)
cmake --build test/host/build --target wa_page_dump
(cd test/web && npm ci && npx playwright install chromium \
  && WA_PAGE_DUMP=../host/build/wa_page_dump npm run e2e)

# Panel
. $IDF_PATH/export.sh
idf.py -C firmware/panel set-target esp32p4
idf.py -C firmware/panel build
idf.py -C firmware/panel -p /dev/ttyACM0 flash monitor    # COMx on Windows

# Panel mit den Farbbalken des DSI-Hosts für 3s beim Start, für einen
# ersten Blick auf eine Platine
idf.py -C firmware/panel -B firmware/panel/build-bars -D RCBENCH_DISPLAY_BARS=ON build

# Panel mit den IOmcu-Images, die es über CAN anbietet, dem des Moduls und
# dem des rbmod-Carriers; baue zuerst beide IOmcu-Images
idf.py -C firmware/panel -D RCBENCH_IOMCU_BIN=$PWD/firmware/iomcu/build/rcbench-iomcu.bin \
    -D RCBENCH_IOMCU_RBMOD_BIN=$PWD/firmware/iomcu/build-rbmod/rcbench-iomcu-rbmod.bin build

# Panel ohne Touch-Injector: jeder Panel-Build, auch der eines Releases,
# sucht beim Start einmal einen Touch-Injector an 0x14 neben dem Glas
# (testbench/touch-injector); RCBENCH_TOUCH_INJECTOR=OFF lässt diesen Code
# weg. Die Option steht standardmäßig auf ON
idf.py -C firmware/panel -B firmware/panel/build-noinject -D RCBENCH_TOUCH_INJECTOR=OFF build

# Panel ohne die Frame-, Stack- und Heap-Zeilen der Konsole (Performance-de.md,
# Auf dem Board); die Option RCBENCH_PERF_LOG steht standardmäßig auf ON,
# und der Release-Workflow baut mit OFF; für das Image eines Releases mit
# den Zeilen ohne das Flag bauen
idf.py -C firmware/panel -B firmware/panel/build-noperf -D RCBENCH_PERF_LOG=OFF build

# Panel als ein Image bei Offset 0 (der Bootloader des ESP32-P4 liegt darin
# bei 0x2000); es löscht die Einstellungen im NVS: das Image füllt
# 0xD000 bis 0x12FFF (NVS, 24.576 Bytes) mit 0xFF. `idf.py flash` schreibt
# nur 0x2000, 0xC000, 0x14000 und 0x20000 und behält NVS.
idf.py -C firmware/panel merge-bin -o rcbench-panel-merged.bin
esptool.py -p /dev/ttyACM0 write_flash 0x0 \
    firmware/panel/build/rcbench-panel-merged.bin

# IOmcu
export PICO_SDK_PATH=/path/to/pico-sdk
cmake -S firmware/iomcu -B firmware/iomcu/build
cmake --build firmware/iomcu/build

# IOmcu für den rbmod-Carrier: Dateien rcbench-iomcu-rbmod.*
cmake -S firmware/iomcu -B firmware/iomcu/build-rbmod -DIOMCU_BOARD=rbmod
cmake --build firmware/iomcu/build-rbmod

# IOmcu, Debug-Build, der die 1-ms-Samples von INA3221 CH1 ausgibt
cmake -S firmware/iomcu -B firmware/iomcu/build-trace -DSENSE_TRACE=ON
cmake --build firmware/iomcu/build-trace

# IOmcu, Prüfstands-Build, der Link-Pages von der USB-Konsole liest und
# schreibt (Die Prüfstandskonsole, BenchConsole-de.md); nicht mit SENSE_TRACE
cmake -S firmware/iomcu -B firmware/iomcu/build-console -DIOMCU_CONSOLE=ON
cmake --build firmware/iomcu/build-console
```

Der IOmcu-Build erzeugt drei UF2-Dateien (USB Flashing Format):

| Datei | Enthält | Für |
| --- | --- | --- |
| `rcbench-iomcu-install.uf2` | die Partitionstabelle bei 0x0 und das Image in Slot A | ein Modul ohne die Tabelle: das eine USB-Laden aus [Erster Lauf](FirstRun-de.md#die-partitionstabelle-des-iomcu) |
| `rcbench-iomcu.uf2` | nur das Image | ein Modul mit der Tabelle; das Boot-ROM schreibt es in den Slot, der nicht läuft |
| `rcbench-iomcu-pt.uf2` | nur die Partitionstabelle | `picotool` |

Kopiere eine davon auf das Massenspeicherlaufwerk des Moduls, während du das
Modul in BOOTSEL hältst. `rcbench-iomcu.bin` ist das Image, das das
Panel mitbringt: die Build-Option `RCBENCH_IOMCU_BIN` des Panels nimmt seinen
Pfad, und das Panel bietet es dann über CAN an
([Link](Link-de.md#firmware-update-über-den-link)). Ein Panel ohne die Option
bietet kein IOmcu-Update an.

`IOMCU_BOARD` wählt das Board, für das das Image gebaut wird: `rp2350_can`
(Standard), das von Hand verdrahtete Modul, oder `rbmod`, der Carrier mit
verlöteten Pins ([Link: Boards mit verlöteten
Pins](Link-de.md#boards-mit-verlöteten-pins)). Die Dateien des Carriers
heißen `rcbench-iomcu-rbmod-install.uf2`, `rcbench-iomcu-rbmod.uf2`,
`rcbench-iomcu-rbmod-pt.uf2`, `rcbench-iomcu-rbmod.bin` und
`rcbench-iomcu-rbmod.elf`. Die Panel-Option `RCBENCH_IOMCU_RBMOD_BIN` nimmt
die `.bin` des Carriers. Das Panel bietet jedem IOmcu das Image für das von ihm gemeldete Board
an. Enthält das Panel kein Image für dieses Board, bietet es kein Update an.

`PICO_BOARD` steht standardmäßig auf `pimoroni_pico_plus2_rp2350`. Das für die
Inbetriebnahme verwendete Modul ist ein Waveshare RP2350-CAN (RP2350A, 4MB
Flash), für das das SDK (Software Development Kit) keine Board-Datei hat; der
Standardwert erzeugt ein darauf lauffähiges Image. Überschreibe ihn bei Bedarf mit `-DPICO_BOARD=`. Die
endgültige Platine braucht einen RP2350B: der geplante Pinbedarf liegt bei 27
bis 32 GPIO (General-Purpose Input/Output).

## Werkzeuge

| Werkzeug | Zweck |
| --- | --- |
| `tools/coverage.py` | misst die Line Coverage der Host-Suite, erzwingt die Untergrenzen (94% gesamt, 85% je Datei) und schreibt die Tabelle in `STATUS.md` und den Wert in `README.md` und `README-de.md`; `--check` schlägt bei Abweichung fehl, ebenso bei einer C-Datei unter `shared/` oder einer Kern-Datei unter `protocols/`, die nicht in der Messung steht oder keine Zähler hat |
| `tools/mutate.py` | ändert in einer Kopie des Baums jeweils eine Zeile von `shared/` oder eines Kerns unter `protocols/` (ein Vergleich umgedreht, eine Grenze plus oder minus 1, eine gespeicherte Zuweisung entfernt), baut die Host-Suite, führt sie aus und meldet die Änderungen, mit denen die Suite besteht; standardmäßig die seit `origin/main` geänderten Zeilen, höchstens 60 Mutanten und 2700s; CI führt es bei einem Pull Request und bei einem von Hand gestarteten Lauf auf einem Branch außer `main` aus und schlägt bei einem Überlebenden nicht fehl |
| `tools/check_sanitizers.py` | konfiguriert den Sanitizer-Build und schlägt fehl, wenn nicht jeder Compile-Befehl unter `shared/`, `protocols/` und `test/host/` `-fsanitize=address,undefined`, `-fno-sanitize-recover=all` und `-fno-omit-frame-pointer` trägt und kein anderes Flag dieser Familie |
| `tools/check_loop_waits.py` | liest die C-Dateien von `firmware/iomcu/src` und jedes Verzeichnisses unter `shared/` und `protocols/`, das `firmware/iomcu/CMakeLists.txt` hinzufügt, die Ordner `rp2350/` eingeschlossen, und schlägt fehl bei `tight_loop_contents()` in einer `while`-, `do`- oder `for`-Schleife, bei einer `while`- oder `for`-Schleife mit leerem Rumpf, bei einer Schleife, die die Mikrosekundenuhr liest (`time_us_32()`, `time_us_64()`, `get_absolute_time()`, `to_ms_since_boot()`, `to_us_since_boot()`), bei einem Aufruf von `busy_wait_*()` oder `sleep_*()` und bei einem Aufruf von `printf()`, `vprintf()`, `puts()`, `fputs()` oder `putchar()` oder eines als eines davon definierten Makros, an einer Stelle, die seine Ausnahmeliste nicht nach Datei, Funktion, Art und, bei einer Ausgabe, dem Anfang des ersten Literals, bei einer Schleife, ihrem Schlüsselwort und ihrer Bedingung nennt; die Liste nennt die Hauptschleife, den Code von Kern 1, die Wartezeiten des Boots (den Start von Kern 1, 100ms; das Abschalten des PD mini, 3500ms; den Reset des CAN-Controllers, 11ms), `can_drain()` beim Neustart des Updates (höchstens 35 000us, Arming gesperrt), ein Umverdrahten von TONE (5000us), das zeitgestempelte PWM-Schreiben der Erfassung (5us), das Leeren des Empfangs der Hitec- und ESC-Leitungstreiber (64 FIFO-Lesevorgänge), den Treibertest des Bench-Konsolen-Builds, die Zeitstempel des Trace-Builds, die Boot-Zeilen und die Zeilen des Speichers; ein Eintrag, der nichts trifft, schlägt fehl; das Lesen ist textuell, eine Wartezeit hinter einem anderen Makro und Code in einem Header werden nicht gelesen; `--check` endet mit 1 bei einem Fund |
| `tools/check_protocols.py` | hält jedes Modul unter `protocols/` an der Regel, nach der es in einem anderen pico-sdk-Projekt gebaut wird: eine Kern-Datei bindet nur C-Standard-Header und die eigenen Header des Kerns ein, eine Datei unter `rp2350/` außerdem die Treiber-Header des Moduls, sein erzeugtes `.pio.h` und pico-sdk-Header, der Header eines Treibers bindet keinen pico-sdk-Header ein, jeder öffentliche Header trägt `extern "C"` und kompiliert für sich als C11 und als C++17 mit `-Wall -Wextra -Werror`, kein Include eines Moduls nennt einen Pfad mit `..`, einen absoluten Pfad oder ein Makro oder hat ein Token nach seinem Operanden, kein `#include_next` nennt einen anderen Header als einen C-Standard-Header oder, in einer C-Datei unter `rp2350/`, einen pico-sdk-Header, der Name `__has_include` steht außerhalb eines Literals nur als Operand von `#ifdef`, `#ifndef`, `#elifdef` oder `#elifndef` oder eines `defined`-Terms in einer `#if`- oder `#elif`-Zeile, die nur solche Terme, Leerraum, `(`, `)`, `!`, `&` und `|` enthält, keine Zeile besteht nur aus `#`, gelesen nach den Literal-Regeln von ISO C, GNU C, C23 und C++ und in einer `.pio`-Datei in dem C, das pioasm in den erzeugten Header schreibt, keine C-Datei, kein Header und kein C einer `.pio`-Datei enthält einen Trigraph (`??` gefolgt von einem aus `= / ' ( ) ! < > -`), keine Datei enthält ein NUL-Byte, das Modul hat eine `README.md` mit einer Überschrift „Interface“, einer Überschrift mit „Trademark“ darin, wo sie eine Marke nennt (die Marke gilt an jeder Stelle der Datei, in jeder Schreibweise, auch innerhalb eines Bezeichners, Dateinamens, einer Adresse oder Zahl, nicht neben einem Buchstaben, also nicht in `KSTART` oder `KstSession`), und den Worten „no pin driver“, wo es keinen Ordner `rp2350/` hat, und „no PIO program“, wo sein Ordner `rp2350/` keine `.pio`-Datei hat, seine CMake-Dateien nennen kein anderes Modul, und jedes `_Static_assert` außerhalb von `protocols/` auf Konstanten eines Moduls steht nach Datei und Bedingung im Werkzeug und ist noch vorhanden (CMake-Include-Verzeichnisse und Link-Ziele werden nicht geprüft, und ein mit `##` zusammengesetztes `__has_include` besteht die Prüfung, und `""R"(` und `''R"(` werden wie in C gelesen, als Literal und Raw-String, sodass ein Include nicht gefunden wird, das eine solche Folge in C verbirgt und C++11 oder später liest, wo `R` ein Literal-Suffix ist); `--check` gibt nur die gebrochenen Regeln aus |
| `tools/security_parsers.py` | listet die Module unter `shared/` und `protocols/`, deren öffentliche Header eine Funktion `parse`, `decode`, `unpack`, `_rx`, `_feed`, `_write`, `_read`, `_done` oder `_utf8_next` deklarieren, dazu die im Werkzeug erzwungenen Module, die Eingaben von außen unter anderen Namen annehmen, je mit Begründung (`shared/settings`, `shared/touch`); `--check` schlägt fehl, wenn die Parser-Tabelle in `SECURITY.md` und diese Liste abweichen oder ein erzwungener Eintrag ein Modul nennt, das es nicht gibt oder das die Namensregel schon findet; ein Modul ausgenommen wird nur durch einen Eintrag mit Begründung im Werkzeug |
| `tools/check_docs.py` | hält die Seiten am Quellbaum: Links und Anker führen irgendwohin, jedes Bild wird benutzt, die Sidebar ist vollständig, jede Seite hat ein deutsches Gegenstück, die Suite-Liste in `STATUS.md` stimmt mit CMake überein, die Zahlen der Screenshots in `STATUS.md` stimmen mit `docs/img` überein, die Tabelle der roten Leuchte auf den Seiten zur Stick-Programmierung stimmt mit `esc_stick_reason_is_fault()` überein, der Baum oben nennt jedes Modul unter `shared/` und `protocols/`, jede Quelldatei trägt eine SPDX-Zeile (SPDX: Software Package Data Exchange), die Protokollversion, die Zeiten von Heartbeat und Link, die Pins von Heartbeat und CAN, die Coverage-Untergrenzen und die Stack-Marge, die eine Seite nennt, sind die Konstanten in den Headern und Werkzeugen (`FACTS` im Werkzeug führt jeden Satz), eine Tabellenzeile, die eine C-Konstante nennt, gibt deren Wert an, [Performance](Performance-de.md) hat keine Tabelle der Obergrenzen, solange `ci.yml` kein `--max-lines`-Argument hat, die Pinzahlen in `hardware/docs/Pins.md` stimmen mit `pinmap.json` überein, eine deutsche Seite zitiert in Backticks das Deutsch, das der Bildschirm zeigt: Texte und Formate der Oberfläche, Namen, Hilfetexte, Optionen und Kategorien der Einstellungen und die Wörter des Servotests |
| `tools/wiki_links.py` | schreibt die Links einer Kopie von `docs/` für das Wiki um, das Seiten über ihren Titel adressiert: `Page.md` wird zu `Page`, ein Ziel oberhalb von `docs/` zu einer Repository-URL (`blob`, `tree`, `raw` für ein Bild); vergleicht jede Seite über markdown-it-py 3.0.0 mit ihrer Umschreibung und endet bei jeder anderen Abweichung mit 1, mit Seite und Zeile; `--check` ändert nichts; `--verify` schlägt bei einer umgeschriebenen Seite fehl, deren Links ein Wiki nicht öffnen kann |
| `tools/check_formats.py` | kompiliert `shared/` mit jedem Aufruf von `TR()` und jedem Wort des Berichts durch sein englisches Literal ersetzt, unter `-Wformat=2 -Wformat-nonliteral -Wformat-signedness`, und schlägt bei jeder Warnung fehl: jedes englische Format gegen die Argumente seines Aufrufs ([Sprache](Language-de.md)) |
| `tools/check_units.py` | hält Zahl und Einheit ohne Leerzeichen dazwischen (`40s`, `6.00V`, `%ums`, eine Zellenzahl `6S`) in den Dokumenten, den Texten und Berichten der Oberfläche (`ui_text.def` und die String-Literale von `shared/ui/` und der Berichtsschreiber) und den Kommentaren des Codes; `--check` schlägt fehl bei Zahl, Leerzeichen und Einheitenzeichen, bei einer Einheit in Großbuchstaben nach einer Zahl in den Texten, die das Panel zeigt (`500MS`, `50 HZ`; S allein ist die Zellenzahl), und bei einem Eintrag in `tools/check_units_allow.txt`, der nichts trifft, `--fix` entfernt das Leerzeichen; Log- und Konsolenzeilen, CSV-Kopfzeilen, Datendateien außer den Panel-Texten der ESC-Profile und veröffentlichte Abschnitte des CHANGELOG gelten nicht |
| `tools/merge_texts.py`, `tools/old_texts.py`, `tools/c_tables.py` | bringen die Wörter der Oberfläche aus der Form in mehreren Dateien (Englisch in `ui_text.def` und im Schema, Deutsch in `ui_text_de.c`) in die eine Tabelle, `shared/text/include/ui_text.def`; `merge BASE THEIRS` übernimmt beim Merge die Textänderungen eines Branches, der noch die alte Form hat, in die Tabelle ([Sprache der Oberfläche](Language-de.md#einen-text-hinzufügen)) |
| `tools/gen_font.py` | erzeugt die sieben eingebetteten Fonts aus DejaVu Sans Mono neu, die fünf Text-Fonts mit den deutschen Buchstaben; `--check` schlägt fehl, wenn die eingecheckten Tabellen abweichen |
| `tools/render_ui.py` | rendert jeden Bildschirm mit dem Code, den das Panel ausführt, als PNG (Portable Network Graphics), auf Englisch nach `docs/img/` und auf Deutsch nach `docs/img/de/`; `--check` vergleicht mit den eingecheckten Bildern; `--fit` schlägt fehl, wenn ein Text in einer der beiden Sprachen dort überläuft, wo er gezeichnet wird, außer den englischen Überläufen, die das Werkzeug als bekannt führt ([Sprache](Language-de.md)) |
| `tools/frame_cost.py` | misst L2-Cache-Line-Fills je Frame unter cachegrind mit dem L1- und dem L2-Cache des ESP32-P4 bei 1024 x 600px; `--max-lines N` schlägt fehl, wenn ein Modus N überschreitet, wie CI es je Gruppe von Modi ausführt; `--check-doc` hält den Block in [Performance](Performance-de.md) an der Messung, mit einer Toleranz von 3%, mindestens jedoch 500 Fills, und die Zeile der Startmessung in der Tabelle des Boards an `PROBE_CLEAR_US`; `--update-doc` schreibt den Block |
| `tools/stack_check.py` | liest die tiefste Aufrufkette jeder Panel-Task aus der gebauten ELF-Datei (Executable and Linkable Format) und schlägt fehl, wenn eine ihren Stack abzüglich 1024 Bytes überschreitet; dekodiert den RISC-V-Code des ESP32-P4 mit `tools/stack_riscv.py` und hält bei einer ELF-Datei einer anderen Maschine an; CI führt es nach beiden Panel-Builds aus; nimmt das Build-Verzeichnis, Standard `firmware/panel/build`; `-v` gibt jede tiefste Kette und jeden Aufruf aus, dem es nicht folgen kann; `--check-doc` hält die Task-Tabelle in [Performance](Performance-de.md#stacks) am Build; `--iomcu` liest stattdessen das IOmcu-Image und schlägt fehl, wenn die tiefste Kette eines Kerns, ein Interrupt und 256 Bytes seinen Stack überschreiten; mit `--check-doc` hält es die Zeile von Kern 0 der IOmcu-Tabelle, die Zahl der von `main` aus erreichbaren Aufrufe über ein Register in beiden Performance-Seiten und den Satz zu Kern 0 in `STATUS.md`; der ELF-Leser und der Aufrufgraph stehen in `tools/stack_elf.py`, die IOmcu-Hälfte in `tools/stack_iomcu.py` |
| `tools/check_panel_console.py` | liest eine ELF-Datei des Panels auf die Symbole des Konsolen-Relays und seine Link-Zeile: `off ELF` schlägt fehl, wenn das Image eines davon enthält, `on ELF`, wenn ihm eines fehlt. CI und der Release-Workflow halten jeden veröffentlichten Build an `off` |
| `tools/check_perf_log.py` | liest eine ELF-Datei des Panels auf den Text der Start-up-Messung, den Text des Stack-Scans und das Symbol `scan_stacks`: `off ELF` schlägt fehl, wenn das Image eines davon enthält, `on ELF`, wenn ihm eines fehlt; `ci.yml` führt beides auf seinen zwei Panel-Builds aus und `release.yml` führt `off` auf dem Release-Image aus, so dass ein Release-Build, der `-D RCBENCH_PERF_LOG=OFF` weglässt, fehlschlägt |
| `tools/image_slot.py` | liest die Partitionstabelle eines Panel-Builds und schlägt fehl, wenn das Image größer ist als der kleinere der zwei OTA-Anwendungsslots (Over-the-Air), wenn die Tabelle weniger als zwei solche Slots hat oder wenn sie sich in der Größe unterscheiden; gibt den verbleibenden Platz aus; nimmt das Build-Verzeichnis, Standard `firmware/panel/build` |
| `tools/psram_bss.py` | liest die Linker-Map eines Panel-Builds und schlägt fehl, wenn eine Zeile in den Einträgen eines Mappings in `firmware/panel/main/psram_bss.lf` nicht `<object> (rcbench_extram_bss)` lautet, wenn ein Objekt, das das Fragment in den PSRAM (Pseudo-Static Random-Access Memory) legt, kein .bss in `.ext_ram.bss` hat oder .bss im internen RAM behält; gibt die verschobenen Bytes aus; `--list N` listet außerdem jedes Objekt mit mehr als N Bytes .bss im internen RAM; nimmt das Build-Verzeichnis, Standard `firmware/panel/build` |
| `tools/check_sizes.py` | zählt die Code-Zeilen jeder Datei, die git verfolgt (eine Code-Zeile ist weder leer noch nur Kommentar: Kommentare und Doxygen-Blöcke in C, C++, Headern, TypeScript und JavaScript sowie `#`-Kommentare und Docstrings in Python zählen nicht; andere Dateiarten zählen ihre nicht leeren Zeilen), und hält die Dateien über 1 000 Code-Zeilen an `tools/check_sizes.txt`, das für jede den Grund nennt, warum sie ganz bleibt, und für einige eine Code-Zeilenzahl mit Toleranz; `--check` schlägt fehl bei einer Datei über 1 000 Code-Zeilen, die die Liste nicht nennt, einer gelisteten Datei mit 1 000 Code-Zeilen oder weniger, einer Zahl außerhalb ihrer Toleranz und einem Ausschluss, der nichts trifft; eine Datei, deren Kopf das `tools/gen_*.py` nennt, das sie erzeugt, steht nicht in der Liste, wenn CI diesen Generator mit `--check` ausführt |
| `tools/sense_trace.py` | liest die mitgeschnittene Konsole eines IOmcu, der mit `-DSENSE_TRACE=ON` gebaut ist: liest jede Zeile gegen das Zeilenformat und jeden Trace der 1-ms-Samples von INA3221 CH1 gegen seine Endzeile, schreibt je Trace eine CSV-Datei (Comma-Separated Values) und spielt jede Bewegung durch `shared/servo/servo_move.c`, mit dem Filter bei 1, 4 und 8 Samples und dem Band bei 0,02, 0,05 und 0,10A; `--servo-csv` ergänzt die Ankunft abzüglich der Stellzeit des AS5600, `--loaded-channel` nennt die Ausgangskanäle mit angeschlossenem Servo und lässt die Kommandos der anderen aus ([Erster Lauf](FirstRun-de.md#89-die-1-ms-samples-von-ch1-auf-der-konsole)) |
| `tools/pinmap_check.py` | prüft die vorläufige Pinbelegung des IO-Boards, `hardware/docs/ioboard-pinmap-draft.json`, gegen die Pinfunktionen in `io_bank0.h` des pico-sdk; braucht einen Checkout des pico-sdk |
| `tools/gen_board_drawing.py`, `tools/gen_esc_profiles.py` | erzeugen die eingecheckten Tabellen der Platinenzeichnungen und der ESC-Profile aus ihren JSON-Quellen (die Platinenzeichnung aus `configurator/drawings/panel.json` des Konfigurators); `--check` schlägt fehl, wenn die eingecheckten Tabellen abweichen |
| `tools/check_prose.py` | hält die Markdown-Seiten an die Schreibregeln, jede ein Regelname in der Ausgabe (`dash`, `marketing`, `narrator-en`, `history-en`, `exclamation`, `emoji`, `stale-esp32s3`, `stale-simulation`, `stale-coprocessor`, `stale-usable` und die deutschen `narrator-de`, `history-de`); liest die READMEs, `STATUS.md`, `SECURITY.md`, `CONTRIBUTING.md` und die Seiten unter `docs/`, `help/content/`, `testbench/` und `hardware/`; jede Ausnahme ist ein Eintrag in `tools/check_prose_allow.txt` mit Begründung; `--check` schlägt bei einem Treffer und bei einem Eintrag fehl, der nichts trifft; `--long` listet zusätzlich Sätze mit mehr als 40 Wörtern |
| `tools/check_sdkconfig.py` | vergleicht eine ESP-IDF-`sdkconfig` mit der `sdkconfig.defaults`, aus der sie entsteht, standardmäßig `firmware/panel/sdkconfig`, und schlägt fehl bei einer Einstellung der Defaults, die sie mit anderem Wert oder gar nicht enthält; eine lokale `sdkconfig` hat im Build Vorrang vor den Defaults, ein lokaler Build mit einer alten ist also nicht der Build von CI |
| `tools/check_wifi_secrets.py` | schlägt fehl, wenn die Namen von HOTSPOT-PASSWORT oder WEB-CODE in einer Quelle von `firmware/panel/` oder `shared/` vorkommen, die nicht auf der Liste des Werkzeugs steht, und bei einem Log- oder Konsolenaufruf, dessen Argumente einen davon nennen |
| `tools/gen_cats.py` | erzeugt die Katzenzeichnungen der Panel-Seiten als lauflängenkodierte Tabellen; `--check` schlägt fehl, wenn die eingecheckten Dateien abweichen, `--preview DIR` schreibt jede Pose als PNG; braucht Pillow 12.3.0, die Version, die CI festlegt |
| `tools/gen_web_blob.py` | erzeugt `shared/webaccess/wa_web_blob.c` aus den Dateien unter `shared/webaccess/web/`; `--check` schlägt fehl, wenn die eingecheckte Datei abweicht, `--sizes` gibt die Bytes jeder Datei so aus, wie sie ausgeliefert wird |
| `tools/check_comment_only.py` | belegt, dass eine Änderung zwischen zwei Commits nur Kommentare und Docstrings berührt, indem es die C-Tokenströme und die Python-Syntaxbäume vergleicht: `tools/check_comment_only.py BASE [HEAD]` |
| `tools/ui_sources.py` | die Liste der C-Quellen, die `render_ui.py` und `frame_cost.py` übersetzen; nur Daten |
| `tools/install_arm_toolchain.sh` | installiert die Ubuntu-Pakete des IOmcu-Builds und legt die `.deb`-Dateien in einem Verzeichnis ab, das ein CI-Cache sichert: `cache-keys` oder `install ARCHIVE_DIR` |
| `tools/jlc_stock.py` | liest den Bestand jedes Teils aus `hardware/docs/Parts.md` über die Schnittstellen von JLCPCB und Digi-Key; `--check N` endet mit 1 bei einem durchfallenden Teil für N Platinen |
| `tools/ci_gate.py` | wartet auf den CI-Lauf eines Commits und schlägt fehl, wenn keiner bestanden hat; der erste Schritt von `docs.yml` und `release.yml` |
| `tools/release_kind.py` | liest einen Release-Tag und gibt seine Art aus, `testing` für eine ungerade Minor-Nummer und `stable` für eine gerade, mit den Flags `prerelease` und `latest`, nach denen `release.yml` veröffentlicht; mit den Tags der vollen Releases auf GitHub dahinter ist `latest` `false` für einen stabilen Tag, der älter als einer davon ist; Exit-Code 1 bei einem Tag außerhalb der Form ([Releases](#releases)) |
| `tools/doc_check.py`, `Doxyfile` | lässt Doxygen 1.18.0 mit dem `Doxyfile` über den C-Code von `shared/`, `protocols/`, `firmware/panel/`, `firmware/iomcu/` und `testbench/touch-injector/core/` laufen, ohne die erzeugten Tabellen, und vergleicht seine Warnungen, als Datei, Meldung und Text der genannten Zeile ohne Zeilennummer, mit `tools/doc_check_baseline.txt`; ergänzt eine Warnung für eine C-Datei ohne `@file`-Block oder ohne dessen `@brief`; `--check` schlägt fehl bei einer Warnung, die nicht in der Baseline steht, und bei einer Zeile der Baseline, die der Baum nicht erzeugt, mit `--base REF` außerdem bei jeder Warnung in einer C-Datei, die seit der Merge-Base mit `REF` hinzugekommen ist, auf einer geänderten Zeile oder deren Kommentarblock bei einem fehlenden `@file`-Block in einer geänderten Datei und bei einem Kommentarblock ohne `@brief`, den die Änderung hinzufügt oder bearbeitet; eine umbenannte Datei gilt als neu; `--update` schreibt die Baseline neu. Das HTML in `build/doxygen/html/` ist die [C-API-Referenz](https://subtilitas.github.io/rcbench/api/) (API: Application Programming Interface) |
| `tools/pages_changes.py` | entscheidet, ob ein Lauf von `pages.yml` ein vollständiger ist, mit den Tests und Browser-Tests des Configurators, oder nur die Seite des Configurators, die Hilfe und die API-Referenz baut: vollständig, wenn ein geänderter Pfad unter `configurator/`, `help/` oder `docs/img/` liegt oder `pages.yml`, `rcbench_version.h`, `ui_screen.h`, `tools/help_site.py` oder `tools/render_ui.py` ist; ein Push zählt seine Änderungen ab dem neuesten erfolgreichen Push-Lauf von `pages.yml` auf `main` und ist vollständig, wenn es keinen gibt |
| `test/tools/` | pytest-Fälle für die Werkzeuge oben und für den Mock-Server des Dateimanagers: `python3 -m pytest test/tools` |
| `test/host/wa_page_dump.c`, `test/host/wa_mock_server.py`, `test/web/` | der Browser-Test des Dateimanagers der Wi-Fi-Seite, unten |
| `.clang-tidy`, `.cppcheck-suppress`, `ruff.toml` | Konfiguration für statische Analyse und Lint; jeder Befund ist ein Fehler. `ruff.toml` wählt die Docstring-Regeln (D) aus; keiner Datei sind sie erlassen |

`doc_check.py` braucht Doxygen 1.18.0 und bricht bei einem anderen Release
mit Exit-Code 2 ab: `tools/install_doxygen.sh 1.18.0 <SHA-256 aus ci.yml>
PREFIX` installiert es als `PREFIX/bin/doxygen`.

`gen_font.py` sucht den Font in `RCBENCH_FONT_DIR`, dann in
`~/.local/share/fonts`, dann in den Systemfontverzeichnissen. `frame_cost.py`
braucht `valgrind`; die übrigen Werkzeuge benötigen einen C-Compiler und
Pillow. `mutate.py` braucht außerdem git und CMake, `ci_gate.py` das
Kommando `gh`. `sense_trace.py` braucht CMake und einen C-Compiler: es baut
`test/host/sense_trace_replay.c` nach `build-trace/`, wenn `--replay` kein
gebautes Programm nennt.

## Der Browser-Test des Dateimanagers

Der Dateimanager der Wi-Fi-Seite (`shared/webaccess/web/`) läuft in Chromium
gegen einen Mock des Panels. Der Test braucht kein Panel, keine Karte und
kein Netz.

| Teil | Aufgabe |
| --- | --- |
| `test/host/wa_page_dump.c` | ein Host-Programm, das CMake-Target `wa_page_dump`: schreibt die Seite, die `wa_page_main()` baut, auf Englisch und Deutsch, mit den Hervorhebungswörtern und -farben des Panels, dazu die Berichte des Servotests, wie das Panel sie schreibt, mit den Spans, die `text_hl_line()` jeder ihrer Zeilen gibt |
| `test/host/wa_mock_server.py` | liefert die geschriebene Seite Byte für Byte und beantwortet `/api/status`, `/api/list`, `/api/info`, `/api/file`, `PUT /api/file`, `/api/mkdir`, `/api/rename`, `/api/delete` und `/card/PATH` aus einer Karte im Speicher, mit dem JSON, den Headern, Statuscodes und Ablehnungen von `wa_api.c`, `If-Match` und `If-None-Match` mit 412 und 409 und dem Request-Guard von `wa_guard.c` (Host 421, Origin und `X-Rcbench-Upload` 403, Body-Grenzen von 1MiB für ein PUT und 1.024B für ein Formular 413). Eine Anfrage nach der anderen. Die Reason-Wörter und ihre Status liest er aus `wa_api.c`, die Sätze aus `ui_text.def`. Nur die Python-Standardbibliothek |
| `test/web/` | Playwright 1.64.0, die Version des Configurators, ein Worker, Chromium: `files.spec.ts` führt 18 Tests auf Englisch und auf Deutsch aus |
| `test/tools/test_wa_mock_server.py` | pytest-Fälle des Vertrags des Mocks: der Guard, die Statuscodes, die PUT-Prüfungen, das Blättern, die Regeln für Rename, Move und Delete |

Die 18 Tests: Die Seite öffnet auf dem Wurzelordner der Karte und dem User-
Log-Ordner; ein Ordner mit 49 Einträgen blättert als 48 und 1; ein Bericht
wird angezeigt und jede Zeile trägt die Klassen von `text_hl_line()`; eine
Änderung wird mit `If-Match` gespeichert; ein Speichern über eine geänderte
Datei bekommt 412 und die Frage nach den ungespeicherten Änderungen, STAY
behält die Änderung und READ AGAIN verwirft sie; das 2s-Halten von OVERWRITE
speichert mit dem ETag der Ablehnung; Upload, Upload über einen vorhandenen
Namen mit der Frage, neuer Ordner, Rename, Move und Delete (auch abgebrochen,
und ein Ordner, der eine Datei enthält); DOWNLOAD und INFO; die
Schreib-Buttons bei ARMED, bei Browser writes OFF und bei HOLD. Jeder Test
schlägt außerdem bei einem nicht abgefangenen Skriptfehler der Seite fehl.

```bash
cmake -S test/host -B test/host/build -DCMAKE_BUILD_TYPE=Debug
cmake --build test/host/build --target wa_page_dump
cd test/web
npm ci
npx playwright install chromium
WA_PAGE_DUMP=../host/build/wa_page_dump npm run e2e
```

Der Test braucht Node.js 24. `E2E_PORT` nennt einen anderen Port als 4180. Die
36 Läufe dauern 29s auf dem Entwicklungsrechner; die Zeit des Jobs auf dem
CI-Runner ist nicht gemessen.

Was der Mock nicht tut: den Zugangscode (Browser writes CODE), das ZIP der
Karte, das Firmware-Update, `PANEL_BUSY`, eine volle Karte und das Halten auf
WI-FI am Panel. Seine Prüfungen von Host und Origin nehmen den eigenen Port
des Mocks, wo das Panel nur Port 80 nimmt. Das Verhalten der Seite mit den
4 Sockets des Panels und ihr Zeitverhalten auf dem ESP32-P4 sind nicht
abgedeckt.

## Der Funk über den ESP32-C6

Wi-Fi und Bluetooth LE über den ESP32-C6 stehen auf [Der Funk über den
ESP32-C6](C6-de.md): die SDIO-Verdrahtung, die Managed Components, die Firmware
des C6, ihr Update und die Wiederherstellung, Fehler und der Bluetooth-LE-
Dienst.

## CI

| Workflow | Auslöser | Jobs |
| --- | --- | --- |
| `ci.yml` | Push auf `main`, Tag `v*`, ein Label an einem Pull Request (`ci`, sobald seine Reviews sauber sind; ein Push auf einen Pull Request startet keinen Lauf), manuell (`gh workflow run ci.yml --ref <branch>`, dessen Checks ein Pull Request nicht übernimmt) | Host-Suite; dieselbe Suite unter AddressSanitizer und UBSan (UndefinedBehaviorSanitizer); Coverage-Untergrenzen; der Codecov-Upload in einem eigenen Job, den keine vorgeschriebene Prüfung braucht und der fehlschlägt, wenn der Upload fehlschlägt; die Prüfungen, die erzeugte Dateien an ihre Quellen binden (Fonts, Platinenzeichnungen, Katzentabellen, KiCad-Bibliothek, mechanische Modelle, ESC-Profiltabellen, Dateimanager-Texte); die Prüfungen von Dateigröße, Docs, Wi-Fi-Geheimnissen, Einheiten, Schreibregeln, Webhilfe, `SECURITY.md`-Parsern, Wiki-Links, Screenshots und Textbreite; die Prüfung der übersetzten Formate; die Prüfung des Codes, den der IOmcu baut, auf Warteschleifen, Sleeps und blockierende Ausgaben (`tools/check_loop_waits.py`); der Frame-Kosten-Job; die Prüfung der Protokollmodule; clang-tidy 22.1.8 und cppcheck 2.17.1 über `shared/`, die Kerne unter `protocols/` und `test/host/`, die Klassen warning, performance und portability von cppcheck über `firmware/` und die Pin-Treiber unter `protocols/`, und ruff; die pytest-Fälle der Werkzeuge; die Prüfung der Doxygen-Kommentare mit `tools/doc_check.py`, die bei einem Pull Request auch bei jeder Warnung in einer C-Datei fehlschlägt, die er hinzufügt, oder auf einer Zeile, die er ändert; bei einem Pull Request die Mutationsprüfung der geänderten Zeilen, die meldet und bei einem Überlebenden nicht fehlschlägt; das Image des C6-Funks aus dem Ordner `slave/` von esp_hosted mit ESP-IDF v6.1 für den ESP32-C6 (`c6.yml`, [Das Image, das das Panel mitbringt](C6-de.md#das-image-das-das-panel-mitbringt)); Panel-Build mit ESP-IDF v6.1 für den ESP32-P4 mit der Prüfung der erzeugten sdkconfig gegen `sdkconfig.defaults` (`tools/check_sdkconfig.py`), der Prüfung des Images gegen seinen Update-Slot, der Prüfung, dass das Image die IOmcu-Images und das C6-Image trägt und die Symbole des Touch-Injectors, die Frame-Zeilen der Konsole (`tools/check_perf_log.py`) und exFAT enthält, und einem zweiten Build mit `RCBENCH_TOUCH_INJECTOR=OFF` und `RCBENCH_PERF_LOG=OFF`, der fehlschlägt, wenn er ein Injector-Symbol oder eine Frame-Zeile enthält; IOmcu-Build mit pico-sdk 2.3.0 mit der Prüfung der Pinbelegung und der Stacks seiner zwei Kerne, ein zweiter mit `-DSENSE_TRACE=ON` und derselben Stack-Prüfung, der fehlschlägt, wenn das Standard-Image ein Trace-Symbol enthält, und ein dritter mit `-DIOMCU_CONSOLE=ON` und derselben Stack-Prüfung, der fehlschlägt, wenn das Standard-Image ein Symbol der Konsole enthält; der Build des Touch-Injectors mit pico-sdk 2.3.0 für `waveshare_rp2350_zero`, nicht hochgeladen; der Browser-Test des Dateimanagers (`Web file manager browser test`: das Target `wa_page_dump`, dann `test/web` mit Node.js 24 und Chromium, Traces und Screenshots 14 Tage lang nur bei einem Fehlschlag aufbewahrt); Firmware-Artefakte einschließlich eines zusammengeführten Panel-Images für Offset 0 |
| `docs.yml` | Push auf `main`, der `docs/` berührt, manuell | wartet auf den CI-Lauf desselben Commits und spiegelt, wenn er bestanden hat, `docs/` ins GitHub-Wiki |
| `mutation.yml` | sonntags 03:17 UTC, manuell | jede Mutante der Zeilen von `shared/safety` und `shared/outputs` (6400 Mutanten in 81 Dateien) in 6 parallelen Shards von Dateien, ohne Obergrenze der Mutantenzahl, nach 18000s startet in einem Shard keine mehr, die übrigen werden als nicht gelaufen gemeldet; schlägt bei einer überlebenden Mutante nicht fehl; das Ergebnis sind die Artifacts `mutation-full-0` bis `mutation-full-5` und die Job-Zusammenfassungen |
| `c6.yml` | von `ci.yml` und `release.yml` aufgerufen | das Image des C6-Funks und seine Prüfungen (`tools/c6_image.py`); Artefakt `c6` |
| `release.yml` | Tag `v*`, manuell für einen Tag | wartet auf den CI-Lauf des getaggten Commits und baut, wenn er bestanden hat, beide Images und das des C6-Funks (`c6.yml`), das des Panels mit den IOmcu-Images und dem C6-Image und mit `-D RCBENCH_PERF_LOG=OFF` und einer Prüfung, dass es keine Frame-Zeile enthält, packt sie mit Prüfsummen und erstellt ein Release, ein Pre-Release bei ungerader Minor-Nummer ([Releases](#releases)); daneben, ohne das Release aufzuhalten, läuft die Prüfung der Konfigurator-Daten (`configurator/core/tools/check-annotate.sh --warn-only`) und zeigt jede Warnung, etwa einen Release-Tag neuer als die Daten des Konfigurators, als Annotation und in der Zusammenfassung des Laufs |
| `pages.yml` | Pull Request und Push auf `main`, der `configurator/`, `help/`, `docs/img/`, den Hilfe-Generator, das `Doxyfile` oder `tools/install_doxygen.sh` berührt; ein Push auf `main` auch, wenn er die C-Quellen berührt | Typprüfung, Tests, Datenprüfung, Größenbudget und Browser-Tests des Configurators; der Bau der Webhilfe mit `tools/help_site.py`; die C-API-Referenz, gebaut von Doxygen 1.18.0; bei einem Push auf `main` veröffentlicht es die gebaute Seite auf GitHub Pages, mit der Webhilfe unter `help/` und der API-Referenz unter `api/`. Ein Lauf, der nur die C-Quellen, das `Doxyfile` oder `tools/install_doxygen.sh` ändert, baut die Seite des Configurators ohne ihre Prüfungen und startet keinen Browser-Test |

Jeder Job läuft auf Ubuntu 26.04 (`runs-on: ubuntu-26.04`), nicht auf
`ubuntu-latest`. Die Host-Suite besteht aus fünf parallelen Jobs: `Host suite,
build and ctest`, `Host suite under sanitizers`, `Host suite coverage`,
`Checks that hold prose and generated files to the tree` und `Frame cost of
every screen`. Jeder installiert seine Pakete über die Composite Action
`.github/actions/host-deps`. Jede apt-Installation in der CI führt zuerst
`.github/actions/apt-prepare` aus: Sie entfernt die Google- und
Microsoft-Paketlisten des Runners, lässt einen Download, der 30s lang keine
Daten erhält, bis zu 3-mal neu starten, und führt `apt-get update` aus. `host-deps` hält die
heruntergeladenen `.deb`-Dateien in einem `actions/cache`-Eintrag, dessen
Schlüssel an der eigenen Datei hängt; ein langsamer Mirror kostet so nur die
Pakete, die sich seit dem Speichern geändert haben. Der Job `Host suite, coverage and the checks that
hold prose to the tree` braucht die fünf, läuft auch, wenn einer von ihnen
fehlschlägt, und schlägt fehl, solange nicht alle fünf erfolgreich sind; es
ist der Name, den das Branch-Ruleset verlangt. Die Compiler dieses Images
sind gcc 15.2 für den Host-Build und arm-none-eabi-gcc 14.2.1 für die IOmcu.

Vier Ergebnisse hängen vom verwendeten Runner-Image ab.
`tools/render_ui.py` und `tools/frame_cost.py` kompilieren mit
`-ffp-contract=off`, weil dieses gcc x86-64-v3 anpeilt, eine Multiplikation
und eine Addition zu einer Rundung verschmilzt und einzelne Pixel der Bögen
und Plot-Linien verschiebt. Die Coverage-Tabelle in `STATUS.md` und die Zahl
in den READMEs sind die Zeilenzahlen von gcov für gcc 15.2; ein anderes gcc
zählt einzelne Zeilen anders, so dass `tools/coverage.py --check` auf einem
Rechner mit anderem Release fehlschlägt. Die Tabelle wird aus dem Artefakt
`coverage` eines CI-Laufs geschrieben:
`python3 tools/coverage.py --from-json coverage.json`. Die Stack-Zahlen der
IOmcu in `docs/Performance-de.md` sind die von arm-none-eabi-gcc 14.2.1, das
auch ARM GNU 14.2.Rel1 liefert. Die Füllungen der Frame-Kosten-Tabelle in
derselben Datei sind cachegrind-Zählungen eines Builds auf diesem Image, mit
fester Umgebung ausgeführt (die Länge der Umgebung verschiebt den Stack und
damit eine Zählung um bis zu 9%); ein Rechner mit anderer libc kann abweichen, und
`tools/frame_cost.py --check-doc` lässt 3% eines Modus zu, mindestens 500
Fills.

clang-tidy läuft nicht über `firmware/`: es kompiliert jede Datei und braucht
die Header von ESP-IDF und pico-sdk, die der Analyse-Job nicht hat. Die
Klasse style von cppcheck läuft ebenfalls nicht über `firmware/`. Die
Host-Tests werden mit den Flags der Bibliotheken gebaut: `-Wall -Wextra
-Werror -Wshadow -Wconversion -Wno-sign-conversion`; `test/host/.clang-tidy`
listet die für sie abgeschalteten Checks, jeweils mit Grund.

cppcheck läuft im Job `cppcheck`, neben `Lint and static analysis`, der
clang-tidy bei jedem Lauf über jede Datei laufen lässt. cppcheck behält
sein Build-Verzeichnis (`--cppcheck-build-dir`) zwischen CI-Läufen: es
liest eine Datei neu, wenn sie oder eine eingebundene Datei von ihrem
Eintrag abweicht, und gibt die Befunde der übersprungenen Dateien erneut
aus. Der Cache des Build-Verzeichnisses hat als Schlüssel die
cppcheck-Version, seine Optionen, die Include-Pfade und
`.cppcheck-suppress`. Ein Lauf stellt den neuesten Cache her, den sein
Branch lesen kann: den eigenen, den des Basis-Branches seines Pull
Requests, dann den von `main`; ein Branch bekommt einen Cache nur aus einem
CI-Lauf auf ihm, und `ci.yml` läuft bei einem Push nur für `main` und
Tags.

CI installiert pillow 12.3.0, gcovr 8.6, ruff 0.16.5 und pytest 9.1.1 in
genau diesen Versionen, Doxygen 1.18.0 aus dem offiziellen Linux-Release-Archiv
(`tools/install_doxygen.sh` prüft dessen SHA-256 gegen den Wert in `ci.yml`)
und cppcheck 2.17.1, gebaut aus dem offiziellen
Quellarchiv des Tags (`tools/install_cppcheck.sh` prüft dessen SHA-256 gegen
den Wert in `ci.yml` und bricht bei Abweichung ab; der Build wird nach Version
und Hash gecacht). Das cppcheck der Distribution ist älter (2.13 unter Ubuntu
24.04) und meldet anders; lokal 2.17.1 mit `tools/install_cppcheck.sh 2.17.1
<SHA-256 aus ci.yml> ~/cppcheck-2.17.1` oder aus einem Distributionspaket von
2.17.1 installieren. Jeder Job hat ein `timeout-minutes`-Limit: 100min für die Jobs, die mit `tools/ci_gate.py` auf CI warten (bis zu 5400s, 90min), 10 bis 60min für die übrigen. ctest
bricht einen Test nach 120s ab. Ist die Umgebungsvariable `CI` gesetzt,
lässt ein fehlender C++-Compiler den CMake-Configure-Schritt der Host-Suite
fehlschlagen, und ein fehlendes `git`, `cmake` oder `cc` lässt die
End-to-End-Fälle von `tools/mutate.py` fehlschlagen. `tools/check_docs.py`
hält die Tags von pico-sdk und ESP-IDF dieser Seite an die in `ci.yml` und
`release.yml`.

Jede Prüfung läuft lokal;
[CONTRIBUTING.md](https://github.com/subtilitas/rcbench/blob/main/CONTRIBUTING.md)
listet die Befehle.

Das Wiki muss vor dem ersten Lauf von `docs.yml` mindestens eine Seite
enthalten; sonst existiert das Wiki-Repository nicht und der Clone schlägt
fehl.

## Releases

Ein Release ist ein Tag `vMAJOR.MINOR.PATCH` auf `main`. Seine
Minor-Nummer nennt seine Art:

| Minor-Nummer | Art | Auf GitHub | Beispiele |
| --- | --- | --- | --- |
| ungerade | Testing-Release | Pre-Release, nie als Latest markiert | 0.21.0, 0.21.3, 0.23.0, 1.3.0 |
| gerade | Stable-Release | volles Release, als Latest markiert, außer ein neueres volles Release existiert | 0.22.0, 0.22.3, 1.4.0 |

Die Patch-Nummer trägt Korrekturen in beiden Arten: 0.21.1 korrigiert das
Testing-Release 0.21.0, 0.22.1 das Stable-Release 0.22.0.

`release.yml` liest die Art mit `tools/release_kind.py`, bevor es auf CI
(Continuous Integration) wartet. Ein Tag im falschen Format lässt den Job
fehlschlagen; es wird nichts gebaut. Beim Veröffentlichen läuft das
Werkzeug noch einmal, mit den Tags der zu diesem Zeitpunkt auf GitHub verfügbaren
vollen Releases. Über alle Tags hinweg wird jeweils nur ein Release veröffentlicht. Ein Stable-
Release, das älter als ein veröffentlichtes ist, wird nicht als Latest
markiert:

```bash
python3 tools/release_kind.py v0.21.0   # kind=testing prerelease=true latest=false
python3 tools/release_kind.py v0.22.0   # kind=stable prerelease=false latest=true
python3 tools/release_kind.py v0.22.0 v0.20.0 v0.24.0   # kind=stable prerelease=false latest=false
```

`https://github.com/subtilitas/rcbench/releases/latest` nennt das neueste
Stable-Release. 0.22 ist die letzte Release-Linie für das ESP32-S3-Panel,
und spätere Releases sind für das 7-Zoll-Display-Board mit ESP32-P4 von
Waveshare. Die Suche des Panels liest mit RELEASES auf STABLE unter SETUP >
UPDATES, dem Standard, das Latest-Release von GitHub und mit TESTING die 10
neuesten Releases. Die Linie des ESP32-P4-Panels hat keine Obergrenze: In beiden Einstellungen
bietet das Panel jedes Release an, das neuer ist als seine laufende Version. Die
Grenze 0.22.x mit dem zweiten Lesen, das STABLE dafür macht, gehört nur zur
Linie des ESP32-S3-Panels
([Bildschirme: Die Release-Linie](Screens-de.md#die-release-linie)). Ein
Release lässt sich auch von Hand laden: seine
`rcbench-panel-p4-vX.Y.Z.bin` über die Browser-Seite des Panels, oder seine
Archive über USB (Universal Serial Bus), wie in
[Erster Lauf, §1](FirstRun-de.md#1-beide-platinen-flashen). Das
`rcbench-iomcu-vX.Y.Z.zip` des Releases und das Image, das das Panel
trägt, stammen aus demselben Commit. Ebenso `rcbench-c6-2.13.0.bin`, das
C6-Image, das das Panel trägt, und `rcbench-c6-merged-2.13.0.bin`, das für
Header H4; ihre Namen tragen die Version von esp_hosted, und SHA256SUMS führt
beide.
