subtilitas/rcbench/docs/Building.md

# Building

<sub>**English** · [Deutsch](Building-de.md)</sub>

Three builds use the same source tree: the host test suite, the panel firmware
(ESP-IDF, Espressif Internet-of-Things Development Framework) and the
IOmcu firmware (pico-sdk).

## The tree

```
rcbench/
  docs/                   wiki source, English and German
  tools/                  the checks, generators and measurements below
  test/tools/             pytest cases for the tools
  test/web/               Playwright test of the Wi-Fi page's file manager
  shared/                 pure C: no ESP-IDF, no pico-sdk, no FreeRTOS types
    gfx/                  rasteriser, seven fonts and antialiased ring tables
    touch/                coordinate and event mapping
    ui/                   theme · widgets · icons · router · screens
    settings/             typed schema and values
    logfile/              number and CSV parsing
    files/                file manager and editor core: text buffer · highlighting · names and paths · card table · panes · rules · jobs
    link/                 page protocol · CAN framing · watchdogs · diagnosis
    artwork/              the panel's cache of board drawings
    bench/                bench_state · telemetry simulator · log writer · rotary knob decode
    outputs/              channels · driver table · the ARMED state, slew and staleness
    safety/               heartbeat generator (panel) and monitor (IOmcu) · IOmcu reset cause
    servo/                limit and synchronisation searches · servo model
    can/                  bit timing for both controllers · MCP2515 registers · echo self-test · transmit queue
    esc/                  ESC programming profiles, their JSON reader and registry
    sense/                INA228 and INA3221 current monitor drivers
    fwupdate/             panel firmware image check · upload staging · installer · IOmcu update slots and BUY
    webaccess/            Wi-Fi session · card listing and ZIP stream · the page · mDNS
    clock/                wall clock rules: real date or not · file stamps · time zones · the NTP request
    text/                 the interface's words, every language in one table (header only)
    mstime/               wrap-safe comparisons of a 32-bit millisecond counter (header only)
    vibe/                 balance measurement: index comparator · 1x, 2x and blade-pass demodulator · two-run and four-run solvers
    dial/                 the M5Stack Dial's faces: lists, values, readings and rings, link and bind; host-rendered
  protocols/              one module per external interface: a pure C core, its RP2350 pin driver in rp2350/, a README.md
    dshot/                DShot frames · GCR decode · eRPM · PIO driver, plain and bidirectional
    ppm/                  PPM frame layout · PIO and DMA driver
    sbus/                 S.BUS decoder; no pin driver
    openyge/              OpenYGE framing, CRC, status and parameter cache; no pin driver
    pdmini/               PD mini driver · PIO UART
    phase_tap/            ESC tone detector · edge ring reader · PIO capture
    kst/                  programming of KST and Chaservo servos: frames, registers, limits, write plans, session · rp2350: kst_line.pio · kst_line
    hitec/                Hitec servo wire, both families: frames, transactions, reply decoders · rp2350: hitec_line.pio · hitec_line
    escwire/              ESC settings over the signal wire: protocol A, the text interface, the guard, identification, field maps, session · rp2350: ew_line.pio · ew_line
    hc05/                 HC-05 Bluetooth module AT set-up: probe, scan, bind, connect to any; no pin driver; host suite only
    bleuart/              BLE central for the ISSC transparent-UART service: advertising parser, scan list, connect, discovery, subscribe, writes, reconnect; no pin driver
    i2c_txq/              I2C transaction queue: earliest deadline, timeouts, line check, bus clear · rp2350: i2c_txq_block on an I2C block, no PIO program
    witmotion/            WitMotion IMU frames: parser, decoders, command encoder; no pin driver
    dialknob/             the M5Stack Dial's knob protocol: packets both ways, turn tracker, link state, face model; no pin driver
    rcnode/               the sensor nodes' BLE packets, control writes, advertising, 20ms windows; no pin driver
  firmware/
    panel/                ESP-IDF project (ESP32-P4)
    iomcu/                pico-sdk project (RP2350)
    dial/                 ESP-IDF project (ESP32-S3): the M5Stack Dial ([The M5Stack Dial](Dial.md))
    node/                 ESP-IDF project (ESP32-C6): the sensor nodes ([The sensor nodes](Nodes.md))
  test/host/              the host suite, one binary per module or screen
  hardware/               board design record; no board exists
```

Modules under `shared/` contain the logic and have no hardware dependency.
A module under `protocols/` implements one interface to external hardware
and can be copied into another pico-sdk project: its core includes C standard
headers only, and its `rp2350/` folder includes the core and the pico-sdk
only. Everything else that touches hardware is under `firmware/`.
`tools/check_protocols.py` holds each module to that
([CONTRIBUTING](https://github.com/subtilitas/rcbench/blob/main/CONTRIBUTING.md#where-code-goes)).

### Two directories, three builds

Each module under `shared/` and `protocols/` carries a `CMakeLists.txt`
that registers an IDF component under `ESP_PLATFORM` and a plain static
library otherwise:

```cmake
if(ESP_PLATFORM)
    idf_component_register(SRCS ${SRCS} INCLUDE_DIRS include)
else()
    add_library(rcbench_gfx STATIC ${SRCS})
    target_include_directories(rcbench_gfx PUBLIC include)
endif()
```

The panel sets `EXTRA_COMPONENT_DIRS` to `shared/` and to each required module under
`protocols/`; the IOmcu and the host suite use
`add_subdirectory()` for the modules they need. A module with an `rp2350/`
folder adds its pin driver as the INTERFACE library `rcbench_<module>_rp2350`
in a pico-sdk build only. Includes are flat: `#include "gfx.h"`.

| Module | panel | iomcu | host |
| --- | :-: | :-: | :-: |
| `gfx` · `touch` · `ui` · `settings` · `logfile` · `files` · `sbus` | yes | | yes |
| `link` · `bench` · `outputs` · `servo` · `safety` · `can` · `text` · `mstime` · `fwupdate` | yes | yes | yes |
| `artwork` · `esc` · `webaccess` · `clock` | yes | | yes |
| `openyge` · `ppm` · `i2c_txq` | | yes | yes |
| `sense` · `pdmini` · `phase_tap` · `kst` · `hitec` · `dshot` | yes | yes | yes |
| `escwire` | yes | yes | yes |
| `witmotion` | yes | | yes |
| `hc05` · `vibe` · `dial` | | | yes |
| `bleuart` · `dialknob` · `rcnode` | yes | | yes |

## Toolchains

| | Version | Notes |
| --- | --- | --- |
| ESP-IDF | v6.1 | the panel's ESP32-P4 is chip revision 3.2, which Espressif's advisory AR2026-004 pairs with v5.5.5, v6.0.1 or later; the build sets `CONFIG_ESP32P4_SELECTS_REV_LESS_V3=n` and minimum revision 3.1. The panel's TWAI (two-wire automotive interface) code uses the legacy driver, which v6.1 deprecates with a `#warning`; `components/can_twai` compiles with `-Wno-cpp`. v6.1's legacy driver sends a CAN frame with DLC (data length code) 0 as DLC 0; v5.5.0 and v5.5.1 send it as DLC 8, and the IOmcu refuses every link read sent that way. The SD card code (`storage.c`) follows v6.1's SDMMC slot handling, and v5.5.5 is not built. CI (continuous integration) builds v6.1 |
| pico-sdk | 2.0 or newer | RP2350 support; CI builds 2.3.0 |
| ARM GNU toolchain | 14.2 | any `arm-none-eabi` release targeting Cortex-M33 |

`firmware/panel/sdkconfig.defaults` sets the ESP32-P4 at chip revision 3.1
or later and 400MHz, 32MB of flash, the in-package PSRAM (pseudo-static
random-access memory) at 200MHz, code and constants in flash rather than
PSRAM, the zero-initialised data that `main/psram_bss.lf` names in PSRAM
([Internal RAM](Performance.md#internal-ram)), the DSI (Display Serial
Interface) host's interrupt running during a flash operation
(`CONFIG_LCD_DSI_ISR_CACHE_SAFE`), the partition table at 0xC000, which
leaves the bootloader 40,960 bytes from 0x2000 (it takes 0x6140 bytes with
rollback and its log at INFO), `-O2`, and the
console on UART0 with USB-Serial-JTAG (the chip's built-in USB (Universal
Serial Bus) serial and debug bridge) as secondary. Start from it rather
than from `menuconfig`.

ESP-IDF reads `sdkconfig.defaults` only when it generates `sdkconfig`. An existing
`firmware/panel/sdkconfig` takes precedence. Delete
that file after changing the defaults; otherwise the change has no effect
on the image.

## Rotary knob wiring

The rotary knob is an MT6701 magnetic angle sensor on an I2C
(Inter-Integrated Circuit) bus of its own, the ESP32-P4's second I2C
controller, on two free header pins of the 7-inch ESP32-P4 display board:
`BOARD_KNOB_PIN_SDA` and `BOARD_KNOB_PIN_SCL` in
`firmware/panel/components/board/include/board_pins.h`: GPIO30 (SDA) and
GPIO31 (SCL), the pins IO30 and IO31 of the 12-pin header P3 (3V3, GND, IO2
to IO5, IO28 to IO31, IO34, IO36). The sensor takes 3.3V and GND from the
same header. The panel switches on the ESP32-P4's internal pull-ups; whether
they alone hold 400kHz on the knob's wires is not measured, so a sensor
without pull-ups of its own gets 4.7kΩ ones to 3.3V, as the datasheet's
I2C circuit has.

The sensor has to be in its I2C/SSI (synchronous serial interface) mode,
MODE high. MODE low selects the ABZ encoder outputs, and the sensor then does
not answer on I2C. No EEPROM (electrically erasable programmable read-only
memory) setting is needed. Pins of the SOP-8 MT6701CT, from the
[MagnTek MT6701 datasheet, version 1.9](https://atta.szlcsc.com/upload/public/pdf/source/20260616/FEB700C1922508565884FF0A90656B50.pdf)
(2024-05), section 1 and figure 17:

| MT6701 pin | Connect to |
| --- | --- |
| 1 VDD | 3.3V from the header. The datasheet's supply is 3.3 to 5.0V |
| 2 MODE | VDD. An internal 200kΩ pull-up holds an open pin high; figure 17 ties it to VDD. Never GND |
| 3 OUT | not connected; the panel reads the angle over I2C |
| 4 GND | GND |
| 5 PUSH | not connected |
| 6A/SDA | SDA |
| 7B/SCL | SCL |
| 8 Z/CSN | VDD, as figure 17 |

A breakout board exposes fewer pins. Check that MODE is connected to VDD
(through a pin, jumper or pull-up) and that its supply pin accepts 3.3V. The
datasheet's I2C circuit has 4.7kΩ pull-ups on SDA and SCL to VDD; a
breakout's own pull-ups go to its VDD, here 3.3V.

- Address: 0x06, the datasheet's default. The panel reads 0x06 only. EEPROM
  programming can move the address to 0x46 (version 1.9; version 0.1 of the
  datasheet gives 0x26); a sensor moved there is not read.
- No other part of the board uses this bus. The panel refuses an address in the
  table of `shared/bench/include/panel_i2c.h`, which holds 0x00 to 0x03 and
  0x78 to 0x7F, which the I2C specification reserves, and 0x14 and
  0x5D, the GT911 touch controller's two addresses on the touch bus. 0x06 is outside it. It is one of
  the specification's Hs-mode (high-speed mode) master codes, 0x04 to 0x07,
  which no device on this bus uses.
- Bus clock: 400kHz. The datasheet allows an SCL (serial clock) period down
  to 1us and a rise and fall time of 150ns at most. The rise time on the
  terminal is not measured.
- The magnet is a diametrically magnetised disc centered over the chip.
- The I2C registers carry no field status: the magnet-too-weak and
  too-strong bits are in the SSI frame only. A sensor with no magnet over it
  still answers with an angle, and the panel takes it as a reading.
- Each poll reads 0x03, 0x04 and 0x03 again and drops a poll whose two 0x03
  bytes differ. A high byte that changes and changes back between them is
  accepted, so one step of up to 64 counts (0.52% of the span at 270deg)
  at a slider end stop remains possible; how often is not measured.
- Direction: on the MT6701CT-STD with DIR (register 0x29 bit 1, in EEPROM)
  at its default 0, the angle rises counter-clockwise seen from the chip's
  top. The panel counts the other way, so with the magnet above the chip's
  top face a clockwise turn raises the throttle. An MT6701CT-STV, whose
  angle rises clockwise, a part with DIR = 1, or a sensor mounted to be seen
  from below turns the knob the other way.

The knob is off until SETUP, PANEL, Rotary knob is switched on.
[Screens](Screens.md#panel-the-rotary-knob) describes what it does.

## The touch bus header

The touch bus is `I2C_NUM_0` with `BOARD_I2C_PIN_SDA` GPIO7 and
`BOARD_I2C_PIN_SCL` GPIO8 at `BOARD_I2C_FREQ_HZ` 400,000Hz
(`firmware/panel/components/board/include/board_pins.h`). On the 7-inch
ESP32-P4 display board (schematic of 2025-09-25) it reaches the GT911 touch
controller (0x5D), the ES8311 audio codec, the ES7210 audio ADC, the camera
connector and a 4-pin I2C header. The header carries this bus's SDA (GPIO7)
and SCL (GPIO8). The silkscreen
orders its four pins VCC, GND, SDA, SCL (the owner's photo of the board,
2026-10-22). A jumper by the VCC pin selects 5V or 3V3 for it; its factory
position is not known. Check the jumper with a meter before connecting a lead.
Whether the bus has pull-ups on the board is not measured. The touch
injector (`testbench/touch-injector/README.md`)
and the analyser leads of `testbench/WIRING.md` connect here. The knob is not on this header: it has its own bus
([Rotary knob wiring](#rotary-knob-wiring)).

## The panel's clock

The 7-inch ESP32-P4 display board (Waveshare ESP32-P4-WIFI6-Touch-LCD-7B,
schematic of 2025-09-25) carries no RTC (real-time clock) chip. Its I2C bus
(GPIO7, GPIO8) reaches the GT911 touch controller (0x5D), the ES8311 audio
codec, the ES7210 audio ADC (analog-to-digital converter), the camera
connector and the 4-pin I2C header; none of them keeps time. Waveshare's
board support package 3.0.1 and its demo firmware (commit 9fcd49a8 of
2026-08-21) have no RTC driver; the demo sets its clock by SNTP (Simple
Network Time Protocol). The board has the ESP32-P4's own clock parts:

| Part | What it is | Use in the panel |
| --- | --- | --- |
| Y3 | 32.768kHz crystal, 2.0 x 1.2mm, 22pF to GND on each side, 10MΩ across, on GPIO0 (XTAL_32K_N) and GPIO1 (XTAL_32K_P) | used: the RTC timer counts it (`CONFIG_RTC_CLK_SRC_EXT_CRYS` in `firmware/panel/sdkconfig.defaults`); a crystal that does not start leaves it on the internal RC oscillator |
| BAT1 | CR1220 coin-cell holder, "RTC BAT", on the ESP32-P4's VDD_BAT (pin 102); 3V3 charges it through D1 (B5819WS) with no series resistor; C41 1uF | not used. Waveshare: rechargeable 3 to 3.3V cells only. Whether a board ships with a cell is not known |

The ESP32-P4 can keep its RTC timer running on VDD_BAT, but only from deep
sleep: Espressif's battery backup guide for the ESP32-P4 (esp-iot-solution,
"ESP32-P4 Battery Backup Solution") switches the low-power domain to VBAT
in the sleep configuration, calls it a test scheme, and patches ESP-IDF to
do it. The panel loses its power without warning, from the link cable or
the switch, and never enters deep sleep. A cell in BAT1 therefore keeps no
time for the panel.

What the panel does instead
([Screens](Screens.md#panel-time-zone-and-the-clock)):

- A power-on starts the system time at 1970-01-01 00:00:00 UTC. A software
  restart keeps it: ESP-IDF keeps the time in the RTC timer and two of its
  store registers, which only a power-on resets
  (`CONFIG_LIBC_TIME_SYSCALL_USE_RTC_HRT`, the default).
- The clock is as good as the RTC timer's slow clock. With the 32.768kHz
  crystal Y3 the drift is at most about 30ppm, measured over 65min. On the
  internal RC oscillator, the fallback, it is not a fixed figure: 584ppm
  over 2h04min in one run, under 15ppm over 1h51min in another. Drift
  accumulates only across a hardware reset; a software restart
  (`esp_restart`) re-anchors the clock to NTP time on the next join.
- Each join of the home network asks `pool.ntp.org` once
  (`components/wifi_access/wifi_ntp.c`, `shared/clock/wall_clock.c`).
  lwIP's random start-up delay is off (`CONFIG_LWIP_SNTP_STARTUP_DELAY=n`),
  so the request goes out at the join.
- FatFs stamps files from `time()` through `localtime_r()`
  (ESP-IDF `components/fatfs/diskio/diskio.c`, `get_fattime()`), so SETUP >
  PANEL's Time zone applies to the stamps. A year before 1980 is stamped
  as 1980. FAT keeps no zone: a stamp is the local time at the write, and
  a later zone change does not move it.
- If the network session ends while the request is pending, the radio stays on for it,
  30000ms from the request at most (`wall_ntp_holds()`, `wa_lingers()` in
  `shared/webaccess/wa_session.c`).
- The SNTP client runs in lwIP's task on core 0. The Wi-Fi worker task
  advances the request. The control task on core 1, which owns STOP and
  the heartbeat, reads no wall time and waits for none of it.

### The RTC slow clock

The RTC timer counts the 32.768kHz crystal Y3 on GPIO0 and GPIO1. No
other function of the panel firmware uses those two pins. ESP-IDF v6.1
starts the crystal and falls back to the internal RC oscillator (136kHz
nominal) when it does not start:

1. The bootloader enables the crystal early, so it starts while the
   application loads (`components/bootloader_support/src/bootloader_clock_init.c`,
   lines 75 to 84). On the ESP32-P4 the bootstrap cycles
   (`CONFIG_ESP_SYSTEM_RTC_EXT_XTAL_BOOTSTRAP_CYCLES`) do nothing:
   `rtc_clk_32k_bootstrap()` only enables the crystal
   (`components/esp_hw_support/port/esp32p4/rtc_clk.c`, lines 44 to 50).
2. The application's start-up counts 3000 crystal cycles against the
   40MHz main crystal (`CONFIG_RTC_CLK_CAL_CYCLES=3000`), about 92ms. A
   count that times out, or one more than 0.05% off 32.768kHz, returns 0
   (`components/esp_hw_support/port/esp32p4/rtc_time.c`, lines 177 to
   195).
3. A result of 0 triggers another attempt, up to 4 attempts in total. After the fourth, ESP-IDF
   logs `clk: 32 kHz clock not found, switching to internal 150 kHz
   oscillator`, switches the crystal off and runs the RC
   (`components/esp_system/port/soc/esp32p4/clk.c`, `select_rtc_slow_clk()`,
   lines 127 and 143 to 152). The panel starts on the RC. ESP-IDF's message
   says 150kHz; the ESP32-P4's RC is 136kHz nominal.
4. `CONFIG_RTC_CLK_CAL_CYCLES` stays above 0: at 0 the count is skipped
   and the crystal is selected unchecked (`clk.c`, line 143).

At each start the console names the slow clock and its calibrated
frequency (`log_clock_at_start()`, `firmware/panel/main/panel_settings.c`):

```text
I (...) clock: rtc slow clock 32k crystal, 32768.012Hz calibrated
W (...) clock: rtc slow clock internal RC, 136012.345Hz calibrated: the 32k crystal did not start
```

Estimated start-up times, calculated from the source code's cycle counts, not measured:

| Slow clock | Counts at start | Time |
| --- | --- | --- |
| Internal RC, `CONFIG_RTC_CLK_SRC_INT_RC` | 1024 cycles at 136kHz | about 8ms |
| Crystal that passes the first try | 3000 cycles at 32.768kHz, twice | about 183ms |
| Crystal that gives no clock | 4 tries to the time-out, then 3000 RC cycles | about 1.25s, if the time-out of 3000 x 4096 counts is in 40MHz cycles; ESP-IDF's sources do not name the unit |

An update from the panel writes an application slot and leaves the
bootloader as it was flashed. A bootloader built before this setting does
not enable the crystal early; the application's start-up enables it and
counts at once. Whether a crystal then passes within the 4 tries is not
measured. A USB flash of the whole image writes the bootloader too.

Current limitation: a crystal that stops after the start is not detected.
ESP-IDF v6.1 offers no XTAL32K watchdog on the ESP32-P4. The system time
continues from the main crystal (esp_timer), while the RTC timer stops.
The next software restart sets the clock back by the time the RTC timer lost.

## Commands

```bash
# host suite
cmake -S test/host -B test/host/build -DCMAKE_BUILD_TYPE=Debug
cmake --build test/host/build
ctest --test-dir test/host/build --output-on-failure

# browser test of the Wi-Fi page's file manager (The file manager's browser
# test)
cmake --build test/host/build --target wa_page_dump
(cd test/web && npm ci && npx playwright install chromium \
  && WA_PAGE_DUMP=../host/build/wa_page_dump npm run e2e)

# panel
. $IDF_PATH/export.sh
idf.py -C firmware/panel set-target esp32p4
idf.py -C firmware/panel build
idf.py -C firmware/panel -p /dev/ttyACM0 flash monitor    # COMx on Windows

# panel showing the DSI host's colour bars for 3s at start-up, for a first
# look at a board
idf.py -C firmware/panel -B firmware/panel/build-bars -D RCBENCH_DISPLAY_BARS=ON build

# panel carrying the IOmcu images it offers over CAN, the module's and
# the rbmod carrier's; build both IOmcu images first
idf.py -C firmware/panel -D RCBENCH_IOMCU_BIN=$PWD/firmware/iomcu/build/rcbench-iomcu.bin \
    -D RCBENCH_IOMCU_RBMOD_BIN=$PWD/firmware/iomcu/build-rbmod/rcbench-iomcu-rbmod.bin build

# panel without the touch injector: every panel build, a release's too,
# looks once at start-up for one at 0x14 beside the glass
# (testbench/touch-injector), and RCBENCH_TOUCH_INJECTOR=OFF leaves that
# code out; the option defaults to ON
idf.py -C firmware/panel -B firmware/panel/build-noinject -D RCBENCH_TOUCH_INJECTOR=OFF build

# panel without the console's frame, stack and heap lines (Performance.md,
# On the board); the option RCBENCH_PERF_LOG defaults to ON, and the
# release workflow builds with it OFF; for a release's image with the lines,
# build without the flag
idf.py -C firmware/panel -B firmware/panel/build-noperf -D RCBENCH_PERF_LOG=OFF build

# panel, as one image at offset 0 (the ESP32-P4's bootloader sits at
# 0x2000 inside it); it erases the settings in nvs: the image fills
# 0xD000 to 0x12FFF (nvs, 24,576 bytes) with 0xFF. `idf.py flash` writes
# 0x2000, 0xC000, 0x14000 and 0x20000 only and keeps nvs.
idf.py -C firmware/panel merge-bin -o rcbench-panel-merged.bin
esptool.py -p /dev/ttyACM0 write_flash 0x0 \
    firmware/panel/build/rcbench-panel-merged.bin

# IOmcu
export PICO_SDK_PATH=/path/to/pico-sdk
cmake -S firmware/iomcu -B firmware/iomcu/build
cmake --build firmware/iomcu/build

# IOmcu for the rbmod carrier: files rcbench-iomcu-rbmod.*
cmake -S firmware/iomcu -B firmware/iomcu/build-rbmod -DIOMCU_BOARD=rbmod
cmake --build firmware/iomcu/build-rbmod

# IOmcu, debug build that prints INA3221 CH1's 1ms samples
cmake -S firmware/iomcu -B firmware/iomcu/build-trace -DSENSE_TRACE=ON
cmake --build firmware/iomcu/build-trace

# IOmcu, bench build that reads and writes link pages from the USB console
# (The bench console, BenchConsole.md); not with SENSE_TRACE
cmake -S firmware/iomcu -B firmware/iomcu/build-console -DIOMCU_CONSOLE=ON
cmake --build firmware/iomcu/build-console
```

The IOmcu build produces three UF2 (USB Flashing Format) files:

| File | Holds | For |
| --- | --- | --- |
| `rcbench-iomcu-install.uf2` | the partition table at 0x0 and the image in slot A | a module without the table: the one USB load of [First run](FirstRun.md#the-iomcus-partition-table) |
| `rcbench-iomcu.uf2` | the image alone | a module with the table; the boot ROM writes it into the slot that is not running |
| `rcbench-iomcu-pt.uf2` | the partition table alone | `picotool` |

Copy one to the module's mass-storage drive while the module is held in
BOOTSEL. `rcbench-iomcu.bin` is the image the panel carries: the panel build
option `RCBENCH_IOMCU_BIN` takes its path, and the panel then offers it over
CAN ([Link](Link.md#firmware-update-over-the-link)). A panel built without
the option offers no IOmcu update.

`IOMCU_BOARD` chooses the board the image is for: `rp2350_can` (default),
the module wired by hand, or `rbmod`, the carrier whose pins are soldered
([Link: Boards with soldered pins](Link.md#boards-with-soldered-pins)). The
carrier's files are named `rcbench-iomcu-rbmod-install.uf2`,
`rcbench-iomcu-rbmod.uf2`, `rcbench-iomcu-rbmod-pt.uf2`,
`rcbench-iomcu-rbmod.bin` and `rcbench-iomcu-rbmod.elf`. The panel option
`RCBENCH_IOMCU_RBMOD_BIN` takes the carrier's `.bin`. The panel offers each
IOmcu the image for its reported board. It offers no update if it carries no
image for that board.

`PICO_BOARD` defaults to `pimoroni_pico_plus2_rp2350`. The module used for
bring-up is a Waveshare RP2350-CAN (RP2350A, 4MB flash), which has no board
file in the SDK (software development kit); the default builds and runs on it.
Override with `-DPICO_BOARD=`. The final board needs an RP2350B: the planned
pin budget is 27 to 32 GPIO (general-purpose input/output).

## Tools

| Tool | Purpose |
| --- | --- |
| `tools/coverage.py` | measures host-suite line coverage, enforces the floors (94% total, 85% per file) and writes the table in `STATUS.md` and the figure in `README.md` and `README-de.md`; `--check` fails on drift, and on a C file under `shared/` or a core file under `protocols/` that is not in the measurement or has no counters |
| `tools/mutate.py` | changes one line of `shared/` or of a core under `protocols/` at a time in a copy of the tree (a comparison flipped, a bound plus or minus 1, a stored assignment dropped), builds and runs the host suite and reports the changes the suite passes with; by default the lines changed since `origin/main`, at most 60 mutants and 2700s; CI runs it on a pull request and on a run started by hand on a branch other than `main`, and does not fail on a survivor |
| `tools/check_sanitizers.py` | configures the sanitizer build and fails unless every compile command under `shared/`, `protocols/` and `test/host/` carries `-fsanitize=address,undefined`, `-fno-sanitize-recover=all` and `-fno-omit-frame-pointer`, and no other flag of that family |
| `tools/check_loop_waits.py` | reads the C files of `firmware/iomcu/src` and of every `shared/` and `protocols/` directory `firmware/iomcu/CMakeLists.txt` adds, `rp2350/` folders included, and fails on `tight_loop_contents()` inside a `while`, `do` or `for` loop, on a `while` or `for` loop with an empty body, on a loop that reads the microsecond clock (`time_us_32()`, `time_us_64()`, `get_absolute_time()`, `to_ms_since_boot()`, `to_us_since_boot()`), on a call of `busy_wait_*()` or `sleep_*()`, and on a call of `printf()`, `vprintf()`, `puts()`, `fputs()` or `putchar()` or of a macro defined as one of them, in a place its allow list does not name by file, function, kind and, for a print, the start of its first literal, for a loop, its keyword and condition; the list names the main loop, core 1's code, the boot's waits (core 1's start, 100ms; the PD mini's switch-off, 3500ms; the CAN controller's reset, 11ms), the update restart's `can_drain()` (35,000us at most, arming held), a TONE rewire (5000us), the capture's stamped PWM write (5us), the receive settle of the Hitec and ESC wire drivers (64 FIFO reads), the bench console build's driver test, the trace build's stamps, the boot lines and the store's lines; an entry that matches nothing fails; the reading is textual, so a wait behind another macro and code in a header are not read; `--check` exits 1 on a finding |
| `tools/check_protocols.py` | holds every module under `protocols/` to the rule that lets it be built in another pico-sdk project: a core file includes C standard headers and the core's own headers only, a file under `rp2350/` also the module's driver headers, its generated `.pio.h` and pico-sdk headers, a driver's header includes no pico-sdk header, every public header carries `extern "C"` and compiles by itself as C11 and as C++17 with `-Wall -Wextra -Werror`, no include of a module names a path with `..` or an absolute path or a macro, or has a token after its operand, no `#include_next` names a header other than a C standard header or, in a C file under `rp2350/`, a pico-sdk header, the name `__has_include` stands outside a literal only as the operand of `#ifdef`, `#ifndef`, `#elifdef` or `#elifndef`, or of a `defined` term on an `#if` or `#elif` line that holds nothing but such terms, white space, `(`, `)`, `!`, `&` and `|`, no line holds only `#`, read under the literal rules of ISO C, GNU C, C23 and C++ and, in a `.pio` file, in the C that pioasm writes into the generated header, no C file, header or C of a `.pio` file holds a trigraph (`??` followed by one of `= / ' ( ) ! < > -`), no file holds a NUL byte, the module has a `README.md` with an "Interface" heading, a heading with "Trademark" in it where it names a brand (matched anywhere in the file, in any case, also inside an identifier, file name, address or number, not next to a letter, so not in `KSTART` or `KstSession`), and the words "no pin driver" where it has no `rp2350/` folder and "no PIO program" where its `rp2350/` folder has no `.pio` file, its CMake files name no other module, and every `_Static_assert` outside `protocols/` on a module's constants is listed by file and condition in the tool and still present (CMake include directories and link targets are not checked, and a `__has_include` pasted together with `##` passes, and `""R"(` and `''R"(` are read as C reads them, a literal and a raw string, so an include that such a sequence hides in C and that C++11 or later reads, with `R` as a literal suffix, is not found); `--check` prints the broken rules only |
| `tools/security_parsers.py` | lists the modules under `shared/` and `protocols/` whose public headers declare a `parse`, `decode`, `unpack`, `_rx`, `_feed`, `_write`, `_read`, `_done` or `_utf8_next` function, plus the forced modules in the tool, which take outside input under other names, each with a reason (`shared/settings`, `shared/touch`); `--check` fails when the parser table in `SECURITY.md` and that list differ, or when a forced entry names a module that does not exist or that the name rule finds, a module being excused only by an entry with a reason in the tool |
| `tools/check_docs.py` | holds the pages to the tree: links and anchors resolve, every image is used, the sidebar is complete, every page has a German counterpart, the suite list in `STATUS.md` matches CMake, the screenshot counts in `STATUS.md` match `docs/img`, the stick programming pages' red light table matches `esc_stick_reason_is_fault()`, the tree above lists every module under `shared/` and `protocols/`, every source file carries an SPDX (Software Package Data Exchange) line, the protocol version, the heartbeat and link timings, the heartbeat and CAN pins, the coverage floors and the stack margin a page states are the constants in the headers and tools (`FACTS` in the tool lists each sentence), a table row that names a C constant gives its value, [Performance](Performance.md) has no ceiling table while `ci.yml` has no `--max-lines` argument, the pin counts in `hardware/docs/Pins.md` match `pinmap.json`, a German page quotes in backticks the German the screen shows: interface strings and formats, setting labels, help, options and categories, and the servo test's words |
| `tools/wiki_links.py` | rewrites the links of a copy of `docs/` for the wiki, where pages are addressed by title: `Page.md` becomes `Page`, a target above `docs/` a repository URL (`blob`, `tree`, `raw` for an image); compares each page with its rewrite through markdown-it-py 3.0.0 and exits 1 on any other difference, with page and line; `--check` changes nothing; `--verify` fails on a converted page whose links a wiki cannot open |
| `tools/check_formats.py` | compiles `shared/` with every `TR()` lookup and report word replaced by its English literal, under `-Wformat=2 -Wformat-nonliteral -Wformat-signedness`, and fails on any warning: each English format against the arguments of its call ([Language](Language.md)) |
| `tools/check_units.py` | holds a number and its unit to no space between (`40s`, `6.00V`, `%ums`, a cell count `6S`) in the docs, the interface's texts and reports (`ui_text.def` and the string literals of `shared/ui/` and the report writers) and the code's comments; `--check` fails on a number, a space and a unit symbol, on a unit in capitals after a number in the texts the panel shows (`500MS`, `50 HZ`; S alone is the cell count) and on an entry of `tools/check_units_allow.txt` that matches nothing, `--fix` removes the space; log and console lines, CSV headers, data files other than the ESC profiles' panel texts and released CHANGELOG sections are not covered |
| `tools/merge_texts.py`, `tools/old_texts.py`, `tools/c_tables.py` | move the interface's words from the per-file form (English in `ui_text.def` and the schema, German in `ui_text_de.c`) into the one table, `shared/text/include/ui_text.def`; `merge BASE THEIRS` carries the text changes of a branch still in the per-file form into the table during a merge ([Interface language](Language.md#adding-a-text)) |
| `tools/gen_font.py` | regenerates the seven embedded fonts from DejaVu Sans Mono, the five text faces with the German letters; `--check` fails if the committed tables differ |
| `tools/render_ui.py` | renders every screen to PNG (Portable Network Graphics) with the code the panel runs, in English into `docs/img/` and in German into `docs/img/de/`; `--check` compares with the committed images; `--fit` fails when a string overflows where it is drawn, in either language, except the English overflows the tool lists as known ([Language](Language.md)) |
| `tools/frame_cost.py` | measures L2 cache-line fills per frame under cachegrind with the ESP32-P4's L1 and L2 caches at 1024 x 600px; `--max-lines N` fails when a mode exceeds N, as CI runs it per group of modes; `--check-doc` holds the block in [Performance](Performance.md) to the measurement, to a tolerance of 3%, with a minimum allowance of 500 fills, and the table of the board's probe row to `PROBE_CLEAR_US`; `--update-doc` writes the block |
| `tools/stack_check.py` | reads every panel task's deepest call chain out of the built ELF (Executable and Linkable Format) file and fails when one exceeds its stack less 1024 bytes; decodes the ESP32-P4's RISC-V code with `tools/stack_riscv.py` and stops on an ELF of another machine; CI runs it after both panel builds; takes the build directory, default `firmware/panel/build`; `-v` prints each deepest chain and every call it cannot follow; `--check-doc` holds the task table in [Performance](Performance.md#stacks) to the build; `--iomcu` reads the IOmcu image instead and fails when a core's deepest chain, one interrupt and 256 bytes exceed its stack; with `--check-doc` it holds core 0's row of the IOmcu table, the count of calls through a register reachable from `main` in both Performance pages and core 0's sentence in `STATUS.md`; the ELF reader and the call graph are in `tools/stack_elf.py`, the IOmcu's half in `tools/stack_iomcu.py` |
| `tools/check_panel_console.py` | reads a panel ELF file for the console relay's symbols and its link line: `off ELF` fails when the image holds any of them, `on ELF` fails when it lacks one. CI and the release workflow hold every released build to `off` |
| `tools/check_perf_log.py` | reads a panel ELF file for the start-up probe's text, the stack scan's text and the `scan_stacks` symbol: `off ELF` fails when the image holds any of them, `on ELF` fails when it lacks any; `ci.yml` runs both on its two panel builds and `release.yml` runs `off` on the release image, so a release build that omits `-D RCBENCH_PERF_LOG=OFF` fails |
| `tools/image_slot.py` | reads the partition table of a panel build and fails when the image is larger than the smaller of the two OTA (over-the-air) application slots, when the table has fewer than two such slots, or when they differ in size; prints the room left; takes the build directory, default `firmware/panel/build` |
| `tools/psram_bss.py` | reads the linker map of a panel build and fails when a line in the entries of a mapping in `firmware/panel/main/psram_bss.lf` is not `<object> (rcbench_extram_bss)`, when an object that the fragment maps to PSRAM (pseudo-static random-access memory) holds no .bss in `.ext_ram.bss` or keeps any .bss in internal RAM; prints the bytes moved; `--list N` also lists every object with more than N bytes of .bss in internal RAM; takes the build directory, default `firmware/panel/build` |
| `tools/check_sizes.py` | counts the code lines of every file git tracks (a code line is not blank and not comment-only: comments and Doxygen blocks in C, C++, headers, TypeScript and JavaScript, and `#` comments and docstrings in Python, are left out; other file kinds count their non-blank lines) and holds the files over 1,000 code lines to `tools/check_sizes.txt`, which gives each one's reason to stay whole and, for some, a code-line count with a tolerance; `--check` fails on a file over 1,000 code lines that the list does not name, a listed file at or under 1,000 code lines, a count outside its tolerance and an exclusion that covers nothing; a file whose head names the `tools/gen_*.py` that generates it, when CI runs that generator with `--check`, is not listed |
| `tools/sense_trace.py` | reads a captured console of an IOmcu built with `-DSENSE_TRACE=ON`: reads each line against the line format and each trace of INA3221 CH1's 1ms samples against its end line, writes one CSV (comma-separated values) file per trace, and replays every move through `shared/servo/servo_move.c` with the filter at 1, 4 and 8 samples and the band at 0.02, 0.05 and 0.10A; `--servo-csv` adds the arrival less the AS5600's travel time, `--loaded-channel` names the output channels with a servo connected and leaves the commands of the others out ([First run](FirstRun.md#89-ch1s-1ms-samples-on-the-console)) |
| `tools/pinmap_check.py` | checks the IO board's draft pin map, `hardware/docs/ioboard-pinmap-draft.json`, against the pin functions in the pico-sdk's `io_bank0.h`; needs a pico-sdk checkout |
| `tools/gen_board_drawing.py`, `tools/gen_esc_profiles.py` | generate the checked-in board drawings and ESC profile tables from their JSON sources (the board drawing from the configurator's `configurator/drawings/panel.json`); `--check` fails if the committed tables differ |
| `tools/check_prose.py` | holds the Markdown pages to the writing rules, each a rule name in the output (`dash`, `marketing`, `narrator-en`, `history-en`, `exclamation`, `emoji`, `stale-esp32s3`, `stale-simulation`, `stale-coprocessor`, `stale-usable` and the German `narrator-de`, `history-de`); reads the READMEs, `STATUS.md`, `SECURITY.md`, `CONTRIBUTING.md` and the pages under `docs/`, `help/content/`, `testbench/` and `hardware/`; each exception is an entry of `tools/check_prose_allow.txt` with its reason; `--check` fails on a hit and on an entry that matches nothing; `--long` also lists sentences of more than 40 words |
| `tools/check_sdkconfig.py` | compares an ESP-IDF `sdkconfig` with the `sdkconfig.defaults` it is built from, by default `firmware/panel/sdkconfig`, and fails on a setting of the defaults that it holds at another value or not at all; a local `sdkconfig` takes precedence over the defaults in a build, so a local build that keeps an old one is not CI's build |
| `tools/check_wifi_secrets.py` | fails on a use of the HOTSPOT PASSWORD or WEB CODE names in a source of `firmware/panel/` or `shared/` that is not on the tool's list, and on a log or console call whose arguments name one |
| `tools/gen_cats.py` | generates the cat drawings of the panel's screens as run-length encoded tables; `--check` fails if the committed files differ, `--preview DIR` writes each pose as a PNG; needs Pillow 12.3.0, the version CI pins |
| `tools/gen_web_blob.py` | generates `shared/webaccess/wa_web_blob.c` from the files under `shared/webaccess/web/`; `--check` fails if the committed file differs, `--sizes` prints the bytes of each file as served |
| `tools/check_comment_only.py` | proves that a change between two commits touches comments and docstrings only, by comparing the C token streams and the Python syntax trees: `tools/check_comment_only.py BASE [HEAD]` |
| `tools/ui_sources.py` | the list of C sources that `render_ui.py` and `frame_cost.py` compile; data only |
| `tools/install_arm_toolchain.sh` | installs the Ubuntu packages of the IOmcu build, keeping the `.deb` files in a directory a CI cache saves: `cache-keys` or `install ARCHIVE_DIR` |
| `tools/jlc_stock.py` | reads the stock of every part in `hardware/docs/Parts.md` from JLCPCB's and Digi-Key's interfaces; `--check N` exits 1 on a failing part for a build of N boards |
| `tools/ci_gate.py` | waits for the CI run on a commit and fails unless one passed; the first step of `docs.yml` and `release.yml` |
| `tools/release_kind.py` | reads a release tag and prints its kind, `testing` for an odd minor number and `stable` for an even one, with the `prerelease` and `latest` flags `release.yml` publishes by; with the tags of the full releases on GitHub after it, `latest` is `false` for a stable tag older than one of them; exits 1 on a tag out of form ([Releases](#releases)) |
| `tools/doc_check.py`, `Doxyfile` | runs Doxygen 1.18.0 with the `Doxyfile` over the C of `shared/`, `protocols/`, `firmware/panel/`, `firmware/iomcu/` and `testbench/touch-injector/core/`, without the generated tables, and compares its warnings, as file, message and the text of the line they name, without the line number, with `tools/doc_check_baseline.txt`; adds a warning for a C file without a `@file` block or without its `@brief`; `--check` fails on a warning not in the baseline and on a baseline line the tree does not produce, and with `--base REF` on any warning in a C file added since the merge base with `REF`, on a changed line or its comment block, for a missing `@file` block in a changed file, and on a comment block without `@brief` that the change adds or edits; a renamed file counts as new; `--update` rewrites the baseline. The HTML in `build/doxygen/html/` is the [C API (application programming interface) reference](https://subtilitas.github.io/rcbench/api/) |
| `tools/pages_changes.py` | decides whether a run of `pages.yml` is a full one, with the configurator's tests and browser tests, or builds the configurator page, the help and the API reference only: full when a changed path is under `configurator/`, `help/` or `docs/img/`, or is `pages.yml`, `rcbench_version.h`, `ui_screen.h`, `tools/help_site.py` or `tools/render_ui.py`; a push counts its changes from the newest successful push run of `pages.yml` on `main`, and is full when there is none |
| `test/tools/` | pytest cases for the tools above and for the file manager's mock server: `python3 -m pytest test/tools` |
| `test/host/wa_page_dump.c`, `test/host/wa_mock_server.py`, `test/web/` | the browser test of the Wi-Fi page's file manager, below |
| `.clang-tidy`, `.cppcheck-suppress`, `ruff.toml` | static analysis and lint configuration; every finding is an error. `ruff.toml` selects the docstring (D) rules; no file is excused them |

`doc_check.py` needs Doxygen 1.18.0 and stops with exit code 2 on another
release: `tools/install_doxygen.sh 1.18.0 <SHA-256 from ci.yml> PREFIX`
installs it as `PREFIX/bin/doxygen`.

`gen_font.py` looks for the font in `RCBENCH_FONT_DIR`, then
`~/.local/share/fonts`, then the system font directories. `frame_cost.py` needs
`valgrind`; the other tools need a C compiler and Pillow. `mutate.py` needs
git and CMake as well, and `ci_gate.py` the `gh` command. `sense_trace.py`
needs CMake and a C compiler: it builds `test/host/sense_trace_replay.c`
into `build-trace/` unless `--replay` names a built one.

## The file manager's browser test

The Wi-Fi page's file manager (`shared/webaccess/web/`) runs in Chromium
against a mock of the panel. The test needs no panel, no card and no network.

| Part | What it does |
| --- | --- |
| `test/host/wa_page_dump.c` | a host program, the CMake target `wa_page_dump`: writes the page `wa_page_main()` builds, in English and German, with the panel's highlighter words and colours, and the servo test's reports as the panel writes them, with the spans `text_hl_line()` gives each of their lines |
| `test/host/wa_mock_server.py` | serves the dumped page byte for byte and answers `/api/status`, `/api/list`, `/api/info`, `/api/file`, `PUT /api/file`, `/api/mkdir`, `/api/rename`, `/api/delete` and `/card/PATH` from a card in memory, with the JSON, headers, status codes and refusals of `wa_api.c`, `If-Match` and `If-None-Match` with 412 and 409, and the request guard of `wa_guard.c` (Host 421, Origin and `X-Rcbench-Upload` 403, body limits of 1MiB for a PUT and 1,024B for a form 413). One request at a time. The reason words and their statuses are read from `wa_api.c`, the sentences from `ui_text.def`. Python standard library only |
| `test/web/` | Playwright 1.64.0, the configurator's version, one worker, Chromium: `files.spec.ts` runs 18 tests in English and in German |
| `test/tools/test_wa_mock_server.py` | pytest cases of the mock's contract: the guard, the status codes, the PUT checks, paging, the rules of rename, move and delete |

The 18 tests: the page opens on the card's root and the User log folder;
a folder of 49 entries pages as 48 and 1; a report is viewed and every line
carries the classes of `text_hl_line()`; an edit is saved with `If-Match`;
a save over a changed file gets 412 and the unsaved question, STAY keeps the
edit and READ AGAIN drops it; the 2s hold on OVERWRITE saves with the ETag
of the refusal; upload, upload over an existing name with the question,
new folder, rename, move and delete (also cancelled, and a folder that
holds a file); DOWNLOAD and INFO; the write buttons while the bench is ARMED,
with Browser writes OFF and with HOLD. Each test also fails on an uncaught
script error of the page.

```bash
cmake -S test/host -B test/host/build -DCMAKE_BUILD_TYPE=Debug
cmake --build test/host/build --target wa_page_dump
cd test/web
npm ci
npx playwright install chromium
WA_PAGE_DUMP=../host/build/wa_page_dump npm run e2e
```

The test needs Node.js 24. `E2E_PORT` names another port than 4180. The
36 runs take 29s on the development machine; the job's time on the CI
runner is not measured.

What the mock does not do: the access code (Browser writes CODE), the ZIP
of the card, the firmware update, `PANEL_BUSY`, a full card and the panel's
hold on WI-FI. Its Host and Origin checks take the mock's own port where the
panel takes port 80 only. The page's behaviour with the panel's 4 sockets and
its timing on the ESP32-P4 are not covered.

## The ESP32-C6 radio

Wi-Fi and Bluetooth LE through the ESP32-C6 are described in [The ESP32-C6
radio](C6.md): the SDIO wiring, the managed components, the C6's firmware, its
update and recovery, failures and the Bluetooth LE service.

## CI

| Workflow | Trigger | Jobs |
| --- | --- | --- |
| `ci.yml` | push to `main`, tag `v*`, a label added to a pull request (`ci` by convention, once its reviews are clean; a push to a pull request starts no run), manual (`gh workflow run ci.yml --ref <branch>`, whose checks a pull request does not take) | host suite; the same suite under AddressSanitizer and UBSan (UndefinedBehaviorSanitizer); coverage floors and the Codecov upload in a job of its own that no required check needs, which fails when the upload fails; the checks that hold generated files to their sources (fonts, board drawings, cat tables, KiCad library, mechanical models, ESC profile tables, file manager strings); the file-size, docs, Wi-Fi secret, units, writing-rule, web help, `SECURITY.md` parser, wiki-link, screenshot and string-fit checks; the translated-format check; the check of the code the IOmcu builds for busy waits, sleeps and blocking prints (`tools/check_loop_waits.py`); the frame-cost job; the protocol module check; clang-tidy 22.1.8 and cppcheck 2.17.1 over `shared/`, the cores under `protocols/` and `test/host/`, cppcheck's warning, performance and portability classes over `firmware/` and the pin drivers under `protocols/`, and ruff; the tools' pytest cases; the Doxygen comment check of `tools/doc_check.py`, which in a pull request also fails on any warning in a C file the pull request adds or on a line it changes; on a pull request the mutation check of the changed lines, which reports and does not fail on a survivor; the C6 radio's image from esp_hosted's `slave/` folder on ESP-IDF v6.1 for the ESP32-C6 (`c6.yml`, [The image the panel carries](C6.md#the-image-the-panel-carries)); panel build on ESP-IDF v6.1 for the ESP32-P4 with the check of the generated sdkconfig against `sdkconfig.defaults` (`tools/check_sdkconfig.py`), the check of the image against its update slot, a check that the image carries the IOmcu images and the C6 image and holds the touch injector's symbols, the console's frame lines (`tools/check_perf_log.py`) and exFAT, and a second build with `RCBENCH_TOUCH_INJECTOR=OFF` and `RCBENCH_PERF_LOG=OFF` that fails when it holds an injector symbol or a frame line; IOmcu build on pico-sdk 2.3.0 with the pin map check and the stack check of its two cores, once more with `-DSENSE_TRACE=ON`, with the same stack check, failing when the default image holds a trace symbol, and once more with `-DIOMCU_CONSOLE=ON`, with the same stack check, failing when the default image holds a console symbol; the touch injector build on pico-sdk 2.3.0 for `waveshare_rp2350_zero`, not uploaded; the file manager's browser test (`Web file manager browser test`: the `wa_page_dump` target, then `test/web` on Node.js 24 and Chromium, traces and screenshots kept for 14 days on a failure only); firmware artifacts including a merged panel image for offset 0 |
| `docs.yml` | push to `main` touching `docs/`, manual | waits for the CI run on the same commit and, when it passed, mirrors `docs/` to the GitHub wiki |
| `mutation.yml` | Sunday 03:17 UTC, manual | every mutant of the lines of `shared/safety` and `shared/outputs` (6400 mutants in 81 files) in 6 parallel shards of files, no mutant limit, no mutant started after 18000s in a shard; the mutants left then are reported as not run; does not fail on a survivor; the result is the artifacts `mutation-full-0` to `mutation-full-5` and the job summaries |
| `c6.yml` | called by `ci.yml` and `release.yml` | the C6 radio's image and its checks (`tools/c6_image.py`); artifact `c6` |
| `release.yml` | tag `v*`, manual for a tag | waits for the CI run on the tagged commit and, when it passed, builds both images and the C6 radio's (`c6.yml`), the panel's carrying the IOmcu images and the C6 image, with `-D RCBENCH_PERF_LOG=OFF` and a check that it holds no frame line, packages them with checksums and creates a release, a pre-release for an odd minor number ([Releases](#releases)); beside that, without holding the release back, runs the configurator data check (`configurator/core/tools/check-annotate.sh --warn-only`) and shows each warning, such as a release tag newer than the configurator data, as an annotation and in the run summary |
| `pages.yml` | pull request and push to `main` touching `configurator/`, `help/`, `docs/img/`, the help generator, the `Doxyfile` or `tools/install_doxygen.sh`; a push to `main` touching the C sources as well | type check, tests, data check, size budget and browser tests of the configurator; the web help build of `tools/help_site.py`; the C API reference built by Doxygen 1.18.0; on a push to `main` it publishes the built page to GitHub Pages, with the web help under `help/` and the API reference under `api/`. A run that changes only the C sources, the `Doxyfile` or `tools/install_doxygen.sh` builds the configurator page without its checks and runs no browser test |

Every job runs on Ubuntu 26.04 (`runs-on: ubuntu-26.04`), not on
`ubuntu-latest`. The host suite is five parallel jobs: `Host suite, build and
ctest`, `Host suite under sanitizers`, `Host suite coverage`, `Checks that hold
prose and generated files to the tree` and `Frame cost of every screen`. Each
installs its packages through the composite action
`.github/actions/host-deps`. Every apt install in CI first runs
`.github/actions/apt-prepare`: it removes the runner's Google and Microsoft
package lists, makes a download that receives no data for 30s retry up to 3
times, and runs `apt-get update`. `host-deps` keeps the downloaded `.deb`
files in an `actions/cache` entry keyed on its own file, so a slow mirror
costs only the packages that changed since the entry was saved. The job `Host suite, coverage and the checks that
hold prose to the tree` needs the five, runs also when one of them fails, and
fails unless all five succeed; it is the name the branch ruleset requires.
The compilers of that image are gcc 15.2 for the host build and
arm-none-eabi-gcc 14.2.1 for the IOmcu.

Four results depend on the runner image that produces them.
`tools/render_ui.py` and `tools/frame_cost.py` compile with
`-ffp-contract=off`, because that gcc targets x86-64-v3, fuses a multiply and
an add into one rounding, and moves single pixels of the arcs and plot lines.
The coverage table in `STATUS.md` and the figure in the READMEs are gcov's
line counts for gcc 15.2; another gcc counts some lines differently, so
`tools/coverage.py --check` fails on a machine with another release. Write
the table from the `coverage` artifact of a CI run with
`python3 tools/coverage.py --from-json coverage.json`. The IOmcu stack
figures of `docs/Performance.md` are those of arm-none-eabi-gcc 14.2.1,
which ARM GNU 14.2.Rel1 also gives. The fills of the frame-cost table in the
same file are cachegrind counts of a build on that image, run with a fixed
environment (the length of the environment shifts the stack, and with it a
count by up to 9%); a machine with another libc can differ, and
`tools/frame_cost.py --check-doc` accepts 3% of a mode, with a minimum allowance of 500 fills.

clang-tidy does not run over `firmware/`: it compiles each file and needs
the ESP-IDF and pico-sdk headers, which the analysis job does not have.
cppcheck's style class does not run over `firmware/` either. The host tests
are built with the library flags `-Wall -Wextra -Werror -Wshadow -Wconversion
-Wno-sign-conversion`; `test/host/.clang-tidy` lists the checks that are off
for them, each with its reason.

cppcheck runs in the job `cppcheck`, beside `Lint and static analysis`,
which runs clang-tidy over every file on every run. cppcheck keeps its
build directory (`--cppcheck-build-dir`) between CI runs: it re-reads a
file when the file or an included file differs from its record, and
replays the findings of the files it skips. The build directory's cache is
keyed on the cppcheck version, its options, include paths and
`.cppcheck-suppress`. A run restores the newest cache its branch can read:
its own, its pull request's base branch's, then `main`'s; a branch gets a
cache only from a CI run on it, and `ci.yml` runs on push only for `main`
and tags.

CI installs pillow 12.3.0, gcovr 8.6, ruff 0.16.5 and pytest 9.1.1 at these
exact versions, Doxygen 1.18.0 from the official Linux release archive
(`tools/install_doxygen.sh` checks its SHA-256 against the value in
`ci.yml`), and cppcheck 2.17.1 built from the official source archive of
the tag (`tools/install_cppcheck.sh` checks its SHA-256 against the value in
`ci.yml` and fails on a mismatch; the build is cached on version and hash). The
distribution's cppcheck is older (2.13 on Ubuntu 24.04) and reports differently;
install 2.17.1 locally with `tools/install_cppcheck.sh 2.17.1 <SHA-256 from
ci.yml> ~/cppcheck-2.17.1` or from a distribution package of 2.17.1. Every job has a `timeout-minutes` limit: 100min for the jobs that wait for CI with `tools/ci_gate.py` (up to 5400s, 90min), 10 to 60min for the others. ctest stops a
test after 120s. With the environment variable `CI` set, a missing C++
compiler fails the CMake configure step of the host suite, and a missing `git`, `cmake` or `cc`
fails the end-to-end cases of `tools/mutate.py`. `tools/check_docs.py` holds
the pico-sdk and ESP-IDF tags of this page to those in `ci.yml` and
`release.yml`, and fails when a build page has no ESP-IDF tag statement.

Every check runs locally;
[CONTRIBUTING.md](https://github.com/subtilitas/rcbench/blob/main/CONTRIBUTING.md)
lists the commands.

The wiki must contain at least one page before the first `docs.yml` run;
otherwise the wiki repository does not exist and the clone fails.

## Releases

A release is a tag `vMAJOR.MINOR.PATCH` on `main`. Its minor number names
its kind:

| Minor number | Kind | On GitHub | Examples |
| --- | --- | --- | --- |
| odd | testing release | pre-release, never marked latest | 0.21.0, 0.21.3, 0.23.0, 1.3.0 |
| even | stable release | full release, marked latest unless a newer full release exists | 0.22.0, 0.22.3, 1.4.0 |

The patch number carries fixes in either kind: 0.21.1 is a fix of the
testing release 0.21.0, 0.22.1 a fix of the stable release 0.22.0.

`release.yml` reads the kind with `tools/release_kind.py` before it waits
for CI (continuous integration). A tag in the wrong format fails the job, and
nothing is built. Before publishing, it runs the tool again with the tags of
the full releases then available on GitHub. Only one release is published
at a time across all tags. A stable release older than a published one is not marked latest:

```bash
python3 tools/release_kind.py v0.21.0   # kind=testing prerelease=true latest=false
python3 tools/release_kind.py v0.22.0   # kind=stable prerelease=false latest=true
python3 tools/release_kind.py v0.22.0 v0.20.0 v0.24.0   # kind=stable prerelease=false latest=false
```

`https://github.com/subtilitas/rcbench/releases/latest` names the newest
stable release. 0.22 is the last release line for the ESP32-S3 panel, and
later releases are for the 7-inch ESP32-P4 display board from Waveshare.
The panel's check reads GitHub's latest release with RELEASES set to
STABLE on SETUP > UPDATES, the default, and the 10 newest releases with
TESTING. The ESP32-P4 panel's line is uncapped: on both settings
it offers any release newer than the version it runs. The 0.22.x cap, with
the second read STABLE makes for it, belongs to the ESP32-S3 panel's
line only ([Screens: The release line](Screens.md#the-release-line)).
A release can also be loaded manually: its
`rcbench-panel-p4-vX.Y.Z.bin` through the panel's browser page, or its
archives over USB (Universal Serial Bus), as described in
[First run, §1](FirstRun.md#1-flash-both-boards). The release's
`rcbench-iomcu-vX.Y.Z.zip` and the image the panel carries are of the same
commit. So are `rcbench-c6-2.13.0.bin`, the C6 image the panel carries, and
`rcbench-c6-merged-2.13.0.bin`, the one for header H4; their names carry
esp_hosted's version, and SHA256SUMS lists both.
