subtilitas/rcbench/help/content/en/setup-wireless.md

---
screen: none
title: Wireless
order: 62
---

# Wireless

WIRELESS on [SETUP](setup.md) holds the panel's Bluetooth LE (Low Energy) devices: the WitMotion BWT901CL IMU (inertial measurement unit), the M5Stack Dial, a wireless knob, and the power node, an INA228 on the ESC's XT60. All reach the panel through the board's ESP32-C6. The first IMU ON, Dial ON or Power node ON starts Bluetooth LE until the panel restarts. Settings are retained and saved like other SETUP values.

## The left list

The 220px left list has 3 entries: IMU, DIAL and POWER NODE. Each shows its name and its state. Tap an entry to display its settings in the 754px right pane. The list works as on [Sensors](setup-sensors.md#the-left-list): an entry that is off shows its enable row alone and the state `OFF`, each entry keeps its scroll position, and RESET names the entry, `RESET DIAL`.

## The IMU

WIRELESS on the IMU entry, connected

The IMU off: IMU and Angle source

The WitMotion BWT901CL connects over Bluetooth LE through the board's ESP32-C6. Use the [IMU](imu.md) tile on SETUP to scan, bind and calibrate it. This entry contains its settings.

| Setting | Range | Default | What it does |
|---|---|---|---|
| IMU | ON, OFF | OFF | Bluetooth LE, the link to the bound sensor and its reading; the first ON starts Bluetooth LE until the panel restarts |
| Angle source | AS5600, IMU | AS5600 | where the servo runs take their angle from ([Servo settings](servo-settings.md)); shown with the IMU off too, so the source can go back to the AS5600 without switching the IMU on |
| IMU axis | X, Y, Z | X | the angle the servo runs and RUDDER read; `Z: 1° WITH THE MAGNETOMETER` |
| IMU sign | +, - | + | `-` turns that angle round |
| IMU rate | 10Hz, 20Hz, 50Hz, 100Hz, 200Hz | 50Hz | the sensor's frames a second; sent only when changed, it takes effect after the sensor is switched off and on; the sensor ships at 10Hz, and `CONNECTED` shows the rate it runs |
| IMU algorithm | 6-AXIS, 9-AXIS | 6-AXIS | 9-AXIS takes the magnetometer for Z |
| IMU filter | 1 to 50 | 1 | the panel's low-pass on the angle; 1 is off |

IMU filter smooths the angle on the panel, per frame and axis: the angle moves by 1/k of the difference to the new frame, with k the setting. It covers 63% of a step in about k frames, so at 10Hz an IMU filter of 10 takes about 1s. The frames per second are the rate the sensor runs, which `CONNECTED` shows, not the IMU rate asked. The IMU screen, RUDDER, AUTO and the servo runs read the filtered angle. The first frame after a connect starts the filter at its own value, and a crossing of 180° takes the short way. AUTO waits until the filtered angle has settled, up to 3000ms plus the time the setting can take ([The Bluetooth IMU](https://github.com/subtilitas/rcbench/wiki/IMU#the-filter)).

RATE and ALGORITHM changes are sent with the sensor's SAVE command (`FF AA 00 00 00`). For a connected sensor, the rate message is `RATE SAVED: SWITCH THE SENSOR OFF AND ON`. If disconnected, the panel shows `RATE IS SENT WHEN THE SENSOR CONNECTS; THEN SWITCH IT OFF AND ON` and waits for frames. During IMU calibration it shows `RATE IS SENT AFTER CALIBRATION; THEN SWITCH THE SENSOR OFF AND ON` and defers the change until after CALSW 0 and SAVE.

| State | When |
|---|---|
| `OFF` | IMU OFF |
| `STARTING BLUETOOTH` | Bluetooth LE starts: the C6's link, the host, its sync |
| `NO BLUETOOTH ON C6` | the host has no sync with the C6; it keeps trying |
| `C6 FAILED: RESTART` | the C6's link failed; Wi-Fi and Bluetooth are off until the panel restarts |
| `NO SENSOR BOUND` | Bluetooth runs; no sensor is bound |
| `SCANNING` | a scan runs |
| `CONNECTING` | the panel connects to the bound sensor and sets up its service |
| `BOUND` | subscribed, no angle frame yet; or the bound device is not a WitMotion sensor |
| `CONNECTED 50Hz` | angle frames within the last 300ms, at that rate |
| `NO FRAMES` | subscribed, frames came, none in the last 300ms |

## The Dial

WIRELESS on the DIAL entry, linked

The M5Stack Dial turns the throttle on [MOTOR & ESC](motor.md) and the horn on [SERVO](servo.md) LIVE, as the panel's own knob does. It never switches anything on: ARM, SUPPLY ON, PROG 5V and every 2s hold stay on the panel, and so does STOP.

| Setting | Range | Default | What it does |
|---|---|---|---|
| Dial | ON, OFF | OFF | Bluetooth LE and the link to the bound Dial; OFF ends the link, and a Dial switched off is no loss |
| Scan for Dial | `SCAN` | | a tap scans 10s and lists the Dials in range; a switch to ARMED stops it, `STOPPED BY ARM`; refused while ARMED, with `NO DIAL SCAN WHILE ARMED: SWITCH TO SAFE FIRST` in the band |
| Bound Dial | `NONE` or the Dial's name | `NONE` | a tap lists the Dials the last scan found, with their signal in dBm; a tap on one binds it and asks for a save. RESET keeps the bound Dial |
| Dial step, throttle | 0.5%, 1%, 2%, 5% | 1% | the throttle one detent moves |
| Dial step, servo | 0.5°, 1°, 2°, 5° | 1° | the horn angle one detent moves |

The panel connects to the bound Dial by its address, without a scan, and again after each loss. A Dial in range that is not bound is never taken.

On the bench screens:

- A turn moves nothing while the bench is SAFE, and turns made while SAFE are not kept for the ARM. The first EVENT after a connect, an EVENT more than 300ms after the last and a jump of more than 16 detents move nothing.
- A press of the Dial's screen button while ARMED sets the throttle to 0% on MOTOR & ESC and the horn to CENTER on SERVO. A 1s hold DISARMs, also while an ARM is on its way, and ends an ESC STICK run as ABORT does.
- A Dial lost while ARMED is an error: 1000ms without an EVENT, or the disconnect, switches the bench to SAFE with all outputs off, and the band shows `DIAL LOST WHILE ARMED: SWITCHED TO SAFE, ALL OUTPUTS OFF`. 500ms without an EVENT shows `DIAL: NO EVENT FOR 500ms`. The clock starts at the first EVENT of a connection, so a connect that has sent none is no loss.
- Other screens take no turn from the Dial. The Dial shows their title and the bench's state.

| State | When |
|---|---|
| `OFF` | Dial OFF |
| `STARTING BLUETOOTH` | Bluetooth LE starts |
| `NO BLUETOOTH ON C6` | the host has no sync with the C6; it keeps trying |
| `C6 FAILED: RESTART` | the C6's link failed until the panel restarts |
| `NO DIAL BOUND` | Bluetooth runs; no Dial is bound |
| `SCANNING` | a scan runs |
| `CONNECTING` | the panel connects to the bound Dial and sets up its service |
| `BOUND: NOT A DIAL` | the bound device serves no Dial service |
| `CONNECTED, NO EVENT` | the link stands; no EVENT yet |
| `OTHER PROTOCOL 2` | the Dial's firmware speaks another protocol version; nothing it sends is taken |
| `CONNECTED` | EVENTs within the last 500ms |
| `DEGRADED` | no EVENT for 500ms |
| `DIAL LOST` | no EVENT for 1000ms, or the disconnect |

## The power node

WIRELESS on the POWER NODE entry, connected

The power node is an ESP32-C6 with its own cell that reads an INA228 on the ESC's (electronic speed controller's) XT60 and sends its readings over Bluetooth LE. INA228 source decides whose INA228 MOTOR & ESC shows: the IOmcu's, wired, or the node's.

| Setting | Range | Default | What it does |
|---|---|---|---|
| Power node | ON, OFF | OFF | Bluetooth LE and the link to the bound node; OFF ends the link without an error |
| INA228 source | WIRED, NODE | WIRED | WIRED: the IOmcu's INA228 ([Sensors](setup-sensors.md)); NODE: the power node's readings. Shown with the node off too, so the source can go back to WIRED |
| Scan for node | `SCAN` | | a tap scans 10s and lists the power nodes in range; a switch to ARMED stops it, `STOPPED BY ARM`; refused while ARMED, with `NO NODE SCAN WHILE ARMED: SWITCH TO SAFE FIRST` in the band |
| Bound node | `NONE` or the node's name | `NONE` | a tap lists the nodes the last scan found, with their signal in dBm; a tap on one binds it and asks for a save. RESET keeps the bound node |
| Node battery | `3.92V`, `LOW 3.41V`, `NO CELL`, `READ FAILED`, `NOT LINKED` | | the node's cell, from its status every 1s; `LOW` under 3.5V |

With INA228 source on NODE:

- MOTOR & ESC's voltage, current, power, peaks, charge and energy are the node's while the IOmcu link is up. The ESC's own telemetry stays beside them. The log's `source` column reads `node`.
- A reading older than 300ms is none.
- An ARM of MOTOR & ESC or ESC STICK is refused while Power node is OFF or no reading came in the last 100ms, with `Cannot switch to ARMED: no power node readings. Set INA228 source WIRED or connect the node.` in the band. SERVO and OUTPUTS arm whatever the node does.
- In a MOTOR & ESC or ESC STICK run, a gap without a reading of up to 300ms rides, once in 10s. A longer gap, or a second one within 10s, switches the bench to SAFE with all outputs off, and the band shows `POWER NODE READINGS LOST WHILE ARMED: SWITCHED TO SAFE, ALL OUTPUTS OFF`. A SERVO or OUTPUTS run does not end on the node.
- INA228 source does not change while ARMED.
- The node's readings feed no protection: the current limits and trips read their own sensors.

| State | When |
|---|---|
| `OFF` | Power node OFF |
| `STARTING BLUETOOTH` | Bluetooth LE starts |
| `NO BLUETOOTH ON C6` | the host has no sync with the C6; it keeps trying |
| `C6 FAILED: RESTART` | the C6's link failed until the panel restarts |
| `NO NODE BOUND` | Bluetooth runs; no node is bound |
| `SCANNING` | a scan runs |
| `CONNECTING` | the panel connects to the bound node and sets up its service |
| `NOT A POWER NODE` | the bound device serves no node service, or is a balance node |
| `CONNECTED, NO READING` | the link stands; no reading yet |
| `OTHER PROTOCOL 2` | the node's firmware speaks another protocol version; nothing it sends is taken |
| `INA228 SET-UP REFUSED` | the node names a shunt and range the panel cannot scale; nothing it sends is taken |
| `NO INA228 ON THE NODE` | the node sends, but its INA228 is not online |
| `CONNECTED` | a reading within the last 300ms |
| `NO READING FOR 300ms` | linked, no reading for 300ms |
| `NODE LOST` | the link dropped after a reading |

## Related pages

- [Setup](setup.md)
- [IMU](imu.md)
- [Sensors](setup-sensors.md)
- [Motor and ESC](motor.md)
- [Servo](servo.md)
- [Sensor nodes](https://github.com/subtilitas/rcbench/wiki/Nodes#the-panel)
