subtilitas/rcbench/docs/img/de/help-setup.png

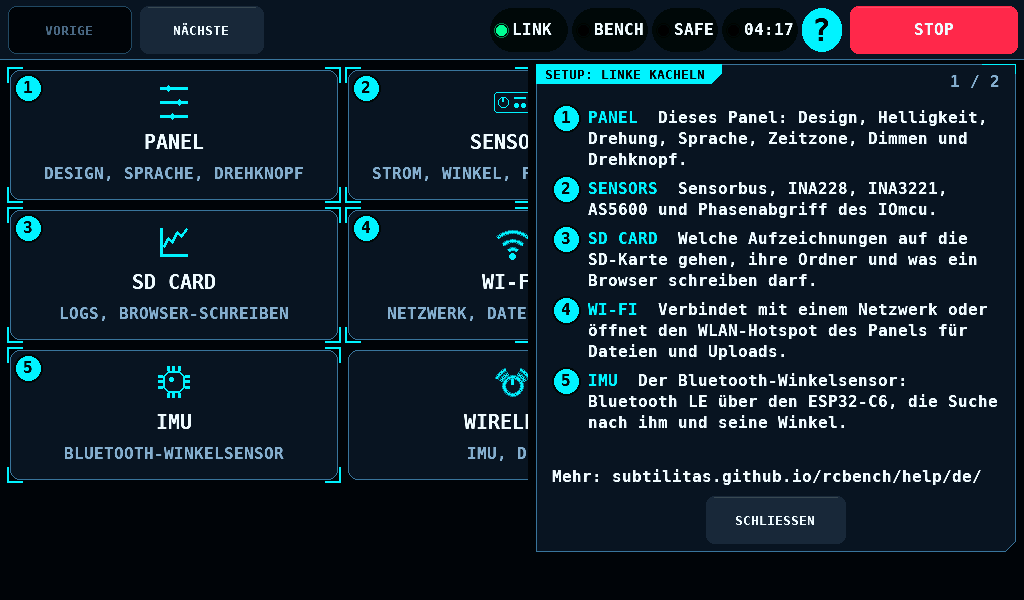
docs/img/de/help-setup.png
