subtilitas/rcbench/docs/img/de/programmer-stick-hand-steps.png

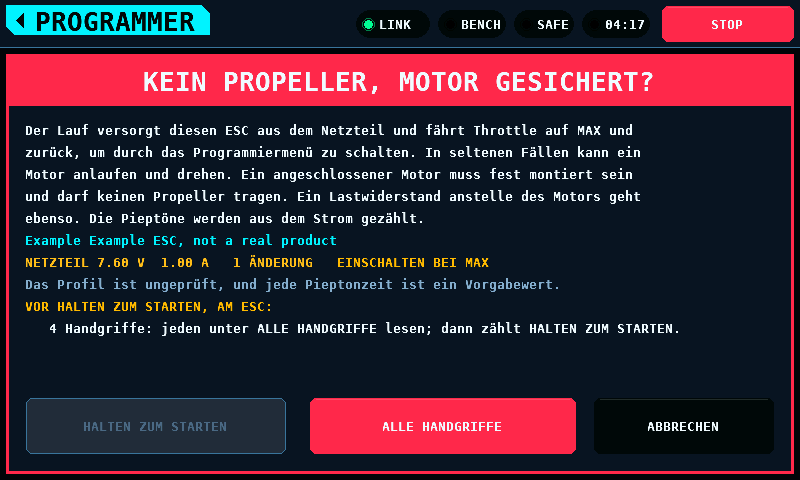
docs/img/de/programmer-stick-hand-steps.png
