subtilitas/rcbench/docs/img/de/setup-application.png

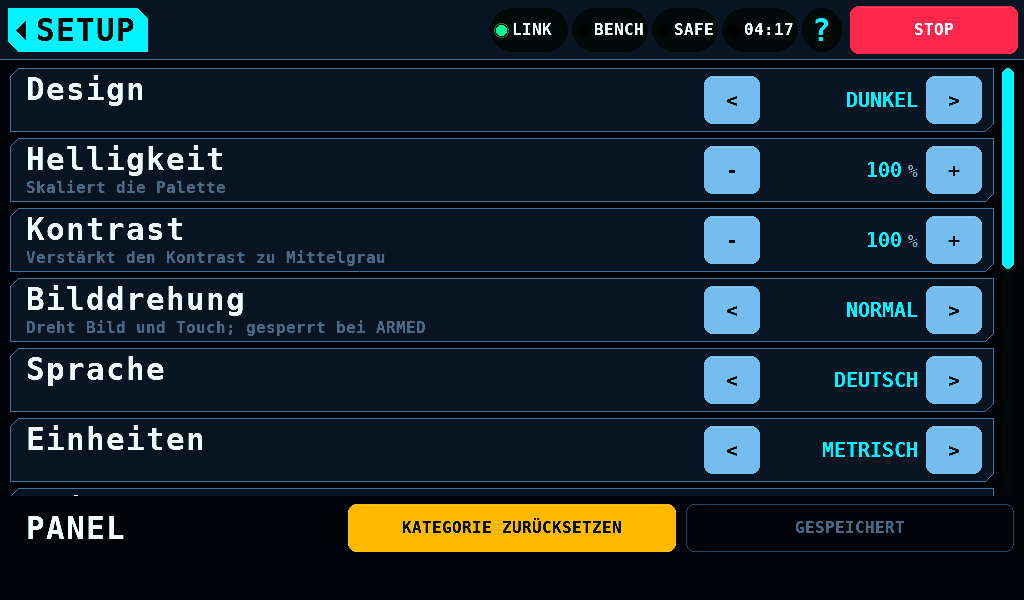
docs/img/de/setup-application.png
