subtilitas/rcbench/docs/img/de/setup-card.png

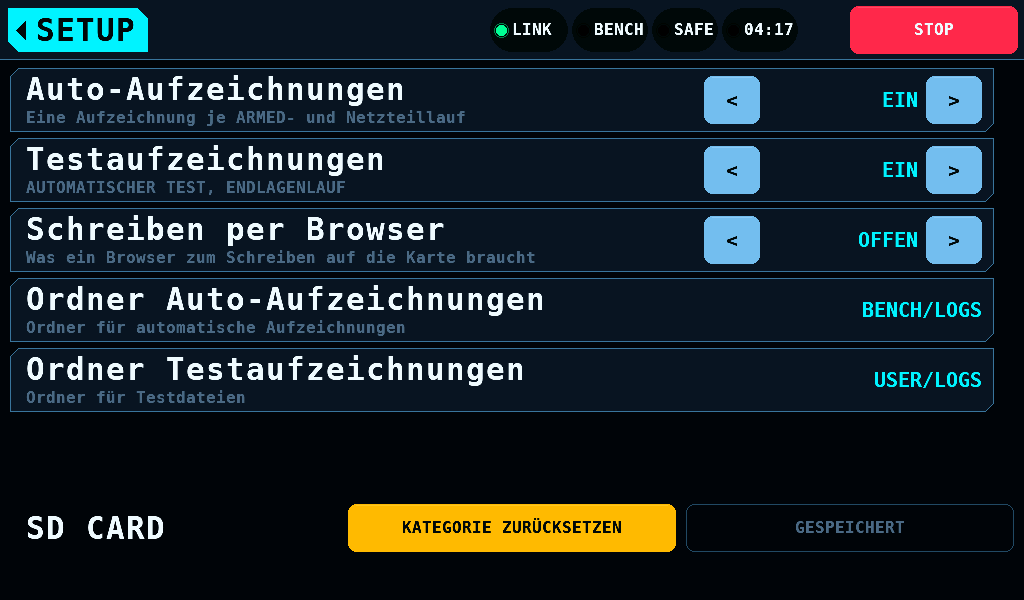
docs/img/de/setup-card.png
