subtilitas/rcbench/docs/img/de/setup-dim-stored.png

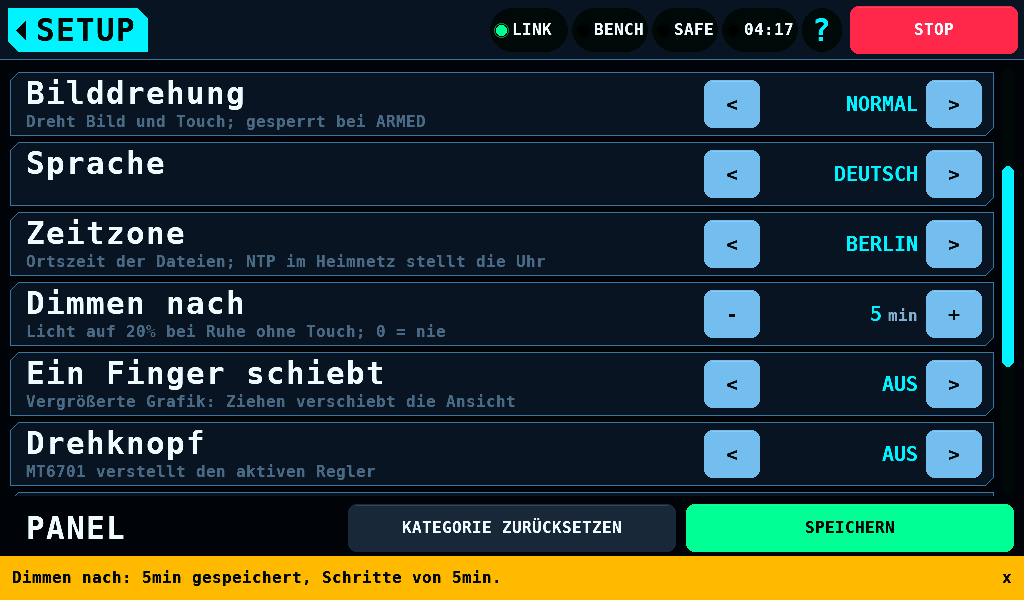
docs/img/de/setup-dim-stored.png
