subtilitas/rcbench/docs/img/de/setup-dirty.png

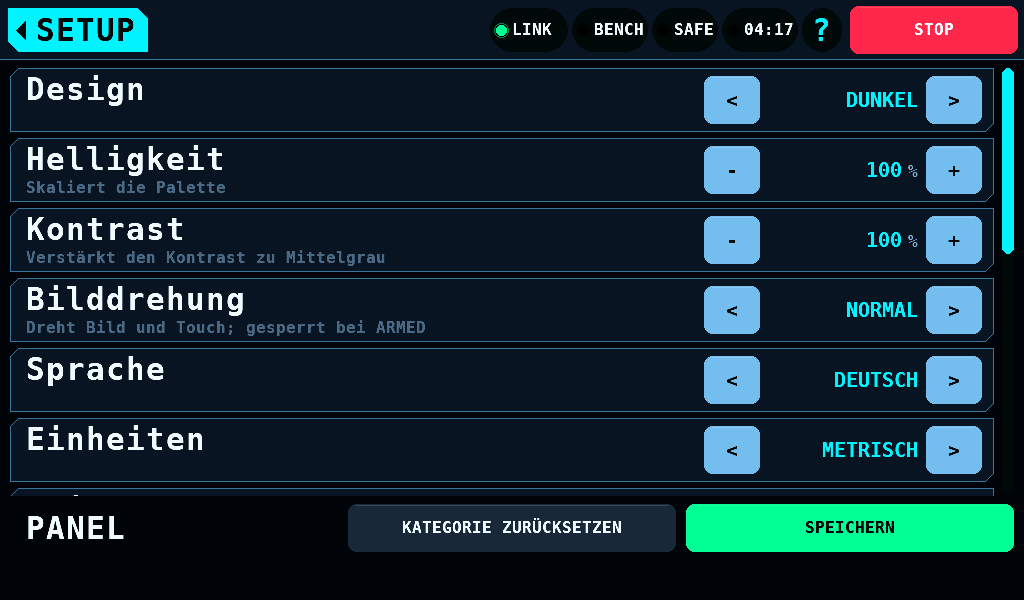
docs/img/de/setup-dirty.png
