subtilitas/rcbench/docs/img/de/setup-folder.png

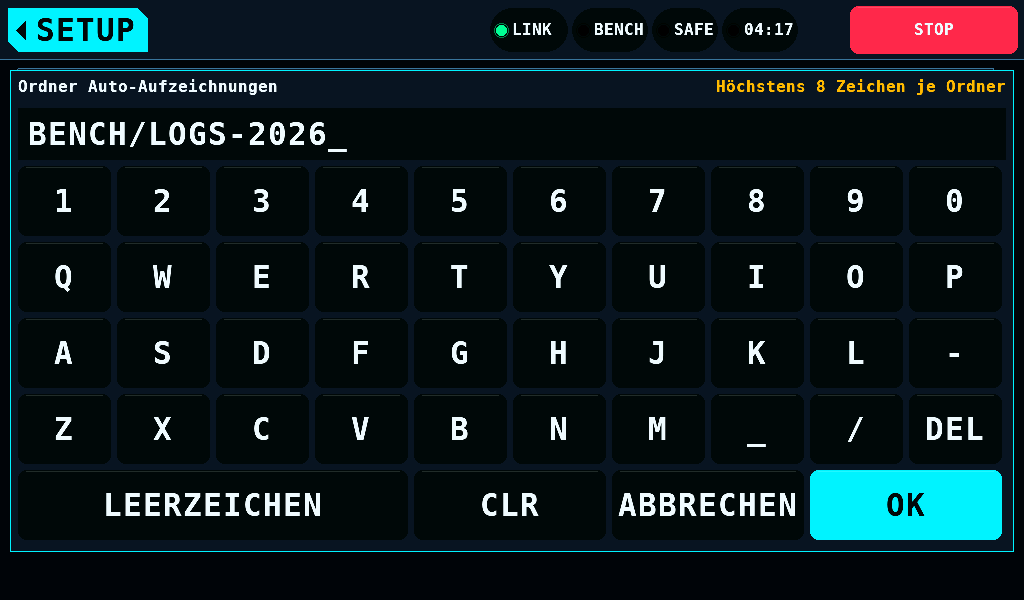
docs/img/de/setup-folder.png
