subtilitas/rcbench/docs/img/de/setup-hub-dirty.png

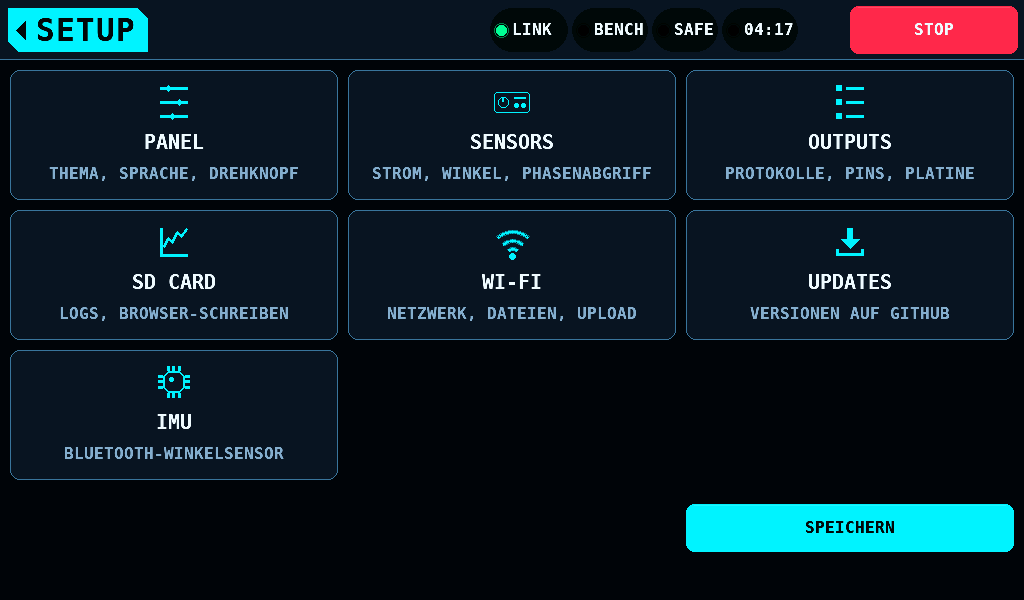
docs/img/de/setup-hub-dirty.png
