subtilitas/rcbench/docs/img/de/setup-interfaces.png

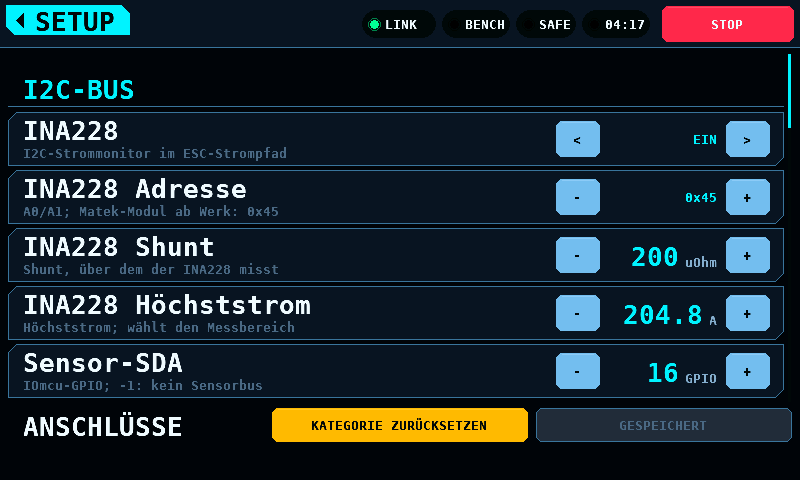
docs/img/de/setup-interfaces.png
