subtilitas/rcbench/docs/img/de/setup-leave-many.png

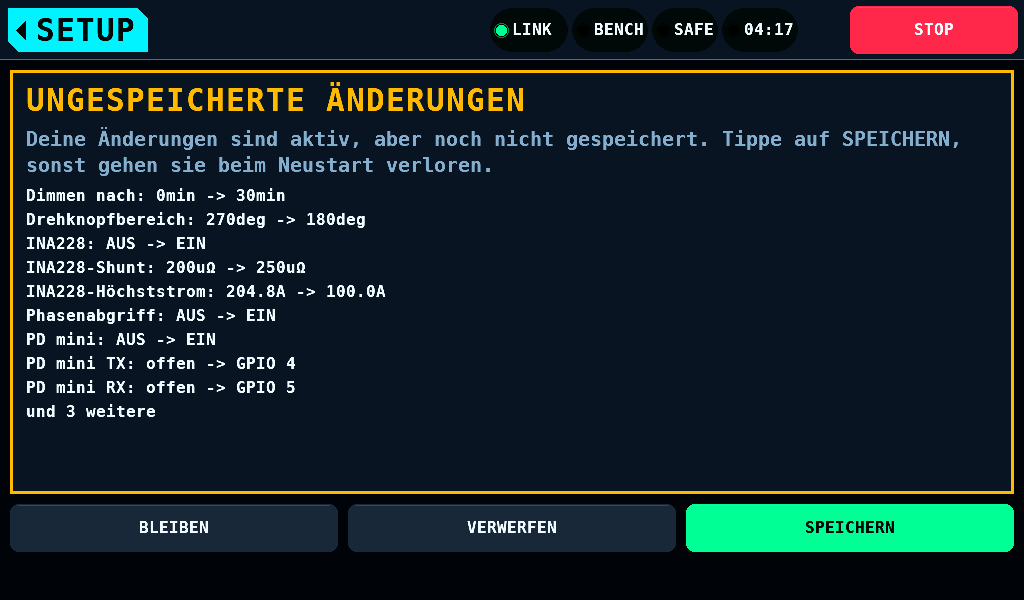
docs/img/de/setup-leave-many.png
