subtilitas/rcbench/docs/img/de/setup-light.png

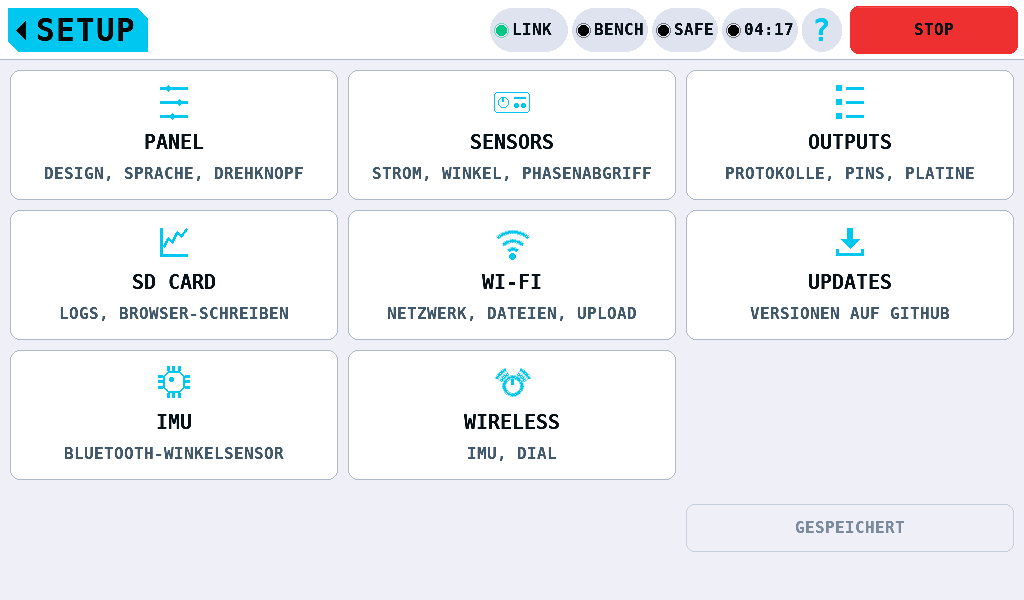
docs/img/de/setup-light.png
