subtilitas/rcbench/docs/img/de/setup-pdmini-why.png

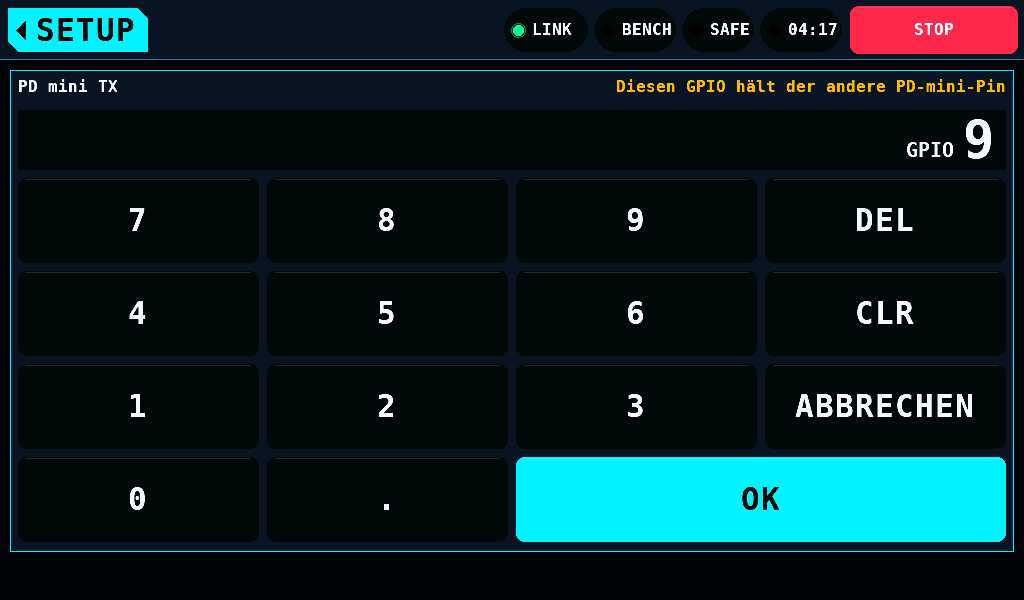
docs/img/de/setup-pdmini-why.png
