subtilitas/rcbench/docs/img/de/setup-prog.png

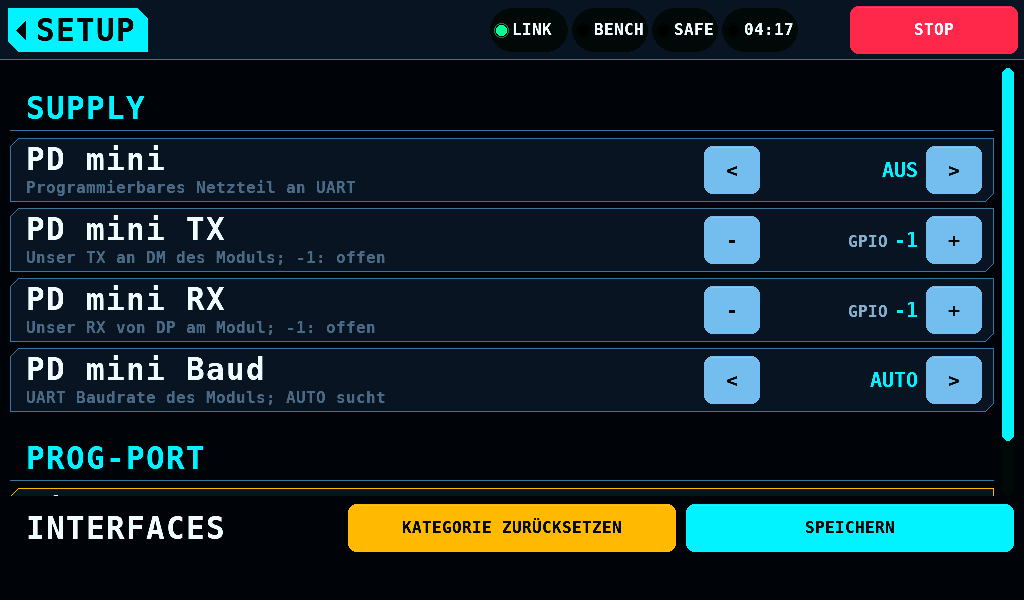
docs/img/de/setup-prog.png
