subtilitas/rcbench/docs/img/de/setup-rbmod.png

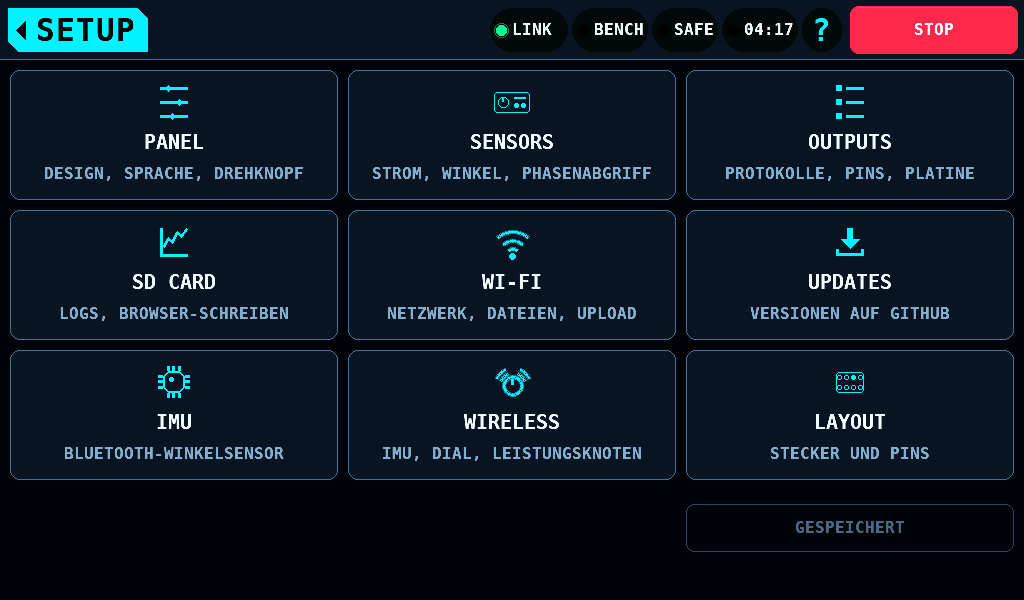
docs/img/de/setup-rbmod.png
