subtilitas/rcbench/docs/img/de/setup-sensors-imu-off.png

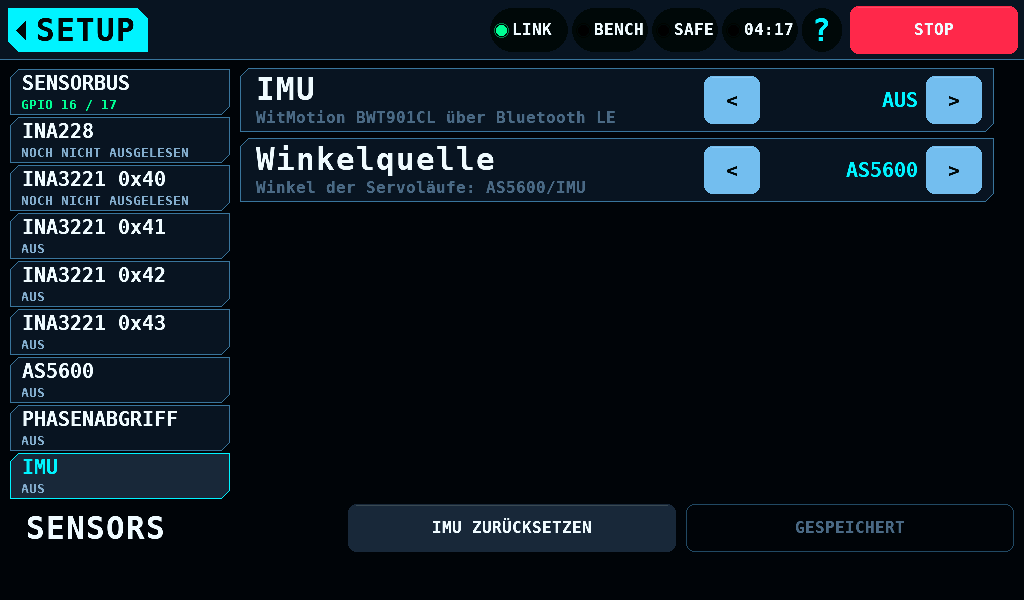
docs/img/de/setup-sensors-imu-off.png
