subtilitas/rcbench/docs/img/de/setup-sensors-imu.png

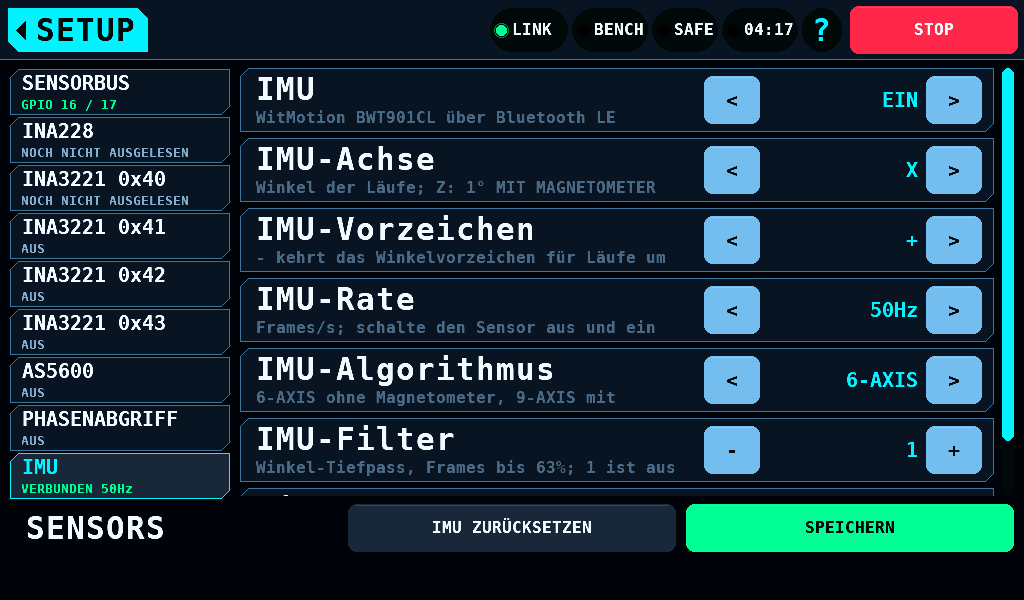
docs/img/de/setup-sensors-imu.png
