subtilitas/rcbench/docs/img/de/setup-sensors-ina228.png

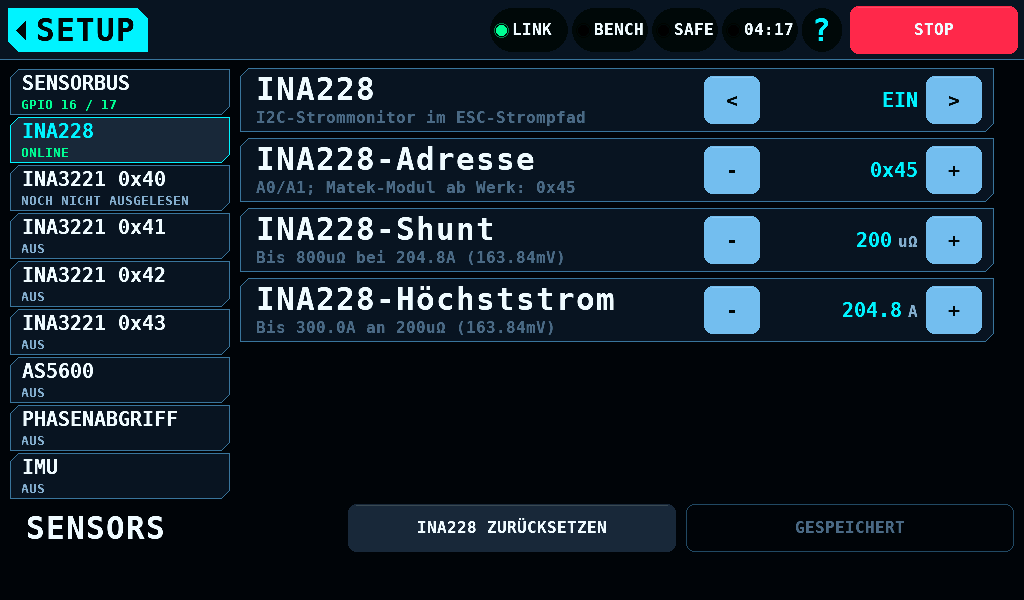
docs/img/de/setup-sensors-ina228.png
