subtilitas/rcbench/docs/img/de/setup-sensors-limit.png

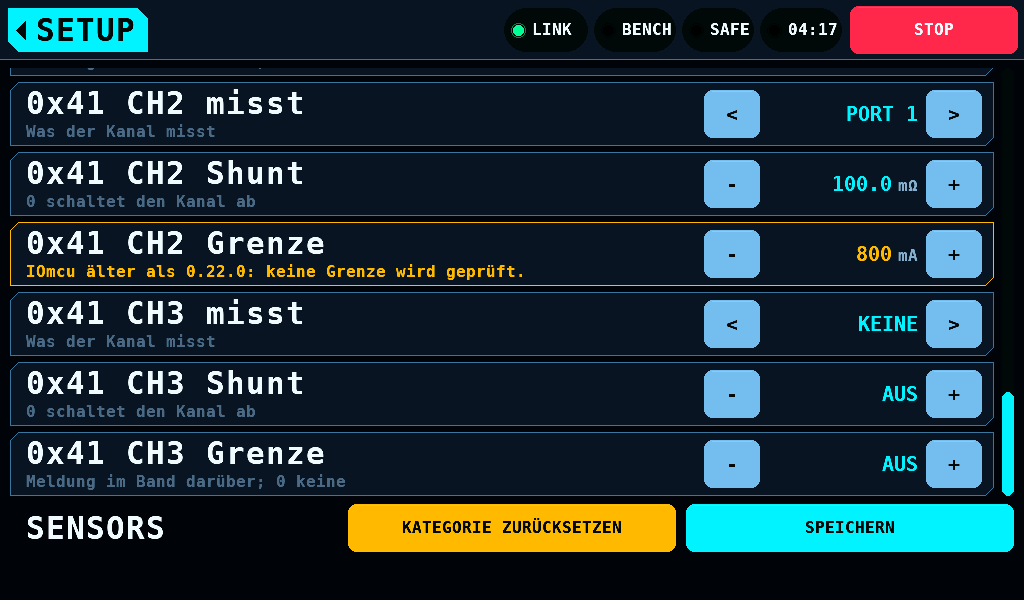
docs/img/de/setup-sensors-limit.png
