subtilitas/rcbench/docs/img/de/setup-sensors.png

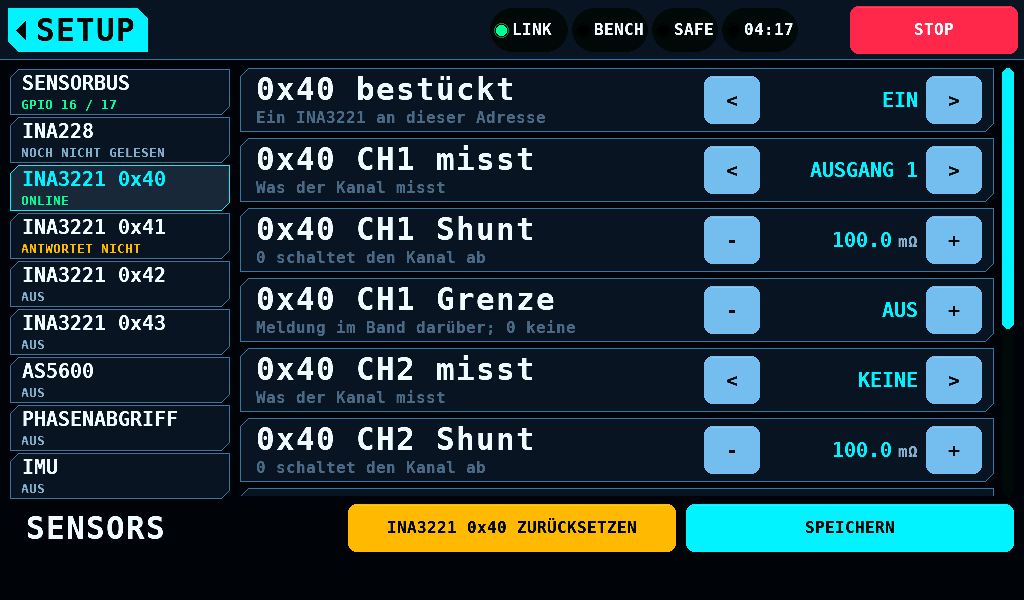
docs/img/de/setup-sensors.png
