subtilitas/rcbench/docs/img/de/setup-tap.png

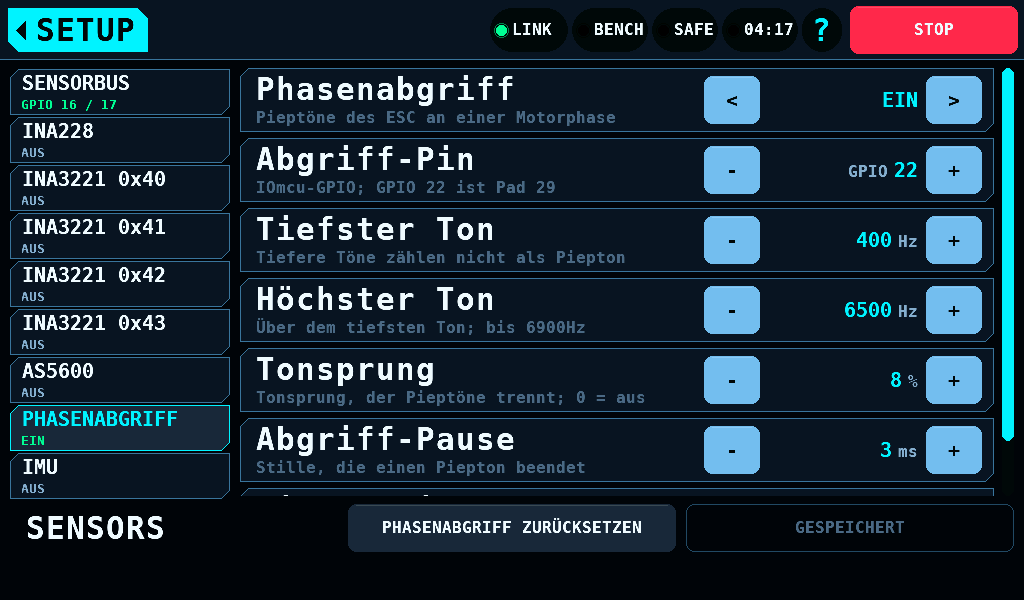
docs/img/de/setup-tap.png
