subtilitas/rcbench/docs/img/de/setup-unheld.png

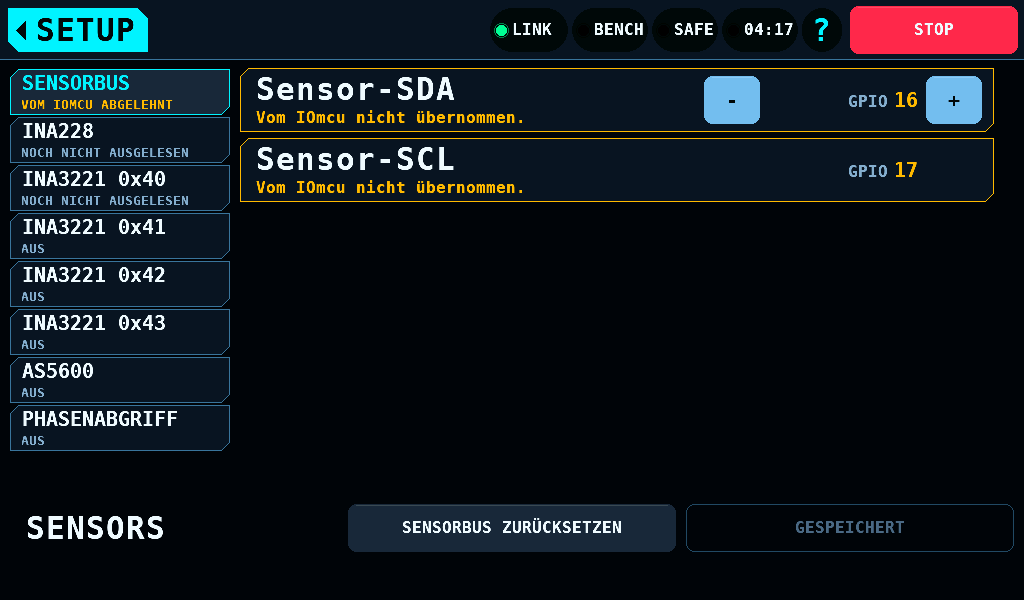
docs/img/de/setup-unheld.png
