subtilitas/rcbench/docs/img/de/setup-wireless-dial.png

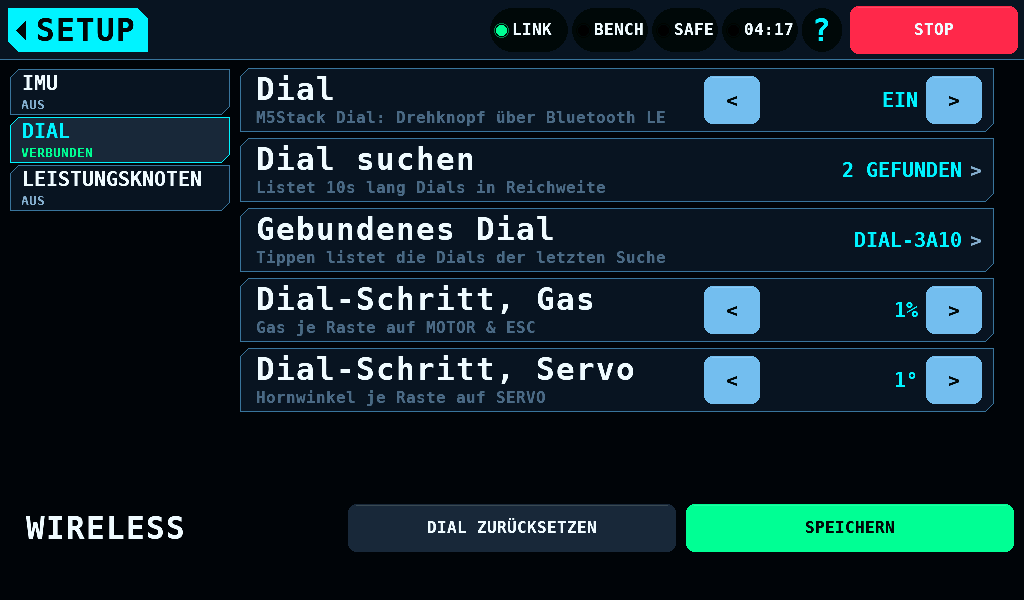
docs/img/de/setup-wireless-dial.png
