subtilitas/rcbench/docs/img/de/wifi-installed.png

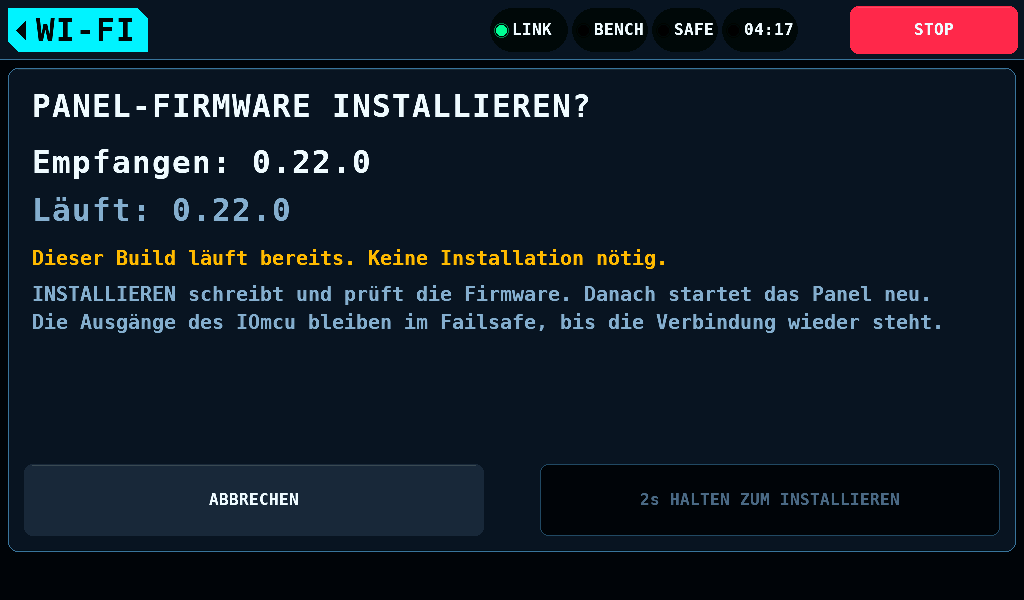
docs/img/de/wifi-installed.png
