subtilitas/rcbench/docs/img/de/wifi-rebuild.png

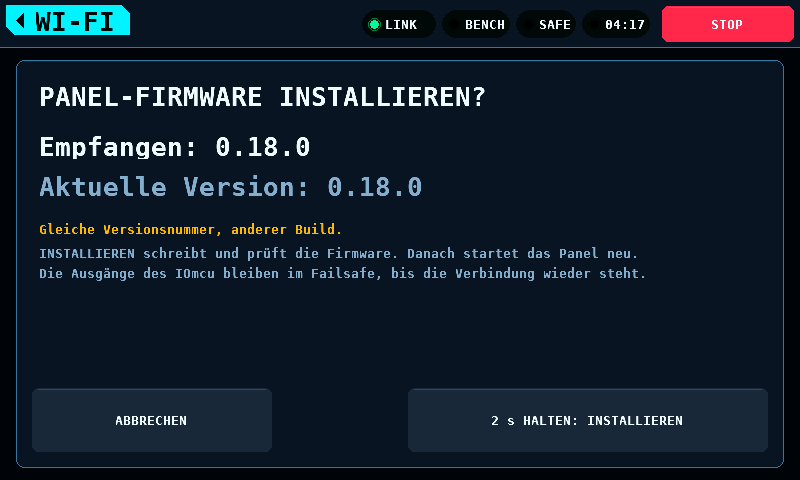
docs/img/de/wifi-rebuild.png
