subtilitas/rcbench/docs/img/help-setup.png

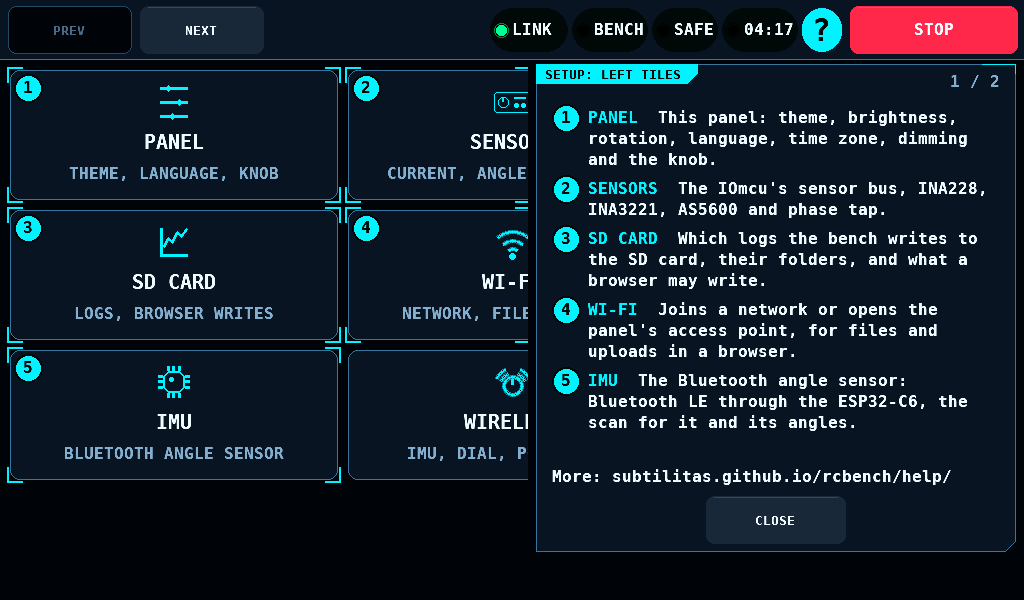
docs/img/help-setup.png
