subtilitas/rcbench/docs/img/motor-stick-hand-steps.png

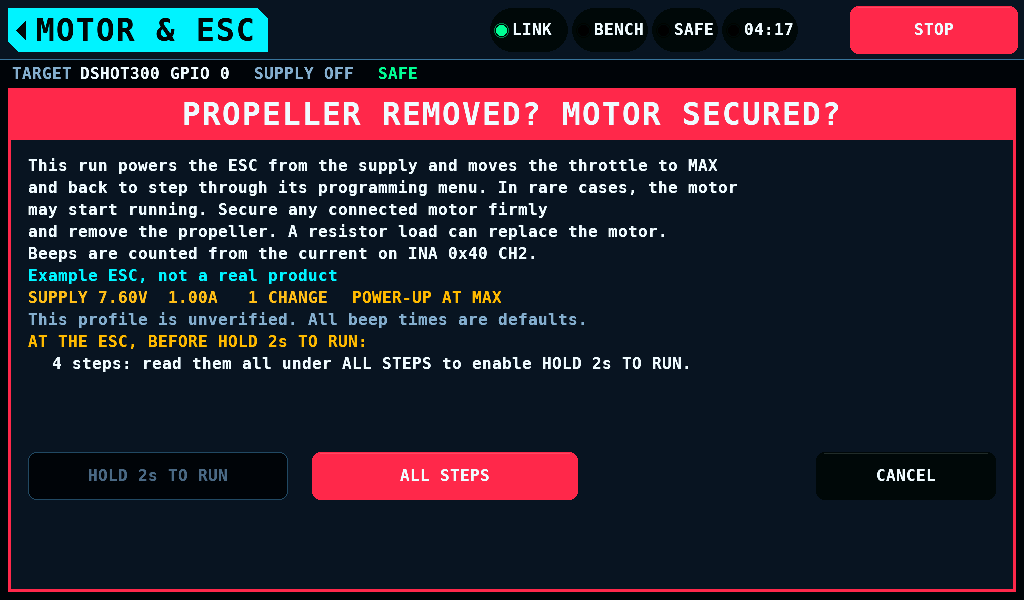
docs/img/motor-stick-hand-steps.png
