subtilitas/rcbench/docs/img/programmer-stick-hand-steps.png

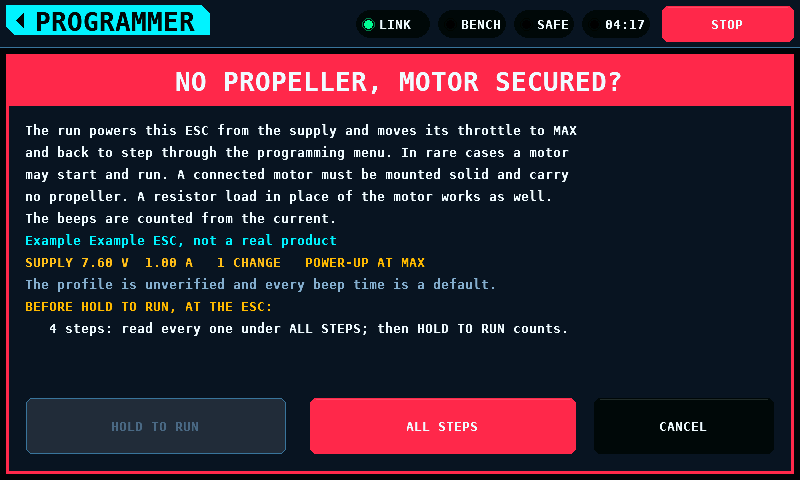
docs/img/programmer-stick-hand-steps.png
