subtilitas/rcbench/docs/img/setup-card.png

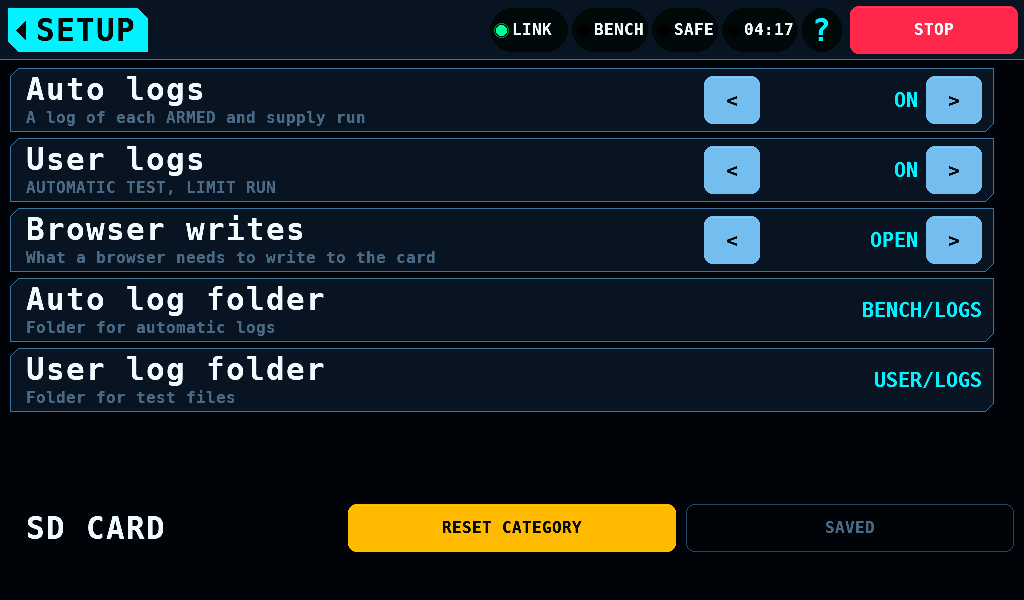
docs/img/setup-card.png
