subtilitas/rcbench/docs/img/setup-folder.png

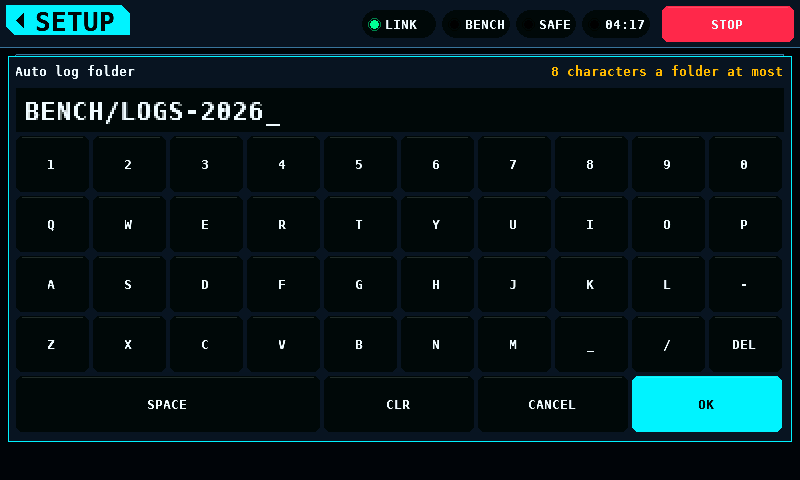
docs/img/setup-folder.png
