subtilitas/rcbench/docs/img/setup-hub-dirty.png

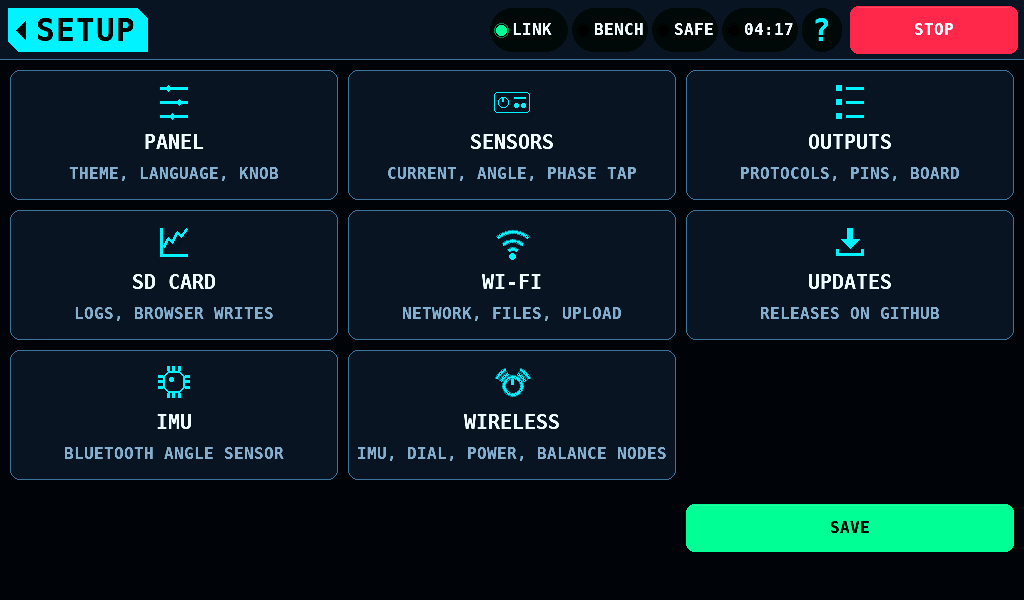
docs/img/setup-hub-dirty.png
