subtilitas/rcbench/docs/img/setup-hw-stop.png

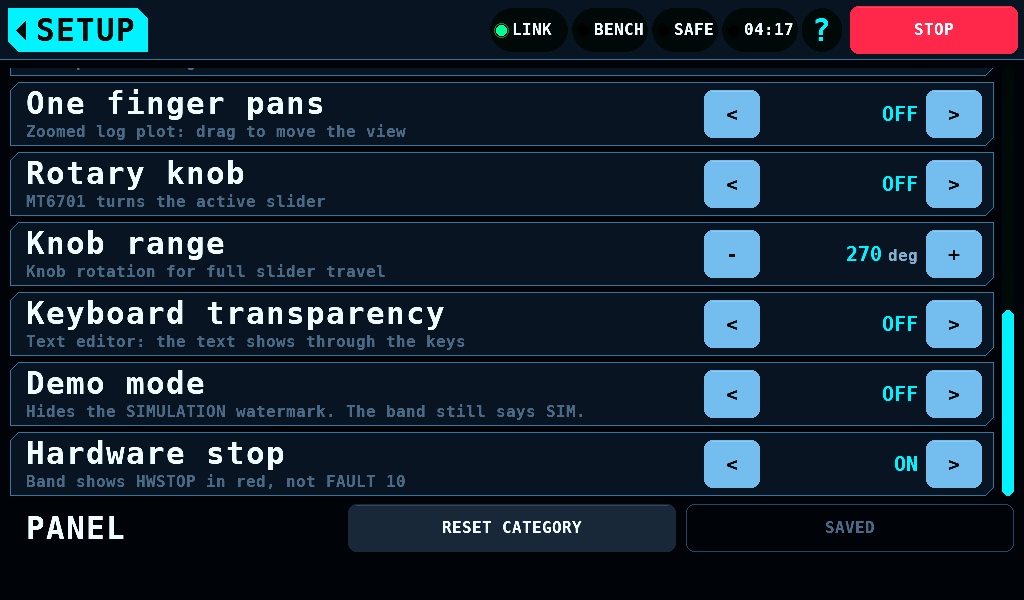
docs/img/setup-hw-stop.png
