subtilitas/rcbench/docs/img/setup-interfaces.png

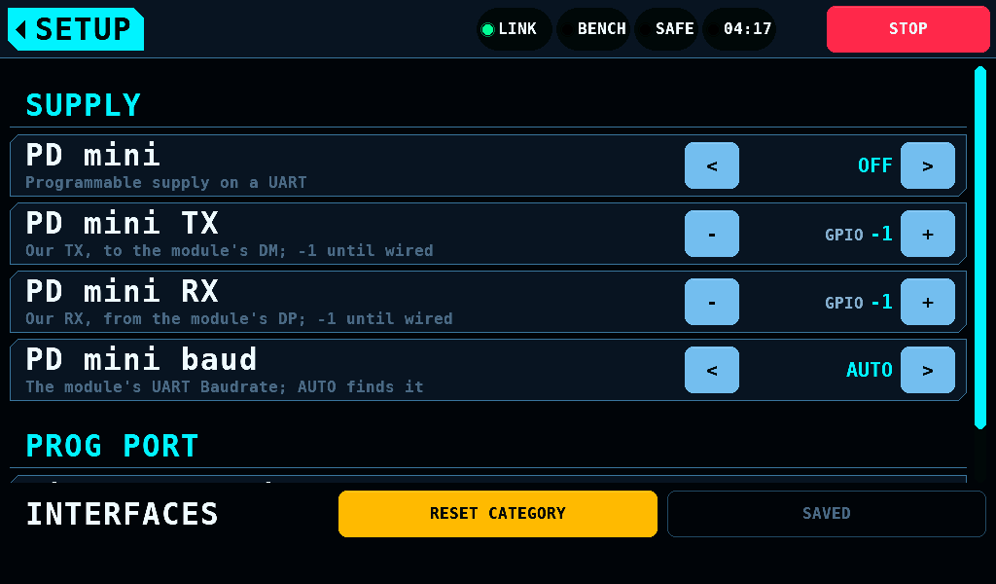
docs/img/setup-interfaces.png
