subtilitas/rcbench/docs/img/setup-leave-many.png

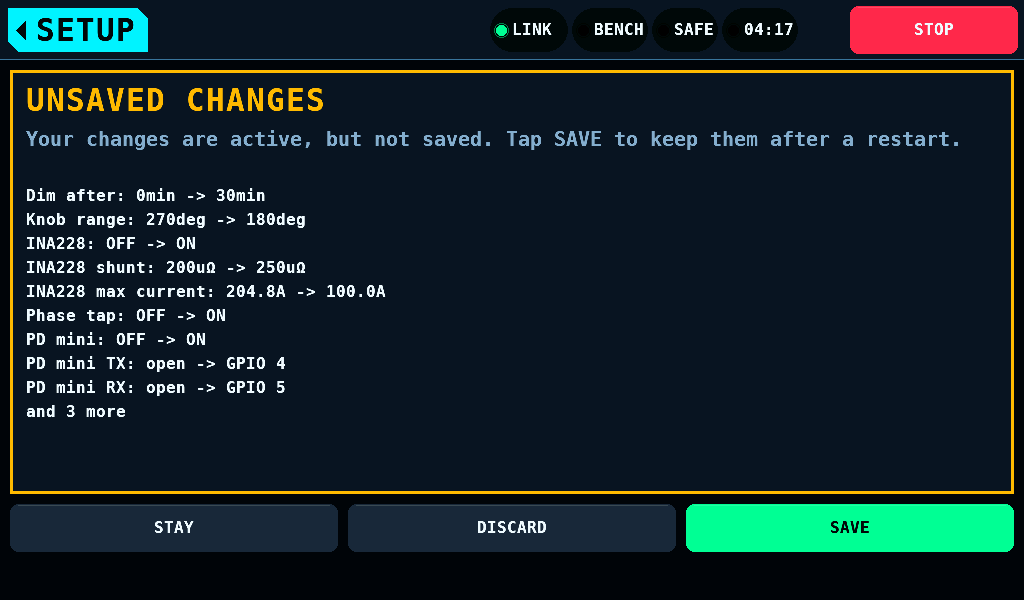
docs/img/setup-leave-many.png
