subtilitas/rcbench/docs/img/setup-light.png

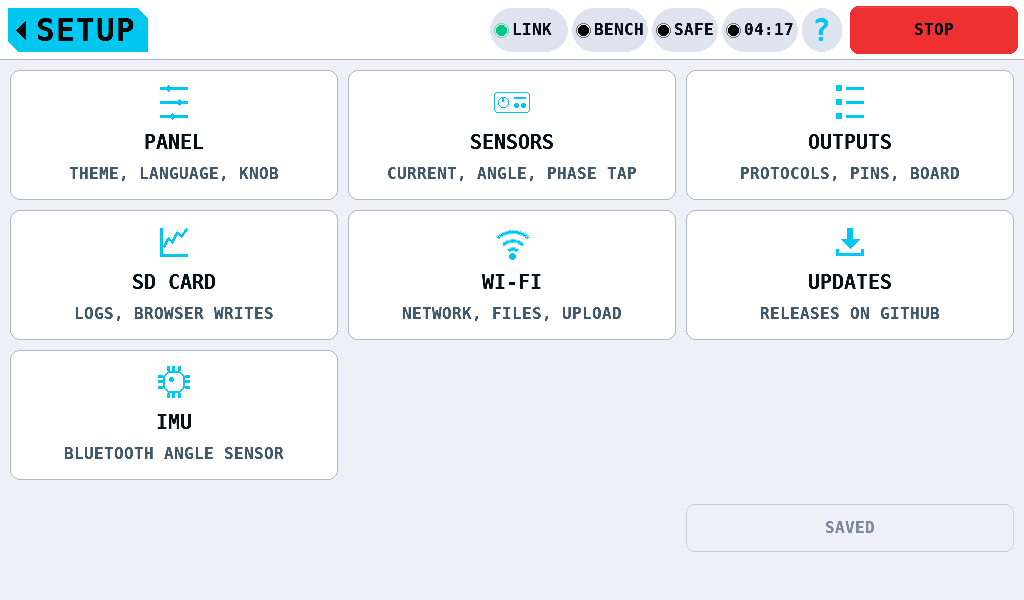
docs/img/setup-light.png
