subtilitas/rcbench/docs/img/setup-prog.png

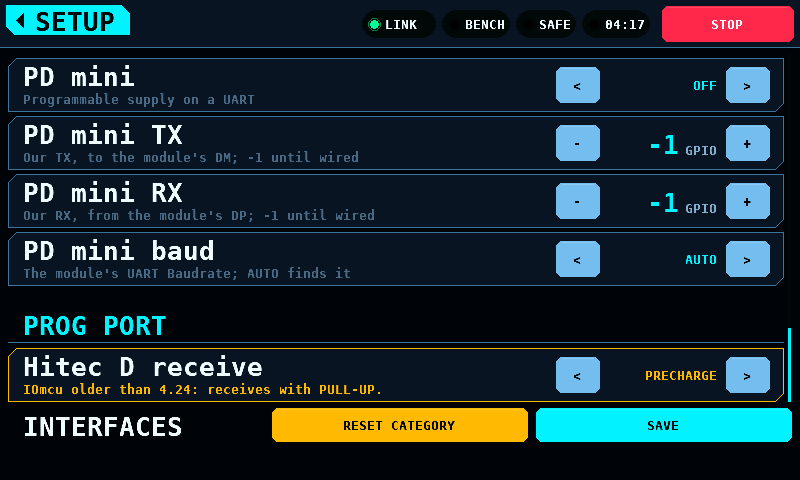
docs/img/setup-prog.png
