subtilitas/rcbench/docs/img/setup-rbmod.png

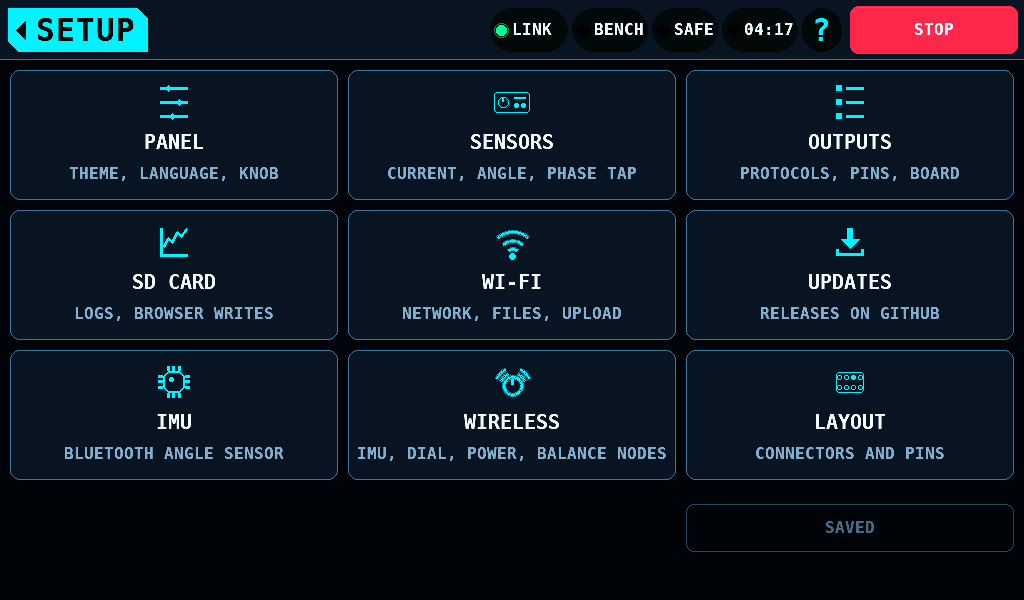
docs/img/setup-rbmod.png
