subtilitas/rcbench/docs/img/setup-rotation.png

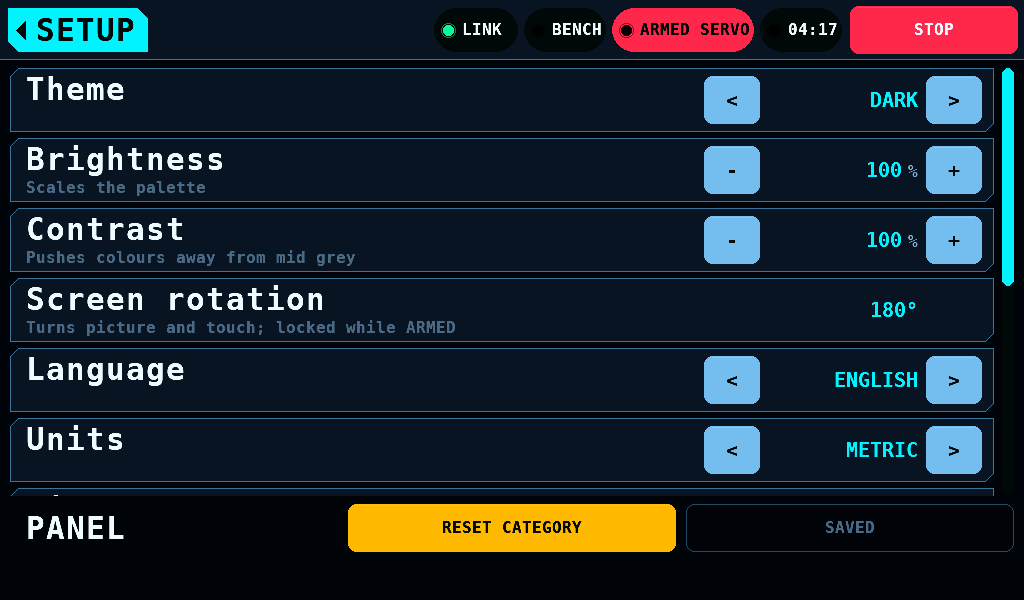
docs/img/setup-rotation.png
