subtilitas/rcbench/docs/img/setup-sensors-limit.png

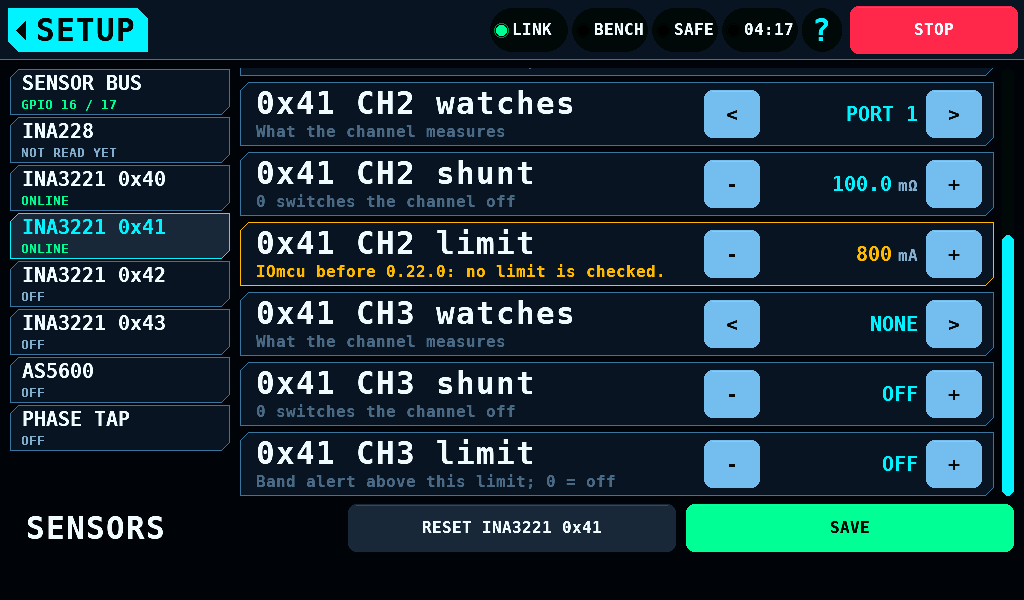
docs/img/setup-sensors-limit.png
