subtilitas/rcbench/docs/img/setup-sensors-rbmod.png

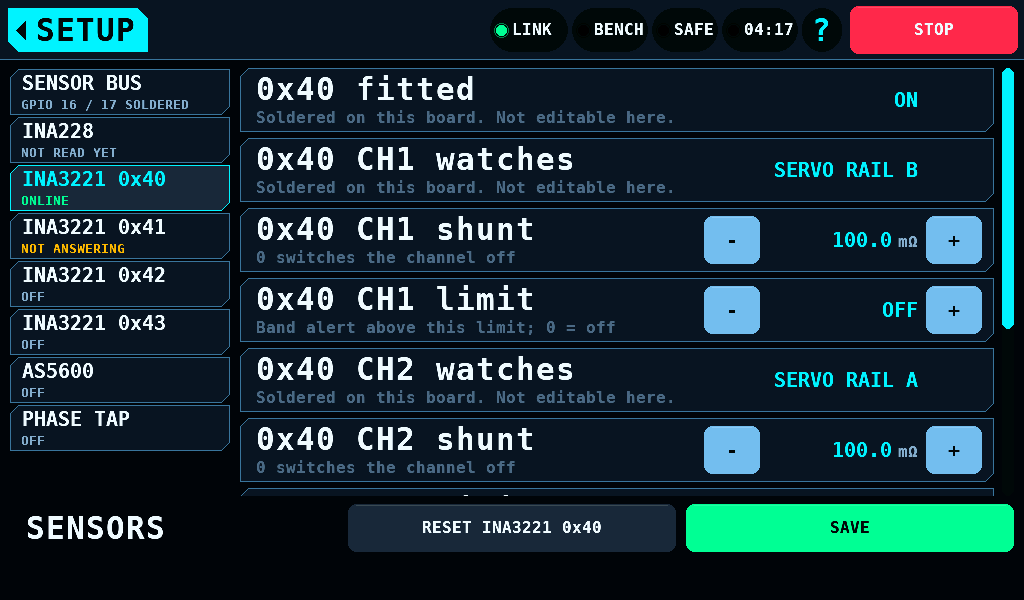
docs/img/setup-sensors-rbmod.png
