subtilitas/rcbench/docs/img/setup-sensors.png

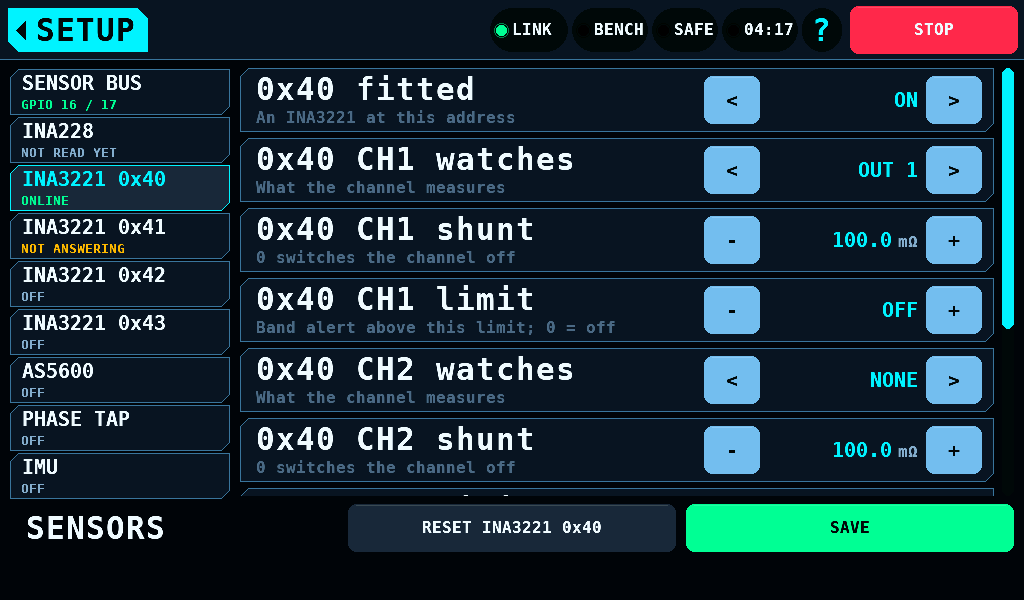
docs/img/setup-sensors.png
