subtilitas/rcbench/docs/img/setup-tap.png

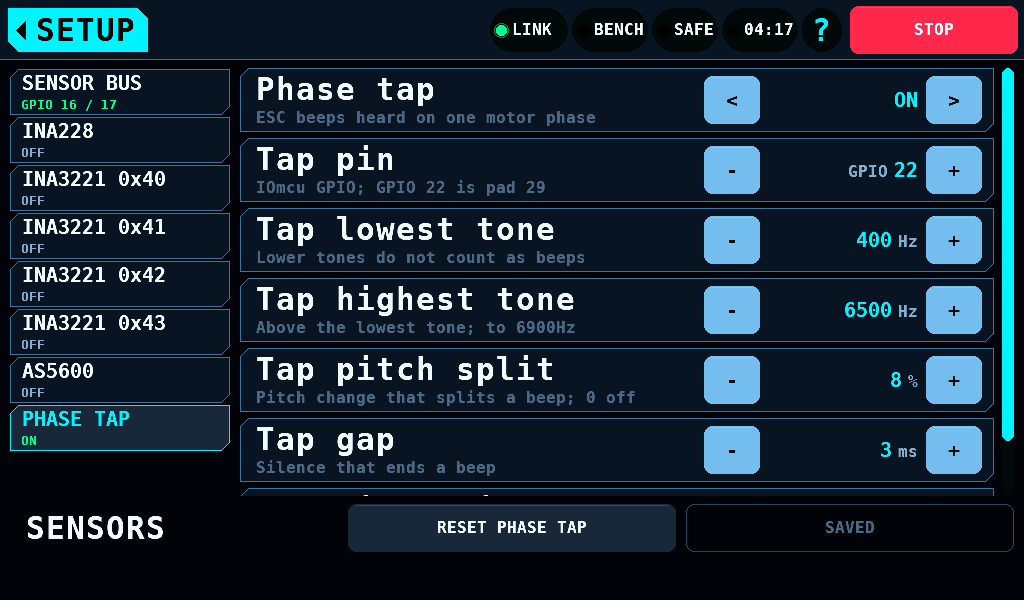
docs/img/setup-tap.png
