subtilitas/rcbench/docs/img/setup-time-zone.png

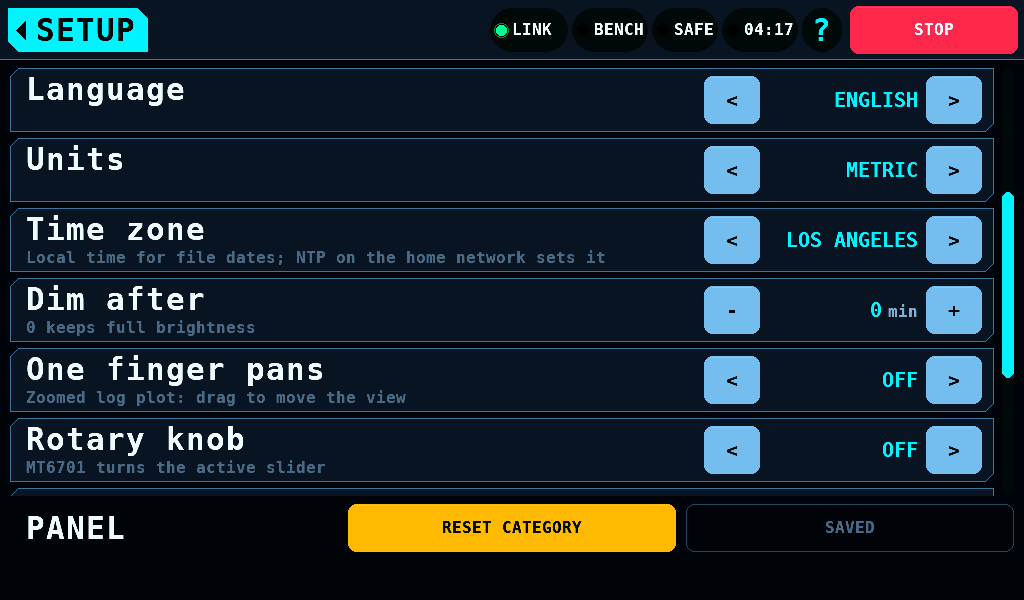
docs/img/setup-time-zone.png
