subtilitas/rcbench/docs/img/setup-unheld.png

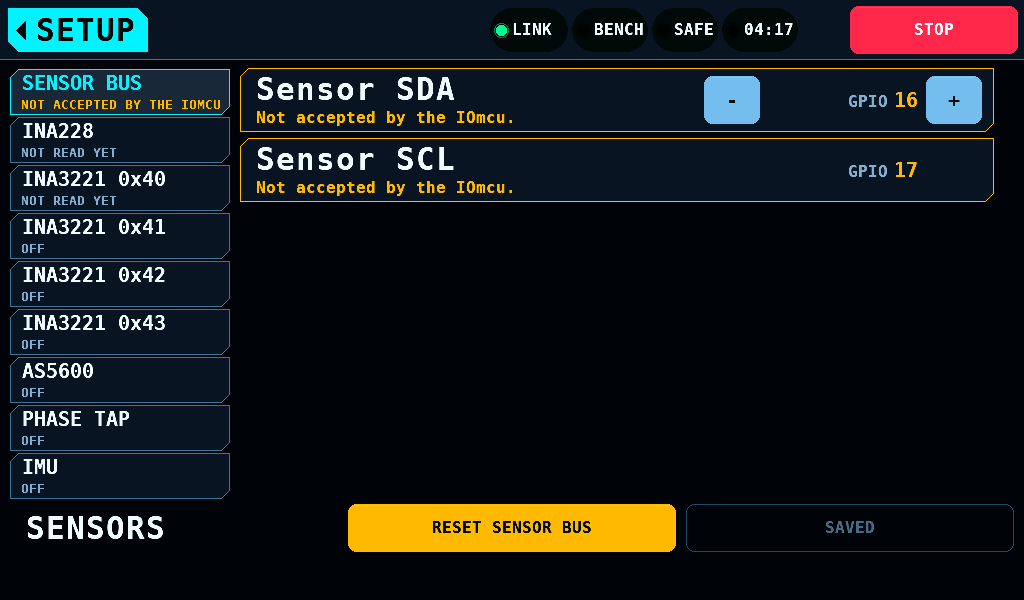
docs/img/setup-unheld.png
