subtilitas/rcbench/docs/img/setup-wireless-imu.png

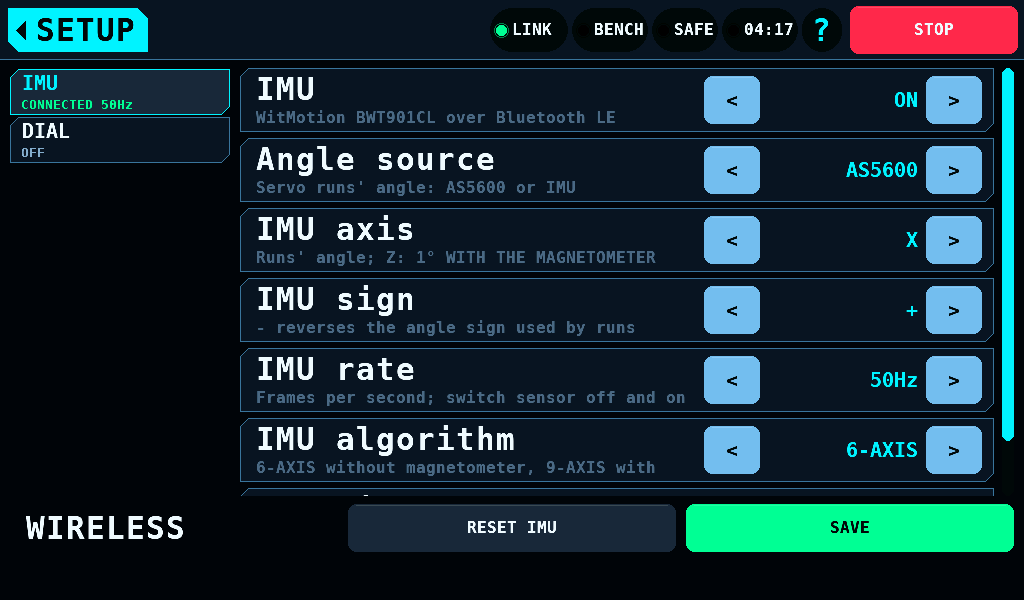
docs/img/setup-wireless-imu.png
