subtilitas/rcbench/docs/img/setup-wireless-pnode.png

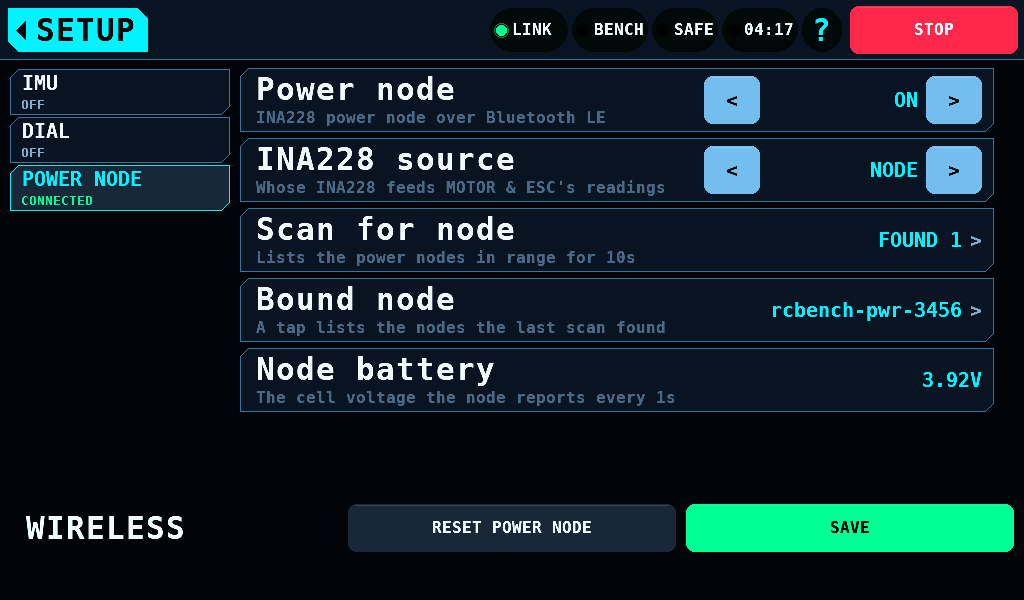
docs/img/setup-wireless-pnode.png
