subtilitas/rcbench/docs/img/wifi-installed.png

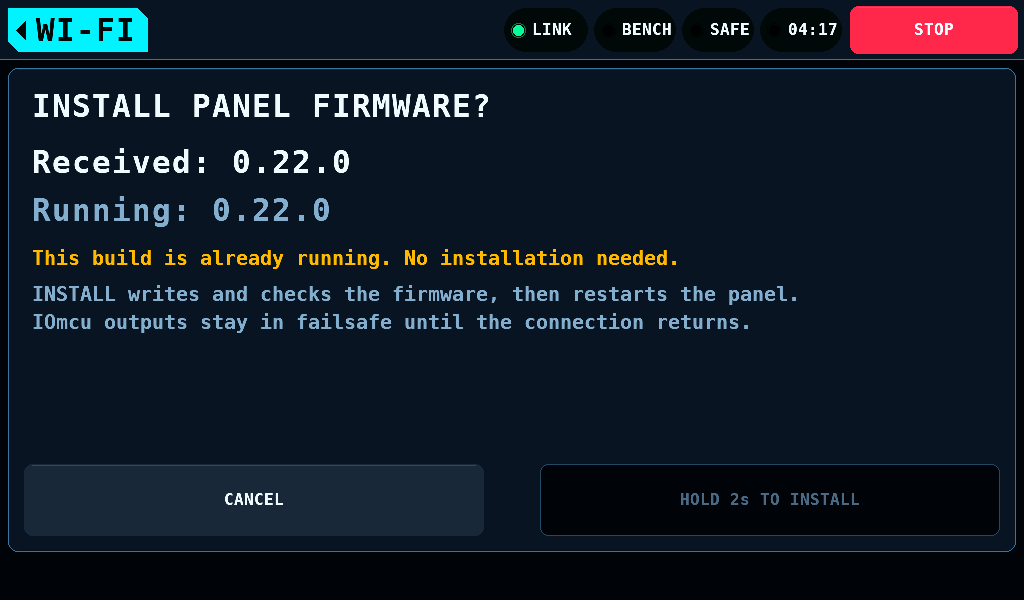
docs/img/wifi-installed.png
