subtilitas/rcbench/docs/img/wifi-rebuild.png

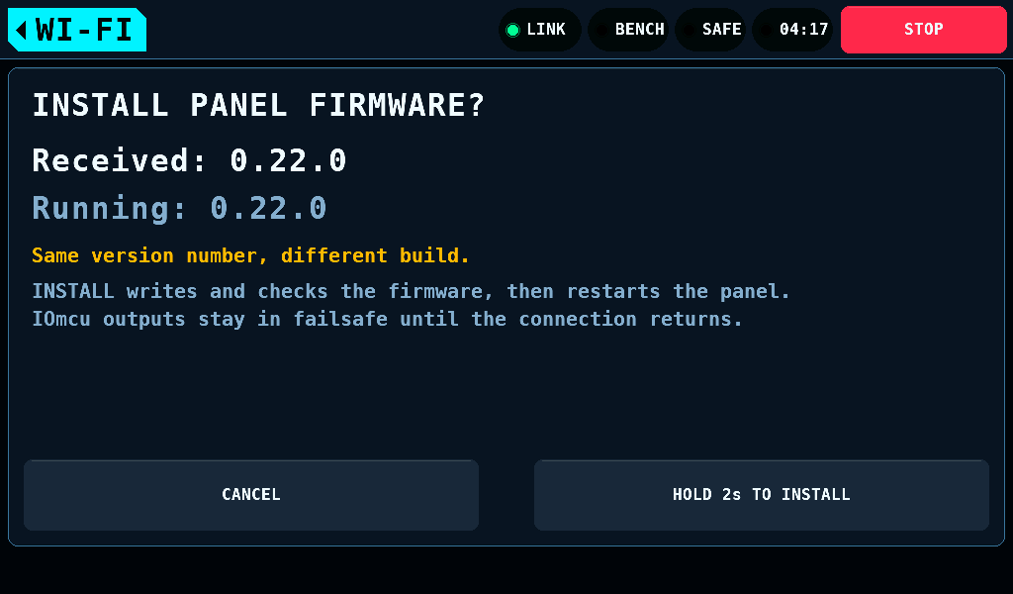
docs/img/wifi-rebuild.png
