subtilitas/rcbench/docs/Bringup.md

# Bringing up the link

<sub>**English** · [Deutsch](Bringup-de.md)</sub>

This page explains how to check frame transfer over the CAN (Controller
Area Network) bus between the two boards and interpret the diagnostic
report. For wiring, see [The link](Link.md).

## Echo self-test

The self-test answers one question: do frames cross the bus intact? It uses no
page protocol. The panel sends a probe frame, the IOmcu sends it back,
and the panel compares it byte for byte. If the test passes and the link does
not work, the fault is above the wire.

### IOmcu

No configuration is required. The IOmcu starts CAN at boot, reports
whether the controller answered, and remains available to echo probes.
The echo check costs one register read per loop. It answers only frames
addressed to a page that the page map does not use.

Boot output on the IOmcu's USB (Universal Serial Bus) console, repeated
every 3s:

    rcbench-iomcu: CAN up, 1000000 bit/s, 0 requests served, 0 self-test echoes, tx_err 0 rx_err 0 eflg 0x00 tx_drop 0

`requests served` counts link page requests sent by the panel and
answered by the IOmcu. `self-test echoes` counts probe frames and is 0
unless the panel's CAN self-test is running. `tx_drop` counts reply
frames abandoned after 1000 attempts to use a full transmit buffer; the
panel then waits for its exchange to time out. Together, the first two
counters indicate which end has stopped:

| Requests | Panel says | Reading |
| --- | --- | --- |
| climbing | `LINK` | working |
| standing still | `NO LINK` | nothing is arriving — the panel has stopped transmitting, or the wiring is open |
| climbing | `NO LINK` | requests arrive and the answers do not get back |

`CAN did not answer on SPI` means the controller did not report
configuration mode after reset. The fault is on the SPI (Serial
Peripheral Interface) connection: the module is not fitted or its wiring
on GPIO 8 to GPIO 12 is faulty. This message does not indicate a CAN bus
fault.

### Panel

The test runs at every start-up, during the splash and before the
identity poll. This lets the panel diagnose a bus fault before waiting
for an identity response.

First the panel asks the IOmcu for its status, for up to 5000ms, and starts
the test at the first answer. The IOmcu opens CAN after its supply boot-off,
which takes up to 3500ms when the PD mini gets power at the same moment as
the IOmcu. Without an answer in 5000ms the test runs anyway and reports the
silent bus. The test itself takes 1200ms. `bus_err` counts the bus errors of
the test only, not those of the wait.

A verdict that is not `every probe came back intact` puts the panel on the
[bus-fault screen](#the-bus-fault-screen) instead of the menu. Nothing has to
be enabled and no console is needed.

The console carries the detail. It is UART0 (universal asynchronous
receiver-transmitter 0), with USB-Serial-JTAG (the ESP32-P4's built-in USB
serial and debug bridge) as the secondary console. Which of the board's two
USB-C sockets reaches which is not traced. The CAN transceiver's transmit
line is on GPIO22 (general-purpose input/output 22) and its receive line on
GPIO21; neither carries anything else. The controller's clock is
the 40MHz crystal. It prints:

    I (…) can: 1000000 bit/s: brp 2, tseg1 14, tseg2 5, sjw 4, sample point 75.0%
    I (…) rcbench: CAN self-test: the IOmcu answered after 3ms
    I (…) rcbench: CAN self-test: every probe came back intact
    I (…) rcbench:   sent 2024 echoed 2024 corrupt 0 lost 0 stale 0  (transmit queue full 0 times)
    I (…) rcbench:   round trip min 334 max 1356 us
    I (…) rcbench:   panel  tx_err 0 rx_err 0 bus_err 0
    I (…) rcbench:   iomcu  CAN up, 2024 echoes, 0 overflow(s), tx_err 0 rx_err 0 flags 0x00

The last line is the IOmcu's own status, requested over the bus before
and after the echo phase. The difference between the two readings is the number
of echoes it sent during the test; the panel compares that with the number it
received.

### Verdicts

| Verdict | Meaning | Check |
| --- | --- | --- |
| `no probe came back` | nothing crosses | CANH/CANL swapped; far end powered; same bit rate at both ends; terminators at both ends |
| `probes come back altered` | frames cross and arrive wrong | sample point or bit timing; a missing terminator reflects |
| `probes cross, and not all of them` | marginal bus | timing, one terminator, or a bus too long for the rate |
| `probes go missing without a bus error` | frames arrived intact and were not read in time | a receive buffer overran; not a wiring fault. Compare with the IOmcu's overflow count |
| `every probe came back intact` | the wire is fine | a remaining fault is above the wire |

The console writes these verdicts. The splash and the bus fault screen show
their own wording: `All test frames returned intact.`, `No test frames
returned.`, `Test frames returned with changed data.`, `Some test frames were
lost.` and `Test frames lost without a bus error.`.

Corruption is reported before loss when both occur, because a marginal bus
produces both and the corruption identifies the cause.

Loss is split by the controller's bus error count. Frames lost with bus errors
were corrupted on the wire (termination, timing, length). Frames lost with zero
bus errors arrived intact and were dropped by a receiver that did not read in
time.

If the transmit error counter reaches 128 during the test, the firmware
reports an early warning once. Missing acknowledgements are a possible
cause, but other transmission errors also raise the counter. This reading
alone does not establish that the IOmcu is absent from the bus; see
[Bus off](Link.md#bus-off).

### The bus-fault screen

A verdict other than `every probe came back intact` is shown on the panel
before the menu, because the fault is invisible from every other screen: a bus
that does not carry frames looks exactly like an IOmcu that is not
fitted, and both look like a bench that shows no numbers.

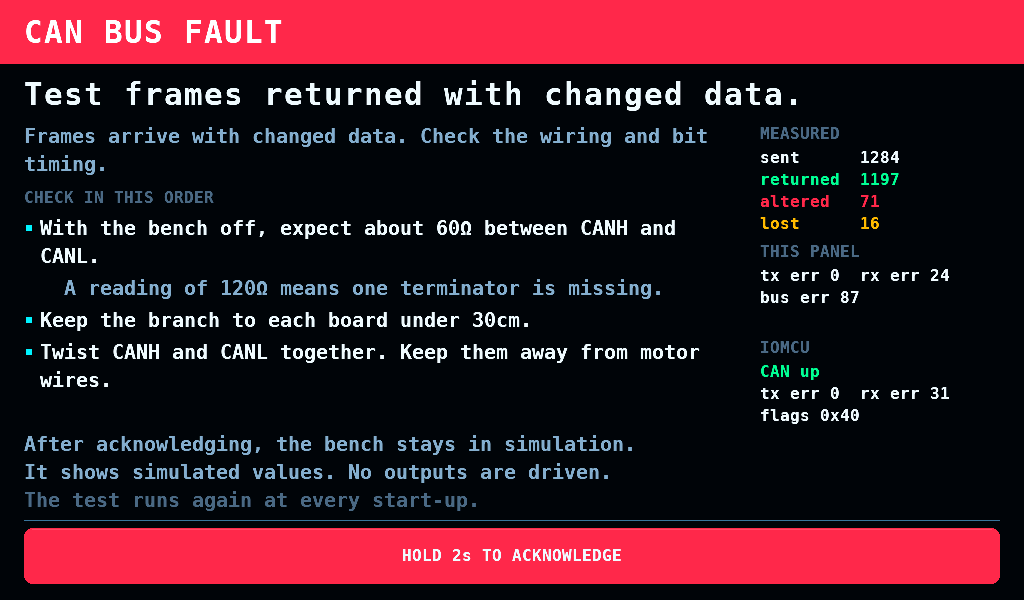
[picture p240: docs/img/busfault.png]
Frames cross and arrive changed


The heading shows the verdict. The list below it gives checks in order
of increasing effort, and the right-hand column shows both ends'
counters. `returned` is green if any frame came back; `BUS OFF` means
the panel has stopped transmitting.

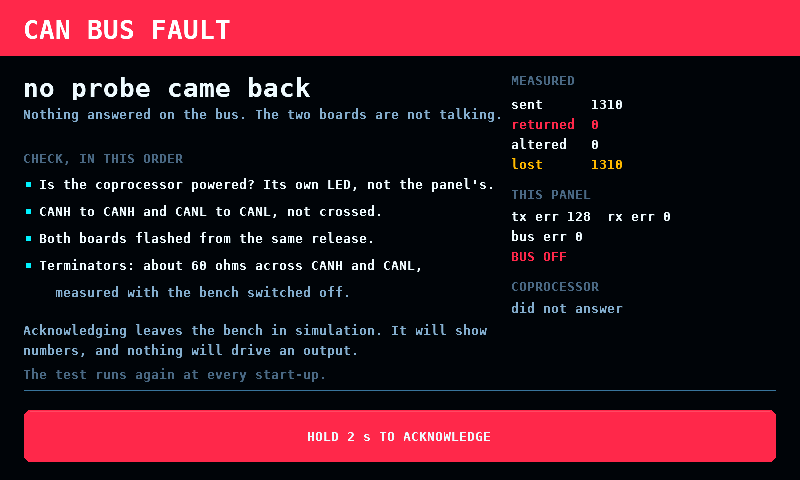
[picture p241: docs/img/busfault-silent.png]
Nothing came back


To leave this screen, hold the button across the bottom for two seconds.
It uses the same gesture and fade as ARM. The hold is intended to prevent a brief
contact, such as a sleeve touching the screen, from dismissing the fault.

Acknowledging does not repair anything and does not disable the test: the
bench runs in simulation, nothing drives an output, and the test runs again at
the next start-up.

The probe payloads cycle through all-dominant, all-recessive and both
alternating patterns, because CAN stuffs a complementary bit after five equal
bits and long runs of one level are what a marginal bus fails on.

## Link report

After bring-up, the panel polls the IOmcu's identity page every second
until it answers. It then polls the bench page at 20Hz and the status page
every 500ms. The panel prints a diagnosis every 5s while the link is down
and once a minute while it is up.

The control task, which generates the heartbeat, collects the counters
and passes them to the logger task for formatting and output. A report
of up to 7 lines takes 50ms or more on the console; the heartbeat limit
is 150ms. The queue holds 2 reports. If card access blocks the logger
and the queue is full, the control task prints the report itself so that
no line is dropped. The heartbeat gap when the logger prints the report
is not measured.

    I (…) rcbench: LINK answers arrive too late
    W (…) rcbench:   check: a reply slower than the poll timeout, or a stalled far end
    I (…) rcbench:   last 60s  polls 1200 replies 1197 timeouts 3 retried 1 stale 3 nack 0  iomcu frames 1201 crc 0 resync 0 refused 0
    I (…) rcbench:   panel  polls 36000 replies 35990 timeouts 10 retried 4 stale 7 nack 0 crc 0 resync 0
    I (…) rcbench:   iomcu  frames 36000 crc 0 resync 0 refused 0
    I (…) rcbench:   round trip min 620 avg 700 max 1400 us

The diagnosis and the `last` line cover the interval since the previous
report: 60s while the link is up, 5s while it is down, and the time since
start-up for the first report. The `panel` and `iomcu` lines contain
totals since start-up. A burst of late replies during an IOmcu outage
affects the report for that interval; the next report says `link healthy`
if the link has recovered.

An interval with fewer than 4 polls also says `link healthy`. A link that
is down is probed about once a second, so its 5s interval contains 4 or
5 polls. If an IOmcu counter is lower than in the previous report, the
calculation assumes it restarted from 0 and uses its new value. This
happens after an IOmcu restart or a 16-bit status register wrap. The
IOmcu's `crc` and `resync` are current levels rather than cumulative
counts; the `last` line shows them as read, as explained below.

| Diagnosis | Meaning |
| --- | --- |
| `no reply to any poll` | IOmcu powered; CANH/CANL; bit rate; terminators |
| `answering, wrong protocol` | flash both ends from the same tree |
| `requests land, answers do not` | the far end hears the panel and the panel does not hear it: its transmit path |
| `frames arrive corrupt` | bit timing or sample point disagreeing between the two ends |
| `answers arrive too late` | a reply slower than the poll timeout, or a stalled far end |
| `works, and not every time` | marginal timing, or a poll period tighter than the round trip |

`nack` in the panel line counts requests that the IOmcu answered with a
NACK (negative acknowledgement). A NACK confirms communication over the
link but leaves the page's values unchanged ([Frames](Link.md#frames)). A set-up from SETUP
that a page refuses is one each: one write per refused value,
not written again until the value changes, so stepping through rows on SETUP
counts one NACK for each value the IOmcu refuses (Tap gap 2ms with Tap
lowest tone at 400Hz, or PD mini RX on the sensor bus's SCL) and none for
the values it takes. A pin refused because something else holds it is
offered again every 5s and counts one each time. `timeouts`, `stale` and
`crc` are the columns that count a link fault.

`retried` counts requests answered after the panel sent them a second
time, 50ms after an answer did not come (protocol 4.37, [A lost
answer](Link.md#a-lost-answer)). Each is an answer lost once and
recovered: it raises no `FAULT 01`, takes no link down and is not a link
fault for the diagnosis. A repeat is a frame the IOmcu decodes, so
`frames` in the IOmcu line can exceed `polls` by the repeats. A request
whose repeat is lost as well counts in `timeouts` and not in `retried`.
The card's log line carries the same total as `retried=`.
An exchange answered after its repeat adds no round-trip sample.

The `crc` and `resync` columns of the IOmcu line carry the XL2515's
receive and transmit error counters (status registers `LINK_ST_CRC_ERRORS` and
`LINK_ST_RESYNCS`). Each is 0 to 255, rises with a bad frame and falls with
a good one, so both are read as they stand at the report, in the window as
in the totals. `refused` is the count of CAN frames the IOmcu
received and refused to decode since its power-up (`LINK_ST_REFUSED_LO` and
`LINK_ST_REFUSED_HI`, protocol 4.21; 0 from an older IOmcu). See
[Refused frames](Link.md#refused-frames).

## Why the IOmcu last started

At start-up and every 3s afterwards, the IOmcu console reports the cause
of the last start, including all raw values:

    rcbench-iomcu: reset FLASH_UPDATE (chip_reset 0x00010000 reason 0x1 boot 0x010104FF params 0x101FD000 0x00000000 scratch 0x101FD000 0x00000000)

The start-up line leaves before a host has the USB port open in most
cases; the 3s line repeats it. `chip_reset` is POWMAN CHIP_RESET, `reason`
WATCHDOG REASON, `boot` the boot ROM's boot word (0xttppbbdd: TBYB flags,
partition, boot type, diagnostic partition; `boot none` when the boot ROM
gave none), `params` its reboot parameters, `scratch` WATCHDOG SCRATCH2 and
SCRATCH3. The firmware reads them once at boot and then zeroes SCRATCH2 and
SCRATCH3. The longest line is 153 bytes with its LF.

Each reset line is followed by the boot ROM's record of the same boot, from
`rom_get_boot_info()`:

    rcbench-iomcu: boot type NORMAL partition none source slot 0 diagnostic 0x00010355

| Field | Values |
| --- | --- |
| `type` | the boot type: `NORMAL`, `BOOTSEL`, `RAM_IMAGE`, `FLASH_UPDATE`, `PC_SP`, else its value in hex; `+CHAINED` for a chained boot |
| `partition` | the partition booted: `0` slot A, `1` slot B; `none` |
| `source` | what the diagnostic word describes: `slot 0` after a power-on (the search for the partition table, boot slot 0 in bits 0-15 and slot 1 in bits 16-31); `0` after `picotool reboot -a -g 0` (partition A in bits 0-15, partition B in bits 16-31); `none` |
| `diagnostic` | the word, in the BOOT_DIAGNOSTIC_* bits of pico-sdk's `boot/bootrom_constants.h`: 0x0001 searched, 0x0004 valid block loop, 0x0008 valid IMAGE_DEF, 0x0010 partition table, 0x0020 considered, 0x0040 chosen, 0x0200 table verified, 0x0800 image hash checked, 0x1000 image verified, 0x4000 launched, 0x8000 launch condition failed |

`boot info none` when the boot ROM gave none. The longest line is 99 bytes
with its LF. The line above is the failed power-on of a station IOmcu in
BOOTSEL: the partition table read and verified, no image launched. The
application prints the same line on every start it reaches, so after
`picotool reboot -a -g 0` it shows which steps slots A and B passed.

CHIP_RESET changes only at a chip-level reset, and its bits are read-only
(RP2350 datasheet, sections 7.3 and 7.4, table 489). The boot ROM's reboot
resets the system through the power-on state machine, not the chip: after
an update over CAN, CHIP_RESET still reads HAD_POR from the power-up, as in
the line above. A chip-level reset resets the watchdog, so `reason 0x0`
means CHIP_RESET belongs to this start. `reset_cause_decode()` in
`shared/safety/reset_cause.c` picks the word; the first row that matches
wins:

| Word | Registers | Cause |
| --- | --- | --- |
| `FLASH_UPDATE` | boot type 4 | the update over CAN, a UF2 copied to the BOOTSEL drive, `picotool load -x` |
| `RAM_IMAGE` | boot type 3 | an image loaded into SRAM |
| `BOOTSEL_REBOOT` | boot type 2; or reason non-zero, boot type 0, scratch 0xFFFFFFFF 0x00000000 | back from BOOTSEL through `picotool reboot`, which picotool also sends after every command run with `-f`. The way into BOOTSEL is the 1200 baud request or picotool's reset request over USB |
| `SW_RESET` | reason 0x2 | the watchdog triggered at once by software |
| `WATCHDOG` | reason 0x1 | the watchdog counted down: the boot ROM's 16.7s TBYB (try before you buy) timer after an update the panel did not buy, or a reboot with other parameters |
| `POR` | reason 0, HAD_POR (bit 16) | power applied |
| `BOR` | reason 0, HAD_BOR (bit 17) | brown-out detector |
| `RUN_PIN` | reason 0, HAD_RUN_LOW (bit 18) | RUN pin held low: the reset button, or a host pulling RUN |
| `GLITCH` | reason 0, HAD_GLITCH_DETECT (bit 26) | supply glitch detector |
| `DEBUGGER` | reason 0, HAD_DP_RESET_REQ, HAD_RESCUE, HAD_HZD_SYS_RESET_REQ (bits 19, 21, 27) | a debugger reset |
| `POWER_DOWN` | reason 0, HAD_SWCORE_PD (bit 25) | switched-core power-down |
| `WATCHDOG` | reason 0, a HAD_WATCHDOG_* bit (22, 23, 24, 28) | a watchdog that POWMAN WDSEL lets reset the chip; this firmware sets none |
| `UNKNOWN` | none of the above | no cause recorded |

The boot ROM's reboot runs the watchdog in timer mode, so every reboot it
performs reads `reason 0x1`. A debugger's warm reset of a core clears
REASON without a chip-level reset, and the start after it reads as the
chip-level reset before. The `BOOTSEL_REBOOT` and `WATCHDOG` rows follow the
source of the RP2350 boot ROM and of picotool 2.x.

## What to record

Record the round-trip time, both ends' error counters and the IOmcu's
overflow count. The poll period must allow for the round trip. The
counters indicate whether the bus or the software limited communication.

With both boards powered, also confirm on a scope that GPIO28 (`PANEL_HEARTBEAT_PIN`) edges at the
rate [Safety](Safety.md) specifies. GPIO28 is IO28 of the 12-pin header P3.
