subtilitas/rcbench/test/host/fixtures/de.csv

Zeit | Spannung | Strom | Drehzahl | Temperatur
0,000 | 22,34V | 10,23A | 1.234 | 25
0,020 | 22,31V | 11,05A | 1.567 | 25
0,040 | 22,28V | 12,40A | 1.890 | 26
0,060 | 22,20V | 15,02A | 2.345 | 26
