subtilitas/rcbench/test/host/fixtures/ragged.csv

time | power
0 | 1500
1 | 1 | 520
2 | 1 | 610
