subtilitas/rcbench/test/host/fixtures/servo-1102hb.csv

time (s) | test | step | phase | command (us) | position (us) | set (V) | voltage (V) | limit (A) | current (A) | power (W) | mode | travel (ms)
0.018 | STEP | 1 | SET | 1500 |  | 4.80 | 4.998 | 2.00 | 0.011 | 0.055 | CV
0.122 | STEP | 1 | SET | 1500 |  | 4.80 | 4.998 | 2.00 | 0.011 | 0.055 | CV
0.228 | STEP | 1 | SETTLE | 1500 |  | 4.80 | 4.998 | 2.00 | 0.011 | 0.055 | CV
0.330 | STEP | 1 | SETTLE | 1500 |  | 4.80 | 4.993 | 2.00 | 0.012 | 0.060 | CV
0.431 | STEP | 1 | SETTLE | 1500 |  | 4.80 | 4.950 | 2.00 | 0.017 | 0.084 | CV
0.533 | STEP | 1 | SETTLE | 1500 |  | 4.80 | 4.913 | 2.00 | 0.021 | 0.103 | CV
0.639 | STEP | 1 | SETTLE | 1500 |  | 4.80 | 4.871 | 2.00 | 0.025 | 0.122 | CV
0.744 | STEP | 1 | IDLE | 1500 |  | 4.80 | 4.829 | 2.00 | 0.025 | 0.121 | CV
0.845 | STEP | 1 | IDLE | 1500 |  | 4.80 | 4.797 | 2.00 | 0.024 | 0.115 | CV
0.950 | STEP | 1 | IDLE | 1500 |  | 4.80 | 4.797 | 2.00 | 0.019 | 0.091 | CV
1.051 | STEP | 1 | IDLE | 1500 |  | 4.80 | 4.797 | 2.00 | 0.014 | 0.067 | CV
1.153 | STEP | 1 | IDLE | 1500 |  | 4.80 | 4.797 | 2.00 | 0.011 | 0.053 | CV
1.255 | STEP | 1 | IDLE | 1500 |  | 4.80 | 4.797 | 2.00 | 0.011 | 0.053 | CV
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
