subtilitas/rcbench/test/host/fixtures/servo-mg90s.csv

time (s) | test | step | phase | command (us) | position (us) | set (V) | voltage (V) | limit (A) | current (A) | power (W) | mode | travel (ms)
0.000 | STEP | 1 | SET | 1500 |  | 4.80 | 4.998 | 2.00 | 0.001 | 0.005 | CV
0.030 | STEP | 1 | SET | 1500 |  | 4.80 | 4.998 | 2.00 | 0.001 | 0.005 | CV
0.185 | STEP | 1 | SET | 1500 |  | 4.80 | 4.998 | 2.00 | 0.001 | 0.005 | CV
0.291 | STEP | 1 | SETTLE | 1500 |  | 4.80 | 4.998 | 2.00 | 0.001 | 0.005 | CV
0.397 | STEP | 1 | SETTLE | 1500 |  | 4.80 | 4.961 | 2.00 | 0.005 | 0.025 | CV
0.610 | STEP | 1 | SETTLE | 1500 |  | 4.80 | 4.882 | 2.00 | 0.015 | 0.073 | CV
0.717 | STEP | 1 | SETTLE | 1500 |  | 4.80 | 4.844 | 2.00 | 0.016 | 0.078 | CV
0.824 | STEP | 1 | IDLE | 1500 |  | 4.80 | 4.802 | 2.00 | 0.016 | 0.077 | CV
0.931 | STEP | 1 | IDLE | 1500 |  | 4.80 | 4.797 | 2.00 | 0.012 | 0.058 | CV
1.037 | STEP | 1 | IDLE | 1500 |  | 4.80 | 4.797 | 2.00 | 0.004 | 0.019 | CV
1.142 | STEP | 1 | IDLE | 1500 |  | 4.80 | 4.797 | 2.00 | 0.002 | 0.010 | CV
1.245 | STEP | 1 | IDLE | 1500 |  | 4.80 | 4.797 | 2.00 | 0.001 | 0.005 | CV
1.346 | STEP | 1 | IDLE | 1500 |  | 4.80 | 4.797 | 2.00 | 0.001 | 0.005 | CV
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
