subtilitas/rcbench/docs/img/de/servo-hitec-verify.png

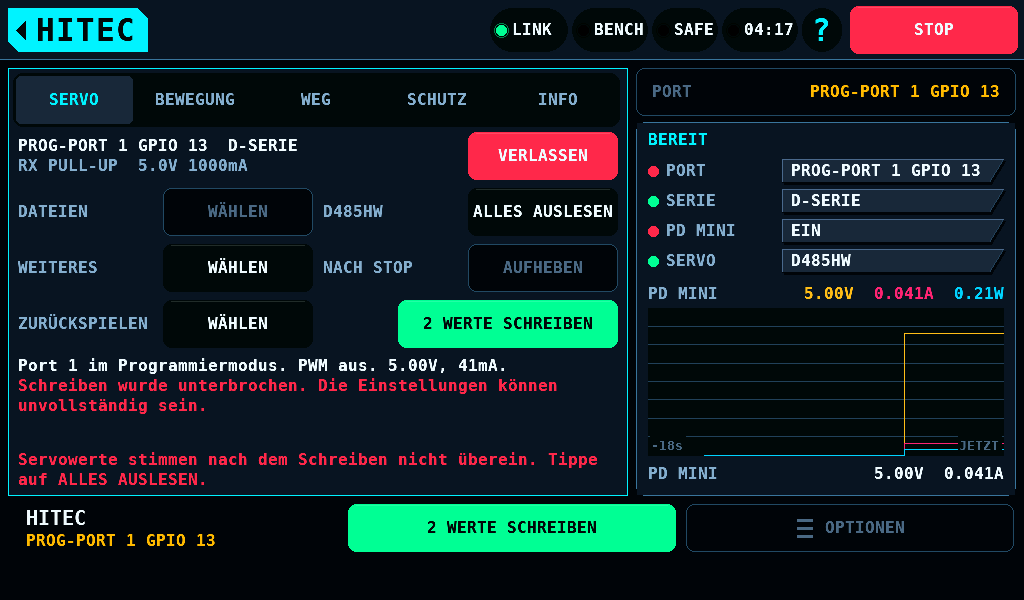
docs/img/de/servo-hitec-verify.png
