subtilitas/rcbench/docs/img/de/servo-kst-tune-expert-off.png

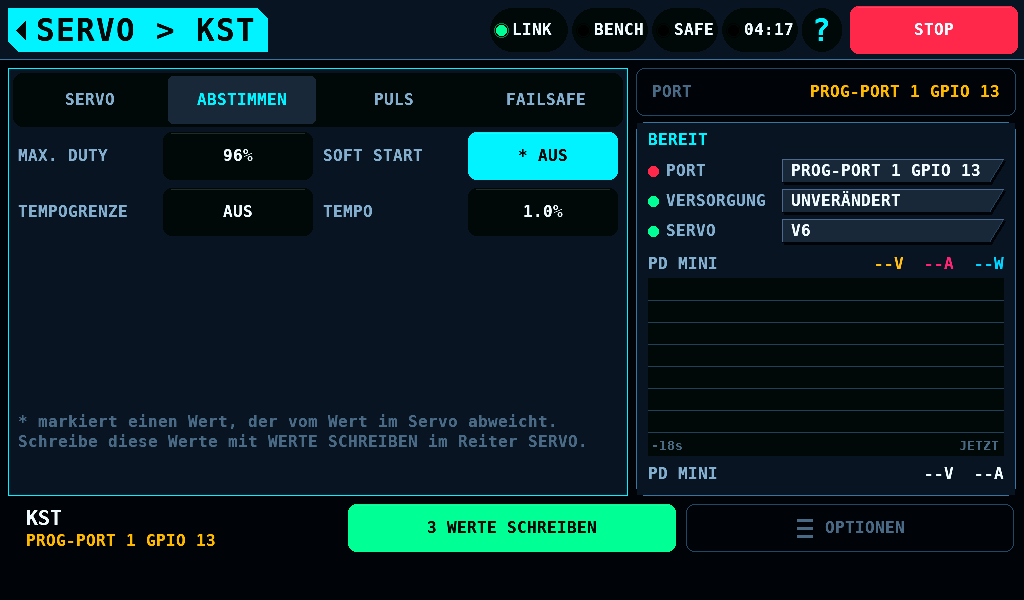
docs/img/de/servo-kst-tune-expert-off.png
