subtilitas/rcbench/docs/img/de/servo-kst-tune.png

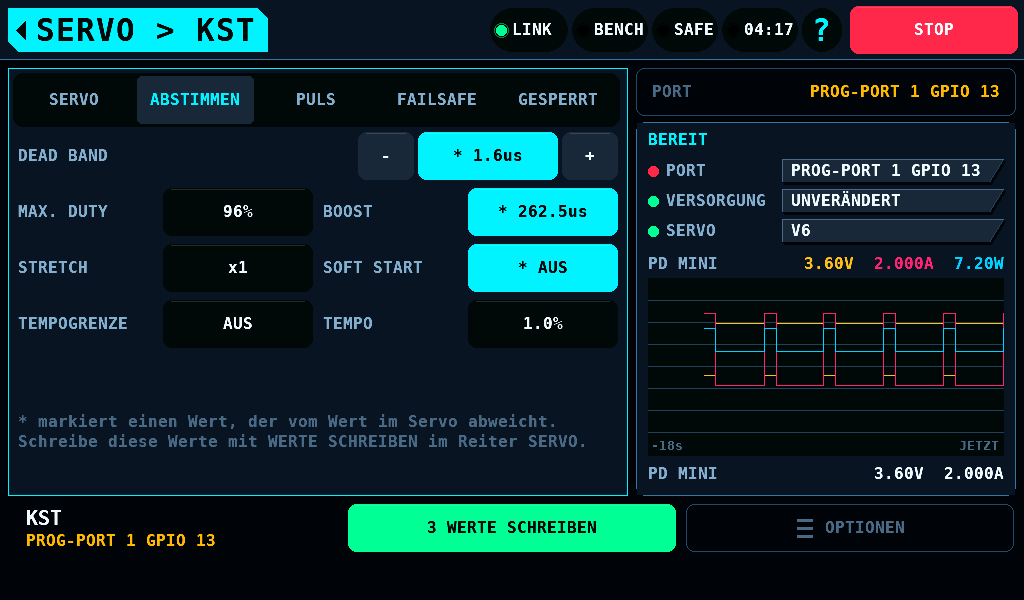
docs/img/de/servo-kst-tune.png
