subtilitas/rcbench/docs/img/de/servo-result-ina.png

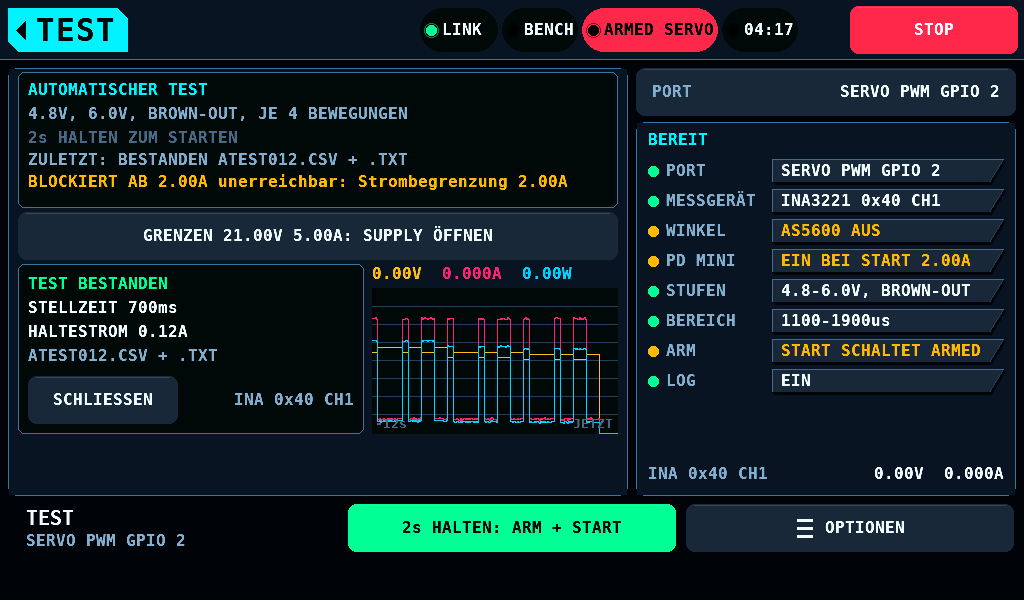
docs/img/de/servo-result-ina.png
