subtilitas/rcbench/docs/img/de/servo-test-settings.png

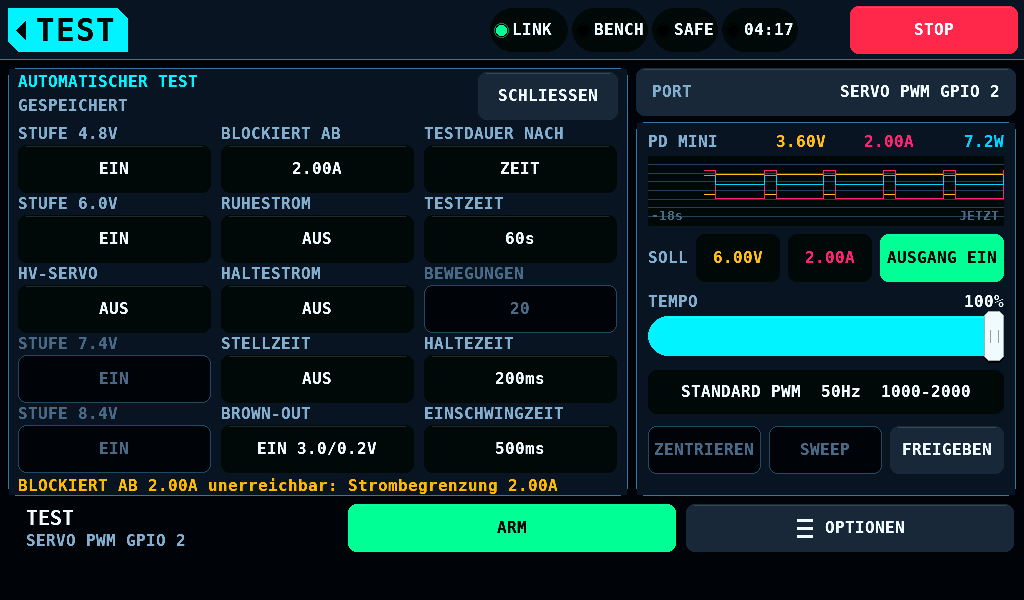
docs/img/de/servo-test-settings.png
