subtilitas/rcbench/docs/img/de/servo-test.png

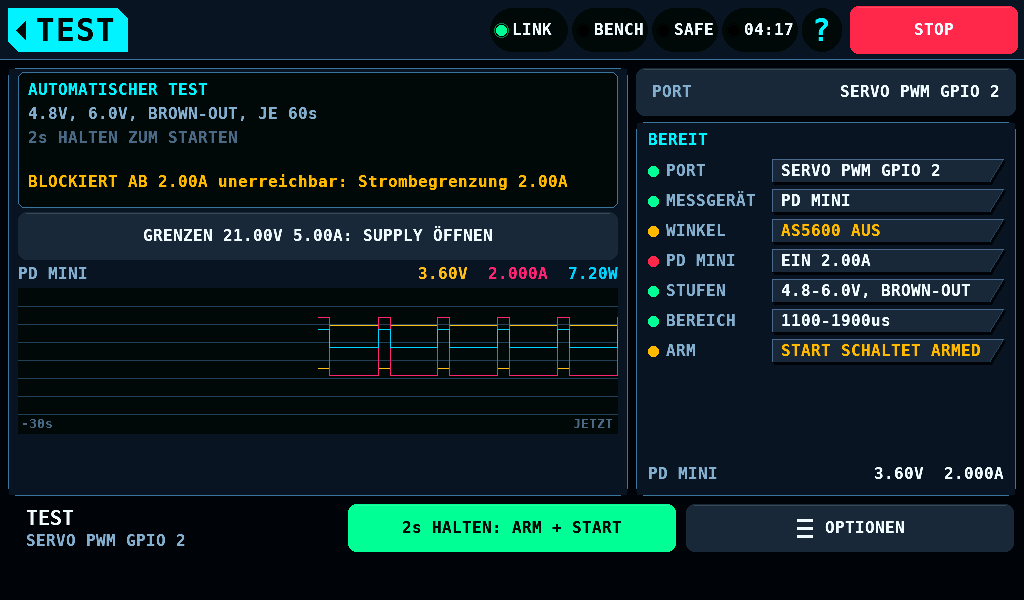
docs/img/de/servo-test.png
