subtilitas/rcbench/docs/img/servo-kst-tune-expert-off.png

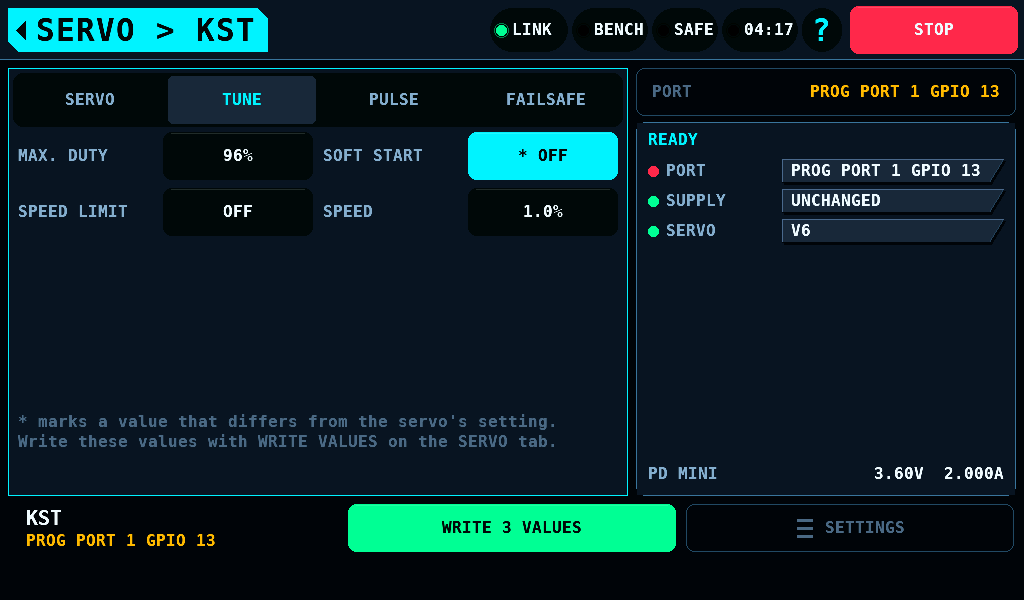
docs/img/servo-kst-tune-expert-off.png
