subtilitas/rcbench/docs/img/servo-kst-tune.png

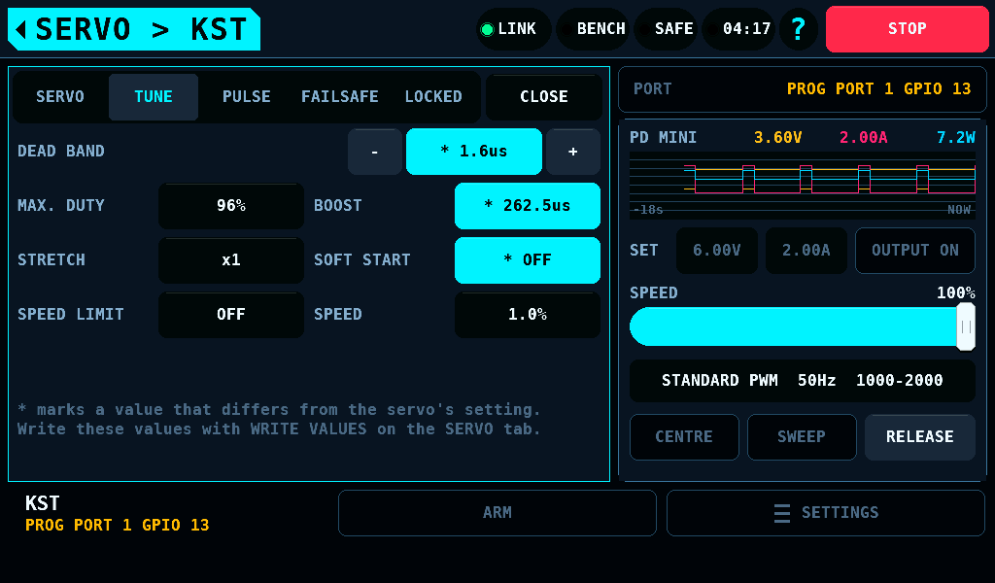
docs/img/servo-kst-tune.png
