subtilitas/rcbench/docs/img/servo-result-ina.png

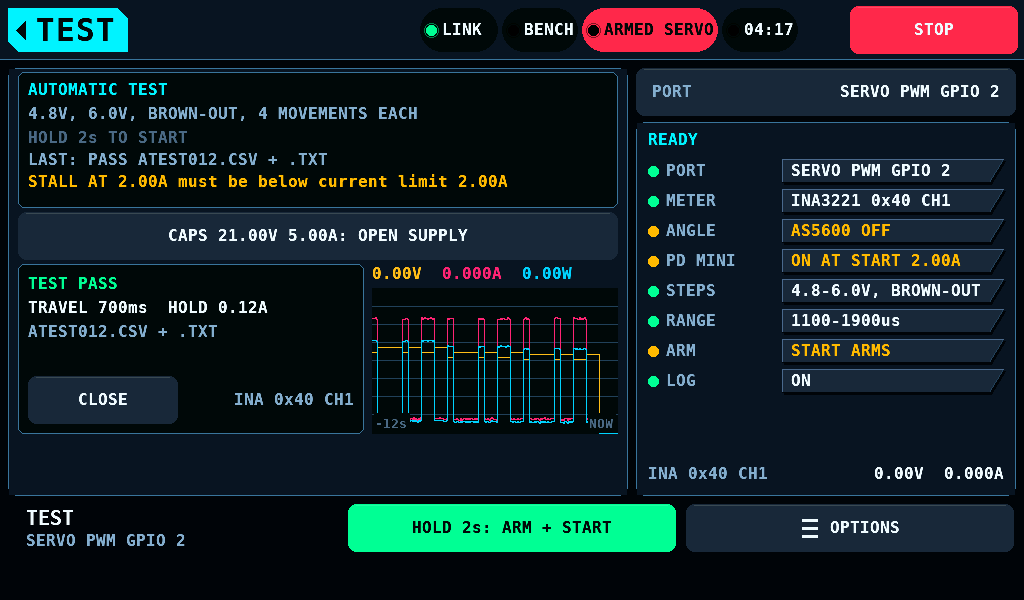
docs/img/servo-result-ina.png
