subtilitas/rcbench/docs/img/servo-test-settings.png

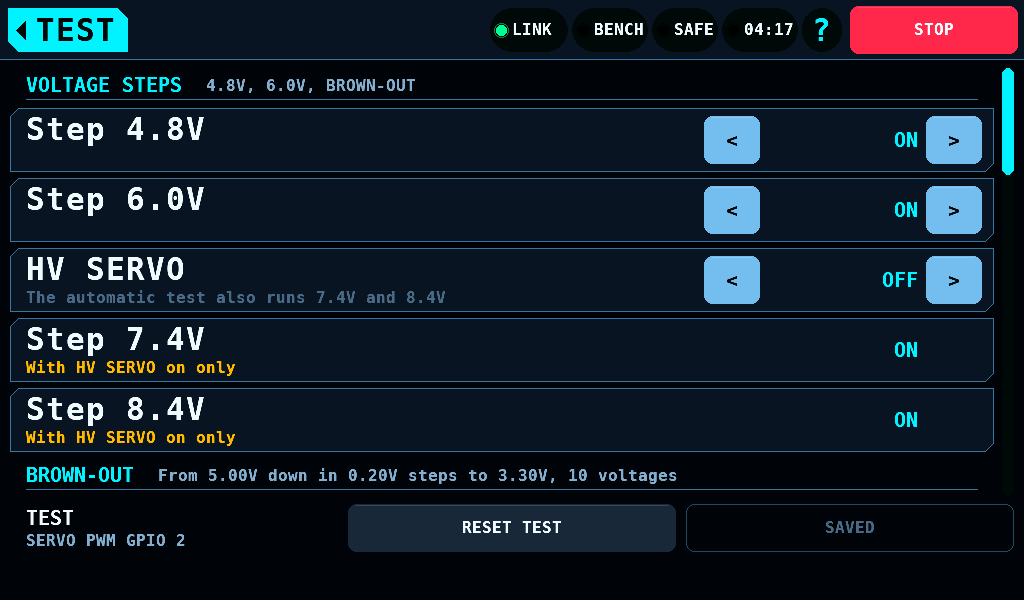
docs/img/servo-test-settings.png
