subtilitas/rcbench/docs/img/servo-test.png

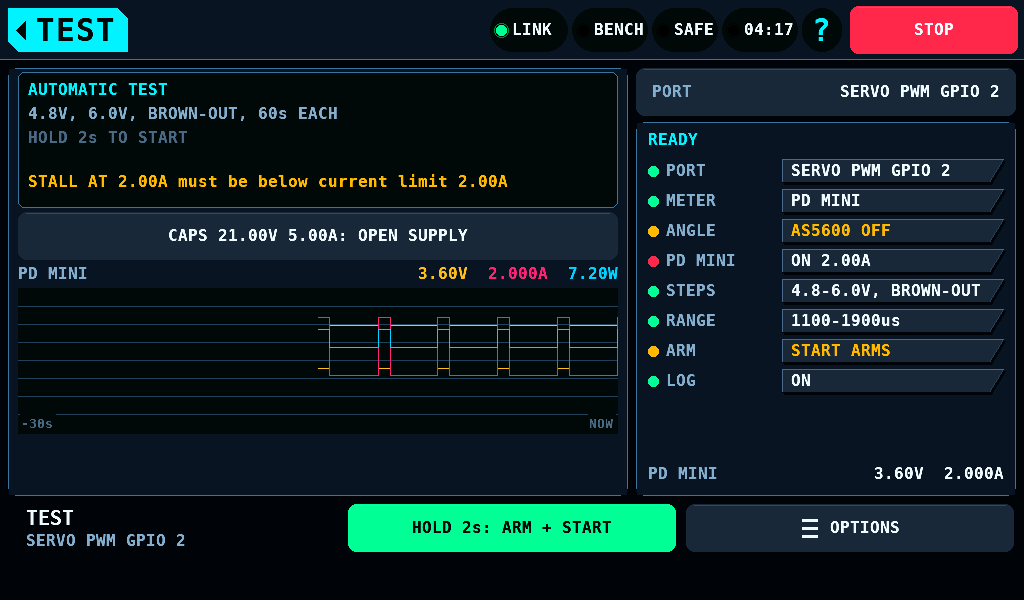
docs/img/servo-test.png
