subtilitas/rcbench/CHANGELOG.md

# Changelog

Notable changes to rcbench. The format follows
[Keep a Changelog](https://keepachangelog.com/en/1.1.0/). Commit-level
history is in git.

## Unreleased

### Added

- The power node on the panel: a third Bluetooth LE client on the panel's
  hub, SETUP > WIRELESS > POWER NODE with Power node ON or OFF, INA228
  SOURCE (WIRED or NODE, WIRED by default), SCAN FOR NODE (refused while
  ARMED, stopped at the switch to ARMED), BOUND NODE and NODE BATTERY.
  With NODE the node's windows feed MOTOR & ESC's voltage, current, power
  and peaks, and its 40-bit accumulators the run's charge and energy, as
  differences from the last packet before the arm with the restart rule.
  The node's readings feed no protection. With NODE an ARM of MOTOR & ESC
  or ESC STICK is refused while the node is OFF or sent no reading in the
  last 100ms, and in such a run a gap of up to 300ms rides once in 10s,
  a longer one or a second one within 10s ends the run as an error; SERVO
  and OUTPUTS runs do not count on the node. INA228 SOURCE does not change
  while ARMED. The bench log's `source` column reads `node` on such rows. At
  each switch to ARMED the panel writes RUN with the run's tag
  ([The sensor nodes](docs/Nodes.md#the-panel)).

- The sensor nodes' firmware (`firmware/node`), one ESP-IDF v6.1 project
  for the ESP32-C6 on a Waveshare ESP32-C6-Zero, the role chosen at build
  time. The power node reads a MATEK I2C-INA-BM's INA228 (0x45, 200µΩ, the
  bench's 540/540/50µs set-up) on GPIO19 (SDA) and GPIO18 (SCL), sends a
  window every 20ms (mean and highest current, mean and lowest voltage,
  the sample count) and the raw 40-bit CHARGE and ENERGY every 500ms over
  Bluetooth LE as `rcbench-pwr-XXXX`, reads its cell through a
  200kΩ/200kΩ divider on GPIO3, sleeps after 120s without a link or a
  pack and checks for a pack every 10s, and prints a console line every
  second. CI builds the image and a release carries
  `rcbench-node-pwr-<version>.bin` and `rcbench-node-pwr-merged-<version>.bin`
  ([The sensor nodes](docs/Nodes.md)).
- Protocol module `protocols/rcnode`: the nodes' service and
  characteristic UUIDs (STREAM, STATUS, CONTROL, INFO), the power node's
  window, accumulator, run-extreme and status packets, the balance report
  (shared/vibe's flags bit for bit, quality, revolutions, rpm, period
  spread, 1x, 2x and blade-pass magnitudes, 1x phase, rms), the control
  writes, the advertising and its match, and the panel's rule for a
  restart of the accumulators
  ([protocols/rcnode](protocols/rcnode/README.md)).
- Protocol module `protocols/dialknob` for the M5Stack Dial v1.1 as a
  wireless knob over BLE: the packets in both directions (EVENT, STATUS,
  INFO; SCREEN, NAV, VALUE_META, VALUE, LIVE_MOTOR, LIVE_SERVO, STATE and
  SCALE, the readings' full scales for the face's rings),
  20 bytes or less, every field bounded; the panel's turn tracker (the
  first packet after a connect, a packet more than 300ms late and a jump
  over 16 detents move nothing, a repeated seq is dropped); the link's
  DEGRADED at 500ms and LOST at the disconnect or at 1,000ms, counted from
  the first EVENT of a connection, a loss while ARMED being an error; the
  Dial's rule that it sends no EVENT and no keepalive while no panel packet
  came for 500ms or none since the connection (`dk_link_lost()`); the
  Dial's model of its face, in which another face or title empties the
  rows, the value and the full scales, and its encoder detent with 3 counts
  of hysteresis; host suites
  `test_dialknob`, `test_dialknob_track`, `test_dialknob_face`. Protocol 1
  is not final until the first release that carries the Dial.
- Firmware for the M5Stack Dial v1.1 (`firmware/dial`, ESP-IDF v6.1,
  ESP32-S3): the power latch on GPIO46, the encoder on PCNT, the buttons,
  the FT3267 touch glass, a 3ms click per detent (default ON), the GC9A01
  display with the faces below, a NimBLE peripheral serving the
  dialknob service that binds the first panel to subscribe and then
  accepts that panel only (a 10s button hold forgets it), sends no EVENT
  from 500ms after the panel's last packet and ends the link at 1,000ms,
  the internal heap free and its lowest in the log at start and in
  `status`, and a USB console
  (`dial>`) whose test build injects turns, presses, holds, taps and a
  battery reading and marks each injected detent on GPIO1. The battery's
  reading pin is unknown, and STATUS reports the battery as unknown
  ([The M5Stack Dial](docs/Dial.md)).
- The M5Stack Dial's faces (`shared/dial`), drawn with the panel's
  rasteriser, fonts and dark palette from the panel's packets: a list with
  rim ticks, a value with its range, its step and one ring, MOTOR & ESC and
  SERVO with six readings in a grid of equal cells inside radius 100 and
  six antialiased 1px rings from radius 118 inward at 3px, each from 12
  o'clock clockwise to its reading's share of the full scale, LINK LOST
  (`NO TURN IS SENT` while connected, `THE BENCH IS SAFE` after the link
  ended), waiting, not bound, and a screen the knob does nothing on; a line
  too wide drops a whole part, never a number's digits; the title
  tag, the SAFE or ARMED pill with the run clock, the link bars, the
  battery and two press hints on every face; `--` for a reading without
  its valid bit; the words in English and German (`UI_DIAL_TEXT` in
  `ui_text.def`), the language from the SCREEN packet. Only what changed is
  drawn: a cell, a row, and of a ring the pixels between its old and new
  end; the Dial sends only the rectangles written (a 300rpm change sends
  3,920 of 57,600 pixels). The six ring tables, 25,032 bytes, are const
  data in flash, generated by `tools/gen_dial_rings.py` (CI runs
  `--check`). Host suites `test_dial_face` and
  `test_dial_fit`; `tools/render_dial.py` writes the 20 images in
  `docs/img` and CI's `--check` holds them
  ([The M5Stack Dial](docs/Dial.md#the-faces)).
- The M5Stack Dial navigates the panel while it is linked and the bench is
  SAFE: the menu, SETUP's tiles and lists, SERVO's tiles and SETTINGS
  list, OUTPUTS' board view, the choice lists and the leave warning. A 2px
  ring in the accent colour marks the focused item; a detent moves it and
  wraps, PRESS taps it in one frame, HOLD does what the home tag does. A
  number is set on its keypad by turning, PRESS OK, HOLD CANCEL; an on/off
  or option row is stepped by its keys, PRESS keeps, HOLD restores. The
  Dial shows NAV and VALUE. The ring keeps the pixels under it: a move
  costs about 1,060 cache-line fills on the menu, held under 1,300 by the
  `overview-focus` frame-cost mode. No 2s hold completes from the Dial.
  The Dial's input wakes a dimmed panel; on an idle bench the waking input
  does nothing else, as a waking touch
  ([Navigation and SET](docs/Dial.md#navigation-and-set)).
- `gfx_ring_aa()` in `shared/gfx`: a 1px ring antialiased by each pixel's
  coverage clamp(1 - |d - r|, 0, 1), from a table of the pixels the ring
  touches sorted by angle, 3 bytes each; `gfx_ring_move()` repaints only
  the pixels between an arc's old and new end (`test_gfx_ring`, against a
  reference from the same formula).
- CI builds the Dial's image and its test build (`.github/workflows/dial.yml`,
  artifact `dial`); a release carries `rcbench-dial-<version>.bin` and
  `rcbench-dial-merged-<version>.bin`. `tools/image_slot.py` takes the
  image's file name as a second argument.
- Module `shared/vibe`, host-tested: the balance
  node's index comparator and its demodulator of the 1x, 2x and blade-pass
  against the index (integer only, for the ESP32-C6), a no-index mode at an
  rpm the panel gives, and the two-run and four-run balance corrections for
  the panel. Angles count from the index mark in the order points pass the
  index sensor ([vibe](shared/vibe/README.md)).
- The balance node's firmware (`firmware/node`, role `bal`): an ADXL335 or
  ADXL337 axis on GPIO0, the TCRT5000 module's D0 on GPIO1 and the battery
  divider on GPIO3 in one ADC1 stream (continuous mode, 30,120 conversions
  a second, 10,040Hz a channel), the index found in the stream with the
  mark's polarity taken from the shorter level, shared/vibe's demodulator,
  and a balance report every 250ms on STREAM (`RCNODE_T_BAL_REPORT`).
  BLADES sets the blade count, RPM the no-index mode. The scale comes from
  the chip's ADC calibration and 330mV/g. The TCRT5000 module runs from
  GPIO20, switched off before a sleep; the node sleeps after 120s without
  a link until the RESET key. CI builds the image and a release carries
  `rcbench-node-bal-<version>.bin` and
  `rcbench-node-bal-merged-<version>.bin`
  ([The sensor nodes](docs/Nodes.md#the-balance-node)).
- `shared/vibe`: the node's ADC frames split into channels with a lost
  conversion found (`vibe_frame_split()`), a read checked against the
  driver's overflow count (`vibe_frame_whole()`), a conversion dated from
  the newest frame done (`vibe_frame_time()`), the scale and the DC window from
  two points of the ADC's calibration curve (`vibe_cfg_scale()`), and the
  index with its polarity found (`vibe_index_scan()`); host suite
  `test_vibe_frame`.
- The panel's side of the balance node. SETUP > WIRELESS has a BALANCE
  NODE entry: ON/OFF, a 10s scan for nodes whose manufacturer data names
  the balance role (`rcnode_adv_maker_role()`), the name taken from the advertising or the scan
  response (refused while ARMED, stopped at the switch to ARMED), the bound
  node kept over a restart, the node's cell from the STATUS packets it
  sends on STREAM, and the trial mass (0.01g to 20.00g, 0.50g by default).
  The panel reads INFO and takes reports only from a balance node of
  protocol 1, writes the blade count and, after 2 reports without an index
  edge, the bench's rpm, at most one CONTROL write every 250ms. BALANCE
  shows the node's 1x magnitude, angle, rpm and a quality word from the
  report's flags; `--` for a report older than 1000ms, for a report
  without a counted revolution (the magnitude) and while the link of a
  bound node is down; SIMULATED only while BALANCE NODE is OFF or no node
  is bound. A new report repaints the four readings' values alone, on the
  BALANCE pane only (`balance-node` in `tools/frame_cost.py`, held at
  1,000 fills by CI). MOTOR & ESC gets a BALANCE tab beside PLOT and
  TABLE: a TAKE key for each run of the two-run and four-run methods (8
  reports, 2s, each; a report with the sensor's DC level out, a clipped
  sample, an rpm out of range, a lost or refused index edge or a changed
  mode fails the run at once with its own word, and a trial whose mean rpm
  lies more than 5% from the baseline's fails as `NOT BASELINE RPM`;
  the runs clear with CLEAR, the method, BLADES, PROPELLER or EDF,
  Balance node OFF or ON, another node bound and a node restart, which
  INFO's clock shows at the link-up, and a reconnect of the same node
  keeps them), the correction through
  shared/vibe as ADD and WHERE,
  solved again when the trial mass changes, and a row in
  `BENCH/BALANCE/BALANCE.CSV` for each solution; the hint under ADD says
  whether the row was written. A file whose last row was cut gets a line
  end before the next row
  ([Balancing](docs/Balance.md#measuring-with-the-balance-node)).
- `protocols/bleuart`: a connect that goes unanswered doubles the gap
  before the next, from 1,000ms (7,000ms after a failure the host stack
  reports) up to 30,000ms (`BLEU_BACKOFF_MAX_MS`); a scan, a bind or a
  link that comes up starts it over. A bound peripheral that is away so
  holds the host stack's one connect less often, and the other clients'
  connects wait less.

- The IOmcu's 3s console report ends with the main loop's pass times since
  the report before it: the longest pass, the passes over 500us, the
  longest `can_service()` call and the longest report pass
  (`loop max`, `over 500us`, `can max`, `report max`), then the passes
  ended, sorted into five bins (at most 250us, 500us, 1000us, 2000us and
  over 2000us), and the XIP cache's misses (`xip miss`). A line after the
  boot line gives the flash's read set-up, QMI M0's RCMD, RFMT and TIMING
  (`flash read`). Its CAN line ends with `txq_max`, the most reply frames
  queued at once ([Bringup](docs/Bringup.md#iomcu)).

- Column `throttle (%)` in the MOTOR run log, after `rpm`: the throttle
  the panel commands at the sample, 0 to 100% to 0.1%, for PWM and DShot
  outputs. On a measured row it is the THROTTLE in force at the IOmcu
  when the sample was read, the last one it acknowledged; on a modelled
  row the throttle the model runs at; 0.0 while the motor is not ARMED. A MOTOR file has 24 columns with 3 INA3221 groups. SERVO
  files are unchanged. LOGS reads files without the column
  ([Screens](docs/Screens.md#table-and-what-the-esc-says)).

- Profile field `scheme.announce.loop_marker`: `true` where the ESC sounds
  one sound that is no item between the highest item and the lowest of each
  pass of its item loop. Absent, null or `false`: none
  ([ESC profiles](docs/EscProfiles.md)).
- ESC profile `flycolor-flydragon-lite` for the FlyDragon Lite: the 40A
  2-4S from its label and measured on one ESC, and the 60A to 120A 3-6S
  from manual 251400-1111 V1.2. Item 8 is Battery cells, with 4 values on
  the 40A and 6 on the others. The profile states `beep_ms` 128, `long_ms`
  384 and `loop_marker`. 74 profiles, 462 models; ESC STICK runs 26.
- The panel's console prints Dim after's state every 300 frames: the
  setting, dim or awake, the seconds since the minutes last started, what
  started them (a touch event with its type, track id and source, the
  screenshot gate's first busy fact, or 0 minutes) and the backlight's
  duty ([Performance](docs/Performance.md#on-the-board)).
- `protocols/bleuart` takes a profile (`bleu_profile_t`): the service
  UUID, up to 4 characteristics by role and the connection parameters.
  The ISSC Transparent UART profile is the default. A hub
  (`bleuart_hub.h`) runs up to 5 central machines on one host stack:
  events go to their machine by the owner in the token's top 3 bits or by
  the connection handle, and one scan or connect runs at a time, a second
  answered busy ([bleuart](protocols/bleuart/README.md#the-hub)).
- A console line `ble: connect refused by the C6 radio, HCI 0x09: ...`
  when the C6's controller refuses a connect for want of a link
  ([The Bluetooth IMU](docs/IMU.md#console-lines)).
- The panel's side of the M5Stack Dial. SETUP > WIRELESS > DIAL: Dial ON
  or OFF (OFF by default), a 10s scan for Dials (refused while ARMED, with
  a band text), the bound Dial by address (`dial_ble`, `dial_name`),
  reconnected without a scan, and the steps of a detent, 0.5% to 5% of
  throttle and 0.5° to 5° of horn angle (1% and 1° by default). A Dial's
  detent moves the throttle on MOTOR & ESC and the horn on SERVO LIVE
  through the rotary knob's path and rules; nothing moves while SAFE. Its
  PRESS sets 0% or CENTER while ARMED, its HOLD DISARMs, and no Dial event
  switches anything on. A Dial lost while ARMED, 1,000ms without an EVENT
  or the disconnect, is an error: SAFE, all outputs off, band text
  `DIAL LOST WHILE ARMED: SWITCHED TO SAFE, ALL OUTPUTS OFF`; 500ms is a
  notice. The panel streams its screen to the Dial: SCREEN, VALUE_META,
  VALUE, SCALE, LIVE_MOTOR and LIVE_SERVO at 20Hz, STATE, the whole model
  again at each connect. Console lines under the tag `dial`. Navigation
  from the Dial is a later slice
  ([The M5Stack Dial](docs/Dial.md#the-panel)).
- `bleu_profile_t` names the service a scan lists (`adv_svc`,
  `adv_uuid16`), so each Bluetooth LE client lists its own devices; a
  PARAM characteristic's value is kept to 20 bytes, up from 8
  ([protocols/bleuart](protocols/bleuart/README.md#scan)). A write without
  response is answered at once with the host call's status
  (`bleu_hub_written()`), never through the event queue; a client ends an
  unusable link as a failed GATT step with `bleu_fail_link()`.

- `hardware/mechanical/`: STEP models of the M5Stack Dial (SKU K130) and
  its ring nut, generated from `m5dial.py`. The 9 plastic parts come from
  M5Stack's mesh, copied to `vendor/m5stack_dial/Dial.stl` under its MIT
  licence: `_refit.py` fits its 29240 triangles with 3929 faces on planes,
  cylinders, cones, tori and, for the thread of 2.6mm pitch, B-spline
  surfaces along the helix, within 0.124mm of the mesh.
  `check_refit.py` holds the written solids against the mesh in CI. The
  power terminal, PORT.A, PORT.B and the USB-C receptacle are added from
  their makers' drawings and M5Stack's Stamp-S3 model; the display lens
  and module, the main board and the 2 M2 screw heads from the mesh's
  pockets and estimates. `step_gen.py` writes solids with faces on
  curved surfaces (`"brep"`) besides prisms and turned profiles
  ([Mechanical parts](hardware/mechanical/README.md#m5stack-dial)).

### Changed

- The nodes advertise the service's 128-bit UUID and the manufacturer
  data, and send the name in the scan response, so a central that filters
  duplicates lists a node from its first report. `rcnode_rsp_build()` takes
  the role and the address. The nodes send their STATUS packet on STREAM
  as well, for a central that subscribes to STREAM alone
  ([protocols/rcnode](protocols/rcnode/README.md)).
- SETUP has a WIRELESS tile, `IMU, DIAL`, for the panel's Bluetooth LE
  devices. The IMU's 7 rows move from SENSORS to its IMU entry, unchanged
  in key and behaviour; SENSORS has 8 entries. The IMU screen's OPTIONS
  opens WIRELESS on the IMU entry. The SETUP page's 9 slots are full on
  the rbmod carrier ([Screens](docs/Screens.md#wireless-the-imu-and-the-dial)).
- The panel's Bluetooth LE host and the C6 radio's image hold 5
  connections, up from 1 and 3: the IMU, the Dial, 2 sensor nodes and 1
  spare. The C6 image sets `CONFIG_BT_LE_MAX_CONNECTIONS=5` from
  `firmware/c6/sdkconfig.rcbench`, and `tools/c6_image.py check` fails an
  image without it ([The ESP32-C6 radio](docs/C6.md#the-image-the-panel-carries)).
- The IMU's link runs on the `blec` task, the one task of every Bluetooth
  LE client, through the hub, in place of the `imu` task. The event queue
  holds 64 events (4,096 bytes of internal RAM), up from 32, and keeps up
  to 8 dropped DISCONNECTs, up from 1. The IMU's scan, bind, connect
  parameters and console texts are unchanged
  ([The Bluetooth IMU](docs/IMU.md#the-link)).
- The panel's host runs up to 10 GATT client procedures at once, up from
  4: 2 for each of the 5 links. The pool takes 600 bytes of PSRAM, up
  from 240 ([Performance](docs/Performance.md#on-the-board)).
- On a C6 that reports the carried version, the C6 RADIO row on UPDATES
  offers `HOLD 2s TO REINSTALL THIS PANEL'S C6 FIRMWARE` and the hold sends
  the image; an update no longer ends at the link-up with the C6 on that
  version. An image of the same esp_hosted version can carry other
  settings, such as 3 Bluetooth LE connections in place of 5
  ([Screens](docs/Screens.md#the-c6-radio)).
- `tools/c6_image.py` reads `# CONFIG_X is not set` as `CONFIG_X=n`.

- The IOmcu queues each CAN reply whole, up to 16 frames, and sends it
  through the controller's 3 transmit buffers, up to 3 frames per pump and
  two pumps a pass, each batch after the one before it has left; no pass
  waits for a transmit buffer. A batch still unsent 5000us after its request to
  send is aborted with the rest of the queue and counted in `tx_drop`; a
  reply frame waited up to 1,000us for the one transmit buffer before.
  The firmware update's restart sends the queue first
  ([DShot](docs/DShot.md), [Bringup](docs/Bringup.md#iomcu)).
- The IOmcu image runs from SRAM: the start-up code copies its code and
  read-only data out of the flash slot before `main()`. SRAM in use rises
  from 87,536 to 365,040 bytes of 524,288. On the station, from flash with
  the dual-I/O read at 50MHz the boot ROM sets up, against SRAM, medians
  per 3s: loop max 2701us and 204us, can max 1218us and 165us, report max
  1404us and 94us, passes over 500us 1440 and 0. DShot runs 1,000 frames a
  second with a longest gap of 1,189us and no frame more than 500us late.
  STOP to the last frame over 10 presses: median 4.5ms, at most 15.3ms. A
  CAN update received by this image takes 24.3s
  ([Bringup](docs/Bringup.md#iomcu)).
- The IOmcu's 3s console report hands out one line a pass, only when the
  USB transmit buffer has room for 256 bytes: a host that holds the port
  and stops reading holds no pass. The text of the report is unchanged.

- A screen guide's badge takes the first of 11 places beside or on its
  control that covers no string the screen draws, in either language: the
  places run from inside the top-left corner through the other corners,
  both sides, the middle and the left edge to above and under the control
  ([Screens](docs/Screens.md#the-screen-guide)).
- A screen guide's badge is a 24px accent disc in a 2px dark ring, and
  shows on a lit accent button such as WI-FI's ACCESS POINT.
- A number typed on a setting's keypad between two steps shows a notice in
  the alert band with the value stored and the step:
  `Dim after: 5min stored, steps of 5min.` after 7 for Dim after, and
  `Current max: 1.00A stored, steps of 0.05A.` after 1.03 for SUPPLY's
  cap, which rounds down.
- The time labels of a plot, `NOW` or `END` and the span, sit on the plot's
  background: a trace along the bottom runs under them.
- The band names RUDDER and RUDDER AUTO as their tiles and footers do:
  RUDER and RUDER AUTO in German.
- `tools/render_ui.py --fit` fails on a string of the screen under a badge
  of the screen guide, in either language.
- The simulated ESC sounds an 808ms tone before each pass of its item loop
  where the profile sets `loop_marker`.
- KST and HITEC programmers: WRITE n VALUES writes after a 2s hold, on
  the SERVO tab and in the footer; a tap shows `Hold 2s to write.` The
  ENABLE WRITE TO SERVO row and the write page are removed. The model's
  write gate opens for the one write, restore or pairing release a hold
  sends and shuts at its end. With no card the SERVO tab says `No card.
  No backup file will be saved.` while edits wait
  ([Servo programmer](docs/ServoProgrammer.md#writing),
  [Hitec](docs/HitecProgrammer.md#writing)).
- KST and HITEC programmers: LEAVE PROGRAMMING with unwritten edits lists
  them and offers HOLD 2s TO LEAVE WITHOUT WRITING, which drops them, and
  BACK, which keeps them
  ([Servo programmer](docs/ServoProgrammer.md#leaving)).
- HITEC programmer: while edits wait, the SERVO tab says what their write
  does besides the values: `The servo saves and restarts. It ignores
  signals for 1s.` for a D series servo, `Each stored value is followed by
  a write of the checksum in 0x1C.` for a classic one, and `Stored values
  outside the settings written too: n.` where the draft holds such values
  ([Hitec](docs/HitecProgrammer.md#writing)).
- KST and HITEC programmers: a card in the slot at WRITE n VALUES' press
  and gone when its 2s hold completes, on the tab or in the footer, stops
  the write. Nothing is sent, the edits stay, and the band says `Card
  removed. Hold again to write without a backup.` The press asks a
  mounted card one SEND_STATUS (CMD13) and sends nothing with none
  mounted. The next hold, its press without a card, writes without the
  backup file
  ([Servo programmer](docs/ServoProgrammer.md#without-a-card)).
- SUPPLY: DISCARD of a lowered VOLTAGE MAX or CURRENT MAX gives the set
  point the cap brought down its value from before the edit, never above
  the cap. With the output on the set point stays down until the next OFF,
  and the band says so in one line, such as `Current limit stays at 1.00A
  until the output is off.` A set point changed since the clamp, or a cap
  saved at another value, gives nothing back.
  ([Screens](docs/Screens.md#supply-settings)).
- Dim after: FAULT 01, LINK_SILENT, alone no longer keeps the screen lit.
  The IOmcu reports it after a restart of the panel until the next ARM, so
  the screen never dimmed until then. Every other FAULT bit keeps the
  screen lit, and the FAULT chip shows every bit
  ([PANEL: Dim after](docs/Screens.md#panel-dim-after)).

### Fixed

- HITEC programmer: while a write runs, the SERVO tab no longer shows
  `Writing was interrupted. The settings may be incomplete.` for the record
  of that same write; the state line shows the write's step.
- German guide texts of the IMU's ZERO and UNZERO: "löscht er den
  Nullpunkt" and "löscht es den RUDER-Nullpunkt".
- Dim after dims the backlight. The link report's line to the card's
  fault log, every 60s while the IOmcu is linked, counted as a busy bench
  and started the minutes again, so no setting from 5 to 60min was ever
  reached. The line no longer counts for Dim after; the screenshot's popup
  still waits for it ([PANEL: Dim after](docs/Screens.md#panel-dim-after)).
- ESC STICK selects items 1 and 2 of a Flycolor FlyDragon. The ESC sounds
  its 12321 melody, about 808ms, before every pass of its item loop; the
  order rule took it for a group out of order, so item 1 never followed
  item 10 and the run ended with TIMEOUT after 180s. In a profile with
  `loop_marker` the item loop lets one group out of order pass right after
  its highest item; a second breaks the order, and the value loops let
  none pass. The FlyDragon Lite Plus profile sets the field, from one
  FlyDragon Lite 40A recorded on 2026-11-11
  ([Stick programming](docs/StickProgramming.md#how-the-beeps-are-counted)).

## 0.23.12 - 2026-11-11

0.23.12 is a testing release. It counts the beeps of an ESC STICK run from the
phase tap or an INA3221 channel, takes a stick run's beep timing from the ESC
profile where the profile states it, and adds the field `long_ms` to the ESC
profiles. Its minor number, 23, is odd. GitHub publishes it as a pre-release
and does not mark it as latest. It runs on the ESP32-P4 panel, as 0.23.11
does; an ESP32-S3 panel stays on the 0.22 line and is not offered it. The
link protocol is 4.37, unchanged from 0.23.11. The assets are
`rcbench-panel-p4-v0.23.12.zip`, `rcbench-panel-p4-v0.23.12.bin`,
`rcbench-iomcu-v0.23.12.zip`, `rcbench-iomcu-rbmod-v0.23.12.zip`,
`rcbench-c6-2.13.0.bin`, `rcbench-c6-merged-2.13.0.bin` and `SHA256SUMS`.

A bench on 0.23.11 gets 0.23.12 over Wi-Fi: SETUP > UPDATES, RELEASES: TESTING,
CHECK FOR UPDATES, then hold the install button for 2s. With RELEASES: STABLE the
check reads `releases/latest`, which names 0.22.1, and offers nothing. At
link-up the panel offers to update the IOmcu over CAN (Controller Area Network)
when the IOmcu runs a different build. To set up a new bench, load both boards over USB
(Universal Serial Bus) as [First run, §1](docs/FirstRun.md#1-flash-both-boards)
describes.

The entries below cover the 2 pull requests merged since v0.23.11: #800 to
#801.

### Added

- Profile field `scheme.announce.long_ms`: a long beep's length in ms, 0 to
  60000 or null, in a `short_long` profile only, longer than `beep_ms` and
  stated together with it ([ESC profiles](docs/EscProfiles.md)).

### Changed

- ESC STICK counts the ESC's beeps from the phase tap or from an INA3221
  channel; the PD mini's current does not count them. The PD mini reads
  every 100 to 152ms, and a Flycolor FlyDragon Lite 40A sounds short beeps
  of 127.9ms. A run takes its source at RUN and keeps it: the phase tap
  while its capture runs, else the lowest INA3221 channel with a shunt that
  watches SUPPLY while its 50ms windows come in. With neither, RUN is
  refused with `No beep source. Switch the phase tap on, or set an INA3221
  channel to SUPPLY, on SENSORS.` The tap's beeps go into the groups with
  the IOmcu's own start times and lengths. A tap group ends only on a tap
  status that shows no beep under way, no tone in its last 8ms window and
  every beep taken, with that window ending GROUP GAP or more after the
  last beep. The PD mini powers the ESC, and its readings decide every
  power rule. The run's page and the warning name the source
  ([Stick programming](docs/StickProgramming.md#where-the-beeps-come-from)).
- A run ends with BEEP LOST when a tap beep number is missing, with TAP
  STOPPED when the tap's capture stops, and with INA3221 LOST when no window
  of the channel comes for 1000ms. READING RATE judges the INA3221's windows.
- A stick run takes its timing from the profile where the profile states
  it: BEEP MIN half the short beep, LONG midway between the short and the
  long beep, LONG MAX twice the long beep, GAP MIN half the gap (without
  a gap, the lower of the setting and half the short beep) and GROUP GAP
  midway between the gap and the group gap. The settings apply where
  the profile states nothing. The run's top card shows BEEP MIN and LONG,
  marked (profile) or (setting); the profile page shows them where the
  profile states its beep lengths
  ([Stick programming](docs/StickProgramming.md#timing-from-the-profile)).
- The Flycolor FlyDragon Lite Plus profile states `beep_ms` 128 and
  `long_ms` 384, measured over the phase tap on one FlyDragon Lite 40A. Its
  run uses BEEP MIN 64ms, GAP MIN 64ms, LONG 256ms and LONG MAX 768ms
  with every setting at its default. Its gaps are not measured: GROUP GAP
  stays the setting's 700ms.

## 0.23.11 - 2026-11-11

0.23.11 is a testing release. It adds the input-supply check of the rbmod
carrier, labels in log names with RENAME LOG on MOTOR & ESC, a cursor in the
name keyboard, the plot of the servo supply on every SERVO function screen
and the ESC STICK profile for the Flycolor FlyDragon Lite Plus. LIMIT RUN and
RUDDER AUTO program at 5.0V and refuse the IMU's yaw axis. Its minor number,
23, is odd. GitHub publishes it as a pre-release and does not mark it as
latest. It runs on the ESP32-P4 panel, as 0.23.10 does; an ESP32-S3 panel
stays on the 0.22 line and is not offered it. The link protocol is 4.37, as
in 0.23.10. The assets are
`rcbench-panel-p4-v0.23.11.zip`, `rcbench-panel-p4-v0.23.11.bin`,
`rcbench-iomcu-v0.23.11.zip`, `rcbench-iomcu-rbmod-v0.23.11.zip`,
`rcbench-c6-2.13.0.bin`, `rcbench-c6-merged-2.13.0.bin` and `SHA256SUMS`.

A bench on 0.23.10 gets 0.23.11 over Wi-Fi: SETUP > UPDATES, RELEASES: TESTING,
CHECK FOR UPDATES, then hold the install button for 2s. With RELEASES: STABLE the
check reads `releases/latest`, which names 0.22.1, and offers nothing. At
link-up the panel offers to update the IOmcu over CAN (Controller Area Network)
when the IOmcu runs a different build. To set up a new bench, load both boards over USB
(Universal Serial Bus) as [First run, §1](docs/FirstRun.md#1-flash-both-boards)
describes.

The entries below cover the 26 pull requests merged since v0.23.10: #773 to
#798.

### Added

- On the rbmod carrier the panel warns about a low input supply: while the
  PD mini, which runs from the same input as the +15V net, reads it under
  13.5V, the alert band shows `INPUT 5.1V: NEEDS 15V. CHECK THE SUPPLY
  VOLTAGE` once, SUPPLY's head line and the PROG 5V box name the input in
  red, and the PROG 5V row of the READY card on KST, HITEC, LIMIT RUN and
  RUDDER AUTO reads `INPUT 5.1V < 15V` in red. PROG 5V ON, a KST or Hitec
  CONNECT and ARM + START of LIMIT RUN and RUDDER AUTO are refused with
  that text, and no output is switched. An input that goes low during the
  2s hold, during ARM's or ARM + START's steps up to the read-back, or
  before a run's CONNECT ends them the same way, with every output off.
  Without a PD mini reading there is no warning.
- After every ON of the carrier's programming-port 5V, the PROG 5V box's,
  ARM's and a KST or Hitec session's, INA3221 0x40 CH3 must read 4750mV or
  more within 200ms; otherwise every output goes off with `PROG 5V
  MISSING: 3.1V AFTER 200ms. CHECK THE SUPPLY VOLTAGE`.
- The name keyboard of FILES (RENAME, NEW FOLDER, NEW TEXT FILE) and of
  the screenshot popup edits at a cursor, a 2px bar. `<-` and `->` in the
  bottom row move it one character, Ä or ß one character too; a tap in
  the text field puts it in the nearest gap. A key types at the cursor,
  DEL takes the character before it, and a key past 59 bytes types
  nothing with the cursor kept. RENAME of a file starts with the cursor
  before the last full stop (`NOTES` before `.TXT`); a folder or a name
  without a full stop starts at the end. A name longer than the field's
  48 characters shows the part around the cursor. The bottom row is
  SPACE 3 columns, CLR, `<-` and `->` 1 each, CANCEL and OK 2 each; the
  screenshot popup's word keys draw in 12 x 24 in German.
- A run's name may carry a label behind its number,
  `MOTOR042_kv1200.CSV`: one `_` and 1 or more bytes, up to 46 behind a
  five-letter prefix. Every prefix (SERVO, MOTOR, SUPPL, ATEST, LIMIT,
  RUDDR and the older BENCH and ESC) reads it as the same run: LOGS and
  FILES keep its number, kind and place in the list, DELETE takes its
  plain report, and the next run takes one above a labelled number.
- RENAME LOG on MOTOR & ESC (German `LOG UMBENENNEN`), a 180 x 40px tap
  button in the strip row on LIVE and PROGRAM's list, gives the MOTOR log
  closed since power-on a label: `MOTOR042.CSV` becomes
  `MOTOR042_kv1200.CSV`. The name keyboard over the body edits the label
  alone, up to 46 bytes, with its cursor starting at the label's end; OK
  on an empty field gives the plain name back.
  The button acts only while the bench is SAFE with ARM not held, no log
  file is open and the log's card is still mounted; dimmed, a tap names
  the reason in the alert band until the button is live again or the
  keyboard opens. The logger renames the closed file as a FILES rename
  under the card's job lock (100ms wait), and the alert band says
  `Log renamed: MOTOR042_kv1200.CSV` as an amber notice for 4s, or why
  not in red. After a power cycle
  the button stays dimmed until the next MOTOR run ends.

- Every SERVO function screen shows the plot of what feeds the servo, one
  widget with a legend of volts, amps and watts in the traces' colours
  (`5.02V  0.120A  0.60W`): KST and HITEC under their READY rows (356px
  wide), TEST under SUPPLY's caps, LIMIT RUN under its state lines
  (600 x 58px), RUDDER AUTO right of ZERO and RESET MAX (260 x 48px), and
  LIVE, SWEEP and RUDDER right of SET A. A new reading repaints the plot
  and the rail line alone. The plots span 30.0s over 600 columns and scale
  over the same 600 points; a narrower one shows the newest of them.
- The PROG 5V box on SUPPLY shows the watts of the window,
  `5.02V  0.120A  0.60W`, and a 72 x 20px plot of the windows right of
  that line. On the SERVO hub the footer reads
  `PROG 5V ON 5.02V 0.120A` while the 5V is on, `--V --A` without a
  reading.
- The run's current limit, SUPPLY's SET A, is on the screens that run:
  TEST's PD MINI row reads `ON 2.00A` (amber `ON AT START 2.00A` while the
  steps switch it on), and LIMIT RUN's and RUDDER AUTO's PD MINI row
  `5.0V 2.00A`. A tap on the row opens SUPPLY's keypad, CURRENT LIMIT
  within SUPPLY's caps and OUTPUT LIMITS; with the output on and Confirm
  keypad on, SUPPLY's question comes first. No keypad opens while a run or
  its start steps are under way or while a programming port holds the
  supply. LIMIT RUN's and RUDDER AUTO's lists hold it as CURRENT, `SET A
  2.00A`, locked as `--` where no PD mini feeds the servo.
- RUDDER AUTO's list has Wait before PWM, the KST programmer's wait its
  sessions' LEAVE sends.
- A tap on TEST's METER row, while the run would read the PD mini, opens
  SETUP > SENSORS on the INA3221 part that watches the tester's target; the
  home tag returns to TEST.
- Each SERVO function screen sets the settings it runs on. A tap on the
  type pill of LIVE, SWEEP and RUDDER opens the servo profile, the hub's
  list, with TYPE in view; a tap on the RANGE row of LIMIT RUN's and
  RUDDER AUTO's READY cards, or on OUTPUT in TEST's list, opens it with
  PULSE MIN in view. LIVE's SETTINGS opens the profile. Each opens on a
  SAFE bench only and closes as the bench goes live, with the keypad,
  choice list or warning a row opened over it: nothing typed, picked or
  held there is taken.
- TEST's list adds RANGE (Range and OUTPUT) and DUT (DUT name and
  Report), and TEST's READY row RANGE opens the list on Range. SWEEP's list
  adds Dwell time. LIMIT RUN's and RUDDER AUTO's lists add DUT name and
  User logs. Range, Dwell time, DUT name, Report and User logs stay one
  setting each, whichever list sets them.
- TEST's READY card adds LOG: User logs `ON`, or `OFF` in amber. A tap
  switches and saves it; under a run or its start steps the tap is refused
  with `LOG: The run keeps its setting. Switch it after the run.`. LIMIT
  RUN's and RUDDER AUTO's cards hold 10 rows already, so User logs is a
  list row there.
- ESC STICK has a profile for the Flycolor FlyDragon Lite Plus (Lite+)
  20A, 30A, 40A and 50A (2-4S) and 30A and 40A 6S (3-6S),
  `flycolor-flydragon-lite-plus`. The menu is two-stage with 10 items in
  short and long beeps. It opens at full throttle before power-on, 7000ms
  to the menu. It sets brake, battery type, low voltage threshold, timing,
  startup mode, PWM frequency, voltage cutoff option and running mode.
  25 of the 73 profiles run; at 20V the list opens 24.

### Changed

- The STALL AT note on TEST and in the servo test's report states the
  rule: `STALL AT 2.00A must be below current limit 2.00A` and
  `STALL AT 2.00A must be below INA3221 range 1.638A`, German
  `BLOCKIERT AB 2.00A muss unter Strombegrenzung 2.00A sein` and
  `BLOCKIERT AB 2.00A muss unter INA3221-Bereich 1.638A sein`. It shows
  while STALL AT is at or above the limit or the range, and replaces
  `STALL AT 2.00A cannot be reached: current limit 2.00A`.
- LIMIT RUN's list has no Programming current row: without a PD mini the
  IOmcu stores a session's current limit and applies none, and with one
  the run takes SET A. The KST and HITEC pages keep Programming current
  for their own sessions.

- RUDDER AUTO's report and box show end points as the programming page
  does, with the unit named: a Hitec D series servo's in position counts,
  8192 the center (`LEFT END (0xB2): 3351 before, 3466 after (counts)`,
  where they read 4841, the distance from NEUTRAL), KST's and a classic
  Hitec servo's raw value (`(raw value)`). The HITEC page's TRAVEL names the unit in
  its D series labels: `NEUTRAL (COUNTS)`, `LEFT END (COUNTS)`, `RIGHT END
  (COUNTS)`.
- RUDDER's zero on the AS5600 survives a restart: ZERO saves it
  (`rud_zero`, `rud_zero_key`), and it comes back while the AS5600 is
  ANGLE SOURCE. Another source drops the saved zero. A zero on the IMU
  lasts until the restart and is never saved: its BLE link is not
  authenticated.
- RUDDER AUTO bounds each write: a register's new value lies within 50%
  of the model's first estimate for it, value0 x goal / measured0. A value
  past it ends the run as FAIL `end point too far from its estimate`
  before the write, with every output off and RESTORE offered.
- RUDDER AUTO refuses the IMU's AXIS Z (yaw) in 6-AXIS and in 9-AXIS. On
  a BWT901CL yaw drifts 2.4° in 100s in 6-AXIS; in 9-AXIS it rose 24°
  while the rudder moved and settled 38° off with the servo unpowered;
  the tolerance is 0.5°. The ANGLE row reads `YAW REFUSED` in red, the
  alert band `IMU YAW REFUSED: HINGE ON X OR Y`, ARM + START is refused, and a tap opens `TURN THE IMU 90°
  SO THE HINGE IS X OR Y` with `USE IMU AXIS X (ROLL)` and `USE IMU AXIS
  Y (PITCH)`, each written and saved as SETUP > SENSORS does. Roll and
  pitch stay allowed in either algorithm. The panel sends IMU algorithm
  to the sensor only when it changes, with one SAVE; a connection adds no
  write. Another IMU algorithm drops RUDDER's zero and MAX, as another
  axis does.
- The PROG 5V lost error on the carrier watches a KST or Hitec session's
  5V as well: under a session a finding waits for a PROG_SUPPLY page read
  that still reads GPIO 21 on.
- CONNECT on the KST and HITEC programmers is a 2s hold, as OUTPUT ON,
  where the session switches the servo's supply on: the carrier's PROG
  5V, a PD mini that answers, or a CLASSIC session. A release before 2s
  sends nothing and shows `Hold 2s to connect and switch the port's supply
  on.` On the rbmod carrier a low input refuses the press and ends a
  running hold. For a servo the operator powers, with no PD mini, CONNECT
  switches nothing on and stays a tap, so the sync keeps its 250ms after
  the tap. ABORT, LEAVE and RELEASE take a tap. READY's SERVO row says
  `Hold CONNECT 2s in the session.` where CONNECT holds; the session's
  messages name CONNECT without a gesture: `No servo connected. CONNECT
  first.`
- DONE of a stick run's manual step before a power-up is a 2s hold: the
  run switches the supply on after it. A release before 2s confirms
  nothing and shows `Hold 2s to confirm the step before the supply
  switches on.` The other steps' DONE stays a tap. A touch loss found
  after DONE's hold completed, before the supply reads on, ends the run
  with no ON written; CONNECT acts on the frame after its hold completes,
  so a touch loss found in between takes it back. Every control that
  switches a voltage, a supply or an output on is a 2s hold.

- The READY card on the SERVO screens (LIVE, SWEEP, RUDDER, TEST, LIMIT
  RUN, RUDDER AUTO, KST and HITEC) draws each row's state on a raised tag
  24px high in the button fill, its right end cut at 30° from vertical, so
  a row reads as a control that takes a tap. The tags of one card share
  the left edge the widest state needs. The label column is 10 cells wide,
  and the German label PROGRAMMIERER reads PROGRAMMER.
- English texts spell center: the CENTER button on SERVO LIVE and RUDDER,
  PULSE CENTER on the servo list, ENC CENTER on RUDDER's list, AS5600 center
  in SETUP > SENSORS, CENTER on the Hitec TRAVEL page, the warnings of the
  KST and Hitec pages, LIMIT RUN's refusal, the ESC WIRE notes, the servo
  reports, the help pages and the docs. German texts are unchanged. The
  BLHeli_S field CENTRE THROTTLE on ESC WIRE keeps its name, a field line of
  the ESC backup files, and the settings key `enc_centre` keeps its name, so
  saved files and settings keep loading.
- LIMIT RUN and RUDDER AUTO each keep their own SERVO, KST/CHASERVO, HITEC
  D SERIES or HITEC CLASSIC, saved in the settings (`lim_family`,
  `rauto_family`). A tap on the READY card's SERVO row opens the three
  over the left column; the SETTINGS list's SERVO row opens the same three.
  A pick is refused off a PROG PORT, while the bench is not SAFE, while a
  run or a start sequence runs and while a programmer holds the port. The
  series a Hitec run connects with is its screen's SERVO, not the HITEC
  page's SERIES. With HITEC D SERIES the list shows Hitec D receive under
  SERVO, the HITEC page's setting.
- HITEC's READY card has a SERIES row under PORT, D SERIES or CLASSIC: a
  tap opens the two over the left card and a pick writes the Hitec series
  the next CONNECT enters, the same setting as the SERVO tab's SERIES. The
  row is refused while the page holds the port or a CONNECT is under way.
- LIMIT RUN and RUDDER AUTO program at 5.0V. Every programmer session of a
  run, KST/Chaservo and Hitec, asks 5000mV with or without a PD mini; the
  KST and HITEC pages' Programming voltage settings (`SET_SERVO_PROG_V`) do not
  reach a run, and LIMIT RUN's list has no Programming voltage row. With
  a PD mini feeding the servo, START sets it to 5.0V, SET A kept, and the
  start sequence's read-back waits for the PD mini's reading at 5.0V; the
  PD mini stays at 5.0V after the run. SUPPLY's limits that leave out 5.0V
  refuse the hold with `PD MINI: 5.0V OUTSIDE ITS LIMITS` on the supply
  row, and a tap there opens SUPPLY's settings at OUTPUT LIMITS. The
  supply row reads `5.0V` for PROG 5V and PD MINI. The `TAP: HV WARNING`
  and `PROGRAMMING: SUPPLY SET BELOW 4.8V` refusals leave both screens.

- RUDDER's and RUDDER AUTO's READY row ANGLE, and the ANGLE SOURCE row of
  their SETTINGS lists, open the ANGLE SOURCE list on a SAFE bench, with a
  reading or without: `AS5600` (`AS5600: OFF IN SETUP`, which opens SETUP
  > SENSORS on the AS5600, while it is off), the IMUs the last scan found
  with name, full address, address type (`P` public, `R` random) and RSSI,
  `NO IMU FOUND` after a scan that found none, and `SEARCH FOR IMU`, which
  switches the IMU on when it is off and scans once Bluetooth LE runs. A
  pick sets ANGLE SOURCE, and an IMU pick binds the sensor and switches the
  IMU on. While the IMU link takes no bind (no sync with the C6, the
  calibration running, the IMU off) the sensors but the bound one are
  refused with the reason in the alert band.
- SETUP > SENSORS > IMU shows Angle source as its second row, also while
  the IMU is off, so the source goes back to the AS5600 without switching
  the IMU on. SCAN FOR SENSORS on the IMU screen takes a press with the IMU
  off: it switches the IMU on and scans once Bluetooth LE runs. The card's
  state line reads `IMU OFF: SCAN SWITCHES IT ON`.
- TEST's and LIMIT RUN's READY cards show an ANGLE row after METER: the
  angle source in green while a run reads it, `AS5600 OFF` or `IMU X+ NO
  READING` in amber while it does not. The row refuses nothing; a tap opens
  the ANGLE SOURCE list on a SAFE bench, and the AS5600 entry's SETUP jump
  returns to TEST or LIMIT RUN. LIMIT RUN's card holds 10 rows.

### Fixed

- LIMIT RUN's card names the output of the last run, such as
  `PROG PORT 1 GPIO 13`, in the language selected in SETUP > PANEL >
  Language: after a change of that setting the line follows on the next
  frame, as the card's other lines do. The report keeps the language of the run.
- A hardware stop button pressed while the bench is ARMED clears when it
  is released: HWSTOP, or FAULT 10, goes 80 to about 180ms after the line
  closes, and no later than about 700ms after the press. The panel's stop
  from the IOmcu withholds the heartbeat for 300ms
  (`ARMING_STOP_WITHHOLD_MS`) and then edges the line again; the stop
  stays latched, the bench stays SAFE with every output off, and only a
  new ARM hold switches to ARMED. Only that stop, the IOmcu's refusal of
  ARM, has the window: an operator's STOP, a link lost or found, an arm's
  handshake past its deadline, touch lost under an arm and a stalled
  render loop withhold the line until an ARM hold or the STOP reset, and
  so does any of them after the refusal.

- LIVE, SWEEP and RUDDER set the PD mini's voltage and current limit and
  show the supply's plot. A SET row under the READY rows holds
  SET V and SET A, 80 x 48px each: a tap opens SUPPLY's keypad inside its
  OUTPUT LIMITS, a value typed while the output is on asks SUPPLY's
  question where SETTINGS > KEYPAD asks it, ARMED or SAFE, a voltage
  raised past 6.0V waits for HV SERVOS ONLY, and a programming port
  holding the PD mini refuses the tap and names the hold. Right of SET A
  a 180 x 48px plot shows the volts, amps and watts of the last 9.0s on
  TEST's series and scales. On the rbmod carrier's programming port the
  row reads `PROG 5V`, `5V FIXED` and takes no tap, and the plot and the
  rail line show the INA3221 channel that watches the PROG 5V. OUTPUT ON
  stays off these screens: ARM's 2s hold switches the supply on. SPEED,
  the type pill (32px tall), the buttons and the rail line move down
  to make room: the rail line sits at y 412.
- On the rbmod carrier's programming port the rail line and the plot of
  every SERVO function screen read the PROG 5V's INA3221 channel. Without
  a window of it the line reads `PROG 5V NO READING` and `--V  --A`
  instead of the rail meter's values, which could be the PD mini's.
- LIMIT RUN's ARM + START failed with `PD MINI FAILED: SERVO SUPPLY BELOW
  3.0V OR NOT READ` when the PD mini read its output ON before the rail
  had risen, and the RAIL row read red for a frame. READ-BACK judges a
  rail read low on every window until its 1000ms are up: a rail that
  rises in that time starts the run, one still under 3.0V at 1000ms fails
  the step with every output off. The same holds for RUDDER AUTO's and
  LIMIT RUN's `PROGRAMMING: SERVO RAIL BELOW 4.8V` after PROG 5V on the
  rbmod carrier. While READ-BACK waits the row reads amber.
- SEARCH FOR IMU beside a bound sensor that holds the link read `NO IMU
  FOUND` while that sensor's row stood above it: a connected sensor does
  not advertise, so no scan lists it. The list reads `NO OTHER IMU FOUND`
  then, the IMU screen `NO OTHER SENSOR FOUND: THE BOUND ONE IS LINKED`.
- RUDDER AUTO's `LOAD HITEC015 IN FILES` or `RESTORE IN KST` stayed after
  the servo's values were put back or written otherwise on the HITEC or
  KST page, until the next run. The line names the report once a
  read or write there shows the values before the run, or values the run
  did not leave; after an end with a write's answer missing, only the
  values before the run.
- RUDDER AUTO could program the 1000us side's end point for the 2000us
  side. Trigger: the 1000us side within TOLERANCE at its first measure,
  so its register was never found by a write, and the 2000us side's first
  write tried LEFT ANGLE or LEFT END first; an angle change from the
  angle source's drift (1.4° against 0.5° expected, IMU in 6-axis mode)
  read as that side moving. The writes after it moved nothing on that side
  and the run went on to `8 writes per side reached`, LEFT END on a
  D485HW left at 6627 counts against 4726 before the run. A Hitec D
  series servo set to CW has its registers from the read: LEFT END at
  1000us, RIGHT END at 2000us. On every other servo the first write of a
  side goes to the register of the side's name, the other one with
  REVERSION (Hitec: CCW) on. Two writes in a row whose expected change
  sums to TOLERANCE or more and that do not move their side, or move it
  the wrong way, end the run as FAIL with `writes do not move the 2000us
  side` (or the 1000us side); so does a side that neither register moves
  while it is being found. The run ends with every output off, and AUTO's
  third line offers RESTORE or names the backup file.
- LIMIT RUN's and RUDDER AUTO's SERVO set to HITEC fell back to
  KST/CHASERVO after a restart and after opening the KST programmer from
  the hub; opening the HITEC programmer set it to HITEC. Both screens
  shared that one value. Each screen's SERVO changes only by a pick on
  that screen.

- A red READY row on RUDDER AUTO, LIMIT RUN, TEST, LIVE, SWEEP, RUDDER,
  KST and HITEC cut a gate text longer than its 20 cells after a whole
  word: `IMU YAW REFUSED:`, `SET ZERO WITH THE`, in German `IMU-GIEREN
  GESPERRT:`. Each such text has a tag of 20 cells or fewer in English and
  German, its own text entry, which the row shows: `YAW REFUSED`, `ZERO
  NOT SET`, `BELOW 3.0V`, `NEEDS 850-2150us` for a Hitec model's travel.
  The alert band and a tap on the row keep the whole text. One table in
  `servo_ready.c` holds the tags for every card, and
  `test_servo_ready_tags` fails on a text that can reach a row and is
  longer than 20 cells after its tag. The PORT row's port line is the PORT
  button's line of up to 25 cells, and a row still cuts it after a whole
  word: `PORT 1 GPIO 13 PWM OFF` reads `PORT 1 GPIO 13 PWM`.
- A KST or Hitec CONNECT on the rbmod carrier with an input supply of 5V
  instead of 15V did nothing and said nothing: M7 cannot make the ports'
  5V from it. CONNECT is refused with the input named while the PD mini
  reads it under 13.5V, and a 5V that does not reach 4750mV within 200ms
  after the session switches it on is an error with every output off.
- SERVO's PORT list on a board without the carrier, with the binding read
  and no output bound as SERVO PWM, offers a way to bind one: its first
  entry reads `OUTPUTS: NO PIN, OPEN OUTPUTS` and a pick opens OUTPUTS on
  the SERVO PWM protocol. The home tag there returns to the SERVO screen
  the list was opened on (LIVE, SWEEP, TEST, LIMIT RUN, RUDDER or RUDDER
  AUTO).
- A tap on LIMIT RUN's red METER row opens SETUP > SENSORS, and the home
  tag there returns to LIMIT RUN instead of the SERVO hub.
- The red METER row on LIMIT RUN and RUDDER AUTO opens SETUP > SENSORS on
  the INA3221 part whose channel watches the tester's target, such as
  0x41, instead of 0x40 every time; with no channel watching, on the first
  part fitted.
- With the IMU as ANGLE SOURCE, RUDDER AUTO, the servo test and the LIMIT
  RUN wait for the still time of the IMU axis setting alone: that axis
  within 0.5° (`IMU_STILL_DEG`) for 500ms. Roll and pitch may move while
  the run reads yaw: a pitch that creeps 1°/s while yaw holds within 0.1°
  leaves yaw's still time running, and RUDDER AUTO takes the angle instead
  of ending with `surface not still within 3s`. The settle of IMU FILTER
  above 1 is judged per axis too.

## 0.23.10 - 2026-11-08

0.23.10 is a testing release. It removes the stall before `app_main()` in
which release 0.23.9 stopped in about 1 start of 5 on the ESP32-P4 panel
(#770). Its minor number, 23, is odd. GitHub publishes it as a pre-release
and does not mark it as latest. It runs on the ESP32-P4 panel, as 0.23.9
does; an ESP32-S3 panel stays on the 0.22 line and is not offered it. The
link protocol is 4.37, as in 0.23.9. The assets are
`rcbench-panel-p4-v0.23.10.zip`, `rcbench-panel-p4-v0.23.10.bin`,
`rcbench-iomcu-v0.23.10.zip`, `rcbench-iomcu-rbmod-v0.23.10.zip`,
`rcbench-c6-2.13.0.bin`, `rcbench-c6-merged-2.13.0.bin` and `SHA256SUMS`.

A bench on 0.23.9 gets 0.23.10 over Wi-Fi: SETUP > UPDATES, RELEASES: TESTING,
CHECK FOR UPDATES, then hold the install button for 2s. With RELEASES: STABLE the
check reads `releases/latest`, which names 0.22.1, and offers nothing. At
link-up the panel offers to update the IOmcu over CAN (Controller Area Network)
when the IOmcu runs a different build. To set up a new bench, load both boards over USB
(Universal Serial Bus) as [First run, §1](docs/FirstRun.md#1-flash-both-boards)
describes.

The entries below cover the 22 pull requests merged since v0.23.9: #750 to
#771.

### Changed

- MOTOR & ESC and SUPPLY end in a common footer of three 328 x 48px
  slots at body y 444: the screen's name with the pins or source it drives
  (warning colour with none), the 2s hold (ARM / DISARM, OUTPUT ON / OFF)
  and SETTINGS. SETTINGS opens a settings list over the body, SETUP's
  category list as a shared widget (`ui_setlist`), only while the screen
  drives nothing, and the list closes when the screen goes live.
- MOTOR & ESC's SETTINGS tab and SUPPLY's LIVE | SETTINGS strip with its
  LIMITS | PD MINI tabs give way to the list: MOTOR & ESC lists the 8 ESC
  settings, SUPPLY the 9 supply settings, the PD mini's wiring under its
  heading and RESET PD MINI. A change applies at once; SAVE asks for the
  write, as on SETUP, and the home tag shows the leave warning over an
  unsaved change. RESET name resets the list's own settings only.
- ARM and OUTPUT ON / OFF move from the CONTROL card to the footer's
  middle slot, x 348 to 676. SUPPLY's plot is 78px tall; its header row
  starts at x 18. SUPPLY offers no guide page while its output is on, as
  either dock covers OUTPUT OFF.
- ESC STICK, IMU, UPDATES, LOGS, FILES, RECEIVER, BATTERY and BALANCE end
  in the footer. ESC STICK's SETTINGS lists the supply and the 12 timing
  settings in place of its TIMING page; IMU's middle slot is
  HOLD 2s: CALIBRATE and its SETTINGS opens SETUP's SENSORS list at the
  IMU entry; UPDATES' middle slot is the download's hold and its SETTINGS
  lists the reminder and the releases; LOGS' and FILES' SETTINGS open
  SETUP's SD CARD list, whose home tag returns to them. RECEIVER, BATTERY
  and BALANCE show the name alone. UPDATES' and ESC STICK's settings write
  on SAVE only.
- LOGS shows 5 files and FILES 4 rows a pane; their rows of buttons are
  48px tall at body y 388. RECEIVER's lanes are 44px, BATTERY's rows 28px,
  BALANCE's disc 128px in radius.
- A press on a locked row of a settings list names the lock in the alert
  band. The PD mini pins alert reads
  `PD mini pins rejected. Check them in SUPPLY's SETTINGS.`
- Every 2s hold flashes on the frame it completes, 300ms in phases of 50ms:
  white, black, then the button's new colour, twice. The flash starts in
  `ui_hold_tick()`, so START TEST, ARM + START, START on AUTO, the
  warnings' and programmer pages' holds, KST EXPERT MODE, HOLD 2s TO RUN,
  the ESC wire holds, UNBIND ALL PINS and OVERWRITE flash as ARM does. A
  button that goes as its hold fires flashes where it was drawn.
  `tools/check_holds.py --check` holds every `ui_hold_begin()` to its draw
  and its step in CI (continuous integration).
- Buttons take their colour from what a press does to an output: green
  available, red while it drives an output, amber while it waits, grey
  refused. CENTRE, SWEEP, the rudder's 1000us, CENTRE, 2000us and ZERO and
  the KST and Hitec programmers' CONNECT, ENABLE WRITE TO SERVO, WRITE n
  VALUES and MOVE SERVO follow it; PAUSE is red while a sweep drives.
  RESET CATEGORY, DISCARD and READ AGAIN are neutral, SAVE on SETUP green
  while values are unsaved and its NOT SAVED a red label on a neutral
  button, LOGS' OPEN and PLOT neutral, DELETE on FILES and LOGS neutral
  with a red label (docs/Screens.md, "Button colours").
- A tap on a grey START TEST, HOLD 2s: ARM + START or HOLD 2s TO START on AUTO
  puts its reason in the alert band for 4s, as a hold's hint.
- SERVO opens on a hub of 8 tiles of 328 x 130px in SETUP's grid: LIVE,
  SWEEP, TEST, LIMIT RUN, RUDDER, RUDDER AUTO, KST and HITEC. Each opens a
  function screen of its own; KST and HITEC are grey with the reason while
  the IOmcu lacks the capability or another session holds the port. The
  strip LIVE | TEST | PROGRAM | RUDDER | SETTINGS, PROGRAM's list and
  RUDDER's AUTO | MANUAL button give way to the tiles. The home tag goes
  from a function screen to the hub and from the hub to the menu.
- The hub's footer holds SERVO with the port line and SETTINGS, which opens
  the servo profile every function uses: OUTPUT (type, rate, pulses, trim,
  travel, reverse, HV) and DUT (name, report). It opens at any time. Each
  function screen's footer holds its name with the port line, ARM / DISARM
  and SETTINGS for that function's list, which opens only while SAFE:
  SWEEP's curve, TEST's and LIMIT RUN's run settings, RUDDER's LENGTH and
  ENC CENTRE, RUDDER AUTO's and HITEC's lists, KST's EXPERT MODE page.
  LIVE has no list.
- The output card's TARGET row gives way to the PORT button, 380 x 48px at
  the card's top: a tap opens OUTPUTS and PROG PORT 1, PROG PORT 2,
  PROG PORT 3 and PROG PORT 4 over the left card, and a pick sets SERVO
  TESTER. It opens nothing while
  ARMED, while ARM is asked, or while a programmer holds the port, and the
  alert band names the lock.
- No SERVO list or page of rows opens while a programmer session holds its
  port or a finger is still on another control of the screen
  (`A finger is still on another control. Lift it first.`), and a page of
  rows closes as the bench goes live. The run card's SETTINGS follows the
  footer's rule and is grey while it refuses. The PORT list takes no open
  and no pick while a finger holds another press.
- A PROG 5V switched on in SERVO's box stays on from one SERVO screen to
  another and goes off when SERVO is left; the hub's footer reads
  `PROG 5V ON` in the warning colour while it is on. Every leave of a
  function screen switches the bench to SAFE. SERVO offers no guide page
  while ARMED, as either dock covers part of DISARM.
- A limit run or a RUDDER AUTO run that wrote names `RESTORE IN KST` in
  place of `RESTORE IN PROGRAM`. The KST programmer's hint on the standard
  outputs reads `Tap PORT and pick a PROG PORT.`
- RUDDER AUTO has a READY card in the output card's place, 380 x 374px:
  one 30px row for each check of the start gate (PORT, SERVO, METER,
  ANGLE, ZERO, RANGE, PROGRAMMER, the supply, PORT PWM, ARM) and the
  meter's volts and amps under them. A row is green when met, amber when
  the hold does it, red when any of its texts refuses the hold, grey while
  it waits on PORT. The PD mini's output off is amber only while the rail
  reads under 3.0V; a rail fed from elsewhere keeps the row red. With
  the PD mini off and a set point past 6.0V the row is red with
  `TAP: HV WARNING`: the hold switches nothing, and a tap on the row opens
  OUTPUT ON's HV warning. A tap on PORT, SERVO, METER, ANGLE or ZERO takes its fix; a tap on
  another red row names it in the alert band.
- RUDDER AUTO's start is the footer's `HOLD 2s: ARM + START`. It switches
  PORT PWM on, then PROG 5V on the carrier or the PD mini where it feeds
  the servo, waits up to 1000ms for the read-back and an INA3221 window
  begun after it, arms, waits up to 500ms for ARMED and starts the run on
  the settings as they read when the hold fired
  (`shared/servo/servo_start_seq.c`). A part or ARMED that reads back only
  after its time fails the step. A failed step switches every output off
  and the alert band names the step of the failing part, for example
  `PROG 5V FAILED: NO READ-BACK IN 1000ms`. A press on the hold during the
  steps ends them the same way, whatever is open over the screen; the left
  card's rows take no press meanwhile. The START button on the left card is
  gone.
- While a finger holds ARM + START, and while its steps run, PORT opens
  nothing and takes no pick, and TARGET, PORT PWM and SETTINGS are locked.
  While any of SERVO's holds has its finger down, the READY card takes no
  tap.
- LIMIT RUN is on the function frame. The left card holds the mode line,
  the output line, LOW END and HIGH END in 295 x 96px cells with the ends
  the last run found first, and the state lines from y 178, 24px apart.
  The READY card in the output card's place has nine rows from
  `lim_blocked()`'s checks: PORT, SERVO, METER, RAIL, RANGE, PROGRAMMER,
  the supply, PORT PWM and ARM, each text on exactly one row. A rail under
  3.0V is amber while SAFE where the hold's supply feeds it.
- LIMIT RUN's start is the footer's `HOLD 2s: ARM + START`, RUDDER AUTO's
  start sequence: PORT PWM, PROG 5V or the PD mini, the read-back in
  1000ms, ARM in 500ms, the run on the settings as they read when the hold
  fired. A row that turns red under the finger drops the hold. After the
  run's last command the bench switches to SAFE; the PROG 5V stays on.
  START LIMIT RUN and the run's box under the card are gone.
- LIMIT RUN's SETTINGS opens a list: MODE, SERVO, SERVO PULSES and the
  programmer's Programming voltage, Programming current and Wait before
  PWM. MODE, SERVO and SERVO PULSES are locked off a PROG PORT with
  `On a PROG PORT only: choose one with PORT`.
- TEST starts from the footer's `HOLD 2s: ARM + START` on the same
  sequence: from SAFE it switches PORT PWM on where the port needs it, arms,
  waits up to 500ms for ARMED and starts the automatic test on the settings
  as they read when the hold fired. The run's steps switch the PD mini at
  each step's voltage. During the run the slot reads STOP TEST and ends the
  run on its press. Every end of a run, PASS included, switches the bench to
  SAFE. START TEST and SETTINGS on the left card are gone; the plot moves
  to the left card under SUPPLY's caps.
- TEST has a READY card in the output card's place: PORT, METER, PD MINI,
  STEPS, RANGE and ARM. A PD mini off while the INA3221 reads 3.0V or more
  on the rail refuses the hold, `RAIL LIVE WITH THE PD MINI OFF: FED FROM
  ELSEWHERE`. A step past 6.0V turns the hold into a tap that opens HV
  SERVOS ONLY, whose 2s hold arms and starts.
- TEST's SETTINGS is one list of 17 rows under four headings, VOLTAGE
  STEPS, BROWN-OUT, PASS/FAIL LIMITS and LENGTH AND TIMING, in place of the
  automatic test's page of rows and the brown-out walk's page. Each
  heading's line names what its rows give; the BROWN-OUT line names the
  walk with its count, `From 5.00V down in 0.20V steps to 3.30V, 10
  voltages`. Step 7.4V and Step 8.4V take no press with HV SERVO off, Test
  time none by MOVES, Movements none by TIME. The list writes only on SAVE;
  DISCARD puts the stored values back.
- LIVE, SWEEP and RUDDER show READY rows in the output card's place:
  PORT, SUPPLY and ARM, and on RUDDER ANGLE and ZERO between PORT and
  SUPPLY. SPEED, the type pill and the buttons sit under the rows (CENTRE
  and RELEASE on LIVE, SWEEP and RELEASE on SWEEP), the rail line with the
  meter's volts and amps at y 404. The SET row, the plot and the PROG 5V
  box leave these screens.
- ARM on LIVE, SWEEP and RUDDER switches on what reads off before it arms:
  PORT PWM on a programming port, then PROG 5V on the carrier or the PD
  mini's output, through the steps of RUDDER AUTO's start (read-back
  within 1000ms, ARMED within 500ms). Its hint reads
  `Hold 2s: the port and its supply go on, then ARM.` and it flashes 300ms
  as it fires. ARM leaves the PD mini off past 6.0V, where the red SUPPLY
  row opens OUTPUT ON's HV warning on a tap, and beside a rail an INA3221
  reads at 3.0V or more with the PD mini off. DISARM, STOP and a failed step
  switch every output off; PROG 5V stays on between SERVO screens.
- The rail line under a READY card reads SIMULATED after the meter's name
  while the panel's model is the supply.
- The KST and HITEC sessions have no CLOSE; their tab row runs the session's
  full width, five tabs of 120px. The home tag is the way back: an editor
  closes first, a held port asks for LEAVE, and a session that holds no
  port ends and the screen goes to the hub.
- KST and HITEC show a READY card in the output card's place: PORT, the
  supply CONNECT switches (PROG 5V, PD MINI or SUPPLY) and SERVO, the servo
  read, with the rail line under them. A tap on PORT opens the PORT list,
  locked while the session holds the port; a tap on the supply row while
  it reads ON switches it off, as OUTPUT OFF does, also under a panel over
  the left card; a tap on another row not met names it in the alert band. The output card's SET row, SPEED,
  CENTRE, SWEEP, RELEASE and the PROG 5V box are gone from both screens.
  No SERVO function screen shows the output card.
- The footer's middle slot on KST and HITEC is the session's WRITE n
  VALUES, from any tab, in place of ARM: the same tap as the session's own
  button, grey and naming why before CONNECT and the read, with no value
  changed, while a step runs and while a page is open. A finger on a READY
  row or on WRITE keeps SETTINGS and the PORT list shut.

- The panel sets the Bluetooth IMU's output content register RSW (0x02) to
  0x0C: angle (0x53) and angular rate with the battery (0x52), 2 frames a
  sample in place of the 4 of the sensor's default 0x1E. It writes unlock,
  RSW 0x0C and SAVE once on a connection whose first 8 good frames show
  other types; a sensor that already sends 0x52 and 0x53 only gets no
  write. On one panel the BLE link carried about 570 frames/s (6.3kB/s):
  4 frames a sample overflow it above about 140Hz, 2 frames a sample leave
  room for about 285Hz. The sensor stores RSW, so another device reading it
  afterwards gets 0x52 and 0x53 only until the sensor's app sets RSW back
  ([IMU](docs/IMU.md#the-sensor)).
- Carrier rev 1 rework item 3 is a 5.6V zener of 2W or 5W, for example
  SMBJ5339B-TP (5.6V 5W, SMB package), in place of a 1W one: its dynamic
  impedance is about 1Ω against about 5Ω (typical datasheet values), so
  its clamp stays lower at higher back-feed
  ([Carrier, Rev 1 rework](docs/Carrier.md#rev-1-rework)).

- A further finger on a stop control acts on its press whatever other
  fingers rest on the glass: SUPPLY's OUTPUT OFF and PROG 5V OFF, the
  Hitec programmer's MOVE SERVO ON and the searching FIND STOP key, and the
  supply row of the SERVO screens' READY card. A held tap on a control
  that a stop ended starts nothing on its release. A slider, the SERVO
  dial and SPEED follow only the finger that started the drag; a second
  finger sets SPEED while the first drags the dial.

### Fixed

- The panel starts without the stall before `app_main()` that 0.23.9
  showed in about 1 start of 5: core 0 hung on a store or load in internal
  memory while core 1 read `port_xSchedulerRunning[0]` back to back in
  ESP-IDF's wait for the scheduler, and the watchdog reset the chip after
  10s or the start ended in a store access fault. The build patches that
  wait to one read about every 10us (`firmware/panel/core1_wait.cmake`):
  0 stalls in 60 starts against the release's 11 in 60 in the same hour.
- The steps of ARM and of START on the SERVO screens start with a
  FAILSAFE CLEAR step of up to 500ms while the IOmcu's failsafe is latched
  (`FAULT 01`) and the bench is SAFE. A latched failsafe made the IOmcu
  refuse the supply step, and the steps ended in a read-back timeout. A
  failsafe still latched after the step ends the steps at once with its
  reason in the band.
- UPDATES' release pane says `Waiting for the C6 radio update to finish.`
  while the C6 radio update runs. It said
  `Waiting for the IOmcu update to finish.` for both updates.
- A servo report's current cells print the whole mA as an int. gcc 14.2 on
  aarch64 failed `tools/render_ui.py`'s `-Werror` build with a
  format-truncation warning on the `%ld` text.
- On the rbmod carrier PORT PWM ON on OUTPUTS > PROG PORT n is taken while
  PROG 5V reads OFF. The tap did nothing, and leaving SERVO switches off
  a PROG 5V that SERVO switched on, so PORT PWM could not be switched on
  at all. The pulse still waits for PROG 5V to read ON and comes on only
  while SAFE. The line under the rows reads
  `PORT PWM ON: ARM ON SERVO SWITCHES PROG 5V AND PULSES ON`.
- RUDDER AUTO and START LIMIT RUN with PORT PWM off say what to do:
  `PORT PWM OFF: SWITCH IT ON IN OUTPUTS` while SAFE and
  `PORT PWM OFF: DISARM, SWITCH IT ON IN OUTPUTS` while ARMED. The line
  read `PORT PWM OFF. NO PULSES ON THIS PORT.`, also with PORT PWM on and
  the pulse waiting: that case reads
  `PORT PWM ON, WAITING FOR SAFE: DISARM, THEN ARM` on every board, or
  `PROG 5V OFF: START SWITCHES IT ON` on the carrier with PROG 5V off.
- RUDDER AUTO and START LIMIT RUN name a programmer session that holds
  the port, `LOCKED: SERVO PROGRAMMING USES THE PORT`, before PORT PWM.
  They read `PORT PWM OFF. NO PULSES ON THIS PORT.` while the session held
  it.
- On the rbmod carrier OUTPUT's note in SERVO's settings reads
  `PROG 5V OFF: ARM SWITCHES IT ON` with PORT PWM on and PROG 5V off, and
  the READY card of TEST, RUDDER AUTO and LIMIT RUN reads
  `PROG 5V OFF: START SWITCHES IT ON`. Both named the PROG 5V box, which
  only SUPPLY shows.
- A limit run that ends as FAIL, `900-2100 NOT IN 1000-2000us` among
  them, switches the PD mini's output and the rbmod carrier's PROG 5V off
  once its LEAVE gave the port back, and leaves the bench SAFE. RUDDER
  AUTO's read that finds no servo does the same. Both left the supply on.
- LIMIT RUN's and RUDDER AUTO's ARM row reads SAFE while a session of the
  programmer holds the bench SAFE, as the band does. It read ARMED for the
  whole run.
- The start steps' failure band, `PD MINI FAILED: STOP` among them, goes
  when its SERVO screen is left. It stayed on the next screen for up to
  30s.
- The hub's TEST tile names the steps a run takes, `4.8-6.0V, BROWN-OUT`
  with HV SERVO off. It read `4.8V TO 8.4V, BROWN-OUT` whatever the
  settings.
- On SUPPLY, OUTPUT OFF pressed by a second finger ends the first finger's
  drag on a set point's track: its later moves and its lift change
  nothing. The lift set the point after the output was off.

## 0.23.9 - 2026-11-06

0.23.9 is a testing release. Its minor number, 23, is odd. GitHub
publishes it as a pre-release and does not mark it as latest. It runs on the
ESP32-P4 panel, as 0.23.8 does; an ESP32-S3 panel stays on the 0.22 line and
is not offered it. The link protocol is 4.37; 0.23.8 has 4.36. The assets are
`rcbench-panel-p4-v0.23.9.zip`, `rcbench-panel-p4-v0.23.9.bin`,
`rcbench-iomcu-v0.23.9.zip`, `rcbench-iomcu-rbmod-v0.23.9.zip`,
`rcbench-c6-2.13.0.bin`, `rcbench-c6-merged-2.13.0.bin` and `SHA256SUMS`.

A bench on 0.23.8 gets 0.23.9 over Wi-Fi: SETUP > UPDATES, RELEASES: TESTING,
CHECK FOR UPDATES, then hold the install button for 2s. With RELEASES: STABLE the
check reads `releases/latest`, which names 0.22.1, and offers nothing. At
link-up the panel offers to update the IOmcu over CAN (Controller Area Network)
when the IOmcu runs a different build. To set up a new bench, load both boards over USB
(Universal Serial Bus) as [First run, §1](docs/FirstRun.md#1-flash-both-boards)
describes. The IMU (inertial measurement unit) is read over Bluetooth LE (Low
Energy) in place of an HC-05; an HC-05 binding is not carried over, so scan
and bind the sensor once on SETUP > SENSORS > IMU.

The entries below cover the 14 pull requests merged since v0.23.8: #734 to
#747.

### Added

- IMU filter (SETUP > SENSORS > IMU, key `imu_filter`): a low-pass on the
  IMU's angle, per angle frame and axis, deg += (new - deg) / k with k 1 to
  50, default 1 (no filtering). It covers 63% of a step in about k frames:
  at 10Hz IMU filter 10 takes about 1s. The first frame after a connect, a
  reconnect, a bind or a stale reading seeds it; the difference is wrapped
  at ±180°. The IMU screen, RUDDER, AUTO and the servo runs read the
  filtered angle. The IMU's still time reads 0 until the filtered angle
  lies within 0.05° of the sensor's (`IMU_SETTLE_DEG`), and AUTO waits
  3000ms plus the filter's longest settle (`imu_filter_settle_ms()`,
  11,700ms for IMU filter 10 at 10Hz) before NOT STILL. Host-tested by
  `test_imu_filter` and `test_servo_rauto_filter`.
- Bluetooth LE host on the panel: NimBLE on the P4, the controller on the
  ESP32-C6, HCI over the existing SDIO link (esp_hosted 2.13.0, VHCI).
  `main/panel_ble.c` starts it on the task `blestart`: the C6's link, the
  controller init and enable requests for a C6 that reports 2.5.2 or later
  (the board's C6 reports none and runs its controller without them; it
  gets them only after a missing sync), the host task `nimble_host` and the
  wait of 3,000ms for its sync, logged as `ble: synced in <n>ms` or `ble: no sync within
  3000ms`. Its events go to a queue of 32 x 64 bytes. The first IMU ON
  starts it; the console build's `ble scan` starts it too and prints every
  report of a 10,000ms scan.
- `protocols/bleuart`: a BLE (Bluetooth Low Energy) central for the ISSC
  Transparent UART service of the BWT901CL, without radio code. It parses
  advertising reports into a scan list of 8 devices, connects to the bound
  address, discovers the service, subscribes to 1E4D, reads 6DAA once,
  writes commands on 8841 and reconnects 1000ms after a failure or drop.
  Host-tested by `test_bleuart`, `test_bleuart_link` and
  `test_bleuart_adv`.
- Browser test of the Wi-Fi page's file manager. `test/host/wa_page_dump.c`
  writes the page `wa_page_main()` builds, and `test/host/wa_mock_server.py`
  serves it with a mock of the file API, its refusals and its request guard.
  `test/web/files.spec.ts` runs 18 tests in Chromium in English and German:
  paging through 49 entries, the highlight classes of a report against
  `text_hl_line()`, an edit and save, the 412 round trip with the unsaved
  question, upload, rename, move and delete, and the write buttons while
  writes are closed. The CI job is `Web file manager browser test`.
- The IOmcu console prints the boot ROM's record of each start after its
  reset line: `rcbench-iomcu: boot type NORMAL partition 1 source slot 0
  diagnostic 0x00010355`. It names the boot type, the partition booted, what
  the diagnostic word describes and the word, read through
  `rom_get_boot_info()`. After `picotool reboot -a -g 0` the word shows
  which steps slots A and B passed. Both boards, rp2350_can and rbmod.
- The screen guide covers OUTPUTS and SETUP. "?" opens pages for each
  state: SETUP's tiles, a list and SENSORS (2 pages each); OUTPUTS' board
  view and a PROG PORT entry (2 pages each) and its grid view (1 page). They
  mark up to 5 controls a page and all show while ARMED, since neither
  screen drives an output. An open list, a keypad, a keyboard or the
  warning on leaving SETUP has no guide.
- The screen guide covers LOGS and FILES: LOGS' file list and import view
  (2 pages each) and its plot (1 page), FILES' panes (3 pages). The DELETE
  question, a box, a keyboard and the text viewer have no guide.
- MOVE SERVO on the Hitec programmer's TRAVEL tab moves a D series
  servo's horn to the NEUTRAL, LEFT END or RIGHT END being edited, inside
  the held session, while the bench stays SAFE. A 2s hold switches it on,
  with a PD mini answering with its output on and DIRECTION CW; it is
  refused on the rbmod carrier's fixed 5V. The three positions get `-`
  and `+` keys of 8 counts with repeat. Each pass writes target 0x1E and
  reads position 0x0C, 150 counts at most a pass, inside the reach of the
  stored ends. A lag over 150 counts on 2 passes, 80% of the current
  limit for 400ms or an AS5600 angle that does not follow moves the horn
  back 75 counts. The end writes 0x1E = 3000, restarts the servo and
  holds 16 registers against the start; nothing is saved. STOP, a switch
  to SAFE at the bench, a lost link, the supply off and a failed read end
  it at once with every output off. The thresholds and the target-to-pulse
  model are not measured.
- FIND STOP, in DIRECTION's row while MOVE SERVO runs, searches for the
  mechanical stop of one side: the horn goes to NEUTRAL, then 37 counts
  outward every 2 passes up to the reach's edge, for 40s at most. A bind
  sets LEFT END or RIGHT END in the draft 75 counts inside the stop;
  nothing is written. The search's step, cap and the stop found are not
  measured.
- Host tests of the Hitec line's RP2350 driver and of the end of a LISTEN's
  answer. `test/host/test_hitec_line.c` (13 cases) runs
  `protocols/hitec/rp2350/hitec_line.c` on a fake of the pico-sdk: a
  transaction past its time and every abort stop the state machine, let the
  receive channel take the FIFO and count the bytes before the restart, so a
  byte pushed before the stop reaches the capture and none reaches the next
  transaction. `test/host/test_hitec_pio_answer.c` (3 cases) holds the
  receiver back 1 state machine cycle after the answer's 10th bit time, not
  after the 16 bit times of the answer word.
- KST EXPERT MODE, a row of SERVO > SETTINGS > DUT, OFF by default and kept
  across restarts: ON after a 2s hold, OFF with a tap. With it OFF the KST
  and Chaservo programmer hides DEAD BAND, BOOST and STRETCH on TUNE,
  RELEASE PAIRING in MORE and the LOCKED tab; TUNE closes up and the tab
  strip holds 4 tabs. A file load and a RESTORE still write the whole
  image: the write page, CHECK THIS FILE and the restore's page name each
  hidden value that changes, first and in the warning colour.
- SETUP > PANEL > Hardware stop, OFF by default, for a bench with a stop
  button in the heartbeat line. ON, the band shows the heartbeat bit as a red
  HWSTOP chip in place of FAULT 10, with a help box that names the pressed
  button or a broken cable and how to clear it. While the chip stands the
  panel reads STATUS at every 50ms poll, not every 500ms, so the chip goes
  80 to about 180ms after the line closes, with no ARM. What the bench does
  on the bit is unchanged; OFF, the band and the reads are as before.
- The C6 radio's update. CI and the release build esp_hosted 2.13.0's
  co-processor firmware for the board's ESP32-C6 from the component the
  panel pins (`.github/workflows/c6.yml`, `tools/c6_image.py`,
  `firmware/c6/dependencies.lock`); the release publishes
  `rcbench-c6-2.13.0.bin` (1,283,616 bytes) and
  `rcbench-c6-merged-2.13.0.bin` with SHA256SUMS lines, and the panel image
  carries the first (`RCBENCH_C6_BIN`, 1,284,272 bytes of flash). SETUP >
  UPDATES gets a C6 RADIO row: the C6's version or `not reported`, the
  carried one, and a 2s hold that sends the image over SDIO at SAFE only,
  with a limit on each step, the old firmware kept on every failure, and a
  restart of the panel after a success. ARM is refused while it runs.
  docs/Building.md gives the recovery over header H4.
- SUPPLY and SERVO have screen guides. "?" in the band opens them, as on
  the menu. SERVO has a page or two for each task, LIVE, TEST, PROGRAM,
  RUDDER with and without AUTO's box and SETTINGS' OUTPUT, SWEEP and DUT,
  then two pages for the output card: 12 pages, 47 items. SUPPLY has a
  page for LIVE, LIMITS and PD MINI and a second for LIMITS' trips, then
  two for the readings and the CONTROL card: 6 pages, 25 items. While
  ARMED only the output card's and the rail's pages show. A page whose dock
  would cover OUTPUT OFF is left out while the supply's output is on, and
  SERVO offers no page while a test, a limit run or AUTO runs, so STOP TEST
  and STOP RUN stay in view. A guide item can put its badge in the
  control's top-right corner (`UI_HELP_AT_RIGHT`).

### Changed

- ESC profiles carry an optional `family_de`, the family text in German. The
  ESC STICK crumb, model rows and manual-step pop-ups show it in German and
  show `family` in English and where a profile has none. 36 of the 72
  profiles of record give one, for example `Zählmenü mit 8 Punkten` for
  `8-item count menu`; a family of names and terms only (`brushed`,
  `sensorless`, `ESC`) has none. `tools/gen_esc_profiles.py` and the card
  reader accept 1 to 120 bytes of UTF-8, and `family_de` is held to the
  unit rule of `tools/check_units.py`.
- The link protocol is 4.37. The panel numbers its requests to a 4.37
  IOmcu and sends a request once more when its answer has not come within
  50ms. The IOmcu answers the repeat from its copy of the first answer and
  does not act on it again. A lost answer costs about 50ms, latches no
  `FAULT 01` and keeps the link up. In 0.23.8 it cost the 1000ms timeout,
  the IOmcu latched `FAULT 01` after 200ms of silence, and the link went
  down. ACTIVATE, the update transfer and a request whose wait saw a STOP
  are not repeated. A second loss of the same request ends at the 1000ms
  timeout. The console report and the card's log line count the recovered
  answers as `retried`. An IOmcu older than 4.37 gets unnumbered requests
  and no repeat.
- The bus-fault screen follows the link while it shows. Its counters move
  instead of freezing at the moment it opened. Once the IOmcu has answered
  every poll for 1000ms, the bar reads `LINK BACK` and the hold reads
  `HOLD 2s TO RECONNECT`: it opens the menu on the live bench, SAFE. One poll
  without an answer withdraws it, and the hold is the acknowledgement into
  simulation again. The start-up test's screen offers RECONNECT on the same
  condition. RECONNECT clears no STOP and no fault code; FAULT 01 clears at
  the next ARM. On the station, an IOmcu back from a 12 to 16s BOOTSEL stay
  left the screen showing a frozen snapshot until a panel restart.
- The bus-fault screen's holds show their hint on a release before 2s:
  `Hold 2s to acknowledge.` or `Hold 2s to reconnect.`, amber in place of
  the bar for 4s. The screen has no band to show it on.
- The IMU's angles show two decimals: the IMU screen's X, Y and Z, RUDDER's
  DEFLECTION and MAX with ANGLE SOURCE IMU, SERVO's MEASURED and AUTO's
  `surface binds at x°`. The servo runs' reading carries the IMU's degrees
  beside its AS5600 counts (`servo_test_enc_t` `exact` and `deg`), so
  RUDDER, AUTO, the LIMIT RUN and MEASURED no longer read it in 0.088°
  steps. RUDDER draws a reading of 100.00° or more in the 20 x 36 face.
  The AS5600's readings stay in tenths.
- The Bluetooth IMU reads the WitMotion BWT901CL over Bluetooth LE through
  the board's ESP32-C6, in place of an HC-05 on UART1. The first IMU ON
  starts Bluetooth LE. SCAN FOR SENSORS scans for 10s and lists the
  devices that advertise 0x18F0 or the ISSC UART service, with name,
  address and RSSI, and counts the others as hidden; a tap binds a sensor
  without pairing, and the panel connects to it and again 1s after a drop.
  A connect asks interval 30 to 50ms, latency 0 and supervision timeout
  4s with a 30ms-in-60ms connect scan; a failed connect, HCI 0x3E among
  them, is retried after 7s. Each try logs its values, the last report's
  RSSI and NimBLE's connection record. The console build's `ble
  controller` sends the C6's controller init and enable requests again.
  SETUP keeps the address with its type under the new key `imu_ble`. An
  HC-05 binding is not carried over; scan and bind once. The first start
  erases the HC-05's key `imu_addr` from nvs. The IMU screen and SETUP >
  SENSORS > IMU show STARTING BLUETOOTH, NO BLUETOOTH ON C6, C6 FAILED:
  RESTART, CONNECTING and the errors of the link, of a refused command
  write and of the scan, and the C6's version in place of the HC-05's.
  A failed command write, IMU OFF with one in flight among them, drops the
  rest of its group; a calibration's exit, a RATE or an ALGORITHM in it
  goes again at the next connection. CONNECT TO ANY SENSOR is gone. The panel no longer builds
  `protocols/hc05`; IO4, IO5 and IO29 of header P3 are free. The `imu`
  task's stack is 4,096 bytes.
- The panel's link to the ESP32-C6 is the component `c6_link`, one mutex
  around its reset and start, for Wi-Fi and Bluetooth LE alike. Wi-Fi works
  as before. Its console lines carry the tag `c6`: `c6: C6: esp_hosted
  firmware ...`, `c6: C6: firmware version not reported ...` and `c6: C6
  link failed: C6 held in reset, Wi-Fi and Bluetooth are off until the
  panel restarts`.
- The IMU controller is three parts. `shared/ui/imu_sensor.c` holds the
  sensor's side without a radio: the reading, the outbox of WitMotion
  commands, the calibration, the RATE and ALGORITHM writes, the gaps and the
  handout to SERVO. `shared/ui/imu_ble.c` holds the Bluetooth LE link and
  converts its devices, errors and version into the view's types
  (`imu_dev_t`, `imu_err_t`). `shared/ui/imu_ctl.c` joins the two. The IMU screen, SETUP >
  SENSORS > IMU and the servo runs behave as before. `test_imu_sensor` tests
  the sensor's side alone.

### Fixed

- The KST programmer's lines, titles and button labels hold 233 bytes, two
  rows of 58 cells at 2 bytes a cell and the terminator, in place of 96 and
  of 40 and 64. The German refusal of a latched failsafe on the SERVO tab
  (103 bytes) showed cut at 95 bytes. A host test holds every text the
  overlay copies to its buffer, in both languages.
- The German HWSTOP box says what the 80 to 180ms count from:
  `HWSTOP verschwindet 80 bis 180ms, nachdem die Leitung schließt.`
- SETUP's screen guide names the IMU as the panel's, read over Bluetooth LE
  through the ESP32-C6. The SENSORS entry of the IMU said the IOmcu reads
  it, the SENSORS tile listed the IMU among what the IOmcu reads, and the
  IMU tile named an HC-05.
- ESC STICK's crumb shows a family whole, as its whole words and ` ..`,
  or not at all. The German crumb of XC-12-Lite read
  `(XController Lit..`.
- PROG 5V OFF on SERVO and SUPPLY takes a press under the alert band and
  a chip's help box while the ports' 5V reads ON, as OUTPUT OFF does. The
  screen guide leaves out every page whose dock would cover it.
- On the rbmod carrier with TARGET on a programming port, START of AUTO
  on RUDDER and START LIMIT RUN no longer stay grey after the lines are
  followed in their order. The port's pulse needs the PROG 5V and comes on
  only while SAFE. While SAFE with the PROG 5V box off both read
  `PROG 5V OFF: SWITCH IT ON IN THE PROG 5V BOX` before `ARM FIRST`. ARMED
  with PORT PWM on and the pulse still off, as after a PROG 5V switched on
  while ARMED, both read `PORT PWM ON, WAITING FOR SAFE: DISARM, THEN ARM`
  in place of `PORT PWM OFF. NO PULSES ON THIS PORT.`
- On the rbmod carrier, AUTO on RUDDER and the LIMIT RUN name the
  tester's target before the INA3221. With TARGET on the bench's outputs
  and no output bound as SERVO PWM no channel watches the target, since
  each channel watches a rail; both read
  `INA3221 NOT SET UP TO MEASURE SERVO SUPPLY CURRENT` there. AUTO now
  reads `AUTO PROGRAMS A SERVO ON THE PROG PORT` and the LIMIT RUN
  `NO SERVO PWM PIN`. On every board TARGET on the outputs comes before the
  meter: AUTO names the programming port, the LIMIT RUN `NO SERVO PWM PIN`
  or `PINS NOT READ`.
- The IOmcu's firmware update cannot erase or program flash below 0x2000,
  the boot ROM's boot slots 0 and 1 that hold the partition table. The
  flash calls of the update refused only ranges past the store before. No
  update wrote there; an erase of the table would leave the IOmcu in
  BOOTSEL until a USB load of the install UF2.
- SETUP's lists clip their rows inside the clip they are drawn with. With
  the screen guide open on a list, the rows drew under the dock.
- RESTORE of a Hitec session's backup asks the operator to confirm the
  unit where the bench cannot check it. A second servo of one model, put
  on the port without LEAVE or CONNECT, could get the first one's backup
  when its registers held the first one's last-read values. A D series
  servo has no serial register, and a classic one with a non-digit serial
  cell holds none. For both the RESTORE page says `The bench cannot check
  that this is the servo the backup came from. Hold only if it is.`, names
  the model with its ID 0x32 or `no serial` and the backup's age, and its
  2s hold confirms the unit. A classic servo with the backup's serial,
  cells 0x80 to 0x86, restores as before. The write's second read reads
  that serial again, 43 cells instead of 36, so a servo swapped after the
  last READ ALL ends the write before a step.
- A bidirectional DShot pin that sends no frames is driven low: from the
  bind to the first frame, and at SAFE, STOP, an error, a lost link and the
  failsafe edge until the next ARM. It rested high on its pull-up, the
  bootloader entry condition of family S (BLHeli_S), Bluejay and AM32 ESCs.
  On ARM the IOmcu releases the line to its high idle and sends the first
  frame 1000µs later, one frame period at 1kHz; the extended telemetry ask
  keeps its 10 frames. A pin held by the ESC signal wire session is not
  driven low. Plain DShot also sets its PIO latch to 0 before the pad is
  handed to the block, so a latch another program left at 1 shows no high
  between the bind and the first frame. What an ESC does after the low rest
  is not measured.

- SERVO's own repaints, the SET row, the rail's plot, ARM and RUDDER's
  readout among them, stay inside the screen guide's live half. They drew
  over the dock, on RUDDER's guide page with each new angle reading.
- SERVO > TEST, SERVO > PROGRAM and the SERVO settings pages no longer repaint
  the whole screen when the arm moves or the AS5600 angle changes in its
  tenths. None of these pages shows either value. The station measured 15.1
  to 23.8fps on SERVO > TEST during an automatic test, during a LIMIT RUN and
  while SAFE with a weak magnet, with DRAW peaks of 58ms. In the host frame
  model the TEST page with a moving arm and a new reading in every frame
  costs 0 cache-line fills, against 30,731 before. CI holds the new
  `servo-test` mode to 1,000.
- The ESC STICK crumb names the Dualsky XController profile's model
  `XController`. It read `XController (model not named in the programming
  sheet)` in both languages. The Hacker X-Pro (January 2006 edition)
  profile's model reads `X-Pro (BEC, Opto)`. It read `X-Pro series (BEC and
  Opto versions)` in both languages.
- STATUS.md's open item on screens that do not name the output they drive
  lists the one case left: a programming port held after SERVO is left.
  ARM names its roles, and the programmers name their port and pin.
- A refused ARM returns MOTOR & ESC and SERVO to SAFE at once. The screen
  no longer stays on ARMING with TARGET, Idle pulse, Full pulse and ARM
  locked until STOP or leaving the screen. Every refusal counts: a
  programmer on the port, a servo release or rate not taken, the pulse
  endpoints owed, the arm's deadline, the line never trusted, a STOP that
  stands, and a NACK (negative acknowledgement) of CLEAR or of the arming
  frame from the IOmcu. The band's alert still says why. Each ARM carries a
  32-bit stamp, and a refusal reaches only the ask still waiting under its
  stamp: one that arrives after a DISARM, after a STOP, behind a newer ARM or
  for an ARM asked on the other screen changes nothing. A refusal moves no
  STOP latch and arms nothing.
- The IMU screen no longer repaints whole for every angle frame or for every
  frame of the 2s hold on HOLD 2s: CALIBRATE ACCELEROMETER. A reading
  repaints the card lines that read differently, and the hold its button and
  the age on the RATE line. In the host frame model an angle frame in every
  frame costs 101 cache-line fills, against 31,247 before, and the hold 690,
  against 31,243. CI holds the new `imu` and `imu-hold` modes to 1,000.
- The KST and Hitec sessions on SERVO > PROGRAM no longer repaint for a PD
  mini reading their state line does not show: with the port in PWM the
  line shows the set point, and in programming the reading in 10mV and 1mA.
  In the host frame model a reading 3mV and 1mA off the one before in every
  frame costs 0 cache-line fills on either session, against 16,860 (KST) and
  16,246 (Hitec) before. CI holds the new `servo-kst` and `servo-hitec`
  modes to 1,000.
- WI-FI no longer repaints whole once a second while the idle time counts
  down. The page shows the idle time in whole minutes and repaints when the
  minute changes. In the host frame model an idle second in every frame costs 0
  cache-line fills, against 20,331 before. CI holds the new `wifi-idle`
  mode to 1,000.
- SUPPLY no longer repaints the PLOT and TABLE tabs and its heading row for
  every sample. They repaint when the supply starts or stops answering. In
  the host frame model a sample in every frame costs 8,138 cache-line fills,
  against 9,692 before.

## 0.23.8 - 2026-11-05

0.23.8 is a testing release. Its minor number, 23, is odd. GitHub
publishes it as a pre-release and does not mark it as latest. It runs on the
ESP32-P4 panel, as 0.23.7 does; an ESP32-S3 panel stays on the 0.22 line and
is not offered it. The link protocol is 4.36, as in 0.23.7. The assets are
`rcbench-panel-p4-v0.23.8.zip`, `rcbench-panel-p4-v0.23.8.bin`,
`rcbench-iomcu-v0.23.8.zip`, `rcbench-iomcu-rbmod-v0.23.8.zip` and
`SHA256SUMS`.

A bench on 0.23.7 gets 0.23.8 over Wi-Fi: SETUP > UPDATES, RELEASES: TESTING,
CHECK FOR UPDATES, then hold the install button for 2s. With RELEASES: STABLE the
check reads `releases/latest`, which names 0.22.1, and offers nothing. At
link-up the panel offers to update the IOmcu over CAN (Controller Area Network)
when the IOmcu runs a different build. To set up a new bench, load both boards over USB
(Universal Serial Bus) as [First run, §1](docs/FirstRun.md#1-flash-both-boards)
describes.

The entries below cover the 3 pull requests merged since v0.23.7: #730, #731
and #733.

### Changed

- The interface's texts are revised in English and German: 797 of the 3,191
  entries in `shared/text/include/ui_text.def` change, 385 in English and
  769 in German. The revision covers screen labels, help lines, alerts,
  programming instructions, the servo reports, settings and the Wi-Fi page.
  German instructions use the du-imperative, and an angle the reports print
  reads `°` instead of `deg`. IDs, widths, format conversions, NULL
  fallbacks and the CSV columns stay as they are. The manual, the web help,
  the tests and 394 screenshots (132 in English, 262 in German) quote the
  new texts.
- The documentation and the web help are revised in English and German:
  59 pages under `docs/` (30 in English, 29 in German), 56 files under
  `help/` (27 page pairs, the example page and the format guide), and 42
  further Markdown files: the READMEs,
  STATUS, CONTRIBUTING, SECURITY, both changelogs, and the hardware,
  protocol, configurator and testbench pages. The configurator's 482
  catalogue texts, its interface and PDF export texts, the texts of the 72
  ESC profiles (`shared/esc/profiles/`, regenerated into
  `esc_profiles_gen.c`), the help strings of 13 tools, the comments in
  `can_twai.c`, `panel_poll.c`, `link_pages.h` and `motor_program_page.c`
  and the panel's CAN error-counter log line follow the same revision. The
  German screenshots `motor-stick-hand-info`, `-warning`, `-prompt` and
  `-end` show the new profile texts. Commands, IDs, version facts,
  measured values and the catalogue's source anchors stay as they are.
- The configurator's first-load budget in `configurator/tools/size.ts` is
  260kB, up from 250kB: the revised texts take the first load to 250.9kB.

### Fixed

- LEAVE PROGRAMMING after a write with a switchable servo supply reads
  `LEAVE switches the supply off for 1s, then on. The port then returns to
  servo PWM.` (German `VERLASSEN schaltet die Versorgung 1s aus und wieder
  ein. Danach wechselt der Port zu Servo-PWM.`). The line named the PD mini
  on the carrier too, where the port's fixed 5V is the supply switched.
- SERVO LIVE: the readings along the card's foot take columns of 192, 216
  and 188px. MEASURED at its widest, `-180.0` in the 32 x 44 numerals
  (192px), ends at least 24px before CURRENT's first numeral, so `+174.0`
  and `0.00` no longer read as `+174.00.00`.
- The German HOME guide's SETUP line names the screens by their titles
  (`PANEL, SENSORS, OUTPUTS, SD CARD, WI-FI und UPDATES`), and SENSORS and
  SD CARD are on the list of titles that stay English (`docs/Language.md`).
- KST PULSE tab: the note names the SERVO tab's button, `Write these values
  with WRITE VALUES on the SERVO tab.` (German `... mit WERTE SCHREIBEN im
  Reiter SERVO.`), in place of a CHANGES control that does not exist.
- OUTPUTS: LAST WRITE before any write reads `NONE YET` (German `NOCH
  KEINER`) in place of `NOT WRITTEN`. The overview entry OFF reads AUS in
  German in the protocol lists, on their faces and in the LAYOUT rows.
- The HOME guide's fourth page title reads `MENU: TAKING A SCREENSHOT`
  (German `MENÜ: SCREENSHOT AUFNEHMEN`), upper case as pages 1 to 3.
- ESC STICK > Great Planes: the C-25, C-35 and C-55 rows show their family,
  `C Series brushed`, beside the MANUAL tag and the reason `menu entry after
  power-on` (German `Menü erst nach Einschalten`); the row showed `C..`.
  The MANUAL tag is 4px narrower.
- SERVO TEST's summary gives every step its unit and a comma between the
  parts: `4.8V, 6.0V, BROWN-OUT, 60s EACH` (German `..., JE 60s`).
- SERVO OPTIONS > OUTPUT: the active-rate note names the port's number,
  `Active: PROG PORT 1 GPIO 13 runs at 50Hz.`, and `Active: 50Hz on PROG
  PORT 1. No pin is assigned to it.`
- FILES text viewer: a line wraps at a space; a word that does not fit the
  rest of the row with its space starts the next row, so a number keeps its
  unit (`600ms`). A word longer than the row breaks at the row's end. The
  editor's cursor, taps and the scroll follow the same rows.
- Servo test report: the ENCODER table's values start at the columns of
  their headings in English and German; the counts were right-aligned
  under left-aligned German headings.
- MOTOR & ESC LIVE: EFF reads WIRK. in German. rpm and rpm/V are units and
  stay; `docs/Language.md` lists them.
- The alert `STOP pressed: hold STOP 2s to reset.` leaves the band in the
  frame after the STOP's reset completes instead of after its 30s; every
  other alert keeps its timing.
- LOGS: the list's tab counts the files of every list with a file in it,
  `FILES 1 TO 7 OF 7` (German `DATEIEN 1 BIS 7 VON 7`); an empty folder
  reads `FILES`.

## 0.23.7 - 2026-11-04

0.23.7 is a testing release. Its minor number, 23, is odd. GitHub
publishes it as a pre-release and does not mark it as latest. It runs on the
ESP32-P4 panel, as 0.23.6 does; an ESP32-S3 panel stays on the 0.22 line and
is not offered it. The link protocol is 4.36, as in 0.23.6. The assets are
`rcbench-panel-p4-v0.23.7.zip`, `rcbench-panel-p4-v0.23.7.bin`,
`rcbench-iomcu-v0.23.7.zip`, `rcbench-iomcu-rbmod-v0.23.7.zip` and
`SHA256SUMS`.

A bench on 0.23.6 gets 0.23.7 over Wi-Fi: SETUP > UPDATES, RELEASES: TESTING,
CHECK FOR UPDATES, then hold the install button for 2s. With RELEASES: STABLE the
check reads `releases/latest`, which names 0.22.1, and offers nothing. At
link-up the panel offers to update the IOmcu over CAN (Controller Area Network)
when the IOmcu runs a different build. To set up a new bench, load both boards over USB
(Universal Serial Bus) as [First run, §1](docs/FirstRun.md#1-flash-both-boards)
describes.

The entries below cover the 16 pull requests merged since v0.23.6: #713 to
#727 and #729.

### Added

- RUDDER on SERVO shows a live side view of the control surface: a grey
  fixed surface, its hinge and a cyan flap. Positive deflection moves the
  trailing edge up. The 62px flap occupies a 190 x 152px area to the right
  of the state lines and shows the measured angle from -90 to +90°.
  Beyond this range, the drawing stops at ±90° while the numeric reading
  continues. Ticks mark 0, ±30, ±60 and ±90°. Dashed lines mark each side's
  MAX; amber dashed lines in AUTO mark the two targets. Without a reading,
  the flap is dimmed on the neutral line. The state lines, AUTO's START
  button and its text occupy x 18 to 418; AUTO's text wraps at spaces.
- The AUTOMATIC TEST's brown-out sequence has a separate settings page.
  Open it with BROWN-OUT in the automatic test settings; the row shows
  `ON 3.0/0.2V` or `OFF`. LOWEST VOLTAGE sets the final voltage from 2.0 to
  4.8V. STEP sets each reduction from 0.1 to 1.0V. Both settings persist
  across restarts. Their defaults, 3.0V and 0.2V, reproduce the sequence
  in 0.23.6. The sequence starts at 5.0V or the voltage cap, whichever is
  lower. A final step smaller than STEP reaches LOWEST VOLTAGE exactly.
  If LOWEST VOLTAGE is at or above the starting voltage, only that starting
  voltage is tested. The sequence requests up to 31 voltages. The report's
  `Brown-out:` line records the selected step.
- `protocols/witmotion` decodes WitMotion serial frames (0x55, type,
  4 x int16, sum) into m/s², °/s, ° and µT. It encodes the 5-byte commands
  unlock, SAVE, RATE, RSW, CALSW and AXIS6. The module has host tests and
  no pin driver.
- ANGLE SOURCE under SETUP > SENSORS > IMU (inertial measurement unit)
  selects AS5600 or IMU, with AXIS and SIGN for the IMU. The servo test,
  LIMIT RUN and SERVO run log use the selected source. The IMU angle is
  represented in AS5600 counts (0.088°). The test CSV adds `angle source`
  as its final column, and both reports name the source in
  `Angle source:`. A run with the IMU that ends on an IMU gap names it:
  `IMU not answering` (German `IMU antwortet nicht`) or
  `IMU dropped out twice in 10s` (German `IMU 2x in 10s ausgefallen`).
- The Hitec programmer accepts run-controlled writes through
  `hitec_panel_run_*`. It writes both end points in one session, using
  save and reboot for D series and the checksum balance for classic
  servos. It saves a backup before the first write and offers RESTORE
  afterward. Travel values are counts from NEUTRAL 0xC2 for D series, or
  raw cells 0x13 and 0x14 interpreted by DIRECTION for classic servos.
  The run's 2s start hold confirms the end-point rule for that run's edits
  only. The run interface performs no writes outside a run.
- RUDDER is one of the five tasks in SERVO's strip. While ARMED, it drives
  the servo to 1000us, CENTRE or 2000us, or lets the rotary knob set its
  position. It shows control-surface deflection from AS5600 or IMU in
  0.1°. With LENGTH set, it also shows trailing-edge travel, L x sin, in
  0.1mm. LENGTH is the hinge-to-trailing-edge distance: 10 to 500mm, kept
  across restarts; 0 means unset. ZERO records neutral. MAX retains the
  largest deflection on each side until ZERO or RESET MAX. A state line
  names the angle source and explains a missing reading. The screen guide
  identifies the output card's TARGET row and ARM, shared by all tasks.
  SERVO's tabs are 120px wide; the German strip uses the 8 x 16 face.
- `protocols/hc05` implements HC-05 AT setup as an SPP (serial port
  profile) master from supplied bytes and a clock. It supports PROBE
  (115200, 38400, 9600 baud), SCAN (INQ for 11.5s, then names), BIND
  (PAIR for 20s, BIND, CMODE 0, UART 115200) and CONNECT TO ANY (CMODE 1).
  It handles firmware 3.0's quoted PIN and ERROR:(1F) response to INQ.
  Host tests use scripted replies from both firmware versions; there is
  no pin driver.
- A WitMotion BWT901CL connects through an HC-05 on panel UART1
  (`PANEL_IMU_*` in board_pins.h). The HC-05's RXD is on IO4, its TXD on
  IO5 and its KEY on IO29 of header P3. Its 5V and GND come from pins 1
  and 2 of H9, the RS485 header. SETUP > SENSORS > IMU provides ON/OFF,
  AXIS, SIGN, RATE (10 to 200Hz) and ALGORITHM (6-AXIS or 9-AXIS). The
  IMU tile under SETUP scans for 11.5s, binds, calibrates the accelerometer
  after a 2s hold and 3s without movement, and shows battery level, rate
  and live angles. The bench configures the HC-05 through AT commands at
  115200, 38400 or 9600 baud. With ANGLE SOURCE set to IMU, servo runs and
  RUDDER use the IMU angle. The left SENSORS list has 9 entries, each 48px
  high at a 48px pitch.
- AUTO on RUDDER programs KST or Chaservo end points so that 1000us and
  2000us reach each side's requested deflection multiplied by 1 + MARGIN,
  within TOLERANCE. Deflection ranges from 0.5 to 90.0° (default 20.0°),
  MARGIN from 0 to 50% (default 10%), and TOLERANCE from 0.1 to 5.0°
  (default 0.5°). Each side permits at most 8 writes, each in a separate
  programmer session. The limit run's current guard remains active; a
  stall before reaching the goal ends the run with SURFACE BINDS AT.
  RUDDER's ZERO row contains ZERO, RESET MAX and AUTO, each 160px wide.
  AUTO's box replaces LENGTH, the drive buttons and the state lines;
  MANUAL restores them. The run writes RUDDRnnn.TXT and RUDDRnnn.CSV.
  RESET MAX is labelled MAX LÖSCHEN in German.
- LIMIT RUN and AUTO support Hitec servos. The SERVO row in LIMIT RUN
  settings selects KST/CHASERVO or HITEC and follows the programmer last
  opened under PROGRAM. A D series run writes LEFT END (0xB2) and RIGHT
  END (0xB0) as counts from NEUTRAL (0xC2), then saves and reboots. A
  classic run writes cells 0x13/0x14. SERVO PULSES remains KST-only. The
  Hitec search uses a pulse model with NEUTRAL at 1500.0us and full travel
  at 850.0 and 2150.0us for D series, or 900.0 and 2100.0us for classic
  servos. PULSE MIN and MAX must include that range. To restore a Hitec
  servo, load its HITECnnn backup from FILES.
- LIMIT RUN treats an unanswered write handed to the programmer before
  the run ends as potentially written. It offers RESTORE, and the report
  names the backup saved by that write's session.

### Changed

- STOP acts as an emergency stop button. One touch from any screen puts
  the bench in SAFE, switches off all outputs, the PD mini output and the
  programming ports' 5V, withholds the heartbeat and latches the stop.
  While latched, STOP remains red in a yellow frame and shows `STOPPED`
  above `HOLD 2s TO RESET` (German `GESTOPPT`, `2s HALTEN ZUM LÖSEN`). The
  arm chip shows STOP. ARM, OUTPUT ON, PROG 5V ON, CONNECT and starting a
  test or run are refused with `STOP pressed: hold STOP 2s to reset.`
  ARM does not reset the latch.

  Hold STOP for 2s with uninterrupted contact to request a reset. A
  release, sliding off STOP, a second contact on the band, lost touch
  events, a screen change or 100ms without a touch-controller reply
  cancels the hold. One state machine performs the reset. It reads the
  IOmcu's STATUS, SUPPLY and PROG_SUPPLY pages every 50ms. Once they
  report SAFE and all outputs off, and at least 500ms has elapsed since
  STOP, it resumes the heartbeat and writes CLEAR once. STOP from any
  state returns it to LATCHED. The bench stays SAFE. If the required
  report does not arrive within 2000ms, the stop remains latched and the
  alert band explains why. A panel restart starts unlatched. Host tests
  cover `test_stop_latch`, `test_stop_hold` and two wire-level cases in
  `test_safety_gate`.
- The band suppresses FAULT 10 (HEARTBEAT) while STOP is latched and for
  1000ms after reset, because the panel deliberately withholds the
  heartbeat then. The hardware emergency stop on the heartbeat line and
  an open heartbeat wire still produce FAULT 10.
- An AS5600 output encoder enabled at the start of an AUTOMATIC TEST or
  LIMIT RUN produces a measurement gap if it stops answering. A gap may
  last up to 300ms (`SERVO_GAP_MAX_MS`) and must start at least 10s
  (`SERVO_GAP_EVERY_MS`) after the previous gap began. The run continues
  through an allowed gap without evaluating angles. The report records
  the count and longest gap under `AS5600 gaps:` (German
  `AS5600-Lücken:`). The automatic test CSV records each gap's duration
  in `angle gap (ms)`.

  A longer gap ends the run with `AS5600 not answering`. A second gap
  starting too soon ends it with `AS5600 dropped out twice in 10s`. Both
  errors switch the output off and return the bench to SAFE. Previously,
  disconnecting the encoder permanently did not end the run. This
  allowance applies to angle measurements, which high-current motor and
  ESC runs can interrupt on the sensor bus. Losing INA3221 windows still
  ends a run immediately because they supply STALL AT and the limit run's
  current checks.

### Fixed

- The AUTOMATIC TEST card under SERVO > TEST shows why the last run was
  aborted, in the warning colour: `LAST: ABORTED - link lost` (German
  `ZULETZT: ABGEBROCHEN - Link verloren`). Previously, the card
  showed only `ABORTED` and the filenames; the reason appeared only in
  LIVE's result box and the report. A run ending while TEST was visible
  therefore left no on-screen reason, and the band's last alert could
  be mistaken for it.
- `AS5600 is not responding at 0x36.` clears from the band after the first
  successful encoder read. Previously, a transient missed read while
  reconnecting the AS5600 could leave the alert visible for 30s after
  readings resumed.
- The rotary knob on LIVE sends no pulse while a LIMIT RUN drives the
  horn, and until the run's session ends with LEAVE. Previously, a turn
  moved the horn during the run.

## 0.23.6 - 2026-11-03

0.23.6 is a testing release. Its minor number, 23, is odd. GitHub
publishes it as a pre-release and does not mark it as latest. It runs on the
ESP32-P4 panel, as 0.23.5 does; an ESP32-S3 panel stays on the 0.22 line and
is not offered it. The link protocol is 4.36, as in 0.23.5. The assets are
`rcbench-panel-p4-v0.23.6.zip`, `rcbench-panel-p4-v0.23.6.bin`,
`rcbench-iomcu-v0.23.6.zip`, `rcbench-iomcu-rbmod-v0.23.6.zip` and
`SHA256SUMS`.

A bench on 0.23.5 gets 0.23.6 over Wi-Fi: SETUP > UPDATES, RELEASES: TESTING,
CHECK FOR UPDATES, then hold the install button for 2s. With RELEASES: STABLE the
check reads `releases/latest`, which names 0.22.1, and offers nothing. At
link-up the panel offers to update the IOmcu over CAN (Controller Area Network)
when the IOmcu runs a different build. To set up a new bench, load both boards over USB
(Universal Serial Bus) as [First run, §1](docs/FirstRun.md#1-flash-both-boards)
describes.

The entries below cover the 4 pull requests merged since v0.23.5: #632 and
#709 to #711.

### Added

- rbmod carrier: PROG 5V lost is an error. While the panel's PROG 5V ON stands (the PROG_SUPPLY page reads it on or acknowledged it, no programming port holds it, the heartbeat runs), two new INA3221 windows in a row under 3000mV on the channel watching PROG 5V, both read 500ms or more after the ON, put the bench SAFE with every output off and the PROG_SUPPLY OFF written. The band reads `PROG 5V lost: INA3221 0x40 CH3 read 0.12V while ON. All outputs off.`, the console one line with both windows and the time since the ON. One error an ON. M7's controller latches off above about 6.0V for 20us or below 3.25V for 200us and restarts only on an EN toggle, which the next PROG 5V ON gives; the known cause is a braking servo feeding energy back into PROG 5V. Rev 1 rework item 3, a 5.6V 1W zener from VCC_PROGPORT_DCDC to GND, absorbs the feedback; the firmware does not rely on it. No watch without a channel watching PROG 5V or while a programmer session holds the 5V ([Carrier, PROG 5V lost](docs/Carrier.md#prog-5v-lost)). `sense_win_link_last()` also hands out the window's number.

### Changed

- The IOmcu's sensor bus runs on `protocols/i2c_txq`: core 1 hands each
  transaction to the queue as a hard one, due now, and waits for its end
  with interrupts on (`shared/sense/sense_txq.c`,
  `firmware/iomcu/src/sense_i2c.c`). The schedule, bus policy, 400kHz clock, 1000us limit, 10us settle,
  50us pull-up probe before a start and 9-clock bus clear are unchanged.
  The changes are:
  - No transaction runs with core 1's interrupts off; the FIFO load is at
    most 13 register writes with them off. The flash lock-out may land
    during a transaction, which ends on the wire while core 1 is parked.
  - A read is timestamped when the block's interrupt or core 1's poll
    reports its completion. If reported more than 100us late, its timestamp
    is its start time plus its bus time.
  - A pointer read is one transaction loaded into the FIFO whole, not two
    pico-sdk calls. The sequence on the wire stays: START, address,
    pointer, repeated START, address, bytes, STOP. The gaps between bytes
    are not measured.
  - The block is reset after a timeout and by the bus clear, not after a
    NACK or a lost arbitration.
  - A NACK is identified from the block's abort source, rather than the
    subsequent line levels; a line held after a NACK is reported by the next transaction's
    line check. A lost arbitration with a line still low 10us after the
    end is SENSE_BUS_LOW without the pad pull-up probe.
  - The bus clear runs with interrupts on, 24 half-clock steps of 5us,
    115us from the first to the last without SCL held.
  - Core 1 polls the queue once a tick; a wait for a transaction asks for
    an abort after 5000us and gives up after 10000us when the driver never
    reports one.
  - The open is refused when the I2C block or its interrupt is taken.
  `protocols/i2c_txq` does not start a soft transaction while its bus
  time plus 20us (`I2C_TXQ_GUARD_US`) would run past a queued hard one's
  release, checked at the pick and again after the line settle. Host-tested in `test_sense_txq`, `test_sense_txq_svc` (the service on
  the queue against the direct wire: every snapshot equal over 4000 ticks
  with faults) and `test_sense_i2c`.

### Fixed

- On the rbmod carrier's programming port with the PROG 5V box OFF, the
  LIMIT RUN card names the box (`PROG 5V OFF: SWITCH IT ON IN THE PROG 5V
  BOX`) when SEARCH+PROG or SERVO PULSES is chosen, not a missing PD mini.

## 0.23.5 - 2026-11-03

0.23.5 is a testing release. Its minor number, 23, is odd. GitHub
publishes it as a pre-release and does not mark it as latest. It runs on the
ESP32-P4 panel, as 0.23.4 does; an ESP32-S3 panel stays on the 0.22 line and
is not offered it. The link protocol is 4.36 (4.33 in 0.23.4). The assets are
`rcbench-panel-p4-v0.23.5.zip`, `rcbench-panel-p4-v0.23.5.bin`,
`rcbench-iomcu-v0.23.5.zip`, `rcbench-iomcu-rbmod-v0.23.5.zip` and
`SHA256SUMS`.

A bench on 0.23.4 gets 0.23.5 over Wi-Fi: SETUP > UPDATES, RELEASES: TESTING,
CHECK FOR UPDATES, then hold the install button for 2s. With RELEASES: STABLE the
check reads `releases/latest`, which names 0.22.1, and offers nothing. At
link-up the panel offers to update the IOmcu over CAN (Controller Area Network)
when the IOmcu runs a different build. To set up a new bench, load both boards over USB
(Universal Serial Bus) as [First run, §1](docs/FirstRun.md#1-flash-both-boards)
describes.

The entries below cover the 23 pull requests merged since v0.23.4: #684 and
#686 to #707.

### Added

- rbmod carrier: the programming port is chosen on the panel and kept over a restart. A tap on the KST or Hitec programmer's PORT row before CONNECT opens PROGP01 to PROGP04 with their GPIO, and the carrier's PROG PORT entries on OUTPUTS offer SERVO TESTER and PORT PWM. The choice is SERVO TESTER (`srv_target`), so the servo tester, the KST limit search and LEFT/RIGHT drive the chosen port. It is locked under the SERVO TARGET rules, with the reason under the rows. PROGP04 is refused by name while PWM04, on PWM slice 0, carries a PWM output. The pulse goes out only while PROG 5V reads ON; PORT PWM ON, a servo test and a limit run say `PROG 5V OFF: SWITCH IT ON IN THE PROG 5V BOX` otherwise, and a servo test on the port says `PROG PORTS RUN AT 5V FIXED: NO STEPS`. A chosen port that does not read SERVO PWM yet takes no tester command, so nothing goes to the servo outputs in its place. For the limit run the PROG 5V box stands for the PD mini: SEARCH+PROG and SERVO PULSES are offered with the box ON, the servo rails' PD mini is neither asked nor watched, and an aborted run switches PROG 5V off.
- Link 4.36: the rbmod carrier's programming ports take FUNC SERVO PWM besides NONE; DShot stays refused, and every start begins on NONE. An OUTPUTS write or BIND commit that puts a PWM slot on a SERVO PWM port's slice sets that port back to NONE, its pulse off and TARGET 0 where it names it, so PWM04 takes a PWM protocol beside a chosen PROGP04; a port a KST or HITEC session holds refuses such a write. A PWM slot bound on a port's slice lets the port go first, so the binding of PWM01 to PWM04 keeps its rate.
- ESC signal wire: POWER keeps SWITCHED or BY HAND over a panel restart, in the panel's settings (`escw_by_hand`); with nothing stored it is SWITCHED.
- ESC signal wire: a backup's name carries the firmware, `ESCW001-AM32.TXT`, `ESCW002-BLHELI_S.TXT`, `ESCW003-BLUEJAY.TXT`, `ESCW004-ESCAPE32.TXT`, for a backup before a write and one saved by hand. One sequence of numbers is shared across the folder; `ESCWnnn.TXT` and other names list and load as they did.
- ESC signal wire: DELETE A FILE in the session's FILES list deletes a file on a red 2s hold, and the list reads the card again. A backup the session saved is not deleted inside the session.
- Debug builds: the IOmcu's bench console over CAN. A panel built with `RCBENCH_PANEL_CONSOLE` relays its serial ports to an IOmcu built with `IOMCU_CONSOLE`, through the CONSOLE page (0xE0), at most one exchange a control pass: 6,000 bytes/s of output at a 5ms pass, calculated. Every console command runs on the IOmcu, `ewline` included. Both options are off in every released image, and CI reads the images for it. Such a panel carries the console image, and UPDATES offers it over CAN. The console build holds the IOmcu's lines from its start, the reset cause first, for whoever comes. The relay's own lines land between the IOmcu's lines, never inside one; a gap of 1500ms or more in the control passes, as during an IOmcu update, says `console: no pass from t_ms=<a> to t_ms=<b>`.
- WI-FI: HOTSPOT PASSWORD and WEB CODE, each RANDOM (the default) or a value of 8 to 63 printable ASCII characters typed on the panel, kept in NVS (non-volatile storage) under `ap_pass` and `web_code`, in plain form. BACK TO RANDOM takes one tap. A change takes effect at the next start of the radio. FORGET HOME NETWORK keeps both. A kept code stays valid until changed; 16 wrong codes still switch the radio off. The page's code entry takes 63 characters, its body limit is 200 bytes, and the cookie carries the code percent-encoded. The panel takes no screenshot while it shows a kept value. `tools/check_wifi_secrets.py` fails CI on a log call that names a kept value.
- Panel: MOTOR & ESC > PROGRAM's row `AM32, Bluejay, BLHeli_S, ESCape32`, `SIGNAL WIRE` at its right, dimmed until the IOmcu reports `LINK_CAP_PROGRAM`: [ESC signal wire](docs/EscWire.md). CONNECT, identity, tabs of fields, a draft, WRITE with the warning that names each hazardous field, the backup and the record on the card, a file loaded, RESTORE FROM BACKUP on an erased AM32, LEAVE. Voltage and limit are SUPPLY's until typed.
- ESC signal wire, screen behaviour:
  - A hold's fill reaches the screen: MOTOR & ESC's session path reads the page set's hold revision and redraws the hold's button alone in each framebuffer, 251 cache-line fills a frame (`motor-wire-hold`).
  - The action row, BACK, value rows, NEXT, PREV, CANCEL and list entries show the pressed state from press to release, and a press redraws that button alone. A move redraws nothing.
  - A steady session page keeps its revision when the outputs are read again: targets are compared by field, excluding their padding byte. `motor-wire` draws 0 cache-line fills a frame, 19,271 with the padding moving.
  - PIN HELD shows `A stop or a fault ended this session` only for a stop or a fault; after a SUPPLY OFF with neither, the `SUPPLY_OFF` refusal's line is the only one.
  - After a stop or a fault PIN HELD offers PIN BACK only, with a line that names CONNECT after it. The SUPPLY page reports its latched OFF, and an ENTER under it is refused with `LINK_ESC_REF_SUPPLY_OFF` (17).
  - With the panel's STOP standing, STOPPED offers PIN BACK only, with `The bench's STOP stands: PIN BACK first.` A page's stop keeps CLEAR STOP.
  - ESCape32's 3 sound and light fields (`volume`, `beacon`, `led`) sit on the tab `INPUT, SOUND` with input and telemetry, 11 rows. Every tab of every firmware is selectable in the strip of 6.
  - A press on the place of a hidden button, or between two tabs, clears no line.
  - A line stays on its stage and the page its end leads to; the next press clears it. Arriving on CONNECT with the pin free clears all but `LEFT`, the link's state and an error that ended the flow.
  - A lost link closes an open keypad, choice list or hold page at any stage, and `ABORT ended it` gives way to the link's state.
  - VOLTAGE's and LIMIT's keypads end at SUPPLY's limits for this board and setting, and a connect above them is refused with the range message.
  - RELEASE, RESTORE and NO BACKUP each have their own hold hint, and RELEASE's page names the pin. The German `STOPPED` title reads `GESTOPPT`.
- SUPPLY: an ESC session's hold counts on every board. On the carrier SUPPLY refuses set points and ON under it (`SUP_HELD_REFUSED_ESC`); KST and Hitec sessions there do not lock it.
- Panel's editor: an ESC settings file changed there has `edited` as its last line that is not blank, behind any lines added to it, and no checksum line.
- Panel: its half of the `ESC_WIRE` and `ESC_DATA` pages (`esc_link`, `esc_prog`,
  `esc_prog_file`). A panel restart closes what the page holds at
  the first read, and again every 1000ms; a pin that does not come back is an error
  and an alert that names the slot or port. The STOP key is the page's STOP. `FAULT`
  and `NOT_BACK` count as errors, so all outputs go off. A held pin counts for ARM,
  the motor's TARGET row, ESC STICK and the limit run.
  10 failed reads of the page over a hold are an error and a STOP. A STOP is sent
  until a read answered since the ask shows a free page, and one pressed with the link
  down goes when it is back. A hold that ends with this end's wiring not written gets
  the OFF of any start, then the wiring.
- Link 4.34: the pages `ESC_WIRE` (0x3A) and `ESC_DATA` (0x3B) read and write an
  ESC's settings over its signal wire, on the pin of a throttle slot or a DShot
  programming port, and the IOmcu reports `LINK_CAP_PROGRAM`. The output gets back
  what it had. While a page holds a pin the bank does not arm, CONTROL refuses a
  non-zero ARM, SUPPLY and PROG_SUPPLY are held, and PROG, OUTPUTS, CHAN_CFG, BIND,
  TONE's set-up, SUPPLY's wiring, KST and HITEC refuse. A pin its output does not
  take back keeps the hold until a CLOSE succeeds or the IOmcu restarts. ARM and THROTTLE
  are 0 when the hold begins and at its end. SUPPLY's wiring in force is taken during the hold; a change answers BUSY. An error, TORN and LOST included, parks the line and switches the
  PD mini and PROG_SUPPLY off; a STOP or an ABORT does as well. RAM 7344B: 3856B for the
  page and 3488B for the line. A bidirectional
  DShot pin resting high on SAFE stays as it is, a current
  limitation ([The ESC settings pages](docs/LinkEsc.md#current-limitations)).
- Bench console: `esc` runs the page's operations.
- `protocols/escwire/`: the core for reading and writing ESC settings over the
  signal wire, for BLHeli_S layout 33, Bluejay layout 208 and AM32 settings
  revisions 3 and 4; older layouts are shown read-only. It holds protocol A at
  52us a bit, a guard every outgoing frame passes, identification, field maps
  and a non-blocking session with read-back. Written from a behavioural
  specification, without access to the firmware sources. A data announcement
  is followed by 520us before its data on every firmware: a gap of 104us loses
  the data on AM32, which ends a message only on more than 234us of idle line.
  A leave frame is followed by 500us of idle line before the line goes low.
- `protocols/escwire/ew_file.c`: an ESC's settings as a text file of at most
  5280B, with the page as read, whole, and a CRC-32 (32-bit cyclic redundancy
  check). A load takes editable fields only, into the same firmware and layout.
  A verified file of an AM32 restores an ESC whose 192B read 0xFF when its pin
  code, flash code, bootloader protocol and name are the ESC's. Files go to
  `BENCH/ESCW/CONF`, `ESCW001.TXT` to `ESCW999.TXT`.
  ESCape32's file holds its 46 keys as `key: value` lines and `music`, up to 255
  characters. A load takes the keys and never writes `music`.
- `protocols/escwire/`: ESCape32's text interface at 38400baud. It holds the
  lines `info`, `show`, `set` and `save`, their replies, the 46 numeric keys of
  revision 17 as data, and the session's branch: after 3 silent first contacts a
  2500ms hold with the line high, then `info`; `set` per changed key, `save` and
  a read-back. A clipped `set` ends with no `save`. Other revisions are shown
  read-only. A reply takes up to 1536B of a new buffer in the session.
- `protocols/escwire/rp2350/`: the pin driver of the signal wire, one PIO
  (programmable input/output) state machine of 25 words and 2 DMA (direct memory
  access) channels behind `ew_driver_t`. 16 cycles a bit, 52us and 38400baud,
  8N1, idle high; the pad is released 1 bit time after the last stop bit's edge
  and receives with its pull-up. An abort or a capture marked aborted or
  overflow leaves the pad an input with its pull-down. The IOmcu links it.
- Bench console: `ewline <gpio> tx|abort|rx`, in the `IOMCU_CONSOLE` build, runs
  the pin driver on a free pin for a logic analyser. Fixed bytes, SAFE only.
- Screenshot: a 1000ms hold on the empty part of the band, on any screen with
  the band, takes the frame at once, in any bench state. One picture is held in
  1,305,600B of PSRAM and its popup opens once the bench is idle. SAVE writes
  `screenshots/<name>.PNG`, an 8-bit RGB PNG of 1024 x 600px, on the card. The
  menu's guide has a fourth page for it. The IOmcu update's question and the
  release reminder take no hold, since they cannot say whether a box covers
  them. A save that the bench stopped by leaving idle shows `The bench was
  busy. Nothing saved. Tap SAVE again.` when the popup opens again; a failure
  answered while the popup is shut shows its own text the same way.

### Changed

- An ARM refused by a programmer's hold names its holder: the alert, the supply's line and ESC STICK's note say ESC programmer under an `ESC_WIRE` hold. An ARM dropped by a hold, and a hold of ARM ended by one, give the alert.
- `frame_cost.py --check-doc`: tolerance 3%, at least 500 fills. Rows under about 700 fills are not held by it.
- SUPPLY link: after a start the panel reads the page before it writes. A port's hold
  found there is adopted, and no OFF of the panel's goes over it; the operator's OFF and
  an error's cut stay. A wiring request answered `BUSY` is retried after the hold rather than
  treated as a refusal.

### Fixed

- Link: a read asks for at most 16 registers, 4 reply frames, which the panel's TWAI receive FIFO holds while its interrupt is held on core 0. A wider read (PROG 28, ESC_WIRE status 21, SUPPLY 18, the windows and pages of 28 and 32) is a read of 16 and a READ_HELD (op 6, protocol 4.35) of the rest, which the IOmcu reads in the same page call, so the two parts are one state of the page. An IOmcu older than 4.35 is read in one exchange. The bench console's window is 28 bytes.
- Link report: the panel's bus line and card row carry the TWAI driver's `rx overrun` and `rx missed`; the IOmcu's 3s CAN line carries `tx_drop`, reply frames given up at a full transmit buffer.
- OUTPUTS: the line under a port's rows names an ESC or Hitec session's hold. At SAFE with no test it does not read `LOCKED WHILE ARMED OR A TEST OR SWEEP RUNS`.
- OUTPUTS: a FUNCTION or pin ask settles after a panel or IOmcu start. The sweep's state is unknown from the link-up and a TARGET change or a position settles it; a port on a DShot function, or no port wanted by the SERVO screen, gives neither, so the ask settles it. The amber line names what holds an ask: SAFE, a servo test or sweep, the servo, Hitec or ESC programmer, or a read of the ports.
- Wi-Fi: the same wrong code in a browser's cookie counts once toward the 16 wrong codes, for a RANDOM and a kept code. A tab open from before a change of the code does not switch the radio off. The panel remembers the last 4 wrong cookie values as keyed hashes, emptied at every start of the radio. A different value and every `POST /code` count as before.
- `docs/BLHeli32.md` no longer says AM32 is fully supported.
- IOmcu: a non-zero ARM written while a programming port is out of PWM, on KST
  or Hitec, is refused with NOT_ARMED. The ARM and THROTTLE registers are 0 when
  the hold begins and whenever it ends, whether or not the pin is returned. A stored ARM armed the bank in
  the pass the port returned to PWM, with no new ask; only the panel's press
  guards stood in the way, and a panel just restarted over a held port had none.

### Removed

- `shared/ui/prog_models.c` and its parameter tables and texts.

## 0.23.4 - 2026-10-31

0.23.4 is a testing release. Its minor number, 23, is odd. GitHub
publishes it as a pre-release and does not mark it as latest. It runs on the
ESP32-P4 panel, as 0.23.3 does; an ESP32-S3 panel stays on the 0.22 line and
is not offered it. The link protocol is 4.33, as in 0.23.3. The assets are
`rcbench-panel-p4-v0.23.4.zip`, `rcbench-panel-p4-v0.23.4.bin`,
`rcbench-iomcu-v0.23.4.zip`, `rcbench-iomcu-rbmod-v0.23.4.zip` and
`SHA256SUMS`.

A bench on 0.23.3 gets 0.23.4 over Wi-Fi: SETUP > UPDATES, RELEASES: TESTING,
CHECK FOR UPDATES, then hold the install button for 2s. With RELEASES: STABLE the
check reads `releases/latest`, which names 0.22.1, and offers nothing. At
link-up the panel offers to update the IOmcu over CAN (Controller Area Network)
when the IOmcu runs a different build. To set up a new bench, load both boards over USB
(Universal Serial Bus) as [First run, §1](docs/FirstRun.md#1-flash-both-boards)
describes.

The entries below cover the 15 pull requests merged since v0.23.3: #668 and
#670 to #683.

### Added

- SETUP > PANEL > Demo mode (Demo-Modus), ON or OFF, OFF by default, stored as
  `demo_mode`: ON hides the SIMULATION watermark from the next frame. The
  band's SIM chip, the tiles' SIMULATED chips and every other statement that
  values are simulated stay. A bench with an IOmcu draws no watermark either
  way.
- Openers replace texts that named a path, each returning by the home tag:
  SERVO's caps line under TEST's cards and on DUT is a button to SUPPLY's
  SETTINGS, LIMITS; DUT's AS5600 note is a button to SENSORS' AS5600 entry;
  UPDATES' no-network line is a button to WI-FI. SERVO's two are grey under
  TARGET's lock: ARMED, a sweep, a run, or a programmer holding the port.
  TARGET in a programmer asking for a port opens PROG PORT 1's entry, which
  holds SERVO TESTER.
- SERVO > SETTINGS > OUTPUT names the port SERVO TESTER is set to and its home
  OUTPUTS, read-only.
- SETUP > SENSORS is a split pane: a left list of 8 entries (SENSOR BUS, INA228,
  INA3221 0x40 to 0x43, AS5600, PHASE TAP) with each entry's state under its
  name, and the selected entry's rows beside it. A sensor's rows appear when it
  is enabled. Each entry keeps its scroll. RESET names the entry and resets its
  rows alone. The INA228 entry reads ONLINE, NOT ANSWERING, ANOTHER ID ANSWERS
  and NOT ACCEPTED BY THE IOMCU from what SENSE holds and reads.
- WI-FI's page changes the card: UPLOAD (one text file up to 1MiB, with
  a progress bar and a REPLACE question), NEW FOLDER, NEW TEXT FILE,
  RENAME, MOVE and DELETE, through FILES' jobs, rules and write gate. The
  file API takes `PUT /api/file` with `If-Match` (412 `CHANGED` when the
  file's CRC-32 moved since it was read) or `If-None-Match: *`, and
  `POST /api/mkdir`, `/api/rename` and `/api/delete`. A write waits up to
  2000ms for FILES on the panel and is answered 503 `PANEL_BUSY` with
  `Retry-After: 2` after that.
- SETUP > SD CARD > Browser writes: OPEN (default), ACCESS CODE, HOLD or
  OFF. HOLD shows `HOLD 2s: ALLOW BROWSER WRITES` on WI-FI; a line under
  the rows names the mode and counts the writes.
- WI-FI's page edits a text file: EDIT in the viewer opens a text box
  over the coloured lines, and SAVE writes it back with `If-Match`, the
  file's line ends (LF, CR LF or CR) and its BOM kept, within the
  viewer's 1MiB and 65,536 line ends. A file changed on the card since it
  was read is answered 412 `CHANGED`, and the editor asks STAY or READ
  AGAIN. A KST file loses its checksum lines on SAVE, as on the panel; an
  ESC profile says it is read at the next start. A file with mixed line
  ends is saved with LF ends; a file that is not UTF-8 opens in the viewer
  only. CLOSE and leaving the page ask first while the text has changes.
  A SAVE that needs the access code asks for it in the editor and keeps
  the text.

### Changed

- WI-FI has its own tile on SETUP's hub, in the second row after SD CARD: PANEL,
  SENSORS, OUTPUTS / SD CARD, WI-FI, UPDATES; the carrier adds LAYOUT. 3 slots
  stay free, 2 on the carrier. Its home tag returns to SETUP, or to what opened
  it: LOGS' WI-FI button, in LOGS' footer, or UPDATES' button. PANEL UPDATE's
  CLOSE after a failed upload's install goes there too.
- The LOGS tile holds LOGS and FILES under one strip of two tabs of 499px, on
  each screen's first level. The home tag of each leads to the menu. LOGS shows
  6 file rows, FILES 5 a pane. WI-FI draws no strip: its buttons and card start
  at body y 16, its radio-on rows are 56px from y 16. LOGS' footer holds
  RESCAN and WI-FI; FILES has no WI-FI button.
- FILES and the Wi-Fi page allow DELETE on an empty bench folder, including
  one created with NEW. RENAME and MOVE remain unavailable. The bench
  recreates the folder before its next write there.
- The Wi-Fi page's PUT compares `If-Match` and `If-None-Match` before its body
  is read and again directly before the write.
- UPLOAD's REPLACE asks `GET /api/info` with `etag=1` for the ETag; the file does
  not cross the network, and a file that is not text is compared too.
- A write on the Wi-Fi page that requires the access code is retried once
  the code is accepted, without reloading the page. A response after CANCEL
  sends nothing.
- SETUP's PANEL and SD CARD tiles name their content in place of a count. TEST's
  run cards are 188px tall, 12px less, and their START holds 48px, 8px less.
- UI texts name one tile at most: alerts read `Check SENSORS.`, and MOTOR &
  ESC's say TARGET, which opens OUTPUTS in one tap. Kept paths are the supply
  question's row, Hitec's checksum hint and the browser's texts.
- SETUP's INTERFACES tile goes. The PD mini's enable, TX, RX and baud move to a
  PD MINI tab on SUPPLY > SETTINGS, beside LIMITS: a change applies at once and
  is saved when the bench is idle, and LIMITS' reset leaves them. They take no
  press while the output is on or an ON is on its way, while a programming port
  holds the supply, or while the bench is ARMED, so a mistaken pin cuts no live
  supply. Hitec D receive moves to the Hitec tab's MORE list, offered only while
  the tester has the port. Stored keys stay and a panel's values load unchanged.
- SUPPLY's source line on the model reads `SIMULATED: SWITCH ON IN PD MINI`, a
  button that opens the PD MINI tab.
- OUTPUTS and PICK A PIN are one screen named OUTPUTS, with one SETUP tile. A
  board with a drawing or a shape shows the board as the pin control, the PROG
  PORT rows in the column beside it, LAST WRITE right of the protocol list and
  UNBIND ALL PINS under IN USE. A board with neither, and the rbmod carrier,
  show the pin grid. The carrier keeps its LAYOUT tile, the last one. The
  cat stays on the board view: a cat the entry's column covers moves to the
  other spot. TARGET rows open the screen on their entry.
- The rows of the INA228, the sensor bus, the AS5600 and the phase tap move from
  SETUP > INTERFACES to SENSORS; their stored keys stay and a panel's values load
  unchanged. Vibration and
  Optical tacho keep their keys and show no row: no firmware reads them.
- SETUP's texts and alerts about those rows name SENSORS, and six help lines and
  three state words are shorter to fit the pane.
- A flick that lands on RESET or on the warning's DISCARD arms nothing.
- FILES' editor saves only over the file as it opened it or last saved
  it: SAVE compares the file's CRC-32, the Wi-Fi page's ETag, before it
  writes, and a file the Wi-Fi page changed since is not overwritten. The
  question UNSAVED CHANGES then offers STAY, READ AGAIN or OVERWRITE.
- OVERWRITE, behind a 2s hold in both editors, saves over the file as the
  refused SAVE found it. A further change, also during the hold, is
  refused the same way, and a file that is gone offers no OVERWRITE. A 412
  `CHANGED` of the file API carries `etag`, the ETag of the file it found.

### Fixed

- A request rejected by the Wi-Fi page before its body is read receives
  the status and JSON response. Incoming bytes are read and discarded for
  up to 10s, allowing the connection to close without a reset at the client.
- A form over 1,024B is answered `FORM_TOO_LARGE`, with the form's limit in its
  text, in place of the file's.
- WI-FI's line says `1 write so far`, `bisher 1 Schreibvorgang`, for one write.
- A shunt or maximum edited on SETUP > SENSORS with the INA3221 parts on SENSE_MAP
  reaches the IOmcu. The panel takes the INA228 alone off for the frame. The
  frame that took both monitors off changed the map's mirror bit, which the
  page refuses, and every value but the one held read `Not accepted by the
  IOmcu.`.
- The band says why the INA228's shunt and maximum are refused:
  `INA228 shunt x maximum is over 163.84mV: on 1000uΩ up to 163.8A. Check
  SENSORS.`. A page that keeps its parts because the bank drives says
  `IOmcu is ARMED and keeps the sensor set-up.`, not that the sensor pins are
  rejected.
- INA228 shunt and INA228 max current name, on the row, the highest value that
  works with the other row: `Up to 300.0A on 200uΩ (163.84mV)`.
- SERVO LIVE's three readings end 4px above the alert band, so a hold hint
  leaves them whole. The readings moved up 28px, the dial's shaft up 14px, and
  the dial's +90 and -90 labels moved left of their ticks.
- Ending a KST session clears its current-state messages: `All 32
  registers read.`, `KST004 loaded.`, and the edit and load lines. Messages
  about a past write, saved file or refusal, and danger lines remain. Hitec
  sessions behave the same way, including on a lost link or with an IOmcu
  that lacks the page.

- FILES' editor header shows the file's size as read when it opens and as
  written after SAVE, not the size listed before the open.
- The IOmcu's update question is declined by CANCEL and the home tag only. A
  fault screen after a lost link, or a panel update's download, over the
  question records no decline, and the next link-up's check offers again.
  A CANCEL on a question whose offer a newer link-up has replaced declines
  nothing, and the question shows the new offer.
- A cold start of panel and IOmcu from one supply shows no CAN BUS FAULT for a
  working link. The IOmcu opens CAN after its supply boot-off, up to 3500ms
  when the PD mini starts at the same moment. The panel asks the IOmcu for its
  status for up to 5000ms and starts the echo test, 1200ms, at the first
  answer. `bus_err` on the bus-fault screen counts the test's bus errors only.
- The CAN BUS FAULT screen's acknowledgement does not fill by itself. Leaving
  the screen drops a press that is still held, so the next fault, such as a
  pulled CAN cable, waits for a finger; a held press would acknowledge it
  after 2s.
- STOP clears a hold button's amber hint on the alert band in the frame of
  the press, and so do a new FAULT code and a switch from ARMED to SAFE.
  An alert is left as it is.
- The screen guide's PREV and NEXT keep one place on every page: in the
  band, in the home tag's place, from x 8 to 264. A second tap at the
  spot of NEXT turns the next page instead of landing on a tile and
  closing the guide. CLOSE stays in the dock, centred at its bottom.
- An INA3221 channel over its limit writes one INFO line to the console
  for each channel at each trip: the part, the channel, what it watches,
  the limit and the highest window current read, for example
  `INA3221 0x40 CH1 (PORT 1) over its limit of 0.010A: highest window read
  0.153A`.

## 0.23.3 - 2026-10-30

0.23.3 is a testing release. Its minor number, 23, is odd. GitHub
publishes it as a pre-release and does not mark it as latest. It runs on the
ESP32-P4 panel, as 0.23.2 does; an ESP32-S3 panel stays on the 0.22 line
and is not offered it. The link protocol is 4.33 (0.23.2: 4.30). A panel running
0.23.3 with an IOmcu running 0.23.2 keeps the supply on through an error while a programming port
holds it and sends no bit 4 with a Hitec write, since that
IOmcu would cut a write to the servo's memory in the middle. On the rbmod
carrier, an IOmcu image older than 4.33 refuses the INA3221 map, and
SETUP > SENSORS reads `NOT ACCEPTED BY THE IOMCU` on 0x40 until the IOmcu
runs the panel's image. The IOmcu build for the carrier is new; an IOmcu of
0.23.2 has no PROG_SUPPLY page and refuses it with BAD_PAGE. An IOmcu running
0.23.3 with a panel running 0.23.2 holds that panel's OFF for a write to the
servo's memory, 10000ms at most. It never switches the programming ports'
own 5V on, since a panel before 4.32 does not write the page's register 4.

A bench on 0.23.2 gets 0.23.3 over Wi-Fi: SETUP > UPDATES, RELEASES:
TESTING, CHECK FOR UPDATES, then hold the install button for 2s. With RELEASES:
STABLE the check reads `releases/latest`, which names 0.22.1, and offers
nothing. At link-up the panel offers to update the IOmcu over CAN
(Controller Area Network) when the IOmcu runs a different build. To set up a new bench,
load the firmware over USB (Universal Serial Bus) as
[First run, §1](docs/FirstRun.md#1-flash-both-boards) describes, with
`rcbench-panel-p4-v0.23.3.zip` and `rcbench-iomcu-install.uf2`; on the
rbmod carrier the IOmcu loads from `rcbench-iomcu-rbmod-v0.23.3.zip` with
its `rcbench-iomcu-rbmod-install.uf2`.

The entries below cover the 30 pull requests merged since v0.23.2: #637
and #639 to #667.

### Added

- SERVO asks after a KST or Hitec LEAVE that leaves the PD mini's output on
  at the session's set points: `Restore your supply set points 5.50V 2.00A
  on the live output?`, YES or NO. YES gives the live output the set points
  from before CONNECT, through HV SERVOS ONLY and its 2s hold where the
  voltage rises from 6.0V or below to above it. NO keeps the session's set
  points; the operator's come back at the output's next OFF.
  No question while a port holds the supply, under another of SERVO's
  panels or questions or OUTPUT ON's hold, after an OFF, an error or a
  STOP, inside a limit run, or when the set points moved since the LEAVE
  ([Servo programmer, The supply](docs/ServoProgrammer.md#the-supply);
  [Hitec programmer, LEAVE](docs/HitecProgrammer.md#leave)).
- The Hitec programmer reads the addresses a write's plan depends on a
  second time before its plan runs: classic cells 0x00 to 0x23 (36), with the
  factory block 0x30 to 0x53 (72 in all) for FACTORY DEFAULT; the 12 D
  series registers a plan writes. Every write is covered: WRITE n VALUES,
  a loaded file's, REPAIR CHECKSUM, RESTORE and FACTORY DEFAULT. Two reads
  that differ refuse the write, `Two reads differ at 0x17: read again with
  READ ALL.`, with nothing planned, recorded, saved or sent. On the host
  model the second read takes 1152ms classic, 2304ms for FACTORY DEFAULT
  and 704ms D series at a frame of 16ms
  ([Hitec programmer, The second read](docs/HitecProgrammer.md#the-second-read)).
- The screen guide: "?" in the band, 8px left of STOP, opens numbered marks
  on the screen's controls and a dock of 480 x 488px that says what each
  one does, 3 rows each, with PREV, NEXT, CLOSE and the web help's address
  ([Screens, The screen guide](docs/Screens.md#the-screen-guide)). The menu
  has a guide of 3 pages; the other screens follow. STOP, DISARM and the
  other controls that stop an output act through it; the knob moves
  nothing while it is open; while ARMED it offers only pages that cover no
  such control. `test_help_router` and `test_help_pages` hold it.
- Hold buttons: a release before 2s shows the button's hint in the alert
  band, for example `Hold 2s to switch to ARMED.`, and sends nothing. It
  applies to ARM, OUTPUT ON, START TEST, START LIMIT RUN, APPLY and the other
  buttons labelled `HOLD 2s TO ...`. The hint is a notice: amber, 4s, cleared
  by a tap on the band, and never over an alert; an alert that arrives
  replaces it. A slide-off, a lost touch, a release that is not a tap, a
  second finger's contact and a screen without the status band show no hint ([Screens, Hold buttons](docs/Screens.md#hold-buttons)).
- `protocols/hitec`: `hitec_session_move()` moves a Hitec servo inside its
  programming session: D series 0x1E = target (0 to 6000), then a read of
  0x0C; classic `66` (3600 to 8400, 0.25us), then `65`. It writes RAM only
  and changes nothing in the image. `hitec_live.c` holds the D series
  target-to-position mapping through the stored end points, the reach, a
  pass's command (150 counts at most, inside the reach), the judges of a
  pass (lag, current, AS5600) and FIND STOP. No screen calls them yet
  ([hitec, Live loop](protocols/hitec/README.md#live-loop);
  [Safety, A Hitec servo moved while SAFE](docs/Safety.md#a-hitec-servo-moved-while-safe)).
- `hardware/mechanical/`: STEP models of the M16 emergency stop button, its
  nut and its square anti-rotation shim as separate files, and an assembly
  of the three for a 1.6mm panel, generated from `estop_m16.py` by
  `gen_models.py` (`--check` in CI). Dimensions from the seller's drawing;
  the parts it does not dimension are estimated and listed in the spec.
  `step_gen.py` writes turned solids, `step_check.py` checks these models
  too, and `step_render.py --step` renders any STEP file.
- SETUP → PANEL → Keyboard see-through: OFF (default), 25% or 50% of the
  text shows through the text editor's keyboard, the rows under it
  included; labels stay opaque. Other keyboards stay opaque
  ([Screens, The text editor](docs/Screens.md#the-text-editor)).
- The rbmod carrier, a board that holds the RP2350-CAN module and solders
  every lead to a fixed GPIO: an IOmcu image of its own,
  `rcbench-iomcu-rbmod-vX.Y.Z.zip` in the release, built with
  `-DIOMCU_BOARD=rbmod`. It reports board 2 on IDENTITY register 5. Each
  role starts on its pin and the IOmcu refuses any other: PWM01 to PWM04 on
  GPIO 2, 4, 5 and 1, PROGP01 to PROGP04 on GPIO 13, 14, 15 and 0 with
  FUNC NONE, the sensor bus on GPIO 16 and GPIO 17, the PD mini on GPIO 7
  and GPIO 6, the tap on GPIO 22
  ([Link, Boards with soldered pins](docs/Link.md#boards-with-soldered-pins)).
  GPIO 21, the enable of the programming ports' 5V, is driven low from the
  start of `main()`.
- Link 4.32, the PROG_SUPPLY page (0x39): the programming ports' own supply
  on a board that switches one, the rbmod carrier's GPIO 21 and its 5V buck
  M7. A port gets it only after the panel's write of register 4 (PANEL)
  since the heartbeat last went, so a panel before 4.32 never powers it. The KST and Hitec programmers switch it for a session in place of the
  PD mini. Every error writes its OFF, held
  for a write to the servo's memory 10000ms at most; a lost heartbeat or a
  silent link switches it off. SUPPLY shows `PROG PORTS 5V, GPIO 21: ON` or
  `OFF` under OUTPUT, and the programmers' MORE list reads
  `PROGRAMMING VOLTAGE: 5V FIXED, GPIO 21` in place of the voltage and the
  current; they take no reading of the PD mini there, so neither its set
  point nor the SUPPLY screen's limits refuse a CONNECT, and the ports' 5V
  read on is power-cycled at CONNECT and after a write. A firmware install, an IOmcu update, a flash write
  and the Wi-Fi wait for the ports' 5V as for the PD mini's output, and
  the render-loop watchdog watches while it is live
  ([Safety, The carrier's programming-port 5V](docs/Safety.md#the-carriers-programming-port-5v)).
- The PROG 5V box on SERVO's output card and SUPPLY's LIVE task, on a
  board that switches the programming ports' own 5V (the rbmod carrier's
  GPIO 21): `PROG PORTS 5V, GPIO 21: OFF`, the last 50ms window of the
  INA3221 channel watching it (`5.02V  0.120A`), and PROG 5V ON (a 2s
  hold) and PROG 5V OFF (a tap). An ON follows the PD mini's OUTPUT ON
  rules: taken SAFE or ARMED, dropped after a STOP, an OFF or a touch loss
  since the hold, refused while a programming port holds the 5V, written
  once as PROG_SUPPLY OUTPUT 1, refused after an error, an OFF or a link
  restart since its hold began, an OFF written after one without an answer;
  an ON taken across lost touch events is an error. The install, update,
  flash and Wi-Fi gates count an ON from the moment it is queued. While a port holds the 5V the box reads `HELD BY PROG PORT n` and
  takes no press. Leaving the screen whose box switched it on switches it
  off ([Carrier, The PROG 5V box](docs/Carrier.md#the-prog-5v-box)).
- Link 4.33: SENSE_MAP takes the WATCH values of a board's own rails, 0x30
  servo rail A, 0x31 servo rail B and 0x32 the programming ports' 5V. On
  the rbmod carrier the INA3221 at 0x40 is fixed as the board solders it:
  the IOmcu keeps it fitted with CH1 on rail B (PWM03, PWM02), CH2 on rail
  A (PWM01, PWM04) and CH3 on the programming ports' 5V, refuses a map
  that moves them with BAD_VALUE, and starts a kept map with them in
  force. SETUP > SENSORS shows those rows without keys (`SERVO RAIL B`,
  `SERVO RAIL A`, `PROG PORTS 5V`); shunts and limits stay settings, and
  0x41 to 0x43 stay free. The channel read at 1kHz is the rail of the
  lowest GPIO the servo tester drives, CH3 for a programming port. SERVO,
  the limit run, the limit alert, WATCHED BY and the run log's columns
  name the rail (`INA RAIL A`, `rail a`)
  ([Carrier, The current monitor](docs/Carrier.md#the-current-monitor)).
  The SENSE pages move from `link_pages.h` to `link_pages_sense.h`.
- The panel follows the board the IOmcu reports. On the rbmod carrier
  OUTPUTS shows PWM01 to PWM04 as its four cells and refuses a surface and
  a throttle protocol on PWM02 and PWM03 together, by name
  (`PWM03 GPIO 5: SAME PWM SLICE AS PWM02 GPIO 4`); the PROG PORT entries
  name their pin and offer no pin, no function and no tester; INTERFACES
  shows Sensor SDA and SCL, Tap pin and PD mini TX and RX at the carrier's
  pins with no keys
  ([Screens, On the rbmod carrier](docs/Screens.md#on-the-rbmod-carrier)).
  The PICK A PIN tile opens LAYOUT there: J1 and J2 in their position
  order with each position's role, GPIO, net and the protocol bound on it,
  and the other connectors ([Screens, Layout](docs/Screens.md#layout)).
- The panel carries the IOmcu images of both boards and offers each IOmcu
  the image of the board it reports. A board it carries no image for gets
  no offer, and UPDATES reads
  `No IOmcu image for this board in this panel build.`.
- The Wi-Fi page's server provides a read-only file API for scripts:
  `GET /api/status`, `/api/list` (a page of up to 48 entries of a folder,
  by the entry at its edge), `/api/info` (an entry's size and time; a
  folder's entries) and `/api/file` (a text file up to 1MiB and 65,536 line
  ends, byte for byte, with an ETag of its CRC-32 and its line ends). The
  card calls are FILES' own (`fm_req.h`), with its rules and refusals; a
  refusal is an HTTP status, a reason word and a text in EN or DE
  ([Screens, The file API](docs/Screens.md#the-file-api)).
- The Wi-Fi page shows the card in two panes, as FILES does, through the
  file API: the root and the User log folder, 48 entries a page with PREV
  and NEXT, RESCAN, INFO, DOWNLOAD and OPEN on the selected entry, and a
  read-only viewer whose lines are coloured by FILES' rules, words and
  palettes. The page writes nothing on the card. Its script, written once
  in `shared/webaccess/web/`, is carried as C strings generated by
  `tools/gen_web_blob.py` (`--check` in CI); node holds its highlighter to
  `text_hl_line()` on 25,761 fixture cases (`test_wa_hl`,
  `check_wa_hl.py`) ([Screens, The page](docs/Screens.md#the-page)).

### Changed

- SERVO's question `Restore your supply set points 5.50V 2.00A on the
  live output?` follows a KST or Hitec LEAVE that leaves the output on, and
  no other end of a programming port's hold on the supply: RELEASE PORT, a
  STOP, an error, a lost link, a restart of the panel or the IOmcu, a port
  the IOmcu gives back without a LEAVE, and ports that turn to their own
  supply under a session ask nothing, and the session's set points stay
  until the next OFF. The programmers count the LEAVEs that end in PWM
  (`kst_prog_leaves()`, `hitec_prog_leaves()`) and the overlays hand each
  one to the SUPPLY screen before the release it ends. The SUPPLY page's
  own word that a port holds it (`LINK_SP_PORT`) is a word of its own
  there, not the Hitec programmer's: its release a read after a KST LEAVE
  asks
  ([Servo programmer, The supply](docs/ServoProgrammer.md#the-supply)).
- The band keeps 40px left of STOP for "?" on every screen. The chips stand
  4px apart (6px before), their labels 22px into the chip (28px before),
  and a tap finds a chip 2px beside it (3px before), so the widest row, a
  run clock of 10 hours, ARMED MOTOR, FEHLER 7F, BENCH and LINK in German,
  starts at x 270, 2px right of MOTOR & ESC's home tag
  ([Screens, The status band](docs/Screens.md#the-status-band)).
- `render_ui.py --fit` skips a string wholly outside its clip, such as a
  tile under the guide's dock.
- The panel firmware builds on ESP-IDF v6.1 (v5.5.5 before): CI, the
  release workflow, `dependencies.lock` (ESP-IDF 6.1.0, lock file version
  3.0.0; the five managed components keep their versions) and
  [Building](docs/Building.md). The SD card mount leaves the start of
  SDMMC slot 0 to ESP-IDF's mount: v6.1 answers a second start of a started
  slot with `ESP_ERR_INVALID_STATE`, which would keep every card from
  mounting. The panel job is named `Panel (ESP-IDF v6.1, ESP32-P4)`, and
  the branch ruleset requires that name. The task stack table in
  [Performance](docs/Performance.md) follows the GCC 15.2 and picolibc
  build. `flash_args` in a release archive is written for esptool 5
  ([First run](docs/FirstRun.md)).
- The Wi-Fi page no longer lists every file of the card, folder by folder;
  the two panes read a folder a page at a time. The ZIP link and its sizes
  stay. `/api/status` adds the User log folder (`user_logs`) and
  `/api/info` the time as INFO shows it (`time`).
- The text editor's keyboard has no digit row: 4 rows of keys of
  93 x 56px (5 rows of 93 x 59px before), and the text over it shows 8 rows
  (4 before), 10 with SMALL (5 before). `123`, left of DEL, shows the
  digits and 17 marks; `#+=` on that page shows the other 15 marks.

- An error switches every output off and the bench to SAFE
  ([Safety, Errors](docs/Safety.md#errors)). The panel asks DISARM for an
  ARMED bench, or one on its way to ARMED, when: the supply trips on CURRENT
  TRIP or VOLTAGE TRIP, stops answering, gives no reading, is switched off by
  the IOmcu or by the PD mini's own protection, sags, refuses an ON or does
  not take an output or a set point, or an ON is undone for lost touch
  events; an INA3221 channel passes its limit
  (until now an alert only); a card write fails during a run. The supply's
  output goes off with each; with an IOmcu older than link 4.31, not when a
  programming port holds it. The
  automatic servo test and the limit run switch the bench to SAFE when an
  error ends them: the supply or the meter failing, STALL AT, constant
  current, the 3.0A ceiling, 1.0A for 400ms.
- Link protocol 4.31: a programming port's supply goes off on an error,
  after a write to the servo's memory that runs
  ([Safety, A programming port's supply](docs/Safety.md#a-programming-ports-supply)).
  The panel writes the OFF on every error. The IOmcu's SUPPLY page holds an
  OFF of a supply a port holds back from the PD mini while the port writes,
  10000ms after the OFF at most: a KST WRITE, RESTORE or RELEASE from its
  first write frame to the read-backs of its last and 150ms after, a
  Hitec SEND whose
  frame writes and 150ms after it, and the gap after a Hitec step whose
  command carries the new HITEC bit 4 (`MORE`, more steps of this write
  follow). The IOmcu tells a writing Hitec frame from its bytes; an OFF
  during a read or a LISTEN is not held. The panel's Hitec programmer
  sets the bit on every step of a write but the last; the bench console
  sets it with `more`. After the panel's OFF the port's own ON is refused
  until the port lets go: a KST power cycle ends with result 32, a Hitec
  POWER's ON is refused. A lost heartbeat or a silent link still cuts at
  once. Every OFF the panel writes is held for a write this way, the
  operator's and the supply trips' included. A KST or Hitec operation that
  ends in a fault of the servo or the wire (no servo, a failed read, a
  write that failed, a read-back or verify that differs) is an error. A
  panel of this version beside an IOmcu of 4.30 keeps a supply a port
  holds through an error and sends no bit 4; an IOmcu of this version
  beside an older panel holds that panel's OFF for a write the same way.
- The IOmcu switches off a PD mini that was left on before continuing
  its start-up: right after the wiring is restored and before the sensor bus,
  the store's erases, core 1 and the CAN controller. WHO_AM_I goes again as
  soon as one fails, so under AUTO all seven rates are tried in 2.9s. The
  wait ends when the module reads off, or after 3500ms, which delays the
  link by as much when a wired module does not answer.
- The panel's error sites apply the rule through
  `shared/safety/error_sites.c`, and the KST link module counts its session
  faults (`kst_link_faults()`). Host-tested in `test_error_sites`: every
  site against a SAFE, an ARMED and an arming bench, an IOmcu of link 4.31,
  of 4.30 and without the SUPPLY page, with and without a port holding the
  supply; OUTPUT OFF and STOP TEST leave the bench ARMED. What the bench
  does is unchanged.
- With an IOmcu older than link 4.31, a programming port keeps the PD
  mini's output through an error only while the SUPPLY page's FLAGS bit 11
  (`LINK_SP_PORT`), as the panel last read it, and a KST or Hitec session
  with a port both say it holds the supply (`supply_link_port_holds()`). A
  session alone no longer counts: a Hitec session between two POWERs on an
  IOmcu older than 4.29 gets the OFF. Nor does the bit alone once the
  session has ended: a port that lets go counts until the first read of the
  SUPPLY page or of its own page that shows it gone. From 4.31 nothing
  changes: the panel writes the OFF either way
  ([Safety, Errors](docs/Safety.md#errors)).
- On a board whose programming ports have their own supply (the rbmod
  carrier), a KST or Hitec session no longer keeps the operator off the PD
  mini: SUPPLY and the SERVO screen's SET row take OUTPUT ON and set points
  through a session (`supply_link_session_blocks()`,
  `supply_screen_set_ports_own()`). Other boards keep the lock
  ([Carrier, Power](docs/Carrier.md#power)).

### Fixed

- The file viewer of the Wi-Fi page draws its scroll bar in the page's
  dim token on the viewer's background (`scrollbar-color`). In the
  browser's dark scheme the bar was white on the dark text area.
- `card.zip` reads each file in pieces of 16KiB at offsets that are
  multiples of 16KiB, into a buffer of PSRAM aligned for the card's DMA
  (direct memory access): one card transfer a piece. The headers before a
  file shifted every read of 4,096 bytes off the file's sectors: two
  card transfers a read, one of a single sector, into a destination that
  the SD driver copies through a buffer of its own when it is not on a
  cache line. Each download logs its end, and for a failure the cause and
  the entry it was at ([Screens, The page](docs/Screens.md#the-page)).
- The Wi-Fi page follows the browser's dark scheme as a whole: the page,
  its panes, boxes and the viewer's header take the panel's dark theme
  colours, where only the viewer's text area did. Every colour of the page
  is a token of the panel's theme, light and dark
  ([Screens, The page](docs/Screens.md#the-page)).
- The file API's `X-Rcbench-Lines` counts the lines as FILES' viewer and the
  page's `LINE n OF m` do: a line end at the file's end starts no line, so
  a file of 58 lines that ends in LF gives 58, not 59; an empty file gives
  0 ([Screens, The file API](docs/Screens.md#the-file-api)).
- A read of the file API with a body, or with a `Host` that is not the
  panel, gets `{"error":"BODY",...}` with 400 and `{"error":"HOST",...}`
  with 421, as the API's other refusals carry JSON, where the answer had
  no body.
- An install whose build does not start showed no rolled-back banner: the
  build before started again without `Panel firmware … failed to start.`
  on the band. The restart note moves from LP (low-power) RAM, whose
  retention ESP-IDF does not test on the ESP32-P4 and whose address follows
  the build's layout, to one NVS (non-volatile storage) entry, which a
  power cut keeps too. Each start states its check in one console line,
  `start check: note …, last invalid slot …, result …`
  ([Screens, Installing](docs/Screens.md#installing-panel-update)).
- Errors with an IOmcu older than link 4.31: a programming port that holds
  the PD mini keeps it through every error the panel finds but the panel's
  own trips, as [Safety, Errors](docs/Safety.md#errors) says. A supply that
  stops answering or gives no reading, an ON taken across lost touch
  events, and an ON the SUPPLY page refuses while a port's ON is on it ask
  DISARM and write no OFF over the port's supply. A reading fault the port
  keeps is acted on and named once while it stands, and the output goes
  off when the port lets go. The PD mini's own protection and a sagging
  input are followed off whoever holds the supply. An IOmcu of 4.31 or
  later gets the OFF on every error as before. The panel's model is
  switched off on every error, a programming port taken or not.
- A failed final commit or close of the run log or automatic test's CSV
  counts as a card error for the run. It switches the bench to SAFE and
  the supply off, once per run, unless an earlier write failure has already
  done so. The report written after the automatic test is excluded.
- `tools/frame_cost.py` gives the same fills on every run: cachegrind gets
  the ESP32-P4's L1 instruction cache (16KB, 4-way, 64-byte lines) instead
  of the runner CPU's, the bench draws from a stack at a fixed offset
  within 64KB, and the 1-frame and 11-frame runs pass argvs of one length.
  The table holds CI's figures under the new model.
- Safety: removed the claim that the IOmcu acts on overcurrent,
  over-temperature and stall. Those fault bits are defined, but nothing
  sets them.
- Hitec programmer: a D series servo swapped for another of the same
  model inside a session kept the first servo's backup, so RESTORE of the
  session's backup wrote the first servo's values into it and its first
  write saved no backup file. A D series read is of the servo before it
  only while every register a write sends holds the value of the read
  before, or, after a write left unverified, while the record's verdict
  explains the values. Otherwise the read is another servo's backup, with
  `Other values than the last read: taken as another servo.` A servo with
  the values of the last read is not told apart
  ([Hitec programmer, The backup before the first write](docs/HitecProgrammer.md#the-backup-before-the-first-write)).
- SUPPLY: an ON refused while the IOmcu reports its failsafe (FAULT 01,
  the link silent for 200ms, or FAULT 10, the heartbeat) says
  `Supply refused to switch on: IOmcu failsafe latched. Hold ARM, then
  DISARM.` instead of `Supply refused to switch on. Output off.`
- KST and Hitec CONNECT refused for the failsafe name it and the way out:
  `The IOmcu refused: its failsafe is latched. Hold ARM, then DISARM, to
  clear it.` (KST, before `The IOmcu has not yet accepted the link. Try
  again.`); the Hitec line says `Hold ARM, then DISARM, to clear it.`
- Hitec: the German count of stored values outside the settings, loaded,
  restored or written, fits one row of 60 characters at 255; the count no
  longer stands alone on a second row.
- FILES: AKTUALISIEREN and VERSCHIEBEN in the footer are drawn in the
  10 x 20 face of the other buttons, with 4px either side (6px before).
- FILES: the DELETE question names a run's report only when the pane's
  page lists it, or when the report would stand on another page. German
  `Ihr Bericht %s wird mitgelöscht.` (`Sein Bericht` before).
- The panel's link report is printed by the logger task, not by the
  control task that beats the heartbeat: once a minute the report stalled
  that task for 46 to 56ms on the console. A queue of 2 reports carries the
  counters; a full queue prints on the control task, so no line is lost.
- The supply's set points after a KST or Hitec session: the port's (for
  example 1.00A from a Hitec CONNECT) took the place of the operator's on
  the SUPPLY screen and the SERVO screen's SET row for good. The operator's
  come back at the first read of the supply that shows no port holding it
  and the output off: at once when the session ends with the output off, at
  the next OFF after a LEAVE that leaves it on. A set point changed after
  the port let go stands ([Servo programmer, The
  supply](docs/ServoProgrammer.md#the-supply)).
- The Hitec classic LEAVE page and the Hitec docs gave the supply's off
  time as 500ms. The 500ms count from the PD mini's read that shows the
  output off, 250ms after the OFF; the output is off about 760ms, 762ms
  measured on one module
  ([Hitec programmer, LEAVE](docs/HitecProgrammer.md#leave)).

## 0.23.2 - 2026-10-28

0.23.2 is a testing release. Its minor number, 23, is odd. GitHub
publishes it as a pre-release and does not mark it as latest. It runs on the
ESP32-P4 panel, as 0.23.1 does; an ESP32-S3 panel stays on the 0.22 line
and is not offered it. The link protocol is 4.30 (0.23.1: 4.29). A panel running
0.23.2 with an IOmcu running 0.23.1 requests the wait on a LEAVE after a
write when a PD mini is in use and WAIT BEFORE PWM is above 0; that IOmcu refuses it,
and the panel sends the REBOOT without the wait and says `This IOmcu
firmware applies no WAIT BEFORE PWM after the cycle.` The servo then gets
PWM 1000ms after the supply reads on (see Changed). An IOmcu running 0.23.2
with a panel running 0.23.1 receives no REBOOT with the wait and runs the
cycle as 0.23.1 does.

A bench on 0.23.1 gets 0.23.2 over Wi-Fi: SETUP > UPDATES, RELEASES:
TESTING, CHECK FOR UPDATES, then hold the install button for 2s. With RELEASES:
STABLE the check reads `releases/latest`, which names 0.22.1, and offers
nothing. At link-up the panel offers to update the IOmcu over CAN
(Controller Area Network) when the IOmcu runs a different build. To set up a new bench,
load the firmware over USB (Universal Serial Bus) as
[First run, §1](docs/FirstRun.md#1-flash-both-boards) describes, with
`rcbench-panel-p4-v0.23.2.zip` and `rcbench-iomcu-install.uf2`.

### Added

- FILES' text editor: EDIT in the text viewer opens a keyboard of three
  layers under 4 rows of the text (`shared/ui/text_view_keys.c`, the
  keyboard's editor mode in `ui_textkey.c`). ENTER types the file's own
  line end; a tap or `<-` and `->` move the cursor; the text holds 1MiB
  and 65,536 line ends. SAVE writes `<name>.NEW`, deletes the file and
  renames the new one, on the card task, shut while the bench is ARMED or a
  run is logged, and refused on a NUL byte in the first 4kB; a changed KST
  file loses every line the servo programmer reads as a checksum line
  (`kst_file_checksum_line()`), so the programmer reads it as edited; an
  ESC profile's save says it is read at the next start. REVERT and the home tag over unsaved text ask UNSAVED
  CHANGES with STAY and DISCARD; an open from LOGS or FILES over unsaved
  text asks first too. Leaving FILES by another route keeps the editor
  and its text ([The text editor](docs/Screens.md#the-text-editor)).
- FILES' text viewer (`shared/ui/text_view.c`): OPEN on any file but a
  CSV file of LOGS' folders shows it read-only, up to 1MiB and 65,536 line
  ends, read through `cardjob`. 18 rows of 92 cells, or with SMALL 22 rows
  of 115 cells; a line wider than a row wraps with a `..` mark; PAGE UP,
  PAGE DOWN, a drag and the scroll bar scroll it. The bench's words take
  colours by `text_hl`: headings, labels, PASS and FAIL in every language,
  the words of what was not measured, a number by its unit, comments,
  register lines, and JSON and CSV by the file's name. A file with a NUL
  byte in its first 4KiB, over 65,536 line ends or over 1MiB is refused
  with the reason
  ([The text viewer](docs/Screens.md#the-text-viewer)).
- `tools/check_prose.py`: checks Markdown documents against the writing rules.
  Rules: " -- " as a dash, the marketing words, "we"/"our"/"us" and
  "wir"/"unser", history words, exclamation marks, emoji, the stale names
  ESP32-S3, SIMULATION, coprocessor and "usable release". `--check` exits 1
  on a hit, `--long` lists sentences over 40 words, `--report FILE` writes
  the hits grouped by file. Exceptions are in `tools/check_prose_allow.txt`.
  CI runs `--check` in the Host suite job. Units stay with `tools/check_units.py`.
- `protocols/i2c_txq`: a transaction queue for one I2C bus master and its
  driver on the RP2350's I2C blocks. A transaction (up to 5 bytes written,
  6 read, STOP included) goes to the 16-entry FIFO whole and the block's
  interrupt reports its end; nothing waits with interrupts off. Hard
  transactions go before soft ones, then the earliest deadline; a soft one
  past its deadline is dropped. The queue ends a transaction after 1000us,
  checks the lines before a start (10us settle, 50us pull-up probe), tells
  an address NACK from a data NACK, aborts after the byte under way, and
  runs the 9-clock bus clear one half clock per poll with a trial after it.
  A poll from inside a done callback runs after the callback returns, up to
  16 times per outer call, so queue calls never nest deeper than one. A held
  queue starts nothing, also a transaction picked while a line settled: it
  goes back to the queue in its place. The driver's close refuses submits
  from its own callbacks (`I2C_TXQ_E_CLOSED`), so nothing stays queued on a
  closed bus. A callback may shut the queue at any point that runs one; no
  driver function is called after it, and a bus clear it would have
  followed does not start.
  Host-tested over a modelled bus (`test_i2c_txq`, `test_i2c_txq_calls`,
  `test_i2c_txq_wire`).
  The IOmcu links the module but does not call it yet; the sensor bus still
  runs on `sense_i2c.c`.
- `tools/check_protocols.py` takes an `rp2350/` folder without a `.pio`
  file when the module's README says "no PIO program".
- `hardware/kicad/rcbench_modules.3dshapes/`: a STEP model of each of the 12
  modules, generated from a `MODEL` block in its spec by
  `hardware/kicad/tools/step_gen.py`. Each footprint names its model as
  `${RCBENCH_MODULES_3D}/<footprint>.step`. Outlines and positions are the
  footprint's; part heights come from the maker 3D models of the WeAct and
  MATEK boards, from part datasheets, or from part class figures.
  `gen_all.py --check` covers the models, and
  `hardware/kicad/tools/step_check.py` reads each one with OpenCASCADE in CI.
  The AS5600 model carries right-angle headers whose pins leave
  horizontally.
- `hardware/kicad/tools/step_render.py`: renders every STEP model with
  OpenCASCADE; the renders are in `hardware/kicad/renders/` and in the
  library README.

### Changed

- Link protocol 4.30: LEAVE after a write with a PD mini applies WAIT
  BEFORE PWM after the supply cycle. The programmer's REBOOT carries bit 5
  of the KST page's command and the wait in register 28; the port holds the
  line low for 1000ms after the supply reads on and then for the wait, 0 to
  10,000ms, before PWM. ABORT in that wait leaves the port in programming
  mode with the output on, and the next LEAVE has no cycle; STOP, a lost
  heartbeat or the output off releases the pin to PWM. An IOmcu of 4.15 to
  4.29 refuses the bit; the panel sends it the REBOOT without the wait and
  says `This IOmcu firmware applies no WAIT BEFORE PWM after the cycle.`
  ([The wait after a supply cycle](docs/LinkKST.md#the-wait-after-a-supply-cycle)).
- The KST and Chaservo programmer's files on the card use the store of the
  Hitec programmer, `shared/logfile/servo_store.c`, with the stem `KST`; the
  duplicate `kst_store.c` is removed. File names, the folder `BENCH/KST/CONF`,
  the proposed names `KST001` to `KST999`, the reserved name `KST` and every
  refusal stay as they were; `test_kst_store` is replaced by a KST case in
  `test_servo_store`.
- LOGS' OPEN on a report opens it in FILES' text viewer instead of LOGS'
  own text view, which held 32KiB of a file; the home tag returns to LOGS
  with the report chosen again. LOGS' text view and `log_text.c` are
  removed.

### Fixed

- SERVO's TARGET comes back to the programming port within 500ms after the
  IOmcu restarts or a programming session takes the target, with no
  standard servo output bound as a surface. The pending release for a position
  written to the port went to the standard outputs. Finding nothing to
  centre, it remained pending, so the panel never wrote the port back as
  `TARGET`: the row read NO SERVO PWM PIN and the servo test sent no pulse
  (`write_servo()` in `shared/outputs/servo_link.c`, since 0.17.0).
- FILES' RESCAN and the way back into FILES list an entry new on the card
  that ranks before the first row of a pane's first page, such as a log
  the logger wrote as `ATEST001.CSV` into a folder of `SERVO` logs
  (`fm_tree_page()` reads `FM_GO_SAME` on the first page from the
  folder's first entry). Such an entry stayed off the page until the
  bench restarted. A list scrolled to its top stays at the top.
- A turn of the panel's knob while a chip's help bubble is open closes the
  bubble and moves nothing, as a tap does (`ui_router_take_knob()`); before,
  the turn moved the throttle on MOTOR & ESC or the target on SERVO behind
  the bubble.
- The Hitec write switch's page says that an interrupted write leaves a
  wrong checksum and that the servo may ignore PWM and draw current up to
  the supply limit (`HP_ENABLE_3C`).
- CI runs on Ubuntu 26.04 (`runs-on: ubuntu-26.04`) in every workflow. The
  host suite is five parallel jobs, joined by the required job `Host suite,
  coverage and the checks that hold prose to the tree`. `test_settings_sensors`
  formats its keys into a 32-byte buffer (gcc 15 `-Werror=format-truncation`),
  `test_picker_screen` initialises its button coordinates (clang-tidy 21
  `clang-analyzer-core.UndefinedBinaryOperatorResult`), `unqueue()` of
  `protocols/i2c_txq/` does not wrap the queue length below 0
  (`clang-analyzer-security.ArrayBound`), the IOmcu stack figures
  are those of arm-none-eabi-gcc 14.2.1, `tools/render_ui.py` and
  `tools/frame_cost.py` compile with `-ffp-contract=off` so that a compiler
  targeting x86-64-v3 draws the committed images, and the coverage table is the
  one of gcc 15.2's gcov. `tools/coverage.py --from-json` writes the table from
  the `coverage` artifact of a CI run.

## 0.23.1 - 2026-10-27

0.23.1 is a testing release. Its minor number, 23, is odd. GitHub
publishes it as a pre-release and does not mark it as latest. It runs on the
ESP32-P4 panel, as 0.23.0 does; an ESP32-S3 panel stays on the 0.22 line
and is not offered it. The link protocol is 4.29 (0.23.0: 4.28). A panel running
0.23.1 with an IOmcu running 0.23.0 reads the supply-hold flag from either version and
uses the same writes; that IOmcu holds SUPPLY only while a POWER
runs (see Changed).

A bench on 0.23.0 gets 0.23.1 over Wi-Fi: SETUP > UPDATES, RELEASES:
TESTING, CHECK FOR UPDATES, then hold the install button for 2s. With RELEASES:
STABLE the check reads `releases/latest`, which names 0.22.1, and offers
nothing. At link-up the panel offers to update the IOmcu over CAN
(Controller Area Network) when the IOmcu runs a different build. To set up a new bench,
load the firmware over USB (Universal Serial Bus) as
[First run, §1](docs/FirstRun.md#1-flash-both-boards) describes, with
`rcbench-panel-p4-v0.23.1.zip` and `rcbench-iomcu-install.uf2`.

### Added

- `hardware/kicad/`: a KiCad 10 library of the 12 modules the bench is built
  from, for a carrier PCB: RP2350-CAN, INA3221, two INA228 boards (MATEK
  I2C-INA-BM, XT90 board "BIFRC V1.1"), AS5600, WeAct PD Power Mini, the
  USB-C tap, ADS1115, ADXL345 (GY-291), INA219, a USB-C PD trigger and a
  mini buck DC-DC with EN. Footprints and symbols are generated from one
  spec per module (`tools/gen_all.py`, `--check` in CI); geometry comes from
  maker drawings, maker 3D models and photos, each spec naming its source
  and accuracy. MIT, as the rest of the tree. KiCad 10.0.7 or newer opens
  it; 10.0.3 shows the symbol library empty without an error message, and
  the versions between are not tested.
- The register models of servos by Hitec, in `protocols/hitec/hitec_reg.c`:
  the classic EEPROM cells (HS-5xxx, HS-7xxx) and the D series registers
  as one 256-byte image, a parameter table of 34 parameters with the
  registers or cells, encoding, edit limits, layouts and source of each,
  the HFP-30's encodings for the D series and the HPP-21 Plus's for
  classic servos, a stored value that fits no encoding shown raw and
  replaced only by a value of the table on an edit, model identification from register 0x00 or the name cells, and
  write plans: the classic balance in 0x1C after every setting of cells
  up to 0x1B, the D series registers per setting, then save and reboot
  ([Register model](protocols/hitec/README.md#register-model)).
- The session for servos by Hitec, in `protocols/hitec/hitec_session.c`:
  a state machine that hands out steps (a transaction, a supply cycle with
  a listen, a wait) and takes their results. The classic entry cycles the
  supply, answers the servo's `+` and sends `67 00 00 99`; the D series
  entry waits 1000ms after the supply comes on and reads the model. Reads
  of the full set or of any set of addresses with 3 tries each, write
  plans with the classic balance after each setting and the D series
  save, 100ms, reboot and 1000ms, a read-back against the draft, leave,
  abort at every step, and gaps of 2ms (classic) and 20ms (D series) on a
  32-bit microsecond or millisecond clock
  ([Session](protocols/hitec/README.md#session)).
- The panel's link half for servos by Hitec, in
  `shared/bench/hitec_link.c`: one session step (SEND, LISTEN, LEVEL or
  POWER) turned into frames of the HITEC page (0x34) and the page's answer
  into the step's result, and OPEN, CLEAR and CLOSE, the last for any port
  the page holds. The staged registers in 5 frames, the command with `SEQ`,
  check and key, 3 tries of a command whose answer is lost, the page's
  `SEQ` deciding whether a command sent without an answer was taken, a
  read of registers 0 to 15 every 5ms while a request runs, ABORT, the
  25,000ms limit, at most 4 exchanges a pass, and a readout of the held
  port, its flags and pin and whether this module opened it. The servo
  model of the page suites moves to `test/host/hitec_sim.h` and gains the
  classic entry
  ([The panel's link half](docs/LinkHitec.md#the-panels-link-half)).
- The programmer for servos by Hitec on SERVO > PROGRAM, row
  `Hitec servos`: a SERIES row (D SERIES or CLASSIC, kept in the settings
  as SET_HITEC_SERIES), CONNECT with the entry of either series and a read
  of the full set (21 D series registers or 100 classic cells), the model
  identified, MOTION, TRAVEL, PROTECT and INFO with every value decoded and
  its stored value beside it, READ ALL, LEAVE by a 2s hold, CLEAR after a
  switch to SAFE at the bench, and RELEASE PORT by a 2s hold for a port the
  HITEC page holds for another session, after which the switch to ARMED
  clears the IOmcu's latched failsafe. CONNECT is refused, with nothing
  sent, on an ARMED bench, with STOP latched, with the tester on the
  standard outputs, with no pin, before the IOmcu holds the D series
  receive mode, for a classic servo without a PD mini and above the SUPPLY
  limits. While a programmer holds a port, KST or Hitec, ARM, the supply's
  set points and ON, MOTOR & ESC's TARGET row and ESC STICK's run are
  locked, and a press on a locked supply control says why in the alert
  band ([Servo programmer for Hitec servos](docs/HitecProgrammer.md)).
- Writing to servos by Hitec on SERVO > PROGRAM: every writable value of
  both series edited in a draft on the panel (a list of up to 6 entries or
  the keypad, with the range and step of `hitec_reg.c`), CHECK THIS CHANGE
  by a 2s hold for 7 soft rules, ENABLE WRITE TO SERVO by a 2s hold (off at
  every screen entry, CONNECT, LEAVE, STOP, link loss and unverified
  write), WRITE n VALUES by a 2s hold with the changed values listed, and
  the write with its read-back. The values before a write are recorded
  first, on the card in `BENCH/HITEC/CONF/HITEC.TXT` or in RAM without a
  card; the next full read compares the servo with the record, and
  RESTORE writes the values back or discards the record. REPAIR CHECKSUM
  under MORE writes the classic balance in cell 0x1C alone. The file
  manager shows `HITEC.TXT` and `HITEC.NEW` as LOCKED
  ([Writing](docs/HitecProgrammer.md#writing)).
- Servo files, backups, RESTORE and FACTORY DEFAULT for servos by Hitec
  on SERVO > PROGRAM. FILES, in the SERIES row's place while the port is
  held, lists the servo files in `BENCH/HITEC/CONF` 5 a page with each
  file's model, saves the servo as read under a proposed name (`HITEC001`
  to `HITEC999`) or one typed on the text keyboard, and loads a file's
  editable values, raw values included, into the draft; a file of the
  other series or layout, a damaged or hand-edited file is refused, and
  one of another model or past a soft rule opens CHECK THIS FILE. The file
  text is `RCBENCH HITEC 1` with series, model, the read set, a `backup=`
  line and a CRC-16 (cyclic redundancy check). The first write of a
  session saves the servo as found to a backup file first and sends
  nothing when the card refuses it or does not answer in 5000ms; without
  a card the backup stays in RAM. RESTORE writes the session's backup back, every writable address
  included. MORE > FACTORY DEFAULT writes a classic servo's cells 0x00 to
  0x23 from its factory cells 0x30 to 0x53, as the HPP-21 Plus does; the D
  series has none. `shared/logfile/servo_store.c` holds the folder's
  names, proposed names, saves, lists and loads for a file-name stem
  ([Servo files](docs/HitecProgrammer.md#servo-files)).
- A backup file of the Hitec servo read loads every address a write sends,
  the cells outside the settings included: cell 0x22, RESOLUTION, which a
  FACTORY DEFAULT changes and no edit reaches, comes back from the backup
  file saved before it, after LEAVE and a power cycle. `backup=1` marks the
  automatic backup file and a save of the servo as the session found it,
  before the first write; every other save carries `backup=0`. A file
  without the line counts as a backup when its name is `HITEC001` to
  `HITEC999`. The file is of the servo read when series and layout match
  and, for a classic servo, the name cells 0x60 to 0x6F, the date cells
  0x70 to 0x73, the serial cells 0x80 to 0x87 and the version; for the D
  series, the model in register 0x00. CHECK THIS FILE names the count,
  `Stored values outside the settings loaded too: 1.`, and WRITE n VALUES
  counts those cells. A D series file is 149 bytes, the longest classic
  file 290 bytes, of at most 320
  ([Loading a backup file](docs/HitecProgrammer.md#loading-a-backup-file)).

### Changed

- The KST and Chaservo programmer cycles the servo's supply: with a PD
  mini's output on, CONNECT switches it off for 1s, on, and sends the sync
  1s later; LEAVE after a write, a restore or a pairing release switches
  it off for 1s and on before PWM. Without a PD mini the line under the
  state asks for the supply off and on and CONNECT 1s later, the sync
  250ms after the tap, and a write and LEAVE say that the values act after
  the supply is switched off and on. A Chaservo entered programming mode
  from a power-up only and acted on a written value from the next one
  ([The power cycle](docs/ServoProgrammer.md#the-power-cycle)).
- The KST and Chaservo programmer's SERVO tab has a TYPE row where the
  operator sets V6 or V8. Until then, the type suggested by 20k_sel appears
  as `V6?`. A
  save writes the type set, a load is held to it, and a file tapped with
  no type set asks for it first. The LOCKED tab shows 20k_sel as 20K SEL,
  ON or OFF. The tab's rows are SERVO and TYPE, FILES and MORE, ENABLE
  WRITE TO SERVO, RESTORE and WRITE n VALUES
  ([The servo type](docs/ServoProgrammer.md#the-servo-type)).
- Servo files are format 2: the type line states the operator's type and
  may be absent; 20k_sel is a register like any other. Format-1 files
  load, as files that state no type
  ([Servo type](protocols/kst/README.md#servo-type)).
- `KST_PORT_RAIL_OFF_MS` is 1000ms, from 2000ms: a supply cycle of the
  programming port keeps the supply off for 1s.
- A limit run on the programming port without a PD mini writes nothing:
  SEARCH + PROGRAM and SERVO PULSES at 1000-2000 are not offered and the
  card says `PROGRAMMING: NO PD MINI TO SWITCH THE SERVO OFF AND ON`. The
  report's servo line names 20k_sel in place of a type.
- `Servo not in programming mode. Tap LEAVE, then CONNECT.`: the advice
  names the control the state shows.
- FILES' footer runs as LOGS' does: RESCAN at the left, 140 x 52px, then
  COPY, MOVE, RENAME, DELETE, NEW and INFO, and OPEN at the right margin,
  118 x 52px each, 6px apart. One enum (`fs_foot_t`) orders the buttons
  for the drawing and the touch test alike.
- FILES' RESCAN reads each pane again at the page it shows, from the
  page's first entry, and keeps the pane's place: the top row's entry
  stays on top, the selection stays on its entry, and a selected entry gone
  from the card, or moved to another page, leaves nothing selected, as
  after a DELETE, since MOVE and RENAME act on the selection without a
  question. A page that holds fewer rows shows its last 6
  ([RESCAN](docs/Screens.md#rescan)).
- LOGS' file list shows each file's date between its name and its size:
  the modification time the card holds, as FILES INFO shows it, in the
  zone of SETUP > PANEL's Time zone, `2026-10-26 09:41`, in a column of
  160px. A file stamped in 1980, an unset clock's, or with no stamp leaves
  the column empty. The card's directory read carries the FAT (File
  Allocation Table) stamp of each entry (`storage_entry_t.stamp`), so the
  list takes no extra lookup per file. The size box is 100px, and a name
  of more than 60 characters shows its first 58 and `..`
  ([Logs](docs/Screens.md#logs)).
- The panel names a pin `GPIO 13` on every screen, alert and report, as
  SETUP's pin rows do, in place of `GP13`: OUTPUTS' grid and clash lines
  (`SLICE OF GPIO 13`, `GPIO 28: SHARES PWM SLICE WITH PROG PORT GPIO 13`),
  PICK A PIN's PINS and IN USE tables, the TARGET rows of SERVO and MOTOR
  & ESC (`SERVO PWM GPIO 2`, `PROG PORT 1 GPIO 13`), the servo programmer,
  SUPPLY's header (`PD MINI TX GPIO 12 RX GPIO 13`), the sensor and phase
  tap alerts and the limit run's report line `Output:`. One function,
  `ui_pin_name()`, writes the name; a text table entry writes `GPIO %u`.
  OUTPUTS and PICK A PIN draw the name in the 16 x 28 face (112px for
  `GPIO 28`), SUPPLY draws its set point range in the 8 x 16 face, and a
  lone DShot programming port reads `DSHOT300 PORT 2 GPIO 14` in MOTOR &
  ESC's 25-character TARGET box. A TARGET row holds fewer pins before
  `+N`: `SERVO PWM GPIO 2 +2` for three pins.
- Link protocol 4.29: the HITEC page holds the SUPPLY page from the OPEN
  that takes a port to the CLOSE that gives it back, a stopped port
  included, as the KST page holds it out of PWM. SUPPLY sets FLAGS bit 11
  and refuses every write of OUTPUT, SET_MV and SET_MA but an OFF or a
  repeat of the set points in force; POWER switches the supply as staged.
  CLOSE, an ABORT or a stop in STOPPING, an OPEN that ends `NO_LINE` and a
  restart of the IOmcu end the hold. An IOmcu of 4.23 to 4.28 holds SUPPLY
  while a POWER runs only; the panel reads bit 11 from either and writes
  nothing differently
  ([The supply while a port is held](docs/LinkHitec.md#the-supply-while-a-port-is-held)).
- The Hitec programmer's classic texts name a servo's memory addresses
  stored values (`gespeicherte Werte`), as the RESTORE page does, in place
  of cells: `Checksum of stored values 0x00-0x1C is wrong.`, `Writes stored
  value 0x1C: 0x5F -> 0x5E. Stored values 0x00-0x1C then sum to 0.`, the
  interrupted-write lines and FACTORY DEFAULT's lines. A wrong checksum
  says that the servo may ignore PWM (pulse-width modulation) and draw
  current up to the supply limit: one HS-7955TG with a wrong checksum drew
  0.88 to 0.89A under ARM and SWEEP at the PD mini's 1.00A limit, the
  supply falling to 4.0 to 4.2V, and 0.12 to 0.28A with a correct one
  (measured once). REPAIR CHECKSUM tapped while the record of an
  interrupted write stands says `Writes and REPAIR CHECKSUM wait for the
  record of an interrupted write: restore or discard it under RESTORE.`
  ([REPAIR CHECKSUM](docs/HitecProgrammer.md#repair-checksum)).
- The SERVO test report's step table fits the log viewer's row of 92
  characters: currents in whole mA, 6 characters at most, `--` for a
  current that is not a number or beyond 99.999A; the heading in two lines
  with each word right-aligned to its column; `(cut short)` and
  `NOT MEASURABLE` on a line under the step. The heading reads
  `RESULTS PER STEP (currents in mA, times in ms)`. The German encoder
  heading starts each word at the English column
  ([Files](docs/Servo.md#files)).
- The BROWN-OUT result names what is measured: `Movement seen at every
  step down to 4.80V; lower not tested.`, `Movement seen at 5.00V; no
  movement seen at 4.80V.`, and the rule line defines `Movement seen` as a
  reading of a move more than Thresh from the level before it.
- The console's link report diagnoses the counts since the previous
  report, in place of the totals since start-up. It runs every 60s while
  the link is up and every 5s while it is down. A burst of late answers no
  longer keeps it at `LINK answers arrive too late` for the rest of the
  run: a healthy window reads `link healthy` at the next report. A new
  line, `last 60s  polls ... replies ... timeouts ...`, gives the window's
  counts; the other lines give the totals. A window of under 4 polls says
  `link healthy`. An IOmcu that restarts and counts past its previous
  figure before the next report gives a window count short by that figure
  ([Link report](docs/Bringup.md#link-report)).
- The docs, the READMEs, `STATUS.md`, the test bench notes and the
  configurator (pad names, the IOmcu wiring drawing in English and German,
  the setup list, the help texts and the PDF export) name the IOmcu's pins
  `GPIO 13`, as the panel does. The Osoyoo breakout drawing keeps the
  board's print, `GP2`, and a text that names its strip gives it once:
  `GPIO 2 (print GP2)`. The configurator's 81 repository anchors quote the
  docs at `v0.23.1`.
- CI runs every job of `ci.yml`, `docs.yml`, `mutation.yml`, `pages.yml`
  and `release.yml` on `ubuntu-24.04` in place of `ubuntu-latest`, which
  resolves to Ubuntu 26.04 since 2026-10-26. On 26.04 four checks fail on
  code this release does not change: a gcc `-Werror=format-truncation` in
  a host test, a clang-tidy finding in another, the IOmcu stack figures and
  the web help's screenshots.
- The ESP32-P4 panel's code carries Doxygen comments (`@brief`, `@param`,
  `@return`, `/**< */` on members); the X-macro tables over `ui_text.def`
  sit in `@cond X_MACRO`. The baseline of `tools/doc_check.py` loses 1,521
  entries. No executable token changes.

### Removed

- The modelled parameter table for Hitec D-series servos in
  `shared/ui/prog_models.c` and its texts: the Hitec programmer shows the
  register model of `protocols/hitec/hitec_reg.c`.

### Fixed

- A press on the disabled ARM on SERVO or MOTOR & ESC while a programmer
  holds a port shows `Cannot switch to ARMED: a port is in use by the servo
  programmer.` in the alert band.
- The Hitec programmer with STOP latched offers no CLEAR: the foot line
  says `Stopped. The pin is released. LEAVE, then switch to ARMED once to
  clear the STOP.`, as the state line does.
- The Hitec line's answer to the first byte of a LISTEN is 10 bit times:
  start bit, 8 data bits, stop bit. The receiver waits for the next start
  bit from the end of the answer's stop bit, so a byte the servo starts
  right after the answer is received. The PIO (programmable input/output)
  program drops the 6 released bit times at the front of the answer word
  with `out null, 12` and is 30 words long.
- A Hitec transaction that the driver ends 1ms past its longest time
  keeps every byte the state machine pushed before the end: the machine
  is stopped and the receive channel takes the words still in the FIFO
  (first in, first out) before the bytes are counted and the machine
  restarts.
- The KST programmer checks the write's gate again when the card has taken
  the servo's file and when it has taken the write's record, before a
  frame goes to the servo: the port in programming mode on the write's
  port with no operation running, no STOP, the bench not ARMED and ENABLE
  WRITE TO SERVO on. A switch turned off while the card writes, or a port
  that reads PWM by then, ends the write with nothing sent, clears its
  record on the card and keeps the pending values, with the refusal's line
  (`kst_prog_held_gate()`, [Writing](docs/ServoProgrammer.md#writing)).
- A new build's first start logs `kept: ...` or `kept at the 30s bound
  ...` only after the start check has kept it (`FW_BOOT_UPDATED`). A check
  that does not keep it logs `not kept: otadata not written; the next
  start goes back to the build before`. A `RCBENCH_TRIAL_CRASH` build
  aborts before the check and before any `kept` line.

## 0.23.0 - 2026-10-25

0.23.0 is a testing release. Its minor number, 23, is odd. GitHub
publishes it as a pre-release and does not mark it as latest. It is the first
release for the ESP32-P4 panel, the 7-inch ESP32-P4 display board from
Waveshare (ESP32-P4-WIFI6-Touch-LCD-7B, chip revision 3.2, 1024 x 600
pixels). 0.22 is the last release line for the ESP32-S3 panel and 0.22.1
its last release: an ESP32-S3 panel is offered 0.22.x patch releases only,
and no 0.23.0 or later release. The IO board and the CAN (Controller Area
Network) link are as in 0.22.1; the IOmcu image adds the reset-cause report
listed below, and the link protocol stays 4.28.

A new bench loads 0.23.0 over USB (Universal Serial Bus) as
[First run, §1](docs/FirstRun.md#1-flash-both-boards) describes: the IOmcu
with `rcbench-iomcu-install.uf2`, the panel with `rcbench-panel-p4-v0.23.0.zip`
and `esptool.py --chip esp32p4`. A later release reaches an ESP32-P4 panel
over Wi-Fi: CHECK FOR UPDATES with RELEASES: STABLE reads `releases/latest`,
which names 0.22.1 until a stable release for the ESP32-P4 panel exists, so
it reads `Up to date. Panel version: 0.23.0.`; with RELEASES: TESTING it reads the 10 newest
releases. At link-up the panel offers to update the IOmcu over CAN when the
IOmcu runs another build. The USB-C socket for flashing and the procedure for entering download
mode are not documented for this release.

### Added

- PICK A PIN draws a cat: one of 8 drawings (3 sitting, 1 with a paw
  raised, 2 asleep, 1 looking over an edge, 1 loaf), picked at random on
  each visit among those whose spot, bottom left or bottom right, has no
  row, key or list within 4px. It is drawn with the screen's static parts,
  so a frame that repaints nothing draws nothing for it, and it takes no
  taps. `tools/gen_cats.py` draws the cats and writes them as run-length
  encoded RGB565 (red, green, blue in 5, 6 and 5 bits) with 4-bit alpha,
  117579 bytes for the 8; CI (continuous integration) checks the table
  with `--check` ([Screens](docs/Screens.md#pick-a-pin)).
- The panel sets its clock by NTP (Network Time Protocol). Each join of
  the home network, the release check at start included, asks
  `pool.ntp.org` once, for at most 30000ms, and logs
  `ntp: pool.ntp.org set 2026-10-24 14:03:12 UTC, offset +...s from the old
  clock`. A join that ends before the answer, the release check's own end
  included, keeps the radio up for it, 30000ms from the request at most;
  ARM, STOP, the supply, a log run, an install and a failed radio take it
  down at once. SETUP > PANEL has a Time zone row: UTC, LONDON, BERLIN, HELSINKI,
  NEW YORK, CHICAGO, DENVER, LOS ANGELES, TOKYO and SYDNEY, BERLIN by
  default, with daylight saving. File stamps, FILES INFO, the Wi-Fi page and
  the ZIP file use it. The board has no RTC (real-time clock) chip: the
  clock starts unset at each power-on, and a software restart keeps it. A
  1980 stamp, an unset clock's, reads `not known` on FILES INFO and leaves
  the Wi-Fi page's time cell empty
  ([Building](docs/Building.md#the-panels-clock)).
- The panel's RTC timer, which keeps the clock across a software restart,
  counts the board's 32.768kHz crystal Y3 instead of the internal RC
  oscillator. The crystal's drift is at most about 30ppm, measured over
  65min; the RC's is not a fixed figure (584ppm over 2h04min in one run,
  under 15ppm over 1h51min in another). A crystal that does not
  start leaves the panel on the RC. Each start logs the slow clock, e.g.
  `clock: rtc slow clock 32k crystal, 32768.012Hz calibrated`
  ([Building](docs/Building.md#the-rtc-slow-clock)).
- A SERVO run's log, `SERVOnnn.CSV`, has `pulse (us)` and `angle (deg)`
  before `source`: the pulse COMMANDED shows and the AS5600 angle MEASURED
  shows, empty without one. While an INA3221 channel is the servo rail's
  meter, `voltage`, `current` and `power` are its newest 50ms window's,
  otherwise the supply's. A MOTOR run's header and rows stay as they are.
  LOGS reads up to 25 columns, the fullest SERVO file, and opens a SERVO
  file with `pulse`, `angle`, `current` and `voltage` chosen.

- The IOmcu says why it last started. A console line at start-up and every
  3s names the cause and carries every raw value it was read from:
  `reset FLASH_UPDATE (chip_reset 0x00010000 reason 0x1 boot ... params ...
  scratch ...)`, from POWMAN CHIP_RESET, WATCHDOG REASON, the boot ROM's
  boot word and reboot parameters, and WATCHDOG SCRATCH2 and SCRATCH3. The
  words are POR, BOR, RUN_PIN, GLITCH, DEBUGGER, POWER_DOWN, FLASH_UPDATE,
  RAM_IMAGE, BOOTSEL_REBOOT, SW_RESET, WATCHDOG and UNKNOWN
  ([Bring-up](docs/Bringup.md#why-the-iomcu-last-started)).
- A tap on a number's value opens the keypad on every row that sets a
  number: SETUP's PANEL, INTERFACES and SENSORS lists, ESC STICK's TIMING
  and BALANCE's blade count, beside the `-` and `+` keys, which stay. The
  keypad names the setting, its range and its unit and takes the step's
  digits after the point. OK sets the value through the call a step ends
  in, onto the nearer step, and SAVE keeps it as it keeps a step. A value
  outside the range keeps the keypad open and names the range in the
  warning colour. A value the step keys cannot reach also keeps it open, with the reason
  replacing the range until the next key: `0 or 5.0 to 1000.0mΩ` for
  a SENSORS shunt between 0 and 5.0mΩ, `0 or 10 to 32767mA` for a
  LIMIT row between 0 and 10mA, `Pins the bus takes: 0 4 6 14
  16 18 20 26` for a Sensor SDA pin the bus cannot have, listed from the
  check the row's keys use, and `The other PD mini pin holds this GPIO`.
  A shunt of 44.4mΩ from the 100.0 default is five keys, where `-`
  takes 556 steps.
- SERVO > SETTINGS > OUTPUT > TRIM opens a signed keypad: a `+/-` key
  between the point and OK, -200 to +200us, onto the 5us steps of `-` and
  `+`. Keypads of unsigned rows keep their keys where they were; a pin's
  -1, not set, is still set with `-`.
- A settings value with a step finer than 0.1 shows the step's digits after
  the point, and one with a step of 1 none: ESC STICK's Current limit reads
  1.25A where it read 1.2A, MOTOR & ESC's Internal R 18mΩ where it
  read 18.0.
- ESP32-P4 panel: Wi-Fi through the board's ESP32-C6 on SDIO (Secure
  Digital input/output) slot 1, CLK GPIO18, CMD GPIO19, D0 to D3 GPIO14 to
  GPIO17, the C6's enable on GPIO54, 4 bits at 40MHz. The `esp_wifi` calls
  of the WI-FI session, the release check and the download reach the C6
  through the managed components `esp_wifi_remote` 1.6.5 and `esp_hosted`
  2.13.0 (Apache-2.0; esp_hosted carries the protobuf-c runtime,
  BSD-2-Clause, in NOTICE), pinned in `firmware/panel/dependencies.lock`. The
  first Wi-Fi start logs the C6's firmware version. A C6 that does not
  answer at the first start, or an SDIO link that fails later, ends the
  session, holds the C6 in reset (GPIO54 low) and leaves Wi-Fi off until
  the next start; the panel does not restart for it. The card's mount
  starts SDMMC slot 0 before ESP-IDF's mount, so a slot 0 that does not
  start leaves the controller and the C6's link running. Every task created
  through `xTaskCreate()` or `xTaskCreatePinnedToCore()` without a core
  runs on core 0, so esp_hosted's 6 tasks at priority 23 stay off the
  control task's core; the console lists every task's core and priority at
  start-up.
- Four glyph tables for the 1024 x 600 panel: 10x20, 12x24 and 20x36 text
  faces and a 32x44 numeral face (20,400, 29,376, 73,440 and 38,016 bytes
  of flash), and the roles `UI_FONT_FINE` (8x16) and `UI_FONT_BODY`
  (12x24). Cap heights are 12, 15, 23 and 40px. The 32x44 numeral face
  cuts `#` (5px), `$` (16px), `(` (12px), `)` (12px), `,` (23px) and
  `/` (6px) at the cell edge; the three text faces cut nothing, which
  `gen_font.py --check` verifies. The screens draw with them (see Changed).
- The console names each SERVO test file as it opens and closes:
  `logging to .../ATEST004.TXT` when the report opens after the CSV,
  `.../ATEST004.CSV closed, 212 lines` or `... closed short: a write or the
  close failed, 212 lines sent` at its close, and the same for
  `LIMITnnn.TXT`. A test that gets no file logs `no test file in ... (take
  n); this test is not recorded`.
- ESP32-P4 panel: the frame cost and the stacks are modelled and held in
  CI. `tools/frame_cost.py` counts L2 cache-line fills under the P4's L1
  (64KiB, 2-way) and L2 (128KiB, 8-way) caches and holds 27 modes to
  ceilings; `tools/stack_check.py` decodes the P4's RISC-V code
  (`tools/stack_riscv.py`) and holds every panel task's deepest chain and
  1024 bytes to its stack. The console logs, with the build option
  `RCBENCH_PERF_LOG` (default ON), at most one line a frame: a rate line
  every 300 frames with fps, DRAW, WAIT, TURN and VSYNC, a window line with
  DRAW, WAIT and TURN as min/mean/max on the screen shown, the PSRAM probe
  at start-up, and every stack's high-water mark and the internal heap's
  lowest figure, the stacks scanned every 6th rate line on a SAFE bench
  with the supply off ([Performance](docs/Performance.md#on-the-board)).

- FILES, the SD card in two panes. SETUP's ninth tile, FOLDERS AND FILES,
  and a FILES key in LOGS' footer open it. Each pane is 500px wide, shows 6
  rows at a 48px pitch in pages of 48 entries and has a 56px scroll bar.
  The footer keys are OPEN, COPY, MOVE, RENAME, DELETE, NEW, INFO and
  RESCAN. An entry that starts with `.` or is longer than 63 bytes is
  counted as `+ n NOT LISTED`. A name takes 59 bytes at most.
  Writes run only while the bench is SAFE and no log file is open; a key
  the rule refuses is drawn dimmed, and a tap says why. A copy, move or
  delete runs on its own task (`cardjob`, priority 1, core 0, 6656 bytes of
  stack) in chunks of 16KiB. It stops before the next chunk on CANCEL, on a
  switch to ARMED and when a run starts logging, and it removes its `.NEW`
  part file. The bench's folders are FIXED, the servo programmer's record
  is LOCKED, a file the logger writes shows WRITING, and the fault log can
  be copied or deleted only with the IOmcu link up. After each copy the
  console logs the size, the time and the rate in kB/s. OPEN on a log CSV
  or a report in the three log folders opens it on LOGS; OPEN on any other
  file names where LOGS opens files. The text viewer and editor are not in
  this release. The message line is worded when it is drawn, so a result or
  refusal on it follows a change of the interface language.
- SETUP > PANEL has a Screen rotation row, NORMAL or 180°, NORMAL by
  default, after Contrast. A step applies on the next frame without a
  restart, and SAVE keeps it. The row is held while the bench is ARMED:
  it has no keys and the settings calls leave it. NORMAL draws into the
  frame buffer as before. 180° draws into two logical buffers in PSRAM
  (2 x 1,228,800 bytes, allocated at start-up in both settings) and
  copies what a frame changed, in rectangles of 16-row bands, at most 8
  per flip, into the frame buffer at the turned place with the PPA
  (pixel-processing accelerator). Touch turns with the picture; the touch
  injector's contacts stay in logical pixels. A flip has 50ms for its
  copies. A copy that times out or that the PPA refuses makes the flip
  copy the logical buffer unturned with the CPU; picture and touch both
  fall back to NORMAL until the next start, the stored setting stays 180°,
  and the band says `Screen rotation 180° failed. NORMAL until restart.`.
  The PPA's copy time on the board is not measured; the console's
  300-frame line carries `TURN <n> us`, the last flip's copy time. The
  build copies ESP-IDF's `esp_driver_ppa` with the change that Espressif's
  `esp_lvgl_adapter` 0.6.4 ships for the PPA hang DIG-734.
- The touch injector (`testbench/touch-injector`) runs up to 5 contacts
  at once, as the GT911 reports them: a frame carries every contact that
  is down, lowest ID first. `tap`, `hold` and `swipe` take `id=N` (0 to
  15), `release` takes it, `contacts` lists the contacts, and a sixth
  contact answers `err full`. A command without `id=` drives contact 0 and
  its reply is word for word as before; `ping` still reports protocol 1.
  The station can press DISARM or STOP with a second contact while a drag
  is under way.
- The console says when the rotary knob's MT6701 first answers a poll and
  when it stops: `knob: found at 0x06 on I2C1 (GPIO30/31)` and `knob:
  lost at 0x06 on I2C1 (GPIO30/31)`. One line per change; a panel without a
  knob prints nothing.
- The release workflow names the panel's assets `rcbench-panel-p4-<tag>.zip`
  and `rcbench-panel-p4-<tag>.bin`, and `SHA256SUMS` lists them. The update
  check of an ESP32-P4 panel looks for `rcbench-panel-p4-vX.Y.Z.bin`
  (`shared/fwupdate/fw_release.c`), so an ESP32-S3 panel, whose assets carry
  no `p4`, finds no entry for 0.23.0. The ESP32-P4 panel's release line is
  not capped: a check on STABLE or TESTING offers any release newer than the
  running build (`FW_REL_LINE_CAPPED` 0); the ESP32-S3 panel's line stays
  at 0.22.x.
- The panel stops the bench when its render loop stands still. While the
  bench is ARMED or the supply output is on, a render loop that completes
  no pass for 1000ms (`FRAME_WATCH_MS`) is answered as a STOP: the
  heartbeat drops, the IOmcu fails safe within 150ms and the supply output
  goes off. The alert reads `Screen stopped updating for 1s. Switched to
  SAFE, output off.` (`Bildschirm 1s ohne Aktualisierung. Auf SAFE
  geschaltet, Ausgang aus.`). A SAFE bench with the supply off is never
  stopped. Current limits: one card read of 1000ms or more on LOGS while a
  programming port holds the supply on, and the servo programmer's card
  look while its session holds the supply on, stop the bench; a display that
  sends no frame-done event makes each flip wait 200ms and does not trip
  the watch ([Safety](docs/Safety.md)).

### Fixed

- LOGS lists every report: `ATESTnnn.TXT` beside its `ATESTnnn.CSV`, which
  it left off its list, now stands as a row of its own after the run's CSV
  and opens as text. FILES' OPEN on a file its list labels REPORT
  (BERICHT) in ROOT, USER or BENCH opens it in LOGS on that tab, where it
  refused `ATESTnnn.TXT` beside its CSV with `LOGS opens .csv files and
  reports in ROOT, USER and BENCH.` Both take one rule
  (`log_select_lists()`), the one FILES labels a report by. A file the
  logger still writes greys OPEN and reads `ATEST012.TXT is being written.`;
  a file gone since FILES listed it reads
  `LIMIT013.TXT is not on the card. Tap RESCAN.` The panel walks a folder
  once a page; the second walk and its 1,750 bytes of PSRAM are gone.
- The `wifi_ctl` task, which stops the radio and logs the NTP result,
  runs on a stack of 6912 bytes instead of 5120. Its deepest call chain,
  3744 bytes through `snprintf()`, left 352 bytes above the 1024-byte
  margin and now leaves 2144. The 1792 bytes come from internal RAM
  ([Performance](docs/Performance.md#stacks)).
- In the light theme a button that takes no press drew as a dark slab,
  darker than the enabled buttons beside it. A disabled button now takes
  the theme's ground colour with a dim edge and a faint label in both
  themes. The overview's `rcbench` mark was near-black on a near-black
  box in the light theme; its text now takes the panel colour on a dark
  fill.
- UPDATES without a home network said `No home network saved.` and the
  line under it twice, once in the status lines and once as the check's
  result. The result is left out while the status lines say it.
- RECEIVER drew CH17 and CH18 as buttons that took no tap. They are lamps
  now: a pill whose dot lights while the channel is set.
- A host Release build (`-DCMAKE_BUILD_TYPE=Release`) stopped on -Werror
  warnings that the Debug build does not raise: a buffer of 8 bytes for
  `+%u` on MOTOR & ESC's TARGET, and four host tests. It builds and passes.
- LOGS formats its footer message when drawing it, so changing SET_LANGUAGE
  also translates a message already displayed: a refused open or delete,
  a deleted file's name or the reader's verdict on a file.

- A new panel build's first start is kept once the panel works as a whole:
  the card tried, the settings loaded, the control and logger tasks one
  pass each, a whole frame on the display and a screen loop tick after it,
  or 30s after the start once the screen loop ticks. The IOmcu is not
  waited for. A panic or reset before that goes back to the build before
  it. A build accepted after only display and touch checks could fail later,
  restart indefinitely and require USB (Universal Serial Bus) recovery
  ([Screens: PANEL UPDATE](docs/Screens.md#installing-panel-update)).

- A glass GT911 that latches I2C (Inter-Integrated Circuit) address 0x14
  at its reset is read as the glass, with both axes mirrored and the 180°
  turn, and no longer as the touch injector through its unmirrored map,
  which landed every touch point-reflected: STOP missed, and a finger on
  the reflected point of ARM held ARM. The panel tells the injector by its
  product ID `9INJ`, which no Goodix controller reports, not by its
  address. Beside a glass at 0x5D, a GT911 at 0x14 without it is not read.
  The touch injector reports `9INJ` and its `ping` reply ends with
  `id=9INJ`; an injector image without it has to be flashed again
  ([touch injector](testbench/touch-injector/README.md)).

- A line on OUTPUTS and PICK A PIN no longer ends with a number alone on
  the next line: `SERVO TESTER DRIVES PROG PORT 1` broke before its `1` at
  30 cells, and now breaks before `PORT 1`. A word of digits alone goes
  down with the word before it.

- STOP and DISARM on MOTOR & ESC and on SERVO act on the press, not on the
  release. On the panel a STOP held 600ms stopped the pulses 0.62s after
  the press, at the lift, and a DISARM held 600ms 0.618s after it. The
  control task's own STOP test and the router's both act at the press; a
  press on DISARM takes no hold, so a finger left on it arms nothing. ARM
  stays a 2s hold.
- A press handled by the router -- on the band, STOP, the home tag, a chip
  or the alert band -- ends another finger's dial or slider drag, as a
  press on the screen does. A STOP pressed during a SERVO dial
  drag let the pulse follow the drag for the whole press.
- The SERVO dial's drag filter stops where it is when a press, a release
  at the band's edge or a touch loss ends the drag, and at every command
  other than its own and a restated position, the knob's included when it
  comes to the filter's last pulse.
- ESP32-P4 panel: the .bss that `firmware/panel/main/psram_bss.lf` names
  is in PSRAM (pseudo-static random-access memory): 29 objects, 166,472
  bytes of `.ext_ram.bss`; internal .bss is 29,408 bytes instead of
  195,880. The fragment
  defines its own scheme, `rcbench_extram_bss`: the `extram_bss` scheme it
  named is defined only in `esp_wifi`'s fragment, which the P4 build does
  not include, and ldgen skipped the mappings without a message. CI fails
  through `tools/psram_bss.py` when a named object keeps .bss in internal
  RAM.
- WI-FI > CHOOSE HOME NETWORK: a failed scan no longer reads as an empty
  list. A scan session starts one scan, however often the station's start
  is reported: esp_hosted 2.13.0 sends it from `req_wifi_start()` and from
  its event handler, and a second `esp_wifi_scan_start()` replaces the
  first, which then reports done with nothing found. Each scan has a token
  that the refusal, the done report and the retry carry: a callback from a completed scan
  cannot affect a session started after it. At the
  radio's stop the worker waits, 2000ms at most (`DRAIN_MS`), until the
  event loop has handled the radio's last events, so a done report of a
  radio taken down is never read as the next radio's. A failed
  scan, a list that cannot be read and a read that does not hold what the
  report counts (or a full buffer of 24) run the scan again, 3 scans at
  most (`WA_SCAN_TRIES`) within the 10s; then the list's place says
  `Wi-Fi could not start.` instead of `No WPA2 or WPA3 network found.`, as
  it does for a scan the radio refuses. The console logs each scan's start,
  its done report (status, counted, read, listed, left off) and an ignored
  report.
- A SERVO run's log, `SERVOnnn.CSV`, carries the supply's figures in
  `voltage`, `current`, `power`, `charge` and `energy`: the PD mini's last
  reading at each row, current to 0.001A, and charge and energy counted
  from those readings since the switch to ARMED. These cells were empty on
  a bench without an ESC or an INA228. The header and a MOTOR run's rows
  stay as they are.

- Taking the radio down no longer waits for a name lookup that has not
  answered. `radio_down()` gives the GitHub fetch task 1.5s
  (`FETCH_GRACE_MS`), then stops the station, destroys the interface and
  sets the radio down; the 20s wait for the task (`FETCH_EXIT_MS`) is gone.
  While the task lives no fetch job starts (BUSY), and a WI-FI session does
  not wait for it; its late report is dropped by the job's generation.
  With the first DNS (Domain Name System) server not answering, an ARM
  during the release check at start left a WI-FI JOIN tapped then waiting
  13.9s; the station dropped 1.55s after the ARM on the bench. Not
  measured on the board with this build. lwIP tries a first DNS server at
  0s, 1s, 2s and 4s and the next at 7s, so a first server that does not
  answer delays each name lookup after a join by about 7s;
  `DNS_MAX_RETRIES` and `DNS_TMR_INTERVAL` are not in ESP-IDF v5.5.5's
  Kconfig and stay at lwIP's defaults. The console logs one line per join
  with the servers the interface holds: `wifi: dns <first>, <second>`.
- UPDATES: a job ended or refused for the WI-FI screen shows no result line
  once the radio is off and nothing asks for it, so `Stopped: the WI-FI
  screen is using Wi-Fi.` no longer stays after the WI-FI session ended.
- The panel's web page refuses requests that come from another site. The
  Host header has to name the panel (`rcbench-XXXX.local`, the bare name
  or the IPv4 address the connection came in on), otherwise the answer is
  421. POST /code and POST /update need an `Origin`, or without one a
  `Referer`, of `http://` plus such a host, otherwise 403; POST /update
  also needs `X-Rcbench-Upload: 1`. A refused POST to /code does not count
  toward the 16 wrong codes. A /code body over 95 bytes gets 413. The
  Cookie header is read up to 1025 bytes. The SHA-256 check of an uploaded
  image runs outside the lock the page's other requests take. Receive and
  send time-outs are 5s; an upload ends after 30s without data. Three
  limits on the home network stay and are listed in `SECURITY.md`: NTP
  answers are not checked, mDNS (multicast DNS) answers unicast queries
  from any source, and a slow request head holds the single server task.
- The web page's listing of the card reads each folder once per pass
  through FatFs's directory handle instead of one `f_stat()` per entry,
  and stops at once on an abort. On the host model, 1000 files in one
  folder cost 4,012 directory records instead of 2,006,020. The time on
  the panel is not measured; the station measured 25.9s for a 168-row
  listing before the change.
- FILES' COPY and DELETE refuse `RCBENCH.LOG` and `RCBENCH.OLD` as busy
  while the fault log has a line waiting or being written; OPEN still
  works and RENAME stays refused.
- SERVO > TEST names the running test as the reason: START LIMIT RUN reads
  `AUTOMATIC TEST IS RUNNING` (`AUTOMATISCHER TEST LÄUFT`) while the
  automatic test runs, and START TEST reads `LIMIT RUN IS RUNNING`
  (`ENDLAGENLAUF LÄUFT`) during a limit run. `LAST REPORT STILL WRITING`
  stays for a report that is being written.
- MOTOR & ESC with TARGET `NO MOTOR PIN`: ARM is drawn dimmed and takes no
  press; a tap says `Cannot switch to ARMED: no motor pin. Choose a TARGET
  on OUTPUTS.` (`ARMED gesperrt: kein Motor-Pin. Unter OUTPUTS ein ZIEL
  wählen.`). DISARM stays live. A hold under way when the pin goes ends
  without arming.
- The mode line of a limit run report says that no search ran if the run
  ended before its first search.
- INTERFACES, Tap pin offers the pins of the RP2350-CAN module that are
  brought out and not reserved: 0, 1, 2, 4 to 7 and 13 to 22, without the
  ADC (analog-to-digital converter) pins GP26 to GP29. GP23, which the
  module does not bring out, is gone. A stored pin outside the set becomes
  the default 22; the keypad refuses a typed one and lists the pins
  (`Pins the tap takes: %s`, `Pins, die der Abgriff nimmt: %s`).

### Changed

- The ARMED chip in the band draws the dark text of the buttons on bright
  fills: 5.45:1 in the dark theme (3.51:1 before), 4.94:1 in the light one
  (4.67:1 before).
- The help pages name the IOmcu release where they named a link protocol
  number: `older than 0.18.0`, not `older than protocol 4.18`.
- Release images are built with `RCBENCH_PERF_LOG=OFF`: the panel prints no
  rate, window, PSRAM probe, stack or heap lines. The CI build, the bench
  builds and a local `idf.py build` keep the option ON. `release.yml` and
  `ci.yml` run `tools/check_perf_log.py`, which fails when a release image
  holds the start-up probe's text, the stack scan's text or `scan_stacks`
  ([Performance](docs/Performance.md#on-the-board)).
- CI keeps cppcheck's build directory between runs, so cppcheck re-reads
  only the files whose content or included files changed. cppcheck runs in
  a job of its own, `cppcheck`, beside `Lint and static analysis`, which
  runs clang-tidy over every file on every run.
  `test/host/render_screen.c` poses the views of each screen group in a
  function of its own; cppcheck's exhaustive check of the file takes 144s
  instead of 673s on one core of an AMD EPYC 7402P.
- An IOmcu too old for a page is named by the first release whose IOmcu
  speaks it, the number UPDATES shows, not by the link protocol: `IOMCU
  OLDER THAN 0.22.0: SERVO PWM ONLY` instead of `4.26`, `Update the IOmcu
  to version 0.17.0 or later.` instead of `4.13`. Protocol 4.6 is 0.13.0,
  4.9 0.15.0, 4.11 0.16.0, 4.13 and 4.15 0.17.0, 4.23 0.21.1, 4.24 to 4.27
  0.22.0; 13 texts in English and German.
- Every hold names its time in one pattern: `HOLD 2s TO ...`, in German
  `2s HALTEN ZUM ...`. The KST programmer's holds, HOLD 2s TO APPLY, ESC
  STICK's HOLD 2s TO RUN, UPDATES' `HOLD 2s TO DOWNLOAD & INSTALL` and
  `HOLD 2s TO UPDATE THE IOMCU`, WI-FI's `HOLD 2s TO INSTALL` and OUTPUTS'
  `HOLD 2s TO CLEAR ALL PIN ASSIGNMENTS` follow the BUSFAULT and SERVO
  holds.
- German texts that were English outside the text table: the pin holders
  on OUTPUTS and PICK A PIN (`HEARTBEAT`, `BELEGT` for in use), RECEIVER's
  `ENDBYTE FALSCH` for BAD TAIL, and the splash's `Panel-Firmware` and
  `Protokoll 4.28, Firmware 0.22.1` lines. The plot legends VOLT, CURR,
  PWR, RPM, VSET and ISET stay English, as the channel names.
- Units: MOTOR & ESC's temperatures read `ESC 33°C`; SERVO's dial says
  `deg` after its angle, as the readout under it; the SETUP leave question
  names a pin's -1 as the row's help does and writes a pin as `GPIO 4`,
  the word first, in the question, on the row, in the keypad's entry and in
  its range line (`GPIO 0 to 54`): `PD mini TX: open -> GPIO 4`.

- A battery's cell count joins its number as a unit symbol: the pack's
  Cells keypad gives its range as `1 to 14S` (`1 bis 14S`). A unit keeps
  its own case in a label of capitals: SERVO's run cards say `HOLD 2s TO
  START` (`2s HALTEN ZUM STARTEN`), and the automatic test's steps read
  `4.8 6.0V BROWN-OUT`. `tools/check_units.py --check` fails on a cell count
  after a space and on a unit in capitals after a number in the texts the
  panel shows (`500MS`, `50 HZ`).
- The ESC profiles' texts the panel shows write a number and its unit
  together, as the rest of the interface does: `1.2-1.8ms`, `Nach 2s`,
  `8kHz`, 683 numbers in 624 texts of 67 of the 72 profiles. These are the
  strings `tools/gen_esc_profiles.py` compiles into the panel, and
  `tools/check_units.py --check` holds them; a word after a number keeps
  its space (`3 beeps`), and the profiles' research fields stay as written.
- A resistance reads with the ohm sign: `120Ω`, `2.2kΩ`, `100.0mΩ`, in the
  screens' texts, the settings' units (`uΩ` for the INA228's shunt) and the
  servo test's and the limit run's `.TXT` reports, in English and German.
  The panel font's O reads close to a zero, so `120Ohm` read as `1200hm`.
  The five text faces carry U+03A9, 1,784 bytes of glyphs more. The docs
  and the web help write Ω too; the settings' stored keys (`pack_mohm`,
  `ina228_uohm`) stay as they are.

- A number and its unit stand together, with no space: `40s`, `6.00V`,
  `20ms`, `100%`, `180°`, `100.0mΩ`, in English and German. This holds
  for every screen text, the servo test's and the limit run's `.TXT`
  reports, the Wi-Fi page, the web help, the docs and the code's comments.
  A word after a number keeps its space (`3 servos`), and so do the log
  and console lines, the CSV headers and the KST servo configuration file.
  `tools/check_units.py --check` holds the rule in CI; its exceptions are
  in `tools/check_units_allow.txt`, each with its reason.

- `tools/check_sizes.py` counts code lines: a line that is not blank and
  not comment-only. Block and `//` comments, Doxygen blocks included, and in
  Python `#` comments and docstrings do not count; a line with code and a
  trailing comment does. The limits are 1,000 and 1,300 code lines. 26
  entries of `tools/check_sizes.txt` whose files hold 1,000 code lines or
  fewer are removed, and the figure recorded for `shared/bench/kst_prog.c`
  is 1,938 code lines.
- Every text the interface shows or writes in the operator's language is
  one entry of `shared/text/include/ui_text.def`, with its English and its
  German side by side: the screens' strings, the settings' labels, help
  lines, categories and options, the servo test's words and the Wi-Fi
  page's. `shared/ui/ui_text_de.c` and the English in the settings schema,
  `servo_str.c` and `wa_page.c` are gone; every string is unchanged.
  `tools/merge_texts.py merge` carries text changes made in the old form
  into the table ([Interface language](docs/Language.md#the-tables)).
- The panel firmware targets the 7-inch ESP32-P4 display board from
  Waveshare (ESP32-P4-WIFI6-Touch-LCD-7B, chip revision 3.2) and no longer
  builds for the ESP32-S3-Touch-LCD-7. ESP-IDF v5.5.5, target `esp32p4`,
  32MB flash with two application slots of 7936kB. The EK79007 panel runs
  on 2 MIPI DSI (Display Serial Interface) lanes at 1000Mbit/s each, 1024 x
  600 RGB565 at 60.38Hz (measured on the console's VSYNC figure), two
  frame buffers in PSRAM; the UI draws the whole glass. Touch is polled
  (the GT911's INT line does not reach the chip) and mirrored in x and y.
  The card
  mounts over SDMMC with 4 data lines; CAN runs on GPIO22 (TX) and GPIO21
  (RX) from the 40MHz crystal; the rotary knob has an I2C controller of its
  own. The heartbeat pin is IO28 and the knob pins are IO30 (SDA) and
  IO31 (SCL), all on the 12-pin header P3. Its Wi-Fi radio is the
  board's ESP32-C6 on SDIO, listed under Added.

- The user interface is laid out for the 1024 x 600 glass; it is not the
  800 x 480 layout scaled up. `shared/ui/include/ui_layout.h` holds the
  geometry once: the band is 60px, the body 540px, the alert band 44px
  (y 556 to 599), the margin 8px, a button 48px (tall 56px) and the
  smallest tap target 48px. The type roles are 10x20 (`UI_FONT_BAND`,
  labels, notes), 12x24 (`UI_FONT_BODY`, prose), 20x36 (`UI_FONT_TAG`,
  heads) and the 32x44 numerals. STOP is 168 x 48px from x 850; the band's
  chips are 44px tall, the home tag 44px; a help bubble is 640px (60
  cells) and the FAULT bubble 1008px (97 cells); the alert band holds up to
  2 rows of 97 cells. The hold flash runs by time, two cycles of 25ms
  white, black and settled, 150ms in all, at any frame rate. Every stop
  control ends above the alert band. The screens laid out: OVERVIEW (4 x 2
  tiles of 243 x 255px), SETUP and its lists (3 x 3 tiles of 328 x 130px;
  984 x 428px lists of 6 rows at a 70px pitch), the keypad (keys 145 x
  84px) and the on-screen keyboards (key labels 10x20 to 20x36), LOGS,
  SERVO (LIVE, TEST, SETTINGS, PROGRAM, the KST programmer and the limit
  run), MOTOR & ESC (LIVE, TABLE, SETTINGS, PROGRAM and ESC STICK), SUPPLY,
  OUTPUTS and PICK A PIN, RECEIVER, BATTERY, BALANCE, WI-FI, UPDATES, the
  update screens, BUS FAULT and SPLASH. A plot holds 1,024 samples, 51.2s
  at 20Hz. The touch map and the touch injector use 1024 x 600.
- A clipped repaint draws what lies in its clip: a glyph, a seven-segment
  digit, a disc, a capsule or a ring outside the clip is not walked, an
  arc walks only the directions of the clip, and the band is repainted
  only when what it shows has changed. Every golden image is unchanged. Host
  model, instructions a frame: SERVO LIVE ARMED with a position held
  2,376,262 to 943,052, sweeping 4,780,742 to 2,038,879; OVERVIEW SAFE at
  rest 518,425 to 2,813. The frame rate on the board after the change is
  not measured; before it, SERVO LIVE ran 60.4fps SAFE at rest and 30.2fps
  ARMED.
- The SERVO arm moves in fractions of a pixel. A change of the arm
  repaints three boxes of LIVE's card: the horns, the angle's numerals and
  the COMMANDED and MEASURED numerals. The arm, its holes and its rings are
  placed at float positions: on a sweep the drawn tip's error against its
  angle is 0.012px rms, 0.026px at most, where it was 0.675px and
  1.337px (host render). A drag on the dial is filtered by a one-pole
  filter with a 20ms time constant (`SV_DRAG_TAU_MS`): the press commands
  at once, a move sets the goal, and each frame commands the filtered
  angle, so the drawn arm and the posted pulse follow one target. The pulse
  step per frame of a drag at 90°/s is 5 to 10us (3 to 12us before); the
  finger leads the drawn arm by 1.65° on average (0.49° before). DISARM,
  STOP and SAFE end the filter.
- The configurator describes the 7-inch ESP32-P4 display board as the
  panel: its part and buy row (chip revision 3.2) and its CAN pins on
  header H11. It describes release 0.23.0. The ESP32-S3 catalogue stays at
  the tag v0.22.0.
- Keypad range lines and the supply trip texts write no space before a unit
  symbol, through `ui_unit_gap()`; a word unit keeps its space.
- C and C++ files carry Doxygen comments (`@file`, `@brief`, `@param`,
  `@return`), and Python files carry Google docstrings. `tools/doc_check.py` fails CI
  for a new or touched file that lacks them, against the baseline
  `tools/doc_check_baseline.txt`, and the Doxygen HTML is published on
  GitHub Pages under `api/`.
- The screens that `tools/check_sizes.txt` held whole (LOGS, SUPPLY, MOTOR
  & ESC, the pin picker, SETTINGS and WI-FI) and the SERVO, KST programmer
  and ESC STICK screens are split by concept into files under 1,000 code
  lines, and nine host test files of more than 2,000 lines are split into
  suites of at most 946 lines. Functions and cases move unchanged.
- CI caches the ARM toolchain's `.deb` files (`tools/install_arm_toolchain.sh`)
  and bounds the apt download with a 30s timeout; the Configurator smoke
  and matrix jobs have a 35min limit and the Chromium install a step limit
  of its own, 15min.
- MOTOR & ESC > SETTINGS: the keypad of Idle pulse refuses a value that is
  not 100us or more below Full pulse, and the keypad of Full pulse one that
  is not 100us or more above Idle pulse. The keypad stays open with the
  reason in the warning colour and the row keeps its value. The panel's
  send of the pair holds the same gap (`LINK_CC_THROTTLE_GAP_US`, 100us).
  The IOmcu's own write check holds each pulse to 400 to 2500us and does
  not read the gap, so a pair 1 to 99us apart written by another host is
  taken.
- The FAULT chip draws the dark text of the buttons on its warning fill:
  11.83:1 in the dark theme (1.62:1 before), 10.30:1 in the light one
  (9.73:1 before). Every chip of the band reads at 4.5:1 or more in both
  themes.
- Screen and tile names stay English in German: SETUP's categories read
  INTERFACES, SD CARD, SENSORS, ESC / BENCH, SUPPLY and SERVO TEST, and the
  INTERFACES headings BALANCE SENSORS and SUPPLY. The tab names (WUCHTEN,
  PRÜFGESTELL, GRAFIK, TABELLE), the group heading PROG-PORT and the
  option NETZTEIL stay German. In the limit run's German report
  `blockiert` replaces `angelaufen`; UPDATES asks `Läuft:` where it asked
  `Aktuelle Version:`.
- A key of the FILES footer or of LOGS' RESCAN keeps 6px at each side of
  its label: a label that does not leave 6px in the 10x20 face is drawn in
  the 8x16 face (German VERSCHIEBEN and AKTUALISIEREN). English keeps
  10x20 on every key.
- The text keyboard draws its characters, and the keypad its digits, in
  the largest of 20x36, 16x28, 12x24 and 10x20 whose cell fits the key
  with its padding (4px keyboard, 6px keypad); 20x36 needs a key of 28x44px
  on the keyboard and 32x48px on the keypad. The word keys share one face
  per overlay, never larger than the characters'. The 145px keypads keep
  German `ABBRECHEN` in 12x24, which needs a 120px key (192px at 20x36).

### Removed

- The panel firmware no longer builds for the ESP32-S3-Touch-LCD-7. 0.22.1
  is the last release for the ESP32-S3 panel.

## 0.22.1 - 2026-10-22

0.22.1 is a stable release. Its minor number, 22, is even. GitHub marks
it as the latest release. It is a patch release of 0.22.0, the last release
line for the ESP32-S3 panel, and fixes three defects: LOGS did not list a
standalone report, the card ZIP download failed when a log grew
during the download, and a limit run on a servo that is not a KST or a Chaservo
ended with a message that did not explain the cause. The link protocol stays
4.28.

A panel on 0.20.0 to 0.22.0 is offered 0.22.1 by CHECK FOR UPDATES with
RELEASES: STABLE, which reads `releases/latest`; 0.20.0 has no RELEASES
setting and reads the same. The steps for each release are in
[First run, §1](docs/FirstRun.md#1-flash-both-boards):

1. SETUP > UPDATES, `CHECK FOR UPDATES`, with a saved home network, the
   bench SAFE, the supply output off and no log run open. The card says
   `Version 0.22.1 is available.`.
2. Hold `HOLD 2 s: DOWNLOAD & INSTALL`. The panel restarts and keeps 0.22.1
   once the display and touch are up.
3. At link-up the panel offers to update the IOmcu over CAN (Controller Area
   Network). Hold START 2 s on the question on the menu, or `HOLD 2 s:
   UPDATE IOMCU` on SETUP > UPDATES. The band then says `IOmcu updated to
   0.22.1.`.

The SD card layout is unchanged from 0.22.0; a card from 0.21.0 or older needs the migration that
[From 0.21.0](docs/FirstRun.md#from-0210) describes. The settings and the
Wi-Fi settings are kept. The IOmcu's store record is kept; an IOmcu older
than 0.22.0 writes record version 8 at its first save. The release line is
unchanged: a panel on 0.22.1 is offered 0.22.x patch releases only.

### Fixed

- A limit run on PROG PORT whose first CONNECT finds no servo that answers
  (a Hitec servo, for one) ends FAIL with `no KST or Chaservo servo read`,
  not ABORTED with `programming port did not finish`. Every other failed CONNECT,
  LEAVE and timed-out step reads `programming port session failed`, in
  German `PROG-PORT-Sitzung gescheitert`.
- The card's ZIP download remains valid while a log on the card grows.
  Each file is sent at its size when the download started; files added
  during the download are omitted. A file that shrinks, or an entry
  removed or renamed during the download, still causes the archive to fail.
- LOGS lists a report standing alone: a LIMIT RUN's `LIMITnnn.TXT` in
  `USER/LOGS`, and in the root a `SERVOnnn.TXT` with no `SERVOnnn.CSV`
  beside it, the limit run of firmware 0.21.0 and older. It ranks by its
  number among the runs, and the newest is selected when LOGS opens. OPEN
  shows it as text: 14 rows of up to 86 characters, scrolled by a drag or
  the scroll bar, the first 32 KiB of a file. A report beside its run's
  CSV, `ATESTnnn.TXT`, stays off the list, and OPEN on the run reads the
  CSV. The Wi-Fi page lists every file, these reports included, as a
  download.

## 0.22.0 - 2026-10-21

0.22.0 starts the last release line for the ESP32-S3 panel. Later release
lines are for
the 7-inch ESP32-P4 display board from Waveshare. A panel on 0.22.0 is
offered 0.22.x patch releases only, with RELEASES on STABLE and on TESTING,
and SETUP > UPDATES says so at the foot of its card
([Screens: The release line](docs/Screens.md#the-release-line)). No
0.22.x patch release is planned.

0.22.0 is a stable release. Its minor number, 22, is even. GitHub marks
it as the latest release. It reads up to four INA3221 current monitors at
0x40 to 0x43, with 12 channels in total, set up on the new SETUP > SENSORS tile with a
shunt, a watch target and a current limit of 10 to 32767 mA for each
channel, and logs them by target. A window above its channel's limit
raises a band alert and nothing else; an IOmcu running link protocol
older than 4.27 does not evaluate these limits. It drives four programming ports, PROG PORT 1 to
4, each with a FUNCTION of SERVO PWM, DSHOT150 to DSHOT600 or NONE; the
servo tester and the KST and Chaservo programmer run on any of them. Hitec D series servos answer
without a pull-up with PRECHARGE receive. The link protocol is 4.28. It
fixes defects of 0.21.2: SERVO's TARGET after a programming session, an SD
card swapped while the panel runs, and Wi-Fi page downloads whose receiver
stops reading.

A panel on 0.20.0 to 0.21.2 is offered 0.22.0 by CHECK FOR UPDATES with
RELEASES: STABLE, which reads `releases/latest`; 0.20.0 has no RELEASES
setting and reads the same. The steps for each release are in
[First run, §1](docs/FirstRun.md#1-flash-both-boards):

1. SETUP > UPDATES, `CHECK FOR UPDATES`, with a saved home network, the
   bench SAFE, the supply output off and no log run open. The card says
   `Version 0.22.0 is available.`.
2. Hold `HOLD 2 s: DOWNLOAD & INSTALL`. The panel restarts and keeps 0.22.0
   once the display and touch are up.
3. At link-up the panel offers to update the IOmcu over CAN (Controller Area
   Network). Hold START 2 s on the question on the menu, or `HOLD 2 s:
   UPDATE IOMCU` on SETUP > UPDATES. The band then says `IOmcu updated to
   0.22.0.`.

The INA3221 rows of SETUP > INTERFACES seed SETUP > SENSORS at the first
start ([From 0.21.2](docs/FirstRun.md#from-0212)). Manually migrate a card from 0.21.0 or
older as [From 0.21.0](docs/FirstRun.md#from-0210) describes.
The IOmcu's store record becomes version 8 at its first save; an IOmcu
image older than 0.22.0 reads no version 8 record. 0.20.0 to 0.21.2 run
link protocol 4.22 or 4.23, the same major as 4.28, so both boards link
before and after the IOmcu's update. A panel older than 0.22.0 is offered
any newer release GitHub names, also one for the ESP32-P4 panel, and its
checks refuse an image built for another chip. The time of the download
and of the update over CAN is not measured.

### Added

- The panel's release line, 0.22 (`FW_REL_LINE_MAJOR`,
  `FW_REL_LINE_MINOR` in `shared/fwupdate/include/fw_release.h`): a check
  offers a release of 0.22 only, newer than the running build, on
  RELEASES: STABLE and TESTING. A newer release past the line, 0.23.0,
  0.24.0 or 1.0.0, reads `No newer release for the ESP32-S3 panel. Panel
  version: 0.22.0.` with `Latest release on GitHub: 0.23.0.`; it is not
  offered, and the reminder at start does not open for it. With TESTING,
  the highest release of the line among the 10 newest stands in for a
  higher one past the line when it is newer than the running build. With
  STABLE, a latest release past the line and newer than the running build
  is followed by one request of the release list, whose newest 0.22.x is
  offered when it is newer; when that request fails, the result is as
  without it. The foot of the UPDATES card starts with `0.22 is the last
  release for the ESP32-S3 panel. Later releases are for the 7-inch
  ESP32-P4 display board from Waveshare.`.
- Hitec D series servos answer with no pull-up on the signal wire: SETUP >
  INTERFACES > Hitec D receive (PROG PORT, German `Hitec-D-Empfang`)
  chooses PULL-UP, the default, or PRECHARGE. With PRECHARGE the IOmcu
  drives the programming port's pad high for 100.0 ns every 1086.7 ns at
  2 mA and slow slew, samples it 113.3 ns after the release, and decodes
  the samples into the capture the PULL-UP receiver gives. The sampler is a
  second PIO state machine with its own DMA channel; the decode runs a few
  words per main-loop pass, in integer arithmetic. A LISTEN that answers
  and a window above 30,000 us are refused on such a line; writes and LEVEL
  run as before. A stop, CLOSE, ABORT, link loss, heartbeat loss and the
  supply switched off end the sampling with the pad released and its
  registers restored. The window was measured on one D485HW: every read
  passed with the sample 40 to 187 ns after the release and a precharge of
  6.7 to 200 ns, and none from 267 ns. Classic servos need neither and
  ignore the setting.
- Link protocol 4.24: HITEC write register 23 (`RX_MODE`), `STATE` bit 7
  and `VIEW` 2 register 25 bit 8. A 4.23 IOmcu refuses the register and
  receives with the pull-up; SETUP then says `IOmcu older than 4.24:
  receives with PULL-UP.` with PRECHARGE set. With an IOmcu older than
  4.23 it says `IOmcu older than 4.23: no Hitec line.`
- The bench console's `hitec open <port> d [od|pp] [pu|pre]` writes the
  receive mode before the OPEN, and the report names it (`rx=pu|pre`).
- Link protocol 4.25: SENSE_MAP (0x35) sets up to 4 INA3221 at 0x40 to
  0x43, a shunt of 5 mOhm to 1 Ohm (0 off) and a watch target (an output
  channel, a programming port or the supply) for each of their 12
  channels, and the FAST channel. SENSE_WIN_A and SENSE_WIN_B (0x37,
  0x38) carry every channel's last 50 ms window. Until it is first
  written the map is SENSE's one INA3221; once written, SENSE's INA3221
  bit and registers 8 to 10 mirror it and a SENSE write that would change
  them is refused. With a map in force, IDENTITY's capability bit 3
  (`SERVO_SENSE`) is set while a channel it reads watches an output
  channel or a programming port. The panel writes SENSE_MAP from SETUP >
  SENSORS (below) and reads SENSE_WIN_A and SENSE_WIN_B for the run log
  (below).
- The IOmcu's store record is version 8, 308 bytes in a slot of two
  256-byte flash pages, 16 slots in the store; it keeps the map. Records
  of version 3 to 7 are read until the first version 8 save, and the
  sector that holds the last of them is kept until then. An IOmcu image
  older than this build reads no version 8 record and starts as from an
  empty store.
- Link protocol 4.27: SENSE_LIMIT (0x36) holds a current limit of 1 to
  32767 mA (0 none) for each of SENSE_MAP's 12 channels, kept in the store
  record. Core 1 judges each 50 ms window as it closes. A window above
  its channel's limit -- its highest current, or a sample at the top of a
  range above the limit -- sets the
  channel's bit in OVER, which a read of the register clears, and counts
  in OVER_COUNT. An alert only: nothing stops or switches to SAFE. The
  panel writes the limits from SETUP > SENSORS (below).
- SETUP > SENSORS has a LIMIT row per channel, `0x40 CH1 limit` (German
  `0x40 CH1 Grenze`): OFF, or 10 to 32767 mA in 10 mA steps on the
  arrows. The panel writes the 12 limits to SENSE_LIMIT 500 ms after the
  last edit, in any bank state, and reads OVER and OVER_COUNT every 200 ms
  while a limit is held. The band says `INA3221 0x41 CH2 (PORT 1) over its
  0.80 A limit.` with the limit the window was judged by, at most once
  every 5 s, and once every 30 s for a channel that keeps passing;
  channels over at the same time take turns. `An INA3221 channel passed
  its limit; which one was lost on the link.` follows the link-up after a
  reply with the bits did not arrive, and not an IOmcu restart.
  `INA3221 limits rejected. Check SETUP > SENSORS.` follows a refused write
  or a BAD_PAGE answer from an IOmcu that names 4.27 or later. A
  LIMIT row the IOmcu does not hold is marked; on an IOmcu older than
  4.27 the line reads `IOmcu older than 4.27: no limit is judged.` and
  nothing is sent to the page.
- The IOmcu console prints a third sensor line, `sense map`: the parts
  fitted, FAST, the map's flags, each channel's mean current in mA, and
  SENSE_LIMIT's OVER and OVER_COUNT.
- Four programming ports on the IOmcu, PROG PORT 1 to PROG PORT 4. Each
  has a FUNCTION: SERVO PWM, a pulse from the PWM generator, or NONE, the
  pin held as an input with its pull-down. Port 1 defaults to SERVO PWM,
  ports 2 to 4 to NONE with no pin, so a bench that sets nothing on ports
  2 to 4 runs as with one port. PIN and FUNCTION are kept in the IOmcu's
  flash; the panel writes them only when the operator sets them, on the
  PROG PORT entry of SETUP > OUTPUTS or in PICK A PIN, and only on a bench
  in SAFE with no test, sweep or servo programmer running.
- SETUP > OUTPUTS: one PROG PORT entry per port with PIN (opens PICK A
  PIN on that port), FUNCTION, WATCHED BY (no current channel yet), SERVO
  TESTER and PORT PWM. PICK A PIN lists the programming ports and rejects
  a SERVO PWM pin that shares a PWM slice with an output.
- The servo tester's target is OUTPUTS or PORT 1 to PORT 4 (SETUP > SERVO
  > SERVO TESTER). A stored PROG PORT reads as PORT 1. The TARGET row names
  the port: `PROG PORT 2 GP14`. A port without a SERVO PWM pin, or one the
  IOmcu does not have, reads `PROG PORT 2` in the warning colour, and the
  tester then sends the standard outputs no command but a release.
- Link protocol 4.26: PROG page registers 24 to 27 (`FUNC`) and `FLAGS`
  bits 4 to 7 (port parked). The functions are kept in the store record's
  word before the ports, spare until 4.26, in version 7 and 8 records
  alike. An image of 4.25 writes the word back as 0. An older image cannot read
  a version 8 record and starts with an empty store: after such a downgrade and
  an upgrade the ports are on their default functions. With an IOmcu
  older than 4.26 every port is SERVO PWM and OUTPUTS says `IOMCU OLDER
  THAN 4.26: SERVO PWM ONLY`.
- The KST and Chaservo programmer runs on the port SERVO TESTER names,
  PORT 1 to PORT 4, with that port's pin. SERVO > PROGRAM's row names the
  port and pin (`PROG PORT 2 GP14`) and is dimmed `PORT IN USE` while a
  Hitec session opened from the bench console holds the port; the panel
  reads the HITEC page's STATE with the PROG page every 500 ms. With
  OUTPUTS the programmer says `Set SERVO TESTER to PORT 1 to PORT 4 on
  SETUP > OUTPUTS.`
- The HITEC page opens on any of the 4 ports, a NONE port's parked pin
  included, which goes back to NONE at CLOSE.
- A programming port's FUNCTION takes DSHOT150, DSHOT300 and DSHOT600:
  plain DShot from a PIO state machine of its own, a frame every 1 ms. The
  port is a throttle: ARM THROTTLE arms it, the MOTOR & ESC throttle drives
  it, and SAFE, ARM SURFACE, STOP, heartbeat loss and link silence send no
  frame, as on a motor slot. A DShot pin is under no PWM slice rule. The
  servo tester never drives a DShot port.
- Link protocol 4.28: PROG `FUNC` values 2 to 4 (DSHOT150 to DSHOT600)
  and `FLAGS` bits 12 to 15 (port DShot bound). A `CMD` write on a DShot
  port is refused. The store keeps a DShot function as 3 to 5 in the
  `prog_func` word; an image of 4.26 or 4.27 starts such a port at its
  default function. With an IOmcu older than 4.28 the panel offers SERVO
  PWM and NONE only.
- SETUP > SENSORS (German `SENSOREN`), the eighth tile: up to four INA3221
  current monitors at 0x40 to 0x43. Per part `0x40 fitted`; per channel
  `0x40 CH1 watches` (NONE, OUT 1 to OUT 8, PORT 1 to 4, SUPPLY) and
  `0x40 CH1 shunt` (OFF, 5.0 to 1000.0 mOhm). A fitted part's heading shows
  its state: `ONLINE`, `NOT ANSWERING`, `IOMCU OLDER THAN 4.25: NOT READ`
  and eight more. The panel writes the map to SENSE_MAP (link protocol
  4.25) in one write of 26 registers; an IOmcu older than 4.25 gets SENSE's
  one-part frame. The channel read at 1 kHz is the lowest one on a fitted
  part that watches the servo tester's target.
- The band says `INA3221 0x41 has every channel off. Check SETUP >
  SENSORS.` for a fitted part with all three shunts OFF; no map is written
  then.

### Fixed

- SERVO > TARGET reads the set programming port in SAFE within 500 ms after
  a programming session gives the port back and after an IOmcu restart,
  without waiting for the next ARM.
- The bench console's Hitec section says what `flags=PRECHARGE` and the
  `rx=` of `hitec line` each read: register 23, the mode of the next OPEN,
  and the mode of the open line. They differ after register 23 is written
  while a line is open, as the panel does at every edit of SETUP >
  INTERFACES > Hitec D receive, saved or not. It also says that `hitec`
  and `hitec state` print the report with `now`, that an option of
  `send`, `listen` or `power` left out is 0 (`answer` left out answers
  nothing), that a 5-byte D series SEND has its 117.2 us lead with or
  without `lead=`, and gives the raw `send` of a D series read with its sum
  byte.
- A POWER on a PRECHARGE line answers: its LISTEN starts in the pass of the
  ON, while the PD mini's output still reads off, and is cut only when the
  output reads off after it read on, when the supply is asked off, or when
  the PD mini stops answering. It was cut in the first pass, 2.4 ms into
  the window. A LISTEN whose output reads off for its whole window, 30 ms
  at most, ends `DONE` with what it heard.
- SETUP > INTERFACES > Hitec D receive at PRECHARGE reads `PRECHARGE: no
  pull-up on the signal wire` (German `PRECHARGE: kein Pull-up an der
  Signalleitung`); PULL-UP keeps `PULL-UP needs 2.2 kOhm on the signal
  wire`. A mark's line goes before both.
- The D series answer delay through PRECHARGE is given as measured: 5.93
  to 6.52 ms over 153 reads (D485HW, 2026-10-20).
- Downloads from the Wi-Fi page on a home network run without Wi-Fi power
  save and with a TCP (transmission control protocol) send buffer of
  11,520 bytes instead of 5,760. On 0.21.2 a station measured 15,900 and
  about 64,000 B/s; the expected rate is 300,000 to 1,000,000 B/s, not
  measured ([Performance](docs/Performance.md#wi-fi-downloads)).
- A download ends and resets its connection when the receiver closes,
  fails or accepts no data for 30 s. The page can then answer the next
  request. A receiver that stopped reading held the page's server, and
  with it every other request, until the connection timed out: about
  7.5 min for one that kept its connection open.
- A card put in, taken out or swapped while the panel runs is found by the
  next RESCAN, opening of LOGS, page or OPEN of LOGS, run start or servo
  test start, with no restart. A mounted card is asked with one SEND_STATUS
  (CMD13) command at those events and not once a frame; one that does not
  answer is unmounted and the slot mounted again, so the volume label, the
  list, the run alerts and the card state are the card's in the slot. A
  card swapped for one with no FAT volume said `No card.` on LOGS and kept
  the old label; it says `Card is neither FAT32 nor exFAT. Format it on a
  computer.`. The look logs no E line. A card taken out during a run closes
  the run's file at the first failed write and the run goes on unrecorded
  under `Data can no longer be saved to the card. Recording stopped here.`;
  the next ARM names the slot's state now. A card that answers SEND_STATUS and
  fails a read is unreadable and is mounted once per look. The volume is
  unmounted only with no file or folder open on it from LOGS, the run log or
  the Wi-Fi access. The `runlog` task's stack is 6,656 bytes (5,632), for
  the mount it makes.

### Changed

- The last line of the UPDATES card reads `TESTING also reads testing
  releases. Both offer only 0.22.x.` (German `TESTING liest auch
  Testing-Releases. Beide bieten nur 0.22.x an.`), in place of `TESTING
  also offers testing releases: odd minor numbers.`.
- The four INA3221 rows leave SETUP > INTERFACES (23 settings now). A panel
  updated from 0.21 seeds SENSORS from them at start-up: the part at the old
  address fitted when the INA3221 was ON, its CH1 on the old shunt, CH2 and
  CH3 on it with CH1+2+3 and OFF with CH1, and CH1 watching PORT 1 when the
  servo tester's target was the programming port, OUT 1 otherwise. The old
  keys stay stored and unchanged for one release, for a panel taken back to
  0.21.
- `INA3221 settings rejected. Check SETUP > SENSORS.` names SENSORS in
  place of INTERFACES.
- The servo rail's INA3221 meter is the channel watching the servo
  tester's target, any of the 12, with an IOmcu of protocol 4.25; CH1 of
  the one part SENSE reads with an older IOmcu. SERVO names it over the
  plot, `INA 0x41 CH2`, the TEST card beside STOP TEST likewise, the
  LIMIT RUN line `CURRENT INA3221 0x41 CH2`, and both reports
  `INA3221 0x41 CH2`. Beside the channel's 96 px name the voltage on that
  line has 52 px and shows tenths from 10 V, `26.0 V`.
- The run log's INA3221 columns follow the sensor map with an IOmcu of
  protocol 4.25: one group of current, max and voltage per watching
  channel, named after its target (`port 1 current (A)`, `out 3 max (A)`,
  `supply voltage (V)`), the FAST channel first, at most 3 groups. FAST's
  group comes from the window ring and is on every row; the others from
  SENSE_WIN_A and SENSE_WIN_B, read on every poll after SERVO_WIN at most
  every 40 ms while a part on the page is fitted, and miss about 1 row in
  17 at a 53 ms poll. Watching channels after the third are not logged.
  An older IOmcu, or a map derived from SENSE, keeps `ch1` to `ch3`.
- OUTPUTS' PROG PORT entry names the channel watching the port,
  `WATCHED BY INA3221 0x41 CH2`.
- `INA3221 0x40 CH1 clipped at 1.64 A. Reading shows only the limit.`
  names the part's address.
- The IOmcu's sensor schedule reads up to 4 INA3221 at 0x40 to 0x43, 12
  channels, each with its own shunt. One channel, FAST, is read every 1 ms
  and carries the window ring and the move capture; the other channels
  are read in turn beside it, one a tick (500 Hz each for CH2 and CH3 of
  one part, 90.9 Hz each with 11); each bus voltage every 24 ms; each
  part's Mask/Enable and Configuration at 25 Hz. SENSE's one INA3221 is
  the part at its address with CH1 as FAST, so a bench set up today reads
  CH1 as before. The longest tick is 742.5 us of bus time at 400 kHz;
  4 parts, 12 channels, the INA228 and the AS5600 take 60.8 % of the bus.
  At most one INA3221 is probed a tick. The schedule's pair option (CH2
  and CH3 at 1000 Hz), which no link register switched on, is removed.
- LOGS lists its tabs in the order ROOT (German STAMM), USER, BENCH, and
  shows the card's name right-aligned at the end of the header row, with
  the folder after the tabs. The tab ids, the remembered tab and the
  folders are as before.

## 0.21.2 - 2026-10-20

0.21.2 is a testing release. Its minor number, 21, is odd. GitHub lists
it as a pre-release. It mounts SD (Secure Digital) cards formatted exFAT
(extended File Allocation Table) as well as FAT12, FAT16 and FAT32, and stores
file sizes as 64-bit values. It fixes defects of 0.21.1: DISARM, OUTPUT OFF and a
run's STOP or ABORT act on the first press while the alert band covers them
or a help box is open; a card with no FAT volume reads `not FAT32/exFAT` and
a card that does not mount `unreadable`, not `no card`; the update check on
RELEASES: TESTING reads GitHub's chunked answer, the start-up check
included; OUTPUTS and PICK A PIN show the pins SETUP > INTERFACES holds as
taken; a setup alert clears from the band when its cause ends; PD mini TX and
RX never share a pin; Backlight leaves SETUP > PANEL.

A panel on 0.21.0 or 0.21.1 is offered 0.21.2 with RELEASES: TESTING on
SETUP > UPDATES only; RELEASES: STABLE reads `releases/latest`, which names
v0.20.0. The steps from 0.21.1 are in
[First run, §1](docs/FirstRun.md#from-0211):

1. SETUP > UPDATES, `RELEASES: TESTING`, `CHECK FOR UPDATES`, with a home
   network kept, the bench SAFE, the supply output off and no log run open.
   0.21.0 and 0.21.1 read only an answer that states its size: a panel that
   says `Unexpected answer from GitHub.` gets the cached answer, which
   does, with `CHECK FOR UPDATES` pressed again at once
   ([the check on 0.21.0 and 0.21.1](docs/FirstRun.md#the-check-on-0210-and-0211)).
2. Hold `HOLD 2 s: DOWNLOAD & INSTALL`. The panel restarts and keeps 0.21.2
   once the display and touch are up.
3. At link-up the panel offers to update the IOmcu over CAN (Controller Area
   Network). Hold START 2 s on the question on the menu, or `HOLD 2 s:
   UPDATE IOMCU` on SETUP > UPDATES. The band then says `IOmcu updated to
   0.21.2.`. The test of unwired sensor pins runs on the IOmcu and comes
   with this step.

The SD card layout is unchanged from 0.21.1; a card from 0.21.0 or older needs the migration that
[From 0.21.0](docs/FirstRun.md#from-0210) describes. The card holds a FAT32,
FAT16, FAT12 or exFAT volume; 0.21.1 does not read exFAT. 0.21.2 does not
read NTFS (New Technology File System), a card with a GPT (GUID partition
table) or a volume over 2 TiB, and formats no card ([The SD card's
format](docs/Screens.md#the-sd-cards-format)). A set-up stored with PD mini
TX and RX on one GPIO (general-purpose input/output) loads as stored, and
the PD mini stays off until one pin assignment changes. Without a home network,
upload the image through the panel's browser page. 0.21.1 and 0.21.2 run link
protocol 4.23; 0.21.0 runs 4.22, the same major, so both boards link before
and after the IOmcu's update. The time of the download and of the update
over CAN is not measured.

### Added

- The panel mounts SD cards formatted exFAT, the format SDXC cards of 64 GB
  to 2 TB come in, beside FAT12, FAT16 and FAT32. The build takes ESP-IDF's
  fatfs component with `FF_FS_EXFAT` 1 (`firmware/panel/fatfs_exfat.cmake`);
  ESP-IDF v5.4 and v5.5 have no Kconfig option for it. The application image
  grows by 9,184 bytes. The serial log names the format at mount: `storage:
  SK64G mounted, exFAT, 61002 MB`.
- File sizes are 64-bit from the card to the screen: LOGS lists a file of
  4 GiB and more with its size (`8.00 GB`), and WI-FI lists and downloads
  it whole. OPEN refuses a file of 2 GiB and more with `<name> is 2 GB or
  larger. Not opened.`; the reader's seek reaches 2 GiB less 1 byte. GPT
  cards and volumes over 2 TiB do not mount (`FF_LBA64` stays 0).

### Fixed

- WI-FI lists and downloads a FAT32 file of 2 GiB to 4 GiB less 1 byte with
  its size. The fault log and servo files also read such file sizes
  correctly. Each took the size from stat(), whose 32-bit `st_size` gave a
  negative number. LOGS refuses such a file at OPEN instead of reading it
  through a seek that does not reach its end.
- A card in the panel's SD slot that holds no FAT volume -- NTFS, a GPT or
  no format -- reads `Card is neither FAT32 nor exFAT. Format it on a
  computer.` on LOGS, `not FAT32/exFAT` on the splash, and its own line in
  the run and servo test alerts and the servo programmer's card notes. A
  card that does not mount for another reason reads `Cannot read the card.`.
  Both read `No card` before. The console line names the FatFs result: `W
  storage: card holds no FAT volume (FatFs 13): format it FAT32 or exFAT`. A
  card that starts and does not mount is started once more to ask FatFs why.
- A press on a control that stops what the bench drives acts on the first
  press while the alert band covers it or a chip's help box is open:
  DISARM, OUTPUT OFF, a stick run's ABORT, STOP TEST and STOP RUN. The
  press clears the band or closes the box. The alert band covers the lower
  22 px of SERVO's DISARM (panel y 446 to 467); a DISARM tap there only
  cleared the alert, and the bench stayed ARMED until a second tap. A press
  on ARM or OUTPUT ON under the band or the box still starts no hold.
- The update check with RELEASES: TESTING reads GitHub's API (application
  programming interface) answer in chunks (`Transfer-Encoding: chunked`, no
  `Content-Length`), the form GitHub sends when its cache does not hold the
  request. The check ended with "Unexpected answer from GitHub." and "The
  response does not specify a size." whenever the answer came in that form,
  the start-up check included. The console prints each GitHub job's last
  answer: HTTP (Hypertext Transfer Protocol) status, `Content-Length`,
  chunked, body bytes read and the reason code.
- OUTPUTS and PICK A PIN show the pins SETUP > INTERFACES holds as taken
  and take no tick on them: Sensor SDA and SCL (GP16 and GP17 by default)
  while the INA228, the INA3221 or the AS5600 is on, PD mini TX and RX
  while the PD mini is on, the tap pin while the phase tap is on. OUTPUTS
  names `SENSOR BUS`, `PD MINI` or `PHASE TAP` under the pin; PICK A PIN
  draws the key grey and lists the pins under those names in IN USE, after
  the programming port. While the IOmcu answers, the pins are the ones
  each page holds by its last read: a refused move keeps the old pins, a
  refused part holds none. With no IOmcu answering they follow the
  settings. Both screens listed these pins as free, and the IOmcu refused
  a binding on them.
- The settings of AUTOMATIC TEST and LIMIT RUN on SERVO > TEST have CLOSE at
  the top right; it goes back to the run cards, as the home tag does.
- With a band chip's help box open, a tap on another chip closes the box
  and opens that chip's box in one tap. It took two taps.
- An alert about a SETUP > INTERFACES setting clears from the band when
  its cause is resolved, before its 30 s timeout: a value the IOmcu rejected, once the IOmcu holds
  the value it is stepped back to (at once when that is the value it still
  holds), and unset sensor pins or both monitors on one address with the
  edit that puts them right. This covers the current monitors, the phase
  tap (Tap gap 2 ms at 400 Hz and back to 3 ms), the PD mini pins (RX on
  the sensor bus's SCL and back) and the PD mini wiring held for a module
  read. On MOTOR & ESC, a rejected pole count or pulse range and an
  inverted Idle pulse and Full pulse leave the band once a later value is
  taken. A rejected alert that never reached the band and is over by its
  next turn is not shown.
- The AS5600 weak, strong or no-magnet alert is said once while the
  magnet status bits stay the same; an edit of another INTERFACES row no
  longer says it again. It is said again when a bit changes (weak to strong
  included), after the field read right, after the sensor was reported not
  answering, after the sensor was switched off, and after a link-up.
- Sensor bus pins with nothing wired to them (no part, no pull-up) no longer
  raise `Sensor bus blocked: SDA low.`: the IOmcu tests a line that is low
  at idle on its own pad pull-up for up to 50 µs, and a line that rises is
  held by nothing. The monitors then read as not answering. Sensor SDA steps
  16 to 14 because GP15 is an SCL pin (an I2C (Inter-Integrated Circuit)
  block's SDA is an even GPIO and its SCL the next one).
- INA228 address and INA3221 address stop at the ends of their range
  (0x40 to 0x4F, 0x40 to 0x43) and have `-` and `+` keys; minus at 0x40
  wrapped to 0x43.
- An SD card mount tried again with no card sets the SPI (Serial Peripheral
  Interface) bus up once and logs `no card` at I (info) level once per try.
  It logged two E (error) lines each try: `spi_bus_initialize(802): SPI bus
  already initialized.` and `sdmmc_card_init failed (0x107).`.
- The link report's `nack` column is documented: it counts each NACK
  (negative acknowledgement) the IOmcu answers, one per set-up value
  rejected from SETUP among them, and a NACK is an answer, not a link fault
  ([Bring-up](docs/Bringup.md#link-report)).
- PD mini TX and PD mini RX on SETUP > INTERFACES step over the GPIO the
  other row holds, so the rows never set both to one pin: with RX on GP18,
  TX steps from GP19 to GP17. At the end of the range the key does nothing
  (TX stops at GP46 with RX on GP47). A set-up stored with both on one
  GPIO loads as stored: the PD mini stays off, the SUPPLY header says
  `PD MINI NO PINS`, and both rows say `TX and RX on one pin. The PD mini
  stays off.`. The rows took one pin for both, and the panel switched the
  supply off for it with the header still naming the pins.
- The bench console build (`IOMCU_CONSOLE`) sends a line longer than the
  free space in the USB (Universal Serial Bus) transmit buffer in pieces,
  sending the remaining pieces before another line. With the SDK's (software development kit) 64-byte buffer a
  line of 65 bytes or more never left, and no reply came after it. A pass
  never waits for the host. The IOmcu's own `rcbench-iomcu:` lines go
  through the console's output in this build, so none lands inside a reply,
  and the transmit buffer is 1,024 bytes.
- docs/BenchConsole.md gives a D series read 117.2 us of lead, not 88 us:
  88 us is asked, and the 13 bit times that pad the PIO (programmable
  input/output) stream to a word make it longer; a write gets 89.0 us.
  `lead_ns` in `hitec line` runs from the lead's first edge to the release
  of the line, the lead and every bit time: 559,886 ns for a read, as the
  bench reports.
- The Hitec D series wiring names the tested pull-up: 2.2 kΩ from the signal
  wire to the servo supply, with which a D485HW answers every read. With the
  RP2350 pad's pull-up alone it answers none.

### Removed

- Backlight on SETUP > PANEL. The board switches the backlight only on or
  off, and no part of the firmware applied the setting. The backlight is on
  while the panel runs. A panel that stored the row keeps the old `backlight`
  key in its settings storage; no setting reads or writes it.

## 0.21.1 - 2026-10-19

0.21.1 is a testing release. Its minor number, 21, is odd. GitHub lists
it as a pre-release. It adds the HITEC link page and the bench console,
writes run logs to `BENCH/LOGS` and `USER/LOGS` on the SD (Secure Digital)
card, keeps the bench's own files under `BENCH`, and names the release
kind STABLE. Every panel image, the release images included, checks once at
startup for a touch injector at I2C (Inter-Integrated Circuit) address
0x14 ([SECURITY](SECURITY.md) states the limitation).

The panel does not read files from the locations used by 0.21.0 and older: ESC
profiles come from `BENCH/ESC/CONF`, not `/ESC/`; servo files, `KST.TXT`
and `KST.NEW` from `BENCH/KST/CONF`, not `/KST/`; the fault log is
`BENCH/RCBENCH.LOG`, and `/RCBENCH.LOG` is not read. The files are moved by
hand on a computer. Run logs in the card's root stay readable on the ROOT
tab of LOGS.

A panel on 0.21.0 is offered 0.21.1 with RELEASES: TESTING on SETUP >
UPDATES only. Its other value reads USABLE on 0.21.0 and STABLE from 0.21.1
on; it reads `releases/latest`, which names v0.20.0. The steps are in
[First run, §1](docs/FirstRun.md#from-0210):

1. Switch the panel off. On a computer, move the files from `/ESC/` to
   `/BENCH/ESC/CONF/` and from `/KST/` to `/BENCH/KST/CONF/`.
2. SETUP > UPDATES, `RELEASES: TESTING`, `CHECK FOR UPDATES`, with a home
   network kept, the bench SAFE, the supply output off and no log run open.
3. Hold `HOLD 2 s: DOWNLOAD & INSTALL`. The panel restarts and keeps 0.21.1
   once the display and touch are up.
4. At link-up the panel offers to update the IOmcu over CAN (Controller Area
   Network). Hold START 2 s on the question on the menu, or `HOLD 2 s:
   UPDATE IOMCU` on SETUP > UPDATES. The band then says `IOmcu updated to
   0.21.1.`.

Without a home network, upload the image through the panel's browser
page. A bench on 0.20.0 loads as for 0.21.0, with the files of 0.21.1
([From 0.20.0](docs/FirstRun.md#from-0200)). The link protocol is 4.23;
0.19.0, 0.20.0 and 0.21.0 run 4.22, the same major, so both boards link
before and after the IOmcu's update. Download and CAN update durations are not measured.

### Added

- `protocols/hitec/`: the signal-wire layer for programming Hitec servos,
  both wire families. Classic (HS-5xxx, HS-7xxx: 19 200 bit/s, normal
  polarity, 4-byte commands that sum to 0) and D series (115 200 bit/s,
  inverted, `96`/`69` frames with a byte sum): frame builders, transactions
  to send, listen with an answer to the first byte, or hold a level, and
  reply decoders with one result code per failed check. `rp2350/` holds the
  pin driver: one PIO program of 29 words for both families, 16 cycles a
  bit from the clock divider, open drain or, for the D series, push-pull,
  2 DMA channels. The IOmcu image holds its words to the host test's.
  `test_hitec_wire` and `test_hitec_pio`, 33 cases, run the core and the
  program in a model of the state machine. No byte has been on a wire.
  ([README](protocols/hitec/README.md))
- The HITEC link page (0x34), protocol 4.23: raw Hitec transactions on a
  programming port. OPEN takes the port's pin from PWM after 50 ms and
  opens the line, classic or D series; SEND, LISTEN, LEVEL and POWER run
  one transaction each and leave the capture, up to 16 bytes with their
  start times, and its decoding on the page. Every SEND, and a LISTEN or
  POWER that answers, needs the write key 0x48A5; every staged
  transaction needs its CRC-16. POWER switches the PD mini off, holds it
  off 0 to 10,000 ms and on at 4800 to 6000 mV, and listens from the ON. A
  stop aborts the transaction, keeps the port with the pin released and
  refuses transactions until CLEAR. The panel does not use the page.
  `shared/outputs/hitec_port.c`, `test_hitec_port` and
  `test_hitec_port_stop`, 39 cases.
  ([The programming port for Hitec servos](docs/LinkHitec.md))
- The bench console, IOmcu build option `IOMCU_CONSOLE`, off by default:
  command lines on the USB serial port read and write every link page
  through the link's page handlers, without feeding the link's silence
  watchdog; `hitec` commands stage, check and send HITEC transactions and
  report the capture. CI builds it and fails when the default image holds
  a console symbol. `shared/outputs/page_console.c`, `test_page_console`,
  13 cases. ([The bench console](docs/BenchConsole.md))
- SETUP > SD CARD, a new category tile: Auto logs and User logs, both ON
  by default. OFF writes no file and takes no number. With User logs OFF the
  SERVO screen names `USER LOGS OFF` where a test's files would be.
- SETUP > SD CARD sets the two log folders: Auto log folder (setting
  `log_auto_dir`, `BENCH/LOGS` by default) and User log folder
  (`log_user_dir`, `USER/LOGS`). A tap on a folder's row opens the
  keyboard in its folder mode, where the `.` key types `/`. OK takes 1 or 2
  folders of 1 to 8 characters of A-Z, 0-9, `_` and `-`, stored in upper
  case, and refuses a Windows device name and `BENCH/ESC`, `BENCH/KST` and
  `BENCH/HITEC`; a refused OK keeps the keyboard open and says why. A
  changed folder takes the next file, numbered from what it holds; the
  LOGS tabs USER and BENCH list the folders set. `card_folder_check()` in
  `shared/logfile/card_tree.c`; `test_card_tree`, `test_keypad`,
  `test_settings`, `test_settings_folders`, `test_log_take` and
  `test_logview`, 30 cases more.
- First run §1 describes updating a 0.21.0 bench in four steps: moving the
  files on the card, downloading with RELEASES: TESTING, installing, and
  updating the IOmcu over CAN afterward. The table of the SD card of
  0.21.0 and older names `KST.NEW` beside `KST.TXT`.

### Changed

- Every panel build, release images included, looks once at start-up for a
  touch injector at I2C 0x14: `RCBENCH_TOUCH_INJECTOR` defaults to ON, and
  `-D RCBENCH_TOUCH_INJECTOR=OFF` builds a panel without it. A panel that
  finds none stops reading and probing 0x14 until the next start. Touch
  then comes only from the glass, and the band never shows INJECT. The INJECT bubble no
  longer opens with `This is a test-bench build, not a release version.`
  The default image is 3,824 bytes larger, holds 112 bytes less internal
  RAM, and CI builds the option OFF as the extra build.
- The bench's own files live under `BENCH` on the SD card. ESC profiles
  are read from `BENCH/ESC/CONF`, the servo programmer's files and its
  write record `KST.TXT` are in `BENCH/KST/CONF`, and the fault log is
  `BENCH/RCBENCH.LOG`. A save makes each missing folder level. The panel
  reads no folder of 0.21.0 and older and moves nothing: the files of
  `/ESC/` and `/KST/` work again once they are moved to the new folders on a
  computer ([First run](docs/FirstRun.md#the-sd-card-of-0210-and-older)).
  The texts `These numbers are also saved in BENCH/RCBENCH.LOG on the
  card.` and `Cannot save: card write-protected, or BENCH/KST/CONF is not a
  folder.` name the new places.
- The fault log is held to 1 MiB (1,048,576 bytes). A line that would pass
  that renames the file to `BENCH/RCBENCH.OLD`, replacing the one there:
  at most 2 MiB of fault log on the card. It is written whatever SETUP >
  SD CARD says. `shared/logfile/fault_log.c`, `test_fault_log`, 9 cases;
  `shared/logfile/card_tree.c`, `test_card_tree`, 7 cases.
- The runlog task's stack is 5,632 bytes, 1,024 more:
  `tools/stack_check.py` follows the card callbacks of the fault log, the
  servo files and the folder maker (`CARD_CALLS`, `FAULT_CALLS`,
  `KST_CALLS`), and a servo save with its folder levels needs 3,744 bytes.
- Run logs go to two folders of the SD (Secure Digital) card, made one
  level at a time on the first write: `BENCH/LOGS` holds `SERVOnnn.CSV` (an
  arm from SERVO), `MOTORnnn.CSV` (an arm from MOTOR & ESC or ESC STICK) and
  `SUPPLnnn.CSV` (a supply run); `USER/LOGS` holds the AUTOMATIC TEST's
  `ATESTnnn.CSV` and `.TXT` and the LIMIT RUN's `LIMITnnn.TXT`. The numbers
  are one series per folder. The name follows the roles the arm asked for.
  `BENCHnnn`, `ESCnnn` and `SERVOnnn` runs of 0.21.0 and older stay in the
  root, nothing moves them, and LOGS lists them on its ROOT tab. A folder
  that cannot be made says `Cannot make folder BENCH/LOGS. Run not
  recorded.` Firmware 0.21.0 and older does not read the two folders.
- LOGS lists one folder at a time, chosen by three tabs in its header row:
  USER, BENCH and ROOT (STAMM in German). It opens on the tab of the file
  written last when one was written since its last visit, BENCH after a
  start. The header names the card and the folder; an empty folder names
  what goes there or the switch that is OFF.
- The release kind and the RELEASES value are named STABLE, not USABLE:
  `tools/release_kind.py` prints `kind=stable`, SETUP > UPDATES shows
  RELEASES: STABLE | TESTING, English and German. A panel set to USABLE
  keeps its setting, now shown as STABLE (setting `upd_channel` and its
  stored value 0 are unchanged).
- The KST page refuses ENTER, and a REBOOT taken in PWM, with BUSY while
  the HITEC page holds the port.
- The bench configurator describes release 0.21.1 and moves to a release in
  the release pull request, with `rcbench_version.h`. Every repository source
  of its data is a file and line at the tag `v0.21.1`: 83 sources, 9 of them
  on the line the text moved to, in `docs/FirstRun.md`, `docs/Servo.md` and
  `STATUS.md`. Until the tag exists, the data check reads the sources at
  `HEAD` when `CONFIGURATOR_BEFORE_TAG` is 1 and the header there names the
  release of `configurator/package.json`, and `--strict` passes; the
  Configurator workflow sets the variable on its clone, which holds every
  tag. Once the tag exists, it reads them at the tag. A clone without the
  tag and without the variable fails `--strict`. A release tag older than the data is no
  warning, a newer one is. `gitTree()` in `configurator/core/tools/check.ts`;
  one test case in `configurator/core/test/catalogue.test.ts`.
- The bench configurator describes release 0.21.0. Every repository source
  of its data is a file and line at the tag `v0.21.0`: 83 sources, 53 of
  them on the line the text moved to, in `shared/outputs/out_bind.c`,
  `shared/settings/settings.c`, `STATUS.md`, `docs/FirstRun.md`,
  `docs/Servo.md` and `docs/ServoProgrammer.md`. 9 sources name the text
  as the tag words it, IOmcu for coprocessor, ESC STICK on MOTOR & ESC >
  PROGRAM, the alert `Protocol versions do not match. ARMED is blocked.`
  and SERVO TESTER on SETUP > OUTPUTS. The AS5600 board's OUT and GPO,
  the GPO strap and the board's check name build guide stage 4: the rows of
  `docs/Building.md` they cited describe the panel's knob, an MT6701 since
  0.21.0, and are gone.
- The configurator's notes name the panel as 0.21.0 shows it: the
  protocol alert `Protocol versions do not match. ARMED is blocked.`
  (German `Protokollversionen passen nicht zusammen. ARMED ist gesperrt.`),
  SERVO TESTER and PORT PWM on the PROG PORT entry of SETUP > OUTPUTS in
  place of SETTINGS > DUT > PWM TARGET. The German texts take the German
  panel's words: SERVO-TESTER, PROG-PORT and PORT-PWM with the hyphen, EIN
  and AUS, TRIMMUNG, WEG and UMKEHREN, ZENTRIEREN and FREIGEBEN, VERBINDEN,
  HV-SERVO, ANSCHLÜSSE for INTERFACES, and Pulsrate for the frame rate.

### Fixed

- Each time LOGS opens from the menu or returns from WI-FI, it reads the
  card's first page and selects the newest run. A run recorded while LOGS
  was closed is on the list without RESCAN. A file's import or plot view
  left open stays open, with the list behind it read again. The card was
  read on the first opening after a start only.

## 0.21.0 - 2026-10-18

0.21.0 is a testing release. Its minor number, 21, is odd. GitHub lists
it as a pre-release.

A bench on 0.20.0 loads the panel over Wi-Fi or over USB (Universal Serial
Bus), and the IOmcu over CAN (Controller Area Network) from the image the
new panel carries. CHECK FOR UPDATES on a 0.20.0 panel does not find
0.21.0: it reads `releases/latest`, which names the newest usable release,
v0.20.0. The panel's browser page accepts the upload with workarounds for three
faults in 0.20.0. The English page has a JavaScript syntax error, and the
browser sends the form without the file; the German page takes the
upload. JOIN HOME NETWORK can report `Join failed: password refused.` even with
a correct password; ACCESS POINT joins no network. A panel with Rotary
knob ON saved blanks at the knob's first poll after each start, takes CAN
off the link and can hold the touch controller in reset, so update that panel over
USB. The steps are in [First run, §1](docs/FirstRun.md#from-0200):

1. `sha256sum -c SHA256SUMS` prints `OK` for each of the three files.
2. SETUP > APPLICATION, Language `DEUTSCH`, not saved; a panel in German
   skips this. The restart in step 4 starts 0.21.0 in the language saved.
3. With the bench SAFE, the supply output off and no log run open:
   LOGS > WLAN > ACCESS POINT. Join the network the screen names with its
   password, open `http://192.168.4.1/` and enter the access code.
4. Upload `rcbench-panel-v0.21.0.bin`. On the panel, hold `2 s HALTEN:
   INSTALL`. The panel writes the slot it does not run from, restarts and
   keeps 0.21.0 once the display and touch are up. Its settings in NVS
   (non-volatile storage) and its board drawing stay.
5. At link-up the panel finds another build on the IOmcu by SHA-256 (Secure
   Hash Algorithm) and raises `IOmcu runs a different build. Update it
   under SETUP > UPDATES.`. Hold START 2 s on the question on the menu, or
   `HOLD 2 s: UPDATE IOMCU` on SETUP > UPDATES, with the bench SAFE, the
   supply output off and the Wi-Fi radio off. The band then says `IOmcu
   updated to 0.21.0.`.

A panel with Rotary knob ON saved, or a bench without a phone or computer
on Wi-Fi, takes `rcbench-panel-v0.21.0.zip` over USB as for 0.19.0, and
step 5 follows. Flashing the individual parts with `write_flash @flash_args` keeps the settings,
Rotary knob ON included, which 0.21.0 reads from an MT6701 at 0x06;
`rcbench-panel-merged.bin` at 0x0 erases them. A bench on 0.19.0 loads the
panel over USB and the IOmcu over CAN; a new bench and a bench on 0.18.0
or older load both boards over USB. The link protocol stays 4.22, so both
boards link before and after the IOmcu's update. Upload and CAN update durations are not measured.

### Added

- SETUP > UPDATES has RELEASES: USABLE | TESTING (the same words in
  German, setting `upd_channel`, USABLE by default), kept with SAVE on
  SETUP. USABLE keeps the check on
  `https://github.com/subtilitas/rcbench/releases/latest`, which never names
  a pre-release. TESTING asks
  `GET https://api.github.com/repos/subtilitas/rcbench/releases?per_page=10`
  with `Accept: application/vnd.github+json` and
  `X-GitHub-Api-Version: 2022-11-28`, reads `tag_name` and `draft` of the
  10 newest releases by date, testing or usable, and takes the highest
  version among non-draft releases. The scan retains only the current tag
  and the highest version found. The answer needs status 200 and a
  `Content-Length` from 1 to 262144 bytes; the 10 newest releases on
  2026-10-18 were 108198 bytes. A `tag_name` that is missing, over 18
  bytes, not a plain JSON (JavaScript Object Notation) string, or not `v`
  and MAJOR.MINOR.PATCH in any of the 10 releases refuses the whole answer,
  each with its own second line under `Unexpected answer from GitHub.` A 403 or 429
  answer is `GitHub's request limit is reached: HTTP 403.`, with no retry.
  The same 30 s budget for the join, the address and the request applies.
  The start-up check and its reminder follow RELEASES. A switch of RELEASES
  hides the last check's result, so a release found on the other setting is
  not offered.
- On both settings a check offers only a release newer than the running
  build: a panel on testing release 0.21.0 with USABLE is not offered
  0.20.0. A running build whose version does not parse is offered nothing
  (`The panel's own version is not MAJOR.MINOR.PATCH: no update offered.`).
- The LOG VIEWER reaches every file on the card in pages of 48, newest
  runs first. PREV and NEXT (German `VORIGE` and `NÄCHSTE`) in the header
  row turn the page; they show only on a card of more than 48 files.
  Pages are cut from the top, so PREV with fewer than 48 entries ahead
  of the page, after a run was recorded, shows the first page. One page
  costs one walk of the card's root directory and holds 48 entries in
  memory. RESCAN reads the page shown again, and a page emptied by DELETE
  or a shrunk card shows the last page left.
- The LOG VIEWER list has a scroll bar 42 px (8.1 mm) wide at the right
  edge. Its thumb represents the visible rows as a proportion of the page.
  Touching the track centres the thumb there; dragging it scrolls the page.
- The LOG VIEWER header names the card by its FAT (File Allocation Table)
  volume label, read once per mount through `f_getlabel`
  (`CONFIG_FATFS_USE_LABEL=y`). A card without a label shows the name the
  card reports of itself, as before.
- The SERVO screen runs the installed-limit search: START LIMIT RUN on
  TEST's LIMIT RUN card, a 2 s hold while ARMED. On a SERVO PWM pin it searches from
  PULSE CENTRE to PULSE MIN and to PULSE MAX; on the programming port it
  reads the KST or Chaservo servo first, in a session of the programmer,
  and searches from the servo's NEUTRAL to its own PULSE LOWER and PULSE
  UPPER, never past them. A servo whose PULSE LOWER to PULSE UPPER lies
  outside the bench's PULSE MIN to PULSE MAX ends the run before anything
  is driven, `servo pulses outside MIN/MAX`, the bench left SAFE and both
  ranges named. The search runs in 10 us steps on INA3221 CH1's 50 ms
  windows, reports both endpoints in a `SERVOnnn.TXT` of its own, and changes
  nothing of the bench's own pulse range. It runs only with the INA3221 as
  the servo rail's meter, on a rail of 3.0 V or more in the last window
  (`SERVO RAIL UNDER 3.0 V OR NOT READ`), and on the bench's outputs only
  with an output bound as SERVO PWM; the line under the button names the
  output it drives and why it cannot start. The search and its protections
  read the current's magnitude, so a shunt fitted the other way round finds
  the same ends. The protections are active: 3.0
  A at every 1 ms sample, above 1.0 A for 400 ms, no window for 200 ms, 40 s
  a search, and a search's window without the rail voltage (`no rail
  voltage in a window`). A window without a current reading is not counted
  as a window. The supply's set points and output are held as at the start
  in every phase but the programmer's sessions.
- SERVO PULSES in the LIMIT RUN card's settings, KEEP or 1000-2000, for a servo on the
  programming port: 1000-2000 writes the servo's PULSE LOWER and PULSE
  UPPER to 1000.0 and 2000.0 us in the run's read session, before anything
  is driven, and reads them back. NEUTRAL is not written. It works with
  SEARCH ONLY and with SEARCH+PROG.
- SEARCH+PROG lowers LEFT ANGLE and RIGHT ANGLE of a KST or Chaservo servo
  on the programming port until neither end binds. The run takes the travel
  as linear in the pulse from NEUTRAL to PULSE LOWER and PULSE UPPER; that
  is not measured. Each bound side gets 2 writes: an overset 3 % above the
  share of travel at the first search's first bound pulse, which keeps the
  stop reachable, and the final value from the share the overset's search
  found free. A side free after the overset ends the run as FAIL, `no stop
  after the overset write`. At most 8 values are written a run. The
  register for each side is found from the run's first write. A later
  session that reads another type, REVERSION, other pulses or another range
  of values ends the run, `servo holds other values`. A run that ends while it waits for ARMED asks SAFE, so an
  ARM not yet taken does not arm the bench. A run's write refused before it
  is sent switches ENABLE WRITE TO SERVO off again. A write that fails once
  sent counts as written, so the box and the report offer RESTORE; a run
  that sent no write reports no backup. During a run the supply log writes
  no row and its time runs on. A run that fails inside a session completes LEAVE before ending the
  programmer's part of the run. A current reading of
  -32768 mA counts as 32768 mA in the protections. Without a PD mini a run
  on PROG PORT needs 4.8 V or more on the servo rail in the INA3221's last
  window, `PROGRAMMING: SERVO RAIL BELOW 4.8 V`. From a servo run's start,
  and from an automatic test's OPEN on, to the close of its file, Wi-Fi
  and an update wait. The FOUND and FREE boxes name the output the run
  started on. A PD mini that answers with its output off at a run's start
  stays off: switched on outside a session it ends the run, `supply or rail
  voltage changed`, and a run on PROG PORT does not start,
  `PROGRAMMING: PD MINI OUTPUT OFF`. A PD mini first heard after the
  start ends the run the same way, its output on or off, and no CONNECT
  goes to a PD mini the run did not start with. A search window
  under 3.0 V, the first one included, ends the run, `supply or rail
  voltage changed`. A run's `Backup:` line names the file
  its own first write saved, also when that write is sent and lost. No
  automatic test or limit run starts until the card has taken the last
  run's file open and close. RESTORE offers `Values
  before the limit run`, LEFT ANGLE, RIGHT ANGLE, PULSE LOWER and PULSE
  UPPER as the run found them; a session after the run saves its own backup
  file at its first write.
- A touch injector for the measurement bench: a Waveshare RP2350-Zero that
  answers as a GT911 at 0x14 and presses where a USB serial command says
  (`testbench/touch-injector`). It starts listen-only, names the line that
  carries SCL, and attaches only after `confirm scl=GP5`. The wiring check
  counts agreement over the transactions that name a line, and needs 20 of
  them and at least half of all; the verdict line reports them as
  `named=`. A panel built with `RCBENCH_TOUCH_INJECTOR=ON` reads 0x14 after
  the glass, merges both with the glass first, shows `INJECT` in the MODE
  chip, and counts a silent injector as lost touch. After 1000 ms without
  an answer it detaches the injector, so the glass alone decides touch and
  the heartbeat returns with the bench SAFE; it reads the product ID once
  every 1000 ms and re-attaches the injector on the first answer, with no
  contacts down. Release images are built without the option.
- The home tag that leaves SETUP for the menu with values unsaved opens a
  warning, `UNSAVED CHANGES`. It lists each value that differs from the
  stored one as `name: stored -> now`, 9 lines and `and N more` past 10
  changes. STAY closes it; DISCARD sets every value back through the path a
  key takes and opens the menu, and is refused while the bench is ARMED;
  SAVE asks for the write and opens the menu. A save asked (`WHEN IDLE`)
  opens no warning; a refused one does. STOP, the tool tiles and every
  screen the panel opens by itself pass without it. After a refused save,
  DISCARD also asks for a write of the values put back. The copy of the
  stored values takes 400 bytes of internal RAM; the heap left with the
  largest Wi-Fi mode up is 91,224 bytes.
- `tools/check_sizes.py --check` holds the files over 1,000 lines to
  `tools/check_sizes.txt`, one reason per file and a line count with a
  tolerance of 100 for six of them. It fails on an unlisted file over
  1,000 lines, a listed file at or under 1,000 and a count outside its
  tolerance. CI runs it with the tree checks.
- SETUP > UPDATES has an IOmcu section under its buttons: the version
  the IOmcu runs, the version of the image the panel carries, a line
  of state and `HOLD 2 s: UPDATE IOMCU`. The 2 s hold starts the
  update the link-up's question starts, also after that question was
  declined, and the progress returns to UPDATES. It takes what the question
  takes: another build, SAFE, the supply output off, the Wi-Fi radio wholly
  off and no panel install. Otherwise it is grey and the line names the
  first of 11 reasons that holds. After an image found on trial is kept,
  the panel compares the IOmcu's build with its own again, and after
  an update of an IOmcu of another protocol major ends, its next
  answer to the 1 s identity probe starts that comparison.
- Releases come in two kinds by the tag's minor number. An odd minor
  number is a testing release (0.21.x, 0.23.x), published as a GitHub
  pre-release and never marked latest; an even minor number is a usable
  release (0.22.x, 0.24.x), published as a full release and marked latest.
  The patch number carries fixes in either kind. `tools/release_kind.py`
  reads the tag in the form the panel's update check reads and prints
  `kind`, `prerelease` and `latest`; it exits 1 on a tag out of form.
  `release.yml` runs it before it waits for CI, which fails a tag out of
  form before anything is built, and again at the publish with the tags
  of the full releases GitHub holds then: a usable tag older than one of
  them is not marked latest, so `releases/latest` never moves back.
  Publish jobs run one at a time across tags.
  [Building](docs/Building.md#releases) states the rule.
- First run §1 names what a bench loads by the release it runs, and gives
  the load of a 0.20.0 bench in five steps: the panel over Wi-Fi through
  the German browser page, or over USB for a panel with Rotary knob ON
  saved, and the IOmcu's update over CAN that follows.

### Changed

- The TARGET row behaves the same on MOTOR & ESC and on SERVO: a tap opens
  SETUP > OUTPUTS on what the workbench drives, and the home tag there
  comes back to the workbench on the task the row was tapped on. From
  MOTOR & ESC OUTPUTS opens on the protocol the throttle's pins are bound
  as (the overview while they are bound as several or none is known),
  from SERVO on what the row shows (the PROG PORT entry while the IOmcu
  drives the port, SERVO PWM while it drives the outputs, the overview
  while the target is not known), not on the TARGET setting; from SETUP's
  tile on the overview. The row keeps its locks: ARMED, a sweep or a run,
  the servo programmer holding the port.
- OUTPUTS lists the IOmcu's programming ports as outputs: its protocol
  list ends in one PROG PORT entry per port the IOmcu reports (1 today, at
  most 4; one while the count is not known; none for an IOmcu older than
  protocol 4.13), its rows 41 px tall instead of
  46 px so 9 rows fit. The entry shows the port's pin lit and read-only
  (`PIN GP13`), what the port carries (`CARRIES SERVO PWM AND KST/CHASERVO
  PROGRAMMING`; no throttle protocol), and on port 1 SERVO TESTER (OUTPUTS
  | PROG PORT) and PORT PWM (ON | OFF) as segments, locked under the
  SERVO screen's rules with the reason under them. These two are the one
  home of the PWM target and Port PWM settings. The servo programmer's
  locked line reads `Set SERVO TESTER to PROG PORT on SETUP > OUTPUTS.`.
  OUTPUTS and PICK A PIN hold every reported port's pin and check the PWM
  slice rule against each, as the IOmcu does.
- SUPPLY is a workbench with the LIVE | SETTINGS strip (German `LIVE`,
  `OPTIONEN`) of MOTOR & ESC and SERVO, two tabs of 112 x 24 px at the top
  left. The SETTINGS button at the top right and the overlay's CLOSE are
  gone: SETTINGS is a tab, its page takes the left column under the strip,
  and the menu's tile opens LIVE. A tab switch closes an open keypad
  unchanged; while the question about a live output is open, the strip
  takes no tap. The header (source, ONLINE or NOT ANSWERING, the range)
  is the row right of the strip and stays in sight on both tasks and under
  the keypad and the question. PLOT | TABLE sit under the strip on LIVE,
  and the rail's four cards are 54 px high from y 38. The title SUPPLY
  SETTINGS (German `NETZTEIL-OPTIONEN`) is removed. A frame of the
  `supply` mode costs 8,034 cache-line fills (8,580 before), a full repaint
  30,543 (31,606).
- The menu tile ANALYSER and the title of its screen read RECEIVER, in
  English and in German. The SETUP category and tile APPLICATION read PANEL
  (German `ANWENDUNG` reads `PANEL`). The identifiers `SCREEN_ANALYSER` and
  `analyser_screen_*`, the render view names and the help page file
  `analyser.md` keep their names.
- The 8 menu tiles carry new lines under the name, 2 rows of at most 23
  characters: MOTOR & ESC `drive, V/A, rpm`, SERVO `travel, current,
  program`, SUPPLY `set and log V/A`, LOGS `runs and files`, RECEIVER
  `S.BUS, PPM, frames`, BATTERY `cells, iR, mAh`, BALANCE `vibration,
  phase`, SETUP `pins, sensors, panel`. The German lines are in
  `docs/Screens-de.md`.
- SETUP > INTERFACES shows its 26 settings under 4 headings: I2C BUS, PHASE
  TAP, BALANCE SENSORS and SUPPLY (German `I2C-BUS`, `PHASENABGRIFF`,
  `BALANCE-SENSOREN`, `NETZTEIL`). A heading is a row of its own, 54 px at
  the 58 px pitch, with no keys; the list is 30 rows long.
- The RP2350 board is named IOmcu (German `der IOmcu`) in the panel texts,
  the help pages, the configurator and the documentation. It was called the
  coprocessor (German `Koprozessor`). Upper-case texts read `IOMCU`, for
  example `IOMCU UPDATE`. Identifiers, file names, CAN page names and the
  entries of released versions keep their wording.
- The alert for an IOmcu on another build names the place of the update:
  `IOmcu runs a different build. Update it under SETUP > UPDATES.` (German
  `IOmcu nutzt einen anderen Build. Update unter SETUP > UPDATES.`). It said
  that an update is available in the menu.
- Band titles follow their tiles: SETUP (was SETTINGS), LOGS (was LOG
  VIEWER) and WI-FI (was FILES & UPDATE), English in both languages.
- SETUP has a WI-FI tile between PICK A PIN and UPDATES, line `NETWORK,
  FILES, UPLOAD` (German `NETZWERK, DATEIEN, UPLOAD`). It opens the WI-FI
  screen, which LOGS' WI-FI button opens too. WI-FI's home tag returns to
  the screen that opened it, and so does CLOSE on PANEL UPDATE after an
  upload's install failed. UPDATES' `Stopped:` line for it reads `Stopped:
  the WI-FI screen is using Wi-Fi.`
- The home tag climbs one level on PROGRAMMER and LOGS, as their BACK
  does: a device page to its protocols, a maker's models to the makers, a
  list to the classes, the plot to the import, the import to the file
  list. Over the RUN warning it is CANCEL, over the manual steps OK, over
  the DELETE question CANCEL. A stick run under way ends as ABORT ends it,
  and its result stays on the page. The home tag leaves PROGRAMMER from
  the classes and LOGS from the file list.
- The band's chips use their 24 px label inset until a row would reach
  x 226, where MOTOR & ESC's home tag ends, the widest. ARMED with a FAULT
  code still reaches under that tag, to x 224, in German x 216.
- UPDATES' hint without a home network reads
  `Save a network under SETUP > WI-FI.` (German
  `Speichere ein Netzwerk unter SETUP > WI-FI.`).
- `ram_budget.py --check-doc` holds the PSRAM .bss table in Performance
  and its German page to the build's map file: each object
  `psram_bss.lf` names, the count, the total and ESP-IDF's own 13,742
  bytes.
- `stack_check.py --iomcu --check-doc` holds the count of calls through a
  register reachable from core 0's `main` in both Performance pages, and
  core 0's sentence in `STATUS.md`.
- Run logs are named by the writer that made them: `SERVOnnn.CSV` and
  `SERVOnnn.TXT` for the automatic servo test and the limit run,
  `ESCnnn.CSV` for a switch of the throttle outputs to ARMED (MOTOR & ESC, a
  stick run on PROGRAMMER), `BENCHnnn.CSV` for a switch of the surfaces to
  ARMED from SERVO and for a SUPPLY run. With an IOmcu older than
  protocol 4.18 every switch to ARMED covers the throttle outputs, so a
  switch to ARMED from SERVO writes `ESCnnn.CSV`. The numbers 001 to 999 are
  one series across the three names: a run takes one above the highest
  number on the card under any name, and a card holding a number 999 takes
  no further run. A card holding only `BENCHnnn` files continues above their
  numbers. The LOG VIEWER lists, pages and deletes all three, newest number
  first across the names, opens on the highest number, and deletes a run's
  report under the run's own name. Two runs with one number, which only a
  card edited on a computer holds, follow by name. Its empty card reads
  `Runs are saved as BENCHnnn, ESCnnn or SERVOnnn.CSV.` Firmware 0.20.0 and
  older numbers runs above the highest `BENCHnnn` file only: going back to
  it on a card written since can give a run a number that an `ESCnnn` or
  `SERVOnnn` file already carries, and nothing is overwritten.
- The LOG VIEWER tab reads `FILES 1 TO 48 OF 200` (`DATEIEN 1 BIS 48 VON
  200`) on a card of more than one page.
- The LOG VIEWER draws the rows of a page newest run first, the order the
  pages run in, where it drew them by name.
- After DELETE the LOG VIEWER keeps the scroll and selects nothing, so
  DELETE and OPEN are grey until a row is chosen; it selected the page's
  newest run, which can be out of sight.
- The panel's directory walk reads a directory through FatFs `f_readdir`
  and takes each file's size from the directory entry. The 48 `stat`
  calls a LOG VIEWER listing made are gone; on a card of 999 runs each of
  them read up to 63 directory sectors.
- OUTPUTS and PICK A PIN open on the overview on every visit: OFF selected,
  every bound pin named by its protocol in full-brightness text. A tap on a
  pin changes nothing and writes nothing until a protocol is picked in the
  list; picking OFF goes back to the overview. The line under the list reads
  `CHOOSE A PROTOCOL, THEN TAP PINS` (German
  `PROTOKOLL WÄHLEN, DANN PIN TIPPEN`). OUTPUTS shows no pin count and PICK
  A PIN no PINS table on OFF. OFF stays selected across leaving the screen
  and read-backs. A change of board, such as an IOmcu that answers or
  is swapped during the visit, selects OFF whatever was selected, so a
  protocol picked before is not carried to it. Opening either screen writes
  nothing to the IOmcu.
- A value stepped back to the one stored is no change: SAVE returns to
  `SAVED`, and a write asked for and not yet taken is dropped. After a
  refused save the label stays `NOT SAVED` or `SAVE` until a save
  succeeds.
- The bench configurator describes release 0.20.0. Every repository source
  of its data is a file and line at the tag `v0.20.0`; 24 sources carry the
  line of that tag, in `STATUS.md`, `docs/Building.md` and
  `docs/FirstRun.md`. Release 0.20.0 adds no bench function.
- The automatic servo test on the INA3221 ends ABORTED after 200 ms without
  a window, `no INA3221 window for 0.2 s`, in place of 500 ms. The limit
  run shares the figure (`SERVO_TEST_WIN_STALE_MS`).
- A servo run's `SERVOnnn.TXT` report counts as an open log run until the
  card has closed it, as its CSV does: Wi-Fi and an update wait for it, and
  the log viewer neither lists nor opens it while it is written.
- The SERVO settings' line that says the setup is not saved spans the
  card: the German text is 296 px wide.
- The panel's texts are reworked: 846 English and 895 German strings change
  wording in `shared/ui/ui_text.def` and `shared/ui/ui_text_de.c`, and one
  string, `MO_THROTTLE`, is new. The pages that quote a string show the new
  wording, and `docs/Language.md` lists the German terms that change, among
  them VERBINDUNG for the link, ZUORDNUNG for a binding, GAS for the
  throttle and FIRMWARE for an image.
- SERVO is a workbench. A strip under the band holds LIVE, TEST, PROGRAM
  and SETTINGS (German `LIVE`, `TEST`, `PROGRAMMIEREN`, `OPTIONEN`), 112 px
  a tab; the tile
  opens LIVE, each task keeps its page for the session, and a tab switch is
  no navigation level. LIVE holds the dial. TEST holds two run cards,
  AUTOMATIC TEST and LIMIT RUN, each with a summary line, its start hold,
  the last result and its file; the card's SETTINGS opens the run's own
  settings one level down, and the home tag closes them. SETTINGS holds the
  pages OUTPUT, SWEEP (CURVE, SPEED, RANGE) and DUT (NAME, REPORT, ENC
  CENTRE, PORT PWM).
- SERVO's TARGET row on the output card reads `protocol pins`
  (`SERVO PWM GP2 GP4`, `PROG PORT GP13`) and is the control that picks
  the target: a tap opens OUTPUTS / PROG PORT. It is locked while ARMED,
  during a sweep or a run, and while the servo programmer holds the port.
  PWM TARGET leaves the DUT page, and AS5600 leaves it for SETUP >
  INTERFACES alone.
- SERVO > PROGRAM lists the programmers from one table,
  `shared/ui/prog_registry.c`, a row each: its name, and what it drives
  with the pin. The one row, `KST and Chaservo servos` (German `KST- und
  Chaservo-Servos`) with `PROG PORT GP13`, opens the KST and Chaservo
  programmer over the left column, one level down. CLOSE or the home tag
  returns to the list; while the port is in programming both open LEAVE
  PROGRAMMING, and over an editor in the programmer the home tag closes the
  editor. A row whose capability the IOmcu does not report is dimmed with
  its reason, `IOMCU HAS NO SERVO PWM`, and opens nothing: with no IOmcu
  answering, the KST row too. A row whose port another row's programmer
  holds reads `PORT IN USE`. A list of more than 9 rows gets SEARCH,
  more than 8 rows shown get group headings, and a list taller than the
  page pages with `^` and `v`. Back on SERVO with the port held, the
  programmer is open on PROGRAM.
- Programming is on the workbenches: ESCs on MOTOR & ESC > PROGRAM, servos
  on SERVO > PROGRAM. The PROGRAMMER tile and its screen are gone. The menu
  is a grid of 4 x 2 tiles of 190 x 204 px by kind: MOTOR & ESC, SERVO,
  SUPPLY and LOGS in the first row, ANALYSER, BATTERY, BALANCE and SETUP in
  the second. A fourth workbench or instrument fails the build at 4
  columns.
- MOTOR & ESC > PROGRAM lists the ESC programmers from the table SERVO's
  list comes from. Its one row, `ESCs by throttle stick` (German `ESCs per
  Gasknüppel`) in the group STICK MENU (German `STICK-MENÜ`), opens ESC
  STICK full width: over the left column, the rail and the tabs, one level
  down. In place of the tabs the strip row holds the output strip, `TARGET
  DSHOT300 GP0 GP1   SUPPLY 7.60 V  1.00 A   SAFE` (German `ZIEL`,
  `NETZTEIL`), at most 97 characters. Opening ESC STICK on a bench that
  is not SAFE switches it to SAFE. The home tag climbs ESC STICK one
  level at a time, then closes it to the list; leaving MOTOR & ESC ends a
  run, switches the bench to SAFE and closes the session.
- MOTOR & ESC is a workbench. The strip holds LIVE, PROGRAM and SETTINGS
  (German `LIVE`, `PROGRAMMIEREN`, `OPTIONEN`), 112 px a tab; the tile opens LIVE, and LIVE keeps
  PLOT or TABLE across a switch. LIVE holds the plot or the table and the
  throttle; PLOT, TABLE, the poll rate and the link's errors sit on a line
  under the strip. SETTINGS holds the 8 ESC / BENCH settings under PACK,
  MOTOR and THROTTLE OUTPUT (German `AKKU`, `MOTOR`, `GASAUSGANG`), each
  set on a keypad. A value is in force at once and asks for a write, which
  the panel makes when the bench is SAFE and idle; the write takes every
  unsaved value, SETUP's included. A line under the rows names the store's
  state: `SAVED`, `SAVE PENDING`, `NOT SAVED` or `SETUP CHANGES NOT SAVED`.
  Idle pulse and Full pulse take a value only on a SAFE bench with ARM not
  held, `Set on a SAFE bench only`. Over the keypad the home tag closes it; otherwise it
  leaves and the bench switches to SAFE. The rotary knob moves the throttle
  on LIVE only.
- ESC / BENCH leaves the SETUP hub, which holds APPLICATION, INTERFACES,
  OUTPUTS, PICK A PIN, WI-FI and UPDATES, with 3 slots free.
- MOTOR & ESC's TARGET row moves from the throttle panel to the top of the
  CONTROL card and names the protocol with the pins, `DSHOT300 GP0 GP1`,
  in a box of 18 characters: `MIXED` for two or more protocols, `NO MOTOR
  PIN` and `PINS NOT READ` in the warning colour. A tap opens OUTPUTS, and
  OUTPUTS' home tag returns to MOTOR & ESC on the task it left. The row is
  locked while the bench is not SAFE, while ARM is held and while the servo
  programmer holds a port.
- SUPPLY's voltage and current caps are no longer set on SERVO. TEST and
  DUT show them read-only, `Caps 21.00 V 5.00 A: SUPPLY > SETTINGS`.
- The limit run's report and box name the output with its protocol,
  `SERVO PWM GP2`. The automatic test's report heads its limit section
  `AGAINST THE PASS/FAIL LIMITS`.

### Removed

- SERVO's own choice OUTPUTS / PROG PORT behind its TARGET row, and the
  PORT PWM row of SETTINGS > DUT; both settings are set on OUTPUTS' PROG
  PORT entry.
- The modelled ESC and SERVO classes of the PROGRAMMER screen, with their
  CONNECT, READ and WRITE on the panel's own copy of a device. Their
  parameter tables for BLHeli_S, AM32, ESCape32, VESC and Hitec D-series
  stay as data (`shared/ui/prog_models.c`); no PROGRAM list has a row for
  them.

### Fixed

- The home tag on SUPPLY, WI-FI, OUTPUTS and PICK A PIN climbs one level a
  tap, as on MOTOR & ESC, SERVO, SETUP and LOGS. On SUPPLY it drops the
  change a question holds, as CANCEL does, then closes a keypad with the
  value unchanged; SETTINGS is a task of its strip, no level, and the tag
  leaves from it as from LIVE. On WI-FI it climbs from a keyboard to the
  network list, keeping nothing typed, and from the list to the buttons;
  over the question about an uploaded image it is CANCEL, and a second tap
  while the image is still there leaves. On OUTPUTS
  and PICK A PIN it closes the open protocol list, choosing nothing. The
  first tap left the screen before, and a typed SSID or password went with
  it. A SUPPLY drag that ends without its finger lifting, at the home tag
  under a second finger or a contact the touch controller loses, asks no
  question.
- A switch to ARMED with the IOmcu connected is refused while the IOmcu
  does not hold the panel's Idle pulse and Full pulse: the CHAN_CFG read
  refused, Idle pulse not below Full pulse, the write refused, or an
  acknowledgement whose throttle channels stored another pair. Each has its
  own text, which names what to change (`No pulse range from the IOmcu.
  Update the IOmcu firmware, then hold ARM again.`, `Idle pulse is not below
  Full pulse. Change one, then hold ARM again.`, `The IOmcu rejected the
  pulse range. Change Idle pulse, Full pulse or OUTPUTS.`, `The IOmcu holds
  another pulse range. Change Idle pulse or Full pulse.`, in German as
  well). The refusal ends at the first synchronization that confirms the
  pair is in force after an edit, a binding written on OUTPUTS or PICK A
  PIN, or a link-up.
  A refused pair ran the throttle on the IOmcu's own range before.
- An Idle pulse or Full pulse edit published while the frame that switches
  to ARMED is on the wire switches the bench to SAFE again in the next
  exchange, with `Pulse range not yet sent to the IOmcu. Hold ARM again.`.
- A switch to ARMED with the IOmcu connected is refused while an Idle pulse
  or Full pulse edit is still owed to it, with `Pulse range not yet sent to
  the IOmcu. Hold ARM again.` (German `Pulsbereich noch nicht an den IOmcu
  gesendet. ARM erneut halten.`). The frame that switches to ARMED carries
  no CHAN_CFG, and an edit reaches the IOmcu at the first poll 300 ms or
  more after it, so a switch that won the race ran the throttle on the
  range held before the edit. The panel asks before CLEAR, writing nothing,
  and again after it. The bench stays SAFE, ARM is held again, and STOP is
  unchanged. The update is complete when the IOmcu acknowledges the pair
  or a read shows that the page already holds it. An unanswered read or
  write leaves it pending. Link-up requires synchronization again at the
  first poll.
- Performance and its German page give `log_viewer_screen`'s PSRAM .bss
  as 35,400 bytes and the 17 objects' total as 162,904 bytes, as the
  ESP-IDF v5.4 build places them.
- Performance, its German page and `STATUS.md` give 133 calls through a
  register reachable from core 0's `main`, the figure of the image CI
  builds with arm-none-eabi-gcc 13.2.1; ARM GNU 14.2 gives 142.
- `hardware/docs/IOBoard.md` cites `STATUS.md` by section and item name
  instead of by line, so a coverage table that grows does not move the
  citations. Its capability-word rows state that the panel reads the word
  at bring-up, at each link-up and after a SENSE set-up the IOmcu
  takes.
- SETUP, APPLICATION, Rotary knob ON no longer blanks the panel. 0.20.0's
  knob read an AS5600 at 0x36 on the panel's I2C (Inter-Integrated Circuit)
  bus, and 0x36 is one of the CH422G I/O expander's command addresses: the
  register pointer the knob wrote became the expander's output byte, which
  switched the backlight off, took CAN (Controller Area Network) off the
  link and could hold the touch controller in reset, until a restart. The
  knob is an MT6701 at 0x06: each poll reads 0x03 (angle bits 13 to 6),
  0x04 (bits 5 to 0) and 0x03 again, one byte each with a 5 ms timeout,
  every 10 ms, and every 100 ms while it does not answer. A poll whose two
  0x03 bytes differ is no reading. While the knob has no reference, an
  address-only probe comes first, which the bus driver does not log. A
  clockwise turn seen from the chip's top raises the value on the -STD
  part with DIR at 0; a step is 360/16384 deg. The panel refuses to put the
  knob, or any device of the builder's, at an address the board answers at
  on that bus, 0x14, 0x20 to 0x27, 0x30 to 0x3F and 0x5D, or at the I2C
  reserved 0x00 to 0x03 and 0x78 to 0x7F
  (`shared/bench/include/panel_i2c.h`). With no sensor fitted, Rotary knob
  ON probes 0x06 every 100 ms; in the host tests' bus model that changes
  nothing else, and on the panel it is not measured. The setting's help
  line reads `MT6701 turns the active slider` (German `MT6701 dreht den
  aktiven Regler`).
- A HOLD on the SERVO screen that reaches the control task more than
  500 ms after the far end last took one keeps the release it owes. The
  pause ends there, the screen shows the surfaces released, and the next
  pass writes the range and the centre pulse; a SWEEP asked next waits for
  that centre. The release was dropped on that path: no centre was written,
  a SWEEP asked next started where the surfaces had rested, and a HOLD
  naming a frame rate above the one in force (50 Hz by default) still
  sent its FRAME_HZ write. A control-task pass longer than 500 ms, or HOLD
  repeats left unanswered with the link up, led there. The far end's
  500 ms channel timeout rested the surfaces either way.
- OUTPUTS and PICK A PIN no longer offer a SERVO PWM or MOTOR PWM pin that
  the IOmcu's slice and compare-register rules refuse, which ended in
  `LAST WRITE: REFUSED` with no reason.
  A pin on the programming port's PWM slice (GP28 while the port holds
  GP13, both slice 6) and a pin on the compare register of a pin bound as
  PWM (GP16 beside GP0, and the pairs GP1/17, GP2/18, GP4/20, GP5/21,
  GP6/22) are held: grey, the cell `SLICE OF GP13` or `PWM CH OF GP0`, and
  a tap puts `GP28: PWM SLICE OF PROG PORT GP13` or `GP16: SAME PWM CHANNEL
  AS GP0` under the protocol. The panel decides with the IOmcu's own
  `out_pwm_same_slice()` and `out_pwm_same_compare()`
  (`outbind_pwm_clash()`). DShot and PPM are offered both pins.
- The LOG VIEWER's footer buttons are reachable while an alert shows. They
  sat at body y 392 to 433 on the file list and 390 to 431 on the plot,
  under the alert band (body y 398 to 431), which takes the touches there;
  the import view's ran 16 px into it. Every footer sits at body y 352 to
  393, 4 px above the band. The file list shows 6 rows instead of 7, and the
  plot is 242 px high instead of 276.
- The INJECT mode chip of a panel built with `RCBENCH_TOUCH_INJECTOR=ON`
  opens a bubble with two paragraphs: where touch comes from, the I2C
  address 0x14, how old touch counts, and what a silent injector does
  through the 200 ms, 500 ms and 1000 ms steps to the detach and the probe
  that re-attaches it. It showed the title alone. The released image holds
  neither the mode name nor the text.
- Upload on the English page of the browser access works. The script of
  the page wrote the texts `The file is larger than the panel's slot.` and
  `The upload broke off.` inside single quotes unescaped; the apostrophe
  of the first text ended the string, the script did not parse, the form had
  no handler, and the browser sent the form itself: it went to `/?` and
  the file was dropped. The German page was not affected. The writer
  `wa_out_js()` escapes backslash, `'`, `"`, `<` (as `\x3c`), control
  characters, and U+2028 and U+2029 in every text inside the script. The
  file input is `required`, so Upload with no file chosen shows the
  browser's own message. An answer other than HTTP 200 with an empty body
  (403 stale cookie, 503 access closed) shows `The panel did not take the
  upload: HTTP 403.` (German: `Das Panel hat den Upload nicht angenommen:
  HTTP 403.`) and the progress bar ends on every answer and on a broken
  connection. `test/host/check_wa_page.py` hands every script of both pages
  to `node --check`; the CI host job runs it.
- The start-up check of 0.20.0 can end with `Join failed: password
  refused.` on a correct password, and JOIN HOME NETWORK pressed after it
  joins. One auth-class drop of the station ended a join: ESP-IDF reports
  a wrong password and a key handshake answered late with the same
  reasons, 15 and 204. A join ends as `password refused` after 3
  auth-class drops in a row within 20 s (`WA_AUTH_TRIES`, `WA_JOIN_MS`);
  a single one connects again, and any other drop sets the count back to
  0. A join that reaches 20 s ends as `password refused` when its last
  drop was auth-class, and as `network not found` after any other drop or
  none. The GitHub check, the download and JOIN HOME NETWORK count alike.
  Every drop goes to the serial log as one line with its reason number.
- The panel's picture can sit 17 px to the left, with the tail of each
  line wrapped one line down, until the panel restarts. It happens after a
  frame whose bounce-buffer refill interrupt is held off for more than
  512 us, which a main-flash operation on a scanning panel does for its
  whole length: a settings save, the board drawing's keep, a panel update.
  ESP-IDF v5.4 and v5.5 restart the scan at the first VBlank (vertical
  blanking interval) interrupt after the operation ends, which can be
  mid-frame, through a DMA (direct memory access) link that skips 17 px of
  an LCD (liquid crystal display) FIFO (first-in, first-out buffer) they
  have just emptied. The panel links a copy of that driver, written at
  configure time by `tools/patch_rgb_driver.py`, in which every restart is
  the clean start of boot: the first whole frame after a restart is in
  place. The console logs each restart as
  `display: scan restarted, N since start`.
- `tools/stack_check.py` counts the chain through `cu_port_exchange()` in
  the control task's depth. The IOmcu update's requests go through
  that port, which recovers the bus and then calls `exchange()`; the
  check followed only `port_exchange()` and counted the other call as
  followed (`PORT_CALLS`).
- `tools/stack_check.py` reports each task's deepest chain with no
  function on it twice, whatever the functions' addresses. The check kept
  a depth cut short where a chain met a function already on it, and gave
  that depth to every later caller, so a chain through a cycle read up to
  416 bytes low: `main_task` 5,024 bytes for 5,440, `control_task` 4,032
  for 4,448, `fetch_task` 2,400 for 2,816, `log_task` 2,992 for 3,408. The
  check splits the call graph into its strongly connected components,
  keeps the depth of each function entered from outside its component, and
  tries every way through a component. The `runlog` task's stack is 4,608
  bytes, 256 more: its deepest chain is 80 bytes over the limit of its
  4,352-byte stack.

## 0.20.0 - 2026-10-15

To update from 0.19.0, flash only the panel over USB (Universal Serial Bus). A 0.19.0 panel takes no image over Wi-Fi: ACCESS POINT
stops with `Wi-Fi did not start.` as it is pressed, and the internal RAM (random-access memory) estimate indicates that
JOIN HOME NETWORK also fails.
The panel takes the parts from `rcbench-panel-v0.20.0.zip` with
`esptool.py --chip esp32s3 -p PORT write_flash @flash_args`, which keeps the
settings in NVS (non-volatile storage) at 0x9000, or
`rcbench-panel-merged.bin` at 0x0, which erases them; a browser flasher such
as the ESP Web Tool writes the merged image. Both writes end with the
application, about 2.1 MB from 0x0, and keep the stored board drawing at
0x7E0000.

The coprocessor needs no USB update: at link-up the 0.20.0 panel
finds another build on it by SHA-256 (Secure Hash Algorithm), and the menu
offers the update over CAN (Controller Area Network) from the image the
panel carries, behind a 2 s hold of START, while the bench is SAFE with the
supply output off. The update writes the slot the coprocessor does not run
from, and its bindings stay in the store. For a coprocessor that did not receive the
0.19.0 USB update the band says `coprocessor takes no update over CAN --
load it once over USB`, and it takes `rcbench-iomcu-install.uf2` from
`rcbench-iomcu-v0.20.0.zip`.

A new bench and a bench on 0.18.0 or older load
both boards over USB, as for 0.19.0. The steps are in [First run,
§1](docs/FirstRun.md#1-flash-both-boards). From 0.20.0 on, the panel
installs a release over Wi-Fi or downloads it from GitHub on UPDATES. The
link protocol stays 4.22; the coprocessor's sources are those of 0.19.0
apart from the version. The CAN update duration is not measured.

### Added

- The bench configurator lists 2 more functions of the base setup: the panel
  update and the card files in a browser over Wi-Fi (the FILES & UPDATE
  screen), and the coprocessor firmware update over CAN (Controller Area
  Network) from the panel. Neither needs a part beyond the panel and the
  coprocessor; the panel update needs no microSD card. The base setup runs
  12 functions.
- Web help for the panel at
  [subtilitas.github.io/rcbench/help/](https://subtilitas.github.io/rcbench/help/),
  in English and German, published to GitHub Pages beside the bench
  configurator. `tools/help_site.py` builds it from `help/content/` and the
  screenshots of `tools/render_ui.py`, with no package outside the Python
  standard library. Its format is in `help/site/FORMAT.md`. The pages carry
  no script and load nothing from other servers. The README in both
  languages and the configurator's footer link to it; the footer link adds
  0.2 kB to the configurator's first load, 249.1 kB of 250.0 kB.
- `tools/help_site.py --check` in CI (continuous integration) fails on a
  screen without a page in either language, a screenshot that
  `render_ui.py` does not render or that has no PNG (Portable Network
  Graphics) file in the page's language, an English and a German page whose
  headings or screenshots differ, a link to a missing page or heading, and
  Markdown outside the subset.
- SETUP has an UPDATES tile, which opens the UPDATES screen. CHECK FOR UPDATES joins the home network kept
  on FILES & UPDATE, sends one HTTPS (hypertext transfer protocol over
  transport layer security) request to
  `https://github.com/subtilitas/rcbench/releases/latest`, reads the newest
  release's tag from the redirect's `Location` header and
  switches the radio off again, within 30 s for the join, the address and
  the request. The card then says `Version 0.20.0 is available.`,
  `Up to date: this panel runs 0.19.0.` or why the check failed. The tag is
  read strictly: `v`, then MAJOR.MINOR.PATCH, digits only, each 0 to 65535
  in at most 5 digits without a leading zero.
- REMINDER AT START (setting `upd_remind`, on by default) runs the same
  check once after each start, at the first moment the bench is SAFE with
  the supply output off, no log run open, FILES & UPDATE closed and no
  coprocessor update offered or running, and within 10 min of the start.
  When it finds a newer release, a reminder opens on the menu with IGNORE
  NOW (until the next start), NEVER REMIND ME (switches the setting off and
  saves it) and HOLD 2 s: DOWNLOAD & INSTALL. It waits while the bench is
  ARMED, the supply output is on, or the coprocessor's update question or
  progress is up.
- HOLD 2 s: DOWNLOAD & INSTALL, on UPDATES and on the reminder, downloads
  `SHA256SUMS` and `rcbench-panel-vX.Y.Z.bin` of the release found over
  HTTPS into PSRAM (pseudo-static random-access memory), following at most
  3 redirects and only to `github.com`, `release-assets.githubusercontent.com`
  and `objects.githubusercontent.com`. The image's SHA-256 must equal its
  `SHA256SUMS` line and the image passes every check an uploaded one does;
  then the install runs as INSTALL runs it. The download takes 180 s at
  most from the hold, ends on CANCEL, STOP, ARMED, the supply output, a log
  run or a board drawing being fetched, and writes nothing before every
  check has passed. A download and the coprocessor's update exclude each
  other as an install and the update do.
- The panel checks HTTPS servers against ESP-IDF's (Espressif
  Internet-of-Things Development Framework) bundle of common certificate
  authorities (16,984 bytes), with mbedTLS's memory in PSRAM. The panel
  image grows by 127,856 bytes, and the free static internal RAM goes from
  42,806 to 40,174 bytes. How long the check and the download take on a real
  network is not measured.
- A radio start that fails logs the step, the error's name and the free
  internal heap with its largest block. The panel logs the free internal
  heap, its largest block and the free PSRAM once at start-up.
- `tools/ram_budget.py` estimates the internal heap left with each Wi-Fi
  mode up from the panel build, the panel's task stacks, queues and
  buffers and three allowances, and fails under 32,768 bytes. CI runs it
  after both panel builds; on ESP-IDF v5.4 it holds the table in
  [Performance](docs/Performance.md#internal-ram).
- First run §1 lists the USB files for each running release and describes
  the panel-only update of a 0.19.0 bench in four steps. It explains what
  each panel flash preserves and the coprocessor update over CAN that
  follows.

### Changed

- SETUP opens on a page of 3 by 3 tiles in the menu's style: ESC / BENCH,
  APPLICATION and INTERFACES with their number of settings, and OUTPUTS,
  PICK A PIN and UPDATES with a line each; 3 slots are free. A category's
  list spans 776 px of the panel's 800 and shows 6 rows, over a strip with
  the category's name, RESET CATEGORY and SAVE that ends 4 px above the
  alert band. The home tag climbs one level: from a list
  to the tiles, from OUTPUTS, PICK A PIN and UPDATES to the tiles, from the
  tiles to the menu. SAVE shows on the tiles as on every list. The texts
  `PINS: A LIST OR THE BOARD` and the UPDATES key are gone; the tiles add
  `PROTOCOLS AND PINS`, `ON THE BOARD DRAWING` and `RELEASES ON GITHUB`.
- Every menu tile's icon is centred in its box above the tile's name. On 0.19.0 the icons of MOTOR & ESC, SERVO, ANALYSER, LOGS, SETUP
  and PROGRAMMER sit 15 px right of the name, and those of SUPPLY, BATTERY
  and BALANCE 15 px higher than the others.
- Screens describes the menu's MODELLED mark per tile, in English and
  German. The mark follows the capability bits the coprocessor reports and
  the sensors enabled on SETUP under INTERFACES; it does not classify each
  value. MOTOR & ESC goes without it when the coprocessor drives ESCs (electronic speed controllers) and
  holds an INA228 set-up enabled on SETUP, SERVO when it drives servo PWM
  (pulse-width modulation) outputs, SUPPLY when the PD mini is enabled.
  ANALYSER, BATTERY, BALANCE and PROGRAMMER carry it in this release; LOGS
  and SETUP never do. With no coprocessor answering, MOTOR & ESC and SERVO
  carry it too.
- The bench configurator describes release 0.19.0. Every repository source
  of its data is a file and line at the tag `v0.19.0`; 23 sources carry the
  line of that tag, in `STATUS.md`, `docs/Building.md` and
  `docs/FirstRun.md`.

### Fixed

- ACCESS POINT fails on 0.19.0 with "Wi-Fi did not start." the moment it
  is pressed: internal RAM (random-access memory) cannot hold the Wi-Fi
  driver's static buffers, 51,200 bytes of DMA-capable (direct memory
  access) memory that `esp_wifi_init()` takes. By the same estimate a home
  network, the network search and the release check fail the same way.
  The zero-initialised data of 15 screen, card and page objects, 161,340
  bytes, and that of lwIP (lightweight IP stack) and the Wi-Fi driver's
  libraries, 13,742 bytes, move to PSRAM. The internal heap at start goes
  from 126,768 to 299,320 bytes, and the heap left with the largest Wi-Fi
  mode up from an estimated -81,168 to 91,384 bytes. The free heap on a
  panel and the frame rate with the screens' state in PSRAM are not
  measured.

## 0.19.0 - 2026-10-15

Flash both boards over USB (Universal Serial Bus) when setting up a
new bench or updating from 0.18.0 or older. The coprocessor takes
`rcbench-iomcu-install.uf2` from `rcbench-iomcu-v0.19.0.zip` on its
`RP2350` drive in BOOTSEL mode: the partition table and the image in slot
A. The panel takes the parts from `rcbench-panel-v0.19.0.zip` with
`esptool.py --chip esp32s3 -p PORT write_flash @flash_args`, which keeps
the settings in NVS (non-volatile storage) at 0x9000, or
`rcbench-panel-merged.bin` at 0x0, which erases them. The panel's stored
board drawing is lost once and fetched again at the next link-up. The
coprocessor keeps its bindings; on an RP2350 of stepping A2 the load can
erase the old store's second sector at 0x3FF000. The steps are in
[First run, §1](docs/FirstRun.md#1-flash-both-boards).

After this USB update, the
panel installs a release over Wi-Fi from `rcbench-panel-vX.Y.Z.bin`, and the
coprocessor takes its image from the panel over CAN (Controller Area
Network). The link protocol is 4.22, and a 0.18 board still links with a
0.19 one: a 0.19 panel shows `coprocessor takes no update over CAN -- load
it once over USB` for a 0.18 coprocessor, and a 0.18 panel never asks a
0.19 coprocessor's update pages.

The coprocessor's flash has two image slots
of 2036 KiB and the output store at 0x3FC000. A panel built with
`RCBENCH_IOMCU_BIN`, as the release is, carries the coprocessor image of its
build, compares builds by SHA-256 at link-up and offers the update behind a
2 s hold of START: 64-byte blocks with a CRC-16 (cyclic redundancy check)
each, a SHA-256 over the image, a trial boot confirmed by the panel with BUY, and
a return to the old image after 16.7 s without confirmation.

The panel's flash has two
application slots of 4,063,232 bytes. LOGS → WI-FI opens FILES & UPDATE,
which runs an access point or joins a home network (WPA2 or WPA3 personal)
behind an 8-character access code, takes an uploaded panel image, checks
it and installs it on a 2 s hold of INSTALL on the panel, and starts the new
build on trial with rollback to the previous build. The same page lists the
files on the card, offers individual downloads or the whole card as one stored
ZIP. The radio runs only while that screen is open on a bench in SAFE with
the supply output off and no log run, and goes off after 10 min without a
request. A panel install and the coprocessor's update exclude each other.

The coprocessor counts the CAN frames it refuses (protocol 4.21, STATUS
registers 8 and 9), and MOTOR & ESC (electronic speed controller) shows the
count above 0. A tap on a chip of the status band opens a help bubble for
that chip. The time of a whole update over CAN is not measured (the bus
time of its 26,946 exchanges is 9.0 to 37.7 s for the 0.18 image), nor are
the transfer rate of the Wi-Fi page and the duration of a panel install's
erase and write.

### Added

- The coprocessor counts the CAN frames it receives and refuses to decode:
  a receive buffer with an 11-bit identifier, a remote frame or a DLC above
  8, and a frame the link decode refuses (an unknown op, a count past a
  page, a DLC that disagrees with the count). Protocol 4.21: STATUS (0x01)
  has 10 registers, the count in registers 8 and 9, low half first, 32 bits,
  0 at power-up and wrapping at 2^32. The panel reads 10 STATUS registers
  from a 4.21 coprocessor and 8 from an older one, whose count reads 0.
  MOTOR & ESC shows `Link frames refused: N` (German `Abgelehnte
  Link-Frames: N`) in its header strip after the error count, while the link
  is up and N is above 0; the bring-up log line `iomcu` adds `refused N`.
- The panel updates the coprocessor's firmware over CAN. Protocol 4.22 adds
  UPDATE_CTL (0xF0) and UPDATE_DATA (0xF1); with registers 0 to 6 of
  IDENTITY they are frozen and answer under every later protocol major. The
  coprocessor's flash carries a boot ROM partition table: slots A and B of
  2036 KiB, the output store in its own 8 KiB data partition at 0x3FC000, the
  last 8 KiB unused. The panel sends 64-byte blocks, each committed with a
  CRC-16, checks a SHA-256 over the image, restarts the coprocessor into the
  new slot on trial and keeps it with BUY; without the BUY the boot ROM
  returns to the old image after 16.7 s. The coprocessor refuses ARM for the
  whole update and writes flash only while the bank is not driving, the
  supply's output is off and no servo programming session runs. A session
  ends after 5 s without a request to UPDATE_CTL or UPDATE_DATA, and a panel
  that finds one at its check ends it with ABORT. After the BUY the
  coprocessor erases the old slot's first sector and retries the erase once
  a second until it holds; `SLOT` bit 9 says it is owed. A panel
  built with `RCBENCH_IOMCU_BIN` carries the coprocessor image of its own
  build, compares builds by SHA-256 at link-up and offers the update on a
  question that START takes with the 2 s hold, an older image included; a
  progress screen without band follows. New texts: the question, the five
  progress steps, three notes and the alerts `coprocessor runs another build
  -- the menu offers its update`, `coprocessor takes no update over CAN --
  load it once over USB`, `coprocessor updated to %u.%u.%u`, `coprocessor's
  new image kept` and `coprocessor update stopped: %s -- the old image runs`.
- A tap on a chip of the status band opens a help bubble under the band
  that says what the chip's state means for the bench and what to do: LINK
  or NO LINK, BENCH or SIM, FAULT, SAFE or ARMED and the run clock. The
  FAULT bubble has one paragraph per set bit of the code, names the four
  bits this release never sets, and gives the bits the panel has no name
  for as a code. The LINK bubble ends with `Link frames refused: N` while
  the link is up and N is above 0. The text follows the state while the
  bubble is open. Any tap closes it and does nothing else; a press on STOP
  closes it and stops at once. Leaving the screen, or the chip going,
  closes it. German text in `ui_text_de.c`.
- The panel updates its own firmware over Wi-Fi. LOGS → WI-FI opens FILES &
  UPDATE, which starts the radio as an access point (2.4 GHz, channel 6,
  WPA2, `rcbench-` and 4 hex digits, an 8-character password new at every
  start, 1 client, `http://192.168.4.1/`) or joins a home network (WPA2 or
  WPA3 personal) chosen from a scan of up to 16 networks or typed as a
  hidden network on the panel's keyboard. A browser uploads
  `rcbench-panel-vX.Y.Z.bin` into PSRAM; the panel checks the whole image
  (ESP32-S3 image header, project name, version, appended SHA-256, size
  against the slot) and asks with both versions, saying when the image is
  older. INSTALL is a 2 s hold on the panel; the browser cannot start it. The
  write switches the radio off, withholds the heartbeat so the coprocessor
  holds its outputs in failsafe, shows the bytes and the percentage on a
  full screen without band and restarts the panel. The new build's first
  start is a trial: it is kept once display and touch are up, otherwise the
  build before starts again and says so on the band. A failed start is
  never marked valid, also when marking it invalid fails; a good start
  whose otadata write fails says on the band that the next start goes back.
- The same page lists every file on the card with its size in bytes and its
  modification time, sends each one, and sends the whole card as one stored
  ZIP file (ZIP64 over 4 GiB − 1 B or 65,535 entries) with its size shown
  before the click. The page reads the card only.
- An 8-character access code, new at every start of the radio, guards the
  page; 16 wrong codes switch the radio off. ACCESS CODE switches it off
  for both ways in; the screen then says the page is open to every device
  on the network.
- The radio runs only while FILES & UPDATE is open, with the bench SAFE,
  the supply output off and no log run open. It is off at every start and
  goes off on ARMED, STOP, the supply output, a log run, 10 min without a
  request and before an install writes the flash. Wi-Fi that cannot be set
  up at start leaves the screen grey with a line saying so.
- A Wi-Fi settings change that NVS cannot save remains pending, is retried
  3 times at intervals of 10 s, and shows `Not saved: the flash write
  failed.` until a write succeeds. A name responder (mDNS) that fails to
  start is tried again 3 times 5 s apart in each join.
- The panel's keyboard has a Wi-Fi mode: lower case, upper case (`ABC`) and
  the 32 ASCII marks (`#+=`), 8 to 63 characters for a password, 1 to 32
  bytes for a network name, the password shown as dots until SHOW.
- Each release carries the panel application on its own,
  `rcbench-panel-vX.Y.Z.bin`, covered by `SHA256SUMS`, for the upload.
- A panel install and the coprocessor's update exclude each other. INSTALL
  waits while the coprocessor's update or the BUY of an image on trial runs
  (`Install waits: the coprocessor's update runs.`, German `Installation
  wartet: das Update des Koprozessors läuft.`). The coprocessor's question
  opens only with the panel's radio wholly off and no install under way; a
  START pressed while either condition holds is consumed without starting
  the update, and the question opens again.
- First run §1 lists the four release assets and gives the USB load of both
  boards from them in four steps, with what each panel flash keeps and
  loses.

### Changed

- The panel's flash has two application slots of 4,063,232 bytes, `ota_0`
  at 0x20000 and `ota_1` at 0x400000, and `otadata` at 0x10000. The 1 MiB
  `storage` partition is gone, and `boardart` is 128 KiB at 0x7E0000 with
  8 slots of 16 KiB. `nvs` and `phy_init` keep their offsets. A panel
  flashed with an earlier release needs one flash over USB to reach this
  layout; the parts keep the settings, the merged image at 0x0 erases them,
  and the stored board drawing is fetched again
  ([First run, §1](docs/FirstRun.md#1-flash-both-boards)).
- The panel's application version (`esp_app_desc_t.version`) is the release
  number from `shared/link/include/rcbench_version.h`.
- The panel's bootloader is built with application rollback.
- A coprocessor loaded with protocol 4.21 or older has no partition table
  and takes one USB load of `rcbench-iomcu-install.uf2` (table and slot A).
  Bindings are read from the old store at 0x3FE000 until the first save. On
  an RP2350 of stepping A2 the load can erase 0x3FF000, the old store's
  second sector. Later coprocessor images come over CAN. See
  [First run](docs/FirstRun.md#the-iomcus-partition-table).
- The bench configurator describes release 0.18.0. Every repository source
  of its data is a file and line at the tag `v0.18.0`; 28 sources carry the
  line of that tag. The sources of the logger, of the arm decision and of the
  protocol mismatch alert carry the wording of that tag, which names the
  switch to ARMED, and the alert is quoted as `protocol mismatch -- will not
  switch to ARMED`.
- The configurator states the cap of the PD mini set point as 0.7 V under the
  input voltage of the module, in the texts of the supply, the ESC power
  safety note, the wire from the T-plug, both PD power sources and the 20 V
  charger row of the parts list. The parts list row of the PD mini Buck
  version keeps the 0.5 V of the vendor.

### Fixed

- Two SETUP hints fit their 36 cells: "For the remaining-charge estimate"
  and "If the ESC reports none; 0 = empty". The LOGS import range shows no
  decimal from 1000 in magnitude, 999.95 included, which one decimal rounds
  up to 1000.0, and has a space before the unit. A range wider than the 17
  glyphs of its 140 px box drops the decimal, then that space, so two
  5-digit negative ends with a 3-letter unit fit; a wider range is cut at
  the box's edge. `render_ui.py` lists no known overflow.
- When Tab focuses a checkbox during smooth scrolling, the configurator
  stops that scroll and immediately brings the row and its help bubble
  into view.

## 0.18.0 - 2026-10-14

The link protocol is 4.20. A 0.17 board still links and arms with a 0.18
one, since only the protocol's major number has to match, and an arm then
drives every output: a 0.18 panel writes ARM 1 to a coprocessor older than
4.18, and a 0.17 panel writes 1 to a 0.18 coprocessor. Arming by screen
role requires both boards to run 0.18. The SERVO frame rate on the PWM
(pulse-width modulation) target alone and the refusal of a pulse longer
than its frame need a 0.18 coprocessor. A 0.18 panel draws the board of a
0.17 coprocessor from its shape, and a 0.17 panel reads neither the drawing
a 0.18 coprocessor serves nor a version 2 record of an interrupted servo
write. Flash both boards.

PICK A PIN draws the coprocessor's board from a
drawing the coprocessor serves: the outline, the parts and every pad in
0.01 mm, 1,560 bytes with 40 pads and 102 shapes for the RP2350-CAN, checked
by the panel before it is shown. The board photograph is removed, and the
coprocessor image is 203,808 bytes smaller (184,360 bytes). PICK A PIN has
the protocol list of the Outputs screen, the count of the 8 slots in use and
a PAD column, and shows the programming port's pin (GP13 by default) as
taken.

An arm drives only the outputs of the screen's role: MOTOR & ESC
(electronic speed controller) and a PROGRAMMER stick run arm the throttle
channels, SERVO the surfaces and programming ports. The band reads ARMED
MOTOR or ARMED SERVO, and an arm for the other role switches to SAFE first
and arms after 100 ms. The screens that drive an output name its pins:
`TARGET: GP0 GP1` on MOTOR & ESC, the TARGET row on SERVO, `PD MINI TX GP12
RX GP13` on SUPPLY. RUN on ESC STICK is refused while no pin is bound as a
throttle, and leaving SUPPLY, SERVO or ESC STICK switches off a PD mini
output that screen switched on.

The coprocessor refuses a PWM endpoint
longer than the frame (1999 µs at 500 Hz) and a slew above 3000 (300 %/s),
and its TONE page answers BUSY (6) for a pin in use. The supply state shows
no valid reading after 1.5 s without a new one, and an output that is on
goes off after 3 s. A PD mini set point is capped 700 mV under the module's
input, 200 mV above the line a live output is cut at.

The panel build stops
on ESP-IDF (Espressif IoT Development Framework) v5.5.0 and v5.5.1: their
TWAI (two-wire automotive interface) driver sends a CAN (Controller Area
Network) frame of DLC (data length code) 0 as DLC 8, and a panel built there
never links. CI (continuous integration) builds v5.4 and v5.5.3. The bench
states read SAFE and ARMED in English and German. The bench log and the
supply log end in a column `source` (`measured` or `model`), and a last row
without a line feed is left out. The ESC and SERVO classes of PROGRAMMER
carry the MODELLED mark. The bench configurator adds the function "Program
a KST or Chaservo servo", a list of the parts to buy with a "Have it" tick
per row, a help bubble for each function and part in English and German,
the heat per resistor of the motor simulator, and the 7 to 12 V DC (direct
current) supply of the Osoyoo breakout board, and it keeps the selection and
the language in the browser.

The reply time of a real PD mini module, the
voltage drop on a real source and the signal level of the servo's reply on GP13
are not measured; the current the Osoyoo board's DC supply must deliver is
not stated.

### Added

- PICK A PIN draws the coprocessor's board from a drawing the coprocessor
  serves: the outline, the parts as flat shapes and every pad, to scale in
  0.01 mm on the board's real pad grid. Protocol 4.20: ARTWORK (0x26) has 9
  registers; format 2 (`LINK_ART_DRAWING`) is the drawing laid out under
  `LINK_DRAW_*` in `link_pages.h`, and registers 7 and 8 carry an FNV-1a
  hash of the payload next to its CRC. Each new board carries its drawing, coordinates and pad types in its
  coprocessor image. The panel checks
  the drawing (`link_drawing_parse()`) and its agreement with the board's
  shape, catalogue and pads (`board_drawing_agrees()`) before it shows it,
  and draws the board from its shape otherwise. The kept copy in the
  `boardart` partition is keyed on the board ID, format, outline, length,
  CRC and hash, so a coprocessor flashed with another drawing for the same
  board is fetched again. A 4.19 or older coprocessor is drawn from its
  shape.
- `tools/gen_board_drawing.py` writes
  `firmware/iomcu/src/board_drawing_rp2350_can.c` (1,560 bytes, 40 pads,
  102 shapes) from the configurator's `configurator/drawings/panel.json` and
  refuses a drawing the panel would refuse; CI runs it with `--check`.
  `npm run drawings` writes `panel.json` and `npm run drawings:check`
  compares it. The configurator's SVG drawings are unchanged.
- Configurator: the card of the motor simulator calculates the heat per
  resistor. Inputs: the LiPo pack (1S to 6S at 4.2 V per cell, default 4S,
  16.8 V), the resistance (the 21 E12 values from 100 Ω to 4.7 kΩ, default
  470 Ω), the rating (0.25, 0.5, 1, 2, 3 or 5 W, default 2 W) and the wiring
  (delta, the default, or star). The load case is 1 commutation step held at
  the full pack voltage V: in delta 1 resistor takes V²/R and 2 take V²/(4R),
  in star 2 take V²/(4R) and 1 none. The card shows current in mA, power in
  W and the share of the rating, a warning above the rating and a hint from
  50 % of it. The current limit of the ESC is not modelled. The link key `m`
  stores the values that differ from the default; a link without it opens
  the default values. The name of the part, its row in the parts list, the
  text and CSV copies and the PDF follow the values; a change of the
  resistance or the rating takes the "have it" tick off that row. The
  drawing of the motor simulator shows no colour bands and names no
  resistance.
- PICK A PIN has the protocol list of the Outputs screen, top left. It names
  the selected protocol; a pick selects it on both screens and writes
  nothing. Under it stand `N OF 8 SLOTS IN USE`, counted over every
  protocol, and in amber the reason no pin can be added, in the Outputs
  screen's words (`ALL 8 SLOTS IN USE`, `NEEDS 8 CHANNELS, 4 FREE`,
  `SERVO PWM TAKES 8 PINS`). The PINS table has a PAD column with the pad
  number printed on the board. Free keys are ivory in the row nearer the
  board and ebony in the row beyond it; a ground is a 36 px white round
  marker with a large G, 40 px in from its pad; a rail is a 32 px amber round
  marker with its voltage (5V0, 3V3, PWR), 30 px or 78 px in, alternating;
  RUN and 3V3_EN carry a dim cross. `ui_choice_face()`, `ui_choice_list()`
  and `ui_choice_row()` draw the protocol list on both screens. OFF picked
  on PICK A PIN ends when the screen is left, as on the Outputs screen
  (`outputs_screen_end_off()`). IN USE lists every pin: when 28 px pin rows
  run past the table's foot, as with OFF selected, the programming port
  listed and 8 pins over 6 protocols, the pin rows are 20 px;
  `picker_screen_in_use()` returns each line and its box.
- Configurator: every function with a tick and every part under "Parts you
  own" has a help bubble in English and German. It says what the item does
  and what it needs: the bench parts, the test object and the variant the
  resolver adds for it, and for a part its supply wires, logic and power.
  The bubble opens on the keyboard focus of the tick and on the "i" mark at
  the end of the row; a tap on the mark opens it without changing the tick.
  Escape, the loss of the focus and a press elsewhere close it. One bubble
  shows at a time. It opens under the row, or over it when the room under
  the row in the viewport and the scrolling chooser is too small and the
  room over it holds the whole bubble. `core/help.ts` holds the text of the
  12 functions; `tools/check.ts` checks it.
- The bench log and the supply log end in a column `source`: `measured` for a
  row a meter or the PD mini produced, `model` for a row the panel's model
  produced (`LINK_BN_SIMULATED`, `supply_state_t.modelled`). A file without
  the column is read as before; the column is text and is never plotted. The
  servo test's CSV is unchanged: its `meter` column names `MODEL`.

- The MOTOR & ESC throttle panel names the pins the throttle drives
  (`TARGET: GP0 GP1`), from the output pages the coprocessor's throttle role
  reads. No pin bound as a motor and a binding not read show in the warning
  colour. The SUPPLY header names the PD mini's UART pins
  (`PD MINI TX GP12 RX GP13`; `PD MINI NO PINS` when either is not set).
- `ui_pinlist()` formats a GPIO mask as a pin list within a cell budget:
  the pins that fit, then the count of the rest (`GP2 GP4 GP5 +2`).
  `outputs_role_pins()` returns the GPIOs of the slots whose channels carry a
  role.
- The DShot module exports the extended telemetry units: `DSHOT_EDT_MV_PER_COUNT`
  (250), `DSHOT_EDT_A_PER_COUNT` (1), `DSHOT_EDT_DEGC_PER_COUNT` (1) and
  `dshot_edt_millivolts()`, `dshot_edt_amps()`, `dshot_edt_celsius()`. The
  coprocessor firmware reads its ESC voltage, current and temperature through
  them.

- `CONTRIBUTING.md`, section "The active output": every screen, tab,
  overlay, prompt and automatic run that drives an output names the pin,
  port or supply it drives, from the state the drive path reads, with a
  warning when nothing is bound. A screen added or changed meets it with a
  host test; `STATUS.md` lists the screens that do not meet it.
- `tools/security_parsers.py --check`, run in CI, fails when the parser table
  in `SECURITY.md` and the parse functions in the public headers differ. The
  table holds the modules the name rule finds plus the forced ones in the
  tool, `shared/settings` (values and texts from NVS, non-volatile storage)
  and `shared/touch` (GT911 point list): 19 modules; it listed 4. The check also finds functions named
  `*_write`, `*_read`, `*_done` and `*_utf8_next`; `NOT_UNTRUSTED` is empty.
  The check fails if a forced entry names a missing module or duplicates
  one already found by the naming rule.
- `mutation.yml` runs every mutant of `shared/safety` and `shared/outputs`
  each Sunday at 03:17 UTC and on demand. A survivor does not fail it.
- The bench configurator offers "Program a KST or Chaservo servo"
  (`servoprog`, link `#v=1&f=servoprog`). It needs the panel and the
  coprocessor alone. Its tick puts the servo signal on wire 64, from pad 17
  (GP13), the programming port, in place of wire 7 on pad 4 (GP2). The
  result states that SETTINGS → DUT → PWM TARGET is PROG PORT, what the PD
  mini sets when it is part of the setup (4.8 to 6.0 V or up to 8.4 V with
  HV SERVO on, 50 to 3000 mA), that without it the programming voltage and
  current limit are stored and not applied, and that the level of the
  servo's reply on GP13 is not measured. Existing links keep their meaning:
  `kst` stays an unknown id.
- The bench configurator adds the DC supply of the Osoyoo breakout board,
  7 to 12 V DC (part `dcsup`, rule `osoyoo-dc`), to every setup in which the
  servo takes the V pin of a strip: a servo, no PD mini, servo power B
  (`servoPower: bench`) and the Osoyoo connection. In these setups the
  jumper V Selector sits on 5V, which takes its power from the DC input
  alone. The supply has 2 leads, wires 65 and 66, drawn as stubs to the DC
  jack, the VIN terminal or the header H4 (pin 2 PWRIN, pin 1 VIN-), exactly
  1 of them. The DC jack takes a 5.5 x 2.1 mm plug, centre positive; its
  minus is GND of the board, with no reverse-polarity protection. The
  product page names the socket DC005-2.1: the 2.1 mm pin follows from that
  name, and the 5.5 mm outer diameter is the usual size of that socket
  family, not stated by the vendor. The SI2302 in the lead VIN- protects the
  VIN terminal and H4 only, and the board notes state so. Above 12 V the
  gate-source voltage of the SI2302 exceeds its ±12 V rating: its gate sits
  at PWRIN through R7. The current the supply must deliver is not stated.
  The supply is the first modelled part (`Part.modelled`): the data states
  the range it needs, not a product, and the page and the PDF tag it
  "Modelled part: no product chosen". The drawing `dcsup` is a generic
  plug-in supply.
- The bench configurator lists the parts to buy for a setup, under "Parts
  to buy" ("Teile zum Kaufen") on the page and in the PDF export. Each row
  gives quantity, maker, ordering name, a check line, the maker page and a
  web search link (`https://www.google.com/search?q=` with the quoted maker
  and ordering name, or the quoted spec of a generic or modelled part). A
  disclaimer above the list names the release of the data. A part with a
  tick of its own under "Parts you own" is left out. The variant of a setup
  names its row: `o=osoyoo` adds the Osoyoo breakout board, `o=xt90` lists
  the XT90 INA228 module in place of the Matek board. The servo, the ESC,
  the servo supply and the ESC battery stand in a separate list "You bring"
  without links. "Copy as text" copies the setup link and the list; "Copy as
  CSV" copies 6 columns per row (RFC 4180). The links open in a new tab with
  `rel="noopener noreferrer"`; the page requests nothing from Google or a
  maker before a click. In the PDF each maker page and web search is a link
  annotation. Data: `Part.buy` with `maker`, `order`, `check`, `page`, `qty`
  and `only`, and `Part.yours`; `npm run check` reports a part without a row
  for a set of options, a variant without a row of its own, a page that is
  not https or carries a tracking parameter, and a brought part that names a
  maker.
- Each row of "Parts to buy" in the bench configurator has a tick "Have it"
  ("Habe ich"). A ticked row leaves the rows to buy and stands under "You
  have" ("Hast du"); removing the tick returns it. The rows under "You bring"
  have no tick. The URL hash keeps the ticks under the new key `h`, one row
  token each: the part id, or the part id, a dot and the row id
  (`#v=1&f=escpow&h=panel,wire.dmm`). A token that names no row to buy of the
  setup is dropped and named in the notice. Links without `h` open the same
  setup as before; the hash version stays 1. "Copy as text" lists the ticked
  rows under "You have", "Copy as CSV" leaves them out, and the PDF lists
  them under "You have". The tick works on a part that a function adds as
  well. Data: `Buy.id` names a row within its part; `npm run check`
  reports more than 1 row of a part without an id, an id that occurs twice
  in a part, and a malformed id.

- Every test of `test/host` stops after 120 s unless it sets its own limit,
  and every CI job has a `timeout-minutes` limit.
- `tools/check_protocols.py` checks the `_Static_assert` rule of CONTRIBUTING
  "Where code goes": the files outside `protocols/` with an assertion on a
  module's macros or enumerators are listed in the tool, and a new or a
  removed assertion fails the check.
- `tools/check_docs.py` checks every "N binaries" count of `STATUS.md` and the
  "N `test_kst_*` binaries" count, holds the pico-sdk and ESP-IDF tags of
  `docs/Building.md`, `docs/Performance.md` and their German pages to
  `ci.yml` and `release.yml`, and requires the SPDX line in the scripts
  under `tools/` and `test/tools/`. The 18 scripts without one carry it.

### Changed

- The splash's credit line reads "Designed by JuWi" in English and German.
- PICK A PIN places every pad, key and marker at the nearest pixel of its
  0.01 mm position instead of truncating it, so a drawn pad and its key
  meet. Positions move by up to 1 px.
- The panel's artwork store (`shared/artwork`) keeps any format with its
  hash: header version 2. Logs and comments name the board drawing; the
  `boardart` partition (2 MB, 8 slots) is unchanged. The panel image is
  4,256 bytes larger (1,127,872 to 1,132,128 bytes).
- Docs, configurator and the panel band name the input voltage of the PD mini
  and of the boards as "input voltage" (DE "Eingangsspannung") where a
  voltage is meant. The band text `ALERT_PDMINI_SAG` reads "PD mini input
  voltage ...". The German configurator and docs use the glossary terms
  Frame Rate, Ruderhorn and Pieptöne.

- The T-plug of the PD mini (`usbtap`) has no tick in the bench
  configurator: the PD mini brings it by the rule `pd-tplug`, and it stays in
  the setup, the parts list, the wires and the drawings whenever the PD mini
  is there. A link with `p=usbtap` loads; the id is dropped without a notice,
  and without the PD mini the setup holds no T-plug. A part that a rule adds
  along with a bench part reads "Included with these parts: PD mini."
  ("Enthalten bei diesen Teilen: PD mini."); a part that a rule adds for
  another cause keeps "Needed by: ". Copy link, its fallback field, the print
  header and the PDF link drop `p=usbtap`, the id of a function without a
  tick and a test object under `p`, which they name as the tick of its
  function; the address of the page keeps the link until a change. `f=usbtap`
  and `o=usbtap` keep their notice. Functions that the parts of the setup
  bring read "Enthalten bei diesen Teilen." in German. The sweep covers 8
  selectable parts, 4096 sets.

- The bench states are named SAFE and ARMED in English and German, as the
  status band shows them: in the panel texts, the docs and the configurator.
  The action reads "switches the bench to SAFE" / "schaltet den Prüfstand
  auf SAFE". The ESC STICK red-light results DISARMED and NOT ARMED read SAFE
  and STILL SAFE (German NOCH SAFE); the servo report's abort reason reads
  `bench SAFE`. The ARM and DISARM buttons, the protocol's command, register
  and error names (NOT_ARMED) and the OpenYGE state `DISARMED` keep their
  names.
- `tools/check_protocols.py` checks that a module's `README.md` has an
  "Interface" heading, a heading with "Trademark" in it where it names a
  brand, and the words "no pin driver" where the module has no `rp2350/`
  folder; the Interface heading and "no pin driver" count outside fenced
  code blocks and HTML comments only. That heading is any heading that contains
  "trademark", in any case, emphasis and link markup ignored. Brand names
  match anywhere in the file (paths, addresses, code blocks and comments
  included), in any case, with a version suffix (`DShot300`, `S.BUS2`) and
  inside an identifier, file name or number (`kst_session_t`, `hitec_x.c`,
  `www.futaba.com`, `2kst`), not next to a letter (`KSTART`, `KstSession`).
  An include path
  with a `..` component or an absolute path in a module fails; so does an
  include the tool cannot resolve (a macro operand, or the name
  `__has_include` outside a literal, also as the body of a macro; as the
  operand of `#ifdef`, `#ifndef`, `#elifdef` and `#elifndef` it passes, and
  as the operand of a `defined` term on an `#if` or `#elif` line that holds
  nothing but such terms, white space, `(`, `)`, `!`, `&` and `|`, on the
  directive's line as GCC reads it, which a comment or raw string literal
  across a line break continues), an
  `#include_next` of anything but a C standard header or, in a
  C file under `rp2350/`, a pico-sdk header, a line
  of only `#` or `%:`, any trigraph (`??` followed by one of
  `= / ' ( ) ! < > -`) anywhere in the C of the file, a token after an
  include operand, and a NUL byte anywhere in the file.
  `#import`, the `%:` digraph, line continuations (LF
  and CRLF, also with blanks between the backslash and the newline), a
  lone CR as a line end, `//` inside a string or a raw string literal, a
  quote without its closing quote, which runs to the line end (a
  backslash before that line end escapes nothing), a number with digit
  separators (`1'000`; a `'` before a `.`, a `$`, a universal character
  name or a character outside ASCII ends it), an exponent sign (`1e-x`),
  `$`, universal character names (also `\u{e9}` and `\N{...}` in gnu11,
  gnu17, gnu23, gnu++11 or later and C++23) and the characters outside
  ASCII that GCC 13 takes into an identifier (the ranges of ISO C11 Annex
  D.1; a number starts only at an ASCII digit, and a number or raw string
  literal starts after any character outside the ranges, as in C), a leading
  byte order mark, form feed and vertical tab are read. Each file is read under the literal rules
  of ISO C11 and C17, C++11 (raw strings), gnu11, gnu17 and gnu++11 (raw
  strings and delimited and named universal character names), C23 (digit separators), C++14 to
  C++20 (raw strings and digit separators), and gnu23, C++23 and gnu++14
  or later (all three); an include found under any of them counts. A line continuation inside a raw string literal is
  kept. The C of a `.pio` file is the text pioasm 2.3.0 writes into the
  generated header: the `% c-sdk {` blocks after the first `.program`,
  found as pioasm lexes the file (a `;` inside a `/* */` comment ends
  nothing, an empty block name is c-sdk, a lone CR is a character of its
  line, a block ends only at `%}` in column 0). The CMake include
  directories and link targets of a module are not checked, and a
  `__has_include` that a macro pastes together with `##` passes. `""R"(`
  and `''R"(` are read as C reads them, as a literal and a raw string,
  while C++11 or later reads `R` as a literal suffix, so an include that
  such a sequence hides in C and C++ reads is not found.

- The bench configurator states the supply of the V pins of the Osoyoo
  breakout board from its schematic REV 1.0, the XL1509 datasheet and the
  product page. The jumper V Selector (header H3, print 5V and 3V3) sets the
  V pins of all 40 strips: 5V from the XL1509 converter, fed by the DC jack,
  the VIN terminal or the 2-pin header H4 (chip input 7 to 40 V, print 7 to
  16 V, 2 A rated), 3V3 from the regulator fed by VSYS of the Pico board
  (500 mA rated, vendor values). Without a DC supply the 5V position gives 0 V. The data carries
  a warning to check the jumper before a servo is plugged in, since a servo
  gets 3.3 V in position 3V3, where the regulator is powered; whether USB
  alone powers it is not resolved. The data states that exactly 1 of the DC
  jack, the VIN terminal and the header H4 is connected. The vendor's
  workaround for USB alone, a Dupont cable from the S pin of the 3.3 V row to
  a V pin, is marked as not for the servo: that S pin is the 3V3 pin of the
  coprocessor board (pad 36), and with the jumper cap on 5V the cable puts
  5 V on it. With the servo on the external supply or the PD mini, the check
  entry `strip-servo-plus` states that the plus wire of the servo lead goes
  to that supply, through VIN1- and VIN1+ of the INA3221 board where it is in
  the setup, and the V pin of the strip stays free. The pro "plugs
  straight in" names the setup without the servo programmer and without the
  INA3221 current sensor. The data states that the Pico accepts 3.3 V I/O
  only, that the jumper cap sits on 3V3 as delivered, the voltage expected
  at the V pin per jumper position, and that without USB voltage the
  converter also feeds VSYS of the Pico board. Each check of the strip holds
  the facts of one source: schematic, product page, product photos, XL1509
  datasheet or SN74HC04 datasheet. A source of the kind `doc` names a
  document, its address and the place in it; the data check rejects one
  without them. The drawing of the board shows the jumper cap on the 5V
  pair, labelled "cap on 5V".

- An arm drives only the outputs of the screen's role (link protocol 4.18).
  ARM on the CONTROL page takes 0, 1 (every output), 0x0002 (throttle
  channels), 0x0004 (surfaces and programming ports) or 0x0006; any other
  value is refused with BAD_VALUE, and so is a change from one non-zero ARM
  to another. MOTOR & ESC and a PROGRAMMER stick run write 0x0002, SERVO
  writes 0x0004. A pin of a role the arm does not name sends no pulse. An
  arm for the other role disarms first and arms after 100 ms. SERVO sweeps,
  RESUME and SERVO_SENSE captures need the surfaces armed and answer
  NOT_ARMED on a bench armed for the throttle alone. STOP, heartbeat loss,
  link silence and a disarm still zero the whole ARM. A 4.18 panel writes 1
  to a coprocessor older than 4.18, which arms every output.
- The band's arm chip reads ARMED MOTOR, ARMED SERVO or, for an arm of every
  output, ARMED.
- The servo programmer takes no port while the bench is armed for the motor.
- Protocol 4.19: SERVO's frame rate drives the PWM target alone. With
  OUTPUTS as target it runs every PWM slot whose first channel is a surface,
  every programming port at 50 Hz. With PROG PORT as target it runs that
  port's pin alone; every slot keeps its OUTPUTS rate and every other port
  runs at 50 Hz. A SERVO rate change moves no throttle and no other output,
  and the pulse-longer-than-frame refusal (BAD_VALUE) judges the target
  alone. A change of PROG `TARGET` sets the rate to 0, and the panel sends
  it again with the next position. A port whose pin shares its RP2350 PWM
  slice with another port's pin takes 0 or 50 Hz only; a `PIN` write onto
  the slice of a target running at another rate is refused with BAD_VALUE.
  The SERVO screen's note in force names the target the coprocessor holds
  (`prog_link_drive()`): "OUTPUTS run at" or "PROG PORT GP13 runs at", in
  the warning colour while that target differs from the PWM TARGET setting,
  while the port has no pin, while PORT PWM is OFF and while the target is
  not known. The refusal note reads "a pin shares a PWM slice"; against a
  4.1 to 4.18 coprocessor the note in force reads "every PWM surface runs
  at". With no link the note in force names no rate: "No link: the rate in
  force is not known.". A PROG write refused because the silicon
  cannot bind a pin leaves SERVO's rate, its sweep and the slots' rates as
  they were.
- RUN on ESC STICK is refused while no pin is bound as a throttle, while the
  output binding is not read, and while the supply is the panel's model; the
  line beside RUN names the reason, in English and German, and such a reason
  closes an open warning.
- Leaving SUPPLY, SERVO or ESC STICK switches off a PD mini output that
  screen switched on: reported on, or an ON on its way. An output another
  screen switched on stays. Overlays, keypads, questions and the servo
  programmer on SERVO are no leave. A PD mini output switched on by the
  servo programmer's CONNECT is SERVO's. If SERVO switched the output on and the servo programmer still holds
  its port, leaving SERVO keeps the output on until the port is released.
  It then goes off unless SERVO has been shown again first; an ON
  SERVO asked for that is on its way when the port takes the supply counts
  as switched on. A touch loss during a hold on OUTPUT ON drops the ON. The
  screen drops one not yet sent. The control task drops one already sent, or
  switches the output off (`touch lost while switching on -- output off`)
  until a frame with an unbroken touch stream has seen it on. That frame can
  come up to 50 ms (one supply sample) before SUPPLY shows the output on. An
  ON a loss meets after that frame stays on, stays the screen's and goes off
  with the leave. MOTOR & ESC switches no supply; an ESC run there is
  powered from its own source.
- The servo programmer's record of an interrupted write (`KST/KST.TXT`) is
  version 2: `RCBENCH KST 2` with a `pin=` line, the GPIO the port drove.
  The record's lines name that pin (`Connect it on GP13 and READ ALL.`). A
  version 1 record, one with no pin (`FF`) and one with a pin above GP47
  are read and name the port. A record discarded leaves no pin behind: the
  next record names the pin of its own port. A panel of an earlier release
  does not read a version 2 record.
- The SERVO screen's right card has a TARGET row (German ZIEL) between SPEED
  and CENTRE that names the active PWM TARGET with its pins: `GP4` or
  `GP2 GP4` for the pins bound as SERVO PWM (as many pins as fit the 23
  cells of the value, then `+N`), `PROG PORT GP13` for the programming port (German
  `PROG-PORT GP13`), `PROG PORT` for a port target without a usable pin,
  with `PWM OFF` after either while PORT PWM is off
  (`PROG-PORT GP13 PWM AUS`). `NO LINK` (`KEIN LINK`) shows while no
  coprocessor answers and `NOT KNOWN` (`UNBEKANNT`) while the PROG page is
  not read or a write to it was not acknowledged; the tester sends no command
  in either. While the servo programmer holds the port, the row does not
  change: it keeps naming the target the coprocessor holds. The warning
  colour marks five states: the programming port, no SERVO PWM pin
  (`NO SERVO PWM PIN`), a binding not read, no link and a target not known.
  The pins come from the binding the tester drives. The row follows the
  target the coprocessor holds (`prog_link_drive()`), not the PWM TARGET
  setting. The right card stays in sight under the settings, their keypads
  and the servo programmer, so the row names the pin while they cover the
  left card.
- The SERVO screen's type row carries the pulse range after the type and the
  frame rate, `STANDARD PWM  50 Hz  1000-2000`, in place of the RANGE row
  (`BEREICH`) under SPEED, which the TARGET row takes.
- The SERVO screen names the supply on the line over the power plot
  `PD MINI` in both languages, in place of `SUPPLY` (`NETZTEIL`). While the
  panel's model stands in for the PD mini, a MODELLED pill (`SIMULIERT`),
  20 px high and 24 px plus the word wide, at least 88 px (88 px for
  MODELLED, 96 px for SIMULIERT), sits on the plot's top-left corner. With INA3221 CH1 as
  the meter the line shows no pill.
- `sbus_to_us()` rounds to the nearest on both sides of 1000 us. Below raw
  172 it rounded the other way: raw 0 gave 896 us, now 895 us; raw 171 gave
  1000 us, now 999 us.
- `docs/Receivers.md`, `docs/Screens.md` and the S.BUS module README state that
  no firmware feeds the analyser screen: the S.BUS core is in the panel image
  and the host tests, no byte source exists, and the screen shows SILENT. The
  German pages follow.
- The OpenYGE and the output driver headers state what the code does: a frame
  of version 3 or above is read with the 6-byte header, `crc_errors` and
  `rejected` count a failing candidate once, at the front of the buffer, and
  `out_dshot_bind()` / `out_ppm_bind()` return false and keep the old binding
  for a bound pin with other settings. The DShot module README,
  `docs/DShot.md` and `docs/DShot-de.md` state this.
- `dshot_throttle()` maps a command above its span to 0 (motor stop), as
  `dshot_frame()` maps a value above 2047 to 0. It mapped it to 2047. A
  command equal to the span still maps to 2047. The firmware passes
  `outputs_actual()` against a span of 1000, so no stored value of 0 to 1000
  changes.
- The coprocessor refuses a PWM (pulse-width modulation) endpoint longer
  than the frame of the output that renders it, with BAD_VALUE, on CHAN_CFG,
  OUTPUTS, a BIND commit, SERVO's frame rate and PROG's `PWM`, `MIN_US` and
  `MAX_US`. The longest endpoint is the period minus 1 µs: 1784 µs at
  560 Hz, 1999 µs at 500 Hz, 2499 µs at 400 Hz; below 400 Hz the 2500 µs
  ceiling governs. A standard 1000 to 2000 µs servo is refused at
  500 Hz and 560 Hz. A stored PWM slot that breaks the rule starts unbound.
  Link protocol 4.16. The panel writes a programming port the range the
  SERVO screen names before it switches the port's pulse on.
- Text corrections, no behaviour change: SECURITY.md lists the input
  parsers of 19 modules; the Manifest drops its state column and points to STATUS.md;
  STATUS.md, Building and the READMEs list the `pages.yml` workflow and the
  directory layout; sizes, counts and figures in the KST, DShot, configurator,
  NOTICE and First run texts match the code; the Servo, OpenYGE and
  monostable comments no longer say that unwired code runs; DShot, Servo,
  Bringup and Manifest German pages match the English ones.
- The host tests are built with the flags of the libraries, `-Wall -Wextra
  -Werror -Wshadow -Wconversion -Wno-sign-conversion`, and
  `tools/render_ui.py` builds `render_screen.c` with the same flags. clang-tidy
  and cppcheck run over `test/host/` in CI; the checks that are off for the
  tests are listed with their reasons in `test/host/.clang-tidy`, and
  cppcheck's `constParameterCallback` on the page callbacks of the link tests
  is suppressed inline, with the reason. The `analysis` job
  timeout is 30 min. Test code fixed under the stricter rules: canvases built
  with a zero clip rectangle in `test_kst_panel`, ids cast to a 16-bit type for
  an 8-bit field, an out-of-range float to integer conversion in the settings
  record helper, and allocations used without a check (`REQUIRE_ALLOC` and
  `REQUIRE_REALLOC` in `greatest.h` end the case with the line).
- The cppcheck command in CONTRIBUTING.md names the include directories the
  way CI does, and the list of failing changes names the flags and the scope
  of both analysers.
- The supply state reports no valid voltage or current (`ok` 0) when the
  supply's reading count has not moved for 1.5 s (`SUPPLY_LINK_STALE_MS`),
  with the last values kept. If the count stays unchanged for 3 s
  (`SUPPLY_LINK_BLIND_MS`) while the page still answers, an active output
  is switched off, and the band says `supply sends no readings -- output
  off`. The PD mini driver takes a reading 400 ms past its due
  (`PDMINI_POLL_LATE_MS`) -- the display, the output state, the input or
  the slot -- before the next set-point write, one at a time with another
  transaction between two. A slider dragged with SLIDER AND STEPS off, a
  new set point about every 50 ms, then gets a display read 500 ms after
  the last one with a module answering at once and a state read 900 ms after the last one, so the count
  keeps moving, and an output the module switches on while an OFF is
  asked, or off by its protection, is seen during the drag. The state read,
  and the input read before a write, may also follow another reading
  straight away. The input read before a set-point write or an ON goes out
  only when one is waiting, and not between the reads for an ON, so set
  points and an ON reach a module that answers up to 390 ms late: one set
  point within 2.5 s, an ON within 3.6 s at set points already written and
  up to 7.5 s right after a set point change, a state the module changes
  itself seen within 2.1 s during a drag (host model, 40 start phases; the
  real module's reply time is not measured). Current limitation: a module
  answering late stretches the 500 ms state and input reads at rest -- the
  input 850 ms apart at 100 ms late, 2.5 s at 390 ms, the state up to
  1.5 s -- so a sagging input is cut 1.7 s after the sag at 100 ms late
  and up to 4.7 s up to 390 ms (about 1.0 s with a module answering at
  once), and an output the module switches on while OFF is asked stays on
  up to 1.8 s at rest. Current limitation: with replies 279 ms or more late, a drag
  holds the display read 3.7 s to 5.0 s, past `SUPPLY_LINK_BLIND_MS`, and
  the panel switches an output that is on off, possible from 263 ms with
  the panel's page read every 100 ms; at rest the display read stands up
  to 2.5 s at 390 ms, and the cards can show dashes from about 260 ms.
  The INA228 temperature and diagnostic flags go with the part on the tick it goes offline. An AS5600 STATUS byte with both the magnet-too-weak and magnet-too-strong bits set is a failed
  sample. A mark kind passed as a trace trigger is ignored, and the trace
  drops a sample while a shunt or configuration record is owed and counts
  it after that record.
- The servo limit search and the synchroniser keep every command inside 500
  to 2500 µs. The search refuses a step of 0 µs (fault `BAD_CONFIG`), keeps
  an endpoint backed off past the centre at the centre, and ends at the end
  of the pulse range. A last step shorter than `step_us` reaches the end of
  the travel, so the end is measured before `NO_LIMIT`. Both stop on a current that is not a number. The
  synchroniser reports `NO_MINIMUM` for a minimum at the edge of a scan
  window and runs at least one round.
- `tools/sense_trace.py` starts a new boot only when the tick runs back by
  more than 100 ms; a smaller inversion stays in the boot and keeps the
  signed difference. The `$D` line is documented as written about 50 ms after
  its `t=`, and `servo_move.h`, `bench_frame.c` and `servo_sync.h` describe
  what the code does.
- Link protocol 4.17: the TONE page refuses a pin held by an output, SENSE,
  SUPPLY or a programming port, and a capture the coprocessor cannot start
  for now, with the new NACK reason BUSY (6), and keeps BAD_VALUE for values
  no freed pin makes good and for an enabled tap on a coprocessor whose core
  1 did not start at boot. The panel shows that last case as `PIN NOT
  FREE` as well when the coprocessor's saved set-up has the tap enabled,
  and otherwise the refused message and `NOT RUNNING`; it clears only with
  a restart of the coprocessor. The
  panel offers a first frame refused with BUSY
  again every 5 s and writes one refused with BAD_VALUE again only after the
  next change of the set-up or link-up. From a 4.16 or older coprocessor,
  which says BAD_VALUE for both, it offers the frame again every 5 s when
  its tone range and gap are valid.
- The phase tap readout shows `WAITING` when the TONE page's flags say the
  tap runs and its window number has not moved for 1.5 s
  (`TONE_LINK_WINDOW_STALE_MS`).
- A read-back of FFFFh of the INA228's ADC_CONFIG or the INA3221's
  Configuration takes the part offline on that one read and counts in
  `RESETS`; another value that differs is still read a second time. The
  readings themselves are not checked for all ones.
- The CSV file of `tools/sense_trace.py` has a fourth column, `clipped`: 1
  at or past the top of the range, -1 at or past the bottom, 0 for a value.
- Trace format version 3: a `$D` line ends `cmd=` with its command's `$C`
  time, and `tools/sense_trace.py` ends that command with it, also when the
  output was let go and the next command came within 30 ms. The tool reads
  version 2 files with the 30 ms rule as before.
- The journal file's check in `kst_prog.c` calls `link_crc()`; a known-answer
  test holds the value CRC-16/CCITT-FALSE gives for a journal file.
- The programmer's pass gate uses C11 `<stdatomic.h>` in place of the
  `__atomic_*` builtins.
- The configurator takes the limit of 2 pictures per part from the core
  and uses one function to generate the assembly order for the page and PDF.
- `hardware/docs/pinmap.json` is `hardware/docs/ioboard-pinmap-draft.json`;
  `Pins.md` states that it is the draft of the planned IO board.
- The research workflow scripts are no longer in the repository. They are kept
  on the owner's machine, outside it; `ci.yml` no longer runs
  `session.py check`.
- The KST README names Tool Card #2 and Chaservo in its list of what is
  measured. `docs/Screens.md` and its German page state the 19,178 us
  window of a coprocessor flash save as 1 sample, with the flash part not
  yet identified.
- The release of the bench configurator is stated once, in the `version`
  field of `configurator/package.json`. The data file, the page header, the
  trademark notice, the print head, the source-link tag and the data check
  read it from there. `npm run check` in `configurator/core` compares that
  version with `RCBENCH_VERSION_*` in `shared/link/include/rcbench_version.h`.
  A header one release ahead, whose tag does not exist yet, is a warning,
  since the release pull request moves the header before the tag exists and
  `package.json` follows after the tag. A header ahead whose tag exists,
  `package.json` ahead of the header, a differing `version` field in
  `package-lock.json` and a README that names another release (in prose or
  as `"release": "X.Y.Z"`) are errors. The Configurator workflow also runs
  on a change of that header.
- `testbench/host/capture.sh` warns when a capture holds no samples or the
  read-back fails, and still prints the path. `selftest.sh` no longer reports
  `sigrok-cli --scan` error output as the analyser found, and skips a
  non-numeric `SWD_SWCLK` or `SWD_SWDIO`.
- `docs/Servo.md` and `docs/Servo-de.md` state that the limit search and the
  synchroniser are not called by the coprocessor image, give the scan windows
  of the synchroniser (±40, ±13, ±4 µs) and correct the half-turn example.
  The testbench documents carry no development history and the corrected
  splash hold (1.6 s), heartbeat rate and run state.
- The bench configurator describes release 0.17.0. Every repository source
  of its data is a file and line at the tag `v0.17.0`: 11 sources carry the
  line of that tag, and the source of the entry on serial ESC programming
  carries the line and the wording of `STATUS.md` at that tag. The list
  "Not in a release" holds 4 entries: the entry on the programming port for
  KST and Chaservo servos is removed, since 0.17.0 contains the servo
  programmer.
- The Configurator workflow shows each warning of the data check, such as a
  release tag newer than the data, as an annotation and in the run summary.
  The Release workflow runs the same check on every tag push and shows its
  warnings the same way. The check holds no release back.
- CI installs pillow 12.3.0, gcovr 8.6, ruff 0.16.5 and pytest 9.1.1 at
  exact versions.

### Removed

- The board photograph: `firmware/iomcu/artwork/rp2350-can.png`, its
  206,000-byte table `art_rp2350_can.c` and `tools/gen_board_art.py`. The
  coprocessor image is 203,808 bytes smaller (388,168 to 184,360 bytes). A
  photograph kept by an older panel is found as empty and replaced by the
  drawing.
- The placeholder screen for a screen id without a screen, its 16 English and
  16 German strings, the SOON tile mark and the per-file coverage exemption
  that existed for it. A screen id that names no screen draws the overview.
- Six exported functions used in one file are `static`: `esc_det_drop_group`,
  `esc_det_floor_only`, `ina228_ct_us`, `servo_test_start_str`,
  `balance_screen_angle` and `ui_tabs_label`.
- `ui_hero_render`, which no screen draws; `ui_hero_def_t` stays for the
  motor screen's rail cards.
- `board_lcd_reset()` in the panel firmware, which has no caller. The panel
  keeps `storage_deinit()`, the unmount for the SD card remount. Also the `conflicts` field of the configurator's resolved setup,
  which is always empty.
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
