subtilitas/rcbench/docs/img/de/servo-hitec-classic-repair.png

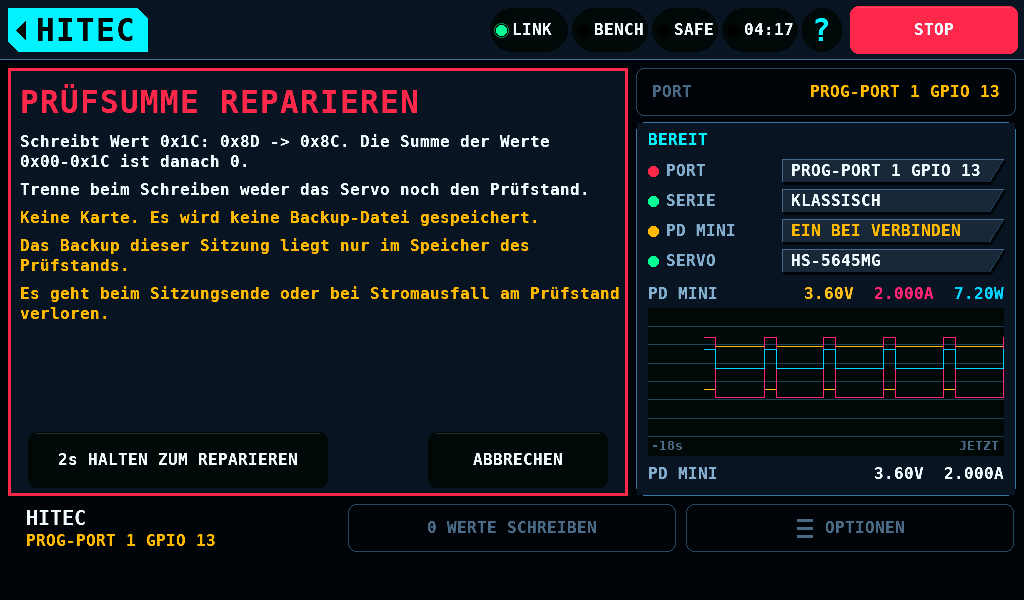
docs/img/de/servo-hitec-classic-repair.png
