subtilitas/rcbench/docs/img/de/servo-kst-changes.png

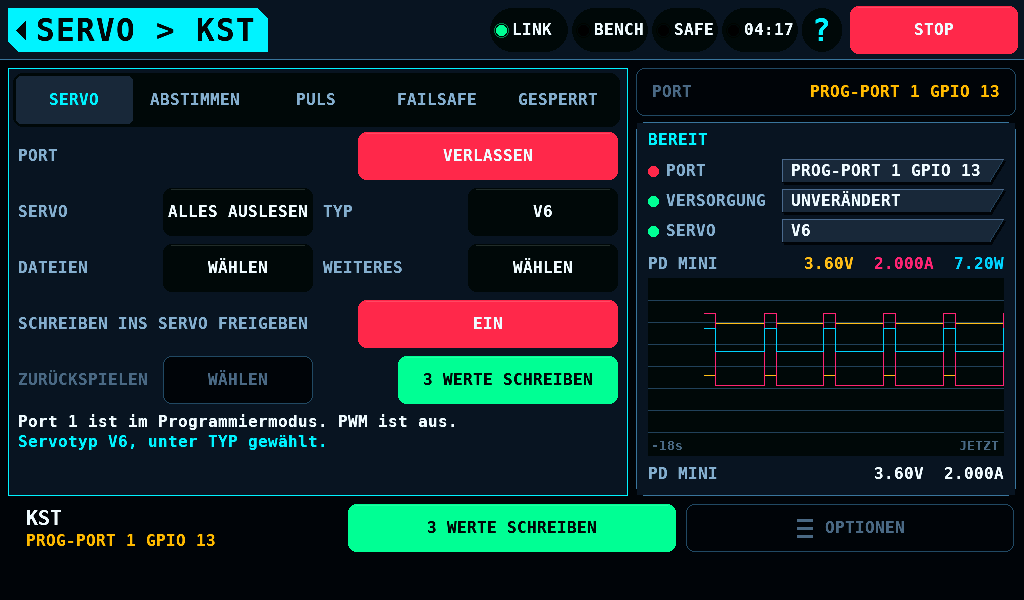
docs/img/de/servo-kst-changes.png
