subtilitas/rcbench/docs/img/servo-hitec-classic-repair.png

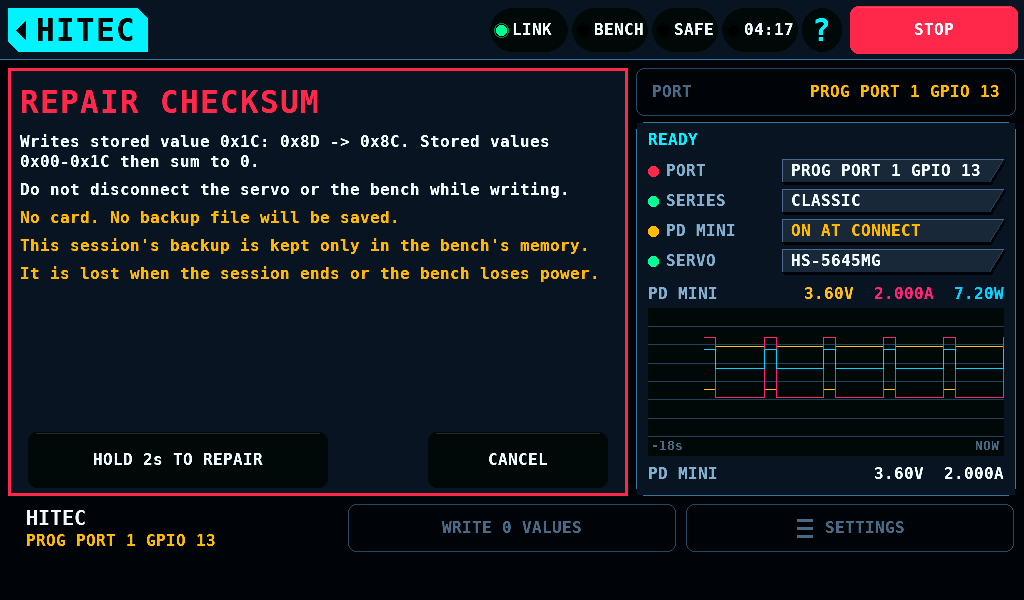
docs/img/servo-hitec-classic-repair.png
