subtilitas/rcbench/docs/img/servo-kst-changes.png

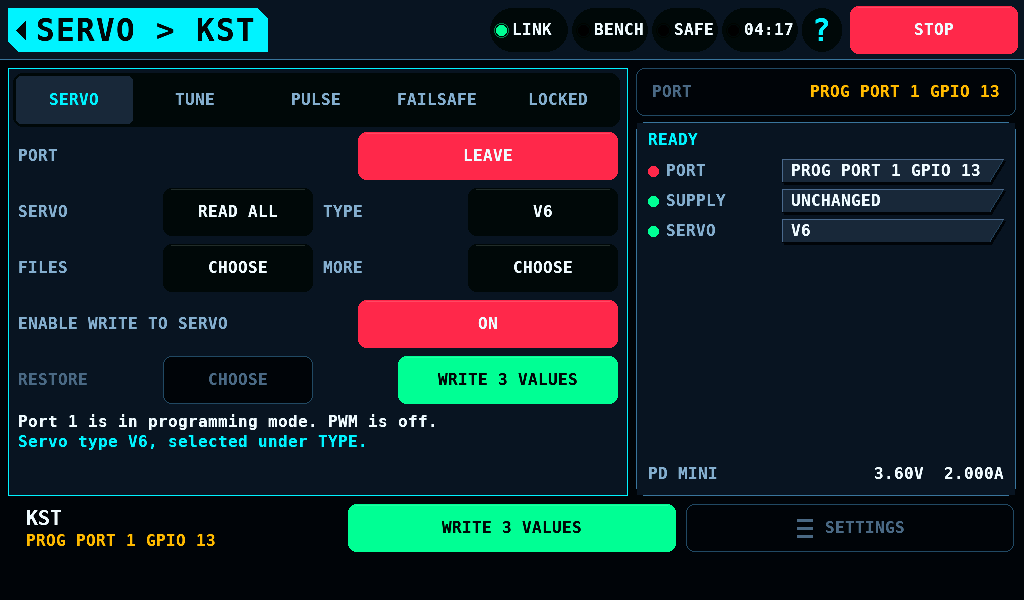
docs/img/servo-kst-changes.png
