subtilitas/rcbench/shared/servo/include/servo_limrun.h

/**
 * @file
 * @brief The limit run: the limit search (servo_limit.h) run on the SERVO
 *        screen against the INA3221's windows, and for a KST or Chaservo servo
 *        on the programming port, the servo's own travel limits lowered until
 *        neither end binds.
 *
 * The search.  A side is searched from its center outward, a servo_limit
 * search in steps of 10us, the position bound once its current is above
 * 1.8 times the free current and 0.15A above it.  A side whose end is
 * measured free is free.  The endpoints are reported; the bench's own pulse
 * range is not changed.  Where the search runs depends on the target:
 *
 *   - The bench's own PWM output (cfg.read off): from PULSE CENTER out to
 *     PULSE MIN and PULSE MAX in force.  Nothing is read or written.
 *   - A KST or Chaservo servo on the programming port (cfg.read on): a
 *     read session comes first -- the servo held at PULSE CENTER, the
 *     bench switched to SAFE, CONNECT with its read, LEAVE, the bench
 *     switched to ARMED again -- and the search runs from the servo's
 *     NEUTRAL out to its own PULSE LOWER and PULSE UPPER, never past them.
 *     A read that fails ends the run before any search.  NEUTRAL not
 *     between PULSE LOWER and PULSE UPPER ends it as FAIL
 *     (SERVO_LIMRUN_WHY_NEUTRAL); PULSE LOWER to PULSE UPPER not inside the
 *     bench's PULSE MIN to PULSE MAX ends it as FAIL
 *     (SERVO_LIMRUN_WHY_RANGE), the bench left SAFE and nothing driven.
 *
 * SERVO PULSES (cfg.set_pulses, programming port only).  At 1000-2000 the
 * read session writes PULSE LOWER 1000.0us and PULSE UPPER 2000.0us
 * before anything is driven, and reads them back; NEUTRAL is not written.
 * A servo at those values already gets no write.  The search then runs
 * out to 1000us and 2000us.  The pulse write counts toward
 * SERVO_LIMRUN_WRITES_MAX and RESTORE takes it back with the rest.
 *
 * The programming (cfg.program).  LEFT ANGLE and RIGHT ANGLE are the
 * servo's own travel limits, one register each, in a unit that is not known.
 * The run takes the servo as linear: PULSE LOWER and PULSE UPPER are the
 * input pulses at which it reaches the full travel LEFT ANGLE and RIGHT
 * ANGLE set, between NEUTRAL and such a pulse its travel is linear in the
 * pulse, and past it the servo holds that travel.  That is an assumption,
 * not a measurement.  The share of a side at pulse p is
 *
 *     f = (p - NEUTRAL) / (P_lim - NEUTRAL)
 *
 * with P_lim PULSE LOWER on the short-pulse side and PULSE UPPER on the
 * long one, both as the servo holds them when the search runs.  f is formed
 * from input pulses only, so REVERSION does not enter it: REVERSION decides
 * which register limits that side, and the run finds that (below).  A bound
 * side whose last free pulse is not past NEUTRAL ends the run as FAIL
 * (SERVO_LIMRUN_WHY_BEFORE_NEUTRAL) before any write.
 *
 * Two writes a bound side, v0 the value its register holds at the read:
 *
 *   1.  The overset: v1 = ceil(v0 x fb x (100 + SERVO_LIMRUN_OVERSET_PCT) /
 *      100), fb the share at the first search's first bound pulse, at most
 *      v0 and at least the smallest value the hard rules take.  The first
 *      bound pulse lies at or past the stop, so the stop stays reachable,
 *      now close to the pulse limit, and the side is searched again.  Free
 *      there, the run ends as FAIL (SERVO_LIMRUN_WHY_NO_STOP) with no
 *      second write: the stop the overset was to keep in reach is not
 *      found.  An overset search that binds far inside the pulse limit
 *      still gives the final value below; no further overset follows.
 *   2.  The final value: v2 = floor(v1 x f1), f1 the share at the overset
 *      search's last free pulse, at least the smallest value.  No margin is
 *      added: the last free pulse lies a 10us step short of the bound one.
 *
 * Worked: NEUTRAL 1500.2us, PULSE LOWER 900.0us, v0 150, the stop at
 * 1000us.  The first search is free at 1000us and bound at 990us:
 * fb = 510.2 / 600.2 = 0.850, v1 = ceil(150 x 0.850 x 1.03) = 132.  A
 * linear servo at 132 is free out to 930us: f1 = 570.2 / 600.2 = 0.950,
 * v2 = floor(132 x 0.950) = 125.  At 125 the full travel ends at 1000.2us.
 *
 * The overset is left out, and the first search counts as its search,
 * where v1 would not lie below v0 (fb above about 0.97) or where the model
 * moves the stop, estimated at the first search's last free pulse, less
 * than SERVO_LIMRUN_MOVED_US further out: d0 x (v0 - v1) / v1 under 20us,
 * d0 that pulse's distance from NEUTRAL.  A search could not tell that move
 * from no move.  The final value is then v2 = floor(v0 x f0), f0 the share
 * at the first search's last free pulse.
 *
 * Which pulse side each register limits is not stated by the protocol
 * notes, so the run finds it on the first bound side's first write: that
 * value goes to LEFT ANGLE (RIGHT ANGLE where LEFT ANGLE holds the smallest
 * value already) and the side is searched.  The end moved when it is free
 * now or its endpoint lies SERVO_LIMRUN_MOVED_US further out; it stayed
 * when its endpoint lies within that of where it was.  An end that stayed
 * sends LEFT ANGLE back to its value and the value, worked out again from
 * RIGHT ANGLE's v0, to RIGHT ANGLE; stayed again, the run ends as FAIL.  An
 * end that moved inward ends it as FAIL too: nothing about the servo is
 * guessed.  The register found limits that side, the other one the other
 * side; a register whose side never bound keeps its value.
 *
 * Last, both ends are searched again: PASS when both are free, FAIL when
 * either binds.  No further write follows a FAIL; RESTORE gives the values
 * before the run back.
 *
 * Writes.  A value is written in a session of the programmer: the servo
 * held at the center for SERVO_LIMRUN_RETURN_MS after the search, so a
 * session never starts with the servo against an end, the bench switched to
 * SAFE, the port taken (CONNECT reads all registers), the write, the port
 * given back (LEAVE), the bench switched to ARMED again.  The read session
 * writes nothing but the pulses of SERVO PULSES; each angle write has a
 * session of its own.  A LEAVE this link or supply does not complete ends
 * the run before any value changes.  No step of the protocol is known to
 * make a value permanent, and no RAM-only write exists: every write is the
 * register write the programmer reads back.  The run counts register values
 * written and stops at SERVO_LIMRUN_WRITES_MAX, the most this flow can
 * need.
 *
 * Protections, for the whole run, whatever phase it is in:
 *
 *   - a 1ms sample of the window at or above SERVO_LIMRUN_HARD_MA, or a
 *     clipped one (the INA3221 at the end of its range), ends it;
 *   - window means above SERVO_LIMRUN_STALL_MA for SERVO_LIMRUN_STALL_MS
 *     end it;
 *   - no window for SERVO_LIMRUN_WIN_STALE_MS ends it;
 *   - with cfg.enc_on, the AS5600 not answering for longer than
 *     SERVO_GAP_MAX_MS, or again less than SERVO_GAP_EVERY_MS after the start
 *     of the last time, ends it (servo_limrun_encoder(), servo_gap.h): a
 *     shorter gap is ridden through, since the angle feeds only the report,
 *     and no angle is taken in it.  The INA3221's windows feed the current
 *     protections above and get no such allowance;
 *   - each search has its own cap, SERVO_LIMRUN_SEARCH_MS;
 *   - the search's own protections stay (servo_limit.h).
 *
 * The supply is also held to what it was at the start, its set points and
 * its output, in every phase but the programmer's sessions (CONNECT to
 * LEAVE): those own the port and the supply (kst_prog.h), and a change
 * then is theirs.  While a search drives the servo the rail voltage stays
 * within SERVO_LIMRUN_RAIL_DV_MV of the run's first window.  A search's
 * window without the rail voltage ends the run
 * (SERVO_LIMRUN_WHY_NO_VOLTAGE), so that reference is a window's and no
 * window escapes the band.  A window without a current reading is not
 * counted at all: the meter's silence runs on through it.
 *
 * The caller ends the run (servo_limrun_abort()) for STOP, SAFE, link loss,
 * leaving the screen, the operator taking the servo, changed settings, lost
 * touch events, the INA3221 no longer the meter, and a supply that stops
 * answering, trips, switches off or has its set points changed.  An ended
 * run asks the output off and lets the servo go (servo_limrun_do_t.off and
 * release), and asks SAFE where it waited for ARMED; the values last
 * written stay in the servo.
 *
 * Servo families (cfg.family, servo_limrun_family_t).  KST and Chaservo
 * servos are read and written as above.  A Hitec servo goes through the
 * Hitec programmer's run seam (hitec_panel_run.h) and has no pulse
 * registers: the caller hands its pulses from servo_limrun_family_pulses(),
 * NEUTRAL 1500.0us and the full travel at 850.0us and 2150.0us on a D
 * series servo (the target model of hitec_live.h), at 900.0us and 2100.0us
 * on a classic one (Hitec's PWM range); neither is measured.  The two
 * registers are LEFT END and RIGHT END in travel units: D series counts
 * from NEUTRAL 0xC2 (LEFT END 0xB2, RIGHT END 0xB0), classic the raw cells
 * 0x14 and 0x13 (swapped on a CCW servo).  The search, the overset, the
 * mapping and the check are the same for every family; servo_limrun_start()
 * refuses set_pulses for a family other than KST, and a CONNECT that reads
 * no servo of the family ends the run as SERVO_LIMRUN_WHY_NOT_KST or
 * SERVO_LIMRUN_WHY_NOT_HITEC.
 *
 * Pure: fed windows, the programmer's results and the clock, it moves
 * nothing itself.  Its report leaves through an outbox
 * (servo_limrun_peek()) as one LIMITnnn.TXT.
 *
 * SPDX-License-Identifier: MIT
 */

#pragma once

#include <stdbool.h>
#include <stddef.h>
#include <stdint.h>

#include "servo_limit.h"
#include "servo_test.h"

#ifdef __cplusplus
extern "C" {
#endif

/* ---------------------------------------------------------- the method */

/** @brief Register values a run writes at most: PULSE LOWER and PULSE UPPER for
 *         SERVO PULSES at 1000-2000, two a side, the overset and the final
 *         value, and two for a first write that went to the register of the
 *         other side, that value and LEFT ANGLE's own value back. */
#define SERVO_LIMRUN_WRITES_MAX   8u
/** @brief The overset write lies this far above the share at the first search's
 *         first bound pulse: the stop stays in reach, close to the pulse
 *         limit. */
#define SERVO_LIMRUN_OVERSET_PCT  3u
/** @brief The pulses SERVO PULSES at 1000-2000 writes, 0.1us. */
#define SERVO_LIMRUN_STD_LOWER_DUS 10000u
#define SERVO_LIMRUN_STD_UPPER_DUS 20000u
/** @brief An endpoint that moves this far out moved; one within it stayed. */
#define SERVO_LIMRUN_MOVED_US     20u
/** @brief One search of one side at most: 1000us of travel, PULSE MIN 500us
 *         to a 1500us center, is 100 positions of 250ms, 25s; the baseline's
 *         three and the slower windows of a busy panel fit in the rest. */
#define SERVO_LIMRUN_SEARCH_MS    40000u
/** @brief Each search starts with the servo held at PULSE CENTER this long, and
 *         each session waits this long at PULSE CENTER before the bench is
 *         asked to SAFE: the return from the last end, 600us at 0.67us/ms
 *         (0.3s for 60 degrees) is 900ms, and the search's baseline is not to
 *         see it travel. */
#define SERVO_LIMRUN_RETURN_MS    1000u
/** @brief One step of the programmer -- CONNECT with its read, a write, LEAVE
 *         -- at most: past the programmer's own 120s of an operation. */
#define SERVO_LIMRUN_PROG_MS      150000u
/** @brief The bench switches to SAFE, or to ARMED, within this of being
 *         asked. */
#define SERVO_LIMRUN_BENCH_MS     3000u
/** @brief The protections: a 1ms sample, and the window means for a time. */
#define SERVO_LIMRUN_HARD_MA      3000
#define SERVO_LIMRUN_STALL_MA     1000
#define SERVO_LIMRUN_STALL_MS     400u
/** @brief No window for this long ends the run: the automatic test's figure. */
#define SERVO_LIMRUN_WIN_STALE_MS SERVO_TEST_WIN_STALE_MS
/** @brief The rail voltage, a window's mean, this far from the first window's
 *         ends the run as a changed supply. */
#define SERVO_LIMRUN_RAIL_DV_MV   1000
/** @brief The servo rail a run starts on at least, the last INA3221 window's
 *         mean (the screen's START check): an output that is off reads 0V, and
 *         a search there finds two free ends on a servo that never moved.
 *
 * 3.0V lies under the 4.8V servos are commonly specified from, so a single
 * lithium cell's rail, 3.0V to 4.2V, still starts.  The voltage a given servo
 * stops moving at is not measured. */
#define SERVO_LIMRUN_RAIL_MIN_MV  3000
/** @brief The programmer's supply of every LIMIT RUN and RUDDER AUTO
 *         session, KST/CHASERVO and Hitec alike, mV: 5.0V, whatever the
 *         KST and HITEC pages' Programming voltage (SET_SERVO_PROG_V)
 *         reads.  A PD mini that feeds the servo is set to it by START. */
#define SERVO_LIMRUN_SUPPLY_MV    5000u

/* ------------------------------------------------------ what it is told */

/** @brief The two sides of PULSE CENTER: shorter and longer pulses. */
enum { SERVO_LIMRUN_LO = 0, SERVO_LIMRUN_HI = 1 };
/** @brief The two registers. */
enum { SERVO_LIMRUN_LEFT = 0, SERVO_LIMRUN_RIGHT = 1 };
/** @brief The servo's pulses, in pulse_dus. */
enum {
    SERVO_LIMRUN_P_NEUTRAL = 0,
    SERVO_LIMRUN_P_LOWER = 1,
    SERVO_LIMRUN_P_UPPER = 2,
};

/** @brief The servo families a run programs. */
typedef enum {
    SERVO_LIMRUN_FAM_KST = 0,   /**< KST and Chaservo: LEFT and RIGHT ANGLE */
    SERVO_LIMRUN_FAM_HITEC_D,   /**< Hitec D series: 0xB2 and 0xB0          */
    SERVO_LIMRUN_FAM_HITEC_C,   /**< Hitec classic: cells 0x14 and 0x13     */
    SERVO_LIMRUN_FAM_COUNT
} servo_limrun_family_t;

/** @brief The Hitec pulse model (servo_limrun_family_pulses()), 0.1us: NEUTRAL,
 *         and the pulses at which the full travel of LEFT END and RIGHT END is
 *         reached.  D series: hitec_live.h's target model, t = (us - 750) x 4,
 *         targets 400 and 5600 the end points.  Classic: Hitec's PWM range,
 *         900us to 2100us.  Neither is measured. */
#define SERVO_LIMRUN_HITEC_NEUTRAL_DUS 15000u
#define SERVO_LIMRUN_HITEC_D_LOWER_DUS 8500u  /**< D series, 850.0us     */
#define SERVO_LIMRUN_HITEC_D_UPPER_DUS 21500u /**< D series, 2150.0us    */
#define SERVO_LIMRUN_HITEC_C_LOWER_DUS 9000u  /**< classic, 900.0us      */
#define SERVO_LIMRUN_HITEC_C_UPPER_DUS 21000u /**< classic, 2100.0us     */

/** @brief servo_limrun_reg_name()'s @c reg flag: the servo's DIRECTION reads
 *         CCW, which swaps the classic cells. */
#define SERVO_LIMRUN_REG_CCW 0x02u

typedef struct {
    uint16_t center_us;                   /**< PULSE CENTER, us         */
    uint16_t min_us;                      /**< PULSE MIN, us            */
    uint16_t max_us;                      /**< PULSE MAX, us            */
    /** @brief A KST or Chaservo servo on the programming port: read first, and
     *         searched from its NEUTRAL out to its PULSE LOWER and PULSE
     *         UPPER. */
    bool     read;
    bool     program;     /**< lower LEFT and RIGHT ANGLE after the search;
                               read only */
    bool     set_pulses;  /**< PULSE LOWER and PULSE UPPER to 1000 and
                               2000us before the search; read only */
    uint8_t  family;      /**< servo_limrun_family_t; set_pulses is KST only */

    /* For the report only. */
    char     dut[24];
    char     type[20];
    uint16_t frame_hz;
    char     output[28];  /**< what it drives: "PROG PORT 1 GPIO 13" */
    uint16_t shunt_dmohm; /**< the INA3221's shunt, 0.1mOhm            */
    char     meter[20];   /**< its channel: "INA3221 0x41 CH2"; "" names
                               it "INA3221"                             */
    bool     enc_on;      /**< an angle source reads the horn shaft     */
    char     source[12];  /**< its name (servo_angle_name()): "AS5600",
                               "IMU X+"; "" names the AS5600            */
    bool     enc_imu;     /**< the source is the IMU: its silence and gaps
                               end the run as SERVO_TEST_AB_IMU_SILENT and
                               _IMU_GAPS; false names the AS5600        */
    char     firmware[16];
    /** @brief The report's language: SERVO_STR_COUNT entries, NULL for
     *         English. */
    const char *const *text;
} servo_limrun_cfg_t;

/** @brief The servo the programmer read. */
typedef struct {
    bool     ok;          /**< read, a KST or Chaservo servo, editable   */
    uint16_t angle[2];    /**< LEFT and RIGHT ANGLE                       */
    uint16_t lo_raw;      /**< the smallest value the hard rules take    */
    uint16_t hi_raw;                    /**< the largest value the hard rules take */
    bool     reversion;   /**< REVERSION on                               */
    unsigned type;        /**< a setting the servo states, which every
                               session of a run reads the same: 20k_sel
                               for a KST or Chaservo servo                */
    /** @brief NEUTRAL, PULSE LOWER and PULSE UPPER, 0.1us. */
    uint16_t pulse_dus[3];
    /** @brief The file the values before the run are backed up in; "" for the
     *         panel's memory only. */
    char     backup[16];
} servo_limrun_servo_t;

/** @brief What the caller knows each step. */
typedef struct {
    bool  live;           /**< the bench is ARMED and the value live      */
    bool  safe;           /**< the bench is SAFE, no ARM on its way       */
    bool  enc_valid;      /**< the AS5600 has an angle                    */
    float enc_deg;        /**< that angle from ENC CENTER                 */
} servo_limrun_in_t;

/** @brief What the run wants done. */
typedef struct {
    bool     command;     /**< the servo to cmd_us, at once               */
    uint16_t cmd_us;                    /**< the pulse, µs */
    bool     release;     /**< the servo let go                           */
    bool     off;         /**< the supply's output off                    */
    bool     disarm;      /**< the bench to SAFE: the run's own           */
    bool     arm;         /**< the bench to ARMED: the run's own          */
    bool     connect;     /**< the programmer: CONNECT, which reads       */
    bool     write;       /**< the programmer: these two values           */
    uint16_t angle[2];                  /**< LEFT and RIGHT ANGLE */
    bool     pulses;      /**< the programmer: PULSE LOWER and PULSE UPPER,
                               0.1us                                      */
    uint16_t pulse_dus[2]; /**< PULSE LOWER and PULSE UPPER, 0.1us       */
    bool     leave;       /**< the programmer: LEAVE                      */
} servo_limrun_do_t;

/* ------------------------------------------------------ what it reports */

typedef enum {
    SERVO_LIMRUN_IDLE = 0,
    SERVO_LIMRUN_RUNNING,
    SERVO_LIMRUN_DONE,
} servo_limrun_state_t;

typedef enum {
    SERVO_LIMRUN_PH_NONE = 0,
    SERVO_LIMRUN_PH_SEARCH,     /**< the first search of a side          */
    SERVO_LIMRUN_PH_SAFE,       /**< the servo back at the center, then
                                     the bench on its way to SAFE        */
    SERVO_LIMRUN_PH_CONNECT,
    SERVO_LIMRUN_PH_WRITE,
    SERVO_LIMRUN_PH_LEAVE,
    SERVO_LIMRUN_PH_ARM,        /**< the bench on its way to ARMED       */
    SERVO_LIMRUN_PH_PROBE,      /**< a side searched after a write: the
                                     overset's search, or the first
                                     write's for the side it limits      */
    SERVO_LIMRUN_PH_CHECK,      /**< both sides searched at the end      */
} servo_limrun_phase_t;

typedef enum {
    SERVO_LIMRUN_FOUND = 0,     /**< search only: the ends as found      */
    SERVO_LIMRUN_FREE,          /**< neither end binds: nothing written  */
    SERVO_LIMRUN_PASS,          /**< programmed, both ends free after    */
    SERVO_LIMRUN_FAIL,
    SERVO_LIMRUN_ABORTED,
} servo_limrun_verdict_t;

/** @brief Why a run failed or was aborted. */
typedef enum {
    SERVO_LIMRUN_WHY_NONE = 0,
    SERVO_LIMRUN_WHY_TEST,          /**< a reason of servo_test_abort_t,
                                         in test_why                      */
    SERVO_LIMRUN_WHY_HARD,          /**< a sample at SERVO_LIMRUN_HARD_MA */
    SERVO_LIMRUN_WHY_CLIPPED,       /**< a sample at the meter's end      */
    SERVO_LIMRUN_WHY_STALL,         /**< above SERVO_LIMRUN_STALL_MA      */
    SERVO_LIMRUN_WHY_SEARCH_LONG,   /**< a search past its cap            */
    SERVO_LIMRUN_WHY_SUPPLY_CHANGED,/**< set points or rail voltage moved */
    SERVO_LIMRUN_WHY_BENCH,         /**< the bench did not switch         */
    SERVO_LIMRUN_WHY_NOT_KST,       /**< no KST or Chaservo servo read    */
    SERVO_LIMRUN_WHY_PROG,          /**< CONNECT or LEAVE did not end well */
    SERVO_LIMRUN_WHY_WRITE,         /**< a write refused or lost          */
    SERVO_LIMRUN_WHY_OTHER_VALUES,  /**< the servo read holds other values */
    SERVO_LIMRUN_WHY_MAPPING,       /**< which end LEFT ANGLE moves is not
                                         found                            */
    SERVO_LIMRUN_WHY_SMALLEST,      /**< binds at the smallest value      */
    SERVO_LIMRUN_WHY_WRITE_CAP,     /**< SERVO_LIMRUN_WRITES_MAX reached  */
    SERVO_LIMRUN_WHY_STILL_BINDS,   /**< an end binds after programming   */
    SERVO_LIMRUN_WHY_NO_VOLTAGE,    /**< a search's window without the rail
                                         voltage                          */
    SERVO_LIMRUN_WHY_NO_STOP,       /**< free after the overset write     */
    SERVO_LIMRUN_WHY_BEFORE_NEUTRAL,/**< a free end not past NEUTRAL      */
    SERVO_LIMRUN_WHY_NEUTRAL,       /**< NEUTRAL not between PULSE LOWER and
                                         PULSE UPPER                      */
    SERVO_LIMRUN_WHY_RANGE,         /**< PULSE LOWER to PULSE UPPER not
                                         inside PULSE MIN to PULSE MAX    */
    SERVO_LIMRUN_WHY_NOT_HITEC,     /**< no Hitec servo read              */
    SERVO_LIMRUN_WHY_COUNT
} servo_limrun_why_t;

/** @brief What one search of one side found. */
typedef struct {
    bool     done;
    bool     bound;         /**< FOUND: the side binds                     */
    uint16_t limit_us;      /**< the endpoint; the end of the travel if free */
    uint16_t bind_us;       /**< the first bound position                  */
    uint16_t free_us;       /**< the last free position                    */
    float baseline_a,                       /**< the current before the knee, A            */
          knee_a;                           /**< the current at the knee, A                */
    bool     enc;           /**< enc_deg is the angle at the last free one */
    /** @brief The angle at the last free position, from ENC CENTER */
    float    enc_deg;
} servo_limrun_side_t;

#define SERVO_LIMRUN_OUTBOX 2u

typedef struct {
    servo_limrun_cfg_t   cfg;
    servo_limrun_state_t state;
    servo_limrun_phase_t phase;
    servo_limrun_verdict_t verdict;
    servo_limrun_why_t   why;
    servo_test_abort_t   test_why;
    uint32_t start_ms, end_ms, phase_ms;
    bool     safe_asked;    /**< PH_SAFE: SAFE asked, after the return    */

    /* The search under way: from ctr_us out to end_us of its side. */
    uint16_t ctr_us;
    uint16_t end_us[2];
    servo_limit_t lf;
    uint8_t  side;          /**< the side it searches                    */
    uint32_t search_ms;     /**< the search's start; it walks from
                                 SERVO_LIMRUN_RETURN_MS after it          */
    uint16_t cmd_us;        /**< the command last asked                   */
    bool     cmd_due;
    bool     enc_valid;
    float    enc_deg;
    servo_gap_t enc_gap;    /**< the AS5600 not answering, with cfg.enc_on
                                 (servo_gap.h)                           */

    servo_limrun_side_t first[2];   /**< the first search of each side  */
    servo_limrun_side_t after[2];   /**< the last check of each side    */
    servo_limrun_side_t probe;      /**< the last probe                 */

    /* The programming. */
    bool     read_once;
    bool     dry;           /**< the read-only first session is under way */
    servo_limrun_servo_t servo;     /**< as the first session read it  */
    uint16_t cur[2];        /**< what the servo holds, register by register */
    uint16_t pulse_now[3];  /**< its NEUTRAL, PULSE LOWER, PULSE UPPER now */
    bool     pulse_op;      /**< the write under way is the pulse write   */
    bool     searched;      /**< the first search has begun              */
    uint16_t want[2];       /**< the write under way                     */
    int8_t   reg_side[2];   /**< the side each register limits, -1 not known */
    bool     need[2];       /**< the side bound in the first search       */
    bool     mapped;
    uint8_t  map_side;      /**< the side whose first write finds it      */
    uint8_t  map_reg;       /**< the register that write goes to          */
    uint8_t  map_tries;     /**< registers tried for it                   */
    /* By side. */
    uint8_t  stage[2];      /**< servo_limrun_int.h's limrun_stage_t      */
    uint16_t v0[2];         /**< the register's value at the read         */
    uint16_t v1[2];         /**< the overset; 0 where it is left out      */
    uint16_t v2[2];         /**< the final value, once known              */
    int32_t  d0_dus[2];     /**< the first search's free end from NEUTRAL */
    int32_t  db_dus[2];     /**< its first bound pulse from NEUTRAL       */
    int32_t  d1_dus[2];     /**< the overset search's; 0 not searched     */
    int8_t   probe_side;    /**< the side the next search looks at, -1 both */
    unsigned writes;        /**< register values written                  */
    unsigned write_ops;     /**< writes sent, one that failed included    */
    unsigned sessions;
    bool     pulses_landed; /**< the pulses read back as 1000 and 2000us */
    bool     in_flight;     /**< a write or the pulse write handed out, its
                                 *   answer not in: an end now may leave it
                                 *   landed                                */
    bool     programmed;    /**< a value differs from the servo's own, or
                                 *   a write failed once sent              */

    /* The meter. */
    bool     have_win;
    uint32_t last_win_ms;
    uint32_t windows;
    bool     have_rail;
    uint16_t rail_mv;
    bool     elevated;
    uint32_t elevated_ms;

    /* The supply as at its first reading, when one answered. */
    bool     sup_watch;
    bool     sup_online;    /**< it answered                             */
    bool     sup_out;       /**< its output was on                       */

    float    sup_v, sup_i;

    /* The outbox: OPEN_TXT, the report's lines, END. */
    unsigned out_line;      /**< the next line of the report              */
    bool     out_open, out_end, out_done;
    char     scratch[SERVO_TEST_LINE_MAX];

    servo_limrun_do_t pend;
} servo_limrun_t;

/**
 * @brief Clear a run state to idle.
 *
 * @param r Run state. Does nothing when NULL.
 */
void servo_limrun_init(servo_limrun_t *r);

/**
 * @brief Start at @p now_ms.  False, and nothing started, for a configuration
 *        whose center is not between its MIN and MAX.
 *
 * @param r      Run state. Cleared before the run starts.
 * @param cfg    Configuration of the run.
 * @param now_ms Start time, ms.
 * @return true when the run started; false for a NULL r or cfg, a run already
 *        RUNNING, a center not strictly between min_us and max_us, program
 *        or set_pulses without read, a family not in servo_limrun_family_t,
 *        or set_pulses with a family other than SERVO_LIMRUN_FAM_KST.
 */
bool servo_limrun_start(servo_limrun_t *r, const servo_limrun_cfg_t *cfg,
                        uint32_t now_ms);

/**
 * @brief One INA3221 window, as the automatic test takes it.
 *
 * @param r Run state.
 * @param w Window to feed. Ignored when NULL or when it has no current reading.
 */
void servo_limrun_window(servo_limrun_t *r, const servo_test_win_t *w);

/**
 * @brief A reading of the output encoder, as the automatic test takes it
 *        (servo_test_encoder()): one not valid without no_magnet opens a gap
 *        of the part not answering at its taken_ms, the next from a part that
 *        answers closes it.  Nothing without cfg.enc_on.  A gap longer than
 *        SERVO_GAP_MAX_MS ends the run with SERVO_TEST_AB_ENC_SILENT, a second
 *        one sooner than SERVO_GAP_EVERY_MS after the start of the last with
 *        SERVO_TEST_AB_ENC_GAPS, both errors; with the IMU as the angle
 *        source (cfg.enc_imu) with SERVO_TEST_AB_IMU_SILENT and _IMU_GAPS.
 *        The angle itself comes with servo_limrun_step()'s @c in.
 *
 * @param r Run state. Does nothing unless the run is RUNNING.
 * @param e Encoder reading. Ignored when NULL.
 */
void servo_limrun_encoder(servo_limrun_t *r, const servo_test_enc_t *e);

/**
 * @brief The supply's reading.
 *
 * The first one after the start, answering or not, is what it must stay at: its
 * set points, and its output on or off.  An output off then and on later, or a
 * supply that did not answer and answers later, its output on or off, ends the
 * run as a changed supply (SERVO_LIMRUN_WHY_SUPPLY_CHANGED).  The caller passes
 * a reading that does not answer where it has none at the start.
 *
 * @param r      Run state.
 * @param s      Supply reading. Ignored when NULL or during the programmer
 *        session.
 * @param now_ms Time of the reading, ms.
 */
void servo_limrun_supply(servo_limrun_t *r, const servo_test_reading_t *s,
                         uint32_t now_ms);

/**
 * @brief The programmer's answers: the servo read after CONNECT, a write's end
 *        with the values the servo holds (servo_limrun_pulsed() for the pulse
 *        write: NEUTRAL, PULSE LOWER, PULSE UPPER), and the port back in PWM.
 *
 * @param r      Run state.
 * @param sv     Servo as read. Ignored when NULL.
 * @param now_ms Time of the answer, ms.
 */
void servo_limrun_connected(servo_limrun_t *r, const servo_limrun_servo_t *sv,
                       uint32_t now_ms);
/**
 * @brief Feed the end of a write: the values the servo holds.
 *
 * @param r      Run state.
 * @param ok     false ends the run as ABORTED with WRITE.
 * @param angle  LEFT and RIGHT ANGLE the servo holds, two values. NULL ends the
 *        run as WRITE.
 * @param now_ms Time of the answer, ms.
 */
void servo_limrun_written(servo_limrun_t *r, bool ok, const uint16_t *angle,
                          uint32_t now_ms);
/**
 * @brief Feed the end of the pulse write: the pulses the servo holds.
 *
 * @param r         Run state.
 * @param ok        false ends the run as ABORTED with WRITE.
 * @param pulse_dus NEUTRAL, PULSE LOWER and PULSE UPPER, 0.1us. NULL ends the
 *        run as WRITE.
 * @param now_ms    Time of the answer, ms.
 */
void servo_limrun_pulsed(servo_limrun_t *r, bool ok,
                         const uint16_t *pulse_dus, uint32_t now_ms);
/**
 * @brief Feed the answer to LEAVE: the port is given back.
 *
 * @param r      Run state.
 * @param ok     false ends the run as ABORTED with PROG.
 * @param now_ms Time of the answer, ms.
 */
void servo_limrun_left(servo_limrun_t *r, bool ok, uint32_t now_ms);

/**
 * @brief The caller will not hand the programmer's CONNECT a PD mini that the
 *        run did not start with, or one whose output is off (@p output_on
 *        false).  A supply the run started with, its output off, ends the run
 *        as a reading outside a session does (SERVO_TEST_AB_SUPPLY_OFF); one
 *        the run did not start with ends it as a changed supply
 *        (SERVO_LIMRUN_WHY_SUPPLY_CHANGED).
 *
 * @param r         Run state.
 * @param output_on Whether the supply output is on.
 * @param now_ms    Time of the refusal, ms.
 */
void servo_limrun_supply_refused(servo_limrun_t *r, bool output_on,
                                 uint32_t now_ms);

/**
 * @brief The file the servo's values before the run were saved in, once the
 *        programmer names it: its first write saves it.
 *
 * @param r    Run state.
 * @param name File name. Ignored when NULL or empty, or when the servo was not
 *        read.
 */
void servo_limrun_backup(servo_limrun_t *r, const char *name);

/**
 * @brief The programmer refused the CONNECT, write or LEAVE asked: it never
 *        started.
 *
 * @param r      Run state.
 * @param now_ms Time of the refusal, ms.
 */
void servo_limrun_refused(servo_limrun_t *r, uint32_t now_ms);

/**
 * @brief The programmer's CONNECT ended with no servo answering
 *        (KST_SES_ERR_NO_SERVO).
 *
 * The run's first CONNECT ends it as FAIL with SERVO_LIMRUN_WHY_NOT_KST, or
 * SERVO_LIMRUN_WHY_NOT_HITEC for a Hitec family, as a read that is no servo of
 * the family does; a later CONNECT ends it as
 * servo_limrun_refused() does, with SERVO_LIMRUN_WHY_PROG.  Nothing at any
 * other step.
 *
 * @param r      The run; NULL, or one not running, is left as it is.
 * @param now_ms Current time, ms.
 */
void servo_limrun_no_servo(servo_limrun_t *r, uint32_t now_ms);

/**
 * @brief Advance to @p now_ms: what to do comes back in @p out.
 *
 * @param r      Run state.
 * @param now_ms Current time, ms.
 * @param in     What the caller knows this step. NULL skips the checks on it.
 * @param out    Out: cleared, then filled with what the run wants done. NULL to
 *        skip.
 */
void servo_limrun_step(servo_limrun_t *r, uint32_t now_ms,
                       const servo_limrun_in_t *in, servo_limrun_do_t *out);

/**
 * @brief The caller's reasons.
 *
 * @param r      Run state. Does nothing unless the run is RUNNING.
 * @param why    Reason from the caller.
 * @param now_ms Time of the abort, ms.
 */
void servo_limrun_abort(servo_limrun_t *r, servo_test_abort_t why,
                        uint32_t now_ms);

/**
 * @brief Tell whether the run is RUNNING.
 *
 * @param r Run state. NULL gives false.
 * @return true when the state is RUNNING.
 */
bool servo_limrun_running(const servo_limrun_t *r);
/**
 * @brief The run asked the bench to SAFE or to ARMED and waits for it, or holds
 *        the programmer: a disarm then is its own, not the operator's.  Not
 *        while the servo returns to the center before a session: a disarm then
 *        is the operator's.
 *
 * @param r Run state. NULL gives false.
 * @return true while running in CONNECT, WRITE, LEAVE or ARM, or in SAFE after
 *        SAFE was asked.
 */
bool servo_limrun_switching(const servo_limrun_t *r);
/**
 * @brief The run holds the programmer: CONNECT to LEAVE.
 *
 * @param r Run state. NULL gives false.
 * @return true while running in CONNECT, WRITE or LEAVE.
 */
bool servo_limrun_programming(const servo_limrun_t *r);
/**
 * @brief A value was written and the servo may not hold its own any more.
 *
 * @param r Run state.
 * @return true when at least one register value was written; false for NULL.
 */
bool servo_limrun_wrote(const servo_limrun_t *r);
/**
 * @brief The run ended as FAIL or ABORTED with the servo's values changed,
 *        or with a write handed out and its answer not in (it may have
 *        landed): RESTORE gives back the ones before it.
 *
 * @param r Run state.
 * @return true when the run is DONE, programmed, and ended as FAIL or ABORTED;
 *        false for NULL.
 */
bool servo_limrun_restore(const servo_limrun_t *r);
/**
 * @brief The values the servo held before the run, valid once read.
 *
 * @param r     Run state.
 * @param left  Out: LEFT ANGLE before the run. NULL to skip.
 * @param right Out: RIGHT ANGLE before the run. NULL to skip.
 * @return true when the servo was read; false otherwise.
 */
bool servo_limrun_original(const servo_limrun_t *r, uint16_t *left,
                           uint16_t *right);

/**
 * @brief The report's lines, in order, then END; OPEN_TXT first.
 *
 * @param r    Run state. NULL gives NONE.
 * @param text Out: text of the entry; empty when there is none.
 * @return kind of the next outbox entry: OPEN_TXT first, then TXT lines, then
 *        END; NONE when the run is not DONE or the report was handed out.
 */
servo_test_out_t servo_limrun_peek(servo_limrun_t *r, const char **text);
/**
 * @brief Take the outbox entry last returned by servo_limrun_peek().
 *
 * @param r Run state.
 */
void servo_limrun_pop(servo_limrun_t *r);
/**
 * @brief Tell whether the run has nothing left to hand over.
 *
 * @param r Run state.
 * @return true when r is NULL or IDLE, or DONE with the report handed out.
 */
bool servo_limrun_drained(const servo_limrun_t *r);

/**
 * @brief Line @p idx of the report into @p buf; false past the last.
 *
 * @param r   Run state.
 * @param idx Line index, from 0.
 * @param buf Out: line text.
 * @param n   Size of buf, bytes.
 * @return true when line idx exists; false for NULL arguments, n of 0, or a run
 *        not DONE.
 */
bool servo_limrun_report_line(const servo_limrun_t *r, unsigned idx,
                              char *buf, size_t n);

/**
 * @brief The table entries the screen and the report name these by.
 *
 * @param v Verdict to name.
 * @return table entry for FOUND, FREE, PASS or FAIL; ABORTED for any other
 *        value.
 */
servo_str_t servo_limrun_verdict_str(servo_limrun_verdict_t v);
/**
 * @brief Name table entry for the reason of a run.
 *
 * @param r Run state. NULL gives the NONE entry.
 * @return table entry for the reason; the test reason for WHY_TEST; NONE for
 *        other values.
 */
servo_str_t servo_limrun_why_str(const servo_limrun_t *r);
/**
 * @brief Whether a run that ended for @p why ended on an error of the bench:
 *        the meter or the supply failed, or a current limit tripped.
 *
 * An error switches an ARMED bench to SAFE (docs/Safety.md, "Errors").  The
 * programmer's reasons (CONNECT, a write, LEAVE) and what the servo was
 * found to hold are a run's outcome, not an error of the bench.
 *
 * @param why      The run's reason.
 * @param test_why For SERVO_LIMRUN_WHY_TEST, the test's reason.
 * @return true for WHY_HARD, WHY_CLIPPED, WHY_STALL, WHY_NO_VOLTAGE and a
 *         WHY_TEST that servo_test_abort_error() calls an error.
 */
bool servo_limrun_why_error(servo_limrun_why_t why,
                            servo_test_abort_t test_why);
/**
 * @brief Table entry for a phase of the limit run.
 *
 * @param ph Phase to name.
 * @return table entry for the phase; PHASE_NONE for a value not in the enum.
 */
servo_str_t servo_limrun_phase_str(servo_limrun_phase_t ph);

/**
 * @brief The share of travel, 0.1us of pulse: @p p_us's distance from NEUTRAL
 *        on @p side, positive outward, and the pulse limit's.
 *
 * @param sv   Servo pulses, 0.1us.
 * @param side SERVO_LIMRUN_LO or SERVO_LIMRUN_HI.
 * @param p_us Pulse width, microseconds.
 * @return distance of p_us from NEUTRAL on side, 0.1us, positive outward.
 */
int32_t servo_limrun_dist(const servo_limrun_servo_t *sv, uint8_t side,
                          uint16_t p_us);
/**
 * @brief Span of one side, as servo_limrun_span() reports it.
 *
 * @param sv   Servo pulses, 0.1us.
 * @param side SERVO_LIMRUN_LO or SERVO_LIMRUN_HI.
 * @return distance from NEUTRAL to the side pulse limit, 0.1us.
 */
int32_t servo_limrun_span(const servo_limrun_servo_t *sv, uint8_t side);
/**
 * @brief The overset for value @p v0 and share @p d / @p span: ceil(v0 x share
 *        x (100 + SERVO_LIMRUN_OVERSET_PCT) / 100), within @p lo_raw to @p v0.
 *
 * @param v0     Register value at the read.
 * @param d      Distance of the bound pulse from NEUTRAL, 0.1us. 0 or less
 *        returns the lower bound.
 * @param span   Span of the side, 0.1us. 0 or less returns the lower bound.
 * @param lo_raw Smallest value the hard rules take.
 * @return overset value, within lo_raw to v0; v0 when lo_raw is above v0.
 */
uint16_t servo_limrun_overset(uint16_t v0, int32_t d, int32_t span,
                              uint16_t lo_raw);
/**
 * @brief The final value for value @p v and share @p d / @p span: floor(v x
 *        share), within @p lo_raw to @p v.
 *
 * @param v      Value the share applies to.
 * @param d      Distance of the free pulse from NEUTRAL, 0.1us. 0 or less
 *        returns the lower bound.
 * @param span   Span of the side, 0.1us. 0 or less returns the lower bound.
 * @param lo_raw Smallest value the hard rules take.
 * @return final value, within lo_raw to v; v when lo_raw is above v.
 */
uint16_t servo_limrun_scaled(uint16_t v, int32_t d, int32_t span,
                             uint16_t lo_raw);

/**
 * @brief The register names of a family for the report: "LEFT ANGLE",
 *        "LEFT END (0xB2)", "LEFT END (CELL 0x14)".
 *
 * @param family servo_limrun_family_t; any other value names KST's.
 * @param reg    SERVO_LIMRUN_LEFT or SERVO_LIMRUN_RIGHT, with
 *        SERVO_LIMRUN_REG_CCW for a servo whose DIRECTION reads CCW: a classic
 *        servo's LEFT END is cell 0x13 then.
 * @return the name, never NULL.
 */
const char *servo_limrun_reg_name(uint8_t family, uint8_t reg);

/**
 * @brief The pulses a family's servo is searched and scaled by, for a family
 *        with no pulse registers: NEUTRAL, the full travel's pulses below and
 *        above it (SERVO_LIMRUN_HITEC_*_DUS).
 *
 * @param family    servo_limrun_family_t.
 * @param pulse_dus Out: NEUTRAL, PULSE LOWER and PULSE UPPER, 0.1us; left as
 *        it is for KST, whose servo states its own.
 * @return true for a Hitec family; false for KST or a value not in the enum.
 */
bool servo_limrun_family_pulses(uint8_t family, uint16_t pulse_dus[3]);

#ifdef __cplusplus
}
#endif
