subtilitas/rcbench/firmware/panel/components/board/include/board_pins.h

/*
 * Pin map for the Waveshare ESP32-S3-Touch-LCD-7: an 800x480 RGB (red,
 * green, blue) IPS (in-plane switching) LCD (liquid-crystal display) with a
 * GT911 touch controller.
 *
 * Values are from the board schematic (hardware/ESP32-S3-Touch-LCD-7-Sch.pdf
 * in waveshareteam/ESP32-S3-Touch-LCD-7), cross-checked against Waveshare's
 * ESP-IDF (Espressif Internet-of-Things Development Framework) demo.  The
 * RGB bus is 16 data lines driven as RGB565: the panel is an 18-bit part,
 * and R0..R2, G0..G1 and B0..B2 are tied off on the board.
 *
 * SPDX-License-Identifier: MIT
 */

#pragma once

#include "driver/gpio.h"

#ifdef __cplusplus
extern "C" {
#endif

/* ------------------------------------------------------------------ panel */

#define BOARD_LCD_H_RES             800
#define BOARD_LCD_V_RES             480

/* Panel timing.  16 MHz is Waveshare's shipped pixel clock and gives a 39 Hz
 * refresh.  60 Hz would need about 25 MHz, which the PSRAM (pseudo-static
 * random-access memory) scan-out bandwidth does not support. */
#define BOARD_LCD_PCLK_HZ           (16 * 1000 * 1000)
#define BOARD_LCD_HSYNC_PULSE_WIDTH 4
#define BOARD_LCD_HSYNC_BACK_PORCH  8
#define BOARD_LCD_HSYNC_FRONT_PORCH 8
#define BOARD_LCD_VSYNC_PULSE_WIDTH 4
#define BOARD_LCD_VSYNC_BACK_PORCH  8
#define BOARD_LCD_VSYNC_FRONT_PORCH 8
#define BOARD_LCD_PCLK_ACTIVE_NEG   1

#define BOARD_LCD_DATA_WIDTH        16
#define BOARD_LCD_BITS_PER_PIXEL    16

#define BOARD_LCD_PIN_PCLK          GPIO_NUM_7
#define BOARD_LCD_PIN_HSYNC         GPIO_NUM_46
#define BOARD_LCD_PIN_VSYNC         GPIO_NUM_3
#define BOARD_LCD_PIN_DE            GPIO_NUM_5
#define BOARD_LCD_PIN_DISP          (-1)   /* driven through the CH422G */

/* data[0..4]   = B3..B7
 * data[5..10]  = G2..G7
 * data[11..15] = R3..R7 */
#define BOARD_LCD_PIN_DATA0         GPIO_NUM_14
#define BOARD_LCD_PIN_DATA1         GPIO_NUM_38
#define BOARD_LCD_PIN_DATA2         GPIO_NUM_18
#define BOARD_LCD_PIN_DATA3         GPIO_NUM_17
#define BOARD_LCD_PIN_DATA4         GPIO_NUM_10
#define BOARD_LCD_PIN_DATA5         GPIO_NUM_39
#define BOARD_LCD_PIN_DATA6         GPIO_NUM_0
#define BOARD_LCD_PIN_DATA7         GPIO_NUM_45
#define BOARD_LCD_PIN_DATA8         GPIO_NUM_48
#define BOARD_LCD_PIN_DATA9         GPIO_NUM_47
#define BOARD_LCD_PIN_DATA10        GPIO_NUM_21
#define BOARD_LCD_PIN_DATA11        GPIO_NUM_1
#define BOARD_LCD_PIN_DATA12        GPIO_NUM_2
#define BOARD_LCD_PIN_DATA13        GPIO_NUM_42
#define BOARD_LCD_PIN_DATA14        GPIO_NUM_41
#define BOARD_LCD_PIN_DATA15        GPIO_NUM_40

/* -------------------------------------------------------------------- I2C */

#define BOARD_I2C_PORT              I2C_NUM_0
#define BOARD_I2C_PIN_SDA           GPIO_NUM_8
#define BOARD_I2C_PIN_SCL           GPIO_NUM_9
#define BOARD_I2C_FREQ_HZ           400000

/* -------------------------------------------------------------- SD card --- */

/*
 * The card is on SPI (Serial Peripheral Interface), and its chip select is
 * not a GPIO (general-purpose input/output): the CH422G holds it (EXIO4), so
 * the SPI driver is told there is no CS (chip select) pin and the expander
 * keeps the line asserted while the card is mounted.  That is safe because
 * the card is alone on this bus.
 *
 * The vendor demo asserts CS by writing 0x0A to expander address 0x38, which
 * also clears EXIO2 and turns the backlight off.  board_sd_cs() is a
 * read-modify-write against the cached output byte.
 */
#define BOARD_SD_SPI_HOST           SPI2_HOST
#define BOARD_SD_PIN_MOSI           GPIO_NUM_11
#define BOARD_SD_PIN_CLK            GPIO_NUM_12
#define BOARD_SD_PIN_MISO           GPIO_NUM_13
#define BOARD_SD_FREQ_KHZ           20000

/* ------------------------------------------------------------------ touch */

/* GT911 INT.  Its level while RST is released selects the I2C
 * (Inter-Integrated Circuit) address: low -> 0x5D, high -> 0x14.  The board
 * has no direct RST line; that goes through the CH422G (EXIO1). */
#define BOARD_TOUCH_PIN_INT         GPIO_NUM_4
#define BOARD_TOUCH_I2C_ADDR        0x5D
#define BOARD_TOUCH_I2C_ADDR_ALT    0x14

/* ------------------------------------------------- CH422G I/O expander --- */

/* The CH422G is addressed by "command address" rather than by register: each
 * of these 7-bit addresses is a different function. */
#define BOARD_CH422G_ADDR_WR_SET    0x24  /* system settings                 */
#define BOARD_CH422G_ADDR_WR_OC     0x23  /* open-drain outputs OC0..OC3     */
#define BOARD_CH422G_ADDR_WR_IO     0x38  /* push-pull outputs IO0..IO7      */
#define BOARD_CH422G_ADDR_RD_IO     0x26  /* input read-back                 */

/* WR_SET bits */
#define BOARD_CH422G_SET_IO_OE      (1u << 0)  /* IO0..IO7 are outputs */
#define BOARD_CH422G_SET_A_SCAN     (1u << 1)
#define BOARD_CH422G_SET_OD_EN      (1u << 2)
#define BOARD_CH422G_SET_SLEEP      (1u << 3)

/* EXIO bit positions inside the WR_IO byte, per the board schematic. */
#define BOARD_EXIO_TOUCH_RST        1  /* CTP_RST,    active low  */
#define BOARD_EXIO_DISP             2  /* DISP + BL_EN, active high */
#define BOARD_EXIO_LCD_RST          3  /* LCD_RST,    active low  */
#define BOARD_EXIO_SD_CS            4  /* SDCS,       active low  */
/*
 * The USB (Universal Serial Bus) / CAN (Controller Area Network) multiplexer.
 *
 * The board has two USB-C sockets: one behind a USB-UART (universal
 * asynchronous receiver-transmitter) bridge, and one carrying the ESP32-S3's
 * native USB.  Native USB, USB-Serial-JTAG (the built-in serial and debug
 * bridge) and USB-OTG (On-The-Go) alike, is on GPIO19 and GPIO20, dedicated
 * analogue pins that cannot be routed elsewhere, and the FSUSB42UMX switches
 * that pair against CAN.  CAN and native USB are therefore mutually
 * exclusive, and selecting CAN removes the native console.
 *
 * The bridged socket shares nothing with CAN, so sdkconfig.defaults makes
 * UART0 the primary console and USB-Serial-JTAG the secondary.
 *
 * The bridged socket is on UART0, on an ESP32-S3-Touch-LCD-7 Rev1.2.  Not
 * from the schematic, which was never traced: the board accepts a firmware
 * download through that socket, and the ROM bootloader takes a serial
 * download on UART0 and nowhere else.  A socket that can flash the board is
 * a socket the console reaches.
 *
 * What the socket is connected to is switchable.  A slide switch beside the
 * BOOT and RESET buttons is marked UART1 and UART2, and it decides what the
 * bridge chip's serial side reaches.  A board in one position enumerates its
 * CH343 normally -- the port appears and Windows names it, which proves only
 * the chip's supply, oscillator and USB side -- and passes nothing in either
 * direction, neither a download nor a console byte.
 *
 * So a panel that says nothing on that socket is a switch to check before it
 * is a fault to diagnose.  The panel does not depend on the socket either
 * way: it reports a bus fault on its own screen and to the card
 * (busfault_screen.h).
 */
#define BOARD_EXIO_USB_SEL          5  /* 0 = USB, 1 = CAN        */
#define BOARD_EXIO_LCD_VDD_EN       6

/* Power-on state: panel and touch out of reset, backlight on, SD deselected,
 * USB (not CAN) routed to the FSUSB42UMX. */
#define BOARD_EXIO_DEFAULT                                                  \
    ((1u << BOARD_EXIO_TOUCH_RST) | (1u << BOARD_EXIO_DISP) |               \
     (1u << BOARD_EXIO_LCD_RST) | (1u << BOARD_EXIO_SD_CS))

/* -------------------------------------------------------------------- CAN */
/*
 * TWAI (Two-Wire Automotive Interface, the ESP32-S3's CAN controller), on
 * the pins the multiplexer switches.
 *
 * These are the ESP32-S3's native USB pins: GPIO19 and GPIO20 are dedicated
 * analogue pins that cannot be routed through the matrix, so a board wanting
 * both switches them, which the FSUSB42UMX does under BOARD_EXIO_USB_SEL.
 *
 * Inferred from the multiplexer and the pins' fixed function, not traced on
 * the schematic.  The bring-up runs at 1 Mbit/s with zero errors on these
 * pins.  A wrong assignment presents as a bus that never asserts, the first
 * line the bring-up report prints.
 */
#define PANEL_CAN_PIN_TX   GPIO_NUM_20
#define PANEL_CAN_PIN_RX   GPIO_NUM_19

/* Both ends must agree.  1 Mbit/s is what the coprocessor's 16 MHz crystal
 * reaches exactly; see IOMCU_CAN_BITRATE and docs/Link.md. */
#define PANEL_CAN_BITRATE  1000000u


/* ----------------------------------------------------------------- safety */
/*
 * The heartbeat.  GPIO6 is on J8, a three-pin header carrying 3V3, GND and
 * GPIO6, which gives a retriggerable monostable on a daughterboard its rail
 * and ground.
 *
 * The schematic's pin table lists GPIO6 against no peripheral: the one
 * uncommitted fast pin on the board.
 */
#define PANEL_HEARTBEAT_PIN   GPIO_NUM_6

#ifdef __cplusplus
}
#endif
