subtilitas/rcbench/shared/servo/servo_rudder_auto_report.c

/**
 * @file
 * @brief AUTO end points: the outbox, the report RUDDRnnn.TXT, the CSV
 *        RUDDRnnn.CSV and the words a reason and a phase are named by; see
 *        servo_rudder_auto.h.
 *
 * The report is written in the language of the run's table, the CSV in
 * English, as the automatic test's (servo_str.c).
 *
 * SPDX-License-Identifier: MIT
 */

#include "servo_rudder_auto.h"

#include <math.h>
#include <stdio.h>
#include <string.h>

/** @brief The CSV's columns: one row a measure. */
#define RAUTO_CSV_HEAD "step;side (us);write;value;measured (deg);" \
                       "goal (deg);measured (mm);goal (mm);within"

/* ------------------------------------------------------------ the outbox */

/**
 * @brief Line @p idx of the CSV: the header, then one row a step.
 * @param r   Run state.
 * @param idx Line, from 0.
 * @param buf Out: the line.
 * @param n   Size of @p buf, bytes.
 * @return false past the last row.
 */
static bool csv_line(const servo_rauto_t *r, unsigned idx, char *buf,
                     size_t n);

servo_test_out_t servo_rauto_peek(servo_rauto_t *r, const char **text)
{
    if (text != NULL) {
        *text = "";
    }
    if (r == NULL || r->state != SERVO_RAUTO_DONE || r->out_done) {
        return SERVO_TEST_OUT_NONE;
    }
    if (!r->out_open) {
        return SERVO_TEST_OUT_OPEN;
    }
    /* The CSV first, then the report: the order the logger writes an
     * automatic test's two files in, one open at a time. */
    if (!r->csv_open) {
        if (csv_line(r, r->out_line, r->scratch, sizeof(r->scratch))) {
            if (text != NULL) {
                *text = r->scratch;
            }
            return SERVO_TEST_OUT_CSV;
        }
        r->csv_open = true;
        r->out_line = 0u;
    }
    if (!r->out_end) {
        if (servo_rauto_report_line(r, r->out_line, r->scratch,
                                    sizeof(r->scratch))) {
            if (text != NULL) {
                *text = r->scratch;
            }
            return SERVO_TEST_OUT_TXT;
        }
        r->out_end = true;
    }
    return SERVO_TEST_OUT_END;
}

void servo_rauto_pop(servo_rauto_t *r)
{
    if (r == NULL || r->state != SERVO_RAUTO_DONE || r->out_done) {
        return;
    }
    if (!r->out_open) {
        r->out_open = true;
    } else if (!r->out_end) {
        ++r->out_line;
    } else {
        r->out_done = true;
    }
}

bool servo_rauto_drained(const servo_rauto_t *r)
{
    return r == NULL || r->state == SERVO_RAUTO_IDLE
        || (r->state == SERVO_RAUTO_DONE && r->out_done);
}

/* ------------------------------------------------------------ the report */

/** @brief A cursor over the report's lines, as servo_limrun_report.c's. */
typedef struct {
    unsigned want,              /**< index asked for */
             at;                /**< index of the next line */
    char    *buf;               /**< out: the line */
    size_t   n;                 /**< size of buf, bytes */
    const char *const *text;    /**< the language table; NULL for English */
} cur_t;

/** @brief Entry @p id of the cursor's table. */
#define LS(id) servo_str_in(c->text, SERVO_STR_##id)

/**
 * @brief Count one line, and tell whether it is the one asked for.
 * @param c Cursor.
 * @return true when it is.
 */
static bool here(cur_t *c)
{
    return c->want == c->at++;
}

/**
 * @brief An empty line.
 * @param c Cursor.
 * @return true when it is the line asked for.
 */
static bool blank(cur_t *c)
{
    if (here(c)) {
        c->buf[0] = '\0';
        return true;
    }
    return false;
}

/**
 * @brief A table entry as a line.
 * @param c  Cursor.
 * @param id The entry.
 * @return true when it is the line asked for.
 */
static bool text_line(cur_t *c, servo_str_t id)
{
    if (here(c)) {
        snprintf(c->buf, c->n, "%s", servo_str_in(c->text, id));
        return true;
    }
    return false;
}

/**
 * @brief The trailing edge's travel for a deflection: L x sin(theta).
 * @param deg    The deflection, °.
 * @param len_mm The surface's length, mm.
 * @return the travel, mm.
 */
static float mm_of(float deg, float len_mm)
{
    return len_mm * sinf(deg * 3.14159265f / 180.0f);
}

/**
 * @brief The family's name, which stays English.
 * @param f servo_rauto_family_t.
 * @return the name.
 */
static const char *family_name(uint8_t f)
{
    switch (f) {
    case SERVO_RAUTO_FAM_HITEC_D: return "Hitec D";
    case SERVO_RAUTO_FAM_HITEC_C: return "Hitec";
    default:                      return "KST/Chaservo";
    }
}
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
