subtilitas/rcbench/shared/outputs/servo_page.c

/**
 * @file
 * @brief The SERVO link page.
 *
 * See servo_page.h.
 *
 * SPDX-License-Identifier: MIT
 */

#include "servo_page.h"

#include <stddef.h>
#include <string.h>

#include "link_msg.h"
#include "out_pwm_map.h"
#include "outputs_pages.h"
#include "prog_port.h"

/*
 * Clears the page: all registers, no sweep, no hold.
 *
 * @param p The page state, overwritten.
 */
void servo_page_init(servo_page_t *p)
{
    if (p != NULL) {
        memset(p, 0, sizeof(*p));   /* each slot's own rate, no sweep */
    }
}

/**
 * @brief The sweep curve the page's registers describe.
 *
 * @param r The page registers, LINK_SV_COUNT of them.
 * @return The curve: kind, MHz, amplitude, dwell and movements.
 */
static sweep_cfg_t cfg_of(const uint16_t *r)
{
    const sweep_cfg_t c = {
        .kind      = (sweep_kind_t)r[LINK_SV_SWEEP],
        .mhz       = r[LINK_SV_SWEEP_MHZ],
        .amplitude = r[LINK_SV_SWEEP_SPAN],
        .dwell_ms  = r[LINK_SV_SWEEP_DWELL_MS],
        .moves     = r[LINK_SV_SWEEP_MOVES],
    };
    return c;
}

/**
 * @brief Whether two sweeps trace the same curve; the movement count is not
 *        the curve, and it applies to the next start.
 *
 * @param a The first sweep.
 * @param b The second sweep.
 * @return true when kind, mhz, amplitude and dwell_ms are equal.
 */
static bool same_curve(const sweep_cfg_t *a, const sweep_cfg_t *b)
{
    return a->kind == b->kind && a->mhz == b->mhz
           && a->amplitude == b->amplitude && a->dwell_ms == b->dwell_ms;
}

/**
 * @brief The channels the sweep and the hold command: the standard servo
 *        ports, or the range servo_page_target() named.
 *
 * @param p The page state.
 * @return The first channel index, 0 for the standard servo ports.
 */
static uint8_t target_first(const servo_page_t *p)
{
    return (p->target_n != 0u) ? p->target_first : 0u;
}

/**
 * @brief One past the last channel the sweep and the hold command.
 *
 * @param p The page state.
 * @return target_first + target_n, or LINK_OUT_CHANNELS for the standard servo
 *         ports.
 */
static uint8_t target_end(const servo_page_t *p)
{
    return (p->target_n != 0u) ? (uint8_t)(p->target_first + p->target_n)
                               : (uint8_t)LINK_OUT_CHANNELS;
}
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
