subtilitas/rcbench/(commit log)

2026-08-26 chore: settle line endings and what the build tree leaves behind
    The predecessor lost a commit to this and had to amend it after the fact: git
    had no opinion on line endings, so a Windows checkout wrote CRLF while the
    Linux VM reaching the same tree over a mount wrote LF, and dozens of files
    reported as wholly rewritten every session. That is not cosmetic -- it means
    no commit can use a directory pathspec, because `git add shared/` sweeps in
    files whose only change is invisible.
    Settled here before the first source file rather than after the first
    casualty. Screenshots are marked binary for the same reason a golden-image
    check exists at all: a corrupted PNG fails for a reason nobody would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
2026-08-26 feat: the tree, the ported floor, and both firmware projects
    Three build systems, one source list. Each module under shared/ carries a
    ten-line CMakeLists that answers to whichever is asking -- idf_component_
    register() under ESP_PLATFORM, add_library() otherwise -- so the panel sets
    EXTRA_COMPONENT_DIRS and gets every module as a first-class component while
    the coprocessor and the host suite add_subdirectory() the ones they want. No
    wrapper components and no source list written down twice. It puts one
    if(ESP_PLATFORM) in a directory that claims no vendor SDK; that claim is about
    the C, and the alternative is twenty-one files of indirection to avoid one
    conditional.
    Verified rather than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
    [de.csv, en.csv, partitions.csv, ragged.csv, units-header.csv]
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2026-08-26 fix(ci): the env context does not reach a job name
    The whole workflow failed validation and no job ran, which is why the run
    reported "likely failed because of a workflow file issue" and listed zero jobs
    rather than a failing step.
    `jobs.<id>.name` accepts github, needs, strategy, matrix, vars and inputs --
    not env. The pico-sdk pin is spelled out in the name and kept for real in
    env.PICO_SDK_TAG, which is where the cache key and the clone read it.
    Also pairs download-artifact with upload-artifact's major in release.yml.
    Checked against the actions repositories rather than guessed: checkout has
    majors through v7, cache through v6, upload-artifact through v7 and
    download-artifact through v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
2026-08-26 feat(link): the page map, the dispatcher, and both watchdogs
    The codec becomes a protocol. Pages, a read/write dispatcher with reasons for
    every refusal, and the two watchdogs -- all pure C with the clock passed in as
    a millisecond count, so both can be driven through their transitions on a
    laptop.
    Three decisions worth the words:
    **Traffic returning does not lift the failsafe.** A request arriving is proof
    the host is alive and stops the silence counter; the failsafe is latched
    separately and leaving it takes a deliberate write of LINK_CLEAR_MAGIC to the
    control page. Those are different facts, and conflating them is how a bench
    re-arms itself while nobody is looking at it. A link rec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
    [link_dev.c, link_host.c]
2026-08-26 docs(link): read the pins and the direction circuit off the schematic
    The board schematic closes three of the six open items and overturns a fourth
    by showing the question was the wrong way round.
    **The RS485 pins, and a trap in them.** U6 is an SP3485EN -- 3.3 V, so no
    level shifting and no 5 V near the module -- on GPIO16 (TX) and GPIO15 (RX).
    That is the opposite of the obvious reading, and the schematic's own pin table
    does not settle it: the table calls GPIO15 "RS485_TX", which names the
    transceiver's data directions rather than the ESP32's. The connectivity
    settles it twice. GPIO15 reaches U6 pin 1, RO -- the receiver's output, which
    the ESP32 cannot drive. GPIO16 reaches pin 4, D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
2026-08-26 fix(link): land the constants the last commit only described
    LINK_TURNAROUND_US and LINK_BAUD_FLOOR were written up in the previous commit
    message, in the README and in docs/Link.md, and were not in the header. The
    edit that added the two #if guards applied; the edit that added the constants
    they test did not.
    Which is worse than it sounds, because the guards did not fail -- they passed.
    An undefined identifier is 0 to the preprocessor, so `128000 < LINK_BAUD_FLOOR`
    was `128000 < 0`, and a check written specifically to catch a rate below the
    floor silently protected nothing. There is now an #ifndef in front of it, so a
    missing constant breaks the build rather than disarming the test, and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
    [main.c]
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2026-08-26 feat(ui): the shell -- band, router, splash, menu, and eight honest screens
    The features are known; how to display them was not. This settles it for the
    44 catalogue entries that are small and unblocked, and builds the shell they
    hang off.
    **The menu is things, not capabilities.** Sixty-odd entries across measure,
    drive, listen, program and compute would make a menu of capabilities into a
    filing system, and a workshop tool is not one. A tile is a physical object you
    have in front of you, and a bench combines measure, drive and listen for that
    one object. Five are live; three are named, routed and honest about what is
    missing. Battery did not earn a live tile -- only two of its features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
2026-08-26 docs: stop linking the earlier project, and say where this actually stands
    The status block linked a private repository by name, which does not belong in
    a record that is published to a wiki and may not stay private itself. The
    inherited code is still described as inherited; it just no longer says where
    from.
    It was also stale -- it claimed the foundation was "being laid" while the link,
    both transports, the shell and the widgets were built. A running record that
    describes an earlier state is worse than no record, because it is read as
    current.
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2026-08-26 feat(ui): say SIMULATION across the whole screen when the numbers are modelled
    The bench is worth having without hardware -- a modelled pack, motor and
    propeller let every screen be built, reviewed and demonstrated before the
    coprocessor exists. The whole danger of that is a simulated reading being
    screenshotted, quoted or remembered as a measured one, and no caption in a
    corner prevents it.
    So the router writes it across the whole screen, corner to corner, at 15%:
    faint enough to read straight through, impossible to crop out of a photograph.
    Drawn last, over the band and over any alert, and no screen can opt out --
    every screen would find its own reason to think itself exempt.
    gfx_text_r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
2026-08-26 feat(ui): the balance sensor and the surface-angle sensor are not the same part
    They look interchangeable in a catalogue and they are not, so the reason is
    written where somebody choosing one will read it.
    A packaged serial IMU -- nine axes, onboard fusion, RS232 on a lead -- is ideal
    for a control-surface angle. The measurement is static, the part is already
    housed and on a cable, and it reads the *surface* rather than the servo's
    output shaft: linkage slop, horn geometry and pushrod flex included, which is
    what the aeroplane actually gets. Sub-0.1 degrees, limited by how repeatably
    it is stuck on rather than by the sensor.
    It cannot do balancing, and not because it is cheap. Balancing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
2026-08-27 feat(bench): the model the screens read, and the two things that fill it
    bench_state is the seam the whole two-processor split turns on. The screens
    see it and never a register: fill it from the link's BENCH page and the numbers
    are measured, fill it from the simulator and they are modelled, and the bench
    screen cannot tell.
    The page is fixed-point rather than floats. A register is sixteen bits and a
    float is not, and the scale is then part of the contract instead of a
    convention two firmwares have to agree on by accident. Peaks live on the page
    rather than being computed on the panel, because the coprocessor has the fast
    samples and the panel sees one poll in fifty of them -- a peak der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
    [bench_state.c, telemetry_sim.c]
2026-08-27 feat(ui): the motor and ESC bench, reading a bench_state it cannot see behind
    Four traces on one time base with independent scales, hero readouts with their
    extremes, a draggable throttle with presets, and arm and reset where a thumb
    can find them. It owns no hardware and performs no I/O: hand it a
    bench_state_t and touch events, read commands back out.
    Two rules keep a tap from spinning something. A pending DISARM cannot be
    overwritten -- two taps inside one drain is barely possible and exactly the
    case that must not go wrong, because an ARM landing on a DISARM would re-arm a
    bench the operator has just watched stop. And leaving disarms, with the
    command carrying the disarm rather than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
2026-08-27 feat(ui): the log viewer, re-cut for a screen that no longer owns its top
    Browse the card, read what the import view detected and the evidence behind
    it, then plot with cursors. The reader itself came over with the floor and is
    unchanged: locale-tolerant, streaming, and never holding the file.
    The layout moved up 40 px, which is the whole re-cut. It was drawn for a
    screen that owned all 480 and painted its own home tag in the top 40; the
    router owns the band and the tag now and hands this screen a 432 px window.
    Without the shift the footer ran from 430 to 472 in a canvas 432 tall, so
    RESCAN, OPEN and PLOT were not merely clipped -- they could not be pressed at
    all. The suite's five geom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
2026-08-27 feat(ui): setup, re-cut, and the seven cases it was holding
    The settings screen shifted up 40 px like the log viewer and for the same
    reason: the router owns the band and the home tag, so the screen gets 432 px
    and the list ran from 56 to 458 without it. RESET CATEGORY moved with it,
    which is what the one failing case caught.
    The seven screen cases that were removed when the model was ported are back.
    They were taken out deliberately -- a test asserting the old layout's pixel
    geometry would have been asserting the wrong thing -- and there was a note in
    the file saying so. It is now the whole suite again: 21 cases, model and
    screen.
    One helper did not survive the move and should not have: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
    [settings.c]
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2026-08-27 fix(panel): the first hardware boot -- a splash that never ended, and a starved panel
    Two faults, found on the board rather than in the suite, because neither is
    visible without one.
    **The splash never handed over.** SPLASH_STEP_COPRO was declared and never
    set, so all_answered() was never true and the panel sat on its own boot screen
    for ever. A step that exists and is never answered is worse than one that does
    not exist: the list looks complete and the machine waits. Bring-up now asks
    who is there -- OK with the version when something replies, WARN when nothing
    does, FAIL when the protocol major disagrees, since that is a bench that must
    not arm.
    **The panel was starved of PSRAM bandw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
    [main.c]
2026-08-27 feat(servo): limit testing and synchronising two servos, both from current
    Two features that come from the same measurement and are both about the servo
    *as installed* rather than the servo as sold. Neither is in the catalogue's
    small set: both want a current sensor per output, which it costs as medium.
    FINDING THE LIMIT. Endpoints set by eye in a transmitter are guesses, and a
    servo held against a mechanical stop draws stall current for as long as it is
    asked to -- it cooks itself, empties the pack and wears the gears, and nobody
    finds out until something strips. The stop has a signature: current against
    commanded position is flat and low while the surface is free and climbs
    steeply the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
2026-08-27 Paint the bench only on frames that have something new (#17)
    Samples arrive at 20 Hz and the panel refreshes at 39, so about half of all
    frames were repainting an identical plot, identical readouts and identical
    controls into the very PSRAM the LCD is scanning out of. That contention is
    what made the first hardware boot tear, so the frames worth removing are the
    ones that were never showing anything.
    The plot's push count and a control revision are each tracked per framebuffer.
    Per framebuffer because the panel alternates between two: a buffer whose last
    paint was a sample ago still needs one even when the other is current, and
    getting that wrong reads as flicker rather than as an obviousl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
2026-08-27 The safety heartbeat, driven and judged at both ends (#18)
    The last foundation item that was still a comment. The pin was configured and
    held low because the line has to be driven by the loop that owns STOP, and that
    loop did not exist when the pin was wired. It does now.
    WHAT THE PANEL SENDS. An edge every 20 ms asked for from the render loop --
    every frame, without the generator needing to know the frame rate. Withdrawing
    `alive` drops the line in the same call rather than letting the monostable time
    out: the fastest correct thing to do with a stop is all of it at once. STOP
    latches, and only an explicit arm clears it, because a stop that lasts one frame
    is a stop the far end may nev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
    [main.c]
2026-08-27 Find a servo's installed mechanical limit by current (#19)
    The first of the two servo procedures that were described on the stub screen
    and nowhere else. The search is written; it has nothing to drive until the
    coprocessor has PWM and a sensor per output, which is why it is a state machine
    fed measurements rather than a loop that sleeps -- the host suite runs it
    against a modelled servo and the coprocessor will run it against a real one
    with no difference between them.
    Endpoints set by eye are guesses, and a servo held against a stop draws stall
    current for as long as it is asked to. The stop has a signature: flat and low
    while the surface is free, climbing steeply the moment the linkage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
    [servo_limit.c, servo_limit.h, servo_sim.c, servo_sim.h]
2026-08-27 Synchronise two servos on one surface by what they fight (#20)
    The second of the two servo procedures. Two servos bolted to the same surface
    settle any disagreement through the surface: they do not fail, they do not buzz,
    and nothing about the model tells you. The surface just sits there, stiff, with
    both servos pushing against each other and drawing extra current to do it, until
    something wears out.
    The objective is therefore not a position. There is no reference to compare
    against and no angle known to be right -- but the total current the pair draws
    is smallest exactly where they stop fighting, which turns it into a
    one-dimensional search with a physical answer rather than a judgement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
    [servo_sim.c, servo_sim.h, servo_sync.c, servo_sync.h]
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2026-08-28 The OpenYGE codec: framing, status and the parameter table (#23)
    Written from docs/OpenYGE.md rather than from the code that page was written
    from, which is the point of having the page. Bytes in, decoded frames out --
    no UART, no clock -- so the host suite can feed it every frame a real line
    produces long before there is an ESC on the bench.
    FRAMING reuses the panel link's decoder shape: every sync byte in the buffer is
    a candidate and the earliest complete one wins, so a real frame arriving behind
    noise that happens to carry a plausible sync is still recovered. It reuses
    link_crc() as well -- OpenYGE is CRC-16/XMODEM against the link's CCITT-FALSE,
    which is the same polynomial and a dif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
    [openyge_frame.c, openyge_params.c, openyge_status.c]
2026-08-28 Say which end of the cable is broken, before plugging it in (#24)
    The panel's first hardware boot cost three symptoms and two root causes, worked
    out from a description rather than from the board. The link has more ways to be
    half-broken than the display does -- wrong pins, wrong baud, a direction line
    that never releases, a turnaround shorter than the transceiver's, a firmware
    skew -- and most of them present as "it does not work", which is the least
    useful sentence in engineering.
    A BUG FOUND WHILE LOOKING. The coprocessor has declared LINK_ST_FRAMES,
    LINK_ST_CRC_ERRORS and LINK_ST_RESYNCS since the page map was written and has
    never filled any of them. The panel reads three zeros that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
    [link_bringup.c, main.c]
2026-08-28 Carry the page protocol on CAN identifiers (#25)
    The coprocessor module arrived with an XL2515 controller and a SIT65HVD230
    transceiver, and the panel board turns out to have had a CAN path all along --
    multiplexed against USB on the FSUSB42UMX. So the link moves.
    WHAT SURVIVES IS THE PART THAT MATTERS. link_msg_t -- an op, a page, an
    offset, a count and some registers -- never knew what carried it, and
    link_dev_handle is the only place a transport leaks upward. This is a second
    framing beside link_frame.c rather than a rewrite, and the dispatcher, the page
    map, both watchdogs and their tests are untouched.
    WHAT IT DELETES. CAN arbitrates rather than taking turns, so there is no
    direct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
    [link_can.c]
2026-08-28 Keep a console when CAN takes the USB pins (#26)
    Native USB is the wrong answer here, which is the opposite of the obvious one.
    USB-Serial-JTAG and USB-OTG both live on GPIO19 and GPIO20 -- dedicated analog
    pins that cannot be routed through the matrix -- and those are the pair the
    FSUSB42UMX switches against CAN. So selecting CAN costs the native console
    whichever way round the multiplexer is wired: either it is switching those two
    GPIOs away from the socket, or it is switching the socket away from them, and
    the result on the desk is the same. That is exactly the session that wants a
    console, and the bring-up report is the thing it would be printing.
    The board's second USB-C socket sits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
    [board_pins.h]
2026-08-28 CAN bit timing, and the crystal that decides the budget (#27)
    Both controllers divide a clock into time quanta and split each bit into a
    fixed sync quantum plus two programmable segments. Getting that wrong does not
    fail cleanly: a node a fraction of a percent off works on a short bench cable
    with one other node and starts logging errors once the bus is longer, colder or
    busier -- which is the worst possible time to find out. So the arithmetic is
    here with tests rather than in a table of register values copied from an
    application note, and one worked example is checked by hand against the
    datasheet: 16 MHz at 500 kbit/s gives sixteen quanta, a sample point at 87.5%,
    and CNF1/2/3 of 0x40, 0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
    [board_pins.h]
2026-08-28 The CAN module's crystal is 16 MHz, and its pins are known (#28)
    Both were open questions in the record an hour ago. Neither is now, and
    neither was guessed.
    THE CRYSTAL DECIDED THE BANDWIDTH BUDGET. The XL2515 halves its crystal before
    the prescaler starts and a CAN bit needs at least eight quanta, so an 8 MHz
    module would have been capped at 500 kbit/s -- 25.8 kB/s of payload against the
    12-30 kB/s the record says crosses, short at the top of the range. It is
    16 MHz, so 1 Mbit/s is reachable exactly and the budget stands at 51.6 kB/s.
    It was determined rather than believed. The vendor's driver carries CNF
    triples for ten standard bit rates; decoding each back into a divisor and a
    qua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
    [copro_pins.h]
2026-08-28 A CAN echo test at both ends, and the drivers under it (#29)
    Before the page protocol means anything, one question has to be answered on its
    own: do frames cross this bus intact? Answering it together with "does the
    link work" is how a bring-up turns into an afternoon, because a bit timing that
    is slightly wrong, a missing terminator, a transceiver in the wrong mode and a
    dispatcher bug all present as "the panel shows no numbers".
    So the test answers only that. The panel sends a frame, the coprocessor sends
    it straight back, the panel checks it came back byte for byte. No page map, no
    registers, no state machine above it. A pass here with a link that still does
    not work means the fault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
    [board_pins.h, copro_pins.h, main.c, xl2515.c, xl2515.h]
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2026-08-28 The touch drain loop ran while there was nothing to drain (#31)
    touch_wait_event returns bool. ESP_OK is zero. The main loop compared one to
    the other, so it ran while there was *no* event and stopped the moment one
    arrived -- the condition was inverted, and it has been since e398024 gave the
    panel a main loop.
    Three things followed from that one comparison, and the third is the one that
    matters:
    - It never terminated. The queue is empty most of the time, so everything
    below it in the loop -- the poll, the logger, the render, the flip --
    never ran. Nothing has been drawn since the first entry into the loop,
    which is why the panel showed a splash and then stopped.
    - ui_r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
    [link_dev.c, main.c]
2026-08-28 Both ends of the bus must sample the bit in the same place (#32)
    The first CAN bring-up printed this:
    panel brp 10, tseg1 6, tseg2 1, sjw 1, sample point 87.5%
    copro div 2, tseg1 5, tseg2 2, sjw 2, sample point 75.0%
    Same bit rate, different sample point, because each end solved its timing
    alone and neither knew the other existed. That is not a decision either of
    them is entitled to make separately.
    THE COPROCESSOR HAS NO CHOICE. Sixteen megahertz makes 1 Mbit/s exactly one
    way -- the smallest divisor and the eight quanta that are the fewest a bit may
    have -- and eight quanta put the sample at 75%. Nothing closer to 87.5 exists
    on that end. The panel has slack and the copro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
    [main.c, xl2515.c]
2026-08-28 Tell a dropped frame from a corrupted one (#33)
    The bus came up. 2019 of 2024 probes echoed, both ends sampling at 75%, and
    the controller reporting tx_err 0, rx_err 0, bus_err 0.
    And the self-test said "marginal timing, one terminator, or a bus longer than
    the rate" -- two lines above the evidence against it.
    NOT ONE ERROR FRAME IN 2024 TRANSACTIONS. If those five had been lost to
    termination, timing or reflections, some controller would have seen a bit,
    stuff, form or CRC error and counted it. None did. So the five arrived
    intact and something stopped reading in time. That is a different fault with
    a different fix at a different end of the bench, and sending somebody to check
    termin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
    [main.c, xl2515.c, xl2515.h]
2026-08-28 The coprocessor reports itself over the bus it is being tested on (#34)
    Two boards with two consoles means swapping a USB cable to see the other half
    of a fault, and a fault you can only see half of at a time is one you argue
    about rather than fix. Eight bytes carries everything the far end knows -- up
    or down, its transmit and receive error counters, its own flags, the echoes it
    has answered and the frames it dropped -- so it travels on the bus.
    It is POLLED, not volunteered. The coprocessor never speaks unless spoken to,
    which is a rule that predates CAN and is worth keeping even though arbitration
    would now make an unsolicited frame harmless. It shares the echo test's page,
    runs at th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
    [main.c]
2026-08-28 A lifetime total is not a measurement (#35)
    The run was perfect -- 2144 of 2144 echoed, nothing corrupt, nothing lost,
    zero errors at either end, zero overflows -- and the report I added an hour ago
    ended with:
    copro CAN up, 12182 echoes, ...
    it answered 12182 and we heard 2144: the return path is losing frames
    Nothing was losing frames. The coprocessor's counter runs from its own boot
    and it had sat powered through half a dozen panel reboots; the panel's counter
    covers the five seconds it was just measuring. Comparing the two is not a
    comparison at all, and 12182 divided by 2144 is very nearly the number of times
    the panel had restarted.
    A diagnostic that cries wolf on a perfe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
    [main.c]
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2026-08-28 What the review found: a panel that wedges, and a copro that fails safe on success (#37)
    Six independent reviewers over the CAN migration, every finding then given to a
    skeptic told to refute it. 59 candidates, 22 refuted, 37 confirmed. Three of
    them were real bugs in code written today, and two of those would have wasted a
    bench session before anybody suspected software.
    THE PANEL WEDGES AFTER THE SECOND UNANSWERED POLL. link_host_tick returned
    early on `escalated`, a latch set once and cleared only by a reply -- so only
    the *first* timeout ever released a request. The second stayed pending for
    ever: the poller could never ask again, and poll_page, whose only exit is that
    function retu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
    [link_host.c, main.c, xl2515.c]
2026-08-29 S.BUS, framed on the gap rather than on a byte that lies (#39)
    Sixteen channels and two digital ones in twenty-five bytes, on an inverted 8E2
    line at 100 kbaud. The bytes are the coprocessor's PIO's job and are not
    written; everything about what they mean is here and tested.
    IT HAS NO CHECKSUM, AND THAT SHAPES THE WHOLE DECODER. There is no CRC, no
    escaping, and 0x0F -- the header -- is an ordinary value inside channel data.
    A decoder that frames on the header will lock onto the middle of a frame and
    report sixteen plausible channels that are all wrong, and stay wrong, because
    the next header it finds is in the same wrong place. Nothing downstream can
    catch that: the numbers are in range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
2026-08-29 Ask who is there more than once (#40) (#40)
    The echo test retried five times and the identity poll beside it retried
    none, and that asymmetry was the whole of the bug: a bus that echoed
    2144 of 2144 frames with no errors at either end still showed the
    coprocessor as "no answer" on the splash.
    Two boards do not finish booting at the same instant, and a first frame
    onto a bus whose far end is not yet listening goes unacknowledged and is
    retransmitted in silicon -- time a single attempt had not budgeted for.
    The splash step is written once and never revisited, so one unlucky
    moment at power-on became a permanent verdict.
    Bounded at three seconds, because a bench with no coprocessor attached
    m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
    [main.c]
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2026-08-30 Three screens: the analyser, the programmer, and where the balance sensors go (#45)
    * The receiver analyser: two thirds history, one third now
    The question this screen is asked is "I moved that -- which channel was
    it?", and no arrangement of current values can answer it. The
    information is in the movement. So each channel gets a lane holding the
    last second and a half, and the eye finds a step among fifteen flat
    lines without being told where to look.
    It is also the only arrangement that separates the two faults the stub
    promised: a glitch is a spike in one lane, a dropout is a notch across
    all sixteen at the same instant.
    The remaining third is a bar, filled from its own centre. The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
    [main.c]
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2026-08-30 A servo page on the link (#47)
    The servo screen posted a command into a struct nobody read. There is a
    register page now: whether the output is driven, where to hold it, and
    the range outside which the coprocessor will not go. Protocol minor
    goes to 1, which an older host ignores by construction.
    The limits live at the far end because that is the end holding the wire.
    A host that has been restarted, reflashed, or is simply wrong must not
    be able to drive a servo into its own stops, so every pulse is clamped
    against the range at the coprocessor. The panel clamps too; that is
    convenience, and this is the one that counts.
    Two refusals and one clamp, and the difference is the design. A lim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
    [main.c]
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2026-08-30 One place where an output decides what to do
    There were two sets of output rules and they disagreed.
    throttle.c had all three that matter -- a command set while disarmed is
    remembered and not emitted, disarming drops to idle with no ramp, and it
    refuses to hold a throttle nobody is watching -- and nothing used it. The
    servo page came later, answered the same questions again, and answered two of
    them differently: it clamped and it checked arming, and it had no staleness
    rule at all.
    The failsafe path had the same shape. It cleared the control page and said
    so in a comment -- "written and reachable now rather than added once there is
    something to forget to add it to" -- and then the servo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
    [main.c, outputs.c]
2026-08-30 Move the panel's motor task onto the bank too
    I claimed throttle.c was unused. It was not: the panel's motor task is built
    on it, and a truncated grep is what told me otherwise. CI caught it, which is
    the only reason the claim did not survive into the record.
    The correction does not change the argument, it sharpens it. The rules ran on
    the panel and the servo page answered them again on the coprocessor, two
    processors deep, which is exactly why neither could notice the other.
    So the panel migrates as well. Arming, the ramp, the keepalive and the
    emitted value all come from the bank, and the 55 %/s ramp is carried over as a
    proportion of travel rather than a percentage -- the same numbe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
    [main.c, outputs.c]
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2026-08-31 Fix the nested comment the copro warnings just caught
    copro_pins.h opened its first block comment twice -- a stray /* on its own
    line -- which is a -Wcomment warning the pico-sdk build never enforced and the
    new -Werror on the copro target does. Exactly the kind of thing the flags are
    for: harmless today, and the first sign the file was edited without the
    compiler watching.
    [copro_pins.h]
2026-08-31 An SPDX line on every file, and the check that keeps it there
    Two loose ends from the review's mechanical sweep.
    rcbench_ui declared its host link to rcbench_link only transitively, through
    rcbench_bench's PUBLIC linkage -- it compiled today and would break the day
    bench stopped needing link. Named explicitly now, matching the IDF REQUIRES
    that already listed it.
    And the SPDX header travelled by copy-paste, so about half the tree carried one
    and half did not, decided by where each file happened to be started from. All
    85 sources without one now have it -- the generated fonts through their
    generator so gen_font.py --check still passes, everything else directly -- and
    check_docs.py holds t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
    [bench_state.c, copro_pins.h]
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2026-08-31 Give the ported files the rationale the rest of the tree has
    The house style opens a file with why it is shaped the way it is, not what it
    does. Ten files inherited from the predecessor skipped it -- they carried a
    bare SPDX line and went straight to the code -- and they were the files a
    maintainer most needs help with: the locale-blind CSV reader, the decimal-point
    voter, the settings schema, the touch differ.
    Each now opens with the decision that is actually hard to see from the code:
    log_numbers why "1,024" is not decided per cell but voted across a column,
    and what counts as no evidence -- the address, the date, the
    millisecond timestamp that each read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
    [log_csv.c, log_fields.c, log_numbers.c, settings.c]
2026-08-31 Lift the CAN self-test out of the panel's main.c
    main.c was the review's F2: app_main long, and the file carrying things that
    are not the main loop. The CAN self-test was the largest of those -- the echo
    run, the both-ends comparison, the error-counter reading, about 170 lines --
    and it compiles only under -DRCBENCH_CAN_SELFTEST, so on every ordinary build
    it was dead weight in the file everyone reads.
    It is its own translation unit now, firmware/panel/main/selftest.c, called from
    the one place it always was under the same flag. The extraction was clean
    because the self-test shared almost nothing with the loop: only now_ms(), a
    three-line esp_timer wrapper it now keeps its own copy of, an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
    [main.c]
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2026-08-31 Tune the analysers, and fix the four real things they found
    First clang-tidy run: 210 findings, 189 of them one check demanding snprintf_s
    -- a C11 Annex K function neither glibc nor newlib implements, where snprintf
    with a size is already the bounded call. Off, with the reason in .clang-tidy,
    along with the struct-padding optin check. That left twenty worth reading.
    Four were real:
    servo_sim the modelled servo's start position averaged its two stops
    with integer division, losing half a microsecond whenever the
    sum was odd.
    gfx five pointer offsets computed the multiply in int32_t and
    widened afterwards. Correct for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
    [log_numbers.c, servo_sim.c]
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2026-09-02 Describe the system as it is, wire the panel's control page and settings store
    Documentation:
    - Rewrite the wiki (English and German), both READMEs, STATUS.md,
    CONTRIBUTING.md, SECURITY.md and the hardware pages to the writing rules:
    present tense, no development history, numbers with units, acronyms
    expanded on first use. Add README-de.md with a language switch on both
    READMEs, and CHANGELOG.md.
    - Correct stale statements: the module tree, the compile table, the console
    on UART0, the coprocessor board, the Performance table, the CAN bit timing
    of both controllers (20 quanta on TWAI, 8 on the XL2515, both at 75 %).
    - STATUS.md lists the open items with what each needs and the sta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
    [bench_state.c, board.c, board.h, board_pins.h]
2026-09-02 Fix the panel's boot panic and the 17 px scan-out shift
    Load the settings from NVS before display_init(). A main-flash operation
    while the panel scans faults the bounce-buffer refill, which reads PSRAM
    from an interrupt handler through the external memory cache, and the core
    panics with "Cache disabled but cached memory region accessed". Formatting
    an empty NVS partition erases six sectors, so the panel looped through the
    splash from the touch step onwards.
    Set CONFIG_LCD_RGB_RESTART_IN_VSYNC=n. It restarts the DMA on every vertical
    blanking interval, and each restart empties the LCD FIFO and then resumes
    from a link that skips LCD_LL_FIFO_DEPTH + 1 = 17 px on the assumption that
    the FIFO s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
    [display.c, display.h, main.c]
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2026-09-03 Lay the ESC screen out in two columns
    The plot and the throttle take the left, the four readouts and the controls
    take a rail on the right, so a glance at the numbers and a hand on the
    throttle no longer compete for the same part of the screen.
    A strip above both columns carries the poll rate, the link's error count and
    three temperatures. The band already shows the output mode, so the strip does
    not repeat it, and it keeps STOP: the band is unchanged and every screen
    still offers one. The telemetry panel's title strip carries the motor
    constant and the shaft speed a watt buys, neither of which the bench sends.
    ui_bench_status_t gains link_errors, the coprocessor's CRC failures and
    resyncs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
    [main.c]
2026-09-03 Run the bench in a control task, and the screen in what is left
    Touch, STOP, arming, the outputs, the link and the heartbeat move out of the
    render loop into a task pinned to the core that does not draw, running every
    5 ms. A frame that costs 50 ms now delays what is shown and not what the
    bench does; before, it rate-limited steering to 13 Hz.
    The heartbeat follows the control task, because the control task owns STOP
    and the heartbeat's whole claim is that the loop owning STOP is running. Its
    period no longer depends on what a frame costs, so the 26 to 52 ms the
    monostable window was sized against becomes a fixed 5 ms. The window stays at
    150 ms: the margin is what survives a task that is l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
    [main.c]
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2026-09-03 Show what a volt is buying, and take the rated kV from the ESC
    Replace RPM/W with the rated kV, what the motor turns per volt, and the ratio
    of the two.
    Terminal voltage splits into the resistive drop and the back-EMF, so rpm/V
    under load is the rated kV scaled by the fraction of the voltage reaching the
    back-EMF, and that fraction is what becomes mechanical power. The ratio is a
    conversion efficiency rather than a rule of thumb. It counts copper loss only,
    so it is an upper bound on shaft efficiency, and the bench measures pack
    voltage rather than the motor's terminals, so the ESC's losses are inside it:
    it describes the drivetrain. RPM/W measured neither and compared only between
    runs on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
    [settings.c]
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2026-09-03 Queue the bench samples, and publish the die temperature
    Three things a review of the control task found, all of them real.
    The renderer pushed one plot column when it noticed the sample counter had
    moved, so a render loop that stalled past two samples dropped the ones it did
    not come back for and the plot's time axis compressed by exactly the frames it
    missed. That is the frame-rate coupling the control task exists to remove. The
    samples now cross as a queue of eight and the renderer drains all of them, so
    one sample is one column whatever the frame rate. A renderer more than eight
    samples behind drops the oldest: 400 ms of stale plot is worth less than a
    current one.
    s_mcu_c was written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
    [main.c]
2026-09-03 Clear the review findings left behind in four merged pull requests
    ui_slider_painted_rect() claimed to cover every pixel ui_slider_render()
    touches and covered only the track's band. The presets are drawn by the same
    call and sit outside it, so a caller clearing the reported region would leave
    a row of buttons behind. It returns the union now, and test_widgets pins that
    the presets are inside it.
    The router invalidation test settled both framebuffers and then checked only
    buffer 0. Chrome caches are per buffer, so a hook that cleared one bit would
    have passed while leaving the panel alternating between a repainted frame and
    a stale one. It checks both, and names the buffer when it fails.
    s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
    [display.h, main.c]
2026-09-03 Harden the control task against what the review found
    The heartbeat no longer stops when the link does. beat() sat in the same loop
    as a CAN exchange that spins to LINK_HOST_TIMEOUT_MS, so one unanswered reply
    left the safety line without an edge for 1000 ms against a 150 ms ceiling: the
    coprocessor dropped its outputs and latched its failsafe, and recovery needed
    an operator. Touch, STOP, the outputs and the heartbeat move into
    control_pump(), which the exchange wait calls once per 5 ms receive window.
    The loop that owns STOP really is running during that wait; this is what
    makes the line say so.
    A tap on the splash no longer latches STOP. The hit test used the band's
    rectangle, which is a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
    [main.c]
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2026-09-03 Hold the rpm peak to a run, and keep the servo pulse a pulse
    Two defects the review found.
    sample() cleared the whole bench_state every 50 ms, so rpm_max was
    recomputed from one sample and reported the current speed under the name
    of the peak. The live readings and their valid bits are rebuilt each
    sample; the peaks are not. They are reset on the edge into driving, so a
    run's peak is that run's rather than a maximum from a motor taken off the
    bench two runs ago, and bench_state_reset_peaks() takes the current
    reading rather than zero.
    A PWM level above the slice's wrap makes the counter never reach it and
    the pin sits high for ever. At 400 Hz the period is 2500 us and 2500 us
    is a legal en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
    [main.c, out_pwm.c]
2026-09-03 Put the pad back when a bidirectional bind fails
    The transmitter's program_init muxes the pad to its PIO block before the
    receiver is claimed, so a bind that failed for want of a second state
    machine left the pin muxed to a block it no longer had a program on. Only
    the inversion and the pull were undone. The pad restore is one helper now,
    used by the failure path and by teardown.
    Also a comment in the panel that did not parse.
    [main.c]
2026-09-03 Wait for a whole DShot reply, and keep its due time current
    Two more from the review, both in the path nothing has run yet.
    out_dshot_poll() drained whatever the receiver's queue held and cleared
    the armed flag whether or not a reply had finished arriving. The loop
    turns over thousands of times in the 70 us a capture takes, so the first
    poll after a frame always found the queue short: every reply was thrown
    away before it was decoded, and bidirectional telemetry would have
    produced nothing at all on hardware. Nothing is taken now until four
    words are there, which is the fewest that can hold one idle sample and
    21 bits at five samples each. An ESC that never answers leaves the queue
    short an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
    [outputs_hw.c]
2026-09-03 Leave the other channel on a slice alone, and stop DShot at a known level
    Three more from the review.
    out_pwm_bind() called pwm_init() for the slice every time, including when
    the slice was already carrying its other channel at the same rate.
    pwm_init() rewrites the slice and resets its counter, so configuring one
    output stepped the servo already on the other. The slice is initialised
    only when nothing is using it.
    out_dshot_stop() disabled the transmitter without saying what the pin
    should then be. A state machine stopped mid-bit holds whatever its
    side-set wrote last, so a plain DShot line could be left high. The pin is
    taken back and driven to its idle, and handed to the block again whe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
    [out_pwm.c]
2026-09-04 Bind a protocol to pins, and keep the binding where the wires are
    An outputs screen behind the Setup screen's OUTPUTS key: a protocol
    list, and a grid of the twenty-six GPIOs the header brings out. Each
    ticked pin becomes one slot on the OUTPUTS page, in pin order, taking
    channels from zero upward, so the lowest ticked pin is channel 0 whatever
    order the screen was touched in.
    One protocol and a set of pins rather than eight independent slots. A
    bench is wired one protocol at a time -- four servo leads, or one ESC --
    and asking for the protocol once and then for the pins is the shape of
    that job.
    shared/outputs/out_bind.c carries the catalogue, the seven protocols, the
    selection rules and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
    [main.c, out_bind.c, out_store.c, out_store.h]
2026-09-04 Refuse a reserved pin on the way back, and stop trusting the index
    Four from the review.
    outbind_from_slots() accepted a reserved pin from the OUTPUTS page. The
    page stores what was written and the bank refuses a reserved pin only at
    apply, so a page can name GP10 with nothing driving it; reading that back
    as ticked showed a binding the bank never accepted, and one the screen
    would not let the operator tick again. The page is refused instead, so
    the screen shows nothing configured.
    The screen indexed the protocol table with the binding's own value. That
    value arrives from the wire and from the coprocessor's flash, so it is
    not the screen's to trust; out of range it read past the table and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
    [main.c, out_bind.c]
2026-09-04 Check a pin at its full width before narrowing it
    outbind_from_slots() cast LINK_OS_PIN to eight bits and then validated it.
    The register is sixteen, so a page naming 0x0100 became GP0 and read back
    as a binding on the first pin of the header rather than being refused.
    The value is checked against the widest pin a slot may carry first.
    [out_bind.c]
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2026-09-04 Make the outputs result atomic, and count the reserved pins correctly
    s_outputs_result crosses two tasks pinned to different cores and was
    volatile. This file already says why that is not enough, twenty lines
    above, for the stop flags: volatile orders nothing between processors and
    promises no atomicity. It is an atomic_int with explicit loads and
    stores, like the flags it sits beside.
    And the reserved set is six pins, not five: GP3 plus GP8 to GP12.
    [main.c, out_bind.c]
2026-09-04 Require a page to render back to itself before showing it
    outbind_from_slots() matched on driver and rate and ignored the channel
    range, so it accepted pages this shape cannot describe: a PPM slot
    claiming one channel instead of eight, two PPM slots at once, a
    first-channel field that does not follow the slot order. Each drew a
    binding the operator could not have made and could not reproduce.
    Rather than adding a check per case, the reconstructed binding is
    rendered back and required to equal the page it came from. That is the
    property the screen actually needs -- what it shows is what the page
    says -- and it catches the cases not thought of as well as the three
    above.
    [out_bind.c]
2026-09-04 Tell a write that got no answer from one that was refused
    The panel reported both as REFUSED. They send the operator to different
    places: REFUSED back to the pins they chose, NO LINK to the cable. A link
    that dropped part-way through the two page writes said the coprocessor
    had rejected the configuration, which is a wrong answer that looks like a
    definite one.
    write_page() returning false is the transport failing; a reply that is
    not an ACK is the far end refusing. They are separated.
    [main.c]
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2026-09-04 Report the firmware version the repository says it is
    The identity page has carried firmware major, minor and patch since the
    page map was written and nothing ever set them, so both images answered
    0.0.0 while the tree said otherwise. A board in the field asked what it
    is running gave the wrong answer, and gave it confidently.
    shared/link/include/rcbench_version.h holds the three numbers once. The
    coprocessor publishes them on the identity page; the panel prints what
    came back on its bring-up line, beside the protocol version, because two
    boards can speak the same protocol and be different builds. The panel is
    the host and publishes no identity of its own, so it puts its own build
    on the fi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
    [main.c]
2026-09-04 Cast the identity registers at the format call
    The registers are uint16_t and were passed to %u uncast. The file's own
    convention is to cast at the call -- the log line counting rows already
    does -- and following it here costs nothing and says which width is
    meant.
    The neighbouring protocol-mismatch log had the same shape and predates
    this change; leaving one of the two would be worse than fixing both.
    [main.c]
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2026-09-04 Walk the board table, and make the soldered rule testable
    Three from the review.
    every_board_in_the_table_is_answerable probed identities 1 to 7 while
    claiming to walk the table, so a board added later with an id outside
    that range would be in the table and skipped by the test meant to hold
    it. outbind_board_count() and outbind_board_at() expose the table, and
    the test walks it and checks each board is also findable by the identity
    it reports.
    The soldered-board test built a local board with fixed set and never
    used it: outbind_can_add() reads the table, so the assertions were about
    nothing and the loop that would have tested the rule never ran, because
    no board is soldered. The rule now l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
    [main.c, out_bind.c]
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2026-09-04 Ask who answered, every time the link comes up
    s_board was written once, by the identity read at bring-up, with
    whatever was attached then. A coprocessor that was absent at boot and
    turned up later had its outputs page decoded against zero -- an unknown
    board -- and the screen then offered no pins for as long as it stayed
    plugged in. A coprocessor swapped for another was read against the board
    identity of the one before it.
    The identity is read again on the edge into link-up, before anything is
    decoded against it.
    s_capabilities has the same single writer and the same staleness, and is
    not touched here: it is read by app_main and written at boot, so moving
    its write into the control task a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
    [main.c]
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2026-09-04 Forget the board when the identity read fails
    The refresh set s_board only when poll_identity() answered. A read that
    failed left whatever was there -- from boot, or from a coprocessor since
    unplugged -- and the outputs page was then decoded against a board that
    is not on the bench. That is the fault the refresh was added to fix,
    surviving in the path where the refresh does not happen.
    A failed read says nothing about which board is out there, so it says
    nothing: the identity goes to unknown, the page is refused rather than
    decoded, and the screen offers no pins. That is the failure that shows.
    [main.c]
2026-09-04 Take the board from the identity page that opened the link
    The link-up edge is reached only from the identity poll, so the reply
    that detected it already carries the identity page. Reading it a second
    time cost another transaction on the edge and ran bring-up's retry loop
    inside the control task, where the frame it draws between attempts
    races the render task's own ui_router_render() and display_flip() on
    the other core.
    A NACK answers the request it refuses, so poll_page() returns true for
    one and regs[0] holds a refusal reason. The identity poll therefore
    counts only a DATA reply as an answer, which is what bring-up already
    required: a coprocessor whose identity page is absent or shorter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
    [main.c]
2026-09-04 Give every protocol its own pin set
    outbind_t held one protocol and one pin set, so binding a second protocol
    meant unbinding the first. It now holds a pin set per protocol entry, and a
    pin belongs to at most one of them.
    Choosing a protocol says which set is being edited. Nothing is trimmed: the
    pins of the protocol being left stay bound and read back as held, and a pin
    another protocol holds is refused rather than taken. On the grid that pin is
    grey with the holder's name where a free pin shows its pad number, which is a
    different fact from a reserved pin's red: one is a choice undone from the
    other protocol, the other is the wiring.
    Slots fill in pin order across every protocol and take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
    [main.c, out_bind.c]
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2026-09-04 Decide a catalogue before writing it, and stop warning about an older board
    outbind_learn_board() wrote pins into the static slot as it parsed, so a page
    that failed part way -- out of order, or the same GPIO twice -- left half of
    itself over the board already learned. The function returned false while
    outbind_board() went on answering with a count from one board and pins from
    two, which is the opposite of the documented contract. It now validates the
    whole page first and writes only once nothing can refuse it.
    The test for it fails against the old order: pins[0] came back with the
    refused page's pad and reserved flag.
    The panel warned on every link-up with a coprocessor built before the
    c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
    [main.c, out_bind.c]
2026-09-04 Let a board say where its pads are
    The catalogue names a pad and the pin on it. It does not say where that pad
    sits, and only a picture of the board needs to know: pad 7 could be at either
    end of either row. A picture drawn from a guessed form factor points at the
    wrong pad as confidently as the right one, which on a screen whose job is
    "find this pad on the board in front of you" is the one failure worth
    avoiding.
    Adds the SHAPE page, 0x25, read-only: outline width and height, the corner
    pad 1 sits at with the pads in one row, the pitch, and the edge-to-row inset,
    all in hundredths of a millimetre. Two rows on one pitch, numbered away from
    pad 1 along its edge and back along the opposite o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
    [main.c, out_bind.c]
2026-09-04 Reverse a right-hand row along itself, not across the outline
    A corner on the right numbers its row the other way. Mirroring the position
    across the outline gives the same answer only when (width - span) is even:
    the row is centred by integer division, so an odd remainder leaves the two
    margins differing by one and the mirror shifts the whole row by that much
    instead of only reversing it. Reversing the index along the row keeps the
    centring the code says it keeps.
    Both tests for it fail against the mirror. One walks every pad of an even
    and an odd outline and requires pad n from the right to land on pad
    (per_side + 1 - n) from the left; the other requires a row to occupy the
    same set of pos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
    [out_bind.c]
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2026-09-05 Check the pixels against the length in sixty-four bits
    Width and height are sixteen bits each and their product times two is not.
    A page claiming 65535 x 32769 pixels and 65534 bytes agrees with itself in
    thirty-two-bit arithmetic -- the product wraps to exactly that -- and the
    block count agrees too, so nothing else refused it. It would transfer,
    assemble, pass its CRC, and hand back 65534 bytes calling themselves a
    65535 x 32769 image; whatever drew it would read four gigabytes past the
    buffer.
    The test uses those numbers and fails against the thirty-two-bit compare.
    [link_artxfer.c]
2026-09-05 Fetch a board's photograph once and keep it
    Completes the artwork path. #91 carried a picture over the link; this
    generates one, serves it, fetches it, and keeps it, so a board seen once is
    drawn from its own photograph ever after.
    tools/gen_board_art.py turns the PNG beside a board into a checked-in C
    array, the gen_font.py convention: the firmware build needs no Python and no
    image library, and CI runs --check so the two cannot drift. Pixels rather
    than bytes, because a byte costs six characters of source where a pixel costs
    eight for two -- 856 kB rather than 1.3 MB for the same picture. The link
    carries the low byte of a pixel first and the code serving it does that split
    explicitly, so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
    [partitions.csv]
2026-09-05 Write the photograph down on a task of its own
    art_slice() bounded the link transactions and then committed to flash inline,
    which defeated the point of bounding them: erasing a slot and filling it is a
    quarter of a megabyte, hundreds of milliseconds during which nothing else
    runs on that task. The control task is the one that beats the safety line and
    its ceiling is 150 ms, so the commit would have dropped the heartbeat and the
    coprocessor would have failed safe -- a bench stopping for a photograph.
    The buffer is handed to a keeper task, below the renderer and on the other
    core, which writes it and frees it. A fetch does not start while the last one
    is still being written down. The display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
    [main.c]
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2026-09-05 Give the top buttons the room they have, and a soldered board its picture
    Two of the review's findings were bugs.
    The room above the board is what board_box() reports and no less: the router
    hands a screen its own body, so the band is already out of these coordinates.
    Taking it off again shrank every top-row button from 52 pixels to 28 -- half
    a fingertip, on the screen whose whole argument is that a pad is too small to
    press.
    And a soldered board showed no buttons at all, which takes the screen's
    answer away on the board that most needs it: an operator holding one still
    has to find where GP7 is. Its pins are drawn the way a pin another protocol
    holds is -- shown, and not offered -- and ou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
    [main.c]
2026-09-05 Mark the grounds and the rails, with their voltage
    A servo lead has three wires and the picker described one of them. Somebody
    who had found where the signal goes still had to count pads on the board to
    find a ground for the return and a rail for the positive, which is how a lead
    goes to the wrong place.
    Adds the PADS page, 0x28, read-only: the pad number, what it is -- ground,
    rail, or neither -- and the rail in tenths of a volt. Separate from the
    catalogue because they do not fit in it: a page is thirty-two registers, the
    catalogue is one per pin an output may have, and a forty-pad board has more
    pads than that between the two.
    Zero volts on a rail is not zero volts. It means the rail ha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
    [main.c, out_bind.c]
2026-09-05 Make the no-pads test use a board that has none
    The test was named for the case where a board does not say which pads are
    grounds and rails, and used the board this build knows -- which says. So it
    rendered the path it was meant to leave out and reported coverage of a branch
    it never took.
    It now learns a board with a catalogue and a shape and no pad list, which is
    what a coprocessor built before the page answers with, and presses a button
    on it.
    Adds the case that was missing on the other side: with the marks drawn, every
    pin the board brings out is still bound by its own button. A chip drawn over
    a trace must not move where a button is or which pin it belongs to.
    And the log line says g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
    [main.c]
2026-09-05 Make the flash-size landmine fail at build time
    The board file claims sixteen megabytes and the bring-up module has four.
    out_store.c pins its sector to 4 MB - 4 kB for that reason and says so in a
    paragraph, which is a comment guarding a boot failure.
    Two halves of it are now checked instead.
    A _Static_assert holds the store inside the flash this build believes in,
    which catches a -DPICO_BOARD for a module smaller than the store: the sector
    would otherwise sit past the end and an erase off the end of a part is not a
    diagnosable failure.
    It cannot catch the mismatch that actually exists -- no compiler sees a part
    it is not told about -- so the other direction is checked after the link. Th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
    [out_store.c]
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2026-09-05 Move the artwork fetch out of the panel and test it
    The sequence that fetches a board's photograph lived in the file that owns
    arming, STOP, the throttle and the heartbeat, and nothing could test it: the
    host suite does not build firmware, so the block loop, the two-transaction
    order, the state transitions and every failure path were written and never
    run. I put them there yesterday, which is the coverage inversion in one
    shared/artwork/art_fetch.c has them now, with the link passed in. The suite
    runs the sequence against a device in memory whose link can be stopped at a
    chosen transaction, which is what an unplugged board looks like, and against
    one that answers with a block nobody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
    [main.c]
2026-09-05 Refuse metadata that cannot be a picture before anything is sized from it
    art_fetch_meta() returned true for any non-zero block count and length, so a
    coprocessor disagreeing with itself got as far as an allocation -- from a
    number that had not been checked -- and was refused afterwards by
    art_fetch_begin(). The header already claimed otherwise.
    link_artxfer now has one place that decides whether registers can describe a
    picture at all: format, the block count the length implies, and the length
    being the pixels claimed, in sixty-four bits. link_artxfer_begin() calls it
    and then checks the buffer; art_fetch_meta() calls it and leaves the byte
    count zero when it fails, so there is nothing to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
    [link_artxfer.c, main.c]
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2026-09-06 Take both timestamps inside the window being measured
    Either side of it they also counted the disable and the restore, and the
    number is meant to be the time this core answered nothing. The timer is a
    peripheral and reads with interrupts off.
    And the panel's flash chunk is written in terms of SPI_FLASH_SEC_SIZE rather
    than repeating 4096, so the two cannot drift.
    [art_flash_esp.c, out_store.c]
2026-09-06 Give the settings screen a SAVE button and take the write when idle
    The values were written whenever the screen was left, and the only sign of
    it was the word SAVED under RESET CATEGORY, in the same column and at the
    same width -- which reads as a button that does nothing. Reported as one
    (#100).
    SAVE is a button now, and pressing it is a request rather than a write.
    Writing settings commits a page of NVS, and a flash operation on the
    ESP32-S3 disables the instruction cache: neither core runs for its duration.
    settings_save_tick(safe) takes the request on the first frame at which the
    bench is disarmed and no board photograph is being fetched or stored, so the
    stall never lands on the task t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
    [main.c, settings.c, settings.h]
2026-09-06 Refuse the SAVE press the render already draws as inert
    The touch handler took the press whenever the values were dirty, while the
    render disabled the button once a save had been asked for: a press on WHEN
    IDLE lit a button that was doing nothing, which is the reading the old SAVED
    line gave. Press, highlight and render now read one condition.
    A standing request also ends when there is nothing left to write, so values
    loaded or reset under it cannot spend an erase cycle on what is already in
    flash.
    [settings.c]
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2026-09-06 Put the panel back on the bus after it falls off it
    A CAN transmitter that gets no acknowledgement retransmits on its own and adds
    8 to its transmit error counter each attempt. At 1 Mbit/s a frame nobody
    answers reaches the bus-off threshold of 256 in about 4 ms, so any moment with
    no second node on the bus -- the coprocessor unpowered, reset, or held with
    interrupts off long enough -- takes the panel's controller off the bus.
    The ESP32-S3's TWAI controller does not come back on its own, and nothing
    asked it to. Every twai_transmit() after that returns ESP_ERR_INVALID_STATE,
    the identity poll never gets an answer, and the panel shows NO LINK with SIM
    until it is power-cycled. The first quie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
    [main.c]
2026-09-06 Say the controller is not running rather than printing zeros
    can_twai_errors() left its outputs alone when the driver was not running or
    its status would not read, so the report printed a bus with no errors for a
    controller that was never started -- the healthiest line in the log for the
    one fault that stops everything. It returns whether it read anything, and the
    report says which of the two it is.
    Also: the German note on the transmit error counter was English grammar with
    German words.
    [main.c]
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2026-09-06 Fix the grammar in the request-counter comment
    [main.c]
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2026-09-06 Run the CAN self-test at every start-up and say so on the panel
    The echo test answers the one question a bench with no numbers raises -- do
    frames cross this bus intact -- and it was behind a compile-time flag and a
    console. An operator with neither could not run it, and the fault it finds is
    invisible from every other screen: a bus that carries nothing looks exactly
    like a coprocessor that is not fitted, and both look like a bench that simply
    shows no numbers.
    It now runs at every start-up, 1200 ms inside the splash and before the
    identity poll, so a broken bus is diagnosed as a broken bus rather than as an
    identity that never answered. A verdict other than "every probe came back
    intact" p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
    [main.c]
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2026-09-06 Say on the panel why a link stopped, and write it to the card
    The panel has no console an operator can reach while the bench runs. The
    native USB socket carries GPIO19 and GPIO20, which the multiplexer hands to
    CAN about a second into boot, and whether the bridged socket reaches UART0 is
    not traced on the schematic -- on the board a tester reported #99 from, it
    does not. A fault only a console explains is a fault nobody in the field can
    report, and that one took five rounds to narrow down.
    So the panel says it. A link that was up and has been gone for 4 s brings up
    the bus-fault screen with this end's own counters: what the CAN controller is
    doing, its transmit, receive and bus error counts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
    [main.c]
2026-09-06 Keep one shape in the log file, and count rejoins per outage
    The card line changed shape when the controller would not answer, dropping
    the timestamp, the down time and the poll counters -- in the one reading that
    most needs them. It carries the same fields in the same order now, with "?"
    in the columns it cannot fill.
    And "rejoins" was cumulative while sitting on the screen beside "down N s",
    where it reads as this outage. The screen shows this outage and the log line
    shows this outage over the total since boot: one number cannot answer both
    questions without being read as the wrong one somewhere.
    [main.c]
2026-09-06 Say what is known about the bridged socket instead of what was assumed
    The header said UART0's pins were assumed and not traced. They are not
    assumed any more: an ESP32-S3-Touch-LCD-7 Rev1.2 accepts a firmware download
    through that socket, and the ROM bootloader takes a serial download on UART0
    and nowhere else. A socket that can flash the board is a socket the console
    reaches.
    The board that started this carries the same revision and passes nothing
    through it in either direction while its CH343 enumerates normally. That is
    one board's fault, not a difference between boards, and it is recorded as
    such: enumerating proves the chip's USB side, its supply and its oscillator,
    and says nothing a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
    [board_pins.h]
2026-09-06 The bridged socket has a switch, so a silent one is not a broken one
    A slide switch beside the BOOT and RESET buttons is marked UART1 and UART2
    and decides what the bridge chip's serial side reaches. In one position the
    CH343 enumerates normally -- the port appears and Windows names it, which
    proves its supply, oscillator and USB side and nothing else -- and passes
    nothing in either direction.
    That is what the board behind #99 does, and it reads exactly like a dead
    chip. Recorded as a switch to check rather than a fault to diagnose.
    [board_pins.h]
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2026-09-06 End the wait on the request's own timeout, not on the link going quiet
    This is the fault behind #99. The panel stopped transmitting for good, the
    coprocessor saw a silent bus and no errors, and only a power cycle cleared
    link_host_tick() answers true for two different facts: this request has been
    outstanding too long, and the link as a whole has gone quiet. Only the first
    releases the outstanding slot. exchange() left its wait on either, so a wait
    that ended on the second left the request pending -- and a pending request
    refuses every later one from link_host_read(), which returns before
    exchange() is entered, and exchange() held the only call to
    link_host_tick(). The timeout that would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
    [link_host.c, main.c]
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2026-09-06 Say that the expander's read-modify-write is single-threaded, and what it costs to change that
    board_exio_set() reads the shadow, changes one bit and writes the whole port
    back with no lock. That is safe as the tree stands: every caller runs during
    bring-up on app_main, before control_task exists. board_sd_cs() is reached
    only from storage_init(), and storage_deinit() has no caller.
    The bit worth naming is BOARD_EXIO_USB_SEL, which drives the multiplexer
    between native USB and the CAN transceiver. A lost update there would take
    CAN off the bus with no error reported anywhere.
    A caller added on another task needs a lock, and its wait has to be bounded
    well under HEARTBEAT_MAX_GAP_MS (150 ms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
    [board.c]
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2026-09-06 Name the heartbeat in control_setup, and state two comments as behaviour
    control_setup() ends with s_pump_live, which is the line in it with a
    consequence outside the file: it tells exchange() that a control task exists,
    so a wait for a link reply pumps the renderer rather than standing still. The
    header did not mention it.
    Two comments carried by the split described what a past change broke rather
    than what the code does. They now say the rule and the number.
    [main.c]
2026-09-06 Answer a wide write with the pieces it was acknowledged in
    Every frame of a request is self-describing and the coprocessor answers each
    one it decodes, so a write of 32 registers draws eight acknowledgements of
    four at offsets 0, 4 ... 28. The host demanded one acknowledgement covering
    the whole window, matched none of them, counted all eight as mismatches and
    waited out LINK_HOST_TIMEOUT_MS. During that second it transmitted nothing,
    so the coprocessor's own LINK_DEV_SILENCE_MS watchdog latched failsafe.
    Both output pages are 32 registers wide, so applying a binding did this every
    time: the screen reported NO LINK against a link that was up, the second page
    of the pair was never sent, and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
    [link_host.c]
2026-09-07 Start every arm from a throttle of zero
    ARM and THROTTLE travel in one transaction, so the value the panel holds when
    it arms is the first thing the far end acts on -- with no ramp, because the
    throttle channel carries no slew until the bank is armed. Every disarm
    returns that value to zero, except one.
    arming_stop_from_far_end() clears a->armed itself, and arming_step()'s disarm
    branch is gated on a->armed, so ARMING_ACT_DISARM cannot follow it. The
    coprocessor disarming the bench -- a lost heartbeat, its own failsafe -- left
    the throttle at its last position. The screen showed zero, because the panel
    resets the slider on the disarm edge and swallows the command that follows.
    The next arm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
    [main.c]
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2026-09-07 Count a sample only when the bench page was read
    new_sample was taken from `answered` after link_up had already been set to
    it, so it reduced to `answered` alone. While the link is down the question
    asked is the identity page, and an answer there says a coprocessor is present
    and nothing about the bench: the bench struct still holds what it held, which
    at boot is zeros.
    So the link-up edge produced one plot column and one log row of a reading
    that never arrived -- the thing the comment beside it says the rule exists to
    prevent. The sample is now taken from the branch that read the bench page,
    before link_up moves.
    [main.c]
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2026-09-07 Offer PPM at a rate it can be bound at
    The catalogue offered PPM at 50 Hz with eight channels, and eight channels do
    not fit in a 50 Hz frame. A channel is at most OUT_CEILING_US (2500 us) and
    the frame also carries the mark and a sync gap of at least PPM_SYNC_MIN_US,
    so eight need 8 x 2500 + 300 + 3000 = 23,300 us against the 20,000 us that
    50 Hz gives.
    outputs_configure() accepted it, because PPM's rate range is 20 to 50 Hz, so
    the coprocessor acknowledged the page and read it back unchanged -- and then
    out_ppm_bind() refused the frame and left the slot unbound. The screen showed
    a binding the bench did not have and nothing said otherwise. It was the only
    PPM the panel could offer, so PPM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
    [out_bind.c]
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2026-09-07 Say on the panel when a run is not being recorded
    The retry is gated on the run now, so a card that is missing, full or
    unwritable at the arming edge means this run is not recorded and nothing
    tries again until the next arm. That is the behaviour worth having --
    polling a missing card from the task that drives the heartbeat is what this
    change removes -- but it was silent, and the unmounted case returned before
    even the warning.
    Both failures now say so on the alert band as well as the console. The
    panel's console is not reachable on every board, so a fault only the console
    reports is a fault the operator does not have.
    [main.c]
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2026-09-07 Drive the bound motor pins from the throttle
    The MOTOR & ESC throttle commands bank channel 8, off the OUTPUTS page so
    that a motor command keeps the control page's priority on the wire. A pin
    bound on the OUTPUTS screen renders channels 0 to 7, and nothing wrote
    those, so an ESC bound to GP0 initialised, armed, and held its channel's
    rest at every slider position.
    The control page now commands every channel the binding marks a throttle
    and leaves the surface channels to the screens that own them, so which
    pins the slider drives is the binding's answer rather than a channel
    number repeated in two places.
    Add MOTOR PWM beside SERVO PWM: the same pulse at the same 50 Hz on a
    throttle channel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
    [main.c, out_bind.c, outputs.c]
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2026-09-07 Hold the servo where it was put, and against its own endpoints
    Three findings from the review of this branch, all in the path the servo
    screen's ARM has just made reachable.
    The panel wrote the servo's channel on a touch and never again. A channel
    nobody has commanded for OUT_DEFAULT_TIMEOUT_MS (500 ms) goes to its rest,
    which for a surface is mid-travel, so an armed servo swung back to centre
    half a second after the finger stopped while the screen still showed where
    it had been put. The position is said again every 100 ms while something
    is held -- one register, and only then.
    The channel was configured with a fixed 1000 to 2000 us whatever the
    screen's TYPE said. A narrow servo runs 660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
    [main.c]
2026-09-07 Let go of the servo wherever the bench is stopped
    Two findings from the second review of this branch, both the same shape as
    the arm that carried the throttle from before the last stop.
    Only the servo screen's own disarm released the pin. A STOP, a dead touch,
    a disarm from MOTOR & ESC and a far-end disarm did not, and the far end
    keeps the slot and the channel command through a disarm and a failsafe;
    outputs_arm() stamps every channel's clock, so the next arm found the
    servo neither overdue nor at rest and drove it to where it had been with
    nobody having touched anything. servo_let_go() is now paired with
    throttle_to_zero() in every path that stops the bench, and in the arm that
    is meant t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
    [main.c]
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2026-09-07 Drain the screens before the policy, and hold the arm until the slot is gone
    Three findings from the fifth review of this branch.
    The control loop stepped the arming policy before draining what the
    screens had asked for. A STOP latched at the top of a pass was then
    cleared later in the same pass by an arm queued before it, so the bench
    could arm from a press made to stop it. The queue is drained first now;
    arming_stop() abandons an arm rather than deferring it, so the newer stop
    stands. This was reachable from both screens' ARM.
    An unacknowledged servo release keeps its debt, but the arm went ahead
    regardless, so a transient link error during the release armed the bench
    with the slot and i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
    [main.c]
2026-09-07 Keep a hold with the contact that began it, and end it on a stop
    Two findings from the sixth review of this branch. Both were in the motor
    screen as well, so both are fixed in both.
    A stop can latch on a bench that is not armed, so set_armed() saw no
    change and a hold still under a finger ran on to completion and asked to
    arm -- clearing the latch that had just been set, from a contact made
    before the stop. Neither screen could see this: what they are told is
    whether the bench is armed. They are told about the latch now, and
    abandon a hold when it is set.
    And a second contact landing on ARM replaced the one the gesture belonged
    to. The first finger's release was then ignored, so it could l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
    [main.c]
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2026-09-08 Bind the servo's slot last
    One finding from the ninth review of this branch.
    A servo command is three transactions and the far end steps its outputs
    between them. Binding the slot before the position had arrived rendered
    whatever channel 0 was holding -- the position from before the last
    release, or the surface rest of mid-travel once that had gone stale -- and
    kept driving it for as long as a failed position write took to be retried.
    The order is now what the channel is, then what it is to do, then the slot
    that renders it, so the pin is either unbound or already carrying what was
    asked for.
    Not covered by a test: main.c is outside the host suite.
    [main.c]
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2026-09-08 Drop an arm that was asked for before a stop
    One finding from the twelfth review of this branch.
    The command queue and the stop count cross between app_main and the
    control task independently, so an arm could be queued from a gesture whose
    sender had seen the older count while a stop was applied in between. The
    arm then arrived with nothing left to say it should not, and cleared the
    latch that stop had set.
    Each command carries the count of stops its sender had seen, and an arm
    whose count is no longer current is dropped. This is the fifth shape of
    the same question and the first that crosses the two tasks; the earlier
    four were within one of them.
    [main.c]
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2026-09-08 Serve the stop first, and learn the bench before the frame's touch
    Two findings from the sixteenth review of this branch.
    The control loop drained the screens' commands before serving a pending
    STOP, so a stop could wait behind a command that talks to the link -- an
    unanswered exchange holds the loop for LINK_HOST_TIMEOUT_MS (1000 ms), and
    several such commands multiply it while the far end stays armed. The stop
    goes first again. That ordering was reversed earlier in this branch
    because an arm queued before a stop could clear its latch; commands carry
    the count of stops their sender had seen now, so the stale arm is dropped
    and the ordering is free to be the safe one.
    And the screens were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
    [main.c]
2026-09-08 Drop every stale drive command, not only a stale arm
    One finding from the seventeenth review of this branch.
    Commands carry the count of stops their sender had seen, and only arms
    were dropped when that count was stale. A servo position or centre queued
    before a stop was applied after it, putting back the slot the stop had
    just released and refreshing it from then on. A stop from touch dying or
    from the far end has no queued STOP behind it to release the slot again,
    so it stayed bound.
    Nothing that drives an output survives a stop it predates: an arm, a
    throttle, a position, a centre. A disarm, a release or a binding still
    means what it meant.
    [main.c]
2026-09-08 Apply STOP where it is seen, and let go on every stop
    Two findings from the eighteenth review of this branch.
    A STOP press was recorded for the policy to act on, and the policy is the
    thing a blocking exchange stops from running: a servo command makes up to
    three exchanges of up to LINK_HOST_TIMEOUT_MS (1000 ms) each, with the far
    end driving throughout. The press is applied in the pump that saw it,
    which runs inside that wait, so arming_heartbeat() goes false in the same
    pass and the coprocessor fails safe within HEARTBEAT_MAX_GAP_MS (150 ms)
    whatever this task is blocked on. The rest of a stop -- the bank, the
    throttle, the servo's slot, telling the far end -- follows when the loop
    is fre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
    [main.c]
2026-09-08 Keep a disarm out of the queue's reach, and let a binding void an old debt
    Two findings from the nineteenth review of this branch.
    The command queue drops its oldest entry when it is full, and leaving a
    screen produces commands on the way out while the next screen produces
    more. The disarm posted by leaving an armed servo screen could be evicted
    by them, leaving the bench armed and the servo held behind a screen nobody
    was watching. A disarm is a flag as well as a queue entry now, the way a
    stop is, and the servo screen's own release with it; applying either twice
    is applying it once.
    And a release that timed out keeps its debt, while a binding applied later
    in the same drain writes every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
    [main.c]
2026-09-08 Ask again after the wait, and let a write that landed void the debt
    Two findings from the twentieth review of this branch.
    The servo screen's arm releases the slot before requesting the arm, and
    that release can wait a second on the wire with the pump running inside
    it. A stop, or touch dying and recovering, could invalidate the gesture in
    that window, and the arm was then requested against a count nobody had
    rechecked. It is rechecked after the release.
    And a release that failed keeps its debt while a position written
    afterwards rebinds the slot to what was asked for. Paying the debt then
    cleared it and left the pin dead until the next refresh. A write the far
    end acknowledged voids a rel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
    [main.c]
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2026-09-08 Ask again between the two writes that arm
    One finding from the twenty-third review of this branch.
    Arming is a failsafe clear and then a control write, each able to wait
    LINK_HOST_TIMEOUT_MS (1000 ms), with the pump running inside both. A stop
    applied there, or a disarm posted while the clear was still on the wire,
    was not looked at before the write that actually arms -- so the far end
    could be driving for a timeout before anything took it back.
    The bench is asked again between the two, and an arm that the operator has
    since countermanded is refused rather than written. No alert for that
    case: they asked for it and know.
    [main.c]
2026-09-08 Bring the bank down after an outage, stop a countermanded write, make SPEED real
    Three findings from the twenty-fourth review, and the SPEED decision.
    Touch can die and answer again inside one blocking exchange, and the
    policy would then see a healthy controller and nothing to disarm -- while
    the heartbeat need not have been withheld long enough for the far end to
    fail safe. The edge that sees the outage latches a disarm now, so what was
    armed comes down whatever the state looks like afterwards.
    A servo's three writes each wait up to a second with the pump running
    inside them, so a stop or a disarm could arrive between one and the next
    and the slot was bound regardless. They stop on a coun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
    [main.c]
2026-09-08 Hold the line down until the disarm has landed
    Two findings from the twenty-sixth review of this branch.
    The disarm request was cleared before the write that delivers it, so the
    pump running inside that write's wait saw nothing outstanding and put the
    safety line back up -- while the far end was still armed if the write was
    lost. The request stands until the far end has taken it. Or until the line
    has been down twice HEARTBEAT_MAX_GAP_MS, by which time the far end has
    failed safe by the other route: a disarm nobody can deliver must not hold
    the line down for ever.
    And an explicit release recorded its debt and left the clearing to the end
    of the drain, behind whatever else was queued -- an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
    [main.c]
2026-09-08 Time the disarm inhibit from a clock, not from a sentinel
    One finding from the twenty-seventh review of this branch.
    Whether the inhibit's timer was running was encoded by forcing its
    timestamp non-zero. On an even millisecond that moved the start one
    millisecond into the future, so the unsigned elapsed time wrapped to its
    maximum and the inhibit ended on the pass that began it -- leaving a far
    end that could not be reached without the 150 ms of silence it needs to
    fail safe.
    The timer's state is a flag of its own, and the timestamp is only a
    timestamp.
    [main.c]
2026-09-08 Do not count silence before the first word
    The coprocessor's silence watchdog counted from its own boot. It is awake a
    few hundred milliseconds before the panel starts polling, so
    LINK_DEV_SILENCE_MS (200 ms) elapsed before the first request could arrive:
    the link-silent fault latched on every bench, from power-up, before
    anything had happened, and cleared only on the first arm. A warning that is
    always on is one nobody reads, and it cost an operator a question.
    The watchdog does not run until a request has arrived. Waiting for the
    first one is not silence.
    The watchdog's own cases started their clock at init and never sent a
    request, which is the state this fixes rather than the one they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
    [link_dev.c]
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2026-09-08 Say which channels a binding marks with a role
    outbind_role_channels() returns the channels a binding renders and gives a
    role, as a mask. A screen that commands a role rather than a pin asks this
    instead of naming a channel number: the wiring is described once, on the
    OUTPUTS screen, and nothing else holds a second copy of it.
    The walk is the one outbind_to_slots() and outbind_to_chan_cfg() make, so the
    bit set is the channel the slot written from the same selection renders. The
    tests hold the three to each other, including where the channel budget stops
    the walk.
    [out_bind.c]
2026-09-08 Drive the servo horn on the bound surfaces, not a fixed pin
    The SERVO screen wrote channel 0, slot 0 and pin GP2 whatever the operator
    had bound. Slot 0 and channel 0 are where the OUTPUTS page puts the first
    pin ticked, so the horn took over that binding: on a bench with a motor on
    the lowest pin it set the motor's channel to a surface, whose rest is
    mid-travel, and commanded it to the horn's position. The three writes are
    separate transactions, so a slot write refused because GP2 already carried
    something left the first two standing, with the motor's pin still bound to
    DShot and its channel holding half travel.
    The horn now writes the channels outbind_role_channels() names as surfaces,
    on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
    [main.c]
2026-09-08 Release the surfaces bound now, not the ones written before
    A release settled the union of what this process had written and what was
    bound. A channel rebound as a motor between the drag and the release was
    still in that union, so the release wrote mid-travel to it: a surface's rest
    is half power on a throttle, and the ESC ran at half throttle on the next
    arm. The same held after a coprocessor swap, where the channels written
    belong to a different far end.
    The release goes to the channels the binding marks as surfaces now. A channel
    that has stopped being one carries the rest its new role brought with it, or
    is rendered by no slot at all, and either way is not this screen's to settle.
    [main.c]
2026-09-08 Remove the four ESC settings nothing reads
    Telemetry, Sample rate, Output and Output pin had no consumer anywhere in the
    tree. They read as controls and changed nothing: an operator who set
    Telemetry to DSHOT TELEM and got no telemetry had been sent to a setting
    instead of to the binding, which is where the wiring is actually described.
    The OUTPUTS screen holds the driver, the rate and the pin, and the CHAN_CFG
    role holds what a channel is for. ESC / BENCH is eight settings now.
    Stored settings are keyed by name, so the removed keys are simply never read
    again and every remaining setting keeps its own value.
    [settings.c, settings.h]
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2026-09-08 Tell an unknown output binding from an empty one
    The surface mask had one value for two benches. A binding that was read and
    names no surface is a bench carrying only a motor, and it must still arm. A
    binding nobody has read, or one whose write did not come back, is unknown:
    the far end may be rendering surfaces this end cannot name.
    Treating unknown as empty let a release report success without settling
    anything, cleared the debt, and let the arm that followed refresh whatever
    commands the far end still held. A write whose acknowledgement was lost was
    applied over there all the same, so a result of NO LINK left the old mask
    standing while the new slots were live, and the horn could then co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
    [main.c]
2026-09-08 Track the peaks against what actually answered
    Two ways a run could report numbers no ESC sent.
    The sag floor was seeded by the reset that opens a run, and a run opens
    before the first voltage arrives: extended telemetry carries voltage a few
    times a second against a bench that samples fifty. A floor taken from the
    empty field is 0 V, no real reading is below it, and the whole run reports a
    collapsed pack. The floor is now seeded by the first valid voltage instead.
    And the cached readings outlived the run they came from. An ESC unplugged and
    another fitted between two arms was published as the previous one's voltage,
    current and temperature for as long as the 2000 ms window lasted, and tho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
    [bench_state.c, main.c, outputs_hw.c]
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2026-09-08 Clear the telemetry cache after the last reply, not before it
    forget_telem() ran before the slot loop, and a bidirectional slot reads the
    reply to its last frame on the way to stopping: the cache was cleared and then
    repopulated by that reply with a fresh timestamp, so the run's final reading
    outlived the run exactly as before. Rearming or swapping an ESC inside the
    staleness windows could still seed a new run with it.
    The clear happens after the loop, so the last reply is recorded and then
    dropped with everything else.
    [outputs_hw.c]
2026-09-08 Offer only the logs that can be opened, and remount a card that has gone
    Two ways the viewer said more than it could do.
    Nothing in the tree decodes a Betaflight blackbox log: every listed file goes
    to log_csv_analyse(). Listing .bfl offered files that cannot be opened, and
    the screenshot fixture hid it by returning generated CSV whatever the name.
    The filter and the screen's empty-card line both say .csv now, and the
    missing decoder is recorded in STATUS.md rather than implied by a suffix.
    And a card removed after boot left storage_mounted() true, because only
    storage_deinit() clears it. RESCAN then skipped the remount and kept reading
    the old volume's metadata, so a replacement card was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
    [main.c]
2026-09-08 Do not unmount the card from the task that renders
    The remount added for a swapped card ran on the render task, and the control
    task writes the run log to the same volume: unmounting under an open handle
    frees the SPI bus beneath a write on the other core. Reachable by entering
    LOGS, whose refresh scans on the way in, while a run log is still open.
    The listing reports no volume and leaves the mount alone. A card put in after
    boot is still found, because mounting when nothing is mounted cannot race a
    writer that has nothing open. The swapped-card case stays broken and is
    recorded in STATUS.md: recovering it means one task owning the card's
    lifetime, so the remount can be sequenced against th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
    [main.c]
2026-09-08 Keep one motor's telemetry to itself, and stop claiming the motor's heat
    Three ways the bench published a number that belonged to something else.
    The telemetry cache was one set for the whole bank while the binding allows
    eight outputs, any of them bidirectional. The most recently polled ESC won
    each kind independently, so speed could come from one motor and voltage from
    another, with a power that was the product of two. The cache is per slot now,
    and reporting_slot() names which one the page carries: the lowest-numbered
    bound bidirectional output, so the numbers belong to one motor and stay with
    A slot rebound while the bank was live kept its old ESC's readings, which
    sample() publish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
    [main.c, outputs_hw.c, telemetry_sim.c]
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2026-09-08 Read the surfaces off the pages, one channel at a time
    The mask came from the binding the pages were read into, and a binding names
    one role per slot: outbind_from_slots() takes a slot's role from its first
    channel and lets the rest differ. An eight-channel PPM slot whose first
    channel is a surface therefore put all eight in the surfaces' mask, throttles
    included, and the horn would command a motor to where a surface rests.
    outputs_role_channels() reads the two pages per channel, so a slot whose
    channels disagree is followed rather than collapsed. Nothing this end writes
    produces such a page, but the far end can be holding one -- from an older
    build, or from its restored store -- and the pa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
    [main.c, out_bind.c]
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2026-09-08 Keep what the ESC was told across a disarm, and say what nothing measured
    Three things the bench could still report that nothing measured.
    edt_asked was cleared whenever the bank stopped driving, but extended
    telemetry lives in the ESC and an ESC that keeps power keeps it across a
    disarm. The next run then read its first replies as periods, so an interleaved
    current frame of 120 A decoded as 8,900 rpm -- a number nobody questions, and
    bench_state_track_peaks() latches it for the run. edt_left is still owed every
    run, because an ESC that lost power did forget; edt_asked follows the binding
    instead, and only a slot that moves or a restart clears it.
    The run log wrote a motor temperature colu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
    [log_writer.c, outputs_hw.c]
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2026-09-08 Say that outputs_driving() is the armed flag, and what that leaves open
    outputs_driving() returns the bank's armed flag. The header claimed it also
    answers "being commanded", and firmware/iomcu attributed the heartbeat to it
    in three places. Both gates exist, and neither is in this function: the
    coprocessor sets armed only while the ARM register is set, the link is out of
    failsafe and the heartbeat monitor is alive, and the per-channel silence
    timeout is applied by outputs_step(), which puts an overdue channel at its
    rest and leaves the rest of the bank driving.
    State the consequence where it is read. An armed bank drives every bound pin
    whether or not anything commands it: a channel nobody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
    [main.c, out_store.h, outputs_hw.c]
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2026-09-08 Spend one flash erase per sixteen saves, and take it in a gap
    A save of the output binding erased and programmed one sector with interrupts
    off. On the bring-up module that window measured 19,174 to 19,186 us over
    eight saves. A CAN frame at 1 Mbit/s is about 130 us and the XL2515 holds two
    of them, so the receive buffers overran in step with the saves -- the count
    climbed from 2 to 8 across nine of them -- with nothing wrong on the wire: the
    frames arrived and nobody collected them. A lost request costs the panel
    LINK_HOST_TIMEOUT_MS (1000 ms) of waiting, and 1000 ms of silence latches this
    end's 200 ms failsafe, so one lost frame ends as FAULT 01.
    The store is two sectors of sixteen recor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
    [main.c, out_store.c, out_store.h, out_store_map.c]
2026-09-08 Write the run log from its own task, and commit it every second
    Move every SD (Secure Digital) card access off the control task. That task
    drives the heartbeat on GPIO6 and reads STOP; its ceiling is
    HEARTBEAT_MAX_GAP_MS (150 ms) and the coprocessor fails safe after 200 ms of
    link silence, while the SD specification allows a card 250 ms to finish one
    single-block write. A card that pauses is a dropped heartbeat, not a late row.
    The runlog task takes it: priority 3 on the control task's core, running in
    the 5 ms that task blocks every pass, and every fopen, fwrite, fsync and
    fclose happens there. How long this board's card takes is not measured.
    Rows cross on a 64-entry queue, 3.2 s of run a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
    [log_writer.c, main.c]
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2026-09-08 Carry the correction into the wiki, and bound what the header claims
    docs/Screens.md and docs/Screens-de.md still gate every driver on "the bench
    being armed, the heartbeat being trusted and a command arriving", the claim
    this branch removes everywhere else, and docs/ is what the wiki serves. They
    now say what STATUS.md, firmware/iomcu/src/main.c and out_store.h say: the
    gate is the bank's armed flag, which the coprocessor grants only while the ARM
    register is set, the link is out of failsafe and the heartbeat is trusted.
    Three claims in shared/outputs/include/outputs.h went past the code.
    Channels are addressed two ways. outputs_set_role_channels() addresses them by
    role and passes a surf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
    [main.c, outputs_hw.c]
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2026-09-08 Say what has run on hardware, and what the 19 ms window measured
    The state table claimed the two-sector store had run on hardware. It has not:
    the placement rules are host-tested in test_outstore, out_store.c and main.c
    compile only, and the 19,174 to 19,186 us window belongs to the single-sector
    store this replaces. That window is an erase and a page program together and
    neither half of it was timed on its own, which out_store.h, out_store_map.h,
    test_outstore.c, Screens.md, Screens-de.md and STATUS.md now say where they
    attributed it to the erase.
    The record version bump does not make the panel rewrite the binding. The panel
    keeps none and sends none unasked, so the first boot on this bui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
    [main.c, out_store.c, out_store.h]
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2026-09-08 Bound the boot reclaim, and name the sector it erases
    Three claims that did not match the code.
    The boot reclaim looped until the store came back clean. flash_range_erase()
    reports nothing, so a sector that will not erase is surveyed as not erased and
    offered again, and the loop would spin before can_start() with no CAN
    controller and no failsafe. It is bounded by OUT_STORE_SECTORS instead: past
    that the sector falls to the main loop, which costs a window per pass and
    keeps the bench answering.
    Both screen pages said the erase is taken on the pass after the save that
    fills a sector. It is the sector left behind that is erased, one save later,
    so the erase and the save that needs it are sep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
    [main.c, out_store.c, out_store.h]
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2026-09-08 Number a run above the card, and keep folders out of the list
    Two ways the browse list lost the log an operator wanted.
    The run number was the first free one, so deleting an old run on a computer
    left a gap the next run took. The number is the only age the card carries, and
    a run wearing an old number is ranked oldest: on a full card the experiment
    just recorded was the one dropped. A run is numbered above every number the
    card already holds, found in one directory read -- which also replaces up to
    999 opens on a card that is nearly full.
    And directories reached the bounded list. storage_walk() offers them whatever
    the suffix filter says, because a filter is about names and a directory has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
    [main.c]
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2026-09-08 Pump the safety line through the run-number scan
    Three faults in the numbering change.
    The scan ran on the control task without pumping. That task beats the safety
    line and hit-tests STOP, and a populated root takes longer to read than
    HEARTBEAT_MAX_GAP_MS (150 ms), so the coprocessor would drop into failsafe as
    the run began and STOP would go unread until the scan finished. The probe loop
    it replaced pumped per name; the walk pumps per entry.
    A scan that failed fell through to the probe loop from 1 and took the first
    gap, which is the numbering the scan exists to prevent: the run would be
    recorded and then rank oldest on the card, and a full list would hide it. A
    card that will not list i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
    [main.c]
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2026-09-09 Serve the safety line per directory entry, not per match
    The scan pumped from its visitor, and storage_walk() rejects dot-names, wrong
    suffixes and over-long names before the visitor is reached. A root holding
    enough unrelated files was therefore read with nothing else running, and on
    the first arm after boot that still drops the coprocessor into failsafe and
    leaves STOP unread until the walk ends.
    storage_walk() takes a tick called once per entry read, before any filter. The
    run-number scan passes control_pump, because it runs on the task that holds
    the line. The viewer's listing passes none: it runs on the task that renders,
    which has no line to hold.
    [main.c]
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2026-09-09 Stamp every page write with the pass's own clock
    The loop reads the clock once a pass and every timeout in the file is a
    wrap-safe unsigned subtraction of two timestamps, so a stamp taken ahead of
    the pass's now subtracts to 4,294,967,295 ms -- past every timeout there is.
    Four sites read the clock again for themselves, and all four run inside
    can_service(), where the millisecond counter can have advanced since the pass
    began:
    - save_outputs() stamped the store, so out_store_tick() saw a huge wait and
    took its flash window inside the request burst it exists to wait out,
    skipping both OUT_STORE_SETTLE_MS and the quiet-bus guard;
    - channels_write() stamped the bank, so outputs_step() in t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
    [main.c]
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2026-09-09 Keep a run out of the viewer until it is closed, and say what a cut costs
    Four things the split between the control task and the runlog task left open.
    The viewer could list and open the run the logger still had open. FAT keeps a
    file's length in its directory entry and f_close is what writes it, so the
    size the walk sees is the size at the last commit: a growing run reads as a
    finished one. The logger publishes the run it has open and the card adapter
    leaves it out of the list and refuses to open it, until f_close returns.
    The dropped-row count was one counter reset on the arming edge. A re-arm
    before the logger drained the previous run erased that run's count and charged
    the new run's dr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
    [main.c]
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2026-09-09 Reject a half-erased record by construction, and re-read the clock across a window
    A checksum makes a partially erased record unlikely to pass, not unable to.
    An erase only lifts bits, so a superseded record's sequence number can grow
    past the live one's; for that record to be rejected it has to fail a 16-bit
    check, which is 65,535 chances in 65,536 per candidate over an enormous
    number of candidates. The sequence number is stored twice now, the second
    time complemented: a bit gained in either word breaks the pair, and no bit
    gained in the other can restore it, because restoring it would mean clearing
    one. out_store_seq_ok() holds the rule in shared/outputs, where the host
    suite checks every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
    [main.c, out_store.c, out_store_map.c]
2026-09-09 Report dropped rows where they are counted, and check the close
    Three ways a run could end without the operator being told.
    The dropped-row count lived in two slots by the arming's parity, which holds
    two armings and not three -- and a stalled card is what puts three in flight:
    the run whose rows are still queued, and two the operator has run since. The
    count goes back to the control task, which is the task that drops the row,
    knows which arming it dropped from, and sees the disarm edge exactly. It is
    reported there, on that edge, and needs no slots at all.
    That also answers the run the logger can never report: one whose every row
    was dropped never reaches the logger, so no file is opened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
    [main.c]
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2026-09-09 Refuse a commit after a failure, and count the committing batch
    log_writer_commit() took the pending path with the failure already latched,
    so a flush that succeeded afterwards cleared the count and returned true --
    the panel's end-of-run commit being told an incomplete file is on the card.
    A failed writer is refused before anything is attempted, and the count is
    left standing so nothing downstream reads the writer as up to date.
    And the durability bound was one batch short. pending reaches
    LOG_WRITER_FLUSH_ROWS (20) before the commit is attempted and is cleared only
    once it succeeds, so those twenty rows are not durable for as long as the card
    takes and the control task can refill all 64 q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
    [log_writer.c, main.c]
2026-09-09 Claim the run before the file exists, and alert on either failing write
    fopen makes a directory entry visible, and the marker that keeps a run out of
    the viewer was stored after it. The task that renders can walk the card in
    between and find a run with nothing against it: it caches the size and
    analyses a file the logger is about to append to. The number is claimed
    before the open and cleared again if the open fails.
    And the quiet-run commit could latch the writer with its result discarded.
    The next row then found was_failed already true, so the edge alert never
    fired and the operator learned at the disarm that recording had stopped -- in
    the case where rows have paused, which is a link tim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
    [main.c]
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2026-09-09 Say version 3, name the guarantee, and give each constant its own block
    Four claims the last three rounds left behind.
    The CHANGELOG said the first save on this build writes a version 2 record;
    STORE_VERSION is 3.
    docs/Screens.md still credited the power-cut guarantee to the checksum, which
    is what the bit count replaced -- the checksum makes a torn record unlikely to
    pass and the count makes it unable to.
    OUT_STORE_SECTORS was inserted between OUT_STORE_QUIET_MS's doc block and its
    define, so a paragraph about how long the bus is quiet stood over a sector
    count.
    And s_now_ms is no longer read once a pass. It is read at the top and once
    more before the tail, because a flash window and a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
    [main.c, out_store.h]
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2026-09-09 Count a directory when numbering a run, and say when nothing is latched
    A directory named like a run takes that number: fopen refuses it in both
    modes, so log_open() probed it as free and then could not create it. The
    numbering scan skipped directories, so s_log_next never moved past them, and
    three of them in a row spent the whole create budget and abandoned every run
    from then on. The viewer skips directories because it cannot open one; the
    numbering has the opposite reason to count them.
    And log_writer_row()'s contract said log_writer_failed() stays true for every
    false return. It does for a write or a commit that failed. It does not for a
    refused argument -- a NULL writer or state, or a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
    [main.c]
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2026-09-09 Stop the splash claiming an expander runs firmware, and date the screenshot
    The BOARD line read "CH422G fw 0.8.0". The CH422G is the I2C expander, a
    fixed-function part with no firmware; the version beside it is the panel's own
    build, which is what the comment above the line and docs/Screens.md both say
    it is. It reads "CH422G, panel fw 0.8.0" now. This one is inside the shipped
    image, so it had to be fixed before the tag rather than after it.
    The wiki's splash screenshot said "proto 1.0 hw 0" and a BOARD line with no
    version at all. The mock had not moved since the first UI shell, while the
    protocol went 1.0 to 2.5 to 3.0 and the coprocessor line gained a firmware
    field. Both mock strings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
    [main.c]
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2026-09-09 Ask the card again after a run that could not be opened
    The release note said a card holding BENCH999.CSV records nothing until a run
    is deleted. Deleting a run did not help twice over: a gap lower down is never
    filled, and s_log_numbered is latched for the boot, so even deleting
    BENCH999.CSV left s_log_next at 1000 until the panel restarted.
    The latch is right while runs are being written -- a card holding hundreds is
    read once. A run that could not be opened has written no number, so the latch
    is cleared there and the next arming reads the card again. It costs a
    directory read per failed run, and a failed run is already one that is not
    being recorded.
    The note now says which run to delet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
    [main.c]
2026-09-09 Bound the log-numbering recovery to the card that stays in the slot
    Re-reading the numbering after a failed open rescues a card that never leaves
    the panel. It cannot rescue the one the operator takes out to delete
    BENCH999.CSV on a computer, which is the case that actually arises:
    storage_mounted() is cleared only by storage_deinit(), so a swapped card
    leaves a stale mount and the walk reads the volume that is gone. That is
    already an open item in STATUS.md, and the note now says the panel has to be
    restarted for a deletion made off the bench.
    The code keeps the rescan, which is right for a card that stays in, and says
    in the comment which half it cannot cover and where the other half is
    t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
    [main.c]
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2026-09-09 The picker follows the protocol it cannot choose
    My picker fix could not work: it preserved the picker's own protocol, and the
    picker never has one. It holds no control for it and only reads it to know
    which group a tap joins -- the operator picks on the OUTPUTS screen. On a
    first boot the picker's own value is OFF, so preserving it preserved OFF and
    PICK A PIN still refused every pin.
    Fixed by ownership instead of by repeating the rule. The panel hands the
    picker what the OUTPUTS screen reconciled rather than what came off the wire,
    and the picker's setter goes back to taking what it is given.
    The test walks the sequence main.c performs, which is not itself in this
    suite: pick a protocol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
    [main.c]
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2026-09-09 Tell a protocol off the wire from one somebody chose
    Fixing the empty read-back covered one case of three. A page carries pins,
    and outbind_from_slots() names a protocol from them -- the lowest holding a
    pin, or OFF when none does. There is nowhere on a page to say which protocol
    is being edited, so a protocol that holds no pin yet is not on it, and the
    read-back named something else.
    Empty was only the first boot. A second protocol started while one is bound
    is not on the page either, so a bench wired for an ESC could not then add a
    servo; and editing the higher of two bound protocols was dragged back to the
    lower one at every poll.
    outbind_wire_proto() is what a page of a selection reads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
    [out_bind.c]
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2026-09-09 Keep the release that ends an arming gesture
    The control task forwarded touch events with a non-blocking send to a
    32-entry queue, so a full queue refused the new event. Every other queue
    in the file gives up its oldest entry instead: the GT911's own event
    queue, the command queue and the sample queue each say so in a comment.
    The one carrying touch kept the oldest.
    The last event of a gesture is its release. A release the screen never
    sees leaves it holding a press that is no longer on the glass, and
    ui_hold_tick() completes that hold on the frame timer, so ARM goes out
    with nothing on the panel. The screen also refuses DISARM until a contact
    arrives carrying the same track id, and consume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
    [main.c]
2026-09-09 Report a settings write the store refused
    The store's save member returned void, so no failure could reach the
    model. settings_save() cleared dirty and the standing request whatever
    happened, the screen then read SAVED, and save_offered() drew the button
    inert, so the write could not be tried again without first nudging a
    value. The next boot loaded what was there before.
    Three paths reach it. nvs_open() can fail; an individual nvs_set_i32()
    can fail and was discarded unchecked, committing a set that is part new
    and part old; and a panel whose nvs_flash_init() failed gets a NULL
    store, which settings_save()'s own guard skipped while still clearing
    dirty -- a callback returning a status woul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
    [settings.c, settings.h]
2026-09-09 Refuse a column pass that stopped reading
    scan_columns() left its read loop and finalised column statistics without
    checking reader.failed. The geometry pass and the build pass both check
    it, so a source that stopped during the second pass alone was the one
    case that returned LOG_OK over an incomplete read.
    Everything that pass settles is then wrong and is used downstream. The
    unit is tallied over the surviving rows only and is copied into the
    plotted series, so it outlives the analysis. guess_time_unit() falls back
    to seconds whenever a column parsed fewer than two rows, and read_series
    takes its time scale from that: on a 40 s run logged in milliseconds
    under a bare header, a failure 300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
    [log_csv.c]
2026-09-09 Validate a whole CONTROL write before storing any of it
    control_write() checked and stored each register inside one loop, so a
    write whose later register was refused had already committed the earlier
    ones and answered NACK over the top of them. A frame carries up to four
    registers.
    The case that concealed a state change is CLEAR. A valid CLEAR ahead of a
    refused register ran link_dev_clear_failsafe() and lifted a latched link
    failsafe while the panel was told NACK; link_dev.h says that latch takes
    an explicit clear. Driving encoded frames through the real dispatcher,
    [CLEAR=0x5AFE, MOTOR_POLES=13] against a latched failsafe answered NACK 4
    with the latch gone.
    A write of [ARM=1, THROTTLE=1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
    [main.c]
2026-09-09 Match a write's refusal to the fragment it names
    A write wider than LINK_CAN_REGS_PER_FRAME (4) goes out as several
    fragments at increasing offsets, and the far end refuses whichever
    fragment it will not take. link_host_accept() matched a NACK only against
    the transaction's starting offset, so a refusal naming a later fragment
    was counted as a mismatch. The write-ACK path immediately below already
    matches each fragment's own offset; only the refusal did not.
    The transaction then ran to LINK_HOST_TIMEOUT_MS (1000 ms) and lost the
    reason. That inverts the panel's diagnosis: main.c maps a NACK to
    OUTPUTS_REFUSED, which sends the operator back to the pins they chose,
    and a false return to OUTPU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
    [link_host.c]
2026-09-09 Answer the review on the settings save
    Three findings, all confirmed.
    The screen cached a stale button. settings_save_tick() takes the write
    from the panel's render loop, outside this screen, so a pending write
    completing or being refused moved the button's state with no touch to
    invalidate the cached framebuffers. A refusal went on drawing WHEN IDLE
    until something else repainted. The screen now records the three inputs
    it drew and invalidates when they move.
    A reset that changes nothing is no longer an edit. settings_reset() and
    settings_reset_all() called mark_dirty() unconditionally, so resetting a
    category that already held its defaults retired a standing save failure
    while the values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
    [settings.c]
2026-09-09 Answer the review on the touch queue
    Two findings, both confirmed.
    Evicting the oldest entry could throw away a release. A queued UP reaches
    the head once the MOVEs ahead of it have been drained or evicted, and
    another contact producing MOVEs during the same stalled frame then
    displaced it -- the defect this branch exists to close, one step further
    along.
    A movement is a position and the next one supersedes it: ui_slider's
    by_delta() measures a drag from its own origin, so a MOVE that never
    arrives costs an intermediate frame and no travel. A press and a release
    are the ends of a gesture and are not replaceable. The queue therefore
    gives up its oldest entry only when that entry is a moveme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
    [main.c]
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2026-09-09 Set the telemetry bit on the EDT enable command
    The extended-telemetry enable burst sent DSHOT_CMD_EDT_ENABLE with the
    telemetry bit clear, so all ten command frames went out as 0x01A4. With
    the bit set the word is 0x01B5 -- a different payload and a different
    checksum nibble.
    On a value of 1 to 47 that bit is what marks the frame as a command for
    the BLHeli_S family. Bluejay, the reference extended-telemetry
    implementation for that family, discards a command whose telemetry bit is
    clear and zeroes its repeat counter with it, so ten frames without the
    bit never reach the six repeats its command handler counts. AM32 has no
    such gate and acts on either frame, so the failure is one ESC family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
    [outputs_hw.c]
2026-09-09 Answer the review on the write refusal
    A refusal is now matched to a fragment this transaction sent, not to any
    register inside its window. A 32-register write goes out at offsets 0, 4
    ... 28 and nothing was transmitted between two starts, so a refusal
    naming offset 2 answers some other request; accepting one ended this
    transaction and handed the caller a reason that came from elsewhere.
    link_host.c takes LINK_CAN_REGS_PER_FRAME for the test. The header stays
    transport-agnostic; only the implementation knows the link is CAN, which
    STATUS.md records as a constraint of the design rather than a layer
    waiting to be swapped, and the comments in this file already named the
    constant three times.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
    [link_host.c]
2026-09-09 Make the Ramp limit setting govern the bank it names
    SET_OUT_RAMP was read by no path in the tree. Its only two occurrences
    were the enum member and the schema row; settings_get_int(SET_OUT_RAMP)
    had no callers. The panel's own throttle bank used PANEL_THROTTLE_RAMP, a
    compile-time constant that merely equalled the setting's default, so
    moving `Ramp limit` anywhere in its 5 to 300 %/s range changed nothing at
    either end. Its neighbours on the same screen, Idle pulse and Full pulse,
    reach the wire.
    The bank now takes the setting, and takes it again each time it is
    stepped, so an edit applies without a reboot.
    What that bank is, stated rather than implied: the modelled bench.
    telemetry_sim_s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
    [main.c]
2026-09-09 Answer the review on the pole count
    A refusal is no longer retried. control_write_poles() returns false for a
    write nobody answered and for one the far end refused, and putting the
    debt back in either case meant a coprocessor that answers NACK -- the
    missing-register case link_came_up() names -- took a control write on
    every 50 ms poll for as long as the link stayed up, against an end that
    had already said no. Only an unanswered write is owed again; a refusal
    waits for a new edit or the next link-up edge, and says so once through
    control_alert().
    The debt is paid before the ARM write rather than after it. An operator
    can edit the count while disarmed and arm b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
    [main.c]
2026-09-09 Cancel the gesture when touch events are lost
    Four findings on the eviction policy, all confirmed, and together they
    say the policy was the wrong shape: no choice of which event to drop is
    safe on its own.
    A release that never arrives leaves a screen holding a press. A press
    that never arrives orphans the release after it, and that orphan then
    displaces a valid release. A movement is not spare either -- the movement
    where a finger leaves ARM is what abandons the hold, and the position
    after it is back inside the button. And the render task drains the queue
    from the other core, so inspecting the head decides nothing: the entry
    classified is not necessarily the entry removed, and a consumer t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
    [main.c]
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2026-09-09 Answer the second review on the pole count
    The debt is paid before the write that arms, not only before the next
    poll. service_arming() issues control_write(true, ...) from the 5 ms
    control pass and runs ahead of poll_far_end(), so paying only in
    poll_bench() still let a coprocessor start sampling with the old divisor
    when an edit and an arm arrived between two polls. A debt that cannot be
    paid does not refuse the arm: the count is a conversion rather than an
    interlock, and a bench that will not arm because a setting failed to land
    is the worse failure.
    docs/Link.md and its German counterpart said every write the coprocessor
    does not acknowledge is retried at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
    [main.c]
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2026-09-09 Answer the second review on the touch queue
    Seven findings, all confirmed. Together they say the cancel had the right
    shape and too small a reach.
    The loss count was read before the drain, so an event lost while that loop
    was running went unanswered until the next frame -- and ui_router_tick()
    runs in the same iteration, so a hold already near two seconds completed
    in it. The count is now read after the drain and before the tick.
    The driver's own event queue evicts its oldest for the same reason, and
    that loss reached nothing: the control task then forwarded what remained
    into an empty queue and never counted anything. touch_lost() publishes it
    and the render loop folds it into the same di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
    [main.c, touch.c, touch.h]
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2026-09-09 Answer the fourth review on the touch queue
    The cancellation ran after the drain and not before it. A loss recorded
    before the frame began was therefore answered only once every surviving
    event had been dispatched -- and those events were captured around the one
    that went missing, so a queued movement on a reused track id commands a
    servo position and an orphan release applies a binding change, neither of
    which a later cancel can take back. The count is now read twice: once
    before the drain, and once before the tick, which is the concurrent case
    the previous round added.
    The control task owns its STOP press independently of the screens, and
    nothing cancelled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
    [main.c]
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2026-09-09 Stop the queue's two comments arguing
    The block above the send still said the eviction direction matters more
    here than anywhere else on the panel, which is what the block below it
    was written to replace: no choice of which event to drop is safe, and
    that is why the loss is recorded instead. The first now carries only what
    it takes to fill the queue and points at the second.
    [main.c]
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2026-09-09 Stop the bench when the stream breaks under a held STOP
    Dropping the control task's STOP ownership on a lost event is the wrong
    direction, and it is the same inversion that cancelling a disarm had: for
    every other gesture, abandoning it asks for nothing; for this one,
    abandoning it is the failure.
    Unrelated multi-touch can overflow the driver's queue while a STOP press
    is standing and its own release still survives. That release then
    satisfies neither owner -- this task's press was dropped, and the render
    side cancelled the band's press for the same loss -- so arming_stop() is
    never called and a healthy loop keeps the heartbeat and the outputs
    going. The operator pressed STOP and the bench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
    [main.c]
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2026-09-09 Keep the stop marker while its request is pending
    Clearing it on any loss was right for a request that will never come and
    wrong for one already raised. Cancellation cannot retract a request the
    router latched before the loss, and that request consumes the marker on
    the next pass exactly as it should; clearing it made that pass call
    arming_stop() a second time for one press, advancing the stop generation
    again and cancelling a gesture begun after the real stop.
    The marker is cleared only when no request is standing. What is left is a
    request raised between the load and the store -- a release dispatched in
    the same frame as the loss, ahead of the cancellation that answers it --
    and that reso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
    [main.c]
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2026-09-10 Qualify the review entries and settle the physical throttle ramp
    The CHANGELOG entries say what each fix leaves open: the CHANNELS page
    mirrors the bank at boot and is still zeroed by a failsafe, a refused
    save keeps the keys written before the refusal, and the pre-arm pole
    write leaves a window the next 50 ms poll closes. The motor plot entry
    is back under Fixed.
    The physical throttle is not ramped, by decision. STATUS.md carries it
    under Not planned with the reason: the bank ramps a throttle upward
    only, so a ramp on the wire would slow the rise and nothing else. The
    setting's help line says which bench it governs.
    [settings.c]
2026-09-10 Fill the CHANNELS page from the bank on the failsafe edge
    The failsafe edge disarmed the bank and reset the page to zero, which is
    a surface's low endpoint, so an uncommanded surface rested at centre and
    read back at its stop until something commanded it. The page is filled
    from the bank on that edge as it is at boot: an uncommanded channel reads
    its rest and a commanded one reads its command, with ARM = 0 beside it.
    [main.c]
2026-09-10 Fit the ramp help to its row and state the full-swipe step
    The help line is 26 characters, inside the 36 the row clips at. The
    CHANGELOG and STATUS.md no longer say that no single touch asks for
    0 to 100 %: a drag applies the finger's travel to the whole span, so a
    swipe across the track inside one 50 ms poll is a full step at the pin.
    [settings.c]
2026-09-10 Carry the pole count in the frame that arms
    The write that arms is ARM, THROTTLE and MOTOR_POLES as one three-register
    frame from offset 0 of the CONTROL page, so the coprocessor starts a run on
    the count the panel sent or does not start it. MOTOR_POLES moves to register
    2 and CLEAR to register 3; the protocol is 4.0, and a panel and a coprocessor
    on different sides of the bump keep the link down and do not arm. CLEAR stays
    a write of its own ahead of the arm, because the coprocessor checks ARM
    against its failsafe before it applies a CLEAR from the same frame.
    The CONTROL page's rules move to shared/link/link_control.c, used by the
    coprocessor and by test_link_pages, which holds a three-re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
    [link_control.c, link_control.h, main.c]
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2026-09-10 Cancel every screen on a touch loss and forward its disarm at once
    A loss is observed after the frame's events were dispatched, and one of
    them can have navigated, so the screen holding the press is no longer the
    one on top. The router tells every screen. The DISARM a bench screen
    posts from that cancellation is flushed in the same frame rather than
    behind the render and the flip.
    [main.c]
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2026-09-10 Stamp a command with the loss count its frame last acted on
    A loss between the frame's cancellation and its flush is one no
    cancellation has answered. Stamped with the count at the flush, an arm
    posted the frame before would carry that loss past the control task's
    check; stamped with the count the cancellation last acted on, it fails
    the check and is dropped.
    [main.c]
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2026-10-05 Send the ESC pulse endpoints to throttle channels only, and when they change
    Idle pulse and Full pulse went into every channel the OUTPUTS binding wrote,
    so a servo bound beside a motor took the ESC's range, and an edit reached the
    coprocessor only with the next binding write. outputs_chan_cfg_set_throttle_range()
    gives the two values to throttle channels and leaves the rest as they are;
    outbind_to_chan_cfg() uses it. The panel publishes the pair like the pole
    count and, 300 ms after the last edit while disarmed, reads CHAN_CFG back,
    sets the throttle channels and writes the page only if it changed. The
    binding write takes the published pair instead of reading settings.c on the
    control task.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
    [main.c, out_bind.c]
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2026-10-05 Bring a coprocessor that links up to the pulse endpoints
    The endpoint debt was raised at boot and on edits only, so a coprocessor
    replaced or reflashed after the first payment kept its own CHAN_CFG range.
    link_came_up() raises it as it does the pole count's; the read-back means a
    coprocessor that already agrees costs one read.
    [main.c]
2026-10-05 Look at an unacknowledged arm inside every exchange's wait
    arm_watch_service() ran once a pass, after the snapshot, so a pass that
    applied an arm and then blocked on a backlog of servo exchanges left the
    arm driving through a loss found during them. control_pump() now runs the
    watch too and stops the bench as it does for STOP: the heartbeat drops at
    once and the coprocessor fails safe within 150 ms; service_arming() lets go
    of the rest when the loop is free.
    [main.c]
2026-10-05 Rewrite the endpoints only after the far end took ARM = 0, and hold a new link
    endpoints_service() ran before the poll's control write and trusted the
    bank's own flag, so a disarm whose write never left could see CHAN_CFG
    rewritten under a running motor. It now runs after control_write(), and
    only when that write put ARM = 0 at the far end and was acknowledged.
    A coprocessor that linked up while the bench was armed here was armed in
    the same pass on the range it kept in flash. A link-up now raises
    s_endpoints_hold, which keeps the far end disarmed until the endpoints are
    reconciled; every outcome but a missing answer ends it.
    [main.c]
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2026-10-05 Start a run's totals and peaks when the arming write is accepted
    The coprocessor reset them in sample(), which runs every 20 ms, so the
    panel's first BENCH read after an acknowledged arm could carry the last
    run's totals and flags into the new run's log. control_write() now calls
    bench_new_run() on an accepted ARM 0 -> 1, which resets both and encodes the
    page before the acknowledgement goes out.
    [main.c]
2026-10-05 Carry a run's totals across a change of telemetry source
    The panel shows the coprocessor's totals while the link is up and its
    model's while it is down, and each counts from its own start, so a run that
    lost the link and got it back saw its charge and energy jump back towards
    zero in the middle of one log. bench_carry_t is reset at the arm, taken from
    what is shown just before the other source first writes, and added to every
    update after that; the model restarts its count where it takes over.
    [bench_state.c, main.c]
2026-10-05 Count a run's totals once, on the panel, from what it shows
    The coprocessor's count and the panel model's started and reset at
    different moments, and carrying one across to the other fed stale totals,
    dropped a finished run's and undercounted an outage. bench_totals_t is one
    count on the panel, of the current and voltage it shows from either source,
    over the measured time between samples while the bank is armed; it is shown
    over the source's own fields on every pass and lasts until the next arm.
    The coprocessor, the link page and the protocol are back as they were.
    [bench_state.c, log_writer.c, main.c, telemetry_sim.c]
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2026-10-05 Step the panel's model and the log clock by the time that passed
    Each pass stepped them by a fixed 50 ms, and while the link is down a
    coprocessor identity probe can hold a pass for its 1000 ms timeout, so the
    model, the plot's run and the CSV's time column ran up to twenty times slow
    during an outage. The step is the measured time since the last sample,
    capped at 1 s.
    [main.c]
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2026-10-05 Cut the supply at every stop where it lands, and hold one press at a time
    supply_follow_stops() switches the output off when the stop count moves.
    control_pump() calls it, so a STOP, dead touch or an undone arm cuts the
    output inside an exchange's wait rather than on the next outer pass;
    service_arming() and each supply step call it for the stops counted
    elsewhere. An ON is judged against the stop and OFF counts after the
    pump, so a STOP still in the driver's queue drops it.
    The supply screen ignores a second contact's DOWN while a press is held,
    so a finger on RESET PEAKS or a step button cannot take over an OUTPUT
    OFF press and lose its release. The run's maxima are seeded only from
    readi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
    [main.c, supply.c]
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2026-10-05 Cut an ON in flight at the link-lost screen; log the last interval; defer saves while live
    Opening the link-lost screen, which has no STOP, now counts as an OFF:
    an ON already queued in that frame carries a stale OFF count and is
    dropped, and one already applied is switched off by the flag.
    Switching the supply off writes a final row carrying the last interval's
    charge and energy, so the CSV ends on the totals the screen shows. The
    step clock restarts at a switch-on, so the first step and the run's
    first timestamp count from the ON.
    A settings save, a flash write that stalls both cores, waits while the
    supply's output is on, as it already waits while the bench is armed.
    [main.c]
2026-10-05 Check each CSV cell before the next, reset a disabled trip, plot only what arrived
    A supply CSV row now checks every cell's length before appending the
    next: snprintf answers the length it wanted, and an offset taken from it
    unchecked pointed past the line for values no supply gives. A row that
    does not fit fails the log, as an oversized bench row does.
    A trip turned off forgets the time it had counted, so turning it on
    again starts from nothing. The plot takes a reading only when its flag
    says it arrived; one that did not is drawn at 0 rather than as the last
    value that did.
    [log_writer.c, supply.c]
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2026-10-05 Keep a start value corrected at boot; clear a save request at settings_init
    A start value read back above its cap is brought down to it and now asks
    for a save, so the correction is written once instead of repeated at
    every restart with the overlay stuck at SAVE WAITING. settings_init()
    clears a pending save request along with the dirty flag: what it loads
    is what is kept.
    [settings.c]
2026-10-05 Stop a slider drag running ahead of the finger; settle the remaining review findings
    A drag no longer writes the slider: ui_slider_set() re-anchors a drag on
    the written value while the press point stays put, so snapping the
    slider on every move added the whole distance dragged again each time
    and a short drag ran to the cap. propose() snaps the value it commits
    instead, and the slider takes the set point once the drag is over.
    Leaving the screen under a press on OUTPUT OFF -- a second finger on
    HOME -- sends the OFF. A trip's reading is queued with the output on so
    the plot keeps it. The control task counts an ON taken only after it
    has stored the output live, the render side reads the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
    [main.c, supply.c]
2026-10-05 Plot missing readings as gaps; restart a trip's count when its threshold changes
    The plot keeps a non-finite sample as a gap: left out of the autorange
    and not drawn, so the trace breaks there instead of dropping to a zero
    that reads as a measurement. MOTOR & ESC pushes finite values and draws
    as before.
    A trip's count belongs to the threshold it was made against; a threshold
    changed while the output is on starts the count from the next reading
    over it. The trip alert quotes the threshold the trip was judged
    against. After a trip in a step, the pump writes no second row on top
    of the run's last one.
    [main.c, supply.c]
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2026-10-05 Give SERVO a settings overlay, servo profiles and the supply's live power
    SERVO gains a SETTINGS overlay over its left card with four pages:
    - OUTPUT: type, frame rate, pulse widths, trim, travel, reverse.
    - TEST: curve, speed, range, length, dwell, settle, supply steps,
    brown-out.
    - LIMITS: supply caps, stall threshold, idle, hold and travel limits.
    - DUT: device name (on-screen text keyboard), report.
    Types are STANDARD PWM, NARROW 760, WIDE, HELI CYCLIC and HELI TAIL 760.
    STANDARD PWM keeps at least 1 ms between pulses. A heli type or a rate
    above 60 Hz opens a warning and applies only after a 2 s hold; the tag
    shows the profile in force in red, and every restart is STANDARD PWM at
    50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
    [main.c, settings.c, settings.h]
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2026-10-05 Send the SERVO screen's frame rate to the coprocessor
    The coprocessor runs every PWM surface at the SERVO screen's frame rate.
    SERVO link page (0x29, protocol 4.1):
    - One register: the frame rate, 40 to 560 Hz, for every PWM output whose
    first channel is a surface. 0 means each slot's own rate.
    - One register keeps a write whole. A rate that would leave a PWM slice
    asked for two rates is refused with BAD_VALUE, and nothing changes.
    - The page is not saved, so a restart runs each slot at its binding's
    rate.
    - The PWM driver's ceiling rises from 400 Hz to 560 Hz.
    Panel:
    - Writes the rate with each held position and with a release. A rising
    rate follows the pulse widths and a falling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
    [main.c, out_pwm.c, outputs.c, outputs_hw.c, outputs_hw.h]
2026-10-05 Hold pulse widths back until a slower rate lands; restate the rest
    Rate ordering:
    - A rate going down, or one not known, now leads the pulse widths, and a
    position or release waits until it is acknowledged, unless the pins
    are known to run no faster than it. A refused or unanswered rate
    previously let the wider pulses go out at the old, faster rate.
    - A rising rate is written only once every pulse width has landed.
    Re-sends:
    - The rate is written with every held position rather than once, so a
    coprocessor that restarts between two polls is brought back to the
    screen's rate within one hold and the OUTPUT page stays true.
    Binding writes:
    - A binding is not written while the reset t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
    [main.c]
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2026-10-05 Refuse a page that would split a PWM slice under the SERVO rate
    Coprocessor:
    - While the SERVO page holds a rate, a CHAN_CFG write that turns one of
    two surfaces on a slice into a throttle, or an OUTPUTS write that
    binds an output beside a surface at another rate, is refused with
    BAD_VALUE. Such a write was taken, and the silicon then refused the
    moved slot, leaving it silently unbound.
    - The checks (outputs_chan_cfg_rate_check, outputs_slots_rate_check)
    judge a copy of the bank and are host-tested.
    - outputs_servo_rate_check() replaces outputs_servo_write().
    - A rate going up that gets no answer after its pulse widths landed now
    leaves the release owed, so it is written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
    [main.c]
2026-10-05 Refuse to arm while the SERVO page's rate is unknown
    A panel that restarted while the coprocessor held a heli rate, and whose
    reset to each slot's own rate at link-up went unanswered, could arm the
    surfaces at that rate from any screen, while the SERVO screen showed
    STANDARD PWM. The arm now retries the reset and is refused with "servo
    frame rate not known -- arm again" while it goes unanswered, as it is
    for an unpaid release.
    [main.c]
2026-10-05 Hold a reconnect's arm and settle the rate before paying a release
    Reconnect:
    - A bank armed during a link outage is no longer passed on to the
    coprocessor while the rate the surfaces run at is unknown.
    poll_bench() used to forward ARM once the link came back, even when
    the reset at link-up went unanswered.
    Every pass:
    - servo_service() tries the reset whenever the rate is unknown and a
    release is owed or the bank is armed.
    - It does so before paying the release. A release whose rate the binding
    refused could otherwise stay owed for good, and an owed release blocks
    every arm.
    [main.c]
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2026-10-06 Start a sweep cleanly after a reconnect; end it where it cannot run
    - After a link-up the sweep at the far end is unknown rather than
    assumed running. The next command, a sweep included, writes a stop
    first. That clears a finished sweep the same curve would not restart,
    and a sweep starting then also clears the movement count it would
    otherwise inherit.
    - A sweep that is starting asks whether it was countermanded after
    clearing the movement count, before the write that sets it moving.
    - A coprocessor that can no longer sweep makes the screen post a
    RELEASE, so the panel stops repeating a sweep it cannot run.
    [main.c]
2026-10-06 Start or change a sweep only from all four of its registers
    A write of the SWEEP register alone, or of one curve parameter while a
    sweep ran, rebuilt the curve from what the page held before. That broke
    the one-frame start the page promises. A non-zero sweep is now taken
    only from a write that carries registers 1 to 4, and is refused with
    BAD_VALUE otherwise. SWEEP = 0 alone still stops it.
    [servo_page.c, servo_page.h]
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2026-10-06 Hold a sweep on the coprocessor, and let HOLD countermand at once
    HOLD sent a position the panel had estimated, which only matched the
    output when the panel's model of its slew did: not at 100 % SPEED, nor
    after a SPEED or curve change in flight. The coprocessor now does the
    holding. HOLD no longer depends on the drawn horn, which is an estimate
    without feedback.
    - Coprocessor: SWEEP = 4 (LINK_SV_HOLD), one register, freezes every
    surface where its output is and keeps it there while it is repeated,
    under the sweep's disarm and 500 ms rules.
    - Screen: HOLD posts SERVO_CMD_HOLD, which the panel repeats with each
    hold. Any other command writes SWEEP = 0 first and ends the hold.
    - Counter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
    [main.c, servo_page.c, servo_page.h]
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2026-10-06 Switch the PD mini off ahead of a pending ON and when it stops answering
    - An OFF asked for while an ON is being confirmed reads the state at once
    and switches the output off the moment it reads on.
    - A module that stops answering with its output on is sent an OFF blind
    once a second, only with the argument a read-back showed to mean on.
    - An ON waits until the active slot reads back the set points asked for.
    - Polls are chosen by how late each is, so a slow display read starves
    none of the others.
    - The active slot is re-read every second; a change re-reads its set
    points and writes them back.
    - OUTPUT_DATA is retried 3 times, then flagged as stuck and tried again
    after 2 s; a rea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
    [pdmini.c]
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2026-10-06 Reject replies that cannot be the module's, and never pause an OFF
    - WHO_AM_I must hold "PD Power Mini"; another device is never written.
    - A slot number past 4, or set points for another slot than asked, fail
    the transaction, count as a try at the set points, and leave the slot
    unknown; three tries pause the set points for 2 s, not the readings.
    - An OFF that does not take is written again without the 2 s pause an ON
    waits out; four raise the stuck flag.
    - A set point waiting for its pins is dropped when an OFF is asked for
    while the output is or may be on.
    [pdmini.c]
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2026-10-06 Learn polarity from a write towards on only; drop an ON whose set points change
    - A state read learns OUTPUT_EN's argument only after a write towards on;
    the watch is for a cancelled ON only, not for a pending OFF.
    - An ON waiting for its pins is dropped when the set points read back for
    it are no longer the ones asked.
    - Dropping a queued write no longer underflows a retry counter that
    pdmini_want() has reset.
    [pdmini.c]
2026-10-06 Doubt a learnt argument that stops working, and drop stale set points
    - Four OUTPUT_EN writes that do not take put the learnt argument in doubt
    and both are tried again; the argument is kept across a module going
    quiet and answering again, so a blind OFF still reaches it.
    - A queued OUTPUT_DATA whose set points are no longer the ones asked is
    not sent.
    - READ_INPUT_STATE unanswered 3 times is not asked again until the module
    is identified again; firmware before v1.0.2.0 does not answer it.
    - Describe the PD mini gap in STATUS as the integration still missing.
    [pdmini.c]
2026-10-06 Rely on a learnt argument only after two ONs, and owe an OFF to an unsettled ON
    - OUTPUT_EN's argument is relied on -- for a blind OFF and without trying
    the other -- only once two ONs with it have taken; the module's button
    or AUTO OUT can switch it on in the same moment as a single guess.
    - An ON that went out stays owed an OFF until a state read settles it, so
    a module that took it, missed the OFF and went quiet is sent one blind.
    [pdmini.c]
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2026-10-06 Take the PD mini for gone after three failed state reads
    State reads are counted on their own, so other readings answered no
    longer keep a module online whose output state is not known; three in a
    row take it for gone, and an OFF it is owed is sent blind at once.
    [pdmini.c]
2026-10-06 Refuse a partial ON frame and slots on supply pins; stop the driver after the heartbeat
    - An ON written to the SUPPLY page must carry its set points in the same
    frame; set points alone, or an OFF alone, are still taken.
    - An OUTPUTS write that binds a slot to a pin the supply holds is refused
    rather than stored and left unbound.
    - The page is stepped before the driver, so a heartbeat lost in a pass
    reaches the driver as an OFF before it can send a queued ON.
    [main.c]
2026-10-06 Keep the PD mini's wiring in the coprocessor's flash and switch it off at boot
    - The output store's record (version 4) also keeps SUPPLY's ENABLE to
    BAUD; records of version 3 still load, with the supply disabled, so
    output bindings saved by the build before survive the update.
    - At boot the wiring is driven through the page's own checks with the
    output off, so a module left on before a restart is identified, read
    on and switched off before any panel has written the page.
    [main.c, out_store.c, out_store.h]
2026-10-06 Restore the supply after the outputs' hardware, clamp low set points, and gate saves on it
    - At boot the PD mini's UART is claimed after the outputs are bound, so it
    takes what PIO they leave and never displaces one.
    - Set points under 1000 mV or 50 mA are stored, and read back, at those.
    - After three failed state reads a blind OFF goes only if the last was
    silent; an answer of any kind is re-identified first.
    - Flash saves wait while the supply is asked on or may be on.
    - A wiring write checks the driver's own state, not the flags the pass
    before published.
    [main.c, pdmini.c]
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2026-10-06 Hold an ON until new wiring is saved, keep unbindable slots out, refresh liveness both ways
    - An ON is refused with NOT_ARMED while wiring just written is not yet in
    flash, and one sent in the same frame as new wiring is refused with it.
    - The wiring is restored at boot whether or not it is enabled; a record
    of version 3 restores it disabled at 19200 baud.
    - With the supply's UART open, an OUTPUTS write that leaves a slot the
    bank took unbound is reverted and refused.
    - A wiring write takes the bytes already received first, and sets or
    clears the may-be-on flag from the driver as it stands.
    [main.c, out_store.c]
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2026-10-06 Keep pending wiring detached, check slots against it, and write no set points unasked
    - A failed probe of new wiring leaves wiring still waiting for flash
    detached, as it was.
    - An OUTPUTS write is tried against the UART of wiring waiting to attach,
    and refused if it would leave that UART no PIO block.
    - TX and RX are compared on their own, so a swap is a rewire.
    - Until a command is written the page asks the driver for the output off
    and no set points (pdmini_want_off()), so attaching or restoring the
    wiring leaves the module's set points as they are.
    [main.c, pdmini.c]
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2026-10-06 Hold every attach as maybe on, keep a disabled rollback detached, reset the absent count
    - Every attach of the supply's UART marks the module as of unknown state,
    held as maybe on until read off -- new wiring as well as restored.
    - A rollback to wiring that is disabled and still waiting for flash
    schedules no attach.
    - Any answer to WHO_AM_I starts the count of silent ones again.
    [main.c, pdmini.c]
2026-10-06 Send SUPPLY traffic at control priority; let an OFF alone name no set points
    - link_can_priority() puts the SUPPLY page with CONTROL, LIMITS and
    FAILSAFE, so telemetry cannot hold back the supply's OFF.
    - An OFF written alone neither clamps nor marks set points: the page
    keeps asking the driver for none until set points are written.
    [link_can.c]
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2026-10-06 Drop a supply ON queued before a change to the PD mini's wiring
    Each supply command carries the wiring as published when it was queued;
    an ON whose wiring is no longer current is dropped, so an ON queued before
    an edit on SETUP cannot be applied after the edit was seen.
    [main.c]
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2026-10-06 Wait for a fresh input reading before PD mini set points and ONs
    - The input is read before any set point is written or any ON, also when
    the active slot already holds the voltage asked.
    - A failed input read makes the last reading unknown: set points and ONs
    wait for a fresh one, and the input is asked again once a second, so
    the other readings keep the rest of the line. Firmware that has never
    answered the read is left alone after three misses, as before.
    - The ON's own check is a backstop for the second after an input goes
    stale, before the slot is next re-read; no test isolates it.
    [pdmini.c]
2026-10-06 Read the PD mini's input on time while set points change, and anew per module
    Set points written faster than the readings come round -- a slider
    dragged -- have the input read first once its half second is due, so a
    sagging source caps the next write. A module identified again is asked
    afresh whether it answers the input read.
    [pdmini.c]
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2026-10-06 Add RESET PD MINI to restart a module in ERR
    A set point over the module's input puts it into ERR until it is power
    cycled. SUPPLY's SETTINGS now offers RESET PD MINI while the PD mini is
    the supply: the output goes off, the panel writes SUPPLY register 17
    (protocol 4.4, unreleased) once the page's output is off, and the driver
    sends SYSTEM_RESET once the output reads off, then asks the module who it
    is again about 1 s later.
    [main.c, pdmini.c, supply_link.c]
2026-10-06 Tell the operator when the coprocessor is too old to reset the PD mini
    RESET is a protocol 4.4 register. With an older coprocessor the output
    still goes off and the band says the reset is not available, rather than
    the write being refused unseen.
    [main.c]
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2026-10-06 Add ESC programming profiles, built in and overridable from the card
    72 profiles describe how 451 ESC models are programmed through their
    throttle-stick menus: entry gesture, beep encoding, items, values and
    defaults. They are JSON under shared/esc/profiles/, compiled into C by
    tools/gen_esc_profiles.py (CI runs --check). The panel reads /ESC/*.json
    from the card at start-up; a file replaces the built-in profile with the
    same id or adds a new one, up to 32 files of 64 KiB.
    The JSON reader is bounded (64 KiB, 16 levels, one allocation per
    profile). The host suite parses every profile of record with it and
    compares the result with the generated table field by field, and refuses
    mutated, trunc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
    [esc_json.c, esc_registry.c, main.c]
2026-10-06 Refuse card profiles the generator would refuse, and read long card names
    The card reader and tools/gen_esc_profiles.py now agree on four inputs:
    a key twice in one object, a \u0000 inside a string, a number outside
    the JSON grammar, and NaN or Infinity. Each is refused by both.
    A card file must be named after its id (case aside), as in the
    repository. The panel's FAT driver reads long file names (LFN on the
    heap, 255 characters), so /ESC/<id>.json is found at all; with 8.3 names
    it read back as <ID~1>.JSO and matched no suffix.
    The reader's error formatter is a macro rather than a variadic function,
    which clears clang-tidy's uninitialised va_list report.
    [esc_json.c, esc_registry.c, main.c]
2026-10-06 Show the PD mini's rate in the SUPPLY header, not in the alert band
    With PD mini baud at AUTO the rate found was posted as an alert, which
    fills the red band at the foot of every screen, over the SUPPLY current
    limit, until another alert replaces it. The SUPPLY header now shows the
    rate in use after ONLINE ("ONLINE 38400"), for AUTO and a fixed rate,
    and not for the model or a module that does not answer.
    [main.c]
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2026-10-06 Carry the value-select move, and refuse a card read that failed
    - The 14 two-stage profiles keep the move that stores a value
    (scheme.value_select.throttle), and every profile keeps its select
    window (scheme.select.within_ms, 3000 or 5000 ms in 17 profiles). The
    generator and the card reader read both; EscProfiles lists them.
    - The panel refuses a card profile whose read ended in an error rather
    than parsing the part that arrived.
    - Model names are checked for duplicates after a sort, and applies_to
    finds them by binary search: n log n comparisons, where every pair cost
    up to half a million at 1,000 names. Value numbers are checked against
    a 256-bit set.
    - The generator lifts P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
    [esc_json.c, main.c]
2026-10-06 Clear an alert after 30 s or on a tap
    The red alert band stayed until another alert replaced it, covering ARM
    and the controls beneath. It now clears after 30 s (UI_ALERT_SHOW_S), or
    when a tap presses and lifts on the band, marked x; that tap reaches no
    screen. A lift clears only the alert it was pressed on, and a press on
    the band stays the band's until its release. Clearing invalidates the
    screens so the band's red does not stay in their cached frames.
    ui_router_hold_alert() keeps an alert without expiry or x, for "touch
    did not answer -- the bench will not arm" at start, where nothing can
    tap it away.
    [main.c]
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2026-10-06 Hold the start-up alert only when the touch did not answer
    bring_up() also fails on a protocol mismatch, which has its own passing
    alert; the held "touch did not answer" now follows touch_init() alone,
    and an incomplete bring-up is logged.
    [main.c]
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2026-10-06 Add the automatic servo test and its report
    START TEST on the SERVO screen's TEST page, a 2 s hold on an armed bench,
    runs a state machine in shared/servo/servo_test.c against SUPPLY's set
    points and output and the existing servo commands. It steps the supply
    through 4.8 and 6.0 V, and through 7.4 and 8.4 V with HV SERVO on, which
    is session only and starts only through HV SERVOS ONLY held for 2 s. Each
    step measures idle, moving and holding current and the travel time from
    the supply's current; a brown-out walk from 5.0 V down in 0.2 V steps
    follows. STOP, a disarm, link loss, leaving the screen, taking the servo,
    the supply tripping, going off, going quiet or not taking a set point, and
    1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
    [main.c, servo_report.c, supply.c, supply_link.c]
2026-10-06 Time a servo test move from its own excursion, and walk the brown-out to its floor
    A move's arrival needs, after movement, a reading above the destination
    end's holding level and then one back within 0.05 A of it. Ends whose
    holding levels differ by more than the band no longer end a move on its
    first reading or on a ramp passing the level. An end held harder than the
    servo moves, one pushing on a stop, is reached at the first of two settled
    readings at its level. A host test runs ends held at 0.40 and 0.05 A with a
    1200 ms ramp.
    The brown-out walk takes a floor off the 0.20 V grid as its last step, so
    a 3.3 V floor is run as the report says. The report's HV servo line says
    whether a step a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
    [servo_report.c]
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2026-10-06 Keep a servo test's end, its set points and its report safe
    - Put SUPPLY's set points back from servo_screen_service(), run every frame
    whichever screen is up, only once the run's OFF has been sent, a sample
    taken after it shows the output off, no ON is on its way and OUTPUT ON is
    not held. Set points changed since the run ended are left alone.
    - Look at the set point again as OUTPUT ON's ordinary hold completes: one
    above 6.0 V opens HV SERVOS ONLY and switches nothing on.
    - Reset START TEST's hold when a run starts, so every hold starts a run.
    - Refuse a run whose steps lie outside the caps before HV SERVOS ONLY
    opens, and keep that warning's voltage the run's top step.
    - Compute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
    [main.c]
2026-10-06 Stamp a supply reading when SAMPLES moves, and count readings skipped
    supply_link_state() gives the SUPPLY page's SAMPLES, the coprocessor's
    count of module output readings, with the time of the first page read that
    showed that count. A page read whose SAMPLES stands -- a display read that
    was slow or failed on the coprocessor -- brings no new reading, so a frozen
    current is not measured again and a servo test ends after 1.5 s without
    one. Readings the module took between two page reads are counted on the
    report's Skipped line.
    [servo_report.c, supply_link.c]
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2026-10-07 Say START TEST refusals live, wait for SUPPLY's hold, judge the report alone
    NO STEP CHOSEN, SUPPLY NOT ANSWERING and RANGE TOO SMALL are computed with
    the other refusals, so the line under START TEST follows each edit. The
    restore of SUPPLY's set points also waits while OUTPUT ON is held on SUPPLY
    (supply_screen_output_held()). A failure writing the CSV no longer marks a
    report written whole as bad. Servo.md states that a moving current within
    0.05 A of the destination's holding current cannot be told from arrival.
    [main.c]
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2026-10-07 Light red on a bench's own stop, and keep green dark with the supply off
    Count the stops an operator presses apart from the rest
    (arming_stop_pressed(), arming_pressed_count()): the band's STOP, its
    backstop and a screen's STOP count as pressed; touch silent for 500 ms,
    touch lost under a STOP press or under the arm, and the coprocessor's
    refusal or failsafe do not. The panel passes both counts to the
    PROGRAMMER screen, and a stick run that sees more stops than presses
    ends with BENCH STOPPED, which lights red. A STOP pressed stays STOP and
    dark.
    Keep the green light dark outside ENTRY, ITEMS, VALUES and STORE, and
    drop the detector's group when STORE switches the supply off: a pulse
    held a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
    [esc_stick.c, main.c]
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2026-10-07 Hold a PD mini wiring change for a fresh read, follow edits per write, and cut a sagging input
    - A wiring change while a module has answered is acknowledged and held
    (SUPPLY flag bit 8) until a state read sent after it; that read showing
    the output off takes it, on or failed refuses it (bit 9). The panel waits
    for the read, takes a refusal as refused wiring and says the output may
    be on. An ON is refused while a change is held. Protocol 4.5.
    - The control task follows the PD mini's edit count and wiring word
    straight before every SUPPLY write, so an ON taken before an edit cannot
    reach the page with the old wiring after an earlier write's exchange.
    - A live output whose input rea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
    [main.c, pdmini.c, supply_link.c]
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2026-10-07 Draw a paused sweep from the phase the coprocessor kept
    The screen took the paused phase at the tap, but the coprocessor runs its
    curve on until the HOLD reaches it, so a resumed horn stayed behind by the
    HOLD's latency, visible at 5 Hz. The panel reports when the HOLD that paused
    a running sweep was acknowledged (servo_screen_sweep_held()), and the screen
    sets the paused phase from that moment, timed as a start is timed, so the
    two errors cancel. The event is taken before a resume's in the same frame.
    [main.c]
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2026-10-07 Judge every SERVO page write against the page a pass would leave
    A finite sweep past its last movement, with a HOLD served before the pass
    that ends it, was still running: the HOLD kept its phase, skipped the pass
    that commands the surfaces to the centre, and RESUME was acknowledged for a
    sweep that had ended. Each write now runs the page's pass at its own time
    first, so a sweep that has run out -- past its last movement, unwritten
    for 500 ms or disarmed -- has ended whichever of the write and the pass the
    coprocessor serves first; this replaces the timeout check of the last fix.
    A HOLD of a sweep that has made its movements keeps the centre it ended on
    rather than freezing the surfaces shor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
    [servo_page.c, servo_page.h]
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2026-10-07 Draw a sweep only as the coprocessor is known to run it
    Between a sweep-button tap and its acknowledgement the screen drew what the
    tap asked for, not what the coprocessor did. It now draws what the
    coprocessor is known to do and corrects to the acknowledgement:
    - A start, a resume or a changed curve is not drawn until acknowledged; a
    resumed horn stays held, a changed curve draws the old one on. The
    acknowledgement times the curve and, without feedback, works the output
    on from where it was when the coprocessor began, at SPEED. The RESUME's
    acknowledgement time reaches the screen for that.
    - A PAUSE draws the curve on at the tap's SPEED until the HOLD is
    acknowledged, for at most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
    [main.c]
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2026-10-07 Show manual steps in German
    A manual step carries its German in action_de, 1-120 bytes of UTF-8 with
    umlauts allowed, absent or null for none; the generator and the card
    reader apply the same rule, with parity tests. The pop-up, the warning,
    the prompt and the result show it when the interface is German and fall
    back to the English action.
    All 24 profiles' steps have their German: short, imperative, Jumper and
    ESC as the field writes them. The German goldens show it.
    [esc_json.c]
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2026-10-07 Never say a sweep or hold again that the screen has ended
    - A sweep refused for want of a bound surface is no longer kept as the
    held command, which a reconnect to a binding with a surface would have
    swept with no tap.
    - A sweep or a hold ends with the link at the control task as well: the
    held one is dropped at the link-down edge, one drained while the link is
    down is not kept, and the screen drops one not yet taken. None is said
    again when the link comes back (servo_cmd_survives_link_loss()).
    - A refused sweep leaves nothing driven, so a change of profile after it
    says no position.
    - A HOLD acknowledged after an early PAUSED keeps the servo's reading for
    the resume, so feedba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
    [main.c]
2026-10-07 Hold the stick run's set points to the ESC's ratings
    VOLTAGE was held only to the SUPPLY cap, so an 8.4 V FlyFun-6A could be
    programmed at 20 V. The row, the page and RUN -- the last check before
    the run arms -- now refuse a voltage over the model's v_max_mv or under
    its v_min_mv, a VOLTAGE set by hand for a model that states no voltage
    rating, VOLTAGE 0 for one that states neither a rating nor a cell count
    (another model's cell count would stand in), and a CURRENT LIMIT over
    its current_a, each with both figures.
    Models carry v_min_mv from the JSON, in the generator and the card
    reader alike. dualsky-xcontroller and kontronik-beat-car, whose one
    model states neither, no longer open, and at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
    [esc_json.c, esc_stick.c]
2026-10-07 Drop every command of a let-go pause, and keep a resume through an undone pair
    - Each servo command now carries the pause it was asked during. Once the
    panel has let a pause go, a POSITION said again under a changed profile
    is dropped as well as a resume (servo_cmd_stale()), so the surfaces stay
    at the rest the screen shows and the owed release is paid.
    - The record of a let-go pause retires with the first drive command from
    after it, so a pause number reused after 65535 more is not mistaken for
    it; pause numbers skip 0, which means no pause.
    - A resume that falls back to a start (older coprocessor, refused, or an
    unanswered HOLD) is used up there, so its repeats publish no resum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
    [main.c]
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2026-10-07 Leave an unsure selection out of the made totals
    A selection cut short while the ESC stored or confirmed it is marked
    UNSURE on its row, but the count above and the line for the changes
    past the fourth still counted it as made. Both now leave it out, and
    that line names it: AND 2 MORE, 1 OF THEM MADE, 1 UNSURE. An
    interrupted 1-of-1 run says 0 of 1.
    [esc_stick.c]
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2026-10-07 Stop a panel build whose sdkconfig keeps the 3584-byte main task stack
    ESP-IDF reads sdkconfig.defaults only when it creates sdkconfig, so an
    existing checkout's sdkconfig keeps the old value. main.c now fails to
    compile below 8192 bytes and names the fix.
    [main.c]
2026-10-07 Detect servo movement against a per-step noise threshold
    Movement in the automatic servo test is a reading more than
    max(0.020 A, 3 x the idle readings' standard deviation) from the level
    before the command, per step and in the brown-out walk, instead of a fixed
    0.10 A. Arrival stays the first reading back within 0.05 A of the holding
    level after one a threshold above it.
    A counted move with no movement in 3000 ms is unseen: not timed and not
    late. A step with no move seen reads NOT MEASURABLE, and a run with unseen
    moves and no limit exceeded reads NOT MEASURABLE with the count of unseen
    moves, in English and German.
    The run is told what reads the current (servo_test_meter_t). The PD mini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
    [servo-1102hb.csv, servo-mg90s.csv]
2026-10-07 Give the servo test's window the meter's lag and report unmeasured runs
    A move is late when it has not arrived 3000 ms plus the meter's lag after
    its command: 3300 ms on the PD mini, whose readings show an arrival about
    300 ms after it happens. A servo arriving at 2900 ms is timed; one that
    never arrives is still late.
    A brown-out walk that sees no movement at its first voltage makes the run
    NOT MEASURABLE, so a run of the walk alone that sees nothing no longer
    reads PASS.
    With no move arrived the report's travel time line reads "longest --" and
    "not measured, no move arrived" on every meter, in English and German,
    instead of an upper bound of 0 ms.
    [servo_report.c]
2026-10-07 Reserve the module pins the header does not offer
    The coprocessor bound an output or the PD mini UART to GP23 (the power
    converter's MODE pin), GP24 (VBUS sense), GP25 (LED1) and GP29 (VSYS
    sense). It also accepted GP30 to GP47 when the SDK board file declares an
    RP2350B, which the default image does.
    outbind_reserved_mask() now reserves every pin the board catalogue does
    not list as free, so the mask no longer depends on the SDK board file.
    The OUTPUTS and SUPPLY pages both read it through the output bank.
    IOMCU_ABSENT_PINS is removed.
    [iomcu_pins.h, main.c, out_bind.c]
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2026-10-07 Add the SENSE and SERVO_SENSE link pages, protocol 4.7
    SENSE (0x2B) sets up one I2C bus on two coprocessor pins for an INA228
    in the ESC's power path and an INA3221 on the servo rail, in three frames
    of four registers: the bus (enable, SDA, SCL, 100 or 400 kHz), the INA228
    (address, shunt in uOhm, range in 0.1 A, reserved register 7) and the
    INA3221 (address, shunt in 0.1 mOhm, channels, reserved register 11).
    Registers 12 to 25 carry flags, the address scan, the IDs, the error
    count, die temperature, DIAG_ALRT, charge and energy, and the ESC's own
    telemetry. SERVO_SENSE (0x2C) carries each INA3221 channel's 50 ms window
    with valid and clipped bits, and a move capture.
    The coprocessor valid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
    [main.c, out_store.c, out_store.h, out_store_rec.c]
2026-10-07 Name the brown-out voltage that made a servo test not measurable
    A run that reads NOT MEASURABLE only because the brown-out walk saw no
    movement at its first voltage now says so on its result line ("no
    movement seen at 5.00 V, the brown-out walk's first voltage") instead of
    "0 of 0 counted moves". A "Brown-out start" line under the limits gives
    that voltage with PASS or NOT MEASURABLE, in English and German.
    [servo_report.c]
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2026-10-07 Judge servo moves sample by sample and schedule the sensor bus reads
    shared/servo/servo_move.c holds the servo test's move rules as a state
    machine fed one sample at a time: the threshold from the idle noise,
    movement, arrival, arrival settled at an end held harder than the servo
    moves, late, unseen, and the window with the meter's lag. It takes an
    optional moving-mean filter and clipped samples, which decide only what
    their bound decides. servo_test.c feeds it the supply's readings; its CSV
    rows and reports are unchanged.
    shared/sense/sense_sched.c is the coprocessor's sampling schedule as pure
    logic over sense_i2c_t and a clock callback. Per 1 ms tick: INA3221 CH1
    at 1000 Hz, CH2 and C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
    [servo_move.c, servo_move.h]
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2026-10-07 Fit the sensor schedule to the bus clock and hold the capture to CH1
    The schedule takes the bus clock, 100 or 400 kHz, and refuses any other.
    At 400 kHz the rates stay as they were. At 100 kHz a tick makes one
    read: CH1 at 250 Hz, the INA228's current and voltage at 125 Hz each, the
    rest at 50 Hz. The synchronised pair's fast rate is refused there,
    since it would need 1400 reads a second. The capture times in 1 ms steps
    at 400 kHz and 4 ms at 100 kHz. Its lag counts the filter's 3 samples:
    5 ms and 17 ms.
    The run's totals end at the first failed INA228 transaction after the
    clear. A failed VBUS read leaves the next current without a power. The
    windows count milliseconds in 64 bits and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
    [servo_move.c, servo_move.h]
2026-10-07 Run the sensor bus at 400 kHz only
    The schedule drops its 100 kHz layout: the bus runs at 400 kHz, CH1 at
    1000 Hz, the INA228's current and voltage at 500 Hz each, the pair at
    1000 Hz when on, the rest at 50 Hz. The capture times in 1 ms steps
    with a 5 ms lag. SENSE's KHZ register takes 400 and refuses any other
    value with BAD_VALUE (LINK_SN_KHZ_BUS). Link.md and Link-de.md state
    the clock, why 100 kHz does not fit, and the pull-up limits of the two
    modules.
    The schedule rolls its window again after a recovery, a probe or the
    totals' clear, so a sample read after one that crosses a window's end
    is the next window's. A move's peak starts from its first valued
    sample, so samples all below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
    [servo_move.c]
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2026-10-08 Read the INA228 and INA3221 on the coprocessor's core 1
    Core 1 runs the current monitors' I2C bus on a 1 ms tick and nothing
    else; core 0 keeps the link, the outputs and the flash store, and its
    pass gains a few compares.
    - sense_svc (shared/sense): core 1's step. It opens and closes the bus
    on core 0's set-up and starts each run, capture and edge once per
    generation. It ticks the schedule, scans 0x40 to 0x4F for PRESENT
    while a part is missing, and builds the snapshot. An arm with nothing
    to read ends lost and counts in CAP_SEQ. Host-tested in test_sense_svc.
    - sense_sched: a capture armed with SENSE_CAP_RISE_AUTO takes the level
    before the command from CH1's 50 ms before the edg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
    [main.c, out_pwm.c, out_pwm.h, out_store.c, out_store.h, outputs_hw.c, outputs_hw.h, sense_core1.c]
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2026-10-08 Clear stale readings, let the scan mark the bus stuck, gate the store
    - A SENSE set-up taken clears every register core 1 fills: FLAGS,
    PRESENT, the IDs, ERRORS, the readings, the windows and a finished
    capture's result. No read shows a part online, or a value of the old
    shunt or address, before a snapshot of the new set-up arrives. The
    ESC's telemetry and CAP_SEQ stay.
    - The address scan hands every answer to sense_bus (sense_bus_note()).
    A held line, or two timeouts in a row, mark the bus stuck and end the
    scan, so the recovery runs at the next tick with the parts offline. A
    NACK is an empty address and counts no error.
    - A boot whose core 1 does not register for the flash lo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
    [main.c, out_store.c, out_store.h, sense_core1.h]
2026-10-08 Open boot windows directly, bound captures, refuse held pins
    - The flash store opens a window by where core 1 stands. Before core 1 is
    launched it disables interrupts and erases or programs directly. Once
    core 1 has registered, it goes through flash_safe_execute(). If core 1
    was launched and did not register, the store is off and nothing opens.
    The boot's reclaims no longer depend on
    PICO_MULTICORE_LOCKOUT_BEFORE_CORE1_STARTED; without it, pico-sdk
    2.3.0 reaches the assert at flash.c:189-190.
    - A new set-up resets the refused-arm state and takes the capture and run
    generations before the bus is closed or fails to open, so a stale LOST
    no longer overwrites the idle state the p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
    [main.c, out_store.c, out_store.h]
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2026-10-08 Keep a negative charge total through a poll without a SENSE read
    BENCH's charge register holds no negative value and reads 0 for a run
    that gave back more than it took. A poll with TOTALS_OK and no fresh
    SENSE read replaced the signed total with that 0, and the next read
    dropped it back. Treat a coarse 0 as the register's floor while the count
    is below it, as the ceiling is treated above 65535 mAh. Hold the count
    only against the bound itself, so a finer figure beyond either bound is
    taken up or down. Energy has no floor: the INA228 accumulates unsigned
    power.
    [bench_state.c]
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2026-10-08 Drop superseded set-up alerts and keep measured peaks shown
    An edit of the sensor set-up drops the waiting events raised for the
    request it replaces -- unset pins, one address, the refusals, and a
    missing page once no part is enabled -- before raising what still holds
    of the new one, so a fixed address or a corrected shunt is not reported
    after the fact.
    MOTOR & ESC tracks per channel whether a valid reading has arrived since
    the run started or the peaks were reset, and draws a peak by that rather
    than by the live flag: a source that stops answering mid-run empties the
    live reading and keeps the run's peaks it measured, which stay shown.
    [sense_link.c]
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2026-10-08 Say every clipped channel, keep event details, leave the model out
    Queue each INA3221 channel that clips in a window and hand them out one
    turn of the alert band each, so a synchronised pair clipping together is
    said for both channels.
    Keep the ID a wrong-identity event and the address a not-answering event
    were raised with, and print those, and drop either event when the part
    answers as itself before the band shows it.
    Leave the panel's modelled numbers out of the ESC's figures: with the
    link down mid-run the esc current column is empty rather than the
    model's current.
    [bench_state.c, main.c, sense_link.c]
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2026-10-08 Put a sensor alert back when another replaces it unseen
    The alert slot holds one alert, and a later one in the same pass -- a
    NACKed control write's "coprocessor disarmed", say -- replaced a sensor
    alert whose event was already taken and would not be raised again.
    Number every alert posted and record the number of the one a frame took.
    Take a sensor event only into a free slot, follow it until a frame has
    taken it, and put it back with what it was raised with when another
    alert replaced it first (sense_link_event_back()). Other alerts keep the
    band's rule that the newest replaces the one before.
    [main.c, sense_link.c]
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2026-10-08 Set up and read the phase tap from the panel
    SETUP INTERFACES gains seven rows for the tap: enable, pin (default GP22),
    lowest and highest tone, pitch split, gap and minimum periods, with the
    ranges and defaults of the TONE page (protocol 4.8) and German labels.
    The tone_link service writes the set-up to the TONE page in two frames,
    500 ms after the last edit and only what differs from what the page holds,
    the frame that leaves the page a valid set-up first. While the page holds
    the tap on it reads registers 8 to 23 every 50 ms and takes the beeps one by
    one by number across the wrap from 65535 to 1. A lost reply loses no beep;
    beeps the 64-entry ring moved past are counted as missed. A cop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
    [main.c, settings.c, settings.h, tone_link.c]
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2026-10-08 Refuse an OUTPUTS write the silicon cannot bind
    An OUTPUTS write with a slot the hardware leaves unbound for any reason,
    such as a PIO state machine, instruction memory or DMA channel held by the
    running phase tap, is refused with BAD_VALUE. The previous slots are
    restored and nothing is saved. Only the slots the write changed and the
    ones it unbound are judged.
    outputs_slots_changed() and outputs_bind_check() decide it in shared/ with
    a host test. The boot order is unchanged: the outputs bind first and a tap
    that no longer fits is refused, which TONE flag bit 1 reports.
    [main.c]
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2026-10-08 Say an overrun once per capture and drop the always-zero lows readout
    An acknowledged write clears the told-flags only when it restarts the
    capture, so an edit of the range, split, gap or minimum periods does not
    repeat an overrun the coprocessor still holds. The run page no longer shows
    the lows-ignored count, which the 8 us hold-off keeps at 0.
    [tone_link.c]
2026-10-08 Discard the pass after a FIFO overflow too, read the flag before the pointer
    The FIFO's older words can reach the ring after the stall pass's
    boundary, beside words from after the hole; the next pass is discarded
    as well, and core 1 reads RXSTALL before the DMA write pointer so that
    boundary lies after the flag was cleared.
    [tone_core1.c]
2026-10-08 Keep the beep cursor across a capture restart, guard a pending supply attach
    A panel that knows its place keeps it when the capture restarts, so a
    beep that comes before the next status is read; one without a place
    asks the ring's span back from the head and counts none of it missed.
    A tap start that would take the PIO room a supply waiting for flash
    attaches into is refused.
    [main.c, tone_link.c]
2026-10-08 Refuse a tap rewire core 1 did not acknowledge, restore the exact bound set
    A quiesce that times out leaves the capture running as it was and the
    set-up refused; a refused OUTPUTS write rebinds only the slots bound
    before it; a core 1 that fails to start leaves a saved tap refused with
    its capture let go.
    [main.c, outputs_hw.c, outputs_hw.h, tone_core1.c, tone_core1.h]
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2026-10-09 Read the DMA position through a pause, refuse tap starts without core 1, keep a busy trial capture's pin
    A pass core 1 began before a pause finishes against the channel's real
    write position; once core 1 has failed to start, every later capture
    start is refused; a rollback that finds core 1 busy leaves the trial
    capture running and the page showing it, its pin reserved.
    [main.c]
2026-10-09 Add a setting that lets one finger pan the zoomed log plot
    SETUP -> APPLICATION gains One finger pans (Ein Finger schiebt), off by
    default. While it is on and the plot is zoomed in, a finger that moves more
    than 10 px (PV_PAN_SLOP) from its touch-down point pans the view, and the
    cursor stays where it was. A shorter touch selects a value as before. With
    the setting off, or with the whole run in view, one finger moves the cursor.
    [settings.c, settings.h]
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2026-10-09 Add an AS5600 output encoder to the servo test (protocol 4.9)
    An AS5600 magnetic angle sensor on a servo's output shaft sits at 0x36 on
    the sensor bus the INA parts use. SENSE gains ENABLE bit 2 and registers 26
    to 31: flags, RAW ANGLE, MAGNITUDE, an angle sample count and the time the
    angle has stayed within 12 counts (1.05 degrees) of an anchor.
    The coprocessor reads STATUS with RAW ANGLE at 500 Hz on the schedule's ticks
    without a rotation item and AGC with MAGNITUDE at 20 Hz, and keeps the still
    time at the 2 ms sample interval. The panel writes bit 2 and reads registers
    26 to 31 only from a coprocessor that names 4.9, and alerts for an older
    one, for no answer at 0x36 and for a missing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
    [main.c, sense_link.c, servo_report.c, settings.c, settings.h]
2026-10-09 Keep the knob from replacing other commands, and sequence it after the touch drains
    The knob's motion is taken at the start of the frame with the screen it was
    turned on and applied after the second touch drain and the tick, so a
    navigation or a touch loss in the frame drops it. MOTOR and SERVO post a knob
    motion only into an empty slot or over a throttle or position; a pending arm,
    disarm, release or peak reset stays. The AS5600 is registered on the I2C bus
    once, before the control task starts, and the poll backs off to 100 ms on any
    unusable reading.
    [knob_task.c, knob_task.h, main.c]
2026-10-09 Read the knob sensor register by register and drop a turn whenever touch owned the frame
    The AS5600 suppresses the address pointer's auto-increment for RAW ANGLE and
    MAGNITUDE, so STATUS, RAW ANGLE and MAGNITUDE are read as three transactions.
    The knob's turn is dropped when the router navigated at any point in the frame
    (a navigation count replaces the start/end route comparison), and when a finger
    owned the throttle slider or the servo dial at any point in the frame, also
    after it lifted. A knob command that waits for the next frame is withdrawn,
    with the slider restored, when that frame finds a touch loss before it is
    sent.
    [knob.c, knob_task.c, main.c]
2026-10-09 Read the encoder register by register, match angles by time, keep the magnet event
    The magnet event is bit 16 of the event word. A status read that finds a
    current monitor answering clears that monitor's events with a 32-bit mask,
    so a magnet event waiting for the alert slot stays queued.
    The encoder reads RAW ANGLE in every 2 ms slot, 500 Hz. STATUS, RAW ANGLE,
    AGC and MAGNITUDE are separate register transactions; one slot in 25 reads
    RAW ANGLE, AGC and MAGNITUDE and skips STATUS. Worst odd tick with the
    pair is 840 us.
    A log row takes the newest encoder reading taken at or before the row, from
    the last 16 readings, with a signed age. The settle is logged on the first
    row at or after the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
    [main.c, sense_link.c]
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2026-10-09 Judge the magnet from a read angle, keep the encoder with equal INA addresses, read the angle in the commanded direction
    The panel raises the magnet event only when the coprocessor reports a
    read angle (ENC_VALID), so a zero STATUS right after enabling is not
    "no magnet". Equal addresses of the two current monitors clear only
    their enable bits and the both-off write keeps the encoder's bit. With
    REVERSE on, the measured angle is negated like the commanded one on the
    screen, in the report and in the CSV.
    [sense_link.c]
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2026-10-09 Latch the coprocessor's arm at a start and on a distrusted heartbeat, stop the panel with the link
    The coprocessor holds an arm latch beside the link failsafe. link_dev_init()
    sets it, the silence edge sets it, the edge where the heartbeat stops being
    trusted sets it and a refused ARM sets it; only CLEAR releases it. A
    coprocessor that restarts under an armed panel therefore refuses the ARM = 1
    the panel writes at every poll, and a heartbeat glitch no longer ends with
    the bank armed again once the line is trusted. The supply's ON and the
    STATUS page keep reading the failsafe and the heartbeat, so a start reports
    no fault and takes a supply ON before the first arm. No register or frame
    change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
    [link_dev.c, main.c]
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2026-10-09 Stop the panel when an exchange of the arm gets no answer
    The servo release, the rate, CLEAR and the frame that arms each end an arm when they fail. One the far end refused leaves the panel disarmed, as before. One nobody answered waited out the 1000 ms timeout or never reached the wire: the link went quiet under the arm, the far end may hold a frame whose acknowledgement was lost, and the poll that later finds the link down has no arm left to stop. arming_write_failed() makes that a stop with the heartbeat withheld; the panel tells the two apart by counting exchanges that ended unanswered across the arm. test_safety_gate sweeps the reset at 1 ms across the CLEAR and the arming frame.
    [main.c]
2026-10-09 Fail a poll whose keep-alive write gets no answer, use no trusted report past the arm's bound
    A poll whose read of the bench page is answered and whose write of ARM and THROTTLE is not has failed: poll_bench() returns false, so the link-down edge runs on that pass and stops an armed bench instead of leaving the bank armed and the heartbeat running until the next poll times out 1000 ms later.
    arming_step() takes the far end's word on the heartbeat up to the bound and gives the arm up past it whatever was reported: the question is an exchange that can come back up to 1000 ms later, and a late yes armed the bench that much after the hold. A pass with no far end says so with arming_line_nobody(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
    [main.c]
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2026-10-09 Stop an armed bench where an exchange ends unanswered
    exchange() latches the stop itself when it ends with no answer while the link is up and the bench is armed or an arm is waiting: bank off, throttle zero, servo let go, heartbeat withheld. The stop no longer depends on which service sent the exchange or on what the same pass sends after it, each of which can wait out a further 1000 ms before poll_far_end() takes the link down. With the link down nothing is stopped there: the identity probe of a bench armed without a coprocessor goes unanswered once a second.
    test_safety_gate adds the 100 ms servo refresh to the model and requires the stop in the millisecond the first unanswered exchange e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
    [main.c]
2026-10-09 Judge every unanswered exchange in one place, take the link down on that alone
    exchange() is the one way a request reaches the far end, and exchange_unanswered() the one way it ends without an answer. It asks arming_exchange_unanswered(): link down, nothing; link up and disarmed, the link is gone; link up and armed or arming, the link is gone and the stop is latched there. A link that is gone sets s_link_quiet, after which exchange() sends nothing and answers false at once, and poll_far_end() takes the link down on that latch and on nothing else, ahead of its 50 ms gate. No caller reports a missing answer and none can leave it out: poll_bench()'s checks after each of its exchanges are gone,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
    [main.c]
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2026-10-09 Write a binding one frame per exchange and take it whole, keep an unread one
    Link: link_write_acked() sends a write of any width one frame per exchange,
    each acknowledged before the next, and the panel's write_regs() goes
    through it. The coprocessor's controller buffers 2 frames; 8 frames back to
    back lose 6 to one 20 ms loop pass, one frame at a time loses none.
    Protocol 4.10 adds BIND_CFG (0x2E), BIND_OUT (0x2F) and BIND (0x30): the
    panel prepares both output pages and one commit carrying their CRC-16 puts
    both in force or neither. A frame lost at any of the 18 positions leaves
    the binding in force and in flash as it was. A coprocessor older than 4.10
    is written entry by entry.
    Panel: a r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
    [bind_link.c, link_port.c, main.c, out_stage.c]
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2026-10-09 Run the safety loop between the frames of every wide write
    link_port_t gains `between`, called after each acknowledged frame of a
    write that has another frame to send. The panel pumps its control loop
    there once 5 ms have passed, for every write wider than one frame: a
    binding, the CHAN_CFG page endpoints_service() writes, a CHANNELS write of
    more than 4 channels. A page of 8 exchanges answered at once no longer
    keeps STOP and the heartbeat waiting for all 8. A write of one frame is
    unchanged. The binding's own port is removed; stack_check.py follows the
    one port's three callbacks.
    [link_port.c, main.c]
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2026-10-09 Derive Sensor SCL from Sensor SDA and mark a set-up the coprocessor does not hold
    Sensor SDA on SETUP > INTERFACES takes -1 and the SDA pins of an I2C
    block's pair that the RP2350-CAN brings out and does not reserve: 0, 4, 6,
    14, 16, 18, 20 and 26. Its keys step from one to the next and stop at both
    ends. Sensor SCL is the GPIO after it, shown without keys. One stray step
    of SDA no longer leaves a pair the coprocessor refuses.
    The pair rule is one function, link_sn_pins_pair(), used by the SENSE page,
    the coprocessor's bus, the panel's retry and the setting. A stored sns_scl
    is not read; a stored Sensor SDA outside the valid set loads as 16.
    A row whose value the coprocessor's page does no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
    [main.c, sense_i2c.c, sense_link.c, settings.c, settings.h, tone_link.c]
2026-10-10 Keep CH1's last four windows on a page and find a part that reset itself
    The coprocessor's schedule keeps INA3221 CH1's last 4 complete 50 ms
    windows, newest first, and the new read-only page SERVO_WIN (0x31) serves
    them: mean, highest and lowest current, mean and lowest bus voltage, and
    flags per window, with the capture's state and count in the header. A
    window number the tick skipped reads not closed. A clipped sample counts
    at the end of the range and is counted; SERVO_SENSE's figures are
    unchanged.
    The schedule reads the INA228's ADC_CONFIG and the INA3221's Configuration
    back every 40 ms, in the slots of DIETEMP and Mask/Enable on every second
    pass. A value other than the one written,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
    [main.c]
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2026-10-10 Take every INA3221 CH1 window once from SERVO_WIN and name the servo rail's meter
    On a 4.11 coprocessor with INA3221 CH1 enabled, sense_link reads SERVO_WIN
    registers 0 to 15 every poll and the whole page once 100 ms have passed
    since a read last left no window owed. Each window number is handed over
    once, oldest first. Numbers that left the 4-window ring are counted. A
    lost reply moves nothing, the first read after a link-up starts after the
    newest number, and a ring that started again hands over every closed
    entry. The status read goes to register 31 for RESETS. A coprocessor older
    than 4.11 is sent nothing on SERVO_WIN and keeps SERVO_SENSE's last
    window per read.
    The bench log writes on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
    [bench_state.c, log_cadence.c, main.c, sense_link.c, servo_source.c, servo_source.h]
2026-10-10 Leave a quantity a window holds no sample of out of the log, and check the window queue
    A CH1 window from SERVO_WIN that closed with current samples and no
    voltage sample, or the other way round, writes the cells it has: the
    quantity it lacks reads 0 on the page and is an empty cell in the bench
    log, not a 0. bench_state carries the two masks; a channel read from
    SERVO_SENSE keeps both clear.
    The panel's start-up fails with ESP_ERR_NO_MEM when the window queue
    cannot be created, as for its other queues.
    A window number that a read finds standing for 500 ms stays stale until it
    moves, so it does not read as fresh when the 2^32 ms tick comes round.
    The status read goes to register 31 only wh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
    [bench_state.c, log_writer.c, main.c, sense_link.c]
2026-10-10 Show the servo rail's meter in the SERVO screen's CURRENT row, line and plot
    The CURRENT row, the line over the power plot and the plot show the reading of the meter the panel names: CH1's 50 ms windows under the name INA3221 CH1 while the INA3221 is the meter, the supply's samples under SUPPLY otherwise. The row no longer reads servo_screen_feedback()'s current.
    A current is signed and drawn in hundredths of an amp. A window with a sample at an end of the range draws its mean in the warning colour. A reading that did not arrive is dashes and a gap in the plot, and a link that goes down takes the INA3221's last window with it. The plot is emptied when the INA3221 becomes or stops being the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
    [main.c]
2026-10-10 Hand each window over with the meter of its poll, and fit the widest readings on the line
    servo_source.c counts the changes of the meter. The panel queues each INA3221 window with the meter and that count as decided in the poll that took it, and the SERVO screen keeps of two answers the one with the later count: a window taken under a meter replaced since is dropped, and one ahead of the snapshot brings its meter with it. The plot holds the windows taken while the INA3221 was the meter and no others, with the render task up to 8 windows behind.
    Beside INA3221 CH1 the three readings are 60, 64 and 56 px wide, so -32.77 A keeps its sign, and a power wider than 7 characters in tenths is drawn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
    [main.c, servo_source.c, servo_source.h]
2026-10-10 Hand each supply sample over with the meter of its poll
    The panel queues each supply sample with the servo rail's meter and its change count as decided when the sample was queued. A sample taken under a meter replaced since is the supply's last reading on the SERVO screen's line and in its CURRENT row and no point of the plot; one ahead of the snapshot brings its meter with it. The automatic test reads every sample.
    [main.c]
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2026-10-10 Give each window of a read its own time, and tell a servo test's start and end where they happen
    A read of SERVO_WIN that brings several windows stamps each with the
    latest it can have closed: the read's tick, less 50 ms for each window
    after it in that read. The servo test took the windows of one read as
    ending at the same instant, so their CSV rows shared a time, a hold lost
    the windows that arrived with the one that showed the arrival, and the
    1000 ms over STALL AT did not advance inside a read.
    The SERVO screen calls a function the panel registers when a run starts
    and when it ends, inside the call that does it. The bench log's flag was
    stored once per frame, so a bench row could be w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
    [main.c, sense_link.c]
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2026-10-10 Tighten the checks CI and the tools run, add a mutation tool and tests for the tools
    coverage.py fails on a C file under shared/ that is in neither TRACKED nor
    DATA_ONLY, that the suite does not compile, or that no test links, and
    writes the total into README.md and README-de.md; --check fails when
    either differs from the measurement.
    check_sanitizers.py holds every compile command of the sanitizer build to
    -fsanitize=address,undefined -fno-sanitize-recover=all
    -fno-omit-frame-pointer and no other flag of that family.
    check_docs.py holds the protocol version, the heartbeat and link timings,
    the heartbeat and CAN pins, the coverage floors and the stack margin the
    pages state to their consta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
    [outputs_hw.c]
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2026-10-10 Say where a slewed command ended, and replay no move the trace lost part of
    A slewed command changes the pulse in every pass, and its $C line has
    the first of them. Once the slot has held still for 50 ms, or is let go
    or commanded again, a $D line gives the pulse the command ended at.
    tools/sense_trace.py takes that pulse as the move's destination, so a
    return to the same end finds the level it was held at.
    The tool replays no move of a trace whose end line counts trigger lines
    that were not written, and no move with records missing among its
    samples: the move rules count samples, and a missing command hands its
    samples to the move before it. Both are said in the report.
    [sense_trace_hw.c]
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2026-10-10 Give a trigger past a trace's end a trace of its own, and watch a rebound slot afresh
    A trigger at or past the end of a trace the console has not finished
    writing, or after its stop, waits and starts the next trace when the end
    line is written. A changed pulse past the end no longer extends the
    trace, and a slew's end past it adds no line.
    A slot that renders no PWM pulse of its own, or another channel than
    before, is watched afresh: its first pulse is no command.
    tools/sense_trace.py replays no move of a trace with a problem, so a
    sample line the terminal lost is not bridged by the move rules.
    The tool's ctest case is registered where tools/sense_trace.py is, so a
    copy of the tree withou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
    [sense_trace_hw.c]
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2026-10-10 End a trace on the sampling core's progress, and tell two pairings by their rows
    Core 1 publishes the start time of each tick after the tick's records. A
    trigger line and the end line wait for a tick that started at or after
    their time, 100 ms at most; a line written without it turns the end
    line's reason into a capital letter, and the tool reports the trace as a
    problem. The line format is version 2. A stop from the console drops the
    trigger lines at or after it.
    The tool reports two offsets as a tie when they pair as many rows and
    give a row to different moves, whatever their distance. It refuses a
    --pair-ms that is not finite and above 0, a --csv-offset that is not
    finite or has no --ser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
    [sense_core1.c, sense_trace_hw.c, sense_trace_hw.h]
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2026-10-10 Accept only the planner's own plan in a KST session
    kst_session_write() runs the planner again on the plan's start, target and unlock set and refuses a plan whose writes, order, settled marks or unchecked mark differ. A restore with its unchecked mark cleared no longer skips the confirmation.
    The session counts as written to only when a write frame starts: an abort in the gap before the first write frame, or a driver that refuses it, leaves the session unlocked.
    A restore plan with no writes unlocks the session when the servo equals the backup.
    A read pass without a single reply ends the read with KST_SES_ERR_NO_SERVO in every pass, not only in the first.
    [kst_session.c]
2026-10-11 Add the KST programming port: pin driver, link page 0x32, panel module
    protocols/kst/rp2350 holds the RP2350 pin driver for the KST wire: one PIO
    state machine with a 24-word program and 2 DMA channels per open line, no
    interrupt. kst_pio.c holds its arithmetic without hardware access, and
    test_kst_pio runs the program's words in a model of the state machine. The
    coprocessor build fails when pioasm's words differ from the fixture.
    shared/outputs/kst_port.c is the coprocessor's programming port and link
    page KST (0x32, protocol 4.12). It takes one output channel out of PWM (no
    pulse for 50 ms, pin low for 100 ms), runs the session of protocols/kst on
    the pin and returns the channel to PWM on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
    [kst_link.c, kst_pio.c, kst_port.c, main.c, outputs_hw.c, outputs_hw.h]
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
